chenguoming1/h743-controllers/f722-heli/README.md

# F722 controller: native0 routed milestone, work in progress

**Open [hardware/f722-heli.kicad_pro](hardware/f722-heli.kicad_pro). The selected board has zero opens, geometric DRC errors, DRC warnings, ERC findings and parity findings. It is a fully routed geometric WIP milestone; fresh DC, electrical acceptance and manufacturing/flight qualification remain pending.**

PCB SHA-256: `84229c571433bd72d410fb18d02cffa3a380c00a87fbe1270e3a73b63f8dd6cd`. The [native0 checkpoint](layout-revision/checkpoints/native0-rx-complete-v1-20261013/README.md) and [canonical provenance](hardware/CANONICAL-SOURCE.json) bind all 61 paired design files. Only the PCB differs from native1; all 60 non-PCB files are exact.

The cumulative native change removes 18 tracks and one via, adds 36 tracks and two vias, and moves U15, R34 and R35 through three measured cardinal transforms, preserving all pad-net mappings. It has 2,525 native objects and 331 drilled objects. The separate final GREEN cleanup removes two exact remnants. All required new physical gates and all 22 actual IO protection checks pass. Scoped cleanup reference applicability and residual RX crossing/MISO edge concerns are recorded in the checkpoint; geometry checks do not establish fast-edge or ESD equivalence.

The preserved model's **294 required cases cover accessory/logic/USB loads only**. All 11 servo cases are illustrations. Six heavier source1 illustrations exceed the version-qualified Hobbywing V4.1 **10 A continuous BEC** reference even where ideal-source board-pad voltage passes. Neither that count nor those historical values qualifies the servo system or native0. The intended KST servos specify **6.0-8.4 V; raw 12.6 V servo operation is excluded**. The raw servo bus bypasses U5 electronics protection. V4.1's 30 A peak figure provides no installed duty-cycle qualification, and actual ESC/servo revisions, mating contacts and harness limits remain unbound. See the [power scope correction](layout-revision/checkpoints/native0-rx-complete-v1-20261013/evidence/power/POWER-SCOPE-CORRECTION.md).

The conditional 27 MHz prototype/bench limits, flash settling, BARO/IMU noise and ESD/EMC checks remain. The approved 400 kHz I2C setup retains its overshoot/measurement caveat; 385 kHz remains pending. Both new signal vias retain exact tenting/mask and actual pad/paste/metal-clearance evidence, including GREEN in the flash package region. JLC filled/capped-process applicability, ordinary-via process/stack, USB slots and panel acceptance remain unresolved. No process or firmware change is made here.

Saved-board restoration from the public native1 source is tested byte-for-byte. The compact cumulative transaction data and original two-stage native evidence are preserved; a full portable native-proof replay is not claimed. No heavy native, geometry or solver workload was repeated for packaging. Fresh native0 DC remains pending, with native1 results retained only as historical evidence.

## Historical manufacturing records

Older docs/, validation/, manufacturing/ exports and [final95 status](README-final95-historical.md) describe earlier geometry. Regenerate final assembly outputs from the eventual released board and verify factory orientation. Selected R35 is at (29.2,23.9), B.Cu, 180 degrees; the historical native1 270-degree note is inapplicable. U15 and R34 also use their selected measured poses. All prior checkpoints and B-RID files remain unchanged. See [layout history](layout-revision/README.md). No fabrication or flight release is made here.
