chenguoming1/h743-controllers/nexus-style-fc/routing-wip/README.md

# Routing work in progress

[Open the stable current integrated candidate](current/README.md). Both boards have zero native geometric errors and opens. Manufacturing/electrical/physical qualification gates remain explicit.
