chenguoming1/h743-controllers/f722-heli/layout-revision/README.md

# Current project entry point

**Open the paired [../hardware/f722-heli.kicad_pro](../hardware/f722-heli.kicad_pro). Native0 has zero opens, DRC errors/warnings, ERC and parity findings. It is a geometric WIP milestone; fresh DC and electrical/manufacturing/flight qualification remain pending.** See [project status](../README.md) and the [selected native0 checkpoint](checkpoints/native0-rx-complete-v1-20261013/README.md).

The unchanged text below is the historical eleven-open record. Its current/source paths, counts, pending statements, poses and manufacturing descriptions belong to that earlier geometry. Its recipe requires [historical final95 commit bf8189c2ecf87815a24f3acfa16fbf5f462194c4](https://github.com/chenguoming1/h743-controllers/tree/bf8189c2ecf87815a24f3acfa16fbf5f462194c4/f722-heli/hardware). The promoted ../hardware/ is not that input. All later native3, native2, native1 and source/evidence checkpoints remain preserved.

---

# F722 layout revision — work in progress

**Partially routed checkpoint. Do not manufacture or fly this revision.**

This replacement placement moves components inward from the through-hole headers, spreads the side sockets, keeps the LEDs and switch beside the upward USB connector, and uses orthogonal component orientations. The converter and its support parts are grouped on the right, with servo/RPM/SBUS protection on the left. It retains six copper layers, the 47.5 × 25.4 mm overall assembly, the board outline and stock Nexus external/MCU pin assignments.

The paired project is `hardware/f722-heli.kicad_pro`. All 156 target poses are explicit in `placement.json`; 114 differ from the published source. R7/R8 are changed to 2.2 kΩ (UNI-ROYAL 0402WGF2201TCE, C25879), and U13 uses equivalent protection channels 3/6/1 for ESC/RPM/SBUS. Native PCB, schematics and parts metadata agree. Published U14 mapping is retained.

## Checked checkpoint

KiCad 10.0.6 reports **11 unfinished connections, 0 geometric errors, 0 warnings and 0 ERC violations**. Strict schematic parity and all 29 firmware pin checks pass. All 16 critical clock, IMU, VCAP and USB nets and all 28 power/support groups are connected. The current source identity and scope are recorded in [the owner review](checks/checkpoint11-owner-review.json) and [current status](checks/current-status.json).

Checkpoint57 moves the unchanged 2.2 kΩ BOOT pull-down R2 beside the USB-side switch and completes their branch. The actual MCU BOOT connection remains open. All 156 poses and 558 pad records reproduce. Retained ground-plane fills and physical drill polygons are exact; C31’s existing ground via and rear lead are preserved. The new BOOT trace has continuous projected ground coverage. These checks do not establish startup/noise or physical qualification. See the [owner assessment](checks/checkpoint57-integration/owner-adoption-assessment.json).

The preceding Checkpoint56 completes the flash CS pull-up branch by moving R4 to the rear USB-side edge, while preserving all other 155 footprints and all original track/via objects. The old R4 CORE junction now has an explicit full-width bridge, and its new supply spur lands at C15.1. All 156 poses and 558 pad records reproduce. The actual MCU CS connection remains open. The [electrical review](checks/checkpoint56-integration/conditional-signal-review/README.md) records startup, active VERY_HIGH GPIO edges and incomplete full-tree timing limits. Critical reference metrics are unchanged; the [owner assessment](checks/checkpoint56-integration/owner-adoption-assessment.json) retains small ordinary-track projection differences and a CS width-edge wedge. Current numerical power/VCAP, decoupling and AC checks remain pending.

The preceding Checkpoint55 completes GREEN while rebuilding DSM, ADC and static flash pull-up routes. Only R44 rotates in place; all 156 poses and 558 native pad records reproduce. The [source-bound signal review](checks/checkpoint55-integration/conditional-signal-review/README.md) records the 136.672 mm DSM main receive path and 71.876 mm GREEN route, with loading and waveform limits still open. All 86 routed-net reference projections were inspected: 79 unchanged nets retain exact copper, while changed nets have no centerline gaps outside their own via windows. Finite width-edge residues remain. Eight exact actual-hole boundary predicate conflicts remain unresolved; the [owner assessment](checks/checkpoint55-integration/owner-adoption-assessment.json) preserves the failed stricter test and all limitations. Both ground planes remain connected with 117 plated ties, which does not establish current capacity or AC return quality. Fresh numerical power/VCAP remains pending.

The preceding Checkpoint54 completes the actual protected SERVO1 and RPM paths, bringing protection to 20 of 22 endpoint cases across 18 of 20 channels. R50 moves 0.25 mm inward. U12 now has a local discharge return separate from the eFuse controls; R52 instead shares a 1.250 mm ADC_BEC filter ground lead. Its conditional DC drop is small, but ADC/ILM noise, ESD coupling through the common plane, and fresh power/VCAP analysis remain open. The [ground and support review](checks/checkpoint54-integration/conditional-support-review/NATIVE-GROUND-REVIEW.md) preserves the exact topology and rejected clearance attempt. Critical copper and reference geometry outside the existing local via windows remain unchanged; the raw USB_N width residue is retained in the owner review. Historical [SERVO1](checks/checkpoint54-integration/historical-SERVO1-source15/SERVO1-electrical-review.md) and [RPM](checks/checkpoint54-integration/historical-RPM-source14/RPM-electrical-review.md) conditional signal analyses retain their own source identities.

The preceding source52 change completes both protected SBUS trees and moves R45 inward beside J12. All 82 finite new endpoints, 28 support groups and prior protection paths pass; 41 tracks and five ordinary vias replace five LV tracks. SBUS_LV is 75.648 mm and SBUS_MCU is 50.991 mm. Fresh saved-plane projection has no centerline or trace-width gaps outside own-via windows. Critical copper, missing centerlines and outside-window reference geometry remain exact; a −2.3793e−10 mm² BARO_SDA width delta is retained inside an unchanged own-via window. The [conditional SBUS review](checks/checkpoint52-integration/conditional-signal-review/SBUS-electrical-review.md) identifies the non-inverting pass-FET topology, default 100k and optional 200k baud, and explicit load/leakage/receiver/cable timing assumptions. It does not establish actual waveform, ESD or fast-mode qualification.

The preceding source51 change completes both protected PORT_A/PORT_B interfaces and SWDIO, and relocates the complete NRST transition. R33 moves to the front beside U14, TP1 moves into its former interior location, and U14 shifts 0.075 mm while retaining native courtyard clearance. The A/NRST stage checks 96 new finite endpoints; the preceding B stage’s 138-endpoint audit is retained and rebound. All 28 support groups, prior protected paths, and eight affected interface/reference projections pass. Runtime net indices change, but all critical physical records and their reference metrics remain exact; real ground antipads are preserved in the review. C58’s local ground lead shortens and widens while its explicit full return witness increases by 1.164 mm. C74’s feed shortens from 3.500 to 1.638 mm; a CORE bridge grows from 8.422 to 10.971 mm at unchanged 0.30 mm width. These geometric facts do not qualify regulator stability or current capacity; fresh numerical power remains pending.

The preceding source50 change completes TAIL through the actual U12.6 clamp pad, preserving all 156 footprints and 558 pad records. Fourteen tracks are replaced by 58 tracks and five ordinary vias while restoring SERVO3, RPM, ADC_DIV_MID and CORE support. All 116 finite endpoints and the new TAIL protection cut pass. Critical copper and reference metrics remain exact source49; each GND plane loses 1.936695782 mm² with no critical trace-width overlap. Fresh numerical power/VCAP validation remains pending.

The [TAIL conditional electrical review](checks/checkpoint50-integration/conditional-signal-review/TAIL-electrical-review.md) records an 81.064 mm MCU-to-clamp branch. The full protected net shortens from the historical 101.637 mm to 85.676 mm, but the clamp is much farther electrically from the driver. Pinned stock firmware selects LOW GPIO speed; ST's simulation-only fast-corner IBIS ramps of about 10–11 ns are longer than the conditional 0.45–0.57 ns one-way trace delay. This supports prototype review, not a guaranteed waveform. Three exact reference-width residuals totaling 0.000224846616 mm² remain outside own-via windows; no outside-window centerline gap exists. Waveform, ESD residual stress, AC return and actual receiver/cable qualification remain open. R23 is not source-end termination. The CORE-to-FB1 branch grows to 8.867 mm at unchanged 0.20 mm width, requiring fresh loaded analysis.

The preceding source49 change completes PORT_A MCU TX and rebuilds RX while preserving all 156 complete footprints, 558 pad records and existing vias. Five RX tracks and one ADC branch segment are replaced by 19 tracks and two ordinary signal vias. TX is 8.370 mm and RX is 10.989 mm. All 38 new track endpoints pass finite pad, junction or annular-entry checks. The remaining MCU escape review finds no newly sealed pad. Critical copper and its reference-projection metrics are unchanged from the preceding source. Each GND plane loses 0.788477196 mm² to the revised geometry, with no overlap under critical trace widths; this is not unchanged-plane or numerical-power evidence.

Historical source49 ADC_BUS was complete, with C31 inward beside the MCU. Its then-current capacitor branch was 4.448 mm, the complete capacitor-to-MCU path is 6.963 mm, and the unchanged ground lead is 1.379 mm. The [conditional acquisition screen](checks/checkpoint49-integration/adc-electrical-screen.json) has 35.56 µs available versus 1.887 µs required by its resistor/switch assumptions. It does not guarantee effective capacitor value, noise or calibrated accuracy. New UART and changed ADC tracks have full saved-plane projection outside their explicit own-via windows. Two pre-existing ADC width-edge fragments totaling 6.08648e−5 mm² remain exactly unchanged. Own-via windows are not solid copper or AC return qualification; earlier source-bound actual-hole predicate disagreements remain documented.

Earlier accepted work completes both barometer I2C trees, DSM MCU and external paths, NRST through the inward back-side TP5 at (16.9, 6.0) mm, and RPM_HV/SBUS_HV. Their precise copper, pose and source-bound review histories remain in the versioned checkpoint evidence. The placement recipe reproduces all 156 poses and 558 native pad records; the current recipe reproduces the three revised poses as well.

The [current actual-I/O check](checks/current-actual-io22.json) passes **20 of 22 endpoint cases, covering 18 of 20 bonded protection channels**. Two channels remain unfinished. All seven supplemental checks pass. The original 18-check convention has 16 passes, including 4 package-NC cuts; those NC results are not counted as completed bonded protection. Native via/drill/mask, body/courtyard, header-access, USB-keepout, edge and mounting-hole screens pass. Some nominal courtyard margins remain very small, including inherited 0.001 mm at U1–C4 and 0.005 mm near R66. These bounded geometry screens do not establish assembly or transient-protection qualification.

The [CORE supply and power-terminal review](core-voltage-review/REPORT.md) documents the historical U10/U11 model error: EN pin 4 was used instead of IN pin 6. Historical USB/DSM path-specific conclusions are invalid and retained only as diagnostics. The corrected model was independently reviewed and run on source43, the 37-open board: 294 required conditional DC cases, ten actual supply-pad windows, five VCAP copper loops and numerical guards pass. The overall result remains false because the separate 18.56 A single-feed illustration fails four servo voltage floors. See the [corrected report](power-evidence/corrected-v3-source43/REPORT.md). **These results do not qualify the current 11-open board: later BEC/CORE and GND geometry changed. Fresh current-source numerical validation remains pending.** Mesh-free staging on source48 was not a numerical solve.

Remaining routing, complete protection paths, current-source power validation, final signal timing/reference review and manufacturing exports are outstanding. Physical load, thermal, USB impedance, sensor, assembly and flight qualification are not established by these checks.

The native PCB is the authoritative routed source. The placement recipe below recreates the current component arrangement without its routing. The source-only local router and its recorded controls are under `routing-tools/`; accepted ordinary routes close ADC_BEC, ADC_DIV_MID, FLASH_WP_N, SWCLK, D1_A, D2_A, SERVO1_EXT, SERVO2_EXT, SERVO3_EXT, RPM_EXT and SBUS_EXT, with full-width native pad/annular entry. Later engine route claims remain subject to native connectivity and endpoint checks. Exact saved-ground contours and intended-net checks prevent stale antipads or accidental net reassignment during import. The finite-contact static power solver and its reproducible controls are under `power-validation/`. The [historical conditional power review](power-validation/CANDIDATE19-COMBINED-REVIEW.md) preserves exact source/result hashes and all failed illustrative checks; [screened-source60 applicability](checks/conditional-power-applicability.json) verifies the 13 networks, 99 contacts, physical drills/fills, stackup, materials, cases and runtime of that preserved source. The following numerical values preserve historical calculations; USB/DSM path-specific conclusions are invalid because of the U10/U11 terminal error, and none qualifies the current board. The separately evidenced BEC copper improvement does not establish complete path validation. Worst ABC pad is 4.862249 V against the conditional 4.8 V floor, with 61.249 mV margin after the 1 mV numerical guard. Worst VCAP DC copper loop is 26.025318 mΩ against 35 mΩ, excluding R16, capacitor ESR and AC stability. Corrected BEC copper drop is 38.370 mV at the representative 2 A case, versus about 614 mV in the preserved failed diagnostic. The [old independent resistance bound](power-evidence/loaded73-deficit-v1/REPORT.md) describes the superseded long feed. The [BEC component/source bounds](bec-voltage-review/REPORT.md) distinguish full-temperature IC reference tolerance from resistor drift and explicitly unguaranteed line/load sensitivities. These are conditional modeled findings, not measured regulation, ampacity, production or flight qualification.

The [historical circuit-corner packet](power-corner-review/REPORT.md) adds 140 input/output endpoint cases and 5,532 sensitivity cases using the verified source19 matrices. At the modeled 33 mΩ U7 endpoint, combined guarded reserves are 41.172 mV ABC and 17.607 mV classic DSM; the 60 mΩ stress retains 642 failures. Its separate resistance/source-error budgets, exact TI test conditions and bench requirements are preserved. It contains no new loaded-field solve and does not qualify this changed-fill board; its DSM conclusions also inherit the now-invalid supply-terminal mapping.

The [stock SPI review](spi-review/stock-spi-review.md) establishes the pinned source clocks of 13.5 MHz for the IMU and 27 MHz for flash; flash is at the MCU SPI2 frequency ceiling. Its [native identity binding](checks/stock-spi-binding.json) confirms the reviewed 103 pad identities and unchanged BOM on this source. Complete routing, fast-edge/loading/return review and actual hardware timing remain unqualified.

The [stock I2C review](signal-review/stock-i2c-review.md) preserves the existing firmware and 2.2 kΩ pull-ups, with provisional 50 pF loading and 100 ns edge targets; the [native signal screen](signal-review/native/README.md) records topology, saved-plane references and conditional loading assumptions. Both current I2C nets are complete clean trees: SCL 19.596154 mm and SDA 22.600469 mm. Capacitance/RC qualification remains unresolved because the material, manufacturing and device bounds are not fully established; final device/bench qualification remains open. [Native export tools](export-tools/README.md) reproduce the previous published payload as a regression control and refuse unfinished candidates. Their historical results do not validate this board.

Machine-readable source identity and results are in `source.json`, `placement-build.json`, `routing-build.json` and `checks/current-status.json`. The original published `../hardware`, `../manufacturing` and electrical reports describe the previous layout; their routing and electrical results do not validate this candidate.

## Reproduce

Use KiCad 10.0.6 with a Python environment providing `pcbnew`. From this directory, rebuild the placement (routing deliberately excluded) into a new output directory:

```sh
python scripts/rebuild_placement.py --source ../hardware --out /path/to/new/hardware
python scripts/patch_metadata.py --hardware /path/to/new/hardware --report /path/to/metadata-changes.json --apply
kicad-cli sch export netlist --format kicadxml --output /path/to/reconstructed.net /path/to/new/hardware/f722-heli.kicad_sch
python scripts/check_native_parity.py --board /path/to/new/hardware/f722-heli.kicad_pcb --netlist /path/to/reconstructed.net --out /path/to/parity.json
kicad-cli pcb drc --format json --output /path/to/drc.json /path/to/new/hardware/f722-heli.kicad_pcb
kicad-cli sch erc --format json --output /path/to/erc.json /path/to/new/hardware/f722-heli.kicad_sch
```

The builder requires published board SHA256 `4da0708a4795662cc32b035a0783c70b9bdb85fc386bd4d39af33385b175667f` and refuses to reuse an output directory. Subsequent routing checkpoints will update this draft branch with their exact checks and remaining work.

## Placement previews

[Front placement](checks/placement-front.svg) · [Mirrored back placement](checks/placement-back.svg)
