chenguoming1/h743-controllers/f722-heli/layout-revision/routing-tools/README.md

# F722 routing source V24: accepted11 geometric work in progress

Accepted candidate57 PCB SHA256 is454b7bb2454695b49c039f3d97e5edefb1946912363bab00ef5ced6ba2b0ea16. Stored native gates report11 opens, zero geometric errors and warnings. R2's switch branch closes; actual MCU U1.60 BOOT0 remains disconnected. Remaining gaps are PORT_C5, BOOT1, RED1 and flash4. Routing and electrical/physical qualification remain unfinished.

R2 alone moves from F(16.0,7.7),0 degrees to F(40.2,6.2),270 degrees (-90 native representation), retaining its2.2k/1% value and actual pad nets. All other155 full footprints remain exact. One old exclusive R2 ground leaf is removed and two tracks are added, with no new vias. The new BOOT0 link to SW1 is1.2701279463109219mm; the new0.25mm ground leaf is1.0636728820459835mm to an existing ground via. C31's original ground via and rear lead remain exact.

Original tests/boot56/candidate01 retains its129-file seal. Candidate57 began as a hardlinked copy; only power-audit.json was detached before adding explicit pad_group_count fields. power-audit-sealed-original.json and support-report-adapter.json preserve the original report and both source/output hashes. No original sealed report was overwritten. Original and accepted paired projects remain byte-identical. Stored checks retain four finite new endpoints,28 support groups,16 critical groups and20/22 actual I/O cases.

The owner proves exact saved GND fill arrays for both ground planes and all307 physical drill polygons, with2293 retained native objects exact modulo runtime net_code. Existing track projection domains therefore remain unchanged. A separate BOOT0 reference inspection reports zero missing physical centerline and width projection while explicitly retaining the open MCU terminal. Inherited source55 actual-hole boundary ambiguities and source56's CS width wedge remain unresolved limitations. Exact retained reference geometry does not establish AC/noise performance or current capacity.

Placement reproduction binds156 poses and558 complete native pad records; front and mirrored-back previews are retained. Current numerical power/VCAP remains unrun. Source43 power evidence remains historical only. BOOT startup, switching/noise, ESD, manufacturing and flight remain unqualified.

V24 inherits V23 unchanged and adds only current construction/owner/placement evidence. Portable verification recovers exact paired project bytes, checks every selected source hash and original seal, validates the complete board syntax-tree transaction and full saved GND-zone syntax, executes support/adoption adapters and recalculates both new track lengths. It does not rerun native DRC, finite/reference geometry, placement, routing, FEM or electrical simulation.
