chenguoming1/h743-controllers/f722-heli/layout-revision/power-evidence/README.md

# Historical scoped VCAP evidence

The completed two-grid DC copper pilot belongs only to board SHA 1069f4ce2d92088271a4ec3154ff0ed35e88adc4100705f75c4aaa4a884717bd, a provisional source with 85 ordinary opens. It ran five explicitly named VCAP copper loops, with no loaded-power cases. Fine-grid totals were 18.862, 18.399, 23.437, 25.858 and 24.789 mΩ against 35 mΩ. The worst remaining margin after its numerical guard was 9.042 mΩ. R16's fitted 0.120 Ω and capacitor ESR are excluded.

This is not qualification of the current 75-open board SHA 008d0b11df400284d12750c7f5c877b43a7ea28ffddbf4a4b799c3ae7ec4917e. Exact native comparison finds four added physical drills and changes in both GND fills. The current board requires fresh analysis. The earlier 77-open source had identical relevant VCAP geometry; that equivalence record does not silently rebind the original numerical result.

The compact result receipt retains board/freeze/ledger/result hashes, all loop legs, two-grid sensitivities, guarded margins, numerical checks, geometric error certificates and checkpoint identities. The independent review verified 315 scalar/hash/metadata conditions, including 25 frozen inputs and six runtime sources, without performing a new solve. Original numerical arrays and the 44 MB full result are not included in this compact evidence packet.

The successful solver matches the tested public power v4 implementation. Five numerical source files are byte-identical. The sixth, audit_native_ports.py, differs only in a documentation correction: public v4 correctly calls 2e-8 mm 0.02 nm; the archived runtime docstring incorrectly called it 20 nm. The executable value is identical. The exact archived audit module is included separately for hash reconstruction; the source-match receipt records both hashes and an AST comparison excluding docstrings. No unfinished single-line or loaded-pilot changes are included.

The read-only geometry comparison script can be placed beside the public validation modules. It compares exact selected-net copper/fills, all-net physical drills, finite native port pads, outline, stackup, material assumptions and export precision. Supply the exact native exports, boards and ledger identified by the receipts through its required CLI arguments. It never builds a mesh, repairs geometry, transfers a cache or declares another board qualified. Its two small comparison tests use the public validation fixtures.

The result uses explicit fixed-temperature copper assumptions and ideal finite lands/barrels, with no thermal, pulse, startup, handover, VCAP AC-stability, production or flight qualification. A two-grid sensitivity check is not a rigorous error bound. MANIFEST.json is the exact publication allowlist; copy only its entries and the manifest.
