chenguoming1/h743-controllers/f722-heli/layout-revision/checkpoints/negotiated-routing-v1-20261011/README.md

# WIP: negotiated routing source and failed v1 trial

This checkpoint preserves the exact current ordinary-only native baseline,
parser/model/attachment controls, negotiated v1 source and failed trial, and the
sealed explicit fixed-stub import supplement. Native7 remains the accepted board.
The v1 trial did not demonstrate a routing reduction and produced no final native
candidate. Existing numerical power results are stale for changed geometry.

## Evidence

- The official pinned Freerouting parser passed all four fixed-state cases in
  control v2. Failed parser v1 remains preserved as failed.
- The current model has 142 mutable and 2,245 fixed native records, 19 required
  logical role scopes and 18 repairs. Full-model generation and compilation
  succeeded. The first census failed; the engine-only projection and zero-pass
  census v2 passed. All original source/receipt states are preserved.
- The actual U14.4 attachment control passed, with an exact-source reconciliation
  covering the empty F.Cu fill inventory. The fixed 0.127 mm stub is an explicit
  future native addition; the diagnostic probe is excluded. Its conservative
  Shapely proof capsule is not an official KiCad native export.
- Negotiated v1 failed after 194.861 seconds when its fixed-geometry fingerprint
  changed. The router refused final export. Only checkpoint-0001 survives; its
  1,837 routes, areas, contact partitions and 19 role records are exactly equal
  to the initial snapshot. Report/session hashes match the producer receipt.
  No candidate.after.json or candidate.ses final output exists.

Historical preparation README/status strings are immutable historical evidence;
evidence-status.json records the terminal interpretation. The fixed fingerprint
failure remains a diagnostic finding, not a proven physical cause. No successor
diagnostic or live output is included here.

## Restore exact source and evidence bytes

Obtain repository commit 1423e4045727bc2e80acc24bcf684d5b83375001 or a descendant
that retains it. Restore the predecessor paired-hub-recovery-20261011 checkpoint
and its declared predecessors using its documented restore procedure. Then run:

    python restore.py --repository /path/to/repository --published-workspace /path/to/restored-paired-hub-workspace --output /path/to/new-workspace

The output must not exist. The restore script validates archive parts and their
reassembly, every deterministic archive member, published-object identities,
every restored byte count, SHA-256 and Git blob hash. It writes 286 exact paths
from 250 unique objects. The unique 145,730,755-byte native source is archived
once. All 61 paired hardware files remain reconstructible.

The archive uses sorted SHA-addressed USTAR members with uid/gid/mtime zero,
mode 0644, and one-thread XZ CRC64 preset 0. archive-index.json lists all parts.
RESTORE-VERIFICATION.json and VERIFY-ARCHIVE.json record the tested cold byte
restore. PREDECESSOR-FIXTURE.json describes the checked local published-byte
fixture used for that test; it was not a fresh network checkout.

## Generated outputs and runtime dependencies

regeneration-map.json separately records omitted large full/engine model JSON,
zero-pass output JSON, compiled classes, and official artifact download pins.
These are not archive members or already-restored bytes. Rebuild them from the
preserved source and named contract commands, then verify their expected hashes.
Official Freerouting 2.1.0 and ECJ 3.41.0 artifacts must match their SHA-256 pins.
The upstream source archive is optional provenance; reviewed source files are
already preserved. Shapely 2.2.0/GEOS 3.14.1 bytes are included. CPython 3.12 on
Linux x86_64, NumPy 2.2.6 and Java 21.0.12.1 are host prerequisites.

No cold engineering replay is claimed. Byte restore is relocatable; exact
historical model hashes embed absolute paths and receipt hashes and therefore
require the original workspace root and compatible pinned runtime. Relocated
execution needs an explicit path/contract rebind with new hashes. Use a separate
execution tree and retain historical receipts rather than overwriting them.

Native import, full-width/annular/clearance checks, actual TVS IO cuts with no
bypass, all fixed fragments, paired ERC/parity, ground/reference checks, and
fresh electrical/power/VCAP qualification remain pending. No canonical hardware
is replaced, accepted, or declared manufacturing-ready by this checkpoint.
