chenguoming1/h743-controllers/nexus-style-fc/routing-wip/2026-10-15/reviews/current-gates/README.md

# Source-bound board-level gates

[U10 output/input loop and USB shield/ESD review](RECOVERY-QUALIFICATION.md) contains fresh read-only measurements against the exact published batch35 source. Its historical proposed routes are review inputs, not accepted PCB source. The later EN-only correction is documented separately in the current checkpoint; the pre-correction review does not claim EN was already isolated.

[Header contact and mechanical remedy](header-contact-remedy-readonly.md) gives exact native contact dimensions and the independent tab/slot fit calculation. Copper recession could preserve nominal solder overlap, but cannot fix the square-tab/capsule-slot interference. No pad, slot or tab redesign was applied.

All electrical, manufacturing and assembly qualifications explicitly left open by these reports remain open. Zero native opens or preserved widths are not current, thermal, ESD, USB or flight qualification. Header geometry requires a separate approved correction.
