chenguoming1/h743-controllers/f722-heli/layout-revision/checkpoints/native2-in4-rx-v5-20261013/dc/README.md

# Current native2 v5 DC evidence

The four ordered chunks in `raw/` reconstruct the complete original compressed result without any byte change. RAW-RESULT-CHUNKS.json binds each chunk, their order, the complete gzip and its decompressed JSON. No mesh or cache is needed to inspect this recorded result.

Run `python3 verify_dc_chunks.py` to verify chunk identities, ordering and the full decompressed identity without writing a result file. To restore the original gzip, run `python3 verify_dc_chunks.py --output /your/new/result.json.gz`. An existing output path is refused.

The raw result records 305 cases on each of two grids, with all required 294 cases passing. Fifteen grid sensitivity comparisons and five VCAP copper-loop limits pass. The overall static screen remains false because the retained lost-J6-feed illustration fails the four servo board-pad floors. The raw result is not rewritten to hide that failure.

Compact normalized receipts and the independent current disposition are in ../evidence/dc/. They retain the exact source hashes, scientific values and recorded pass/fail claims; their normalization ledgers identify removed local locators and execution metadata. The runtime exit code 1 is retained and corresponds to the declared illustrative overall-screen failure, not missing case output.

The complete portable numerical replay source package is pending a separate immutable supplement. This checkpoint preserves the full recorded result and exact design/native inputs, but does not claim that the public numerical or reference solver source closure is complete. Packaging did not rerun a numerical solve.
