chenguoming1/h743-controllers/f722-heli/layout-revision/routing-tools/docs/historical-v23/README.md

# F722 routing source V23: accepted12 geometric work in progress

Accepted candidate56 PCB SHA256 is 9d9f2f39c2b200f2c928dd3123f098797eb86ba56cb943d7f6e3fe89bf264a7e. Stored native gates report12 opens, zero errors and warnings. R4's U3.1 pull-up branch closes; actual MCU U1.33 FLASH_CS remains disconnected. Remaining gaps: PORT_C5, BOOT2, RED1, flash4. Routing and electrical qualification remain unfinished.

R4 alone moves from B(27.5,19.8),180 degrees to B(40.55,19.0),180 degrees, retaining its10k/1% value and actual pad nets. All other155 full footprints and all1723 original track/via/arc objects remain exact. Thirteen tracks and two ordinary tented through-vias are added. The CS branch is13.999707308mm; the new4.335mm CORE spur deliberately contacts C15.1. A separate1.835755975mm full-width bridge to actual C3.1 replaces the old R4 pad's CORE junction. Its current cannot be bounded by the pull-up bias current.

The original tests/native13-access/candidate02 retains its133-file seal. Candidate56's explicit support adapter adds only pad_group_count=len(groups) for28 verified singleton partitions. power-audit-sealed-original.json and support-report-adapter.json preserve the original bytes and both hashes. The original and accepted paired native projects are byte-identical. Stored checks preserve26 finite new endpoints,16 critical groups,20/22 actual I/O cases, strict I2C trees and117 accepted ground ties. Placement reproduction binds156 poses and558 full pad records; front and mirrored-back previews are included.

Critical projection metrics are unchanged from55. The independent global review covers1445 retained track-reference records and preserves eight nonempty numerical width-edge intersections, including an RPM centerline delta of1.9678329196301878e-7mm. New CORE projections are complete; the nine CS tracks have no centerline gap outside their own via windows, but one retains a1.6570642014549053e-5mm² width wedge. Prior55's eight actual-hole predicate ambiguities remain historical unresolved limitations. No tolerance, snapping, contour repair or zero normalization is introduced.

The conditional electrical review distinguishes active VERY_HIGH GPIO CS edges from the static WP/HOLD straps. Full MCU-to-U3 tree topology, fastest-edge loading/timing, local supply ramp/startup and fresh whole-network power/decoupling remain unqualified. Current numerical power/VCAP has not run. Source43 power evidence remains historical only. This is not manufacturing, flight, AC, thermal or ESD qualification.

V23 preserves all V22 lineage and adds compact, deduplicated current construction/owner evidence. Portable checks reconstruct exact paired project bytes, verify source bindings and the complete board syntax-tree transaction, execute support/adoption adapters and recalculate CS/CORE centerline lengths. They do not rerun native DRC, reference/finite geometry, placement, electrical simulation, routing or FEM.
