chenguoming1/h743-controllers/f722-heli/layout-revision/routing-tools/sessions/recovery55/README.md

# Exact candidate26–28 paired recovery

First recover exact26 with the retained V8 recovery57 script from its pinned candidate22 paired source. This packet uses26 as its hash-pinned byte-copy base and validates all62 functional paired files before creating output. It recovers exact27 or28 PCB bytes and unchanged paired project/schematic/library files. It performs no reroute or native replay and makes no new qualification claim. See the root REPRODUCE.md.
