chenguoming1/h743-controllers/f722-heli/layout-revision/routing-tools/sessions/recovery57/README.md

# Exact V8 source and result recovery

Supply the hash-pinned external candidate22/accepted62 paired project. This packet recovers exact candidates22–26 using standard-library copy/literal deltas and verifies every functional paired file. Every target board hash is checked before output. Recovery is byte reconstruction only; it does not route, replay native imports, refill, rerun DRC or revalidate numerical power. See the package REPRODUCE.md.
