chenguoming1/h743-controllers/f722-heli/manufacturing/drill/drill-report.txt

Drill report for f722-heli.kicad_pcb
Created on 2026-10-07T12:36:03

Copper Layer Stackup:
    =============================================================
    L1 :  F.Cu                      front
    L2 :  In1.Cu                    in1
    L3 :  In2.Cu                    in2
    L4 :  In3.Cu                    in3
    L5 :  In4.Cu                    in4
    L6 :  B.Cu                      back

Drill file 'f722-heli-PTH.drl' contains
    plated through holes:
    =============================================================
    T1  0.200mm  0.0079"  (246 holes))
    T2  0.300mm  0.0118"  (77 holes))
    T3  0.600mm  0.0236"  (4 holes)  (with 4 slots)
    T4  1.100mm  0.0433"  (21 holes))

    Total plated holes count 348

Drill file 'f722-heli-NPTH.drl' contains
    unplated through holes:
    =============================================================
    T1  0.710mm  0.0280"  (2 holes)  (with 1 slot)

    Total unplated holes count 2
