chenguoming1/h743-controllers/f722-heli/layout-revision/power-evidence/loaded73-deficit-v1/requirements-analytic.txt

# Verified with Python 3.12.14; Shapely wheel uses GEOS 3.14.1.
shapely==2.2.0
numpy==2.2.6
