chenguoming1/h743-controllers/nexus-style-fc/docs/validation/reviews/jlcdfm-child-b49ef410/combined-report-dom.txt

- text: 
- main:
  - generic: https://dfm.jlcdfm.com/
  - generic: DFM analysis report_JLCDFM
  - generic: File name：
  - generic: nexus-header-board-gerbers.zip
  - generic: Report generated at：
  - generic: 2026-10-15 07:47:10
  - generic: PCB layers：
  - generic: "2"
  - generic: PCB size：
  - generic: 2.24x1.1cm
  - generic: Analyze project：
  - checkbox "PCB DFM" [checked]
  - text: PCB DFM
  - checkbox "SMT DFM" [checked]
  - text: SMT DFM
  - generic: PCB DFM>Routing layer analysis
  - table:
    - rowgroup:
      - row "Analyze project Analysis results PCB screenshot Layer distribution Statistics":
        - columnheader "Analyze project"
        - columnheader "Analysis results"
        - columnheader "PCB screenshot"
        - columnheader "Layer distribution"
        - columnheader "Statistics"
    - rowgroup:
      - row "Sharp trace corner （Check for sharp corners in traces） No No No Danger：0 Warning：0 Good：0":
        - cell "Sharp trace corner （Check for sharp corners in traces）":
          - text: Sharp trace corner
          - text: （Check for sharp corners in traces）
        - cell "No"
        - cell "No"
        - cell "No"
        - cell "Danger：0 Warning：0 Good：0":
          - generic: Danger：0
          - generic: Warning：0
          - generic: Good：0
      - row "BGA pad （Check BGA pads on the board） No No No Danger：0 Warning：0 Good：0":
        - cell "BGA pad （Check BGA pads on the board）":
          - text: BGA pad
          - text: （Check BGA pads on the board）
        - cell "No"
        - cell "No"
        - cell "No"
        - cell "Danger：0 Warning：0 Good：0":
          - generic: Danger：0
          - generic: Warning：0
          - generic: Good：0
      - row "Via placed within a pad （Check if there is a via placed within a pad） No No No Danger：0 Warning：0 Good：0":
        - cell "Via placed within a pad （Check if there is a via placed within a pad）":
          - text: Via placed within a pad
          - text: （Check if there is a via placed within a pad）
        - cell "No"
        - cell "No"
        - cell "No"
        - cell "Danger：0 Warning：0 Good：0":
          - generic: Danger：0
          - generic: Warning：0
          - generic: Good：0
      - row "Trace to board edge （Detect traces too close to the board edge） No No No Danger：0 Warning：0 Good：0":
        - cell "Trace to board edge （Detect traces too close to the board edge）":
          - text: Trace to board edge
          - text: （Detect traces too close to the board edge）
        - cell "No"
        - cell "No"
        - cell "No"
        - cell "Danger：0 Warning：0 Good：0":
          - generic: Danger：0
          - generic: Warning：0
          - generic: Good：0
      - row "Trace spacing （Measure spacing between adjacent parallel traces） No No No Danger：0 Warning：0 Good：0":
        - cell "Trace spacing （Measure spacing between adjacent parallel traces）":
          - text: Trace spacing
          - text: （Measure spacing between adjacent parallel traces）
        - cell "No"
        - cell "No"
        - cell "No"
        - cell "Danger：0 Warning：0 Good：0":
          - generic: Danger：0
          - generic: Warning：0
          - generic: Good：0
      - row "Unconnected trace end （Free-standing trace ends not connected to pads） No No No Danger：0 Warning：0 Good：0":
        - cell "Unconnected trace end （Free-standing trace ends not connected to pads）":
          - text: Unconnected trace end
          - text: （Free-standing trace ends not connected to pads）
        - cell "No"
        - cell "No"
        - cell "No"
        - cell "Danger：0 Warning：0 Good：0":
          - generic: Danger：0
          - generic: Warning：0
          - generic: Good：0
      - row "Trace width （Trace width information） 0.2mm Good No nexus-header-board-F_Cu.gtl nexus-header-board-B_Cu.gbl Danger：0 Warning：0 Good：34":
        - cell "Trace width （Trace width information）":
          - text: Trace width
          - text: （Trace width information）
        - cell "0.2mm Good":
          - text: 0.2mm
          - text: Good
        - cell "No"
        - cell "nexus-header-board-F_Cu.gtl nexus-header-board-B_Cu.gbl":
          - generic: nexus-header-board-F_Cu.gtl
          - generic: nexus-header-board-B_Cu.gbl
        - cell "Danger：0 Warning：0 Good：34":
          - generic: Danger：0
          - generic: Warning：0
          - generic: Good：34
      - row "Fiducial （Detect fiducial marks on the board） No No No Danger：0 Warning：0 Good：0":
        - cell "Fiducial （Detect fiducial marks on the board）":
          - text: Fiducial
          - text: （Detect fiducial marks on the board）
        - cell "No"
        - cell "No"
        - cell "No"
        - cell "Danger：0 Warning：0 Good：0":
          - generic: Danger：0
          - generic: Warning：0
          - generic: Good：0
      - row "Pad to board edge （Measure distance of pads from the board edge） 0.23mm Good No nexus-header-board-F_Cu.gtl nexus-header-board-B_Cu.gbl Danger：0 Warning：0 Good：25":
        - cell "Pad to board edge （Measure distance of pads from the board edge）":
          - text: Pad to board edge
          - text: （Measure distance of pads from the board edge）
        - cell "0.23mm Good":
          - text: 0.23mm
          - text: Good
        - cell "No"
        - cell "nexus-header-board-F_Cu.gtl nexus-header-board-B_Cu.gbl":
          - generic: nexus-header-board-F_Cu.gtl
          - generic: nexus-header-board-B_Cu.gbl
        - cell "Danger：0 Warning：0 Good：25":
          - generic: Danger：0
          - generic: Warning：0
          - generic: Good：25
      - row "Pad spacing （Measure pad to pad spacing） 0.37mm Good No nexus-header-board-B_Cu.gbl Danger：0 Warning：0 Good：4":
        - cell "Pad spacing （Measure pad to pad spacing）":
          - text: Pad spacing
          - text: （Measure pad to pad spacing）
        - cell "0.37mm Good":
          - text: 0.37mm
          - text: Good
        - cell "No"
        - cell "nexus-header-board-B_Cu.gbl":
          - generic: nexus-header-board-B_Cu.gbl
        - cell "Danger：0 Warning：0 Good：4":
          - generic: Danger：0
          - generic: Warning：0
          - generic: Good：4
      - row "Plated through-hole to trace clearance （Measure clearance of plated through-holes to traces） 0.44mm Good No nexus-header-board-F_Cu.gtl nexus-header-board-B_Cu.gbl Danger：0 Warning：0 Good：11":
        - cell "Plated through-hole to trace clearance （Measure clearance of plated through-holes to traces）":
          - text: Plated through-hole to trace clearance
          - text: （Measure clearance of plated through-holes to traces）
        - cell "0.44mm Good":
          - text: 0.44mm
          - text: Good
        - cell "No"
        - cell "nexus-header-board-F_Cu.gtl nexus-header-board-B_Cu.gbl":
          - generic: nexus-header-board-F_Cu.gtl
          - generic: nexus-header-board-B_Cu.gbl
        - cell "Danger：0 Warning：0 Good：11":
          - generic: Danger：0
          - generic: Warning：0
          - generic: Good：11
      - row "Annular ring （Annular ring width of pads compared to holes） 0.15mm Warning No nexus-header-board-F_Cu.gtl nexus-header-board-B_Cu.gbl Danger：0 Warning：6 Good：21":
        - cell "Annular ring （Annular ring width of pads compared to holes）":
          - text: Annular ring
          - text: （Annular ring width of pads compared to holes）
        - cell "0.15mm Warning":
          - text: 0.15mm
          - text: Warning
        - cell "No"
        - cell "nexus-header-board-F_Cu.gtl nexus-header-board-B_Cu.gbl":
          - generic: nexus-header-board-F_Cu.gtl
          - generic: nexus-header-board-B_Cu.gbl
        - cell "Danger：0 Warning：6 Good：21":
          - generic: Danger：0
          - generic: Warning：6
          - generic: Good：21
      - row "tht to smd （Detect clearance of vias to pads） 2.35mm Warning No nexus-header-board-F_Cu.gtl nexus-header-board-B_Cu.gbl Danger：0 Warning：26 Good：44":
        - cell "tht to smd （Detect clearance of vias to pads）":
          - text: tht to smd
          - text: （Detect clearance of vias to pads）
        - cell "2.35mm Warning":
          - text: 2.35mm
          - text: Warning
        - cell "No"
        - cell "nexus-header-board-F_Cu.gtl nexus-header-board-B_Cu.gbl":
          - generic: nexus-header-board-F_Cu.gtl
          - generic: nexus-header-board-B_Cu.gbl
        - cell "Danger：0 Warning：26 Good：44":
          - generic: Danger：0
          - generic: Warning：26
          - generic: Good：44
      - row "Via to pad （Detect clearance of vias to pads） 0.2mm Good No nexus-header-board-F_Cu.gtl nexus-header-board-B_Cu.gbl Danger：0 Warning：0 Good：2":
        - cell "Via to pad （Detect clearance of vias to pads）":
          - text: Via to pad
          - text: （Detect clearance of vias to pads）
        - cell "0.2mm Good":
          - text: 0.2mm
          - text: Good
        - cell "No"
        - cell "nexus-header-board-F_Cu.gtl nexus-header-board-B_Cu.gbl":
          - generic: nexus-header-board-F_Cu.gtl
          - generic: nexus-header-board-B_Cu.gbl
        - cell "Danger：0 Warning：0 Good：2":
          - generic: Danger：0
          - generic: Warning：0
          - generic: Good：2
  - generic: PCB DFM>Soldermask layer analysis
  - table:
    - rowgroup:
      - row "Analyze project Analysis results PCB screenshot Layer distribution Statistics":
        - columnheader "Analyze project"
        - columnheader "Analysis results"
        - columnheader "PCB screenshot"
        - columnheader "Layer distribution"
        - columnheader "Statistics"
    - rowgroup:
      - row "Soldermask bridge （Detect distance between parallel soldermask opening edges） No No No Danger：0 Warning：0 Good：0":
        - cell "Soldermask bridge （Detect distance between parallel soldermask opening edges）":
          - text: Soldermask bridge
          - text: （Detect distance between parallel soldermask opening edges）
        - cell "No"
        - cell "No"
        - cell "No"
        - cell "Danger：0 Warning：0 Good：0":
          - generic: Danger：0
          - generic: Warning：0
          - generic: Good：0
      - row "Solder mask opening exposing trace （Detect clearance of solder mask openings to nearby traces） No No No Danger：0 Warning：0 Good：0":
        - cell "Solder mask opening exposing trace （Detect clearance of solder mask openings to nearby traces）":
          - text: Solder mask opening exposing trace
          - text: （Detect clearance of solder mask openings to nearby traces）
        - cell "No"
        - cell "No"
        - cell "No"
        - cell "Danger：0 Warning：0 Good：0":
          - generic: Danger：0
          - generic: Warning：0
          - generic: Good：0
      - row "Soldermask opening with multiple segments （Check if solder mask openings are constructed from multiple geometric shapes） No No No Danger：0 Warning：0 Good：0":
        - cell "Soldermask opening with multiple segments （Check if solder mask openings are constructed from multiple geometric shapes）":
          - text: Soldermask opening with multiple segments
          - text: （Check if solder mask openings are constructed from multiple geometric shapes）
        - cell "No"
        - cell "No"
        - cell "No"
        - cell "Danger：0 Warning：0 Good：0":
          - generic: Danger：0
          - generic: Warning：0
          - generic: Good：0
      - row "Negative soldermask expansion （Detect solder mask openings smaller than their corresponding pads） No No No Danger：0 Warning：0 Good：0":
        - cell "Negative soldermask expansion （Detect solder mask openings smaller than their corresponding pads）":
          - text: Negative soldermask expansion
          - text: （Detect solder mask openings smaller than their corresponding pads）
        - cell "No"
        - cell "No"
        - cell "No"
        - cell "Danger：0 Warning：0 Good：0":
          - generic: Danger：0
          - generic: Warning：0
          - generic: Good：0
  - generic: PCB DFM>Silkscreen layer analysis
  - table:
    - rowgroup:
      - row "Analyze project Analysis results PCB screenshot Layer distribution Statistics":
        - columnheader "Analyze project"
        - columnheader "Analysis results"
        - columnheader "PCB screenshot"
        - columnheader "Layer distribution"
        - columnheader "Statistics"
    - rowgroup:
      - row "Silkscreen to pad （Detect clearance of silkscreen to pads） No No No Danger：0 Warning：0 Good：0":
        - cell "Silkscreen to pad （Detect clearance of silkscreen to pads）":
          - text: Silkscreen to pad
          - text: （Detect clearance of silkscreen to pads）
        - cell "No"
        - cell "No"
        - cell "No"
        - cell "Danger：0 Warning：0 Good：0":
          - generic: Danger：0
          - generic: Warning：0
          - generic: Good：0
      - row "Silkscreen to hole （Detect clearance of silkscreen to holes） No No No Danger：0 Warning：0 Good：0":
        - cell "Silkscreen to hole （Detect clearance of silkscreen to holes）":
          - text: Silkscreen to hole
          - text: （Detect clearance of silkscreen to holes）
        - cell "No"
        - cell "No"
        - cell "No"
        - cell "Danger：0 Warning：0 Good：0":
          - generic: Danger：0
          - generic: Warning：0
          - generic: Good：0
      - row "Silkscreen line width （Check silkscreen line width） No No No Danger：0 Warning：0 Good：0":
        - cell "Silkscreen line width （Check silkscreen line width）":
          - text: Silkscreen line width
          - text: （Check silkscreen line width）
        - cell "No"
        - cell "No"
        - cell "No"
        - cell "Danger：0 Warning：0 Good：0":
          - generic: Danger：0
          - generic: Warning：0
          - generic: Good：0
  - generic: PCB DFM>Drill layer analysis
  - table:
    - rowgroup:
      - row "Analyze project Analysis results PCB screenshot Layer distribution Statistics":
        - columnheader "Analyze project"
        - columnheader "Analysis results"
        - columnheader "PCB screenshot"
        - columnheader "Layer distribution"
        - columnheader "Statistics"
    - rowgroup:
      - row "Unconnected via （Detect isolated unconnected vias） No No No Danger：0 Warning：0 Good：0":
        - cell "Unconnected via （Detect isolated unconnected vias）":
          - text: Unconnected via
          - text: （Detect isolated unconnected vias）
        - cell "No"
        - cell "No"
        - cell "No"
        - cell "Danger：0 Warning：0 Good：0":
          - generic: Danger：0
          - generic: Warning：0
          - generic: Good：0
      - row "Missing plated through-hole （Detect top and bottom pads at the same location without plated through-holes） No No No Danger：0 Warning：0 Good：0":
        - cell "Missing plated through-hole （Detect top and bottom pads at the same location without plated through-holes）":
          - text: Missing plated through-hole
          - text: （Detect top and bottom pads at the same location without plated through-holes）
        - cell "No"
        - cell "No"
        - cell "No"
        - cell "Danger：0 Warning：0 Good：0":
          - generic: Danger：0
          - generic: Warning：0
          - generic: Good：0
      - row "Unconnected via （Detect isolated unconnected vias） No No No Danger：0 Warning：0 Good：0":
        - cell "Unconnected via （Detect isolated unconnected vias）":
          - text: Unconnected via
          - text: （Detect isolated unconnected vias）
        - cell "No"
        - cell "No"
        - cell "No"
        - cell "Danger：0 Warning：0 Good：0":
          - generic: Danger：0
          - generic: Warning：0
          - generic: Good：0
      - row "Plated through-hole spacing （Measure spacing between plated through-holes） No No No Danger：0 Warning：0 Good：0":
        - cell "Plated through-hole spacing （Measure spacing between plated through-holes）":
          - text: Plated through-hole spacing
          - text: （Measure spacing between plated through-holes）
        - cell "No"
        - cell "No"
        - cell "No"
        - cell "Danger：0 Warning：0 Good：0":
          - generic: Danger：0
          - generic: Warning：0
          - generic: Good：0
      - row "Short slot detection （Detect slots shorter than twice their width） No No No Danger：0 Warning：0 Good：0":
        - cell "Short slot detection （Detect slots shorter than twice their width）":
          - text: Short slot detection
          - text: （Detect slots shorter than twice their width）
        - cell "No"
        - cell "No"
        - cell "No"
        - cell "Danger：0 Warning：0 Good：0":
          - generic: Danger：0
          - generic: Warning：0
          - generic: Good：0
      - row "Slot width check （Measure slot width） No No No Danger：0 Warning：0 Good：0":
        - cell "Slot width check （Measure slot width）":
          - text: Slot width check
          - text: （Measure slot width）
        - cell "No"
        - cell "No"
        - cell "No"
        - cell "Danger：0 Warning：0 Good：0":
          - generic: Danger：0
          - generic: Warning：0
          - generic: Good：0
      - row "Via to PTH spacing （Measure spacing of vias to plated through-holes） No No No Danger：0 Warning：0 Good：0":
        - cell "Via to PTH spacing （Measure spacing of vias to plated through-holes）":
          - text: Via to PTH spacing
          - text: （Measure spacing of vias to plated through-holes）
        - cell "No"
        - cell "No"
        - cell "No"
        - cell "Danger：0 Warning：0 Good：0":
          - generic: Danger：0
          - generic: Warning：0
          - generic: Good：0
      - row "Unconnected via （Detect isolated unconnected vias） No No No Danger：0 Warning：0 Good：0":
        - cell "Unconnected via （Detect isolated unconnected vias）":
          - text: Unconnected via
          - text: （Detect isolated unconnected vias）
        - cell "No"
        - cell "No"
        - cell "No"
        - cell "Danger：0 Warning：0 Good：0":
          - generic: Danger：0
          - generic: Warning：0
          - generic: Good：0
  - generic: SMT DFM>Component assembly analysis
  - table:
    - rowgroup:
      - row "Analyze project Analysis results PCB screenshot Layer distribution Statistics":
        - columnheader "Analyze project"
        - columnheader "Analysis results"
        - columnheader "PCB screenshot"
        - columnheader "Layer distribution"
        - columnheader "Statistics"
    - rowgroup:
      - row "Component through-hole （Detect misalignment of component through-hole pins to pad holes） No No No Danger：0 Warning：0 Good：0":
        - cell "Component through-hole （Detect misalignment of component through-hole pins to pad holes）":
          - text: Component through-hole
          - text: （Detect misalignment of component through-hole pins to pad holes）
        - cell "No"
        - cell "No"
        - cell "No"
        - cell "Danger：0 Warning：0 Good：0":
          - generic: Danger：0
          - generic: Warning：0
          - generic: Good：0
      - row "Component collision warning （Component collision warning;Component 1;Component 2） No No No Danger：0 Warning：0 Good：0":
        - cell "Component collision warning （Component collision warning;Component 1;Component 2）":
          - text: Component collision warning
          - text: （Component collision warning;Component 1;Component 2）
        - cell "No"
        - cell "No"
        - cell "No"
        - cell "Danger：0 Warning：0 Good：0":
          - generic: Danger：0
          - generic: Warning：0
          - generic: Good：0
      - row "Component spacing （Component to component spacing;Component 1;Component 2） 1.63mm Good No component_+_top Danger：0 Warning：0 Good：50":
        - cell "Component spacing （Component to component spacing;Component 1;Component 2）":
          - text: Component spacing
          - text: （Component to component spacing;Component 1;Component 2）
        - cell "1.63mm Good":
          - text: 1.63mm
          - text: Good
        - cell "No"
        - cell "component_+_top":
          - generic: component_+_top
        - cell "Danger：0 Warning：0 Good：50":
          - generic: Danger：0
          - generic: Warning：0
          - generic: Good：50
      - row "Component to board edge distance （Measure distance from component outline to the board edge） 0.56mm Warning No component_+_top Danger：0 Warning：7 Good：0":
        - cell "Component to board edge distance （Measure distance from component outline to the board edge）":
          - text: Component to board edge distance
          - text: （Measure distance from component outline to the board edge）
        - cell "0.56mm Warning":
          - text: 0.56mm
          - text: Warning
        - cell "No"
        - cell "component_+_top":
          - generic: component_+_top
        - cell "Danger：0 Warning：7 Good：0":
          - generic: Danger：0
          - generic: Warning：7
          - generic: Good：0
      - row "Lead to hole distance （Detect clearance of component leads to holes） No No No Danger：0 Warning：0 Good：0":
        - cell "Lead to hole distance （Detect clearance of component leads to holes）":
          - text: Lead to hole distance
          - text: （Detect clearance of component leads to holes）
        - cell "No"
        - cell "No"
        - cell "No"
        - cell "Danger：0 Warning：0 Good：0":
          - generic: Danger：0
          - generic: Warning：0
          - generic: Good：0
      - row "Component through-hole （Detect misalignment of component through-hole pins to pad holes） No No No Danger：0 Warning：0 Good：0":
        - cell "Component through-hole （Detect misalignment of component through-hole pins to pad holes）":
          - text: Component through-hole
          - text: （Detect misalignment of component through-hole pins to pad holes）
        - cell "No"
        - cell "No"
        - cell "No"
        - cell "Danger：0 Warning：0 Good：0":
          - generic: Danger：0
          - generic: Warning：0
          - generic: Good：0
      - row "Coponent pad spacing （Detect clearance between pads of the same component） No No No Danger：0 Warning：0 Good：0":
        - cell "Coponent pad spacing （Detect clearance between pads of the same component）":
          - text: Coponent pad spacing
          - text: （Detect clearance between pads of the same component）
        - cell "No"
        - cell "No"
        - cell "No"
        - cell "Danger：0 Warning：0 Good：0":
          - generic: Danger：0
          - generic: Warning：0
          - generic: Good：0
      - row "Component clipped by board outline （Detect component boundary clipping by the board outline） No No No Danger：0 Warning：0 Good：0":
        - cell "Component clipped by board outline （Detect component boundary clipping by the board outline）":
          - text: Component clipped by board outline
          - text: （Detect component boundary clipping by the board outline）
        - cell "No"
        - cell "No"
        - cell "No"
        - cell "Danger：0 Warning：0 Good：0":
          - generic: Danger：0
          - generic: Warning：0
          - generic: Good：0
      - row "Pin inner edge （Measure if component pin edges extend past pad edges） No No No Danger：0 Warning：0 Good：0":
        - cell "Pin inner edge （Measure if component pin edges extend past pad edges）":
          - text: Pin inner edge
          - text: （Measure if component pin edges extend past pad edges）
        - cell "No"
        - cell "No"
        - cell "No"
        - cell "Danger：0 Warning：0 Good：0":
          - generic: Danger：0
          - generic: Warning：0
          - generic: Good：0
      - row "Pin left edge （Measure if component pin edges extend past pad edges） No No No Danger：0 Warning：0 Good：0":
        - cell "Pin left edge （Measure if component pin edges extend past pad edges）":
          - text: Pin left edge
          - text: （Measure if component pin edges extend past pad edges）
        - cell "No"
        - cell "No"
        - cell "No"
        - cell "Danger：0 Warning：0 Good：0":
          - generic: Danger：0
          - generic: Warning：0
          - generic: Good：0
      - row "Pin without pad （Detect if component pins without pads） No No No Danger：0 Warning：0 Good：0":
        - cell "Pin without pad （Detect if component pins without pads）":
          - text: Pin without pad
          - text: （Detect if component pins without pads）
        - cell "No"
        - cell "No"
        - cell "No"
        - cell "Danger：0 Warning：0 Good：0":
          - generic: Danger：0
          - generic: Warning：0
          - generic: Good：0
      - row "Pin outer edge （Measure if component pin edges extend past pad edges） No No No Danger：0 Warning：0 Good：0":
        - cell "Pin outer edge （Measure if component pin edges extend past pad edges）":
          - text: Pin outer edge
          - text: （Measure if component pin edges extend past pad edges）
        - cell "No"
        - cell "No"
        - cell "No"
        - cell "Danger：0 Warning：0 Good：0":
          - generic: Danger：0
          - generic: Warning：0
          - generic: Good：0
      - row "Pin right edge （Measure if component pin edges extend past pad edges） No No No Danger：0 Warning：0 Good：0":
        - cell "Pin right edge （Measure if component pin edges extend past pad edges）":
          - text: Pin right edge
          - text: （Measure if component pin edges extend past pad edges）
        - cell "No"
        - cell "No"
        - cell "No"
        - cell "Danger：0 Warning：0 Good：0":
          - generic: Danger：0
          - generic: Warning：0
          - generic: Good：0
      - row "Component through-hole （Detect misalignment of component through-hole pins to pad holes） No No No Danger：0 Warning：0 Good：0":
        - cell "Component through-hole （Detect misalignment of component through-hole pins to pad holes）":
          - text: Component through-hole
          - text: （Detect misalignment of component through-hole pins to pad holes）
        - cell "No"
        - cell "No"
        - cell "No"
        - cell "Danger：0 Warning：0 Good：0":
          - generic: Danger：0
          - generic: Warning：0
          - generic: Good：0
      - row "Component through-hole （Detect misalignment of component through-hole pins to pad holes） No No No Danger：0 Warning：0 Good：0":
        - cell "Component through-hole （Detect misalignment of component through-hole pins to pad holes）":
          - text: Component through-hole
          - text: （Detect misalignment of component through-hole pins to pad holes）
        - cell "No"
        - cell "No"
        - cell "No"
        - cell "Danger：0 Warning：0 Good：0":
          - generic: Danger：0
          - generic: Warning：0
          - generic: Good：0
      - row "Component through-hole （Detect misalignment of component through-hole pins to pad holes） No No No Danger：0 Warning：0 Good：0":
        - cell "Component through-hole （Detect misalignment of component through-hole pins to pad holes）":
          - text: Component through-hole
          - text: （Detect misalignment of component through-hole pins to pad holes）
        - cell "No"
        - cell "No"
        - cell "No"
        - cell "Danger：0 Warning：0 Good：0":
          - generic: Danger：0
          - generic: Warning：0
          - generic: Good：0
      - row "Missing hole for component pin （Detect component through-hole pins without corresponding holes） No No No Danger：0 Warning：0 Good：0":
        - cell "Missing hole for component pin （Detect component through-hole pins without corresponding holes）":
          - text: Missing hole for component pin
          - text: （Detect component through-hole pins without corresponding holes）
        - cell "No"
        - cell "No"
        - cell "No"
        - cell "Danger：0 Warning：0 Good：0":
          - generic: Danger：0
          - generic: Warning：0
          - generic: Good：0
      - row "Lead area overlapping pad （Detect insufficient overlap between component pins and pads） No No No Danger：0 Warning：0 Good：0":
        - cell "Lead area overlapping pad （Detect insufficient overlap between component pins and pads）":
          - text: Lead area overlapping pad
          - text: （Detect insufficient overlap between component pins and pads）
        - cell "No"
        - cell "No"
        - cell "No"
        - cell "Danger：0 Warning：0 Good：0":
          - generic: Danger：0
          - generic: Warning：0
          - generic: Good：0
  - list:
    - listitem "Undo(Ctrl+Z)"
    - listitem "Redo(Ctrl+Y)"
    - listitem "Zoom in(A)"
    - listitem "Zoom out(Z)"
    - listitem "Fit selection"
    - listitem "Fit window(K)"
    - listitem "Flip board(Shift+F)"
    - listitem "Measure(Ctrl+M)"
    - listitem "Export analysis report"
    - listitem "Configure custom rules"
    - listitem "Help Document"
    - listitem "Settings"
  - generic "nexus-header-board-gerbers.zip"
  - generic: Units：
  - generic: Metric（cm/mm）
  - button "PCB DFM"
  - button "SMT DFM"
  - button "DFM check"
  - generic: Description
  - generic: All
  - table:
    - rowgroup:
      - row "Analyze project Statistics Operation":
        - columnheader "Analyze project"
        - columnheader "Statistics"
        - columnheader "Operation"
  - generic: Routing layer analysis
  - table:
    - rowgroup:
      - row "Sharp trace corner 0, 0, 0 Details":
        - cell "Sharp trace corner"
        - cell "0, 0, 0"
        - cell "Details":
          - button "Details" [disabled]
      - row "BGA pad 0, 0, 0 Details":
        - cell "BGA pad"
        - cell "0, 0, 0"
        - cell "Details":
          - button "Details" [disabled]
      - row "Via placed within a pad 0, 0, 0 Details":
        - cell "Via placed within a pad"
        - cell "0, 0, 0"
        - cell "Details":
          - button "Details" [disabled]
      - row "Trace to board edge 0, 0, 0 Details":
        - cell "Trace to board edge"
        - cell "0, 0, 0"
        - cell "Details":
          - button "Details" [disabled]
      - row "Trace spacing 0, 0, 0 Details":
        - cell "Trace spacing"
        - cell "0, 0, 0"
        - cell "Details":
          - button "Details" [disabled]
      - row "Unconnected trace end 0, 0, 0 Details":
        - cell "Unconnected trace end"
        - cell "0, 0, 0"
        - cell "Details":
          - button "Details" [disabled]
      - row "Trace width 0, 0, 34 Details":
        - cell "Trace width"
        - cell "0, 0, 34"
        - cell "Details":
          - button "Details"
      - row "Fiducial 0, 0, 0 Details":
        - cell "Fiducial"
        - cell "0, 0, 0"
        - cell "Details":
          - button "Details" [disabled]
      - row "Pad to board edge 0, 0, 25 Details":
        - cell "Pad to board edge"
        - cell "0, 0, 25"
        - cell "Details":
          - button "Details"
      - row "Pad spacing 0, 0, 4 Details":
        - cell "Pad spacing"
        - cell "0, 0, 4"
        - cell "Details":
          - button "Details"
      - row "Plated through-hole to trace clearance 0, 0, 11 Details":
        - cell "Plated through-hole to trace clearance"
        - cell "0, 0, 11"
        - cell "Details":
          - button "Details"
      - row "Annular ring 0, 6, 21 Details":
        - cell "Annular ring"
        - cell "0, 6, 21"
        - cell "Details":
          - button "Details"
      - row "tht to smd 0, 26, 44 Details":
        - cell "tht to smd"
        - cell "0, 26, 44"
        - cell "Details":
          - button "Details"
      - row "Via to pad 0, 0, 2 Details":
        - cell "Via to pad"
        - cell "0, 0, 2"
        - cell "Details":
          - button "Details"
  - generic: Soldermask layer analysis
  - table:
    - rowgroup:
      - row "Soldermask bridge 0, 0, 0 Details":
        - cell "Soldermask bridge"
        - cell "0, 0, 0"
        - cell "Details":
          - button "Details" [disabled]
      - row "Solder mask opening exposing trace 0, 0, 0 Details":
        - cell "Solder mask opening exposing trace"
        - cell "0, 0, 0"
        - cell "Details":
          - button "Details" [disabled]
      - row "Soldermask opening with multiple segments 0, 0, 0 Details":
        - cell "Soldermask opening with multiple segments"
        - cell "0, 0, 0"
        - cell "Details":
          - button "Details" [disabled]
      - row "Negative soldermask expansion 0, 0, 0 Details":
        - cell "Negative soldermask expansion"
        - cell "0, 0, 0"
        - cell "Details":
          - button "Details" [disabled]
  - generic: Silkscreen layer analysis
  - table:
    - rowgroup:
      - row "Silkscreen to pad 0, 0, 0 Details":
        - cell "Silkscreen to pad"
        - cell "0, 0, 0"
        - cell "Details":
          - button "Details" [disabled]
      - row "Silkscreen to hole 0, 0, 0 Details":
        - cell "Silkscreen to hole"
        - cell "0, 0, 0"
        - cell "Details":
          - button "Details" [disabled]
      - row "Silkscreen line width 0, 0, 0 Details":
        - cell "Silkscreen line width"
        - cell "0, 0, 0"
        - cell "Details":
          - button "Details" [disabled]
  - generic: Drill layer analysis
  - table:
    - rowgroup:
      - row "Unconnected via 0, 0, 0 Details":
        - cell "Unconnected via"
        - cell "0, 0, 0"
        - cell "Details":
          - button "Details" [disabled]
      - row "Missing plated through-hole 0, 0, 0 Details":
        - cell "Missing plated through-hole"
        - cell "0, 0, 0"
        - cell "Details":
          - button "Details" [disabled]
      - row "Unconnected via 0, 0, 0 Details":
        - cell "Unconnected via"
        - cell "0, 0, 0"
        - cell "Details":
          - button "Details" [disabled]
      - row "Plated through-hole spacing 0, 0, 0 Details":
        - cell "Plated through-hole spacing"
        - cell "0, 0, 0"
        - cell "Details":
          - button "Details" [disabled]
      - row "Short slot detection 0, 0, 0 Details":
        - cell "Short slot detection"
        - cell "0, 0, 0"
        - cell "Details":
          - button "Details" [disabled]
      - row "Slot width check 0, 0, 0 Details":
        - cell "Slot width check"
        - cell "0, 0, 0"
        - cell "Details":
          - button "Details" [disabled]
      - row "Via to PTH spacing 0, 0, 0 Details":
        - cell "Via to PTH spacing"
        - cell "0, 0, 0"
        - cell "Details":
          - button "Details" [disabled]
      - row "Unconnected via 0, 0, 0 Details":
        - cell "Unconnected via"
        - cell "0, 0, 0"
        - cell "Details":
          - button "Details" [disabled]
  - generic "Close左侧栏"
  - generic "Gerber(5)": Gerber
  - generic "Gerber(6)": Wireframe
  - generic "2D(2)": 2D
  - generic "3D(3)": 3D
  - generic "Close右侧栏"
  - generic: Show layer controls
  - table:
    - rowgroup:
      - row "Edit Layer type":
        - columnheader
        - columnheader "Edit"
        - columnheader "Layer type"
    - rowgroup
  - status
  - generic: Exporting PDF, please wait...
  - text: 
