chenguoming1/h743-controllers/nexus-style-fc/docs/validation/reviews/jlcdfm-child-b49ef410/combined-report-visible-text.txt

https://dfm.jlcdfm.com/
DFM analysis report_JLCDFM
File name：
nexus-header-board-gerbers.zip
Report generated at：
2026-10-15 07:47:10
PCB layers：
2
PCB size：
2.24x1.1cm
Analyze project：
PCB DFM
SMT DFM
PCB DFM>Routing layer analysis
Analyze project	Analysis results	PCB screenshot	Layer distribution	Statistics
Sharp trace corner
（Check for sharp corners in traces）	No	No	No	Danger：0
Warning：0
Good：0
BGA pad
（Check BGA pads on the board）	No	No	No	Danger：0
Warning：0
Good：0
Via placed within a pad
（Check if there is a via placed within a pad）	No	No	No	Danger：0
Warning：0
Good：0
Trace to board edge
（Detect traces too close to the board edge）	No	No	No	Danger：0
Warning：0
Good：0
Trace spacing
（Measure spacing between adjacent parallel traces）	No	No	No	Danger：0
Warning：0
Good：0
Unconnected trace end
（Free-standing trace ends not connected to pads）	No	No	No	Danger：0
Warning：0
Good：0
Trace width
（Trace width information）	0.2mm
Good	No	
nexus-header-board-F_Cu.gtl
nexus-header-board-B_Cu.gbl
	Danger：0
Warning：0
Good：34
Fiducial
（Detect fiducial marks on the board）	No	No	No	Danger：0
Warning：0
Good：0
Pad to board edge
（Measure distance of pads from the board edge）	0.23mm
Good	No	
nexus-header-board-F_Cu.gtl
nexus-header-board-B_Cu.gbl
	Danger：0
Warning：0
Good：25
Pad spacing
（Measure pad to pad spacing）	0.37mm
Good	No	
nexus-header-board-B_Cu.gbl
	Danger：0
Warning：0
Good：4
Plated through-hole to trace clearance
（Measure clearance of plated through-holes to traces）	0.44mm
Good	No	
nexus-header-board-F_Cu.gtl
nexus-header-board-B_Cu.gbl
	Danger：0
Warning：0
Good：11
Annular ring
（Annular ring width of pads compared to holes）	0.15mm
Warning	No	
nexus-header-board-F_Cu.gtl
nexus-header-board-B_Cu.gbl
	Danger：0
Warning：6
Good：21
tht to smd
（Detect clearance of vias to pads）	2.35mm
Warning	No	
nexus-header-board-F_Cu.gtl
nexus-header-board-B_Cu.gbl
	Danger：0
Warning：26
Good：44
Via to pad
（Detect clearance of vias to pads）	0.2mm
Good	No	
nexus-header-board-F_Cu.gtl
nexus-header-board-B_Cu.gbl
	Danger：0
Warning：0
Good：2
PCB DFM>Soldermask layer analysis
Analyze project	Analysis results	PCB screenshot	Layer distribution	Statistics
Soldermask bridge
（Detect distance between parallel soldermask opening edges）	No	No	No	Danger：0
Warning：0
Good：0
Solder mask opening exposing trace
（Detect clearance of solder mask openings to nearby traces）	No	No	No	Danger：0
Warning：0
Good：0
Soldermask opening with multiple segments
（Check if solder mask openings are constructed from multiple geometric shapes）	No	No	No	Danger：0
Warning：0
Good：0
Negative soldermask expansion
（Detect solder mask openings smaller than their corresponding pads）	No	No	No	Danger：0
Warning：0
Good：0
PCB DFM>Silkscreen layer analysis
Analyze project	Analysis results	PCB screenshot	Layer distribution	Statistics
Silkscreen to pad
（Detect clearance of silkscreen to pads）	No	No	No	Danger：0
Warning：0
Good：0
Silkscreen to hole
（Detect clearance of silkscreen to holes）	No	No	No	Danger：0
Warning：0
Good：0
Silkscreen line width
（Check silkscreen line width）	No	No	No	Danger：0
Warning：0
Good：0
PCB DFM>Drill layer analysis
Analyze project	Analysis results	PCB screenshot	Layer distribution	Statistics
Unconnected via
（Detect isolated unconnected vias）	No	No	No	Danger：0
Warning：0
Good：0
Missing plated through-hole
（Detect top and bottom pads at the same location without plated through-holes）	No	No	No	Danger：0
Warning：0
Good：0
Unconnected via
（Detect isolated unconnected vias）	No	No	No	Danger：0
Warning：0
Good：0
Plated through-hole spacing
（Measure spacing between plated through-holes）	No	No	No	Danger：0
Warning：0
Good：0
Short slot detection
（Detect slots shorter than twice their width）	No	No	No	Danger：0
Warning：0
Good：0
Slot width check
（Measure slot width）	No	No	No	Danger：0
Warning：0
Good：0
Via to PTH spacing
（Measure spacing of vias to plated through-holes）	No	No	No	Danger：0
Warning：0
Good：0
Unconnected via
（Detect isolated unconnected vias）	No	No	No	Danger：0
Warning：0
Good：0
SMT DFM>Component assembly analysis
Analyze project	Analysis results	PCB screenshot	Layer distribution	Statistics
Component through-hole
（Detect misalignment of component through-hole pins to pad holes）	No	No	No	Danger：0
Warning：0
Good：0
Component collision warning
（Component collision warning;Component 1;Component 2）	No	No	No	Danger：0
Warning：0
Good：0
Component spacing
（Component to component spacing;Component 1;Component 2）	1.63mm
Good	No	
component_+_top
	Danger：0
Warning：0
Good：50
Component to board edge distance
（Measure distance from component outline to the board edge）	0.56mm
Warning	No	
component_+_top
	Danger：0
Warning：7
Good：0
Lead to hole distance
（Detect clearance of component leads to holes）	No	No	No	Danger：0
Warning：0
Good：0
Component through-hole
（Detect misalignment of component through-hole pins to pad holes）	No	No	No	Danger：0
Warning：0
Good：0
Coponent pad spacing
（Detect clearance between pads of the same component）	No	No	No	Danger：0
Warning：0
Good：0
Component clipped by board outline
（Detect component boundary clipping by the board outline）	No	No	No	Danger：0
Warning：0
Good：0
Pin inner edge
（Measure if component pin edges extend past pad edges）	No	No	No	Danger：0
Warning：0
Good：0
Pin left edge
（Measure if component pin edges extend past pad edges）	No	No	No	Danger：0
Warning：0
Good：0
Pin without pad
（Detect if component pins without pads）	No	No	No	Danger：0
Warning：0
Good：0
Pin outer edge
（Measure if component pin edges extend past pad edges）	No	No	No	Danger：0
Warning：0
Good：0
Pin right edge
（Measure if component pin edges extend past pad edges）	No	No	No	Danger：0
Warning：0
Good：0
Component through-hole
（Detect misalignment of component through-hole pins to pad holes）	No	No	No	Danger：0
Warning：0
Good：0
Component through-hole
（Detect misalignment of component through-hole pins to pad holes）	No	No	No	Danger：0
Warning：0
Good：0
Component through-hole
（Detect misalignment of component through-hole pins to pad holes）	No	No	No	Danger：0
Warning：0
Good：0
Missing hole for component pin
（Detect component through-hole pins without corresponding holes）	No	No	No	Danger：0
Warning：0
Good：0
Lead area overlapping pad
（Detect insufficient overlap between component pins and pads）	No	No	No	Danger：0
Warning：0
Good：0
nexus-header-board-gerbers.zip
Units：
Metric（cm/mm）
PCB DFM
SMT DFM
DFM check
Description
All
Analyze project	Statistics	Operation
Routing layer analysis
Sharp trace corner	0,  0,  0	Details
BGA pad	0,  0,  0	Details
Via placed within a pad	0,  0,  0	Details
Trace to board edge	0,  0,  0	Details
Trace spacing	0,  0,  0	Details
Unconnected trace end	0,  0,  0	Details
Trace width	0,  0,  34	Details
Fiducial	0,  0,  0	Details
Pad to board edge	0,  0,  25	Details
Pad spacing	0,  0,  4	Details
Plated through-hole to trace clearance	0,  0,  11	Details
Annular ring	0,  6,  21	Details
tht to smd	0,  26,  44	Details
Via to pad	0,  0,  2	Details
Soldermask layer analysis
Soldermask bridge	0,  0,  0	Details
Solder mask opening exposing trace	0,  0,  0	Details
Soldermask opening with multiple segments	0,  0,  0	Details
Negative soldermask expansion	0,  0,  0	Details
Silkscreen layer analysis
Silkscreen to pad	0,  0,  0	Details
Silkscreen to hole	0,  0,  0	Details
Silkscreen line width	0,  0,  0	Details
Drill layer analysis
Unconnected via	0,  0,  0	Details
Missing plated through-hole	0,  0,  0	Details
Unconnected via	0,  0,  0	Details
Plated through-hole spacing	0,  0,  0	Details
Short slot detection	0,  0,  0	Details
Slot width check	0,  0,  0	Details
Via to PTH spacing	0,  0,  0	Details
Unconnected via	0,  0,  0	Details
GerberWireframe2D3D
Show layer controls
	Edit	Layer type
Exporting PDF, please wait...
