chenguoming1/h743-controllers/nexus-style-fc/docs/validation/reviews/jlcdfm-main-stage35/combined-report-visible-text.txt

https://dfm.jlcdfm.com/
DFM analysis report_JLCDFM
File name：
nexus-style-fc-gerbers.zip
Report generated at：
2026-10-15 10:17:47
PCB layers：
6
PCB size：
2.24x3.31cm
Analyze project：
PCB DFM
SMT DFM
PCB DFM>Routing layer analysis
Analyze project	Analysis results	PCB screenshot	Layer distribution	Statistics
Sharp trace corner
（Check for sharp corners in traces）	null
Warning	No	
nexus-style-fc-B_Cu.gbl
nexus-style-fc-F_Cu.gtl
	Danger：0
Warning：2
Good：0
BGA pad
（Check BGA pads on the board）	No	No	No	Danger：0
Warning：0
Good：0
Via placed within a pad
（Check if there is a via placed within a pad）	No	No	No	Danger：0
Warning：0
Good：0
Trace to board edge
（Detect traces too close to the board edge）	No	No	No	Danger：0
Warning：0
Good：0
Trace spacing
（Measure spacing between adjacent parallel traces）	0.13mm
Warning	No	
nexus-style-fc-B_Cu.gbl
nexus-style-fc-F_Cu.gtl
	Danger：0
Warning：2
Good：3
Unconnected trace end
（Free-standing trace ends not connected to pads）	No	No	No	Danger：0
Warning：0
Good：0
Trace width
（Trace width information）	0.13mm
Warning	No	
nexus-style-fc-B_Cu.gbl
nexus-style-fc-F_Cu.gtl
	Danger：0
Warning：92
Good：8
Fiducial
（Detect fiducial marks on the board）	No	No	No	Danger：0
Warning：0
Good：0
Pad to board edge
（Measure distance of pads from the board edge）	0.25mm
Good	No	
nexus-style-fc-B_Cu.gbl
nexus-style-fc-F_Cu.gtl
	Danger：0
Warning：0
Good：55
Pad spacing
（Measure pad to pad spacing）	0.08mm
Danger	No	
nexus-style-fc-B_Cu.gbl
nexus-style-fc-F_Cu.gtl
	Danger：7
Warning：77
Good：16
Plated through-hole to trace clearance
（Measure clearance of plated through-holes to traces）	0.25mm
Good	No	
nexus-style-fc-B_Cu.gbl
nexus-style-fc-F_Cu.gtl
	Danger：0
Warning：0
Good：100
Annular ring
（Annular ring width of pads compared to holes）	0.12mm
Warning	No	
nexus-style-fc-B_Cu.gbl
nexus-style-fc-F_Cu.gtl
	Danger：0
Warning：100
Good：0
tht to smd
（Detect clearance of vias to pads）	No	No	No	Danger：0
Warning：0
Good：0
Via to pad
（Detect clearance of vias to pads）	0mm
Danger	No	
nexus-style-fc-B_Cu.gbl
nexus-style-fc-F_Cu.gtl
	Danger：3
Warning：1
Good：7
PCB DFM>Soldermask layer analysis
Analyze project	Analysis results	PCB screenshot	Layer distribution	Statistics
Soldermask bridge
（Detect distance between parallel soldermask opening edges）	0.2mm
Good	No	
nexus-style-fc-B_Mask.gbs
nexus-style-fc-F_Mask.gts
	Danger：0
Warning：0
Good：60
Solder mask opening exposing trace
（Detect clearance of solder mask openings to nearby traces）	0.1mm
Warning	No	
nexus-style-fc-B_Mask.gbs
nexus-style-fc-F_Mask.gts
	Danger：0
Warning：83
Good：4
Soldermask opening with multiple segments
（Check if solder mask openings are constructed from multiple geometric shapes）	No	No	No	Danger：0
Warning：0
Good：0
Negative soldermask expansion
（Detect solder mask openings smaller than their corresponding pads）	0.04mm
Warning	No	
nexus-style-fc-B_Mask.gbs
nexus-style-fc-F_Mask.gts
	Danger：0
Warning：10
Good：0
PCB DFM>Silkscreen layer analysis
Analyze project	Analysis results	PCB screenshot	Layer distribution	Statistics
Silkscreen to pad
（Detect clearance of silkscreen to pads）	0mm
Danger	No	
nexus-style-fc-B_Silkscreen.gbo
nexus-style-fc-F_Silkscreen.gto
	Danger：100
Warning：0
Good：0
Silkscreen to hole
（Detect clearance of silkscreen to holes）	0mm
Danger	No	
nexus-style-fc-B_Silkscreen.gbo
nexus-style-fc-F_Silkscreen.gto
	Danger：100
Warning：0
Good：0
Silkscreen line width
（Check silkscreen line width）	0.15mm
Warning	No	
nexus-style-fc-B_Silkscreen.gbo
nexus-style-fc-F_Silkscreen.gto
	Danger：0
Warning：44
Good：4
PCB DFM>Drill layer analysis
Analyze project	Analysis results	PCB screenshot	Layer distribution	Statistics
Unconnected via
（Detect isolated unconnected vias）	No	No	No	Danger：0
Warning：0
Good：0
Missing plated through-hole
（Detect top and bottom pads at the same location without plated through-holes）	No	No	No	Danger：0
Warning：0
Good：0
Unconnected via
（Detect isolated unconnected vias）	No	No	No	Danger：0
Warning：0
Good：0
Plated through-hole spacing
（Measure spacing between plated through-holes）	0.25mm
Good	No	
nexus-style-fc-PTH.drl
	Danger：0
Warning：0
Good：1
Short slot detection
（Detect slots shorter than twice their width）	0.25mm
Warning	No	
nexus-style-fc-PTH.drl
	Danger：0
Warning：4
Good：0
Slot width check
（Measure slot width）	0.6mm
Danger	No	
nexus-style-fc-PTH.drl
	Danger：4
Warning：0
Good：0
Via to PTH spacing
（Measure spacing of vias to plated through-holes）	No	No	No	Danger：0
Warning：0
Good：0
Unconnected via
（Detect isolated unconnected vias）	No	No	No	Danger：0
Warning：0
Good：0
SMT DFM>Component assembly analysis
Analyze project	Analysis results	PCB screenshot	Layer distribution	Statistics
Component through-hole
（Detect misalignment of component through-hole pins to pad holes）	No	No	No	Danger：0
Warning：0
Good：0
Component collision warning
（Component collision warning;Component 1;Component 2）	0mm
Good	No	
component_+_top
	Danger：0
Warning：0
Good：2
Component spacing
（Component to component spacing;Component 1;Component 2）	0.5mm
Good	No	
component_+_top
component_+_bottom
	Danger：0
Warning：0
Good：100
Component to board edge distance
（Measure distance from component outline to the board edge）	0.33mm
Danger	No	
component_+_top
component_+_bottom
	Danger：4
Warning：7
Good：3
Lead to hole distance
（Detect clearance of component leads to holes）	0mm
Danger	No	
component_+_top
component_+_bottom
	Danger：10
Warning：0
Good：0
Component through-hole
（Detect misalignment of component through-hole pins to pad holes）	0.96mm
Warning	No	
component_+_top
component_+_bottom
	Danger：0
Warning：7
Good：0
Coponent pad spacing
（Detect clearance between pads of the same component）	No	No	No	Danger：0
Warning：0
Good：0
Component clipped by board outline
（Detect component boundary clipping by the board outline）	No	No	No	Danger：0
Warning：0
Good：0
Pin inner edge
（Measure if component pin edges extend past pad edges）	No	No	No	Danger：0
Warning：0
Good：0
Pin left edge
（Measure if component pin edges extend past pad edges）	0mm
Danger	No	
component_+_top
component_+_bottom
	Danger：9
Warning：0
Good：0
Pin without pad
（Detect if component pins without pads）	null
Danger	No	
component_+_top
	Danger：1
Warning：0
Good：0
Pin outer edge
（Measure if component pin edges extend past pad edges）	0.15mm
Danger	No	
component_+_top
	Danger：2
Warning：0
Good：0
Pin right edge
（Measure if component pin edges extend past pad edges）	0mm
Danger	No	
component_+_top
component_+_bottom
	Danger：3
Warning：0
Good：0
Component through-hole
（Detect misalignment of component through-hole pins to pad holes）	No	No	No	Danger：0
Warning：0
Good：0
Component through-hole
（Detect misalignment of component through-hole pins to pad holes）	No	No	No	Danger：0
Warning：0
Good：0
Component through-hole
（Detect misalignment of component through-hole pins to pad holes）	No	No	No	Danger：0
Warning：0
Good：0
Missing hole for component pin
（Detect component through-hole pins without corresponding holes）	No	No	No	Danger：0
Warning：0
Good：0
Lead area overlapping pad
（Detect insufficient overlap between component pins and pads）	0.02mm
Danger	No	
component_+_top
	Danger：4
Warning：0
Good：0
