chenguoming1/h743-controllers/nexus-style-fc/routing-wip/2026-10-15/en-readable-checkpoint/schematic-review/CONNECTIVITY-REVIEW.txt

NEXUS-STYLE FC: CONNECTED FUNCTIONAL SCHEMATIC REVIEW
15 October 2026 | Unfinished PCB checkpoint; not released for fabrication

Result: PASS for schematic checks. Final integrated PCB DRC/parity remains the PCB lane's separate check.

The final drawing contains 15 functional panels. Regulator support, mux, sensor supply, ADC dividers, oscillator/reset, IMU/barometer, USB protection, receiver/servo clamps, flash pull-ups and LED branches are physically wired inside their units. Named labels primarily identify boundaries between units. The generator checks that every local terminal in these connected units is reachable through wire geometry, rather than through matching labels. The MCU remains a boundary-pin block and its decoupling is a separate rail-connected unit. The single-sheet hierarchy preserves PCB instance paths.

Native KiCad 10.0.7 checks:
- ERC: 0 errors, warnings or excluded violations.
- Exported pin map: all347 reference/pin pairs retained;346 unchanged.
- Sole authorized electrical delta: U10 pin3 EN, VSYS -> unconnected-(U10-EN-Pad3).
- U10 EN and pin4 have explicit no-connect markers; EN's intentional floating state is annotated.
- All91 symbol instances (88 physical parts +3 flags), all symbol/pin UUIDs, reference designators, instance paths, values, footprints and LCSC identifiers preserved.
- Root schematic UUID preserved. Wire and label drawing UUIDs changed with presentation.
- No PCB placement/routing file edited in the schematic task.

Visual QA: all15 final panel PNGs were inspected as actual pixels in three full-resolution contact sheets; detailed checks covered MCU, LDO, buck, USB and receivers. Wires avoid symbol bodies, pin-number areas and visible properties; junctions are explicit, unjoined crossings have no junction. Title block stays clear. The publication owner independently reviewed all15 connected-unit panels and confirmed the layout addresses the user's requested local connections.

Reproduction (from nexus-style-fc):
python3 tools/gen_schematic.py design hardware/nexus-style-fc.kicad_sch nexus-style-fc
kicad-cli sch export netlist -o connected.net hardware/nexus-style-fc.kicad_sch
kicad-cli sch erc --format json -o erc.json hardware/nexus-style-fc.kicad_sch
kicad-cli sch export pdf -o schematic-main.pdf hardware/nexus-style-fc.kicad_sch

For the main design only, generation uses Python3 and an exact project-local snapshot of all six reviewed stock symbol definitions in hardware/library/SchematicStock.kicad_sym, plus the unchanged NexusFC library. All embedded symbol definitions are byte-equivalent as parsed to latest-main, including all pin names, types, units, hidden/power flags and KiCad10 metadata. KICAD_SYMBOL_DIR (Linux default /usr/share/kicad/symbols; standard bundled path on macOS) is only a fallback for symbols absent from this snapshot. Header and other design modules do not load this snapshot and retain their external stock-library behavior. Native export/ERC uses KiCad10.0.7. Latest-main generator compatibility changes from866afe8 remain preserved. Consecutive generation runs match byte-for-byte. PCB physical loop quality or fabrication readiness is not inferred from schematic spacing.

Final schematic SHA256:
742252dba39bef886fefb10381fb6cb111bc63bf584c68309753b2e89fa7da18

Related evidence: validation.json, preview/erc.json, preview/connected.net, baseline/baseline.net, final-manifest.sha256. PDFs: preview/connected.pdf (one native vector sheet), preview/nexus-connected-circuits-review.pdf (15 vector detail pages with unfinished-checkpoint notices).

Post-correction visual confirmation: all15 newly rendered panel PNGs are byte-identical to the reviewed renders. The source ZIP is an overlay for the repository, not a replacement for its unchanged footprint library.
