chenguoming1/h743-controllers/nexus-style-fc/routing-wip/2026-10-15/stage36-main-child-checkpoint/reviews/jlcdfm-stage10/main-combined-report-visible-text.txt

- text: 
- main:
  - generic: https://dfm.jlcdfm.com/
  - generic: DFM analysis report_JLCDFM
  - generic: File name：
  - generic: nexus-style-fc-gerbers.zip
  - generic: Report generated at：
  - generic: 2026-10-15 05:59:23
  - generic: PCB layers：
  - generic: "6"
  - generic: PCB size：
  - generic: 2.24x3.31cm
  - generic: Analyze project：
  - checkbox "PCB DFM" [checked]
  - text: PCB DFM
  - checkbox "SMT DFM" [checked]
  - text: SMT DFM
  - generic: PCB DFM>Routing layer analysis
  - table:
    - rowgroup:
      - row "Analyze project Analysis results PCB screenshot Layer distribution Statistics":
        - columnheader "Analyze project"
        - columnheader "Analysis results"
        - columnheader "PCB screenshot"
        - columnheader "Layer distribution"
        - columnheader "Statistics"
    - rowgroup:
      - row "Sharp trace corner （Check for sharp corners in traces） null Warning No nexus-style-fc-F_Cu.gtl nexus-style-fc-B_Cu.gbl Danger：0 Warning：2 Good：0":
        - cell "Sharp trace corner （Check for sharp corners in traces）":
          - text: Sharp trace corner
          - text: （Check for sharp corners in traces）
        - cell "null Warning":
          - text: "null"
          - text: Warning
        - cell "No"
        - cell "nexus-style-fc-F_Cu.gtl nexus-style-fc-B_Cu.gbl":
          - generic: nexus-style-fc-F_Cu.gtl
          - generic: nexus-style-fc-B_Cu.gbl
        - cell "Danger：0 Warning：2 Good：0":
          - generic: Danger：0
          - generic: Warning：2
          - generic: Good：0
      - row "BGA pad （Check BGA pads on the board） No No No Danger：0 Warning：0 Good：0":
        - cell "BGA pad （Check BGA pads on the board）":
          - text: BGA pad
          - text: （Check BGA pads on the board）
        - cell "No"
        - cell "No"
        - cell "No"
        - cell "Danger：0 Warning：0 Good：0":
          - generic: Danger：0
          - generic: Warning：0
          - generic: Good：0
      - row "Via placed within a pad （Check if there is a via placed within a pad） No No No Danger：0 Warning：0 Good：0":
        - cell "Via placed within a pad （Check if there is a via placed within a pad）":
          - text: Via placed within a pad
          - text: （Check if there is a via placed within a pad）
        - cell "No"
        - cell "No"
        - cell "No"
        - cell "Danger：0 Warning：0 Good：0":
          - generic: Danger：0
          - generic: Warning：0
          - generic: Good：0
      - row "Trace to board edge （Detect traces too close to the board edge） No No No Danger：0 Warning：0 Good：0":
        - cell "Trace to board edge （Detect traces too close to the board edge）":
          - text: Trace to board edge
          - text: （Detect traces too close to the board edge）
        - cell "No"
        - cell "No"
        - cell "No"
        - cell "Danger：0 Warning：0 Good：0":
          - generic: Danger：0
          - generic: Warning：0
          - generic: Good：0
      - row "Trace spacing （Measure spacing between adjacent parallel traces） 0.14mm Warning No nexus-style-fc-F_Cu.gtl nexus-style-fc-B_Cu.gbl Danger：0 Warning：2 Good：3":
        - cell "Trace spacing （Measure spacing between adjacent parallel traces）":
          - text: Trace spacing
          - text: （Measure spacing between adjacent parallel traces）
        - cell "0.14mm Warning":
          - text: 0.14mm
          - text: Warning
        - cell "No"
        - cell "nexus-style-fc-F_Cu.gtl nexus-style-fc-B_Cu.gbl":
          - generic: nexus-style-fc-F_Cu.gtl
          - generic: nexus-style-fc-B_Cu.gbl
        - cell "Danger：0 Warning：2 Good：3":
          - generic: Danger：0
          - generic: Warning：2
          - generic: Good：3
      - row "Unconnected trace end （Free-standing trace ends not connected to pads） No No No Danger：0 Warning：0 Good：0":
        - cell "Unconnected trace end （Free-standing trace ends not connected to pads）":
          - text: Unconnected trace end
          - text: （Free-standing trace ends not connected to pads）
        - cell "No"
        - cell "No"
        - cell "No"
        - cell "Danger：0 Warning：0 Good：0":
          - generic: Danger：0
          - generic: Warning：0
          - generic: Good：0
      - row "Trace width （Trace width information） 0.13mm Warning No nexus-style-fc-F_Cu.gtl nexus-style-fc-B_Cu.gbl Danger：0 Warning：96 Good：4":
        - cell "Trace width （Trace width information）":
          - text: Trace width
          - text: （Trace width information）
        - cell "0.13mm Warning":
          - text: 0.13mm
          - text: Warning
        - cell "No"
        - cell "nexus-style-fc-F_Cu.gtl nexus-style-fc-B_Cu.gbl":
          - generic: nexus-style-fc-F_Cu.gtl
          - generic: nexus-style-fc-B_Cu.gbl
        - cell "Danger：0 Warning：96 Good：4":
          - generic: Danger：0
          - generic: Warning：96
          - generic: Good：4
      - row "Fiducial （Detect fiducial marks on the board） No No No Danger：0 Warning：0 Good：0":
        - cell "Fiducial （Detect fiducial marks on the board）":
          - text: Fiducial
          - text: （Detect fiducial marks on the board）
        - cell "No"
        - cell "No"
        - cell "No"
        - cell "Danger：0 Warning：0 Good：0":
          - generic: Danger：0
          - generic: Warning：0
          - generic: Good：0
      - row "Pad to board edge （Measure distance of pads from the board edge） 0.28mm Good No nexus-style-fc-F_Cu.gtl nexus-style-fc-B_Cu.gbl Danger：0 Warning：0 Good：54":
        - cell "Pad to board edge （Measure distance of pads from the board edge）":
          - text: Pad to board edge
          - text: （Measure distance of pads from the board edge）
        - cell "0.28mm Good":
          - text: 0.28mm
          - text: Good
        - cell "No"
        - cell "nexus-style-fc-F_Cu.gtl nexus-style-fc-B_Cu.gbl":
          - generic: nexus-style-fc-F_Cu.gtl
          - generic: nexus-style-fc-B_Cu.gbl
        - cell "Danger：0 Warning：0 Good：54":
          - generic: Danger：0
          - generic: Warning：0
          - generic: Good：54
      - row "Pad spacing （Measure pad to pad spacing） 0.05mm Danger No nexus-style-fc-F_Cu.gtl nexus-style-fc-B_Cu.gbl Danger：9 Warning：83 Good：8":
        - cell "Pad spacing （Measure pad to pad spacing）":
          - text: Pad spacing
          - text: （Measure pad to pad spacing）
        - cell "0.05mm Danger":
          - text: 0.05mm
          - text: Danger
        - cell "No"
        - cell "nexus-style-fc-F_Cu.gtl nexus-style-fc-B_Cu.gbl":
          - generic: nexus-style-fc-F_Cu.gtl
          - generic: nexus-style-fc-B_Cu.gbl
        - cell "Danger：9 Warning：83 Good：8":
          - generic: Danger：9
          - generic: Warning：83
          - generic: Good：8
      - row "Plated through-hole to trace clearance （Measure clearance of plated through-holes to traces） 0.25mm Good No nexus-style-fc-F_Cu.gtl nexus-style-fc-B_Cu.gbl Danger：0 Warning：0 Good：100":
        - cell "Plated through-hole to trace clearance （Measure clearance of plated through-holes to traces）":
          - text: Plated through-hole to trace clearance
          - text: （Measure clearance of plated through-holes to traces）
        - cell "0.25mm Good":
          - text: 0.25mm
          - text: Good
        - cell "No"
        - cell "nexus-style-fc-F_Cu.gtl nexus-style-fc-B_Cu.gbl":
          - generic: nexus-style-fc-F_Cu.gtl
          - generic: nexus-style-fc-B_Cu.gbl
        - cell "Danger：0 Warning：0 Good：100":
          - generic: Danger：0
          - generic: Warning：0
          - generic: Good：100
      - row "Annular ring （Annular ring width of pads compared to holes） 0.12mm Warning No nexus-style-fc-F_Cu.gtl nexus-style-fc-B_Cu.gbl Danger：0 Warning：100 Good：0":
        - cell "Annular ring （Annular ring width of pads compared to holes）":
          - text: Annular ring
          - text: （Annular ring width of pads compared to holes）
        - cell "0.12mm Warning":
          - text: 0.12mm
          - text: Warning
        - cell "No"
        - cell "nexus-style-fc-F_Cu.gtl nexus-style-fc-B_Cu.gbl":
          - generic: nexus-style-fc-F_Cu.gtl
          - generic: nexus-style-fc-B_Cu.gbl
        - cell "Danger：0 Warning：100 Good：0":
          - generic: Danger：0
          - generic: Warning：100
          - generic: Good：0
      - row "tht to smd （Detect clearance of vias to pads） No No No Danger：0 Warning：0 Good：0":
        - cell "tht to smd （Detect clearance of vias to pads）":
          - text: tht to smd
          - text: （Detect clearance of vias to pads）
        - cell "No"
        - cell "No"
        - cell "No"
        - cell "Danger：0 Warning：0 Good：0":
          - generic: Danger：0
          - generic: Warning：0
          - generic: Good：0
      - row "Via to pad （Detect clearance of vias to pads） 0mm Danger No nexus-style-fc-F_Cu.gtl nexus-style-fc-B_Cu.gbl Danger：6 Warning：1 Good：7":
        - cell "Via to pad （Detect clearance of vias to pads）":
          - text: Via to pad
          - text: （Detect clearance of vias to pads）
        - cell "0mm Danger":
          - text: 0mm
          - text: Danger
        - cell "No"
        - cell "nexus-style-fc-F_Cu.gtl nexus-style-fc-B_Cu.gbl":
          - generic: nexus-style-fc-F_Cu.gtl
          - generic: nexus-style-fc-B_Cu.gbl
        - cell "Danger：6 Warning：1 Good：7":
          - generic: Danger：6
          - generic: Warning：1
          - generic: Good：7
  - generic: PCB DFM>Soldermask layer analysis
  - table:
    - rowgroup:
      - row "Analyze project Analysis results PCB screenshot Layer distribution Statistics":
        - columnheader "Analyze project"
        - columnheader "Analysis results"
        - columnheader "PCB screenshot"
        - columnheader "Layer distribution"
        - columnheader "Statistics"
    - rowgroup:
      - row "Soldermask bridge （Detect distance between parallel soldermask opening edges） 0.2mm Good No nexus-style-fc-F_Mask.gts nexus-style-fc-B_Mask.gbs Danger：0 Warning：0 Good：60":
        - cell "Soldermask bridge （Detect distance between parallel soldermask opening edges）":
          - text: Soldermask bridge
          - text: （Detect distance between parallel soldermask opening edges）
        - cell "0.2mm Good":
          - text: 0.2mm
          - text: Good
        - cell "No"
        - cell "nexus-style-fc-F_Mask.gts nexus-style-fc-B_Mask.gbs":
          - generic: nexus-style-fc-F_Mask.gts
          - generic: nexus-style-fc-B_Mask.gbs
        - cell "Danger：0 Warning：0 Good：60":
          - generic: Danger：0
          - generic: Warning：0
          - generic: Good：60
      - row "Solder mask opening exposing trace （Detect clearance of solder mask openings to nearby traces） 0.11mm Warning No nexus-style-fc-F_Mask.gts nexus-style-fc-B_Mask.gbs Danger：0 Warning：96 Good：4":
        - cell "Solder mask opening exposing trace （Detect clearance of solder mask openings to nearby traces）":
          - text: Solder mask opening exposing trace
          - text: （Detect clearance of solder mask openings to nearby traces）
        - cell "0.11mm Warning":
          - text: 0.11mm
          - text: Warning
        - cell "No"
        - cell "nexus-style-fc-F_Mask.gts nexus-style-fc-B_Mask.gbs":
          - generic: nexus-style-fc-F_Mask.gts
          - generic: nexus-style-fc-B_Mask.gbs
        - cell "Danger：0 Warning：96 Good：4":
          - generic: Danger：0
          - generic: Warning：96
          - generic: Good：4
      - row "Soldermask opening with multiple segments （Check if solder mask openings are constructed from multiple geometric shapes） No No No Danger：0 Warning：0 Good：0":
        - cell "Soldermask opening with multiple segments （Check if solder mask openings are constructed from multiple geometric shapes）":
          - text: Soldermask opening with multiple segments
          - text: （Check if solder mask openings are constructed from multiple geometric shapes）
        - cell "No"
        - cell "No"
        - cell "No"
        - cell "Danger：0 Warning：0 Good：0":
          - generic: Danger：0
          - generic: Warning：0
          - generic: Good：0
      - row "Negative soldermask expansion （Detect solder mask openings smaller than their corresponding pads） 0mm Warning No nexus-style-fc-F_Mask.gts nexus-style-fc-B_Mask.gbs Danger：0 Warning：9 Good：0":
        - cell "Negative soldermask expansion （Detect solder mask openings smaller than their corresponding pads）":
          - text: Negative soldermask expansion
          - text: （Detect solder mask openings smaller than their corresponding pads）
        - cell "0mm Warning":
          - text: 0mm
          - text: Warning
        - cell "No"
        - cell "nexus-style-fc-F_Mask.gts nexus-style-fc-B_Mask.gbs":
          - generic: nexus-style-fc-F_Mask.gts
          - generic: nexus-style-fc-B_Mask.gbs
        - cell "Danger：0 Warning：9 Good：0":
          - generic: Danger：0
          - generic: Warning：9
          - generic: Good：0
  - generic: PCB DFM>Silkscreen layer analysis
  - table:
    - rowgroup:
      - row "Analyze project Analysis results PCB screenshot Layer distribution Statistics":
        - columnheader "Analyze project"
        - columnheader "Analysis results"
        - columnheader "PCB screenshot"
        - columnheader "Layer distribution"
        - columnheader "Statistics"
    - rowgroup:
      - row "Silkscreen to pad （Detect clearance of silkscreen to pads） 0mm Danger No nexus-style-fc-F_Silkscreen.gto nexus-style-fc-B_Silkscreen.gbo Danger：100 Warning：0 Good：0":
        - cell "Silkscreen to pad （Detect clearance of silkscreen to pads）":
          - text: Silkscreen to pad
          - text: （Detect clearance of silkscreen to pads）
        - cell "0mm Danger":
          - text: 0mm
          - text: Danger
        - cell "No"
        - cell "nexus-style-fc-F_Silkscreen.gto nexus-style-fc-B_Silkscreen.gbo":
          - generic: nexus-style-fc-F_Silkscreen.gto
          - generic: nexus-style-fc-B_Silkscreen.gbo
        - cell "Danger：100 Warning：0 Good：0":
          - generic: Danger：100
          - generic: Warning：0
          - generic: Good：0
      - row "Silkscreen to hole （Detect clearance of silkscreen to holes） 0mm Danger No nexus-style-fc-F_Silkscreen.gto nexus-style-fc-B_Silkscreen.gbo Danger：100 Warning：0 Good：0":
        - cell "Silkscreen to hole （Detect clearance of silkscreen to holes）":
          - text: Silkscreen to hole
          - text: （Detect clearance of silkscreen to holes）
        - cell "0mm Danger":
          - text: 0mm
          - text: Danger
        - cell "No"
        - cell "nexus-style-fc-F_Silkscreen.gto nexus-style-fc-B_Silkscreen.gbo":
          - generic: nexus-style-fc-F_Silkscreen.gto
          - generic: nexus-style-fc-B_Silkscreen.gbo
        - cell "Danger：100 Warning：0 Good：0":
          - generic: Danger：100
          - generic: Warning：0
          - generic: Good：0
      - row "Silkscreen line width （Check silkscreen line width） 0.15mm Warning No nexus-style-fc-F_Silkscreen.gto nexus-style-fc-B_Silkscreen.gbo Danger：0 Warning：44 Good：4":
        - cell "Silkscreen line width （Check silkscreen line width）":
          - text: Silkscreen line width
          - text: （Check silkscreen line width）
        - cell "0.15mm Warning":
          - text: 0.15mm
          - text: Warning
        - cell "No"
        - cell "nexus-style-fc-F_Silkscreen.gto nexus-style-fc-B_Silkscreen.gbo":
          - generic: nexus-style-fc-F_Silkscreen.gto
          - generic: nexus-style-fc-B_Silkscreen.gbo
        - cell "Danger：0 Warning：44 Good：4":
          - generic: Danger：0
          - generic: Warning：44
          - generic: Good：4
  - generic: PCB DFM>Drill layer analysis
  - table:
    - rowgroup:
      - row "Analyze project Analysis results PCB screenshot Layer distribution Statistics":
        - columnheader "Analyze project"
        - columnheader "Analysis results"
        - columnheader "PCB screenshot"
        - columnheader "Layer distribution"
        - columnheader "Statistics"
    - rowgroup:
      - row "Unconnected via （Detect isolated unconnected vias） No No No Danger：0 Warning：0 Good：0":
        - cell "Unconnected via （Detect isolated unconnected vias）":
          - text: Unconnected via
          - text: （Detect isolated unconnected vias）
        - cell "No"
        - cell "No"
        - cell "No"
        - cell "Danger：0 Warning：0 Good：0":
          - generic: Danger：0
          - generic: Warning：0
          - generic: Good：0
      - row "Missing plated through-hole （Detect top and bottom pads at the same location without plated through-holes） No No No Danger：0 Warning：0 Good：0":
        - cell "Missing plated through-hole （Detect top and bottom pads at the same location without plated through-holes）":
          - text: Missing plated through-hole
          - text: （Detect top and bottom pads at the same location without plated through-holes）
        - cell "No"
        - cell "No"
        - cell "No"
        - cell "Danger：0 Warning：0 Good：0":
          - generic: Danger：0
          - generic: Warning：0
          - generic: Good：0
      - row "Unconnected via （Detect isolated unconnected vias） No No No Danger：0 Warning：0 Good：0":
        - cell "Unconnected via （Detect isolated unconnected vias）":
          - text: Unconnected via
          - text: （Detect isolated unconnected vias）
        - cell "No"
        - cell "No"
        - cell "No"
        - cell "Danger：0 Warning：0 Good：0":
          - generic: Danger：0
          - generic: Warning：0
          - generic: Good：0
      - row "Plated through-hole spacing （Measure spacing between plated through-holes） 0.25mm Good No nexus-style-fc-PTH.drl Danger：0 Warning：0 Good：1":
        - cell "Plated through-hole spacing （Measure spacing between plated through-holes）":
          - text: Plated through-hole spacing
          - text: （Measure spacing between plated through-holes）
        - cell "0.25mm Good":
          - text: 0.25mm
          - text: Good
        - cell "No"
        - cell "nexus-style-fc-PTH.drl":
          - generic: nexus-style-fc-PTH.drl
        - cell "Danger：0 Warning：0 Good：1":
          - generic: Danger：0
          - generic: Warning：0
          - generic: Good：1
      - row "Short slot detection （Detect slots shorter than twice their width） 0.25mm Warning No nexus-style-fc-PTH.drl Danger：0 Warning：4 Good：0":
        - cell "Short slot detection （Detect slots shorter than twice their width）":
          - text: Short slot detection
          - text: （Detect slots shorter than twice their width）
        - cell "0.25mm Warning":
          - text: 0.25mm
          - text: Warning
        - cell "No"
        - cell "nexus-style-fc-PTH.drl":
          - generic: nexus-style-fc-PTH.drl
        - cell "Danger：0 Warning：4 Good：0":
          - generic: Danger：0
          - generic: Warning：4
          - generic: Good：0
      - row "Slot width check （Measure slot width） 0.6mm Danger No nexus-style-fc-PTH.drl Danger：4 Warning：0 Good：0":
        - cell "Slot width check （Measure slot width）":
          - text: Slot width check
          - text: （Measure slot width）
        - cell "0.6mm Danger":
          - text: 0.6mm
          - text: Danger
        - cell "No"
        - cell "nexus-style-fc-PTH.drl":
          - generic: nexus-style-fc-PTH.drl
        - cell "Danger：4 Warning：0 Good：0":
          - generic: Danger：4
          - generic: Warning：0
          - generic: Good：0
      - row "Via to PTH spacing （Measure spacing of vias to plated through-holes） No No No Danger：0 Warning：0 Good：0":
        - cell "Via to PTH spacing （Measure spacing of vias to plated through-holes）":
          - text: Via to PTH spacing
          - text: （Measure spacing of vias to plated through-holes）
        - cell "No"
        - cell "No"
        - cell "No"
        - cell "Danger：0 Warning：0 Good：0":
          - generic: Danger：0
          - generic: Warning：0
          - generic: Good：0
      - row "Unconnected via （Detect isolated unconnected vias） No No No Danger：0 Warning：0 Good：0":
        - cell "Unconnected via （Detect isolated unconnected vias）":
          - text: Unconnected via
          - text: （Detect isolated unconnected vias）
        - cell "No"
        - cell "No"
        - cell "No"
        - cell "Danger：0 Warning：0 Good：0":
          - generic: Danger：0
          - generic: Warning：0
          - generic: Good：0
  - generic: SMT DFM>Component assembly analysis
  - table:
    - rowgroup:
      - row "Analyze project Analysis results PCB screenshot Layer distribution Statistics":
        - columnheader "Analyze project"
        - columnheader "Analysis results"
        - columnheader "PCB screenshot"
        - columnheader "Layer distribution"
        - columnheader "Statistics"
    - rowgroup:
      - row "Component through-hole （Detect misalignment of component through-hole pins to pad holes） No No No Danger：0 Warning：0 Good：0":
        - cell "Component through-hole （Detect misalignment of component through-hole pins to pad holes）":
          - text: Component through-hole
          - text: （Detect misalignment of component through-hole pins to pad holes）
        - cell "No"
        - cell "No"
        - cell "No"
        - cell "Danger：0 Warning：0 Good：0":
          - generic: Danger：0
          - generic: Warning：0
          - generic: Good：0
      - row "Component collision warning （Component collision warning;Component 1;Component 2） 0mm Good No component_+_top Danger：0 Warning：0 Good：2":
        - cell "Component collision warning （Component collision warning;Component 1;Component 2）":
          - text: Component collision warning
          - text: （Component collision warning;Component 1;Component 2）
        - cell "0mm Good":
          - text: 0mm
          - text: Good
        - cell "No"
        - cell "component_+_top":
          - generic: component_+_top
        - cell "Danger：0 Warning：0 Good：2":
          - generic: Danger：0
          - generic: Warning：0
          - generic: Good：2
      - row "Component spacing （Component to component spacing;Component 1;Component 2） 0.5mm Good No component_+_top component_+_bottom Danger：0 Warning：0 Good：100":
        - cell "Component spacing （Component to component spacing;Component 1;Component 2）":
          - text: Component spacing
          - text: （Component to component spacing;Component 1;Component 2）
        - cell "0.5mm Good":
          - text: 0.5mm
          - text: Good
        - cell "No"
        - cell "component_+_top component_+_bottom":
          - generic: component_+_top
          - generic: component_+_bottom
        - cell "Danger：0 Warning：0 Good：100":
          - generic: Danger：0
          - generic: Warning：0
          - generic: Good：100
      - row "Component to board edge distance （Measure distance from component outline to the board edge） 0.33mm Danger No component_+_top component_+_bottom Danger：2 Warning：6 Good：4":
        - cell "Component to board edge distance （Measure distance from component outline to the board edge）":
          - text: Component to board edge distance
          - text: （Measure distance from component outline to the board edge）
        - cell "0.33mm Danger":
          - text: 0.33mm
          - text: Danger
        - cell "No"
        - cell "component_+_top component_+_bottom":
          - generic: component_+_top
          - generic: component_+_bottom
        - cell "Danger：2 Warning：6 Good：4":
          - generic: Danger：2
          - generic: Warning：6
          - generic: Good：4
      - row "Lead to hole distance （Detect clearance of component leads to holes） 0mm Danger No component_+_top component_+_bottom Danger：12 Warning：0 Good：0":
        - cell "Lead to hole distance （Detect clearance of component leads to holes）":
          - text: Lead to hole distance
          - text: （Detect clearance of component leads to holes）
        - cell "0mm Danger":
          - text: 0mm
          - text: Danger
        - cell "No"
        - cell "component_+_top component_+_bottom":
          - generic: component_+_top
          - generic: component_+_bottom
        - cell "Danger：12 Warning：0 Good：0":
          - generic: Danger：12
          - generic: Warning：0
          - generic: Good：0
      - row "Component through-hole （Detect misalignment of component through-hole pins to pad holes） null Warning No component_+_top component_+_bottom Danger：0 Warning：7 Good：0":
        - cell "Component through-hole （Detect misalignment of component through-hole pins to pad holes）":
          - text: Component through-hole
          - text: （Detect misalignment of component through-hole pins to pad holes）
        - cell "null Warning":
          - text: "null"
          - text: Warning
        - cell "No"
        - cell "component_+_top component_+_bottom":
          - generic: component_+_top
          - generic: component_+_bottom
        - cell "Danger：0 Warning：7 Good：0":
          - generic: Danger：0
          - generic: Warning：7
          - generic: Good：0
      - row "Coponent pad spacing （Detect clearance between pads of the same component） No No No Danger：0 Warning：0 Good：0":
        - cell "Coponent pad spacing （Detect clearance between pads of the same component）":
          - text: Coponent pad spacing
          - text: （Detect clearance between pads of the same component）
        - cell "No"
        - cell "No"
        - cell "No"
        - cell "Danger：0 Warning：0 Good：0":
          - generic: Danger：0
          - generic: Warning：0
          - generic: Good：0
      - row "Component clipped by board outline （Detect component boundary clipping by the board outline） No No No Danger：0 Warning：0 Good：0":
        - cell "Component clipped by board outline （Detect component boundary clipping by the board outline）":
          - text: Component clipped by board outline
          - text: （Detect component boundary clipping by the board outline）
        - cell "No"
        - cell "No"
        - cell "No"
        - cell "Danger：0 Warning：0 Good：0":
          - generic: Danger：0
          - generic: Warning：0
          - generic: Good：0
      - row "Pin inner edge （Measure if component pin edges extend past pad edges） No No No Danger：0 Warning：0 Good：0":
        - cell "Pin inner edge （Measure if component pin edges extend past pad edges）":
          - text: Pin inner edge
          - text: （Measure if component pin edges extend past pad edges）
        - cell "No"
        - cell "No"
        - cell "No"
        - cell "Danger：0 Warning：0 Good：0":
          - generic: Danger：0
          - generic: Warning：0
          - generic: Good：0
      - row "Pin left edge （Measure if component pin edges extend past pad edges） 0mm Danger No component_+_top component_+_bottom Danger：8 Warning：0 Good：0":
        - cell "Pin left edge （Measure if component pin edges extend past pad edges）":
          - text: Pin left edge
          - text: （Measure if component pin edges extend past pad edges）
        - cell "0mm Danger":
          - text: 0mm
          - text: Danger
        - cell "No"
        - cell "component_+_top component_+_bottom":
          - generic: component_+_top
          - generic: component_+_bottom
        - cell "Danger：8 Warning：0 Good：0":
          - generic: Danger：8
          - generic: Warning：0
          - generic: Good：0
      - row "Pin without pad （Detect if component pins without pads） null Danger No component_+_top Danger：1 Warning：0 Good：0":
        - cell "Pin without pad （Detect if component pins without pads）":
          - text: Pin without pad
          - text: （Detect if component pins without pads）
        - cell "null Danger":
          - text: "null"
          - text: Danger
        - cell "No"
        - cell "component_+_top":
          - generic: component_+_top
        - cell "Danger：1 Warning：0 Good：0":
          - generic: Danger：1
          - generic: Warning：0
          - generic: Good：0
      - row "Pin outer edge （Measure if component pin edges extend past pad edges） 0.21mm Danger No component_+_top Danger：2 Warning：0 Good：0":
        - cell "Pin outer edge （Measure if component pin edges extend past pad edges）":
          - text: Pin outer edge
          - text: （Measure if component pin edges extend past pad edges）
        - cell "0.21mm Danger":
          - text: 0.21mm
          - text: Danger
        - cell "No"
        - cell "component_+_top":
          - generic: component_+_top
        - cell "Danger：2 Warning：0 Good：0":
          - generic: Danger：2
          - generic: Warning：0
          - generic: Good：0
      - row "Pin right edge （Measure if component pin edges extend past pad edges） 0mm Danger No component_+_top component_+_bottom Danger：2 Warning：0 Good：0":
        - cell "Pin right edge （Measure if component pin edges extend past pad edges）":
          - text: Pin right edge
          - text: （Measure if component pin edges extend past pad edges）
        - cell "0mm Danger":
          - text: 0mm
          - text: Danger
        - cell "No"
        - cell "component_+_top component_+_bottom":
          - generic: component_+_top
          - generic: component_+_bottom
        - cell "Danger：2 Warning：0 Good：0":
          - generic: Danger：2
          - generic: Warning：0
          - generic: Good：0
      - row "Component through-hole （Detect misalignment of component through-hole pins to pad holes） No No No Danger：0 Warning：0 Good：0":
        - cell "Component through-hole （Detect misalignment of component through-hole pins to pad holes）":
          - text: Component through-hole
          - text: （Detect misalignment of component through-hole pins to pad holes）
        - cell "No"
        - cell "No"
        - cell "No"
        - cell "Danger：0 Warning：0 Good：0":
          - generic: Danger：0
          - generic: Warning：0
          - generic: Good：0
      - row "Component through-hole （Detect misalignment of component through-hole pins to pad holes） No No No Danger：0 Warning：0 Good：0":
        - cell "Component through-hole （Detect misalignment of component through-hole pins to pad holes）":
          - text: Component through-hole
          - text: （Detect misalignment of component through-hole pins to pad holes）
        - cell "No"
        - cell "No"
        - cell "No"
        - cell "Danger：0 Warning：0 Good：0":
          - generic: Danger：0
          - generic: Warning：0
          - generic: Good：0
      - row "Component through-hole （Detect misalignment of component through-hole pins to pad holes） No No No Danger：0 Warning：0 Good：0":
        - cell "Component through-hole （Detect misalignment of component through-hole pins to pad holes）":
          - text: Component through-hole
          - text: （Detect misalignment of component through-hole pins to pad holes）
        - cell "No"
        - cell "No"
        - cell "No"
        - cell "Danger：0 Warning：0 Good：0":
          - generic: Danger：0
          - generic: Warning：0
          - generic: Good：0
      - row "Missing hole for component pin （Detect component through-hole pins without corresponding holes） No No No Danger：0 Warning：0 Good：0":
        - cell "Missing hole for component pin （Detect component through-hole pins without corresponding holes）":
          - text: Missing hole for component pin
          - text: （Detect component through-hole pins without corresponding holes）
        - cell "No"
        - cell "No"
        - cell "No"
        - cell "Danger：0 Warning：0 Good：0":
          - generic: Danger：0
          - generic: Warning：0
          - generic: Good：0
      - row "Lead area overlapping pad （Detect insufficient overlap between component pins and pads） 0.01mm Danger No component_+_top Danger：4 Warning：0 Good：0":
        - cell "Lead area overlapping pad （Detect insufficient overlap between component pins and pads）":
          - text: Lead area overlapping pad
          - text: （Detect insufficient overlap between component pins and pads）
        - cell "0.01mm Danger":
          - text: 0.01mm
          - text: Danger
        - cell "No"
        - cell "component_+_top":
          - generic: component_+_top
        - cell "Danger：4 Warning：0 Good：0":
          - generic: Danger：4
          - generic: Warning：0
          - generic: Good：0
