chenguoming1/h743-controllers/f722-heli/docs/release-blockers.md

# Current prototype CAM and assembly review conditions

The frozen final95 geometry, native checks, exact-board electrical analysis and manufacturing-export verification are complete. The package is **verified prototype files for CAM/assembly review**. See [prototype handoff](prototype-handoff.md) and [final electrical assessment](final-electrical-review.md) for exact scopes, assumptions and margins.

Factory stackup/CAM acceptance, exact R16 supply, 0201 process, USB shell and THT handling, placement preview, actual mating harness and first-article physical tests remain required. Nominal DSM 0.5 A is not a ±5% terminal guarantee; selected Hobbywing/KST pulse, thermal, contact and command-level conditions are not fully qualified. No 30 A board rating, production qualification or flight release is claimed.

Earlier routing/checkpoint records are historical and do not replace this exact-board status. All nine native warnings remain visible with eight operating/local spreading-field dispositions and one retained zero-transport PERIPH tail.
