chenguoming1/h743-controllers/f722-heli/docs/vcap-r16-correction.md

# Selected R16 VCAP network and assembly limits

The final95 project selects Panasonic **ERJ3RSFR12V / C4059772**, **0.120 Ω ±1%, 0.1 W**, with dedicated `F722_Heli:R_Panasonic_ERJ3R_0603` lands. Supplier spelling ERJ-3RSFR12V denotes the same part. No alternative is authorized. Current selection is bound by unchanged hardware/parts.json, the native board and the complete procurement BOM.
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
