chenguoming1/h743-controllers/b-rid/review/renders/top-3d.png

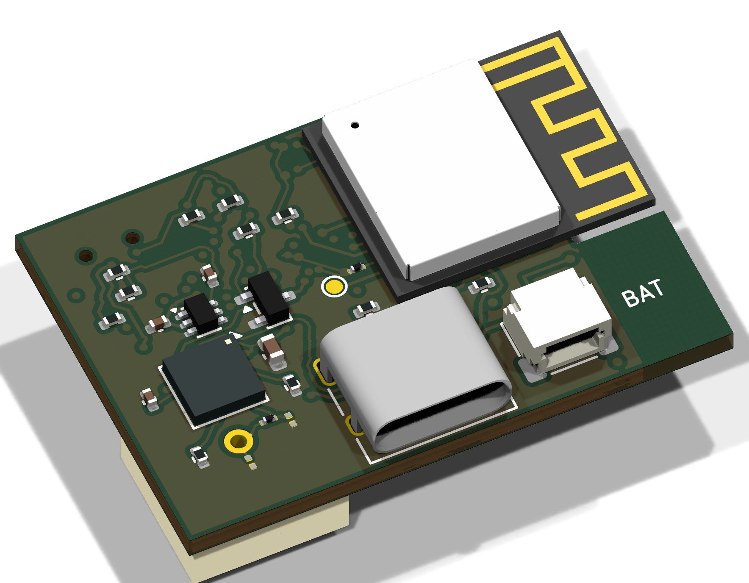
b-rid/review/renders/top-3d.png
