chenguoming1/h743-controllers/b-rid/review/renders/vbus-before-after.png

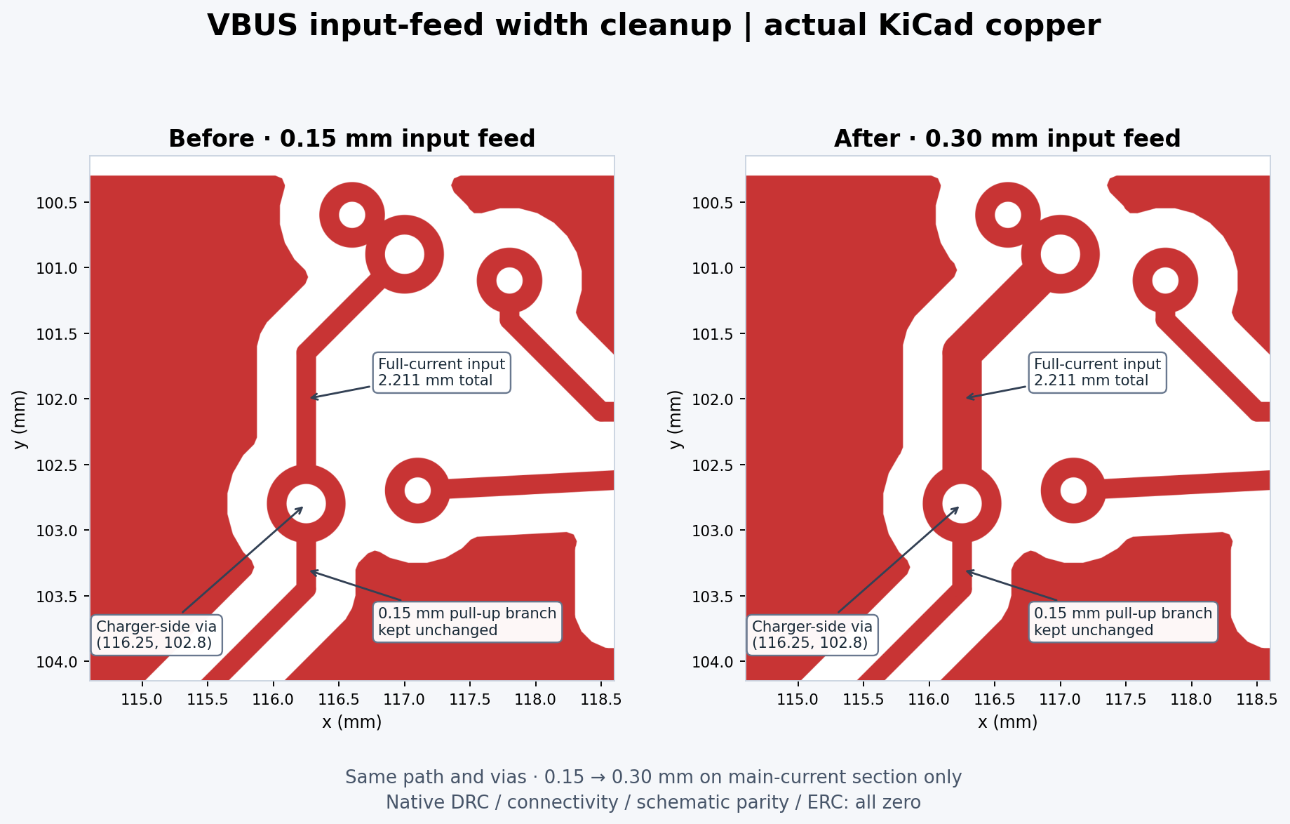
b-rid/review/renders/vbus-before-after.png
