chenguoming1/h743-controllers/b-rid/review/renders/vsys-before-after.png

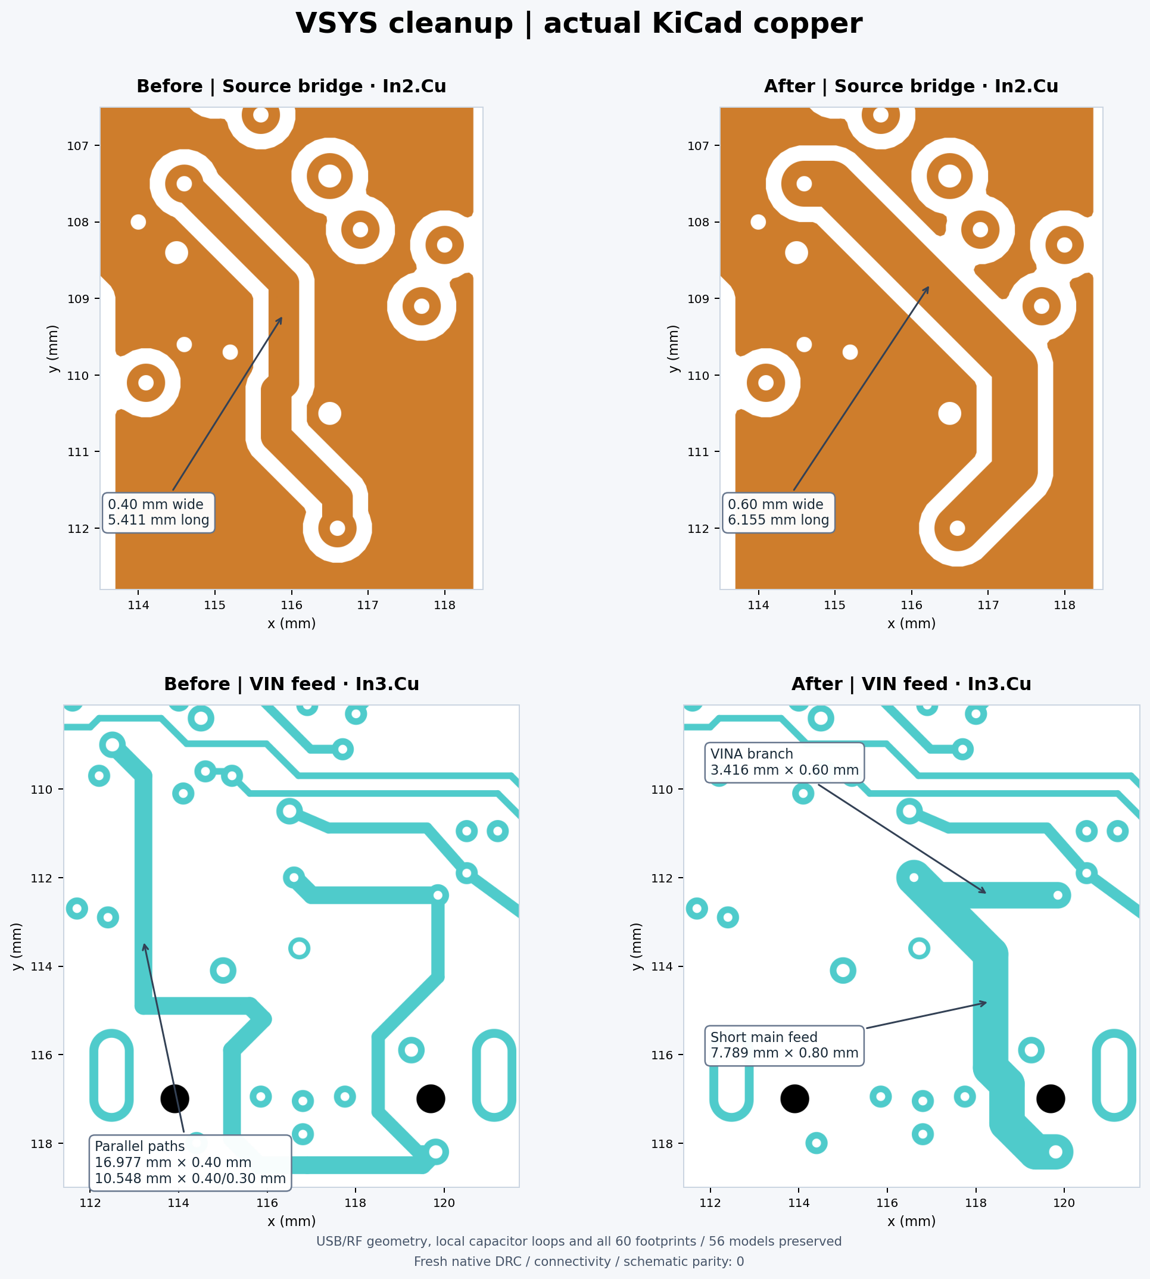
b-rid/review/renders/vsys-before-after.png
