chenguoming1/h743-controllers/f722-heli/evidence/imu-final95-review/candidate/six-layer-audit.png

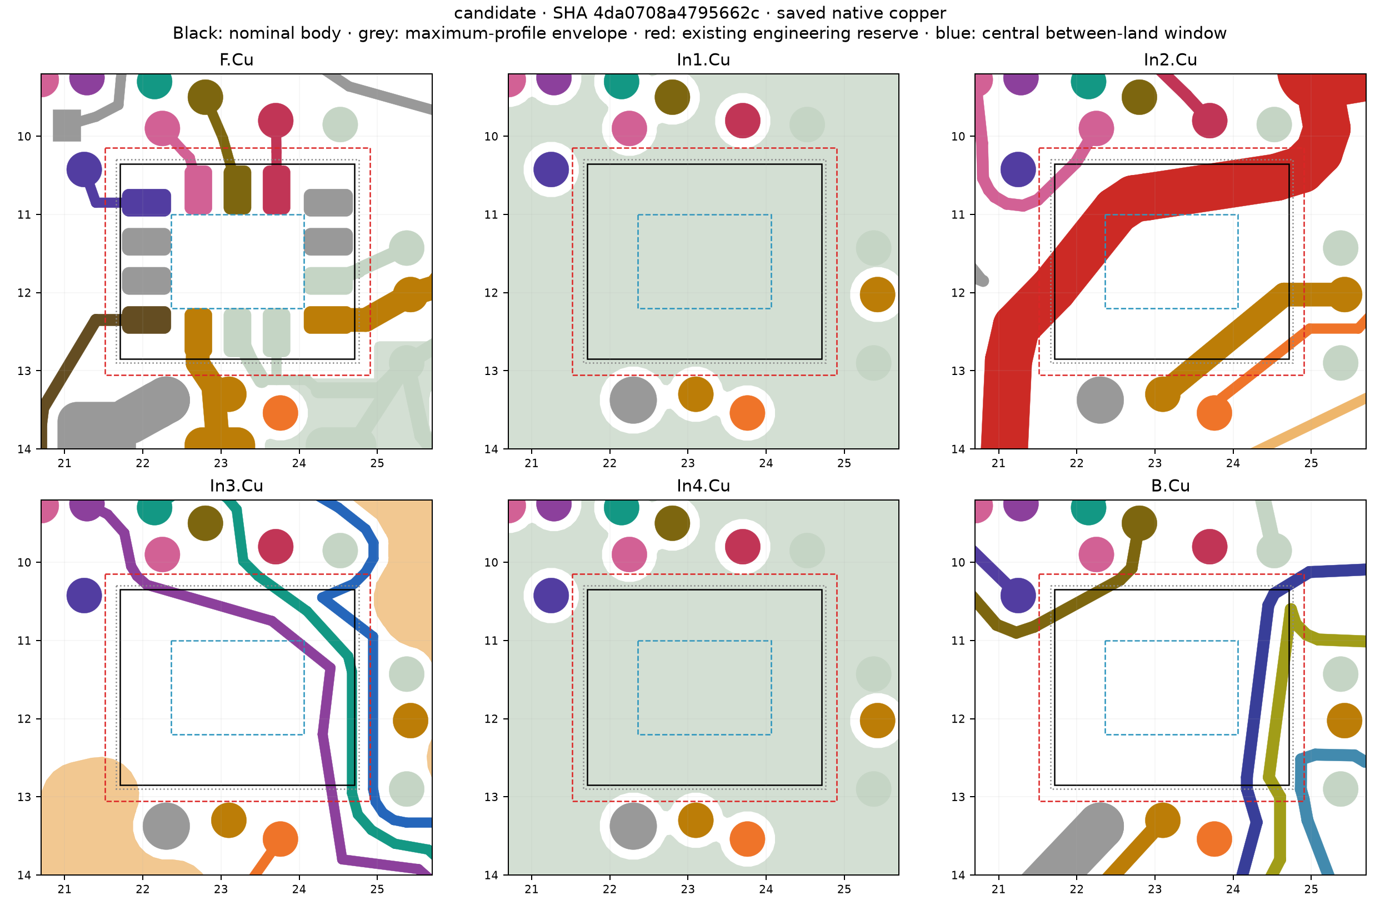
f722-heli/evidence/imu-final95-review/candidate/six-layer-audit.png
