chenguoming1/h743-controllers/f722-heli/layout-revision/checks/placement-back.png

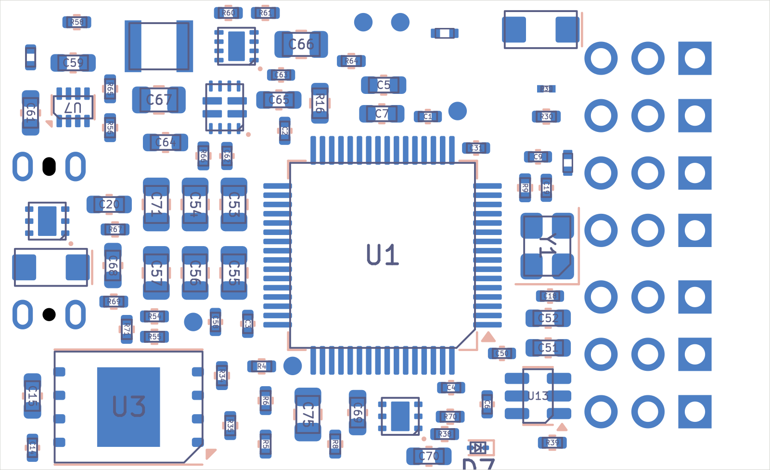
f722-heli/layout-revision/checks/placement-back.png
