chenguoming1/h743-controllers/f722-heli/layout-revision/checks/placement-interior.png

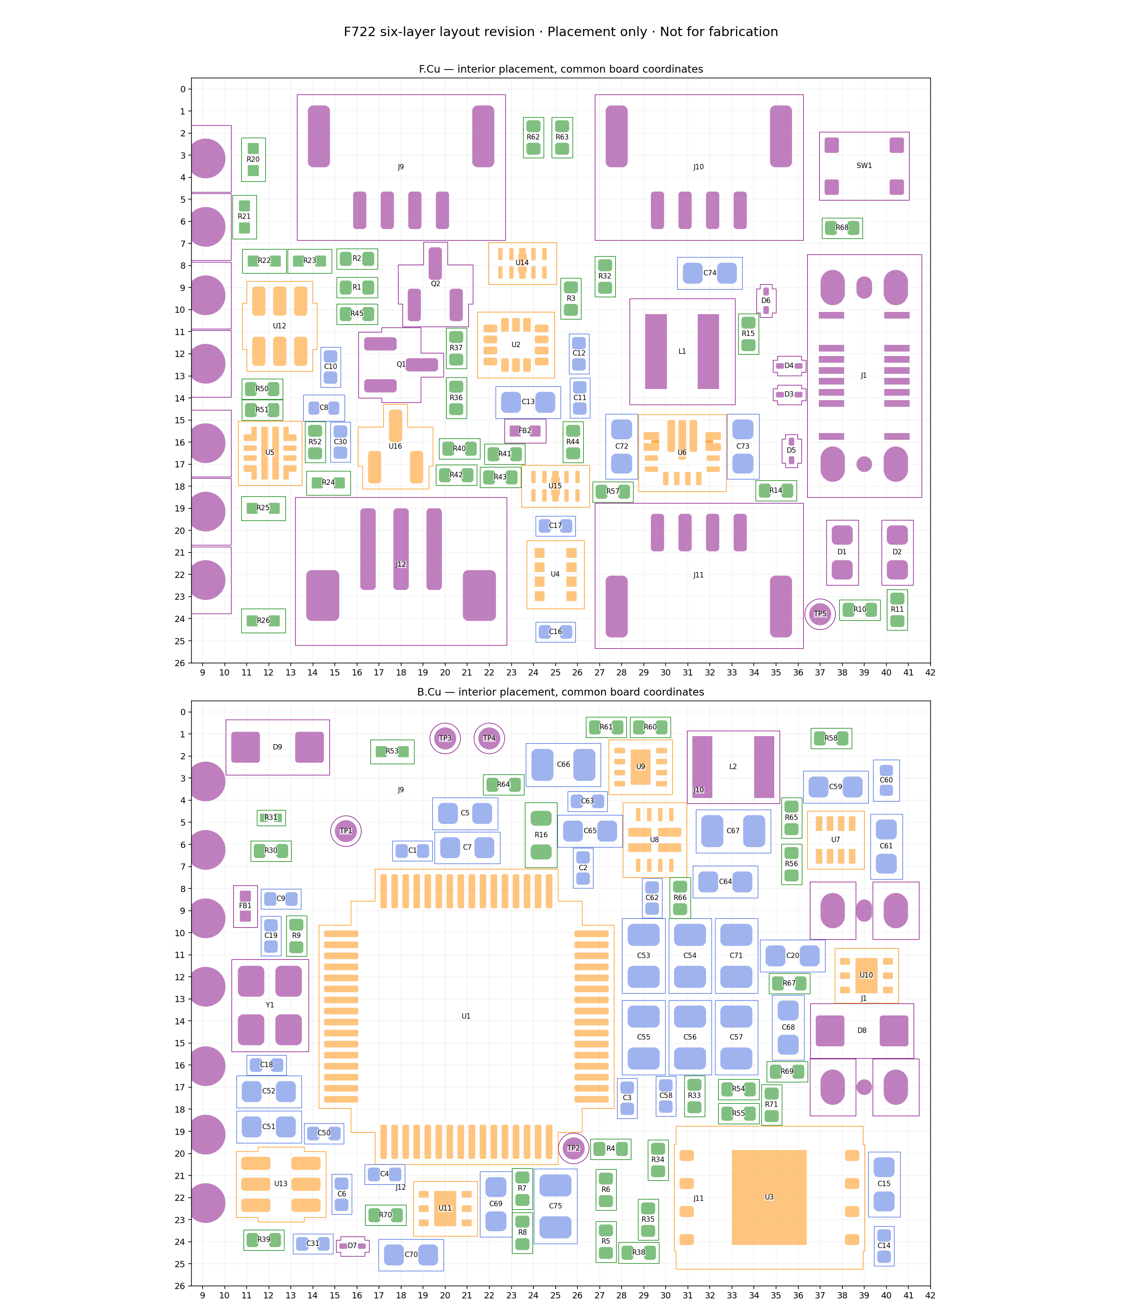
f722-heli/layout-revision/checks/placement-interior.png
