chenguoming1/h743-controllers/nexus-style-fc/docs/images/header-board-front.png

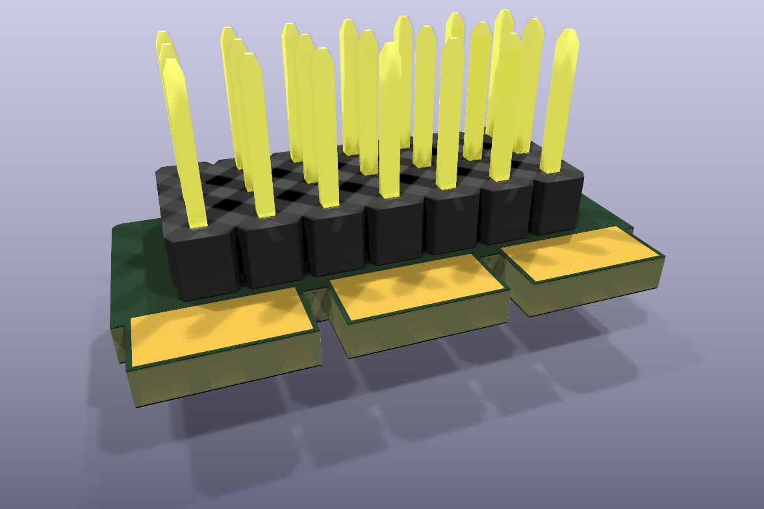
nexus-style-fc/docs/images/header-board-front.png
