chenguoming1/h743-controllers/nexus-style-fc/docs/images/joint-top-angle.png

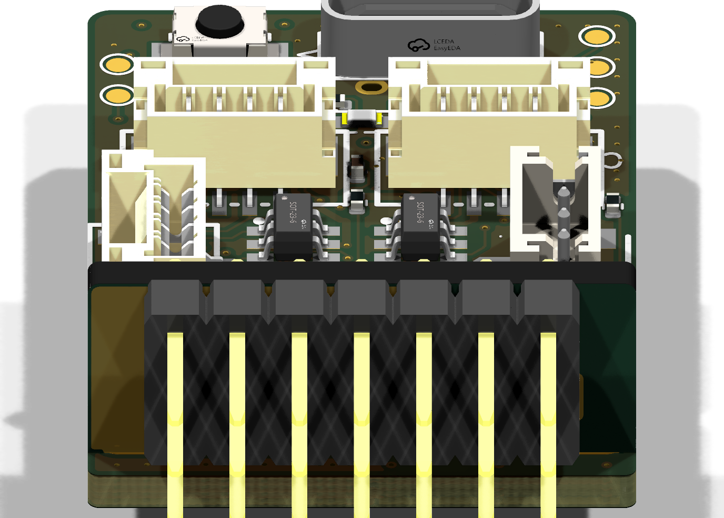
nexus-style-fc/docs/images/joint-top-angle.png
