chenguoming1/h743-controllers/nexus-style-fc/docs/images/joint-top-side.png

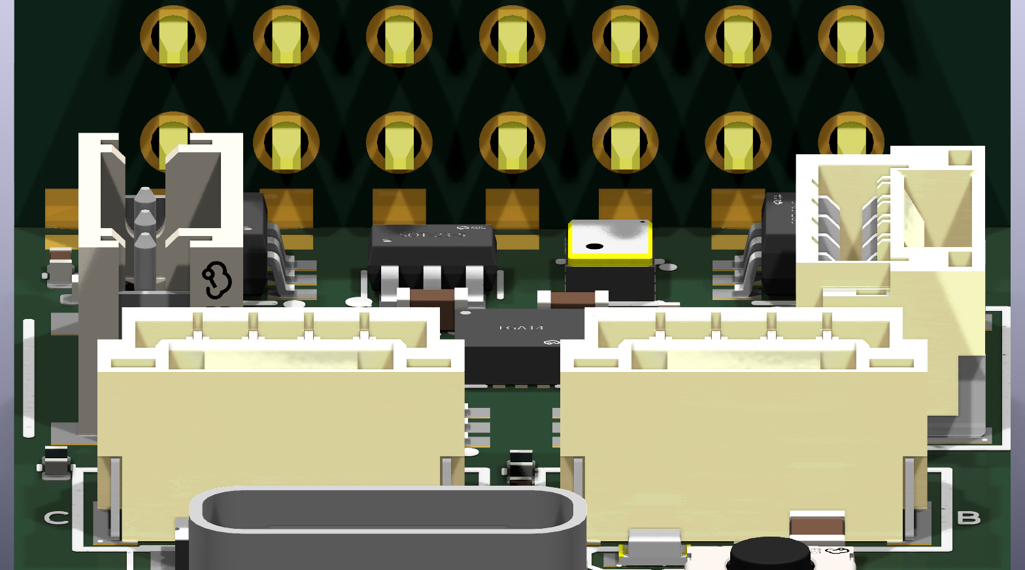
nexus-style-fc/docs/images/joint-top-side.png
