chenguoming1/h743-controllers/nexus-style-fc/docs/images/joint-underside.png

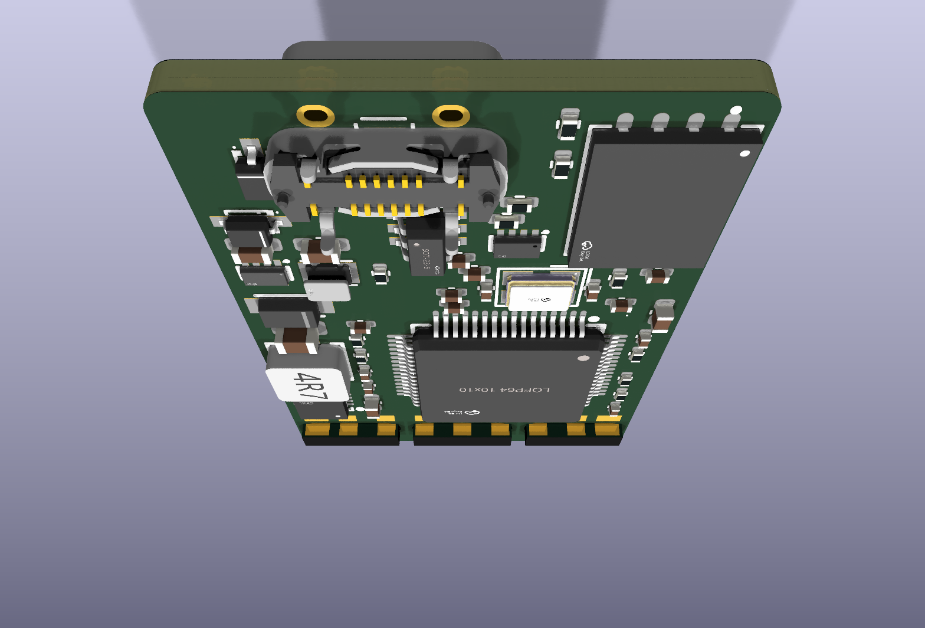
nexus-style-fc/docs/images/joint-underside.png
