chenguoming1/h743-controllers/nexus-style-fc/outputs/daughter-board-quote-20261018/settings.png

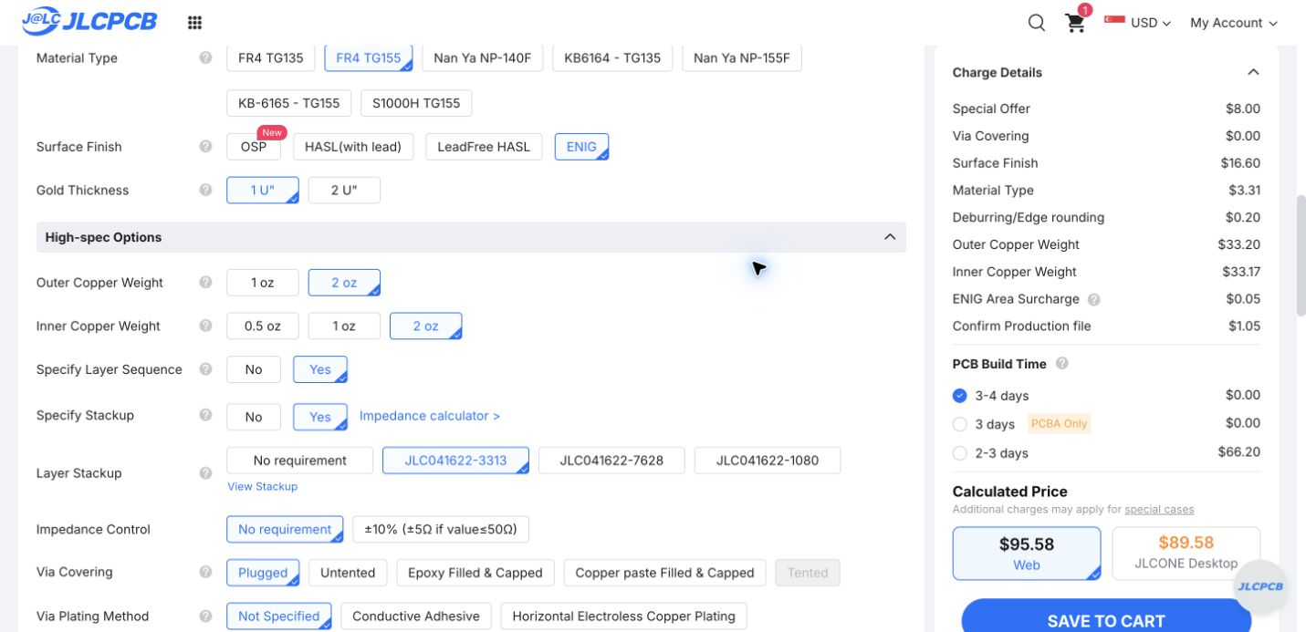
nexus-style-fc/outputs/daughter-board-quote-20261018/settings.png
