chenguoming1/h743-controllers/nexus-style-fc/routing-wip/2026-10-15/assembly-source-checkpoint/accepted/visual-proof/after/schematic.png

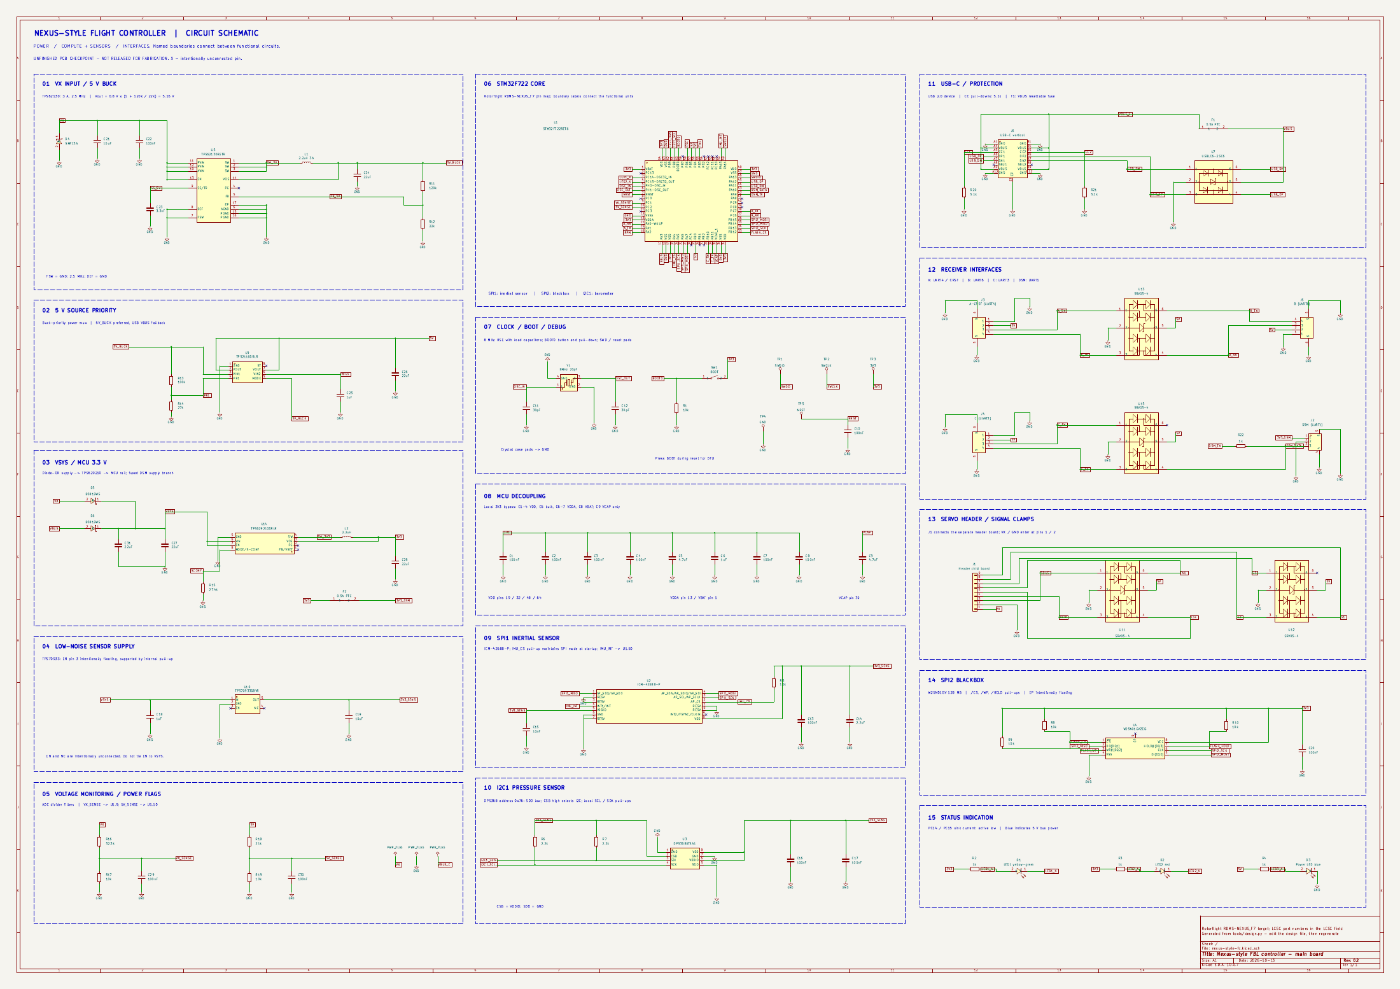
nexus-style-fc/routing-wip/2026-10-15/assembly-source-checkpoint/accepted/visual-proof/after/schematic.png
