chenguoming1/h743-controllers/nexus-style-fc/routing-wip/2026-10-15/drafted-circuits-checkpoint/schematic-review/preview/column-3.png

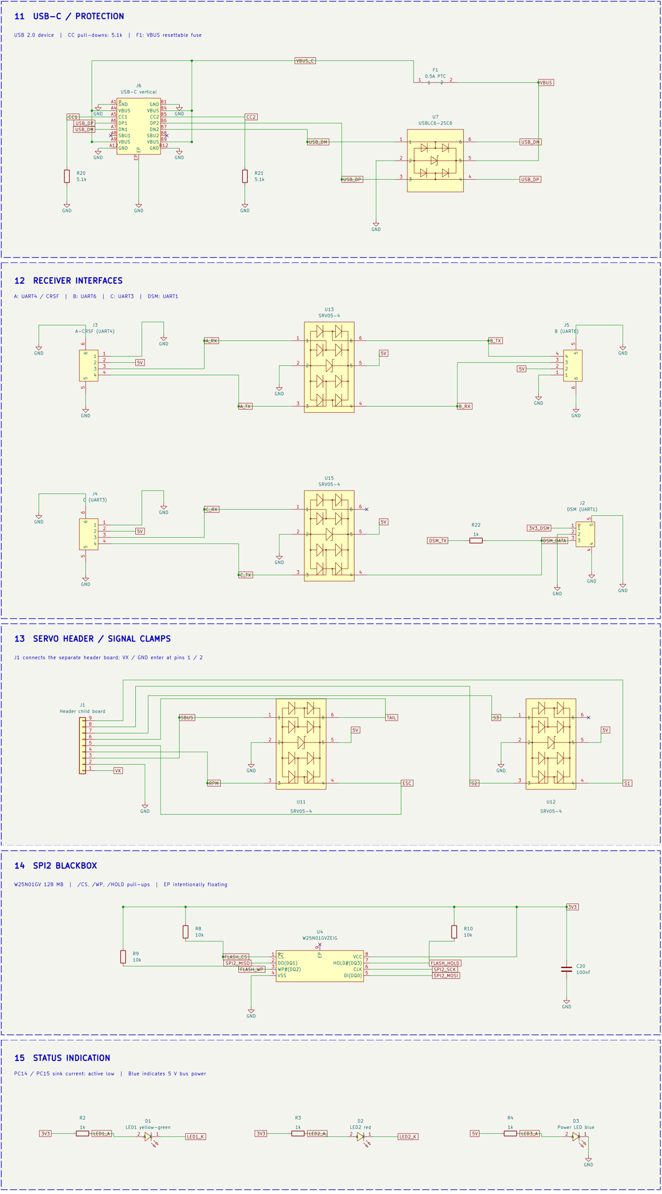
nexus-style-fc/routing-wip/2026-10-15/drafted-circuits-checkpoint/schematic-review/preview/column-3.png
