chenguoming1/h743-controllers/nexus-style-fc/routing-wip/2026-10-15/input-caps-checkpoint/schematic-source-evidence/preview/panel-04.png

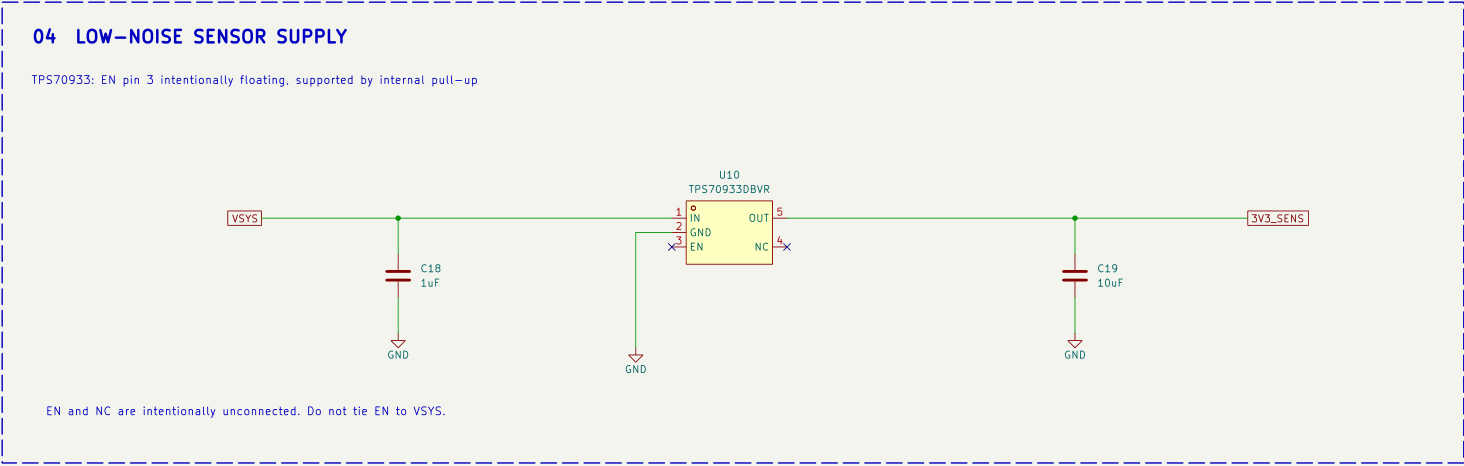
nexus-style-fc/routing-wip/2026-10-15/input-caps-checkpoint/schematic-source-evidence/preview/panel-04.png
