chenguoming1/h743-controllers/nexus-style-fc/routing-wip/2026-10-15/local-r57-checkpoint/filter-integration/preview/source.png

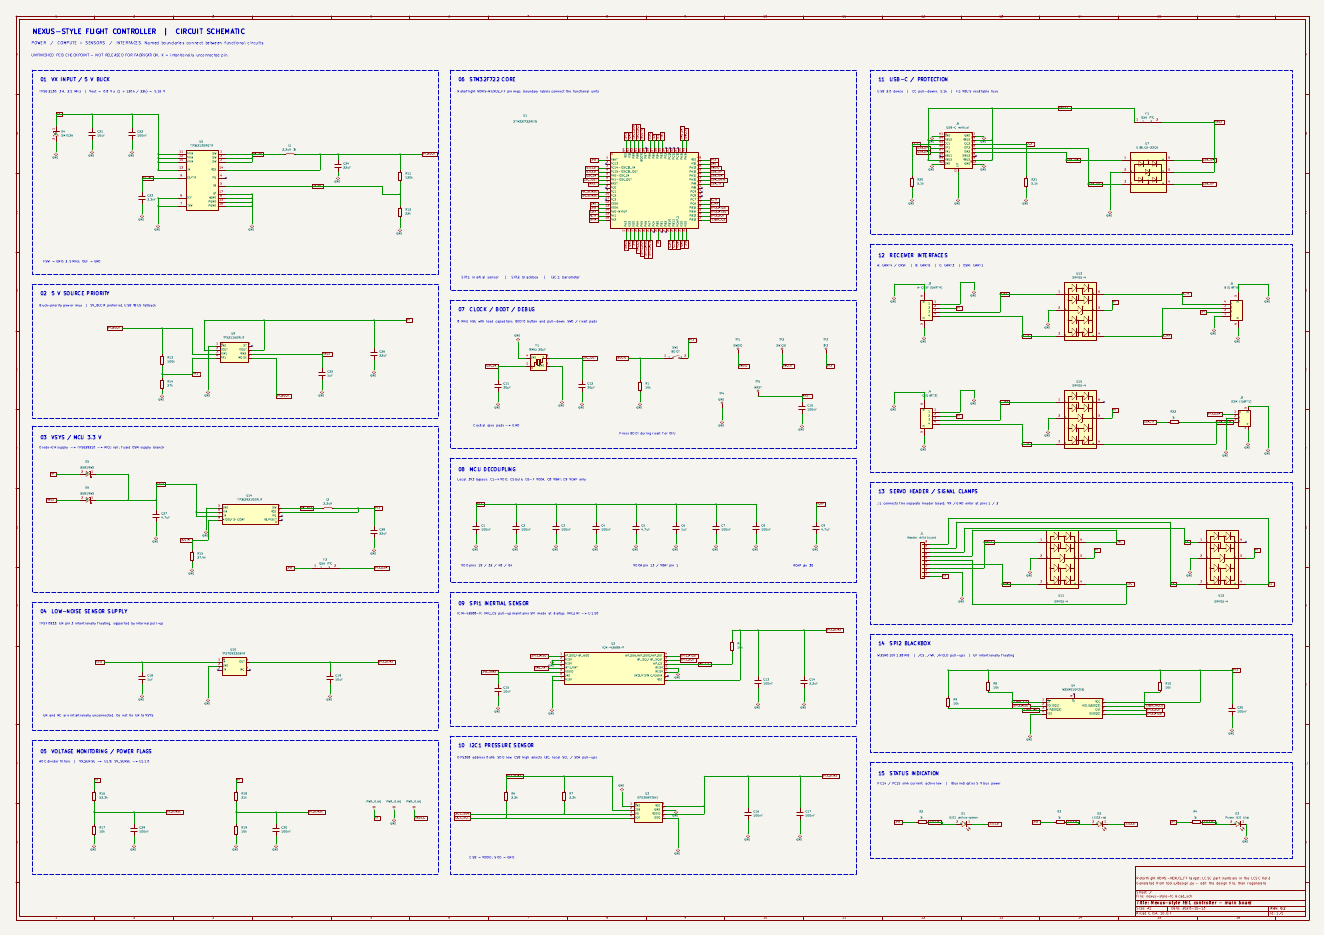
nexus-style-fc/routing-wip/2026-10-15/local-r57-checkpoint/filter-integration/preview/source.png
