chenguoming1/h743-controllers/nexus-style-fc/routing-wip/2026-10-15/stage36-main-child-checkpoint/reviews/jlcdfm-main-stage35/pcb-mask-danger-cleared.jpg

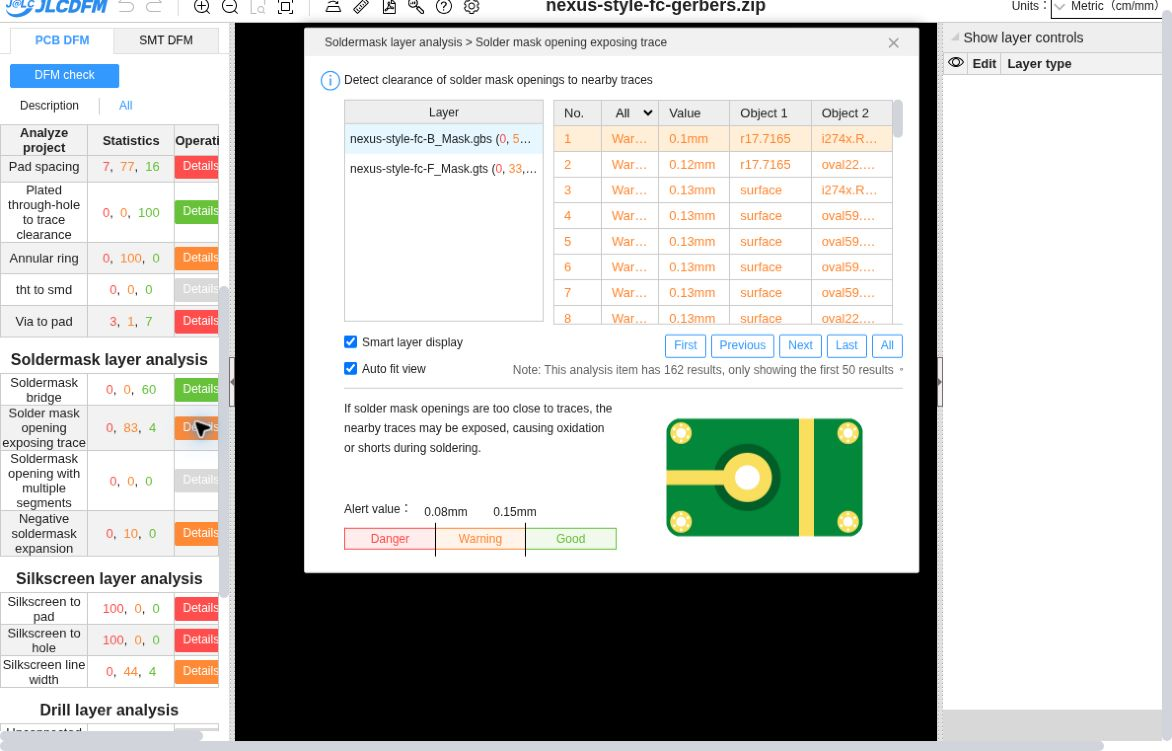
nexus-style-fc/routing-wip/2026-10-15/stage36-main-child-checkpoint/reviews/jlcdfm-main-stage35/pcb-mask-danger-cleared.jpg
