chenguoming1/h743-controllers/nexus-style-fc/routing-wip/2026-10-15/usb-interface-checkpoint/lineage/r59-usb170-trial/source-review/mcu/In3.Cu.png

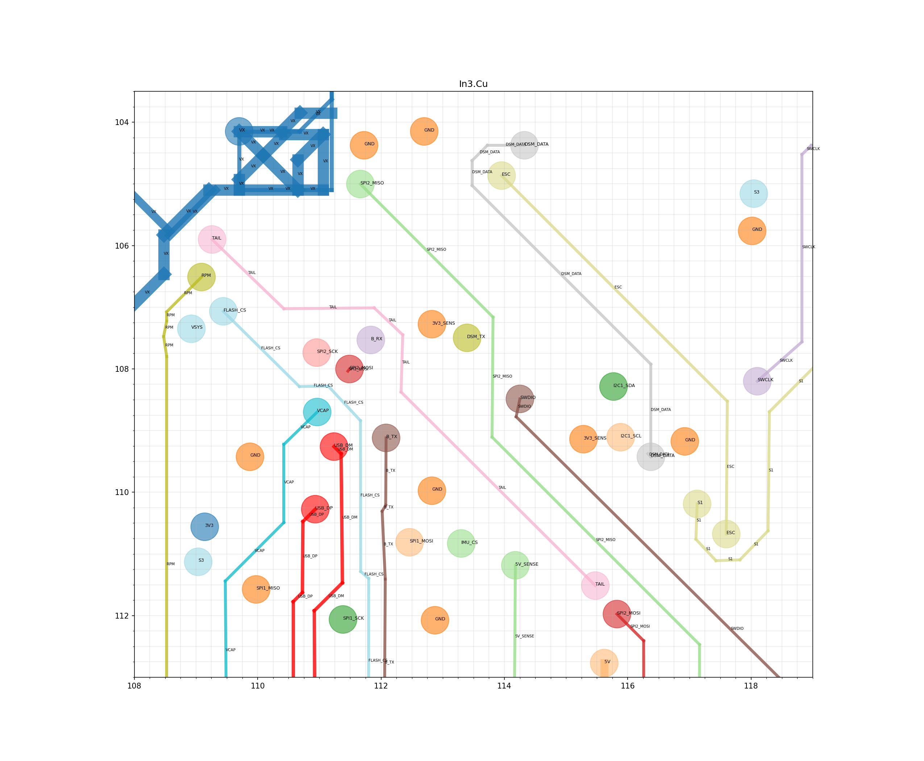
nexus-style-fc/routing-wip/2026-10-15/usb-interface-checkpoint/lineage/r59-usb170-trial/source-review/mcu/In3.Cu.png
