chenguoming1/h743-controllers/nexus-style-fc/routing-wip/2026-10-15/usb-interface-checkpoint/mechanical/child-copper-01/source-review/child-routing-preview.png

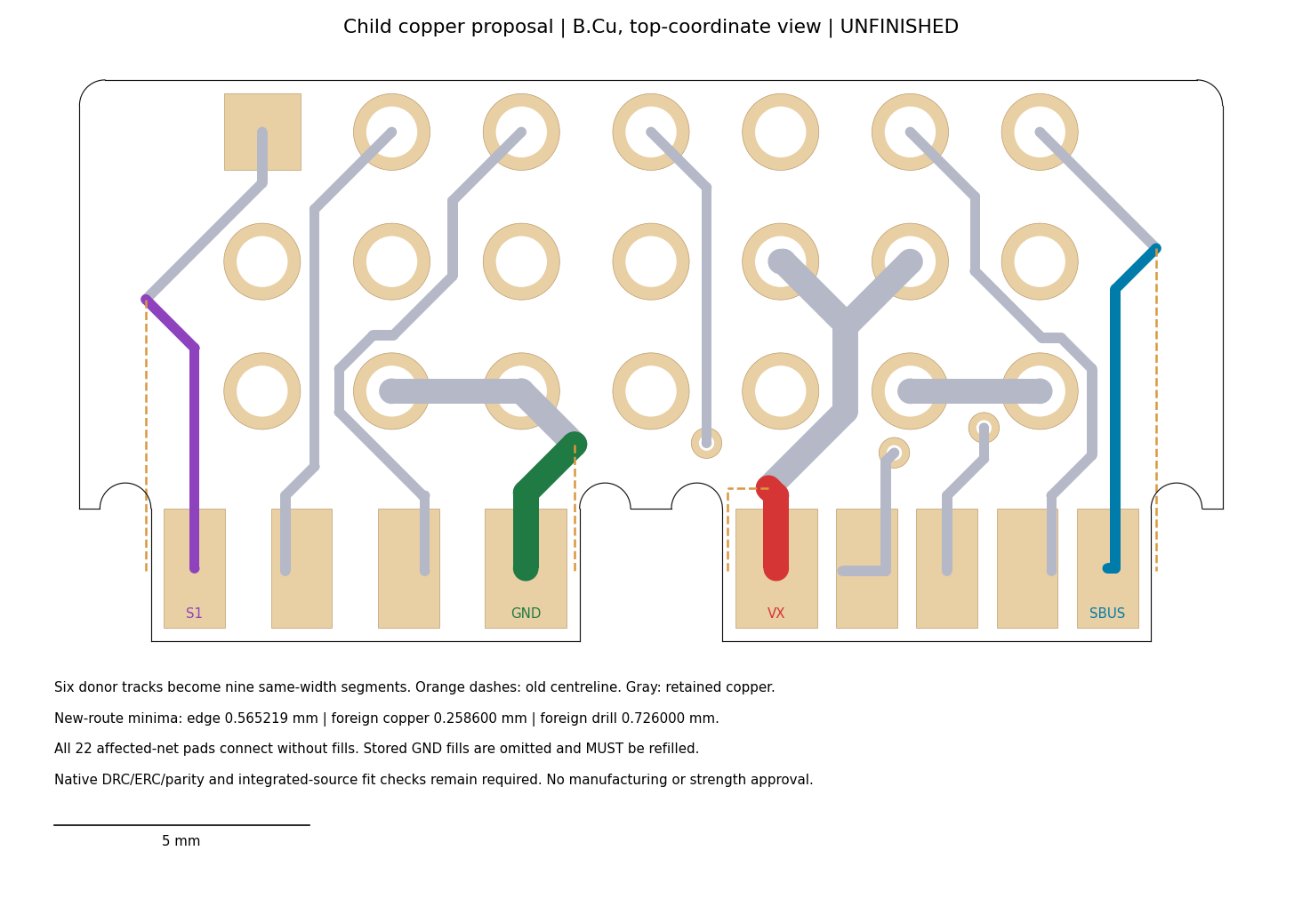
nexus-style-fc/routing-wip/2026-10-15/usb-interface-checkpoint/mechanical/child-copper-01/source-review/child-routing-preview.png
