chenguoming1/h743-controllers/self-balancing/dfm/production-P6/j3-live-stock.jpg

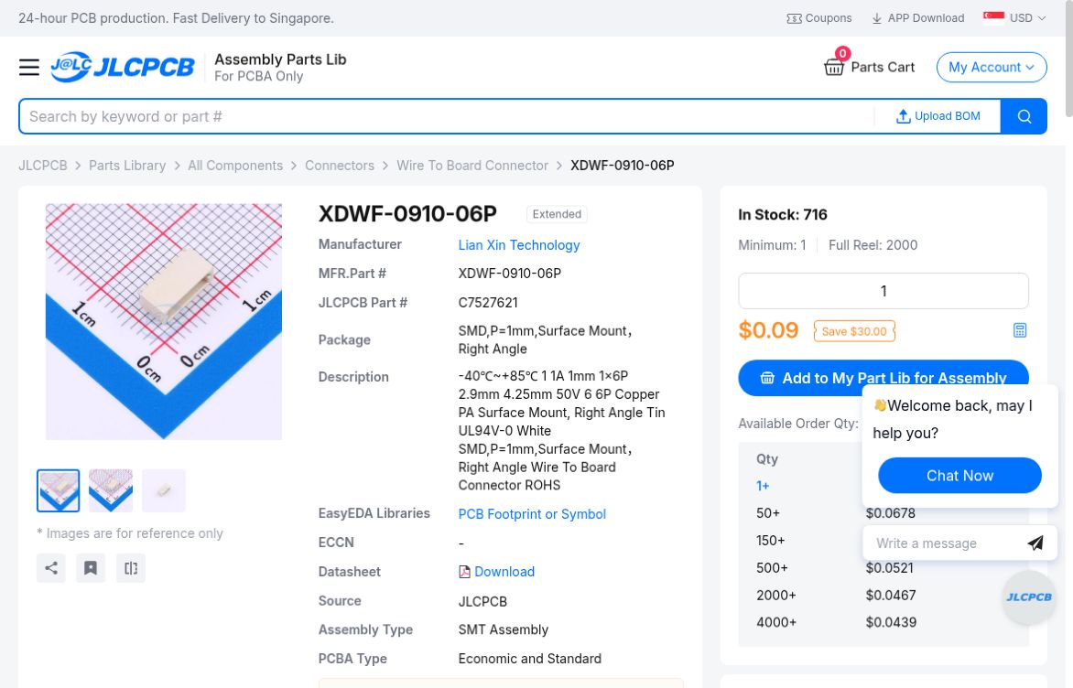
self-balancing/dfm/production-P6/j3-live-stock.jpg
