chenguoming1/h743-controllers/self-balancing/dfm/production-P6/pcb-summary.jpg

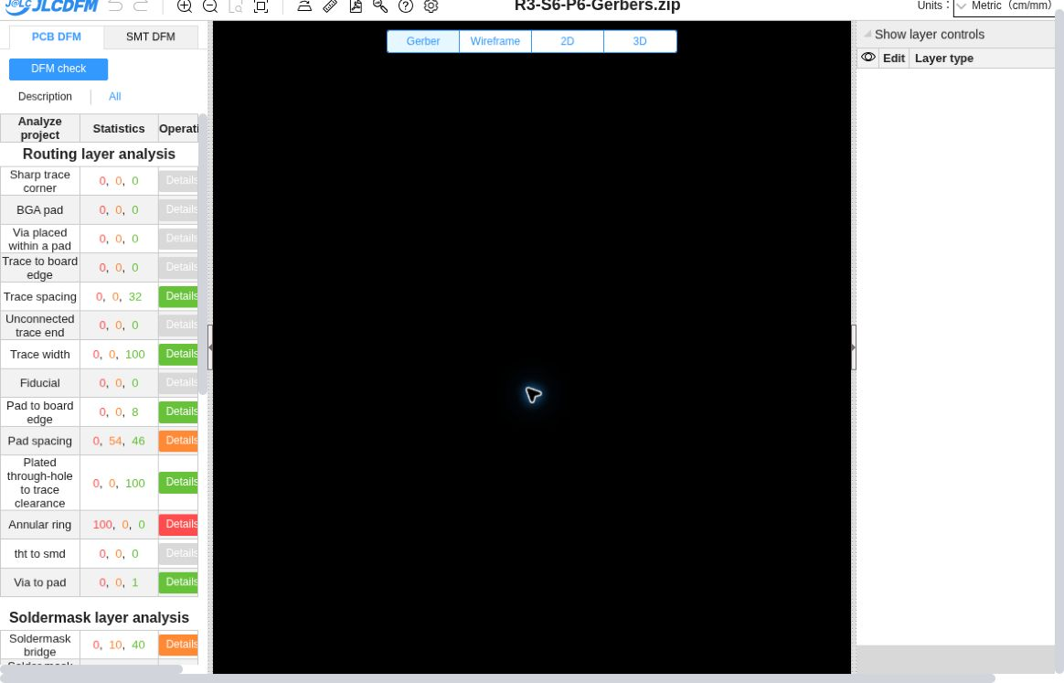
self-balancing/dfm/production-P6/pcb-summary.jpg
