chenguoming1/h743-controllers/self-balancing/dfm/production-P6/placement-preview-limit.jpg

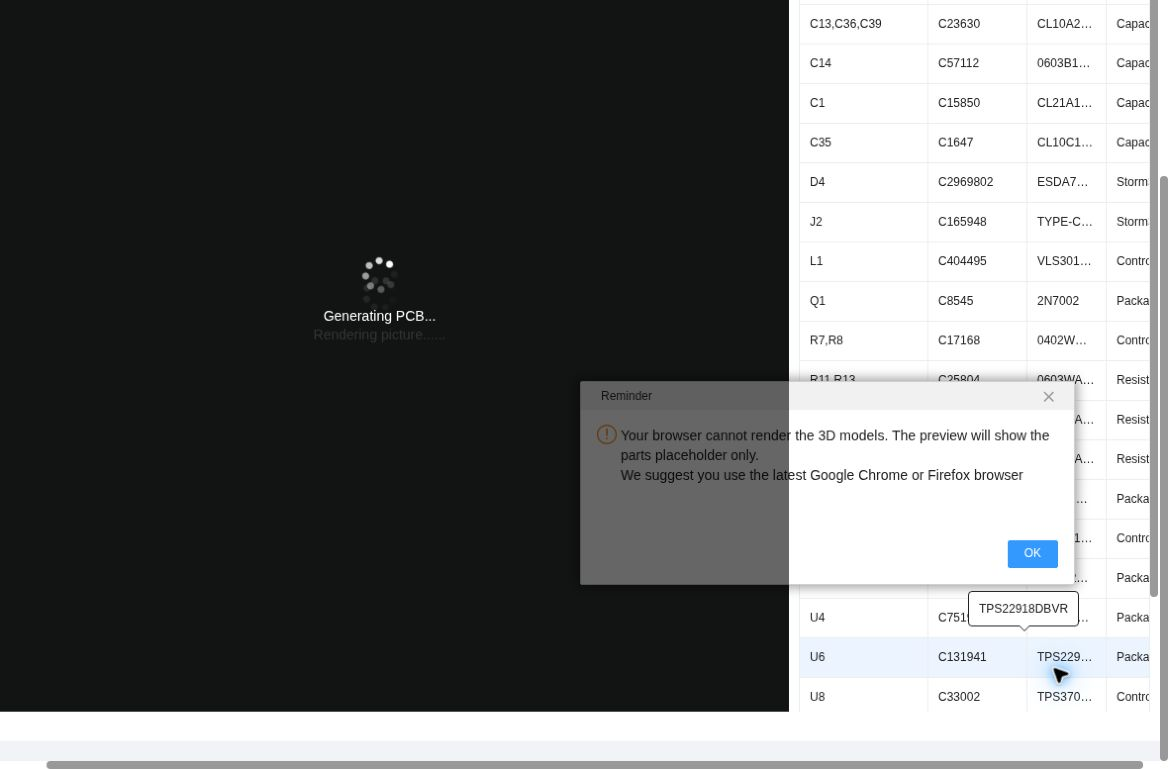
self-balancing/dfm/production-P6/placement-preview-limit.jpg
