chenguoming1/h743-controllers/self-balancing/native/review/usb-routing-491987e/usb-front-copper.png

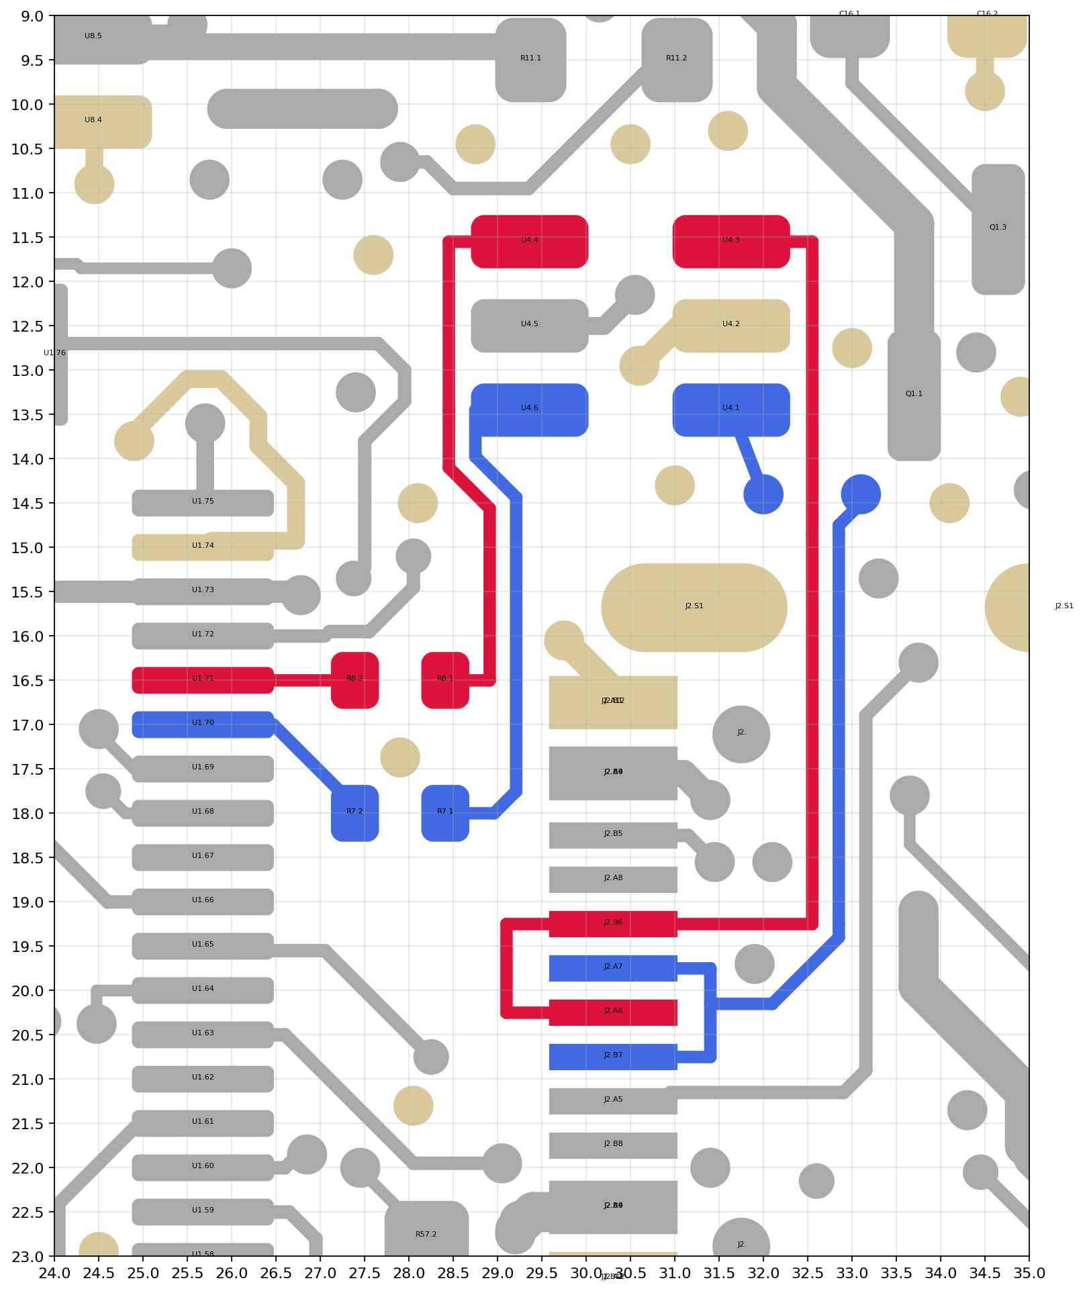
self-balancing/native/review/usb-routing-491987e/usb-front-copper.png
