chenguoming1/h743-controllers/self-balancing/reconstruction/evidence/ground-proposals-before-after.png

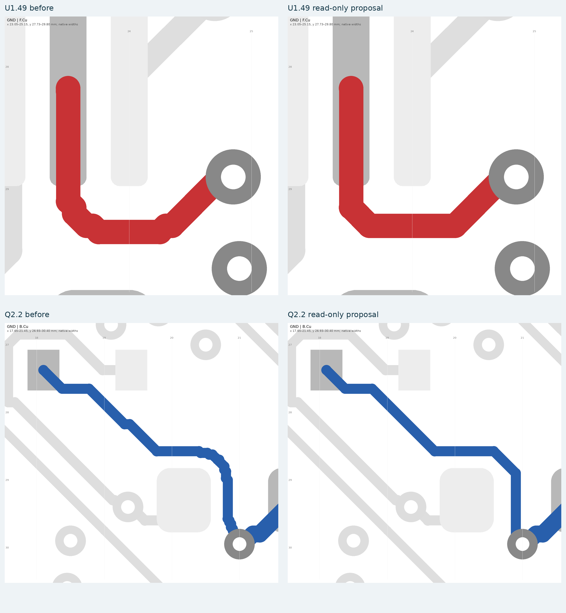
self-balancing/reconstruction/evidence/ground-proposals-before-after.png
