chenguoming1/h743-controllers/self-balancing/dfm/production-P6/bom-matches.txt

- text: 
- main:
  - generic: Bill of Materials
  - generic: Component Placements
  - navigation:
    - list:
      - text: Total
      - generic: "35"
      - text: parts detected
      - generic: "35"
      - text: Parts confirmed
  - button "Upload BOM/CPL":
    - generic: Upload BOM/CPL
  - text: 
  - table:
    - rowgroup:
      - row "Top Designator Bottom Designator Comment Footprint Matched Part Detail Select ":
        - columnheader
        - columnheader "Top Designator":
          - generic: Top Designator
        - columnheader "Bottom Designator":
          - generic: Bottom Designator
        - columnheader "Comment":
          - generic: Comment
        - columnheader "Footprint":
          - generic: Footprint
        - columnheader "Matched Part Detail":
          - generic: Matched Part Detail
        - columnheader "Select ":
          - text: Select
          - generic: 
  - table:
    - rowgroup:
      - row "C2 CL31A226KAHNNNE Capacitor_SMD:C_1206_3216Metric CL31A226KAHNNNE C12891 22uF 25V X5R ±10% 1206 Multilayer Ceramic Capacitors MLCC - SMD/SMT ROHS Search":
        - cell:
          - generic: 
        - cell "C2":
          - generic: C2
        - cell
        - cell "CL31A226KAHNNNE":
          - generic: CL31A226KAHNNNE
        - cell "Capacitor_SMD:C_1206_3216Metric":
          - generic: Capacitor_SMD:C_1206_3216Metric
        - cell "CL31A226KAHNNNE C12891 22uF 25V X5R ±10% 1206 Multilayer Ceramic Capacitors MLCC - SMD/SMT ROHS Search":
          - generic: CL31A226KAHNNNE
          - generic: C12891
          - generic: 22uF 25V X5R ±10% 1206 Multilayer Ceramic Capacitors MLCC - SMD/SMT ROHS
          - text: Search
        - cell:
          - checkbox [checked]
      - row "C4,C10,C33 CL10A105KB8NNNC Capacitor_SMD:C_0603_1608Metric CL10A105KB8NNNC C15849 1uF 50V X5R ±10% 0603 Multilayer Ceramic Capacitors MLCC - SMD/SMT ROHS Search":
        - cell:
          - generic: 
        - cell
        - cell "C4,C10,C33":
          - generic: C4,C10,C33
        - cell "CL10A105KB8NNNC":
          - generic: CL10A105KB8NNNC
        - cell "Capacitor_SMD:C_0603_1608Metric":
          - generic: Capacitor_SMD:C_0603_1608Metric
        - cell "CL10A105KB8NNNC C15849 1uF 50V X5R ±10% 0603 Multilayer Ceramic Capacitors MLCC - SMD/SMT ROHS Search":
          - generic: CL10A105KB8NNNC
          - generic: C15849
          - generic: 1uF 50V X5R ±10% 0603 Multilayer Ceramic Capacitors MLCC - SMD/SMT ROHS
          - text: Search
        - cell:
          - checkbox [checked]
      - row "C12,C16,C38 C3,C6,C7,C8,C9,C11,C15,C24,C25,C29,C31,C32 CC0603KRX7R9BB104 Capacitor_SMD:C_0603_1608Metric CC0603KRX7R9BB104 C14663 100nF 50V X7R ±10% 0603 Multilayer Ceramic Capacitors MLCC - SMD/SMT ROHS Search":
        - cell:
          - generic: 
        - cell "C12,C16,C38":
          - generic: C12,C16,C38
        - cell "C3,C6,C7,C8,C9,C11,C15,C24,C25,C29,C31,C32":
          - generic: C3,C6,C7,C8,C9,C11,C15,C24,C25,C29,C31,C32
        - cell "CC0603KRX7R9BB104":
          - generic: CC0603KRX7R9BB104
        - cell "Capacitor_SMD:C_0603_1608Metric":
          - generic: Capacitor_SMD:C_0603_1608Metric
        - cell "CC0603KRX7R9BB104 C14663 100nF 50V X7R ±10% 0603 Multilayer Ceramic Capacitors MLCC - SMD/SMT ROHS Search":
          - generic: CC0603KRX7R9BB104
          - generic: C14663
          - generic: 100nF 50V X7R ±10% 0603 Multilayer Ceramic Capacitors MLCC - SMD/SMT ROHS
          - text: Search
        - cell:
          - checkbox [checked]
      - row "C13,C36,C39 C37,C40 CL10A225KO8NNNC Capacitor_SMD:C_0603_1608Metric CL10A225KO8NNNC C23630 16V 2.2uF X5R ±10% 0603 Multilayer Ceramic Capacitors MLCC - SMD/SMT ROHS Search":
        - cell:
          - generic: 
        - cell "C13,C36,C39":
          - generic: C13,C36,C39
        - cell "C37,C40":
          - generic: C37,C40
        - cell "CL10A225KO8NNNC":
          - generic: CL10A225KO8NNNC
        - cell "Capacitor_SMD:C_0603_1608Metric":
          - generic: Capacitor_SMD:C_0603_1608Metric
        - cell "CL10A225KO8NNNC C23630 16V 2.2uF X5R ±10% 0603 Multilayer Ceramic Capacitors MLCC - SMD/SMT ROHS Search":
          - generic: CL10A225KO8NNNC
          - generic: C23630
          - generic: 16V 2.2uF X5R ±10% 0603 Multilayer Ceramic Capacitors MLCC - SMD/SMT ROHS
          - text: Search
        - cell:
          - checkbox [checked]
      - row "C26 CL10A106KP8NNNC Capacitor_SMD:C_0603_1608Metric CL10A106KP8NNNC C19702 10V 10uF X5R ±10% 0603 Multilayer Ceramic Capacitors MLCC - SMD/SMT ROHS Search":
        - cell:
          - generic: 
        - cell
        - cell "C26":
          - generic: C26
        - cell "CL10A106KP8NNNC":
          - generic: CL10A106KP8NNNC
        - cell "Capacitor_SMD:C_0603_1608Metric":
          - generic: Capacitor_SMD:C_0603_1608Metric
        - cell "CL10A106KP8NNNC C19702 10V 10uF X5R ±10% 0603 Multilayer Ceramic Capacitors MLCC - SMD/SMT ROHS Search":
          - generic: CL10A106KP8NNNC
          - generic: C19702
          - generic: 10V 10uF X5R ±10% 0603 Multilayer Ceramic Capacitors MLCC - SMD/SMT ROHS
          - text: Search
        - cell:
          - checkbox [checked]
      - row "C14 C5 0603B103K500NT Capacitor_SMD:C_0603_1608Metric 0603B103K500NT C57112 10nF 50V X7R ±10% 0603 Multilayer Ceramic Capacitors MLCC - SMD/SMT ROHS Search":
        - cell:
          - generic: 
        - cell "C14":
          - generic: C14
        - cell "C5":
          - generic: C5
        - cell "0603B103K500NT":
          - generic: 0603B103K500NT
        - cell "Capacitor_SMD:C_0603_1608Metric":
          - generic: Capacitor_SMD:C_0603_1608Metric
        - cell "0603B103K500NT C57112 10nF 50V X7R ±10% 0603 Multilayer Ceramic Capacitors MLCC - SMD/SMT ROHS Search":
          - generic: 0603B103K500NT
          - generic: C57112
          - generic: 10nF 50V X7R ±10% 0603 Multilayer Ceramic Capacitors MLCC - SMD/SMT ROHS
          - text: Search
        - cell:
          - checkbox [checked]
      - row "C1 C41 CL21A106KAYNNNE Capacitor_SMD:C_0805_2012Metric CL21A106KAYNNNE C15850 10uF 25V X5R ±10% 0805 Multilayer Ceramic Capacitors MLCC - SMD/SMT ROHS Search":
        - cell:
          - generic: 
        - cell "C1":
          - generic: C1
        - cell "C41":
          - generic: C41
        - cell "CL21A106KAYNNNE":
          - generic: CL21A106KAYNNNE
        - cell "Capacitor_SMD:C_0805_2012Metric":
          - generic: Capacitor_SMD:C_0805_2012Metric
        - cell "CL21A106KAYNNNE C15850 10uF 25V X5R ±10% 0805 Multilayer Ceramic Capacitors MLCC - SMD/SMT ROHS Search":
          - generic: CL21A106KAYNNNE
          - generic: C15850
          - generic: 10uF 25V X5R ±10% 0805 Multilayer Ceramic Capacitors MLCC - SMD/SMT ROHS
          - text: Search
        - cell:
          - checkbox [checked]
      - row "C35 C34 CL10C180JB8NNNC Capacitor_SMD:C_0603_1608Metric CL10C180JB8NNNC C1647 18pF 50V C0G ±5% 0603 Multilayer Ceramic Capacitors MLCC - SMD/SMT ROHS Search":
        - cell:
          - generic: 
        - cell "C35":
          - generic: C35
        - cell "C34":
          - generic: C34
        - cell "CL10C180JB8NNNC":
          - generic: CL10C180JB8NNNC
        - cell "Capacitor_SMD:C_0603_1608Metric":
          - generic: Capacitor_SMD:C_0603_1608Metric
        - cell "CL10C180JB8NNNC C1647 18pF 50V C0G ±5% 0603 Multilayer Ceramic Capacitors MLCC - SMD/SMT ROHS Search":
          - generic: CL10C180JB8NNNC
          - generic: C1647
          - generic: 18pF 50V C0G ±5% 0603 Multilayer Ceramic Capacitors MLCC - SMD/SMT ROHS
          - text: Search
        - cell:
          - checkbox [checked]
      - row "D4 ESDA7P120-1U1M Storm32_Review:ST_QFN-2L_1.6x1.0mm_DS14419 ESDA7P120-1U1M C2969802 -55℃~+150℃ 1 1.4kW@8/20us 1.5uA 11.5V 120A@8/20us 5.5V 6.8V ESD IEC 61000-4-2 Unidirectional 1610 ESD and Surge Protection (TVS/ESD) ROHS Search":
        - cell:
          - generic: 
        - cell "D4":
          - generic: D4
        - cell
        - cell "ESDA7P120-1U1M":
          - generic: ESDA7P120-1U1M
        - cell "Storm32_Review:ST_QFN-2L_1.6x1.0mm_DS14419":
          - generic: Storm32_Review:ST_QFN-2L_1.6x1.0mm_DS14419
        - cell "ESDA7P120-1U1M C2969802 -55℃~+150℃ 1 1.4kW@8/20us 1.5uA 11.5V 120A@8/20us 5.5V 6.8V ESD IEC 61000-4-2 Unidirectional 1610 ESD and Surge Protection (TVS/ESD) ROHS Search":
          - generic: ESDA7P120-1U1M
          - generic: C2969802
          - generic: "-55℃~+150℃ 1 1.4kW@8/20us 1.5uA 11.5V 120A@8/20us 5.5V 6.8V ESD IEC 61000-4-2 Unidirectional 1610 ESD and Surge Protection (TVS/ESD) ROHS"
          - text: Search
        - cell:
          - checkbox [checked]
      - row "J2 TYPE-C-31-M-12 Storm32_Review:USB_C_HRO_TYPE-C-31-M-12_EdgeSilk TYPE-C-31-M-12 C165948 -30℃~+80℃ 1 10,000 cycles 16P 20V 5A 7.35mm Female Surface Mount, Right Angle Type-C SMD USB Connectors ROHS Search":
        - cell:
          - generic: 
        - cell "J2":
          - generic: J2
        - cell
        - cell "TYPE-C-31-M-12":
          - generic: TYPE-C-31-M-12
        - cell "Storm32_Review:USB_C_HRO_TYPE-C-31-M-12_EdgeSilk":
          - generic: Storm32_Review:USB_C_HRO_TYPE-C-31-M-12_EdgeSilk
        - cell "TYPE-C-31-M-12 C165948 -30℃~+80℃ 1 10,000 cycles 16P 20V 5A 7.35mm Female Surface Mount, Right Angle Type-C SMD USB Connectors ROHS Search":
          - generic: TYPE-C-31-M-12
          - generic: C165948
          - generic: "-30℃~+80℃ 1 10,000 cycles 16P 20V 5A 7.35mm Female Surface Mount, Right Angle Type-C SMD USB Connectors ROHS"
          - text: Search
        - cell:
          - checkbox [checked]
      - row "J3 XDWF-0910-06P Controller_R3:LianXin_XDWF-0910_06P_Horizontal XDWF-0910-06P C7527621 -40℃~+85℃ 1 1A 1mm 1x6P 2.9mm 4.25mm 50V 6 6P Copper PA Surface Mount, Right Angle Tin UL94V-0 White SMD,P=1mm,Surface Mount，Right Angle Wire To Board Connector ROHS Search":
        - cell:
          - generic: 
        - cell
        - cell "J3":
          - generic: J3
        - cell "XDWF-0910-06P":
          - generic: XDWF-0910-06P
        - cell "Controller_R3:LianXin_XDWF-0910_06P_Horizontal":
          - generic: Controller_R3:LianXin_XDWF-0910_06P_Horizontal
        - cell "XDWF-0910-06P C7527621 -40℃~+85℃ 1 1A 1mm 1x6P 2.9mm 4.25mm 50V 6 6P Copper PA Surface Mount, Right Angle Tin UL94V-0 White SMD,P=1mm,Surface Mount，Right Angle Wire To Board Connector ROHS Search":
          - generic: XDWF-0910-06P
          - generic: C7527621
          - generic: "-40℃~+85℃ 1 1A 1mm 1x6P 2.9mm 4.25mm 50V 6 6P Copper PA Surface Mount, Right Angle Tin UL94V-0 White SMD,P=1mm,Surface Mount，Right Angle Wire To Board Connector ROHS"
          - text: Search
        - cell:
          - checkbox [checked]
      - row "J4 SM08B-SRSS-TB(LF)(SN) Connector_JST:JST_SH_SM08B-SRSS-TB_1x08-1MP_P1.00mm_Horizontal SM08B-SRSS-TB(LF)(SN) C160407 -25℃~+85℃ 1 10mm 1A 1mm 1x8P 2.9mm 4.32mm 50V 8 8P Auxiliary Solder Pin Copper alloy PA SH Surface Mount, Right Angle Tin UL94V-0 White SMD,P=1mm,卧贴 Wire To Board Connector ROHS Search":
        - cell:
          - generic: 
        - cell
        - cell "J4":
          - generic: J4
        - cell "SM08B-SRSS-TB(LF)(SN)":
          - generic: SM08B-SRSS-TB(LF)(SN)
        - cell "Connector_JST:JST_SH_SM08B-SRSS-TB_1x08-1MP_P1.00mm_Horizontal":
          - generic: Connector_JST:JST_SH_SM08B-SRSS-TB_1x08-1MP_P1.00mm_Horizontal
        - cell "SM08B-SRSS-TB(LF)(SN) C160407 -25℃~+85℃ 1 10mm 1A 1mm 1x8P 2.9mm 4.32mm 50V 8 8P Auxiliary Solder Pin Copper alloy PA SH Surface Mount, Right Angle Tin UL94V-0 White SMD,P=1mm,卧贴 Wire To Board Connector ROHS Search":
          - generic: SM08B-SRSS-TB(LF)(SN)
          - generic: C160407
          - generic: "-25℃~+85℃ 1 10mm 1A 1mm 1x8P 2.9mm 4.32mm 50V 8 8P Auxiliary Solder Pin Copper alloy PA SH Surface Mount, Right Angle Tin UL94V-0 White SMD,P=1mm,卧贴 Wire To Board Connector ROHS"
          - text: Search
        - cell:
          - checkbox [checked]
      - row "J5 SM04B-SRSS-TB(LF)(SN) Connector_JST:JST_SH_SM04B-SRSS-TB_1x04-1MP_P1.00mm_Horizontal SM04B-SRSS-TB(LF)(SN) C160404 -25℃~+85℃ 1 1A 1mm 1x4P 2.9mm 4 4.32mm 4P 50V 6mm Auxiliary Solder Pin Copper alloy PA SH Surface Mount, Right Angle Tin UL94V-0 White SMD,P=1mm,卧贴 Wire To Board Connector ROHS Search":
        - cell:
          - generic: 
        - cell
        - cell "J5":
          - generic: J5
        - cell "SM04B-SRSS-TB(LF)(SN)":
          - generic: SM04B-SRSS-TB(LF)(SN)
        - cell "Connector_JST:JST_SH_SM04B-SRSS-TB_1x04-1MP_P1.00mm_Horizontal":
          - generic: Connector_JST:JST_SH_SM04B-SRSS-TB_1x04-1MP_P1.00mm_Horizontal
        - cell "SM04B-SRSS-TB(LF)(SN) C160404 -25℃~+85℃ 1 1A 1mm 1x4P 2.9mm 4 4.32mm 4P 50V 6mm Auxiliary Solder Pin Copper alloy PA SH Surface Mount, Right Angle Tin UL94V-0 White SMD,P=1mm,卧贴 Wire To Board Connector ROHS Search":
          - generic: SM04B-SRSS-TB(LF)(SN)
          - generic: C160404
          - generic: "-25℃~+85℃ 1 1A 1mm 1x4P 2.9mm 4 4.32mm 4P 50V 6mm Auxiliary Solder Pin Copper alloy PA SH Surface Mount, Right Angle Tin UL94V-0 White SMD,P=1mm,卧贴 Wire To Board Connector ROHS"
          - text: Search
        - cell:
          - checkbox [checked]
      - row "L1 VLS3012HBX-3R3M Controller_R3:TDK_VLS3012HBX VLS3012HBX-3R3M C404495 130mΩ 2.37A 2.82A 3.3uH ±20% SMD,3x3mm Power Inductors ROHS Search":
        - cell:
          - generic: 
        - cell "L1":
          - generic: L1
        - cell
        - cell "VLS3012HBX-3R3M":
          - generic: VLS3012HBX-3R3M
        - cell "Controller_R3:TDK_VLS3012HBX":
          - generic: Controller_R3:TDK_VLS3012HBX
        - cell "VLS3012HBX-3R3M C404495 130mΩ 2.37A 2.82A 3.3uH ±20% SMD,3x3mm Power Inductors ROHS Search":
          - generic: VLS3012HBX-3R3M
          - generic: C404495
          - generic: 130mΩ 2.37A 2.82A 3.3uH ±20% SMD,3x3mm Power Inductors ROHS
          - text: Search
        - cell:
          - checkbox [checked]
      - row "Q1 2N7002 Package_TO_SOT_SMD:SOT-23 2N7002 C8545 1 N-channel 115mA 2.5V 225mW 25pF 50pF 5pF 5Ω@10V 60V N-Channel ±20V SOT-23 MOSFETs ROHS Search":
        - cell:
          - generic: 
        - cell "Q1":
          - generic: Q1
        - cell
        - cell "2N7002":
          - generic: 2N7002
        - cell "Package_TO_SOT_SMD:SOT-23":
          - generic: Package_TO_SOT_SMD:SOT-23
        - cell "2N7002 C8545 1 N-channel 115mA 2.5V 225mW 25pF 50pF 5pF 5Ω@10V 60V N-Channel ±20V SOT-23 MOSFETs ROHS Search":
          - generic: 2N7002
          - generic: C8545
          - generic: 1 N-channel 115mA 2.5V 225mW 25pF 50pF 5pF 5Ω@10V 60V N-Channel ±20V SOT-23 MOSFETs ROHS
          - text: Search
        - cell:
          - checkbox [checked]
      - row "Q2 DMN2310UW-7 Controller_R3:DMN2310UW_SOT323 DMN2310UW-7 C7264627 -55℃~+150℃ 1 N-channel 1.3A 20V 38pF 450mW 6pF 700pC@4.5V 950mV SOT-323 MOSFETs ROHS Search":
        - cell:
          - generic: 
        - cell
        - cell "Q2":
          - generic: Q2
        - cell "DMN2310UW-7":
          - generic: DMN2310UW-7
        - cell "Controller_R3:DMN2310UW_SOT323":
          - generic: Controller_R3:DMN2310UW_SOT323
        - cell "DMN2310UW-7 C7264627 -55℃~+150℃ 1 N-channel 1.3A 20V 38pF 450mW 6pF 700pC@4.5V 950mV SOT-323 MOSFETs ROHS Search":
          - generic: DMN2310UW-7
          - generic: C7264627
          - generic: "-55℃~+150℃ 1 N-channel 1.3A 20V 38pF 450mW 6pF 700pC@4.5V 950mV SOT-323 MOSFETs ROHS"
          - text: Search
        - cell:
          - checkbox [checked]
      - row "R5,R6 0603WAF5101T5E Resistor_SMD:R_0603_1608Metric 0603WAF5101T5E C23186 -55℃~+155℃ 100mW 5.1kΩ 75V Thick Film Resistor ±1% ±100ppm/℃ 0603 Chip Resistor - Surface Mount ROHS Search":
        - cell:
          - generic: 
        - cell
        - cell "R5,R6":
          - generic: R5,R6
        - cell "0603WAF5101T5E":
          - generic: 0603WAF5101T5E
        - cell "Resistor_SMD:R_0603_1608Metric":
          - generic: Resistor_SMD:R_0603_1608Metric
        - cell "0603WAF5101T5E C23186 -55℃~+155℃ 100mW 5.1kΩ 75V Thick Film Resistor ±1% ±100ppm/℃ 0603 Chip Resistor - Surface Mount ROHS Search":
          - generic: 0603WAF5101T5E
          - generic: C23186
          - generic: "-55℃~+155℃ 100mW 5.1kΩ 75V Thick Film Resistor ±1% ±100ppm/℃ 0603 Chip Resistor - Surface Mount ROHS"
          - text: Search
        - cell:
          - checkbox [checked]
      - row "R7,R8 0402WGF0000TCE Controller_R3:R_0402_1005Metric_R3S_NoSilk 0402WGF0000TCE C17168 -55℃~+155℃ 0Ω 50V 62.5mW Thick Film Resistor ±1% ±800ppm/℃ 0402 Chip Resistor - Surface Mount ROHS Search":
        - cell:
          - generic: 
        - cell "R7,R8":
          - generic: R7,R8
        - cell
        - cell "0402WGF0000TCE":
          - generic: 0402WGF0000TCE
        - cell "Controller_R3:R_0402_1005Metric_R3S_NoSilk":
          - generic: Controller_R3:R_0402_1005Metric_R3S_NoSilk
        - cell "0402WGF0000TCE C17168 -55℃~+155℃ 0Ω 50V 62.5mW Thick Film Resistor ±1% ±800ppm/℃ 0402 Chip Resistor - Surface Mount ROHS Search":
          - generic: 0402WGF0000TCE
          - generic: C17168
          - generic: "-55℃~+155℃ 0Ω 50V 62.5mW Thick Film Resistor ±1% ±800ppm/℃ 0402 Chip Resistor - Surface Mount ROHS"
          - text: Search
        - cell:
          - checkbox [checked]
      - row "R9,R10,R45 0603WAF4701T5E Resistor_SMD:R_0603_1608Metric 0603WAF4701T5E C23162 -55℃~+155℃ 100mW 4.7kΩ 75V Thick Film Resistor ±1% ±100ppm/℃ 0603 Chip Resistor - Surface Mount ROHS Search":
        - cell:
          - generic: 
        - cell
        - cell "R9,R10,R45":
          - generic: R9,R10,R45
        - cell "0603WAF4701T5E":
          - generic: 0603WAF4701T5E
        - cell "Resistor_SMD:R_0603_1608Metric":
          - generic: Resistor_SMD:R_0603_1608Metric
        - cell "0603WAF4701T5E C23162 -55℃~+155℃ 100mW 4.7kΩ 75V Thick Film Resistor ±1% ±100ppm/℃ 0603 Chip Resistor - Surface Mount ROHS Search":
          - generic: 0603WAF4701T5E
          - generic: C23162
          - generic: "-55℃~+155℃ 100mW 4.7kΩ 75V Thick Film Resistor ±1% ±100ppm/℃ 0603 Chip Resistor - Surface Mount ROHS"
          - text: Search
        - cell:
          - checkbox [checked]
      - row "R11,R13 R3,R4,R12,R43,R46,R48,R49,R50,R53,R54,R55,R56 0603WAF1002T5E Resistor_SMD:R_0603_1608Metric 0603WAF1002T5E C25804 -55℃~+155℃ 100mW 10kΩ 75V Thick Film Resistor ±1% ±100ppm/℃ 0603 Chip Resistor - Surface Mount ROHS Search":
        - cell:
          - generic: 
        - cell "R11,R13":
          - generic: R11,R13
        - cell "R3,R4,R12,R43,R46,R48,R49,R50,R53,R54,R55,R56":
          - generic: R3,R4,R12,R43,R46,R48,R49,R50,R53,R54,R55,R56
        - cell "0603WAF1002T5E":
          - generic: 0603WAF1002T5E
        - cell "Resistor_SMD:R_0603_1608Metric":
          - generic: Resistor_SMD:R_0603_1608Metric
        - cell "0603WAF1002T5E C25804 -55℃~+155℃ 100mW 10kΩ 75V Thick Film Resistor ±1% ±100ppm/℃ 0603 Chip Resistor - Surface Mount ROHS Search":
          - generic: 0603WAF1002T5E
          - generic: C25804
          - generic: "-55℃~+155℃ 100mW 10kΩ 75V Thick Film Resistor ±1% ±100ppm/℃ 0603 Chip Resistor - Surface Mount ROHS"
          - text: Search
        - cell:
          - checkbox [checked]
      - row "R42,R44 0603WAF4702T5E Resistor_SMD:R_0603_1608Metric 0603WAF4702T5E C25819 -55℃~+155℃ 100mW 47kΩ 75V Thick Film Resistor ±1% ±100ppm/℃ 0603 Chip Resistor - Surface Mount ROHS Search":
        - cell:
          - generic: 
        - cell
        - cell "R42,R44":
          - generic: R42,R44
        - cell "0603WAF4702T5E":
          - generic: 0603WAF4702T5E
        - cell "Resistor_SMD:R_0603_1608Metric":
          - generic: Resistor_SMD:R_0603_1608Metric
        - cell "0603WAF4702T5E C25819 -55℃~+155℃ 100mW 47kΩ 75V Thick Film Resistor ±1% ±100ppm/℃ 0603 Chip Resistor - Surface Mount ROHS Search":
          - generic: 0603WAF4702T5E
          - generic: C25819
          - generic: "-55℃~+155℃ 100mW 47kΩ 75V Thick Film Resistor ±1% ±100ppm/℃ 0603 Chip Resistor - Surface Mount ROHS"
          - text: Search
        - cell:
          - checkbox [checked]
      - row "R58 0603WAF0000T5E Resistor_SMD:R_0603_1608Metric 0603WAF0000T5E C21189 -55℃~+155℃ 0Ω 100mW 75V Thick Film Resistor ±1% 0603 Chip Resistor - Surface Mount ROHS Search":
        - cell:
          - generic: 
        - cell
        - cell "R58":
          - generic: R58
        - cell "0603WAF0000T5E":
          - generic: 0603WAF0000T5E
        - cell "Resistor_SMD:R_0603_1608Metric":
          - generic: Resistor_SMD:R_0603_1608Metric
        - cell "0603WAF0000T5E C21189 -55℃~+155℃ 0Ω 100mW 75V Thick Film Resistor ±1% 0603 Chip Resistor - Surface Mount ROHS Search":
          - generic: 0603WAF0000T5E
          - generic: C21189
          - generic: "-55℃~+155℃ 0Ω 100mW 75V Thick Film Resistor ±1% 0603 Chip Resistor - Surface Mount ROHS"
          - text: Search
        - cell:
          - checkbox [checked]
      - row "R2 R1 0603WAF100JT5E Resistor_SMD:R_0603_1608Metric 0603WAF100JT5E C22859 -55℃~+155℃ 100mW 10Ω 75V Thick Film Resistor ±1% ±400ppm/℃ 0603 Chip Resistor - Surface Mount ROHS Search":
        - cell:
          - generic: 
        - cell "R2":
          - generic: R2
        - cell "R1":
          - generic: R1
        - cell "0603WAF100JT5E":
          - generic: 0603WAF100JT5E
        - cell "Resistor_SMD:R_0603_1608Metric":
          - generic: Resistor_SMD:R_0603_1608Metric
        - cell "0603WAF100JT5E C22859 -55℃~+155℃ 100mW 10Ω 75V Thick Film Resistor ±1% ±400ppm/℃ 0603 Chip Resistor - Surface Mount ROHS Search":
          - generic: 0603WAF100JT5E
          - generic: C22859
          - generic: "-55℃~+155℃ 100mW 10Ω 75V Thick Film Resistor ±1% ±400ppm/℃ 0603 Chip Resistor - Surface Mount ROHS"
          - text: Search
        - cell:
          - checkbox [checked]
      - row "R57 R51,R52 0603WAF330JT5E Resistor_SMD:R_0603_1608Metric 0603WAF330JT5E C23140 -55℃~+155℃ 100mW 33Ω 75V Thick Film Resistor ±1% ±100ppm/℃ 0603 Chip Resistor - Surface Mount ROHS Search":
        - cell:
          - generic: 
        - cell "R57":
          - generic: R57
        - cell "R51,R52":
          - generic: R51,R52
        - cell "0603WAF330JT5E":
          - generic: 0603WAF330JT5E
        - cell "Resistor_SMD:R_0603_1608Metric":
          - generic: Resistor_SMD:R_0603_1608Metric
        - cell "0603WAF330JT5E C23140 -55℃~+155℃ 100mW 33Ω 75V Thick Film Resistor ±1% ±100ppm/℃ 0603 Chip Resistor - Surface Mount ROHS Search":
          - generic: 0603WAF330JT5E
          - generic: C23140
          - generic: "-55℃~+155℃ 100mW 33Ω 75V Thick Film Resistor ±1% ±100ppm/℃ 0603 Chip Resistor - Surface Mount ROHS"
          - text: Search
        - cell:
          - checkbox [checked]
      - row "U1 STM32H743VIT6 Package_QFP:LQFP-100_14x14mm_P0.5mm STM32H743VIT6 C114409 -40℃~+85℃ 1.71V~3.6V 12bit 16bit 1MB 2MB 32 Bit 480MHz 82 ARM Cortex-M7 Built-in FLASH LQFP-100(14x14) Microcontrollers (MCU/MPU/SOC) ROHS Search":
        - cell:
          - generic: 
        - cell "U1":
          - generic: U1
        - cell
        - cell "STM32H743VIT6":
          - generic: STM32H743VIT6
        - cell "Package_QFP:LQFP-100_14x14mm_P0.5mm":
          - generic: Package_QFP:LQFP-100_14x14mm_P0.5mm
        - cell "STM32H743VIT6 C114409 -40℃~+85℃ 1.71V~3.6V 12bit 16bit 1MB 2MB 32 Bit 480MHz 82 ARM Cortex-M7 Built-in FLASH LQFP-100(14x14) Microcontrollers (MCU/MPU/SOC) ROHS Search":
          - generic: STM32H743VIT6
          - generic: C114409
          - generic: "-40℃~+85℃ 1.71V~3.6V 12bit 16bit 1MB 2MB 32 Bit 480MHz 82 ARM Cortex-M7 Built-in FLASH LQFP-100(14x14) Microcontrollers (MCU/MPU/SOC) ROHS"
          - text: Search
        - cell:
          - checkbox [checked]
      - row "U2 TPS62162DSGR Controller_R3:TPS62162_DSG_R3S TPS62162DSGR C40256 -40℃~+125℃@(TJ) 1 17uA 1A 2.25MHz 3.3V 3V~17V Buck Buck Built-in Fixed Yes WSON-8-EP(2x2) DC-DC Converters ROHS Search":
        - cell:
          - generic: 
        - cell "U2":
          - generic: U2
        - cell
        - cell "TPS62162DSGR":
          - generic: TPS62162DSGR
        - cell "Controller_R3:TPS62162_DSG_R3S":
          - generic: Controller_R3:TPS62162_DSG_R3S
        - cell "TPS62162DSGR C40256 -40℃~+125℃@(TJ) 1 17uA 1A 2.25MHz 3.3V 3V~17V Buck Buck Built-in Fixed Yes WSON-8-EP(2x2) DC-DC Converters ROHS Search":
          - generic: TPS62162DSGR
          - generic: C40256
          - generic: "-40℃~+125℃@(TJ) 1 17uA 1A 2.25MHz 3.3V 3V~17V Buck Buck Built-in Fixed Yes WSON-8-EP(2x2) DC-DC Converters ROHS"
          - text: Search
        - cell:
          - checkbox [checked]
      - row "U3 ICM-42688-P Package_LGA:LGA-14_3x2.5mm_P0.5mm_LayoutBorder3x4y ICM-42688-P C1850418 -40℃~+85℃ 1.71V~3.6V 16bit 2KB 7.5uA IMU (accelerometer + gyroscope) SPI、I2C X,Y,Z X,Y,Z ±16g ±2000dps Motion Event Detection, Synchronization, Timestamp Support LGA-14(2.5x3) Accelerometers ROHS Search":
        - cell:
          - generic: 
        - cell "U3":
          - generic: U3
        - cell
        - cell "ICM-42688-P":
          - generic: ICM-42688-P
        - cell "Package_LGA:LGA-14_3x2.5mm_P0.5mm_LayoutBorder3x4y":
          - generic: Package_LGA:LGA-14_3x2.5mm_P0.5mm_LayoutBorder3x4y
        - cell "ICM-42688-P C1850418 -40℃~+85℃ 1.71V~3.6V 16bit 2KB 7.5uA IMU (accelerometer + gyroscope) SPI、I2C X,Y,Z X,Y,Z ±16g ±2000dps Motion Event Detection, Synchronization, Timestamp Support LGA-14(2.5x3) Accelerometers ROHS Search":
          - generic: ICM-42688-P
          - generic: C1850418
          - generic: "-40℃~+85℃ 1.71V~3.6V 16bit 2KB 7.5uA IMU (accelerometer + gyroscope) SPI、I2C X,Y,Z X,Y,Z ±16g ±2000dps Motion Event Detection, Synchronization, Timestamp Support LGA-14(2.5x3) Accelerometers ROHS"
          - text: Search
        - cell:
          - checkbox [checked]
      - row "U4 USBLC6-2SC6 Package_TO_SOT_SMD:SOT-23-6 USBLC6-2SC6 C7519 -40℃~+125℃ 150nA 17V 2 3.5pF 5.25V 5A 6V ESD IEC 61000-4-2 Unidirectional SOT-23-6L ESD and Surge Protection (TVS/ESD) ROHS Search":
        - cell:
          - generic: 
        - cell "U4":
          - generic: U4
        - cell
        - cell "USBLC6-2SC6":
          - generic: USBLC6-2SC6
        - cell "Package_TO_SOT_SMD:SOT-23-6":
          - generic: Package_TO_SOT_SMD:SOT-23-6
        - cell "USBLC6-2SC6 C7519 -40℃~+125℃ 150nA 17V 2 3.5pF 5.25V 5A 6V ESD IEC 61000-4-2 Unidirectional SOT-23-6L ESD and Surge Protection (TVS/ESD) ROHS Search":
          - generic: USBLC6-2SC6
          - generic: C7519
          - generic: "-40℃~+125℃ 150nA 17V 2 3.5pF 5.25V 5A 6V ESD IEC 61000-4-2 Unidirectional SOT-23-6L ESD and Surge Protection (TVS/ESD) ROHS"
          - text: Search
        - cell:
          - checkbox [checked]
      - row "U6 TPS22918DBVR Package_TO_SOT_SMD:SOT-23-6 TPS22918DBVR C131941 -40℃~+105℃ 1 1V~5.5V 2A 53mΩ Active High Load Switch SOT-23-6 Power Distribution Switches ROHS Search":
        - cell:
          - generic: 
        - cell "U6":
          - generic: U6
        - cell
        - cell "TPS22918DBVR":
          - generic: TPS22918DBVR
        - cell "Package_TO_SOT_SMD:SOT-23-6":
          - generic: Package_TO_SOT_SMD:SOT-23-6
        - cell "TPS22918DBVR C131941 -40℃~+105℃ 1 1V~5.5V 2A 53mΩ Active High Load Switch SOT-23-6 Power Distribution Switches ROHS Search":
          - generic: TPS22918DBVR
          - generic: C131941
          - generic: "-40℃~+105℃ 1 1V~5.5V 2A 53mΩ Active High Load Switch SOT-23-6 Power Distribution Switches ROHS"
          - text: Search
        - cell:
          - checkbox [checked]
      - row "U8 TPS3700DDCR Controller_R3:TSOT-23-6_R3S_ClearLabels TPS3700DDCR C33002 -40℃~+125℃ 1.8V~18V 11uA 1nA 2 2.2us 29us 5.5mV Open-drain SOT-23-6 Comparators ROHS Search":
        - cell:
          - generic: 
        - cell "U8":
          - generic: U8
        - cell
        - cell "TPS3700DDCR":
          - generic: TPS3700DDCR
        - cell "Controller_R3:TSOT-23-6_R3S_ClearLabels":
          - generic: Controller_R3:TSOT-23-6_R3S_ClearLabels
        - cell "TPS3700DDCR C33002 -40℃~+125℃ 1.8V~18V 11uA 1nA 2 2.2us 29us 5.5mV Open-drain SOT-23-6 Comparators ROHS Search":
          - generic: TPS3700DDCR
          - generic: C33002
          - generic: "-40℃~+125℃ 1.8V~18V 11uA 1nA 2 2.2us 29us 5.5mV Open-drain SOT-23-6 Comparators ROHS"
          - text: Search
        - cell:
          - checkbox [checked]
      - row "U10 SN74LVC2G17DBVR Package_TO_SOT_SMD:SOT-23-6 SN74LVC2G17DBVR C10429 -40℃~+85℃ 1 1.65V~5.5V 10uA 2 32mA 32mA 5.4ns@3.3V,50pF 74LVC Schmitt trigger SOT-23-6 Buffers, Drivers, Receivers, Transceivers ROHS Search":
        - cell:
          - generic: 
        - cell
        - cell "U10":
          - generic: U10
        - cell "SN74LVC2G17DBVR":
          - generic: SN74LVC2G17DBVR
        - cell "Package_TO_SOT_SMD:SOT-23-6":
          - generic: Package_TO_SOT_SMD:SOT-23-6
        - cell "SN74LVC2G17DBVR C10429 -40℃~+85℃ 1 1.65V~5.5V 10uA 2 32mA 32mA 5.4ns@3.3V,50pF 74LVC Schmitt trigger SOT-23-6 Buffers, Drivers, Receivers, Transceivers ROHS Search":
          - generic: SN74LVC2G17DBVR
          - generic: C10429
          - generic: "-40℃~+85℃ 1 1.65V~5.5V 10uA 2 32mA 32mA 5.4ns@3.3V,50pF 74LVC Schmitt trigger SOT-23-6 Buffers, Drivers, Receivers, Transceivers ROHS"
          - text: Search
        - cell:
          - checkbox [checked]
      - row "U11 W25N01GVZEIG Package_SON:WSON-8-1EP_8x6mm_P1.27mm_EP3.4x4.3mm W25N01GVZEIG C88868 -40℃~+85℃ 10 Years 100,000 cycles 104MHz 10uA 1Gbit 2.7V~3.6V 2ms 700us SPI WSON-8-EP(6x8) NAND FLASH ROHS Search":
        - cell:
          - generic: 
        - cell
        - cell "U11":
          - generic: U11
        - cell "W25N01GVZEIG":
          - generic: W25N01GVZEIG
        - cell "Package_SON:WSON-8-1EP_8x6mm_P1.27mm_EP3.4x4.3mm":
          - generic: Package_SON:WSON-8-1EP_8x6mm_P1.27mm_EP3.4x4.3mm
        - cell "W25N01GVZEIG C88868 -40℃~+85℃ 10 Years 100,000 cycles 104MHz 10uA 1Gbit 2.7V~3.6V 2ms 700us SPI WSON-8-EP(6x8) NAND FLASH ROHS Search":
          - generic: W25N01GVZEIG
          - generic: C88868
          - generic: "-40℃~+85℃ 10 Years 100,000 cycles 104MHz 10uA 1Gbit 2.7V~3.6V 2ms 700us SPI WSON-8-EP(6x8) NAND FLASH ROHS"
          - text: Search
        - cell:
          - checkbox [checked]
      - row "U12 TLV803EA29DBZR Package_TO_SOT_SMD:SOT-23 TLV803EA29DBZR C1852114 -40℃~+125℃@(Ta) 1 1.7V~6V 2.93V 200ms 250nA Active Low No No Open Drain Voltage Monitor SOT-23-3 Supervisor and Reset ICs ROHS Search":
        - cell:
          - generic: 
        - cell "U12":
          - generic: U12
        - cell
        - cell "TLV803EA29DBZR":
          - generic: TLV803EA29DBZR
        - cell "Package_TO_SOT_SMD:SOT-23":
          - generic: Package_TO_SOT_SMD:SOT-23
        - cell "TLV803EA29DBZR C1852114 -40℃~+125℃@(Ta) 1 1.7V~6V 2.93V 200ms 250nA Active Low No No Open Drain Voltage Monitor SOT-23-3 Supervisor and Reset ICs ROHS Search":
          - generic: TLV803EA29DBZR
          - generic: C1852114
          - generic: "-40℃~+125℃@(Ta) 1 1.7V~6V 2.93V 200ms 250nA Active Low No No Open Drain Voltage Monitor SOT-23-3 Supervisor and Reset ICs ROHS"
          - text: Search
        - cell:
          - checkbox [checked]
      - row "U13 TPS2116DRLR Package_TO_SOT_SMD:SOT-583-8 TPS2116DRLR C3235557 Operating status indication SOT-583 Power Management - Specialized ROHS Search":
        - cell:
          - generic: 
        - cell "U13":
          - generic: U13
        - cell
        - cell "TPS2116DRLR":
          - generic: TPS2116DRLR
        - cell "Package_TO_SOT_SMD:SOT-583-8":
          - generic: Package_TO_SOT_SMD:SOT-583-8
        - cell "TPS2116DRLR C3235557 Operating status indication SOT-583 Power Management - Specialized ROHS Search":
          - generic: TPS2116DRLR
          - generic: C3235557
          - generic: Operating status indication SOT-583 Power Management - Specialized ROHS
          - text: Search
        - cell:
          - checkbox [checked]
      - row "X1 A308000003 Controller_R3:TXC_A308000003_3225_2pad A308000003 C409345 -40℃~+125℃ 12pF 300Ω 8MHz Crystal Oscillator ±30ppm SMD3225-2P Crystals ROHS Search":
        - cell:
          - generic: 
        - cell "X1":
          - generic: X1
        - cell
        - cell "A308000003":
          - generic: A308000003
        - cell "Controller_R3:TXC_A308000003_3225_2pad":
          - generic: Controller_R3:TXC_A308000003_3225_2pad
        - cell "A308000003 C409345 -40℃~+125℃ 12pF 300Ω 8MHz Crystal Oscillator ±30ppm SMD3225-2P Crystals ROHS Search":
          - generic: A308000003
          - generic: C409345
          - generic: "-40℃~+125℃ 12pF 300Ω 8MHz Crystal Oscillator ±30ppm SMD3225-2P Crystals ROHS"
          - text: Search
        - cell:
          - checkbox [checked]
  - button "Next"
