chenguoming1/h743-controllers/self-balancing/native/review/supplier-p6-evidence/pcb-summary.txt

- text: 
- main:
  - list:
    - listitem "Undo(Ctrl+Z)"
    - listitem "Redo(Ctrl+Y)"
    - listitem "Zoom in(A)"
    - listitem "Zoom out(Z)"
    - listitem "Fit selection"
    - listitem "Fit window(K)"
    - listitem "Flip board(Shift+F)"
    - listitem "Measure(Ctrl+M)"
    - listitem "Export analysis report"
    - listitem "Configure custom rules"
    - listitem "Help Document"
    - listitem "Settings"
  - generic "R3-S6-P6-Gerbers.zip"
  - generic: Units：
  - generic: Metric（cm/mm）
  - button "PCB DFM"
  - button "SMT DFM"
  - button "DFM check"
  - generic: Description
  - generic: All
  - table:
    - rowgroup:
      - row "Analyze project Statistics Operation":
        - columnheader "Analyze project"
        - columnheader "Statistics"
        - columnheader "Operation"
  - generic: Routing layer analysis
  - table:
    - rowgroup:
      - row "Sharp trace corner 0, 0, 0 Details":
        - cell "Sharp trace corner"
        - cell "0, 0, 0"
        - cell "Details":
          - button "Details" [disabled]
      - row "BGA pad 0, 0, 0 Details":
        - cell "BGA pad"
        - cell "0, 0, 0"
        - cell "Details":
          - button "Details" [disabled]
      - row "Via placed within a pad 0, 0, 0 Details":
        - cell "Via placed within a pad"
        - cell "0, 0, 0"
        - cell "Details":
          - button "Details" [disabled]
      - row "Trace to board edge 0, 0, 0 Details":
        - cell "Trace to board edge"
        - cell "0, 0, 0"
        - cell "Details":
          - button "Details" [disabled]
      - row "Trace spacing 0, 0, 32 Details":
        - cell "Trace spacing"
        - cell "0, 0, 32"
        - cell "Details":
          - button "Details"
      - row "Unconnected trace end 0, 0, 0 Details":
        - cell "Unconnected trace end"
        - cell "0, 0, 0"
        - cell "Details":
          - button "Details" [disabled]
      - row "Trace width 0, 0, 100 Details":
        - cell "Trace width"
        - cell "0, 0, 100"
        - cell "Details":
          - button "Details"
      - row "Fiducial 0, 0, 0 Details":
        - cell "Fiducial"
        - cell "0, 0, 0"
        - cell "Details":
          - button "Details" [disabled]
      - row "Pad to board edge 0, 0, 8 Details":
        - cell "Pad to board edge"
        - cell "0, 0, 8"
        - cell "Details":
          - button "Details"
      - row "Pad spacing 0, 54, 46 Details":
        - cell "Pad spacing"
        - cell "0, 54, 46"
        - cell "Details":
          - button "Details"
      - row "Plated through-hole to trace clearance 0, 0, 100 Details":
        - cell "Plated through-hole to trace clearance"
        - cell "0, 0, 100"
        - cell "Details":
          - button "Details"
      - row "Annular ring 100, 0, 0 Details":
        - cell "Annular ring"
        - cell "100, 0, 0"
        - cell "Details":
          - button "Details"
      - row "tht to smd 0, 0, 0 Details":
        - cell "tht to smd"
        - cell "0, 0, 0"
        - cell "Details":
          - button "Details" [disabled]
      - row "Via to pad 0, 0, 1 Details":
        - cell "Via to pad"
        - cell "0, 0, 1"
        - cell "Details":
          - button "Details"
  - generic: Soldermask layer analysis
  - table:
    - rowgroup:
      - row "Soldermask bridge 0, 10, 40 Details":
        - cell "Soldermask bridge"
        - cell "0, 10, 40"
        - cell "Details":
          - button "Details"
      - row "Solder mask opening exposing trace 0, 58, 39 Details":
        - cell "Solder mask opening exposing trace"
        - cell "0, 58, 39"
        - cell "Details":
          - button "Details"
      - row "Soldermask opening with multiple segments 0, 0, 0 Details":
        - cell "Soldermask opening with multiple segments"
        - cell "0, 0, 0"
        - cell "Details":
          - button "Details" [disabled]
      - row "Negative soldermask expansion 0, 0, 0 Details":
        - cell "Negative soldermask expansion"
        - cell "0, 0, 0"
        - cell "Details":
          - button "Details" [disabled]
  - generic: Silkscreen layer analysis
  - table:
    - rowgroup:
      - row "Silkscreen to pad 0, 12, 88 Details":
        - cell "Silkscreen to pad"
        - cell "0, 12, 88"
        - cell "Details":
          - button "Details"
      - row "Silkscreen to hole 100, 0, 0 Details":
        - cell "Silkscreen to hole"
        - cell "100, 0, 0"
        - cell "Details":
          - button "Details"
      - row "Silkscreen line width 0, 76, 0 Details":
        - cell "Silkscreen line width"
        - cell "0, 76, 0"
        - cell "Details":
          - button "Details"
  - generic: Drill layer analysis
  - table:
    - rowgroup:
      - row "Unconnected via 0, 0, 0 Details":
        - cell "Unconnected via"
        - cell "0, 0, 0"
        - cell "Details":
          - button "Details" [disabled]
      - row "Missing plated through-hole 0, 18, 0 Details":
        - cell "Missing plated through-hole"
        - cell "0, 18, 0"
        - cell "Details":
          - button "Details"
      - row "Unconnected via 0, 0, 0 Details":
        - cell "Unconnected via"
        - cell "0, 0, 0"
        - cell "Details":
          - button "Details" [disabled]
      - row "Plated through-hole spacing 0, 0, 0 Details":
        - cell "Plated through-hole spacing"
        - cell "0, 0, 0"
        - cell "Details":
          - button "Details" [disabled]
      - row "Short slot detection 0, 0, 0 Details":
        - cell "Short slot detection"
        - cell "0, 0, 0"
        - cell "Details":
          - button "Details" [disabled]
      - row "Slot width check 4, 0, 0 Details":
        - cell "Slot width check"
        - cell "4, 0, 0"
        - cell "Details":
          - button "Details"
      - row "Via to PTH spacing 0, 0, 0 Details":
        - cell "Via to PTH spacing"
        - cell "0, 0, 0"
        - cell "Details":
          - button "Details" [disabled]
      - row "Unconnected via 0, 0, 0 Details":
        - cell "Unconnected via"
        - cell "0, 0, 0"
        - cell "Details":
          - button "Details" [disabled]
  - generic "Close左侧栏"
  - generic "Gerber(5)": Gerber
  - generic "Gerber(6)": Wireframe
  - generic "2D(2)": 2D
  - generic "3D(3)": 3D
  - generic "Close右侧栏"
  - generic: Show layer controls
  - table:
    - rowgroup:
      - row "Edit Layer type":
        - columnheader
        - columnheader "Edit"
        - columnheader "Layer type"
    - rowgroup
  - status
  - text: 
