chenguoming1/h743-controllers/nexus-style-fc/docs/validation/reviews/order-fixes-2026-10-17/bom-matched.txt

Browser tab: 1926339733, Title: "JLCDFM Viewer - Free Online PCB DFM Tool", URL: "https://jlcdfm.com/bomMatch?pcbUploadFileId=634370103513927681".
0 AXWebArea JLCDFM Viewer - Free Online PCB DFM Tool, URL: jlcdfm.com/bomMatch?pcbUploadFileId=634370103513927681
	1 container
		2 text Bill of Materials Component Placements
		3 content list
			4 container
				5 text Total  
				6 link 53
					7 text 53
				8 text   parts detected
			9 container
				10 link 53
					11 text 53
				12 text   Parts confirmed
		13 button Upload BOM/CPL
		14 container
			15 table
				16 row
					17 cell
						18 text Top Designator
					19 cell
						20 text Bottom Designator
					21 cell
						22 text Comment
					23 cell
						24 text Footprint
					25 cell
						26 text Matched Part Detail
					27 cell
						28 container
							29 text Select  
			30 table
				31 row
					32 cell
						33 text C2,C13,C16,C17,C29,C30
					34 cell
						35 text C1,C3,C4,C7,C8,C10,C20,C22
					36 cell
						37 text 100nF
					38 cell
						39 text C_0402_1005Metric
					40 cell
						41 container
							42 text CL05B104KO5NNNC C1525 100nF 16V X7R ±10% 0402 Multilayer Ceramic Capacitors MLCC - SMD/SMT ROHS
						43 text Search 
					44 cell
						45 container
							46 checkbox (settable, integer) 1
				47 row
					48 cell
					49 cell
						50 text C5
					51 cell
						52 text 4.7uF
					53 cell
						54 text C_0603_1608Metric
					55 cell
						56 container
							57 text CL10A475KA8NQNC C69335 25V 4.7uF X5R ±10% 0603 Multilayer Ceramic Capacitors MLCC - SMD/SMT ROHS
						58 text Search 
					59 cell
						60 container
							61 checkbox (settable, integer) 1
				62 row
					63 cell
					64 cell
						65 text C6,C18,C25
					66 cell
						67 text 1uF
					68 cell
						69 text C_0402_1005Metric
					70 cell
						71 container
							72 text CL05A105KA5NQNC C52923 1uF 25V X5R ±10% 0402 Multilayer Ceramic Capacitors MLCC - SMD/SMT ROHS
						73 text Search 
					74 cell
						75 container
							76 checkbox (settable, integer) 1
				77 row
					78 cell
					79 cell
						80 text C9
					81 cell
						82 text 4.7uF
					83 cell
						84 text C_0402_1005Metric__VCAP_Dense
					85 cell
						86 container
							87 text CL05A475KP5NRNC C368809 10V 4.7uF X5R ±10% 0402 Multilayer Ceramic Capacitors MLCC - SMD/SMT ROHS
						88 text Search 
					89 cell
						90 container
							91 checkbox (settable, integer) 1
				92 row
					93 cell
					94 cell
						95 text C11,C12
					96 cell
						97 text 30pF
					98 cell
						99 text C_0402_1005Metric
					100 cell
						101 container
							102 text 0402CG300J500NT C1570 30pF 50V C0G ±5% 0402 Multilayer Ceramic Capacitors MLCC - SMD/SMT ROHS
						103 text Search 
					104 cell
						105 container
							106 checkbox (settable, integer) 1
				107 row
					108 cell
						109 text C14
					110 cell
					111 cell
						112 text 2.2uF
					113 cell
						114 text C_0402_1005Metric
					115 cell
						116 container
							117 text CL05A225MQ5NSNC C12530 2.2uF 6.3V X5R ±20% 0402 Multilayer Ceramic Capacitors MLCC - SMD/SMT ROHS
						118 text Search 
					119 cell
						120 container
							121 checkbox (settable, integer) 1
				122 row
					123 cell
						124 text C15
					125 cell
					126 cell
						127 text 10nF
					128 cell
						129 text C_0402_1005Metric
					130 cell
						131 container
							132 text CL05B103KB5NNNC C15195 10nF 50V X7R ±10% 0402 Multilayer Ceramic Capacitors MLCC - SMD/SMT ROHS
						133 text Search 
					134 cell
						135 container
							136 checkbox (settable, integer) 1
				137 row
					138 cell
						139 text C19
					140 cell
					141 cell
						142 text 10uF
					143 cell
						144 text C_0603_1608Metric
					145 cell
						146 container
							147 text CL10A106KP8NNNC C19702 10V 10uF X5R ±10% 0603 Multilayer Ceramic Capacitors MLCC - SMD/SMT ROHS
						148 text Search 
					149 cell
						150 container
							151 checkbox (settable, integer) 1
				152 row
					153 cell
					154 cell
						155 text C21
					156 cell
						157 text 10uF
					158 cell
						159 text C_0603_1608Metric
					160 cell
						161 container
							162 text CL10A106MA8NRNC C96446 10uF 25V X5R ±20% 0603 Multilayer Ceramic Capacitors MLCC - SMD/SMT ROHS
						163 text Search 
					164 cell
						165 container
							166 checkbox (settable, integer) 1
				167 row
					168 cell
					169 cell
						170 text C23
					171 cell
						172 text 3.3nF
					173 cell
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
					818 cell
						819 text 8MHz20pF
					820 cell
						821 text CRYSTAL-SMD_4P-L3.2-W2.5-BL__NexusMain_Y1
					822 cell
						823 container
							824 text 3225 8M 20PF 10PPM C5181477 -40℃~+80℃ 20pF 8MHz ±10ppm ±30ppm SMD3225-4P Crystals ROHS
						825 text Search 
					826 cell
						827 container
							828 checkbox (settable, integer) 1
		829 button Next

The focused UI element is 0 AXWebArea JLCDFM Viewer - Free Online PCB DFM Tool, URL: jlcdfm.com/bomMatch?pcbUploadFileId=634370103513927681
