chenguoming1/h743-controllers/nexus-style-fc/docs/validation/reviews/r23-replacement-2026-10-18/jlc-order-remark.txt

Two boards, both sides; exact BOM/CPL, no other substitutions. R23=C2766886, 0.12 ohm (120 mOhm), +/-5%; old 0.15 BOM comment superseded; C9=C368809, 4.7uF 0402; C5 stays C69335. U10 CPL rotation is already 270deg. D4=C1973343 cathode VX/anode GND. J6 has 0.95mm shell legs on 1.6mm PCB: confirm soldering/barrel fill and inspect retention. Add rails, tooling holes and fiducials. Manual placement approval; confirm R23 stock/attrition.
