chenguoming1/h743-controllers/nexus-style-fc/docs/validation/reviews/jlcdfm-current-2026-10-17/bom-matching-dom.txt

- text: 
- main:
  - generic: Bill of Materials
  - generic: Component Placements
  - navigation:
    - list:
      - text: Total
      - generic: "51"
      - text: parts detected
      - generic: "51"
      - text: Parts confirmed
  - button "Upload BOM/CPL":
    - generic: Upload BOM/CPL
  - text: 
  - table:
    - rowgroup:
      - row "Top Designator Bottom Designator Comment Footprint Matched Part Detail Select ":
        - columnheader
        - columnheader "Top Designator":
          - generic: Top Designator
        - columnheader "Bottom Designator":
          - generic: Bottom Designator
        - columnheader "Comment":
          - generic: Comment
        - columnheader "Footprint":
          - generic: Footprint
        - columnheader "Matched Part Detail":
          - generic: Matched Part Detail
        - columnheader "Select ":
          - text: Select
          - generic: 
  - table:
    - rowgroup:
      - row "C2,C13,C16,C17,C29,C30 C1,C3,C4,C7,C8,C10,C20,C22 100nF C_0402_1005Metric CL05B104KO5NNNC C1525 100nF 16V X7R ±10% 0402 Multilayer Ceramic Capacitors MLCC - SMD/SMT ROHS Search":
        - cell:
          - generic: 
        - cell "C2,C13,C16,C17,C29,C30":
          - generic: C2,C13,C16,C17,C29,C30
        - cell "C1,C3,C4,C7,C8,C10,C20,C22":
          - generic: C1,C3,C4,C7,C8,C10,C20,C22
        - cell "100nF":
          - generic: 100nF
        - cell "C_0402_1005Metric":
          - generic: C_0402_1005Metric
        - cell "CL05B104KO5NNNC C1525 100nF 16V X7R ±10% 0402 Multilayer Ceramic Capacitors MLCC - SMD/SMT ROHS Search":
          - generic: CL05B104KO5NNNC
          - generic: C1525
          - generic: 100nF 16V X7R ±10% 0402 Multilayer Ceramic Capacitors MLCC - SMD/SMT ROHS
          - text: Search
        - cell:
          - checkbox [checked]
      - row "C5,C9 4.7uF C_0603_1608Metric CL10A475KA8NQNC C69335 25V 4.7uF X5R ±10% 0603 Multilayer Ceramic Capacitors MLCC - SMD/SMT ROHS Search":
        - cell:
          - generic: 
        - cell
        - cell "C5,C9":
          - generic: C5,C9
        - cell "4.7uF":
          - generic: 4.7uF
        - cell "C_0603_1608Metric":
          - generic: C_0603_1608Metric
        - cell "CL10A475KA8NQNC C69335 25V 4.7uF X5R ±10% 0603 Multilayer Ceramic Capacitors MLCC - SMD/SMT ROHS Search":
          - generic: CL10A475KA8NQNC
          - generic: C69335
          - generic: 25V 4.7uF X5R ±10% 0603 Multilayer Ceramic Capacitors MLCC - SMD/SMT ROHS
          - text: Search
        - cell:
          - checkbox [checked]
      - row "C6,C18,C25 1uF C_0402_1005Metric CL05A105KA5NQNC C52923 1uF 25V X5R ±10% 0402 Multilayer Ceramic Capacitors MLCC - SMD/SMT ROHS Search":
        - cell:
          - generic: 
        - cell
        - cell "C6,C18,C25":
          - generic: C6,C18,C25
        - cell "1uF":
          - generic: 1uF
        - cell "C_0402_1005Metric":
          - generic: C_0402_1005Metric
        - cell "CL05A105KA5NQNC C52923 1uF 25V X5R ±10% 0402 Multilayer Ceramic Capacitors MLCC - SMD/SMT ROHS Search":
          - generic: CL05A105KA5NQNC
          - generic: C52923
          - generic: 1uF 25V X5R ±10% 0402 Multilayer Ceramic Capacitors MLCC - SMD/SMT ROHS
          - text: Search
        - cell:
          - checkbox [checked]
      - row "C11,C12 30pF C_0402_1005Metric 0402CG300J500NT C1570 30pF 50V C0G ±5% 0402 Multilayer Ceramic Capacitors MLCC - SMD/SMT ROHS Search":
        - cell:
          - generic: 
        - cell
        - cell "C11,C12":
          - generic: C11,C12
        - cell "30pF":
          - generic: 30pF
        - cell "C_0402_1005Metric":
          - generic: C_0402_1005Metric
        - cell "0402CG300J500NT C1570 30pF 50V C0G ±5% 0402 Multilayer Ceramic Capacitors MLCC - SMD/SMT ROHS Search":
          - generic: 0402CG300J500NT
          - generic: C1570
          - generic: 30pF 50V C0G ±5% 0402 Multilayer Ceramic Capacitors MLCC - SMD/SMT ROHS
          - text: Search
        - cell:
          - checkbox [checked]
      - row "C14 2.2uF C_0402_1005Metric CL05A225MQ5NSNC C12530 2.2uF 6.3V X5R ±20% 0402 Multilayer Ceramic Capacitors MLCC - SMD/SMT ROHS Search":
        - cell:
          - generic: 
        - cell "C14":
          - generic: C14
        - cell
        - cell "2.2uF":
          - generic: 2.2uF
        - cell "C_0402_1005Metric":
          - generic: C_0402_1005Metric
        - cell "CL05A225MQ5NSNC C12530 2.2uF 6.3V X5R ±20% 0402 Multilayer Ceramic Capacitors MLCC - SMD/SMT ROHS Search":
          - generic: CL05A225MQ5NSNC
          - generic: C12530
          - generic: 2.2uF 6.3V X5R ±20% 0402 Multilayer Ceramic Capacitors MLCC - SMD/SMT ROHS
          - text: Search
        - cell:
          - checkbox [checked]
      - row "C15 10nF C_0402_1005Metric CL05B103KB5NNNC C15195 10nF 50V X7R ±10% 0402 Multilayer Ceramic Capacitors MLCC - SMD/SMT ROHS Search":
        - cell:
          - generic: 
        - cell "C15":
          - generic: C15
        - cell
        - cell "10nF":
          - generic: 10nF
        - cell "C_0402_1005Metric":
          - generic: C_0402_1005Metric
        - cell "CL05B103KB5NNNC C15195 10nF 50V X7R ±10% 0402 Multilayer Ceramic Capacitors MLCC - SMD/SMT ROHS Search":
          - generic: CL05B103KB5NNNC
          - generic: C15195
          - generic: 10nF 50V X7R ±10% 0402 Multilayer Ceramic Capacitors MLCC - SMD/SMT ROHS
          - text: Search
        - cell:
          - checkbox [checked]
      - row "C19 10uF C_0603_1608Metric CL10A106KP8NNNC C19702 10V 10uF X5R ±10% 0603 Multilayer Ceramic Capacitors MLCC - SMD/SMT ROHS Search":
        - cell:
          - generic: 
        - cell "C19":
          - generic: C19
        - cell
        - cell "10uF":
          - generic: 10uF
        - cell "C_0603_1608Metric":
          - generic: C_0603_1608Metric
        - cell "CL10A106KP8NNNC C19702 10V 10uF X5R ±10% 0603 Multilayer Ceramic Capacitors MLCC - SMD/SMT ROHS Search":
          - generic: CL10A106KP8NNNC
          - generic: C19702
          - generic: 10V 10uF X5R ±10% 0603 Multilayer Ceramic Capacitors MLCC - SMD/SMT ROHS
          - text: Search
        - cell:
          - checkbox [checked]
      - row "C21 10uF C_0603_1608Metric CL10A106MA8NRNC C96446 10uF 25V X5R ±20% 0603 Multilayer Ceramic Capacitors MLCC - SMD/SMT ROHS Search":
        - cell:
          - generic: 
        - cell
        - cell "C21":
          - generic: C21
        - cell "10uF":
          - generic: 10uF
        - cell "C_0603_1608Metric":
          - generic: C_0603_1608Metric
        - cell "CL10A106MA8NRNC C96446 10uF 25V X5R ±20% 0603 Multilayer Ceramic Capacitors MLCC - SMD/SMT ROHS Search":
          - generic: CL10A106MA8NRNC
          - generic: C96446
          - generic: 10uF 25V X5R ±20% 0603 Multilayer Ceramic Capacitors MLCC - SMD/SMT ROHS
          - text: Search
        - cell:
          - checkbox [checked]
      - row "C23 3.3nF C_0402_1005Metric CL05B332KB5NNNC C26404 3.3nF 50V X7R ±10% 0402 Multilayer Ceramic Capacitors MLCC - SMD/SMT ROHS Search":
        - cell:
          - generic: 
        - cell
        - cell "C23":
          - generic: C23
        - cell "3.3nF":
          - generic: 3.3nF
        - cell "C_0402_1005Metric":
          - generic: C_0402_1005Metric
        - cell "CL05B332KB5NNNC C26404 3.3nF 50V X7R ±10% 0402 Multilayer Ceramic Capacitors MLCC - SMD/SMT ROHS Search":
          - generic: CL05B332KB5NNNC
          - generic: C26404
          - generic: 3.3nF 50V X7R ±10% 0402 Multilayer Ceramic Capacitors MLCC - SMD/SMT ROHS
          - text: Search
        - cell:
          - checkbox [checked]
      - row "C27,C31 22uF C_0805_2012Metric_Samsung_CL21_MinLand CL21A226MAYNNNE C602037 22uF 25V X5R ±20% 0805 Multilayer Ceramic Capacitors MLCC - SMD/SMT ROHS Search":
        - cell:
          - generic: 
        - cell
        - cell "C27,C31":
          - generic: C27,C31
        - cell "22uF":
          - generic: 22uF
        - cell "C_0805_2012Metric_Samsung_CL21_MinLand":
          - generic: C_0805_2012Metric_Samsung_CL21_MinLand
        - cell "CL21A226MAYNNNE C602037 22uF 25V X5R ±20% 0805 Multilayer Ceramic Capacitors MLCC - SMD/SMT ROHS Search":
          - generic: CL21A226MAYNNNE
          - generic: C602037
          - generic: 22uF 25V X5R ±20% 0805 Multilayer Ceramic Capacitors MLCC - SMD/SMT ROHS
          - text: Search
        - cell:
          - checkbox [checked]
      - row "C26 C24 22uF C_0805_2012Metric CL21A226MAYNNNE C602037 22uF 25V X5R ±20% 0805 Multilayer Ceramic Capacitors MLCC - SMD/SMT ROHS Search":
        - cell:
          - generic: 
        - cell "C26":
          - generic: C26
        - cell "C24":
          - generic: C24
        - cell "22uF":
          - generic: 22uF
        - cell "C_0805_2012Metric":
          - generic: C_0805_2012Metric
        - cell "CL21A226MAYNNNE C602037 22uF 25V X5R ±20% 0805 Multilayer Ceramic Capacitors MLCC - SMD/SMT ROHS Search":
          - generic: CL21A226MAYNNNE
          - generic: C602037
          - generic: 22uF 25V X5R ±20% 0805 Multilayer Ceramic Capacitors MLCC - SMD/SMT ROHS
          - text: Search
        - cell:
          - checkbox [checked]
      - row "C28 22uF C_0603_1608Metric CL10A226MP8NUNE C86295 10V 22uF X5R ±20% 0603 Multilayer Ceramic Capacitors MLCC - SMD/SMT ROHS Search":
        - cell:
          - generic: 
        - cell
        - cell "C28":
          - generic: C28
        - cell "22uF":
          - generic: 22uF
        - cell "C_0603_1608Metric":
          - generic: C_0603_1608Metric
        - cell "CL10A226MP8NUNE C86295 10V 22uF X5R ±20% 0603 Multilayer Ceramic Capacitors MLCC - SMD/SMT ROHS Search":
          - generic: CL10A226MP8NUNE
          - generic: C86295
          - generic: 10V 22uF X5R ±20% 0603 Multilayer Ceramic Capacitors MLCC - SMD/SMT ROHS
          - text: Search
        - cell:
          - checkbox [checked]
      - row "D1 LED1yellow-green LED0603-RD_GREEN__NexusMain_D1 XL-1608SYGC-04 C965806 -40℃~+85℃ 120° 2.4V 20mA 50mW 50mcd 565nm~575nm 572nm Discrete Diode Top-mount Water Clear Yellow Green 0603 LED Indication - Discrete ROHS Search":
        - cell:
          - generic: 
        - cell "D1":
          - generic: D1
        - cell
        - cell "LED1yellow-green":
          - generic: LED1yellow-green
        - cell "LED0603-RD_GREEN__NexusMain_D1":
          - generic: LED0603-RD_GREEN__NexusMain_D1
        - cell "XL-1608SYGC-04 C965806 -40℃~+85℃ 120° 2.4V 20mA 50mW 50mcd 565nm~575nm 572nm Discrete Diode Top-mount Water Clear Yellow Green 0603 LED Indication - Discrete ROHS Search":
          - generic: XL-1608SYGC-04
          - generic: C965806
          - generic: "-40℃~+85℃ 120° 2.4V 20mA 50mW 50mcd 565nm~575nm 572nm Discrete Diode Top-mount Water Clear Yellow Green 0603 LED Indication - Discrete ROHS"
          - text: Search
        - cell:
          - checkbox [checked]
      - row "D2 LED2red LED0603-RD_RED__NexusMain_D2 XL-1608SURC-06 C965799 -40℃~+85℃ 120° 2.3V 20mA 225mcd 50mW 620nm~630nm 625nm Discrete Diode Red Top-mount Water Clear 0603 LED Indication - Discrete ROHS Search":
        - cell:
          - generic: 
        - cell "D2":
          - generic: D2
        - cell
        - cell "LED2red":
          - generic: LED2red
        - cell "LED0603-RD_RED__NexusMain_D2":
          - generic: LED0603-RD_RED__NexusMain_D2
        - cell "XL-1608SURC-06 C965799 -40℃~+85℃ 120° 2.3V 20mA 225mcd 50mW 620nm~630nm 625nm Discrete Diode Red Top-mount Water Clear 0603 LED Indication - Discrete ROHS Search":
          - generic: XL-1608SURC-06
          - generic: C965799
          - generic: "-40℃~+85℃ 120° 2.3V 20mA 225mcd 50mW 620nm~630nm 625nm Discrete Diode Red Top-mount Water Clear 0603 LED Indication - Discrete ROHS"
          - text: Search
        - cell:
          - checkbox [checked]
      - row "D3 PowerLEDblue LED0603-RD_BLUE__NexusMain_D3 XL-1608UBC-04 C965807 -40℃~+85℃ 120° 20mA 3.3V 300mcd 455nm~475nm 470nm 70mW Blue Discrete Diode Top-mount Water Clear 0603 LED Indication - Discrete ROHS Search":
        - cell:
          - generic: 
        - cell "D3":
          - generic: D3
        - cell
        - cell "PowerLEDblue":
          - generic: PowerLEDblue
        - cell "LED0603-RD_BLUE__NexusMain_D3":
          - generic: LED0603-RD_BLUE__NexusMain_D3
        - cell "XL-1608UBC-04 C965807 -40℃~+85℃ 120° 20mA 3.3V 300mcd 455nm~475nm 470nm 70mW Blue Discrete Diode Top-mount Water Clear 0603 LED Indication - Discrete ROHS Search":
          - generic: XL-1608UBC-04
          - generic: C965807
          - generic: "-40℃~+85℃ 120° 20mA 3.3V 300mcd 455nm~475nm 470nm 70mW Blue Discrete Diode Top-mount Water Clear 0603 LED Indication - Discrete ROHS"
          - text: Search
        - cell:
          - checkbox [checked]
      - row "D4 SMF13A SOD-123FL_L2.8-W1.8-LS3.6-RD SMF13A C353315 -55℃~+150℃ 13V 15.9V 1uA 200W@10/1000us 21.5V 9.3A@10/1000us TVS Unidirectional SOD-123FL ESD and Surge Protection (TVS/ESD) ROHS Search":
        - cell:
          - generic: 
        - cell
        - cell "D4":
          - generic: D4
        - cell "SMF13A":
          - generic: SMF13A
        - cell "SOD-123FL_L2.8-W1.8-LS3.6-RD":
          - generic: SOD-123FL_L2.8-W1.8-LS3.6-RD
        - cell "SMF13A C353315 -55℃~+150℃ 13V 15.9V 1uA 200W@10/1000us 21.5V 9.3A@10/1000us TVS Unidirectional SOD-123FL ESD and Surge Protection (TVS/ESD) ROHS Search":
          - generic: SMF13A
          - generic: C353315
          - generic: "-55℃~+150℃ 13V 15.9V 1uA 200W@10/1000us 21.5V 9.3A@10/1000us TVS Unidirectional SOD-123FL ESD and Surge Protection (TVS/ESD) ROHS"
          - text: Search
        - cell:
          - checkbox [checked]
      - row "D5,D6 B5819WS SOD-323_L1.8-W1.3-LS2.5-RD B5819WS C22624 -55℃~+125℃ 1.5A 1A 40V 600mV@1A Independent SOD-323 Schottky Diodes ROHS Search":
        - cell:
          - generic: 
        - cell
        - cell "D5,D6":
          - generic: D5,D6
        - cell "B5819WS":
          - generic: B5819WS
        - cell "SOD-323_L1.8-W1.3-LS2.5-RD":
          - generic: SOD-323_L1.8-W1.3-LS2.5-RD
        - cell "B5819WS C22624 -55℃~+125℃ 1.5A 1A 40V 600mV@1A Independent SOD-323 Schottky Diodes ROHS Search":
          - generic: B5819WS
          - generic: C22624
          - generic: "-55℃~+125℃ 1.5A 1A 40V 600mV@1A Independent SOD-323 Schottky Diodes ROHS"
          - text: Search
        - cell:
          - checkbox [checked]
      - row "F1 0.5APTC F0805__NexusMain_F1 SMD0805P050TF C20978 -40℃~+85℃ 1.5mm 100ms 100mΩ 1A 1mm 2.2mm 30A 500mA 500mW 6V 850mΩ 0805 Resettable Fuses ROHS Search":
        - cell:
          - generic: 
        - cell
        - cell "F1":
          - generic: F1
        - cell "0.5APTC":
          - generic: 0.5APTC
        - cell "F0805__NexusMain_F1":
          - generic: F0805__NexusMain_F1
        - cell "SMD0805P050TF C20978 -40℃~+85℃ 1.5mm 100ms 100mΩ 1A 1mm 2.2mm 30A 500mA 500mW 6V 850mΩ 0805 Resettable Fuses ROHS Search":
          - generic: SMD0805P050TF
          - generic: C20978
          - generic: "-40℃~+85℃ 1.5mm 100ms 100mΩ 1A 1mm 2.2mm 30A 500mA 500mW 6V 850mΩ 0805 Resettable Fuses ROHS"
          - text: Search
        - cell:
          - checkbox [checked]
      - row "F2 0.5APTC F0805__NexusMain_F2 SMD0805P050TF C20978 -40℃~+85℃ 1.5mm 100ms 100mΩ 1A 1mm 2.2mm 30A 500mA 500mW 6V 850mΩ 0805 Resettable Fuses ROHS Search":
        - cell:
          - generic: 
        - cell "F2":
          - generic: F2
        - cell
        - cell "0.5APTC":
          - generic: 0.5APTC
        - cell "F0805__NexusMain_F2":
          - generic: F0805__NexusMain_F2
        - cell "SMD0805P050TF C20978 -40℃~+85℃ 1.5mm 100ms 100mΩ 1A 1mm 2.2mm 30A 500mA 500mW 6V 850mΩ 0805 Resettable Fuses ROHS Search":
          - generic: SMD0805P050TF
          - generic: C20978
          - generic: "-40℃~+85℃ 1.5mm 100ms 100mΩ 1A 1mm 2.2mm 30A 500mA 500mW 6V 850mΩ 0805 Resettable Fuses ROHS"
          - text: Search
        - cell:
          - checkbox [checked]
      - row "J2 DSM(UART1) CONN-SMD_B3B-ZR-SM4-TF__NexusMain_J2 B3B-ZR-SM4-TF(LF)(SN) C489717 -25℃~+85℃ 1 1.5mm 1A 1x3P 3 3P 5.2mm 50V 5mm 7.5mm Auxiliary Solder Pin Brass PA6T Surface Mount,Vertical Tin UL94V-0 White ZH SMD,P=1.5mm Wire To Board Connector ROHS Search":
        - cell:
          - generic: 
        - cell "J2":
          - generic: J2
        - cell
        - cell "DSM(UART1)":
          - generic: DSM(UART1)
        - cell "CONN-SMD_B3B-ZR-SM4-TF__NexusMain_J2":
          - generic: CONN-SMD_B3B-ZR-SM4-TF__NexusMain_J2
        - cell "B3B-ZR-SM4-TF(LF)(SN) C489717 -25℃~+85℃ 1 1.5mm 1A 1x3P 3 3P 5.2mm 50V 5mm 7.5mm Auxiliary Solder Pin Brass PA6T Surface Mount,Vertical Tin UL94V-0 White ZH SMD,P=1.5mm Wire To Board Connector ROHS Search":
          - generic: B3B-ZR-SM4-TF(LF)(SN)
          - generic: C489717
          - generic: "-25℃~+85℃ 1 1.5mm 1A 1x3P 3 3P 5.2mm 50V 5mm 7.5mm Auxiliary Solder Pin Brass PA6T Surface Mount,Vertical Tin UL94V-0 White ZH SMD,P=1.5mm Wire To Board Connector ROHS"
          - text: Search
        - cell:
          - checkbox [checked]
      - row "J3 A-CRSF(UART4) CONN-SMD_4P-P1.25_BM04B-GHS-TBT-LF-SN__NexusMain_J3 BM04B-GHS-TBT(LF)(SN) C161692 -25℃~+85℃ 1 1.25mm 1A 1x4P 4 4.05mm 4.32mm 4P 50V 8.25mm Auxiliary Solder Pin GH PA9T Phosphor bronze Surface Mount,Vertical Tin UL94V-0 White SMD,P=1.25mm Wire To Board Connector ROHS Search":
        - cell:
          - generic: 
        - cell "J3":
          - generic: J3
        - cell
        - cell "A-CRSF(UART4)":
          - generic: A-CRSF(UART4)
        - cell "CONN-SMD_4P-P1.25_BM04B-GHS-TBT-LF-SN__NexusMain_J3":
          - generic: CONN-SMD_4P-P1.25_BM04B-GHS-TBT-LF-SN__NexusMain_J3
        - cell "BM04B-GHS-TBT(LF)(SN) C161692 -25℃~+85℃ 1 1.25mm 1A 1x4P 4 4.05mm 4.32mm 4P 50V 8.25mm Auxiliary Solder Pin GH PA9T Phosphor bronze Surface Mount,Vertical Tin UL94V-0 White SMD,P=1.25mm Wire To Board Connector ROHS Search":
          - generic: BM04B-GHS-TBT(LF)(SN)
          - generic: C161692
          - generic: "-25℃~+85℃ 1 1.25mm 1A 1x4P 4 4.05mm 4.32mm 4P 50V 8.25mm Auxiliary Solder Pin GH PA9T Phosphor bronze Surface Mount,Vertical Tin UL94V-0 White SMD,P=1.25mm Wire To Board Connector ROHS"
          - text: Search
        - cell:
          - checkbox [checked]
      - row "J4 C(UART3) CONN-SMD_4P-P1.25_BM04B-GHS-TBT-LF-SN__NexusMain_J4 BM04B-GHS-TBT(LF)(SN) C161692 -25℃~+85℃ 1 1.25mm 1A 1x4P 4 4.05mm 4.32mm 4P 50V 8.25mm Auxiliary Solder Pin GH PA9T Phosphor bronze Surface Mount,Vertical Tin UL94V-0 White SMD,P=1.25mm Wire To Board Connector ROHS Search":
        - cell:
          - generic: 
        - cell "J4":
          - generic: J4
        - cell
        - cell "C(UART3)":
          - generic: C(UART3)
        - cell "CONN-SMD_4P-P1.25_BM04B-GHS-TBT-LF-SN__NexusMain_J4":
          - generic: CONN-SMD_4P-P1.25_BM04B-GHS-TBT-LF-SN__NexusMain_J4
        - cell "BM04B-GHS-TBT(LF)(SN) C161692 -25℃~+85℃ 1 1.25mm 1A 1x4P 4 4.05mm 4.32mm 4P 50V 8.25mm Auxiliary Solder Pin GH PA9T Phosphor bronze Surface Mount,Vertical Tin UL94V-0 White SMD,P=1.25mm Wire To Board Connector ROHS Search":
          - generic: BM04B-GHS-TBT(LF)(SN)
          - generic: C161692
          - generic: "-25℃~+85℃ 1 1.25mm 1A 1x4P 4 4.05mm 4.32mm 4P 50V 8.25mm Auxiliary Solder Pin GH PA9T Phosphor bronze Surface Mount,Vertical Tin UL94V-0 White SMD,P=1.25mm Wire To Board Connector ROHS"
          - text: Search
        - cell:
          - checkbox [checked]
      - row "J5 B(UART6) CONN-SMD_4P-P1.25_BM04B-GHS-TBT-LF-SN__NexusMain_J5 BM04B-GHS-TBT(LF)(SN) C161692 -25℃~+85℃ 1 1.25mm 1A 1x4P 4 4.05mm 4.32mm 4P 50V 8.25mm Auxiliary Solder Pin GH PA9T Phosphor bronze Surface Mount,Vertical Tin UL94V-0 White SMD,P=1.25mm Wire To Board Connector ROHS Search":
        - cell:
          - generic: 
        - cell "J5":
          - generic: J5
        - cell
        - cell "B(UART6)":
          - generic: B(UART6)
        - cell "CONN-SMD_4P-P1.25_BM04B-GHS-TBT-LF-SN__NexusMain_J5":
          - generic: CONN-SMD_4P-P1.25_BM04B-GHS-TBT-LF-SN__NexusMain_J5
        - cell "BM04B-GHS-TBT(LF)(SN) C161692 -25℃~+85℃ 1 1.25mm 1A 1x4P 4 4.05mm 4.32mm 4P 50V 8.25mm Auxiliary Solder Pin GH PA9T Phosphor bronze Surface Mount,Vertical Tin UL94V-0 White SMD,P=1.25mm Wire To Board Connector ROHS Search":
          - generic: BM04B-GHS-TBT(LF)(SN)
          - generic: C161692
          - generic: "-25℃~+85℃ 1 1.25mm 1A 1x4P 4 4.05mm 4.32mm 4P 50V 8.25mm Auxiliary Solder Pin GH PA9T Phosphor bronze Surface Mount,Vertical Tin UL94V-0 White SMD,P=1.25mm Wire To Board Connector ROHS"
          - text: Search
        - cell:
          - checkbox [checked]
      - row "J6 USB-Cvertical USB-C-SMD_TYPE-C-31-D-06__NexusMain_J6 TYPE-C-31-D-06 C2689964 -25℃~+85℃ 1 10,000 cycles 16P 5A 5V 6.4mm Female Surface Mount,Vertical Type-C SMD USB Connectors ROHS Search":
        - cell:
          - generic: 
        - cell "J6":
          - generic: J6
        - cell
        - cell "USB-Cvertical":
          - generic: USB-Cvertical
        - cell "USB-C-SMD_TYPE-C-31-D-06__NexusMain_J6":
          - generic: USB-C-SMD_TYPE-C-31-D-06__NexusMain_J6
        - cell "TYPE-C-31-D-06 C2689964 -25℃~+85℃ 1 10,000 cycles 16P 5A 5V 6.4mm Female Surface Mount,Vertical Type-C SMD USB Connectors ROHS Search":
          - generic: TYPE-C-31-D-06
          - generic: C2689964
          - generic: "-25℃~+85℃ 1 10,000 cycles 16P 5A 5V 6.4mm Female Surface Mount,Vertical Type-C SMD USB Connectors ROHS"
          - text: Search
        - cell:
          - checkbox [checked]
      - row "L1 2.2uH3A IND-SMD_L4.6-W4.1 MHCI04020-2R2M-R8 C142096 2.2uH 3A 58mΩ 5A Magnetic Shielded Inductor ±20% SMD,4.6x4.1mm Power Inductors ROHS Search":
        - cell:
          - generic: 
        - cell
        - cell "L1":
          - generic: L1
        - cell "2.2uH3A":
          - generic: 2.2uH3A
        - cell "IND-SMD_L4.6-W4.1":
          - generic: IND-SMD_L4.6-W4.1
        - cell "MHCI04020-2R2M-R8 C142096 2.2uH 3A 58mΩ 5A Magnetic Shielded Inductor ±20% SMD,4.6x4.1mm Power Inductors ROHS Search":
          - generic: MHCI04020-2R2M-R8
          - generic: C142096
          - generic: 2.2uH 3A 58mΩ 5A Magnetic Shielded Inductor ±20% SMD,4.6x4.1mm Power Inductors ROHS
          - text: Search
        - cell:
          - checkbox [checked]
      - row "L2 2.2uH IND-SMD_L2.0-W1.6__NexusMain_L2 CKCSA201610-2.2uH/M C5291913 1.3A 1.7A 185mΩ 2.2uH Magnetic Shielded Inductor ±20% 0806 Power Inductors ROHS Search":
        - cell:
          - generic: 
        - cell
        - cell "L2":
          - generic: L2
        - cell "2.2uH":
          - generic: 2.2uH
        - cell "IND-SMD_L2.0-W1.6__NexusMain_L2":
          - generic: IND-SMD_L2.0-W1.6__NexusMain_L2
        - cell "CKCSA201610-2.2uH/M C5291913 1.3A 1.7A 185mΩ 2.2uH Magnetic Shielded Inductor ±20% 0806 Power Inductors ROHS Search":
          - generic: CKCSA201610-2.2uH/M
          - generic: C5291913
          - generic: 1.3A 1.7A 185mΩ 2.2uH Magnetic Shielded Inductor ±20% 0806 Power Inductors ROHS
          - text: Search
        - cell:
          - checkbox [checked]
      - row "R2 1k R_0402_1005Metric__NexusMain_R2 0402WGF1001TCE C11702 -55℃~+155℃ 1kΩ 50V 62.5mW Thick Film Resistor ±1% ±100ppm/℃ 0402 Chip Resistor - Surface Mount ROHS Search":
        - cell:
          - generic: 
        - cell "R2":
          - generic: R2
        - cell
        - cell "1k":
          - generic: 1k
        - cell "R_0402_1005Metric__NexusMain_R2":
          - generic: R_0402_1005Metric__NexusMain_R2
        - cell "0402WGF1001TCE C11702 -55℃~+155℃ 1kΩ 50V 62.5mW Thick Film Resistor ±1% ±100ppm/℃ 0402 Chip Resistor - Surface Mount ROHS Search":
          - generic: 0402WGF1001TCE
          - generic: C11702
          - generic: "-55℃~+155℃ 1kΩ 50V 62.5mW Thick Film Resistor ±1% ±100ppm/℃ 0402 Chip Resistor - Surface Mount ROHS"
          - text: Search
        - cell:
          - checkbox [checked]
      - row "R3,R22 1k R_0402_1005Metric 0402WGF1001TCE C11702 -55℃~+155℃ 1kΩ 50V 62.5mW Thick Film Resistor ±1% ±100ppm/℃ 0402 Chip Resistor - Surface Mount ROHS Search":
        - cell:
          - generic: 
        - cell "R3,R22":
          - generic: R3,R22
        - cell
        - cell "1k":
          - generic: 1k
        - cell "R_0402_1005Metric":
          - generic: R_0402_1005Metric
        - cell "0402WGF1001TCE C11702 -55℃~+155℃ 1kΩ 50V 62.5mW Thick Film Resistor ±1% ±100ppm/℃ 0402 Chip Resistor - Surface Mount ROHS Search":
          - generic: 0402WGF1001TCE
          - generic: C11702
          - generic: "-55℃~+155℃ 1kΩ 50V 62.5mW Thick Film Resistor ±1% ±100ppm/℃ 0402 Chip Resistor - Surface Mount ROHS"
          - text: Search
        - cell:
          - checkbox [checked]
      - row "R4 1k R_0402_1005Metric__NexusMain_R4 0402WGF1001TCE C11702 -55℃~+155℃ 1kΩ 50V 62.5mW Thick Film Resistor ±1% ±100ppm/℃ 0402 Chip Resistor - Surface Mount ROHS Search":
        - cell:
          - generic: 
        - cell "R4":
          - generic: R4
        - cell
        - cell "1k":
          - generic: 1k
        - cell "R_0402_1005Metric__NexusMain_R4":
          - generic: R_0402_1005Metric__NexusMain_R4
        - cell "0402WGF1001TCE C11702 -55℃~+155℃ 1kΩ 50V 62.5mW Thick Film Resistor ±1% ±100ppm/℃ 0402 Chip Resistor - Surface Mount ROHS Search":
          - generic: 0402WGF1001TCE
          - generic: C11702
          - generic: "-55℃~+155℃ 1kΩ 50V 62.5mW Thick Film Resistor ±1% ±100ppm/℃ 0402 Chip Resistor - Surface Mount ROHS"
          - text: Search
        - cell:
          - checkbox [checked]
      - row "R5,R17,R19 R1,R8,R9,R10 10k R_0402_1005Metric 0402WGF1002TCE C25744 -55℃~+155℃ 10kΩ 50V 62.5mW Thick Film Resistor ±1% ±100ppm/℃ 0402 Chip Resistor - Surface Mount ROHS Search":
        - cell:
          - generic: 
        - cell "R5,R17,R19":
          - generic: R5,R17,R19
        - cell "R1,R8,R9,R10":
          - generic: R1,R8,R9,R10
        - cell "10k":
          - generic: 10k
        - cell "R_0402_1005Metric":
          - generic: R_0402_1005Metric
        - cell "0402WGF1002TCE C25744 -55℃~+155℃ 10kΩ 50V 62.5mW Thick Film Resistor ±1% ±100ppm/℃ 0402 Chip Resistor - Surface Mount ROHS Search":
          - generic: 0402WGF1002TCE
          - generic: C25744
          - generic: "-55℃~+155℃ 10kΩ 50V 62.5mW Thick Film Resistor ±1% ±100ppm/℃ 0402 Chip Resistor - Surface Mount ROHS"
          - text: Search
        - cell:
          - checkbox [checked]
      - row "R6,R7 2.2k R_0402_1005Metric 0402WGF2201TCE C25879 -55℃~+155℃ 2.2kΩ 50V 62.5mW Thick Film Resistor ±1% ±100ppm/℃ 0402 Chip Resistor - Surface Mount ROHS Search":
        - cell:
          - generic: 
        - cell
        - cell "R6,R7":
          - generic: R6,R7
        - cell "2.2k":
          - generic: 2.2k
        - cell "R_0402_1005Metric":
          - generic: R_0402_1005Metric
        - cell "0402WGF2201TCE C25879 -55℃~+155℃ 2.2kΩ 50V 62.5mW Thick Film Resistor ±1% ±100ppm/℃ 0402 Chip Resistor - Surface Mount ROHS Search":
          - generic: 0402WGF2201TCE
          - generic: C25879
          - generic: "-55℃~+155℃ 2.2kΩ 50V 62.5mW Thick Film Resistor ±1% ±100ppm/℃ 0402 Chip Resistor - Surface Mount ROHS"
          - text: Search
        - cell:
          - checkbox [checked]
      - row "R11 120k R_0402_1005Metric 0402WGF1203TCE C25750 -55℃~+155℃ 120kΩ 50V 62.5mW Thick Film Resistor ±1% ±100ppm/℃ 0402 Chip Resistor - Surface Mount ROHS Search":
        - cell:
          - generic: 
        - cell
        - cell "R11":
          - generic: R11
        - cell "120k":
          - generic: 120k
        - cell "R_0402_1005Metric":
          - generic: R_0402_1005Metric
        - cell "0402WGF1203TCE C25750 -55℃~+155℃ 120kΩ 50V 62.5mW Thick Film Resistor ±1% ±100ppm/℃ 0402 Chip Resistor - Surface Mount ROHS Search":
          - generic: 0402WGF1203TCE
          - generic: C25750
          - generic: "-55℃~+155℃ 120kΩ 50V 62.5mW Thick Film Resistor ±1% ±100ppm/℃ 0402 Chip Resistor - Surface Mount ROHS"
          - text: Search
        - cell:
          - checkbox [checked]
      - row "R12 22k R_0402_1005Metric 0402WGF2202TCE C25768 -55℃~+155℃ 22kΩ 50V 62.5mW Thick Film Resistor ±1% ±100ppm/℃ 0402 Chip Resistor - Surface Mount ROHS Search":
        - cell:
          - generic: 
        - cell
        - cell "R12":
          - generic: R12
        - cell "22k":
          - generic: 22k
        - cell "R_0402_1005Metric":
          - generic: R_0402_1005Metric
        - cell "0402WGF2202TCE C25768 -55℃~+155℃ 22kΩ 50V 62.5mW Thick Film Resistor ±1% ±100ppm/℃ 0402 Chip Resistor - Surface Mount ROHS Search":
          - generic: 0402WGF2202TCE
          - generic: C25768
          - generic: "-55℃~+155℃ 22kΩ 50V 62.5mW Thick Film Resistor ±1% ±100ppm/℃ 0402 Chip Resistor - Surface Mount ROHS"
          - text: Search
        - cell:
          - checkbox [checked]
      - row "R13 100k R_0402_1005Metric 0402WGF1003TCE C25741 -55℃~+155℃ 100kΩ 50V 62.5mW Thick Film Resistor ±1% ±100ppm/℃ 0402 Chip Resistor - Surface Mount ROHS Search":
        - cell:
          - generic: 
        - cell
        - cell "R13":
          - generic: R13
        - cell "100k":
          - generic: 100k
        - cell "R_0402_1005Metric":
          - generic: R_0402_1005Metric
        - cell "0402WGF1003TCE C25741 -55℃~+155℃ 100kΩ 50V 62.5mW Thick Film Resistor ±1% ±100ppm/℃ 0402 Chip Resistor - Surface Mount ROHS Search":
          - generic: 0402WGF1003TCE
          - generic: C25741
          - generic: "-55℃~+155℃ 100kΩ 50V 62.5mW Thick Film Resistor ±1% ±100ppm/℃ 0402 Chip Resistor - Surface Mount ROHS"
          - text: Search
        - cell:
          - checkbox [checked]
      - row "R14 27k R_0402_1005Metric 0402WGF2702TCE C25771 -55℃~+155℃ 27kΩ 50V 62.5mW Thick Film Resistor ±1% ±100ppm/℃ 0402 Chip Resistor - Surface Mount ROHS Search":
        - cell:
          - generic: 
        - cell
        - cell "R14":
          - generic: R14
        - cell "27k":
          - generic: 27k
        - cell "R_0402_1005Metric":
          - generic: R_0402_1005Metric
        - cell "0402WGF2702TCE C25771 -55℃~+155℃ 27kΩ 50V 62.5mW Thick Film Resistor ±1% ±100ppm/℃ 0402 Chip Resistor - Surface Mount ROHS Search":
          - generic: 0402WGF2702TCE
          - generic: C25771
          - generic: "-55℃~+155℃ 27kΩ 50V 62.5mW Thick Film Resistor ±1% ±100ppm/℃ 0402 Chip Resistor - Surface Mount ROHS"
          - text: Search
        - cell:
          - checkbox [checked]
      - row "R15 27.4k R_0402_1005Metric 0402WGF2742TCE C26971 -55℃~+155℃ 27.4kΩ 50V 62.5mW Thick Film Resistor ±1% ±100ppm/℃ 0402 Chip Resistor - Surface Mount ROHS Search":
        - cell:
          - generic: 
        - cell
        - cell "R15":
          - generic: R15
        - cell "27.4k":
          - generic: 27.4k
        - cell "R_0402_1005Metric":
          - generic: R_0402_1005Metric
        - cell "0402WGF2742TCE C26971 -55℃~+155℃ 27.4kΩ 50V 62.5mW Thick Film Resistor ±1% ±100ppm/℃ 0402 Chip Resistor - Surface Mount ROHS Search":
          - generic: 0402WGF2742TCE
          - generic: C26971
          - generic: "-55℃~+155℃ 27.4kΩ 50V 62.5mW Thick Film Resistor ±1% ±100ppm/℃ 0402 Chip Resistor - Surface Mount ROHS"
          - text: Search
        - cell:
          - checkbox [checked]
      - row "R16 52.3k R_0402_1005Metric 0402WGF5232TCE C26982 -55℃~+155℃ 50V 52.3kΩ 62.5mW Thick Film Resistor ±1% ±100ppm/℃ 0402 Chip Resistor - Surface Mount ROHS Search":
        - cell:
          - generic: 
        - cell "R16":
          - generic: R16
        - cell
        - cell "52.3k":
          - generic: 52.3k
        - cell "R_0402_1005Metric":
          - generic: R_0402_1005Metric
        - cell "0402WGF5232TCE C26982 -55℃~+155℃ 50V 52.3kΩ 62.5mW Thick Film Resistor ±1% ±100ppm/℃ 0402 Chip Resistor - Surface Mount ROHS Search":
          - generic: 0402WGF5232TCE
          - generic: C26982
          - generic: "-55℃~+155℃ 50V 52.3kΩ 62.5mW Thick Film Resistor ±1% ±100ppm/℃ 0402 Chip Resistor - Surface Mount ROHS"
          - text: Search
        - cell:
          - checkbox [checked]
      - row "R18 21k R_0402_1005Metric 0402WGF2102TCE C25766 -55℃~+155℃ 21kΩ 50V 62.5mW Thick Film Resistor ±1% ±100ppm/℃ 0402 Chip Resistor - Surface Mount ROHS Search":
        - cell:
          - generic: 
        - cell "R18":
          - generic: R18
        - cell
        - cell "21k":
          - generic: 21k
        - cell "R_0402_1005Metric":
          - generic: R_0402_1005Metric
        - cell "0402WGF2102TCE C25766 -55℃~+155℃ 21kΩ 50V 62.5mW Thick Film Resistor ±1% ±100ppm/℃ 0402 Chip Resistor - Surface Mount ROHS Search":
          - generic: 0402WGF2102TCE
          - generic: C25766
          - generic: "-55℃~+155℃ 21kΩ 50V 62.5mW Thick Film Resistor ±1% ±100ppm/℃ 0402 Chip Resistor - Surface Mount ROHS"
          - text: Search
        - cell:
          - checkbox [checked]
      - row "R20,R21 5.1k R_0402_1005Metric 0402WGF5101TCE C25905 -55℃~+155℃ 5.1kΩ 50V 62.5mW Thick Film Resistor ±1% ±100ppm/℃ 0402 Chip Resistor - Surface Mount ROHS Search":
        - cell:
          - generic: 
        - cell
        - cell "R20,R21":
          - generic: R20,R21
        - cell "5.1k":
          - generic: 5.1k
        - cell "R_0402_1005Metric":
          - generic: R_0402_1005Metric
        - cell "0402WGF5101TCE C25905 -55℃~+155℃ 5.1kΩ 50V 62.5mW Thick Film Resistor ±1% ±100ppm/℃ 0402 Chip Resistor - Surface Mount ROHS Search":
          - generic: 0402WGF5101TCE
          - generic: C25905
          - generic: "-55℃~+155℃ 5.1kΩ 50V 62.5mW Thick Film Resistor ±1% ±100ppm/℃ 0402 Chip Resistor - Surface Mount ROHS"
          - text: Search
        - cell:
          - checkbox [checked]
      - row "SW1 BOOT SW-SMD_L3.9-W3.0-P4.45 TS-1088-AR02016 C720477 -30℃~+80℃ 1.6N 100,000 cycles 12V 2mm 3.9mm 3mm 50mA Black Round Button SMD(SMT) Tab SPST Surface Mount,Vertical Without Bracket SMD,4x3mm Tactile Switches ROHS Search":
        - cell:
          - generic: 
        - cell "SW1":
          - generic: SW1
        - cell
        - cell "BOOT":
          - generic: BOOT
        - cell "SW-SMD_L3.9-W3.0-P4.45":
          - generic: SW-SMD_L3.9-W3.0-P4.45
        - cell "TS-1088-AR02016 C720477 -30℃~+80℃ 1.6N 100,000 cycles 12V 2mm 3.9mm 3mm 50mA Black Round Button SMD(SMT) Tab SPST Surface Mount,Vertical Without Bracket SMD,4x3mm Tactile Switches ROHS Search":
          - generic: TS-1088-AR02016
          - generic: C720477
          - generic: "-30℃~+80℃ 1.6N 100,000 cycles 12V 2mm 3.9mm 3mm 50mA Black Round Button SMD(SMT) Tab SPST Surface Mount,Vertical Without Bracket SMD,4x3mm Tactile Switches ROHS"
          - text: Search
        - cell:
          - checkbox [checked]
      - row "U1 STM32F722RET6 LQFP-64_L10.0-W10.0-P0.50-LS12.0-BL STM32F722RET6 C118207 -40℃~+85℃ 1.7V~3.6V 12bit 12bit 216MHz 256KB 32 Bit 50 512KB ARM Cortex-M7 Built-in FLASH LQFP-64(10x10) Microcontrollers (MCU/MPU/SOC) ROHS Search":
        - cell:
          - generic: 
        - cell
        - cell "U1":
          - generic: U1
        - cell "STM32F722RET6":
          - generic: STM32F722RET6
        - cell "LQFP-64_L10.0-W10.0-P0.50-LS12.0-BL":
          - generic: LQFP-64_L10.0-W10.0-P0.50-LS12.0-BL
        - cell "STM32F722RET6 C118207 -40℃~+85℃ 1.7V~3.6V 12bit 12bit 216MHz 256KB 32 Bit 50 512KB ARM Cortex-M7 Built-in FLASH LQFP-64(10x10) Microcontrollers (MCU/MPU/SOC) ROHS Search":
          - generic: STM32F722RET6
          - generic: C118207
          - generic: "-40℃~+85℃ 1.7V~3.6V 12bit 12bit 216MHz 256KB 32 Bit 50 512KB ARM Cortex-M7 Built-in FLASH LQFP-64(10x10) Microcontrollers (MCU/MPU/SOC) ROHS"
          - text: Search
        - cell:
          - checkbox [checked]
      - row "U2 ICM-42688-P LGA-14_L3.0-W2.5-P0.50-TL ICM-42688-P C1850418 -40℃~+85℃ 1.71V~3.6V 16bit 2KB 7.5uA IMU (accelerometer + gyroscope) SPI、I2C X,Y,Z X,Y,Z ±16g ±2000dps Motion Event Detection, Synchronization, Timestamp Support LGA-14(2.5x3) Accelerometers ROHS Search":
        - cell:
          - generic: 
        - cell "U2":
          - generic: U2
        - cell
        - cell "ICM-42688-P":
          - generic: ICM-42688-P
        - cell "LGA-14_L3.0-W2.5-P0.50-TL":
          - generic: LGA-14_L3.0-W2.5-P0.50-TL
        - cell "ICM-42688-P C1850418 -40℃~+85℃ 1.71V~3.6V 16bit 2KB 7.5uA IMU (accelerometer + gyroscope) SPI、I2C X,Y,Z X,Y,Z ±16g ±2000dps Motion Event Detection, Synchronization, Timestamp Support LGA-14(2.5x3) Accelerometers ROHS Search":
          - generic: ICM-42688-P
          - generic: C1850418
          - generic: "-40℃~+85℃ 1.71V~3.6V 16bit 2KB 7.5uA IMU (accelerometer + gyroscope) SPI、I2C X,Y,Z X,Y,Z ±16g ±2000dps Motion Event Detection, Synchronization, Timestamp Support LGA-14(2.5x3) Accelerometers ROHS"
          - text: Search
        - cell:
          - checkbox [checked]
      - row "U3 DPS368XTSA1 LGA-8_L2.5-W2.0-P0.65-TR_DPS368 DPS368XTSA1 C3232508 -40℃~+85℃ 0.5pa/K 1.7V~3.6V 100pa 27.6ms 30Kpa~1.2bar 500nA 6pa I2C、SPI No VLGA-8(2x2.5) Pressure Sensors ROHS Search":
        - cell:
          - generic: 
        - cell "U3":
          - generic: U3
        - cell
        - cell "DPS368XTSA1":
          - generic: DPS368XTSA1
        - cell "LGA-8_L2.5-W2.0-P0.65-TR_DPS368":
          - generic: LGA-8_L2.5-W2.0-P0.65-TR_DPS368
        - cell "DPS368XTSA1 C3232508 -40℃~+85℃ 0.5pa/K 1.7V~3.6V 100pa 27.6ms 30Kpa~1.2bar 500nA 6pa I2C、SPI No VLGA-8(2x2.5) Pressure Sensors ROHS Search":
          - generic: DPS368XTSA1
          - generic: C3232508
          - generic: "-40℃~+85℃ 0.5pa/K 1.7V~3.6V 100pa 27.6ms 30Kpa~1.2bar 500nA 6pa I2C、SPI No VLGA-8(2x2.5) Pressure Sensors ROHS"
          - text: Search
        - cell:
          - checkbox [checked]
      - row "U4 W25N01GVZEIG WSON-8_L8.0-W6.10-P1.27-BL-EP W25N01GVZEIG C907680 -40℃~+85℃ 10 Years 100,000 cycles 104MHz 10uA 1Gbit 2.7V~3.6V 2ms 700us SPI WSON-8-EP(6x8) NAND FLASH ROHS Search":
        - cell:
          - generic: 
        - cell
        - cell "U4":
          - generic: U4
        - cell "W25N01GVZEIG":
          - generic: W25N01GVZEIG
        - cell "WSON-8_L8.0-W6.10-P1.27-BL-EP":
          - generic: WSON-8_L8.0-W6.10-P1.27-BL-EP
        - cell "W25N01GVZEIG C907680 -40℃~+85℃ 10 Years 100,000 cycles 104MHz 10uA 1Gbit 2.7V~3.6V 2ms 700us SPI WSON-8-EP(6x8) NAND FLASH ROHS Search":
          - generic: W25N01GVZEIG
          - generic: C907680
          - generic: "-40℃~+85℃ 10 Years 100,000 cycles 104MHz 10uA 1Gbit 2.7V~3.6V 2ms 700us SPI WSON-8-EP(6x8) NAND FLASH ROHS"
          - text: Search
        - cell:
          - checkbox [checked]
      - row "U5 TPS62130RGTR QFN-16_L3.0-W3.0-P0.50-TL-EP1.7 TPS62130RGTR C43590 -40℃~+85℃@(TA) 1 17uA 2.5MHz 3A 3V~17V 900mV~6V Adjustable Buck Buck Built-in Yes QFN-16-EP(3x3) DC-DC Converters ROHS Search":
        - cell:
          - generic: 
        - cell
        - cell "U5":
          - generic: U5
        - cell "TPS62130RGTR":
          - generic: TPS62130RGTR
        - cell "QFN-16_L3.0-W3.0-P0.50-TL-EP1.7":
          - generic: QFN-16_L3.0-W3.0-P0.50-TL-EP1.7
        - cell "TPS62130RGTR C43590 -40℃~+85℃@(TA) 1 17uA 2.5MHz 3A 3V~17V 900mV~6V Adjustable Buck Buck Built-in Yes QFN-16-EP(3x3) DC-DC Converters ROHS Search":
          - generic: TPS62130RGTR
          - generic: C43590
          - generic: "-40℃~+85℃@(TA) 1 17uA 2.5MHz 3A 3V~17V 900mV~6V Adjustable Buck Buck Built-in Yes QFN-16-EP(3x3) DC-DC Converters ROHS"
          - text: Search
        - cell:
          - checkbox [checked]
      - row "U7 USBLC6-2SC6 SOT-23-6_L2.9-W1.6-P0.95-LS2.8-BL USBLC6-2SC6 C7519 -40℃~+125℃ 150nA 17V 2 3.5pF 5.25V 5A 6V ESD IEC 61000-4-2 Unidirectional SOT-23-6L ESD and Surge Protection (TVS/ESD) ROHS Search":
        - cell:
          - generic: 
        - cell
        - cell "U7":
          - generic: U7
        - cell "USBLC6-2SC6":
          - generic: USBLC6-2SC6
        - cell "SOT-23-6_L2.9-W1.6-P0.95-LS2.8-BL":
          - generic: SOT-23-6_L2.9-W1.6-P0.95-LS2.8-BL
        - cell "USBLC6-2SC6 C7519 -40℃~+125℃ 150nA 17V 2 3.5pF 5.25V 5A 6V ESD IEC 61000-4-2 Unidirectional SOT-23-6L ESD and Surge Protection (TVS/ESD) ROHS Search":
          - generic: USBLC6-2SC6
          - generic: C7519
          - generic: "-40℃~+125℃ 150nA 17V 2 3.5pF 5.25V 5A 6V ESD IEC 61000-4-2 Unidirectional SOT-23-6L ESD and Surge Protection (TVS/ESD) ROHS"
          - text: Search
        - cell:
          - checkbox [checked]
      - row "U9 TPS2116DRLR SOT-583-8_L2.1-W1.6-P0.50-LS1.6-BL TPS2116DRLR C3235557 Operating status indication SOT-583 Power Management - Specialized ROHS Search":
        - cell:
          - generic: 
        - cell
        - cell "U9":
          - generic: U9
        - cell "TPS2116DRLR":
          - generic: TPS2116DRLR
        - cell "SOT-583-8_L2.1-W1.6-P0.50-LS1.6-BL":
          - generic: SOT-583-8_L2.1-W1.6-P0.50-LS1.6-BL
        - cell "TPS2116DRLR C3235557 Operating status indication SOT-583 Power Management - Specialized ROHS Search":
          - generic: TPS2116DRLR
          - generic: C3235557
          - generic: Operating status indication SOT-583 Power Management - Specialized ROHS
          - text: Search
        - cell:
          - checkbox [checked]
      - row "U10 TPS70933DBVR TPS70933DBVR_TI_DBV0005A TPS70933DBVR C89347 -40℃~+125℃@(Tj) 1 1.4uA 150mA 190uVrms 3.3V 30V 80dB@(10Hz) 960mV@(150mA) Fixed Positive Under Voltage Lockout、Over Current Protection、Over Temperature Protection、Enable SOT-23-5 Voltage Regulators - Linear, Low Drop Out (LDO) Regulators ROHS Search":
        - cell:
          - generic: 
        - cell "U10":
          - generic: U10
        - cell
        - cell "TPS70933DBVR":
          - generic: TPS70933DBVR
        - cell "TPS70933DBVR_TI_DBV0005A":
          - generic: TPS70933DBVR_TI_DBV0005A
        - cell "TPS70933DBVR C89347 -40℃~+125℃@(Tj) 1 1.4uA 150mA 190uVrms 3.3V 30V 80dB@(10Hz) 960mV@(150mA) Fixed Positive Under Voltage Lockout、Over Current Protection、Over Temperature Protection、Enable SOT-23-5 Voltage Regulators - Linear, Low Drop Out (LDO) Regulators ROHS Search":
          - generic: TPS70933DBVR
          - generic: C89347
          - generic: "-40℃~+125℃@(Tj) 1 1.4uA 150mA 190uVrms 3.3V 30V 80dB@(10Hz) 960mV@(150mA) Fixed Positive Under Voltage Lockout、Over Current Protection、Over Temperature Protection、Enable SOT-23-5 Voltage Regulators - Linear, Low Drop Out (LDO) Regulators ROHS"
          - text: Search
        - cell:
          - checkbox [checked]
      - row "U11,U12,U13,U15 SRV05-4 SOT-23-6_L2.9-W1.6-P0.95-LS2.8-BR SRV05-4.TCT C13612 -55℃~+125℃ 12A@8/20us 17.5V 300W@8/20us 3pF 5V 5uA 6V Four channels IEC 61000-4-2、IEC 61000-4-5、IEC 61000-4-4 TVS Unidirectional SOT-23-6L ESD and Surge Protection (TVS/ESD) ROHS Search":
        - cell:
          - generic: 
        - cell "U11,U12,U13,U15":
          - generic: U11,U12,U13,U15
        - cell
        - cell "SRV05-4":
          - generic: SRV05-4
        - cell "SOT-23-6_L2.9-W1.6-P0.95-LS2.8-BR":
          - generic: SOT-23-6_L2.9-W1.6-P0.95-LS2.8-BR
        - cell "SRV05-4.TCT C13612 -55℃~+125℃ 12A@8/20us 17.5V 300W@8/20us 3pF 5V 5uA 6V Four channels IEC 61000-4-2、IEC 61000-4-5、IEC 61000-4-4 TVS Unidirectional SOT-23-6L ESD and Surge Protection (TVS/ESD) ROHS Search":
          - generic: SRV05-4.TCT
          - generic: C13612
          - generic: "-55℃~+125℃ 12A@8/20us 17.5V 300W@8/20us 3pF 5V 5uA 6V Four channels IEC 61000-4-2、IEC 61000-4-5、IEC 61000-4-4 TVS Unidirectional SOT-23-6L ESD and Surge Protection (TVS/ESD) ROHS"
          - text: Search
        - cell:
          - checkbox [checked]
      - row "U14 TPS629210DRLR SOT-5X3-8_L2.1-W1.2-P0.50-LS1.6-BL_DRL0008A TPS629210DRLR C5219301 -40℃~+150℃ 1A 2.5MHz 3V~17V 400mV~5.5V 4uA Adjustable Buck Buck Built-in SOT-5x3(DRL)-8 DC-DC Converters ROHS Search":
        - cell:
          - generic: 
        - cell
        - cell "U14":
          - generic: U14
        - cell "TPS629210DRLR":
          - generic: TPS629210DRLR
        - cell "SOT-5X3-8_L2.1-W1.2-P0.50-LS1.6-BL_DRL0008A":
          - generic: SOT-5X3-8_L2.1-W1.2-P0.50-LS1.6-BL_DRL0008A
        - cell "TPS629210DRLR C5219301 -40℃~+150℃ 1A 2.5MHz 3V~17V 400mV~5.5V 4uA Adjustable Buck Buck Built-in SOT-5x3(DRL)-8 DC-DC Converters ROHS Search":
          - generic: TPS629210DRLR
          - generic: C5219301
          - generic: "-40℃~+150℃ 1A 2.5MHz 3V~17V 400mV~5.5V 4uA Adjustable Buck Buck Built-in SOT-5x3(DRL)-8 DC-DC Converters ROHS"
          - text: Search
        - cell:
          - checkbox [checked]
      - row "Y1 8MHz20pF CRYSTAL-SMD_4P-L3.2-W2.5-BL__NexusMain_Y1 3225 8M 20PF 10PPM C5181477 -40℃~+80℃ 20pF 8MHz ±10ppm ±30ppm SMD3225-4P Crystals ROHS Search":
        - cell:
          - generic: 
        - cell
        - cell "Y1":
          - generic: Y1
        - cell "8MHz20pF":
          - generic: 8MHz20pF
        - cell "CRYSTAL-SMD_4P-L3.2-W2.5-BL__NexusMain_Y1":
          - generic: CRYSTAL-SMD_4P-L3.2-W2.5-BL__NexusMain_Y1
        - cell "3225 8M 20PF 10PPM C5181477 -40℃~+80℃ 20pF 8MHz ±10ppm ±30ppm SMD3225-4P Crystals ROHS Search":
          - generic: 3225 8M 20PF 10PPM
          - generic: C5181477
          - generic: "-40℃~+80℃ 20pF 8MHz ±10ppm ±30ppm SMD3225-4P Crystals ROHS"
          - text: Search
        - cell:
          - checkbox [checked]
  - button "Next"
