chenguoming1/h743-controllers/nexus-style-fc/docs/validation/reviews/jlcdfm-main-stage36/smt-component-edge-top-sanitized.txt

Browser view, Title: "JLCDFM Viewer - Free Online PCB DFM Tool", URL: "[private JLC project]".
1 AXWebArea JLCDFM Viewer - Free Online PCB DFM Tool, URL: [private JLC project]
	2 container smt-ui-container
		259 container dfm-pdf
			260 container
				261 image
				262 text https://dfm.jlcdfm.com/
			263 text DFM analysis report_JLCDFM
			264 container
				265 text File name ：
			266 text nexus-style-fc-gerbers.zip
			267 container
				268 text Report generated at ：
			269 text 2026-10-16 01:03:13
			270 container
				271 text PCB layers ：
			272 text 6
			273 container
				274 text PCB size ：
			275 text 2.24x3.31cm
			276 container
				277 text Analyze project ：
			278 container
				279 checkbox (settable, integer) Description: PCB DFM, Value: 1
				280 text PCB DFM
				281 checkbox (settable, integer) Description: SMT DFM, Value: 1
				282 text SMT DFM
			283 image
			284 image
			285 image
			286 container
				287 text PCB DFM > Routing layer analysis
			288 table
				289 row
					290 cell
						291 text Analyze project
					292 cell
						293 text Analysis results
					294 cell
						295 text PCB screenshot
					296 cell
						297 text Layer distribution
					298 cell
						299 text Statistics
				300 row
					301 cell
						302 text Sharp trace corner
						303 text （ Check for sharp corners in traces ）
					304 cell
						305 text null
						306 text Warning
					307 cell
						308 text No
					309 cell
						310 text nexus-style-fc-B_Cu.gbl
						311 text nexus-style-fc-F_Cu.gtl
					312 cell
						313 text Danger ： 0
						314 text Warning ： 2
						315 text Good ： 0
				316 row
					317 cell
						318 text BGA pad
						319 text （ Check BGA pads on the board ）
					320 cell
						321 text No
					322 cell
						323 text No
					324 cell
						325 text No
					326 cell
						327 text Danger ： 0
						328 text Warning ： 0
						329 text Good ： 0
				330 row
					331 cell
						332 text Via placed within a pad
						333 text （ Check if there is a via placed within a pad ）
					334 cell
						335 text No
					336 cell
						337 text No
					338 cell
						339 text No
					340 cell
						341 text Danger ： 0
						342 text Warning ： 0
						343 text Good ： 0
				344 row
					345 cell
						346 text Trace to board edge
						347 text （ Detect traces too close to the board edge ）
					348 cell
						349 text No
					350 cell
						351 text No
					352 cell
						353 text No
					354 cell
						355 text Danger ： 0
						356 text Warning ： 0
						357 text Good ： 0
				358 row
					359 cell
						360 text Trace spacing
						361 text （ Measure spacing between adjacent parallel traces ）
					362 cell
						363 text 0.13mm
						364 text Warning
					365 cell
						366 text No
					367 cell
						368 text nexus-style-fc-B_Cu.gbl
						369 text nexus-style-fc-F_Cu.gtl
					370 cell
						371 text Danger ： 0
						372 text Warning ： 2
						373 text Good ： 3
				374 row
					375 cell
						376 text Unconnected trace end
						377 text （ Free-standing trace ends not connected to pads ）
					378 cell
						379 text No
					380 cell
						381 text No
					382 cell
						383 text No
					384 cell
						385 text Danger ： 0
						386 text Warning ： 0
						387 text Good ： 0
				388 row
					389 cell
						390 text Trace width
						391 text （ Trace width information ）
					392 cell
						393 text 0.13mm
						394 text Warning
					395 cell
						396 text No
					397 cell
						398 text nexus-style-fc-B_Cu.gbl
						399 text nexus-style-fc-F_Cu.gtl
					400 cell
						401 text Danger ： 0
						402 text Warning ： 86
						403 text Good ： 14
				404 row
					405 cell
						406 text Fiducial
						407 text （ Detect fiducial marks on the board ）
					408 cell
						409 text No
					410 cell
						411 text No
					412 cell
						413 text No
					414 cell
						415 text Danger ： 0
						416 text Warning ： 0
						417 text Good ： 0
				418 row
					419 cell
						420 text Pad to board edge
						421 text （ Measure distance of pads from the board edge ）
					422 cell
						423 text 0.25mm
						424 text Good
					425 cell
						426 text No
					427 cell
						428 text nexus-style-fc-B_Cu.gbl
						429 text nexus-style-fc-F_Cu.gtl
					430 cell
						431 text Danger ： 0
						432 text Warning ： 0
						433 text Good ： 55
				434 row
					435 cell
						436 text Pad spacing
						437 text （ Measure pad to pad spacing ）
					438 cell
						439 text 0.08mm
						440 text Danger
					441 cell
						442 text No
					443 cell
						444 text nexus-style-fc-B_Cu.gbl
						445 text nexus-style-fc-F_Cu.gtl
					446 cell
						447 text Danger ： 6
						448 text Warning ： 77
						449 text Good ： 17
				450 row
					451 cell
						452 text Plated through-hole to trace clearance
						453 text （ Measure clearance of plated through-holes to traces ）
					454 cell
						455 text 0.25mm
						456 text Good
					457 cell
						458 text No
					459 cell
						460 text nexus-style-fc-B_Cu.gbl
						461 text nexus-style-fc-F_Cu.gtl
					462 cell
						463 text Danger ： 0
						464 text Warning ： 0
						465 text Good ： 100
				466 row
					467 cell
						468 text Annular ring
						469 text （ Annular ring width of pads compared to holes ）
					470 cell
						471 text 0.12mm
						472 text Warning
					473 cell
						474 text No
					475 cell
						476 text nexus-style-fc-B_Cu.gbl
						477 text nexus-style-fc-F_Cu.gtl
					478 cell
						479 text Danger ： 0
						480 text Warning ： 100
						481 text Good ： 0
				482 row
					483 cell
						484 text tht to smd
						485 text （ Detect clearance of vias to pads ）
					486 cell
						487 text No
					488 cell
						489 text No
					490 cell
						491 text No
					492 cell
						493 text Danger ： 0
						494 text Warning ： 0
						495 text Good ： 0
				496 row
					497 cell
						498 text Via to pad
						499 text （ Detect clearance of vias to pads ）
					500 cell
						501 text 0mm
						502 text Danger
					503 cell
						504 text No
					505 cell
						506 text nexus-style-fc-B_Cu.gbl
						507 text nexus-style-fc-F_Cu.gtl
					508 cell
						509 text Danger ： 3
						510 text Warning ： 1
						511 text Good ： 7
			512 container
				513 text PCB DFM > Soldermask layer analysis
			514 table
				515 row
					516 cell
						517 text Analyze project
					518 cell
						519 text Analysis results
					520 cell
						521 text PCB screenshot
					522 cell
						523 text Layer distribution
					524 cell
						525 text Statistics
				526 row
					527 cell
						528 text Soldermask bridge
						529 text （ Detect distance between parallel soldermask opening edges ）
					530 cell
						531 text 0.2mm
						532 text Good
					533 cell
						534 text No
					535 cell
						536 text nexus-style-fc-F_Mask.gts
						537 text nexus-style-fc-B_Mask.gbs
					538 cell
						539 text Danger ： 0
						540 text Warning ： 0
						541 text Good ： 60
				542 row
					543 cell
						544 text Solder mask opening exposing trace
						545 text （ Detect clearance of solder mask openings to nearby traces ）
					546 cell
						547 text 0.13mm
						548 text Warning
					549 cell
						550 text No
					551 cell
						552 text nexus-style-fc-F_Mask.gts
						553 text nexus-style-fc-B_Mask.gbs
					554 cell
						555 text Danger ： 0
						556 text Warning ： 84
						557 text Good ： 4
				558 row
					559 cell
						560 text Soldermask opening with multiple segments
						561 text （ Check if solder mask openings are constructed from multiple geometric shapes ）
					562 cell
						563 text No
					564 cell
						565 text No
					566 cell
						567 text No
					568 cell
						569 text Danger ： 0
						570 text Warning ： 0
						571 text Good ： 0
				572 row
					573 cell
						574 text Negative soldermask expansion
						575 text （ Detect solder mask openings smaller than their corresponding pads ）
					576 cell
						577 text 0mm
						578 text Warning
					579 cell
						580 text No
					581 cell
						582 text nexus-style-fc-F_Mask.gts
						583 text nexus-style-fc-B_Mask.gbs
					584 cell
						585 text Danger ： 0
						586 text Warning ： 10
						587 text Good ： 0
			588 container
				589 text PCB DFM > Silkscreen layer analysis
			590 table
				591 row
					592 cell
						593 text Analyze project
					594 cell
						595 text Analysis results
					596 cell
						597 text PCB screenshot
					598 cell
						599 text Layer distribution
					600 cell
						601 text Statistics
				602 row
					603 cell
						604 text Silkscreen to pad
						605 text （ Detect clearance of silkscreen to pads ）
					606 cell
						607 text 0mm
						608 text Danger
					609 cell
						610 text No
					611 cell
						612 text nexus-style-fc-F_Silkscreen.gto
						613 text nexus-style-fc-B_Silkscreen.gbo
					614 cell
						615 text Danger ： 100
						616 text Warning ： 0
						617 text Good ： 0
				618 row
					619 cell
						620 text Silkscreen to hole
						621 text （ Detect clearance of silkscreen to holes ）
					622 cell
						623 text 0mm
						624 text Danger
					625 cell
						626 text No
					627 cell
						628 text nexus-style-fc-F_Silkscreen.gto
						629 text nexus-style-fc-B_Silkscreen.gbo
					630 cell
						631 text Danger ： 100
						632 text Warning ： 0
						633 text Good ： 0
				634 row
					635 cell
						636 text Silkscreen line width
						637 text （ Check silkscreen line width ）
					638 cell
						639 text 0.15mm
						640 text Warning
					641 cell
						642 text No
					643 cell
						644 text nexus-style-fc-F_Silkscreen.gto
						645 text nexus-style-fc-B_Silkscreen.gbo
					646 cell
						647 text Danger ： 0
						648 text Warning ： 44
						649 text Good ： 4
			650 container
				651 text PCB DFM > Drill layer analysis
			652 table
				653 row
					654 cell
						655 text Analyze project
					656 cell
						657 text Analysis results
					658 cell
						659 text PCB screenshot
					660 cell
						661 text Layer distribution
					662 cell
						663 text Statistics
				664 row
					665 cell
						666 text Unconnected via
						667 text （ Detect isolated unconnected vias ）
					668 cell
						669 text No
					670 cell
						671 text No
					672 cell
						673 text No
					674 cell
						675 text Danger ： 0
						676 text Warning ： 0
						677 text Good ： 0
				678 row
					679 cell
						680 text Missing plated through-hole
						681 text （ Detect top and bottom pads at the same location without plated through-holes ）
					682 cell
						683 text No
					684 cell
						685 text No
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
						993 text （ Detect misalignment of component through-hole pins to pad holes ）
					994 cell
						995 text No
					996 cell
						997 text No
					998 cell
						999 text No
					1000 cell
						1001 text Danger ： 0
						1002 text Warning ： 0
						1003 text Good ： 0
				1004 row
					1005 cell
						1006 text Component through-hole
						1007 text （ Detect misalignment of component through-hole pins to pad holes ）
					1008 cell
						1009 text No
					1010 cell
						1011 text No
					1012 cell
						1013 text No
					1014 cell
						1015 text Danger ： 0
						1016 text Warning ： 0
						1017 text Good ： 0
				1018 row
					1019 cell
						1020 text Component through-hole
						1021 text （ Detect misalignment of component through-hole pins to pad holes ）
					1022 cell
						1023 text No
					1024 cell
						1025 text No
					1026 cell
						1027 text No
					1028 cell
						1029 text Danger ： 0
						1030 text Warning ： 0
						1031 text Good ： 0
				1032 row
					1033 cell
						1034 text Missing hole for component pin
						1035 text （ Detect component through-hole pins without corresponding holes ）
					1036 cell
						1037 text No
					1038 cell
						1039 text No
					1040 cell
						1041 text No
					1042 cell
						1043 text Danger ： 0
						1044 text Warning ： 0
						1045 text Good ： 0
				1046 row
					1047 cell
						1048 text Lead area overlapping pad
						1049 text （ Detect insufficient overlap between component pins and pads ）
					1050 cell
						1051 text 0.02mm
						1052 text Danger
					1053 cell
						1054 text No
					1055 cell
						1056 text component_+_top
					1057 cell
						1058 text Danger ： 4
						1059 text Warning ： 0
						1060 text Good ： 0
		10 container
			11 image
			12 content list
				13 container Undo(Ctrl+Z)
				14 container Redo(Ctrl+Y)
				15 container Zoom in(A)
				16 container Zoom out(Z)
				17 container Fit selection
				18 container Fit window(K)
				1305 container Flip board(Shift+F)
				1306 container Rotate whole counterclockwise
				1307 container Rotate whole clockwise
				1308 container Rotate counterclockwise(Space)
				1309 container Individually rotate clockwise
				1310 container Mirror Y
				1311 container Mirror X
				1312 container 自动对齐
				1313 container Measure(Ctrl+M)
				1314 container Export analysis report
				1315 container Help Document
				1316 container Settings
		25 text nexus-style-fc-gerbers.zip
		3 text Units ：
		26 text Metric（cm/mm）
		4 container toggle
			1317 container
				1318 button PCB DFM
				1319 button SMT DFM
				1320 button DFM check
				1321 button BOM match
				1322 table
					1323 row
						1324 cell
							1325 text Analyze project
						1326 cell
							1327 text Statistics
						1328 cell
							1329 text Operation
				1330 text Component assembly analysis
				1331 table
					1332 row
						1333 cell
							1334 text Component through-hole
						1335 cell
							1336 text 0 ,   0 ,   0
						1337 cell
							1338 button (disabled) Details
					1339 row
						1340 cell
							1341 text Component collision warning
						1342 cell
							1343 text 0 ,   0 ,   3
						1344 cell
							1345 button Details
					1346 row
						1347 cell
							1348 text Component spacing
						1349 cell
							1350 text 0 ,   0 ,   100
						1351 cell
							1352 button Details
					1353 row
						1354 cell
							1355 text Component to board edge distance
						1356 cell
							1357 text 4 ,   7 ,   3
						1358 cell
							1359 button Details
					1360 row
						1361 cell
							1362 text Lead to hole distance
						1363 cell
							1364 text 10 ,   0 ,   0
						1365 cell
							1366 button Details
					1367 row
						1368 cell
							1369 text Component through-hole
						1370 cell
							1371 text 0 ,   7 ,   0
						1372 cell
							1373 button Details
					1374 row
						1375 cell
							1376 text Coponent pad spacing
						1377 cell
							1378 text 0 ,   0 ,   0
						1379 cell
							1380 button (disabled) Details
					1381 row
						1382 cell
							1383 text Component clipped by board outline
						1384 cell
							1385 text 0 ,   0 ,   0
						1386 cell
							1387 button (disabled) Details
					1388 row
						1389 cell
							1390 text Pin inner edge
						1391 cell
							1392 text 0 ,   0 ,   0
						1393 cell
							1394 button (disabled) Details
					1395 row
						1396 cell
							1397 text Pin left edge
						1398 cell
							1399 text 9 ,   0 ,   0
						1400 cell
							1401 button Details
					1402 row
						1403 cell
							1404 text Pin without pad
						1405 cell
							1406 text 1 ,   0 ,   0
						1407 cell
							1408 button Details
					1409 row
						1410 cell
							1411 text Pin outer edge
						1412 cell
							1413 text 2 ,   0 ,   0
						1414 cell
							1415 button Details
					1416 row
						1417 cell
							1418 text Pin right edge
						1419 cell
							1420 text 3 ,   0 ,   0
						1421 cell
							1422 button Details
					1423 row
						1424 cell
							1425 text Component through-hole
						1426 cell
							1427 text 0 ,   0 ,   0
						1428 cell
							1429 button (disabled) Details
					1430 row
						1431 cell
							1432 text Component through-hole
						1433 cell
							1434 text 0 ,   0 ,   0
						1435 cell
							1436 button (disabled) Details
					1437 row
						1438 cell
							1439 text Component through-hole
						1440 cell
							1441 text 0 ,   0 ,   0
						1442 cell
							1443 button (disabled) Details
					1444 row
						1445 cell
							1446 text Missing hole for component pin
						1447 cell
							1448 text 0 ,   0 ,   0
						1449 cell
							1450 button (disabled) Details
					1451 row
						1452 cell
							1453 text Lead area overlapping pad
						1454 cell
							1455 text 4 ,   0 ,   0
						1456 cell
							1457 button Details
		8 container
			1458 container
				1459 text Gerber
				1460 text Wireframe
				1461 text 2D
				1462 text 3D
				1463 text Top layer
				1464 text Bottom layer
			9 image smt-engine-canvas-dfm
			254 container loading-messager
				255 text Retrieving DFM data, please wait...
			1465 container loading-messager
				1466 text Loading components, please wait...
		256 container toggle
			257 container
				258 text Show layer controls
			1467 table
				1468 row
					1469 cell
						1470 text Edit
					1471 cell
						1472 text Content
			1473 container gerber
				1474 table
					1475 row
						1476 cell
							1477 text Pin marker
				1478 table
					1479 row
						1480 cell
							1481 text Orientation marker
				1482 table
					1483 row
						1484 cell
							1485 text Model designator
		1303 container loading-messager
			1304 text Exporting PDF, please wait...
		1486 container
			1487 text Component assembly analysis > Component to board edge distance
			1488 text Measure distance from component outline to the board edge Layer
			1489 container component_+_top
				1490 text ( 1 ,  3 ,  1 )
			1491 container component_+_bottom
				1492 text ( 3 ,  4 ,  2 )
			1493 table
				1494 row
					1495 cell
						1496 text No.
					1497 cell
						1498 pop up button (collapsed, settable) Value: All, Secondary Actions: Expand
							1499 menu
								1500 (selected) All
								1501 Good
								1502 Warning
								1503 Danger
					1504 cell
						1505 text Value
					1506 cell
						1507 text Object 1
					1508 cell
						1509 text Object 2
			1510 table
				1511 row
					1512 cell
						1513 text 1
					1514 cell
						1515 text Danger
					1516 cell
						1517 text 0.33mm
					1518 cell
						1519 text J2
					1520 cell
						1521 text r3.93701
				1522 row
					1523 cell
						1524 text 2
					1525 cell
						1526 text Warning
					1527 cell
						1528 text 0.58mm
					1529 cell
						1530 text J3
					1531 cell
						1532 text r3.93701
				1533 row
					1534 cell
						1535 text 3
					1536 cell
						1537 text Warning
					1538 cell
						1539 text 0.7mm
					1540 cell
						1541 text R22
					1542 cell
						1543 text r3.93701
				1544 row
					1545 cell
						1546 text 4
					1547 cell
						1548 text Warning
					1549 cell
						1550 text 0.8mm
					1551 cell
						1552 text C17
					1553 cell
						1554 text r3.93701
				1555 row
					1556 cell
						1557 text 5
					1558 cell
						1559 text Good
					1560 cell
						1561 text 0.85mm
					1562 cell
						1563 text J6
					1564 cell
						1565 text r3.93701
			1566 checkbox (settable, integer) Description: Smart layer display, Value: 1
			1567 checkbox (settable, integer) Description: Auto fit view, Value: 1
			1568 button First
			1569 button Previous
			1570 button Next
			1571 button Last
			1572 button All
			1573 text Components too close to the board edge risk colliding with assembly equipment. Alert value ：
			1574 text Danger
			1575 text Warning
			1576 text Good
			1577 text 0.51mm 0.81mm

The focused UI element is 1 AXWebArea JLCDFM Viewer - Free Online PCB DFM Tool, URL: [private JLC project]
