chenguoming1/h743-controllers/nexus-style-fc/routing-wip/2026-10-15/stage36-main-child-checkpoint/reviews/jlcdfm-main-stage36/bom-only-accepted-sanitized.txt

Browser view, Title: "JLCDFM Viewer - Free Online PCB DFM Tool", URL: "[private JLC project]".
0 AXWebArea JLCDFM Viewer - Free Online PCB DFM Tool, URL: [private JLC project]
	1 container
		2 text Bill of Materials Component Placements After uploading your BOM & CPL files, the JLCDFM tool can automatically match your bill of materials and provide access to the JLCPCB assembly parts library.
		10 text nexus-style-fc-bom-jlc.csv
		4 text Only accept XLS,XLSX,CSV. 
		5 link Description: View Sample BOM, Value: static.jlcpcb.com//video/Sample-BOM_JLCSMT.xlsx
		6 button Add CPL File
		7 text Pick&Place File, Only accept XLS,XLSX,CSV. 
		8 link Description: View Sample CPL, Value: static.jlcpcb.com//video/JLCSMT_Sample_CPL1.xlsx
		9 button (disabled) Process BOM & CPL

The focused UI element is 0 AXWebArea JLCDFM Viewer - Free Online PCB DFM Tool, URL: [private JLC project]
