chenguoming1/h743-controllers/nexus-style-fc/manufacturing/bom-header-board.csv

Designator | Value | Footprint | LCSC Part # | Quantity
J1 | Servo header 3x7 | NexusFC:Header_3x07_P2.54_Vertical_Servo | C32713294 | 1
K1,K3 | GND strip | NexusFC:ChildBoard_TabStrip_W6.0 |  | 2
K2 | VX strip | NexusFC:ChildBoard_TabStrip_W6.2 |  | 1
P1 | S1 tab pad | NexusFC:ChildBoard_TabPad_Sig |  | 1
P2 | S2 tab pad | NexusFC:ChildBoard_TabPad_Sig |  | 1
P3 | S3 tab pad | NexusFC:ChildBoard_TabPad_Sig |  | 1
P4 | TAIL tab pad | NexusFC:ChildBoard_TabPad_Sig |  | 1
P5 | ESC tab pad | NexusFC:ChildBoard_TabPad_Sig |  | 1
P6 | RPM tab pad | NexusFC:ChildBoard_TabPad_Sig |  | 1
P7 | SBUS tab pad | NexusFC:ChildBoard_TabPad_Sig |  | 1
T1 | GND tab pad | NexusFC:ChildBoard_TabPad_Pwr |  | 1
T2 | VX tab pad | NexusFC:ChildBoard_TabPad_Pwr |  | 1
