chenguoming1/h743-controllers/nexus-style-fc/manufacturing/bom-main.csv

Designator | Value | Footprint | LCSC Part # | Quantity
C1-C4,C7,C8,C10,C13,C16,C17,C20,C22,C29,C30 | 100nF | Capacitor_SMD:C_0402_1005Metric | C1525 | 14
C5,C9,C27 | 4.7uF | Capacitor_SMD:C_0603_1608Metric | C69335 | 3
C6,C18,C25 | 1uF | Capacitor_SMD:C_0402_1005Metric | C52923 | 3
C11,C12 | 30pF | Capacitor_SMD:C_0402_1005Metric | C1570 | 2
C14 | 2.2uF | Capacitor_SMD:C_0402_1005Metric | C12530 | 1
C15 | 10nF | Capacitor_SMD:C_0402_1005Metric | C15195 | 1
C19 | 2.2uF | Capacitor_SMD:C_0603_1608Metric | C23630 | 1
C21 | 10uF | Capacitor_SMD:C_0603_1608Metric | C96446 | 1
C23 | 3.3nF | Capacitor_SMD:C_0402_1005Metric | C26404 | 1
C24,C26 | 22uF | Capacitor_SMD:C_0805_2012Metric | C602037 | 2
C28 | 22uF | Capacitor_SMD:C_0603_1608Metric | C86295 | 1
D1 | LED1 yellow-green | NexusFC:LED0603-RD_GREEN | C965806 | 1
D2 | LED2 red | NexusFC:LED0603-RD_RED | C965799 | 1
D3 | Power LED blue | NexusFC:LED0603-RD_BLUE | C965807 | 1
D4 | SMF13A | NexusFC:SOD-123FL_L2.8-W1.8-LS3.6-RD | C353315 | 1
D5,D6 | B5819WS | NexusFC:SOD-323_L1.8-W1.3-LS2.5-RD | C22624 | 2
F1,F2 | 0.5A PTC | NexusFC:F0805 | C20978 | 2
J1 | Header child board | NexusFC:HeaderBoard_Joint |  | 1
J2 | DSM (UART1) | NexusFC:CONN-SMD_B3B-ZR-SM4-TF | C489717 | 1
J3 | A-CRSF (UART4) | NexusFC:CONN-SMD_4P-P1.25_BM04B-GHS-TBT-LF-SN | C161692 | 1
J4 | C (UART3) | NexusFC:CONN-SMD_4P-P1.25_BM04B-GHS-TBT-LF-SN | C161692 | 1
J5 | B (UART6) | NexusFC:CONN-SMD_4P-P1.25_BM04B-GHS-TBT-LF-SN | C161692 | 1
J6 | USB-C vertical | NexusFC:USB-C-SMD_TYPE-C-31-D-06 | C2689964 | 1
L1 | 2.2uH 3A | NexusFC:IND-SMD_L4.6-W4.1 | C142096 | 1
L2 | 2.2uH | NexusFC:IND-SMD_L2.0-W1.6 | C5291913 | 1
R1,R5,R8-R10,R17,R19 | 10k | Resistor_SMD:R_0402_1005Metric | C25744 | 7
R2-R4,R22 | 1k | Resistor_SMD:R_0402_1005Metric | C11702 | 4
R6,R7 | 2.2k | Resistor_SMD:R_0402_1005Metric | C25879 | 2
R11 | 120k | Resistor_SMD:R_0402_1005Metric | C25750 | 1
R12 | 22k | Resistor_SMD:R_0402_1005Metric | C25768 | 1
R13 | 100k | Resistor_SMD:R_0402_1005Metric | C25741 | 1
R14 | 27k | Resistor_SMD:R_0402_1005Metric | C25771 | 1
R15 | 27.4k | Resistor_SMD:R_0402_1005Metric | C26971 | 1
R16 | 52.3k | Resistor_SMD:R_0402_1005Metric | C26982 | 1
R18 | 21k | Resistor_SMD:R_0402_1005Metric | C25766 | 1
R20,R21 | 5.1k | Resistor_SMD:R_0402_1005Metric | C25905 | 2
SW1 | BOOT | NexusFC:SW-SMD_L3.9-W3.0-P4.45 | C720477 | 1
U1 | STM32F722RET6 | NexusFC:LQFP-64_L10.0-W10.0-P0.50-LS12.0-BL | C118207 | 1
U2 | ICM-42688-P | NexusFC:LGA-14_L3.0-W2.5-P0.50-TL | C1850418 | 1
U3 | DPS368XTSA1 | NexusFC:LGA-8_L2.5-W2.0-P0.65-TR_DPS368 | C3232508 | 1
U4 | W25N01GVZEIG | NexusFC:WSON-8_L8.0-W6.10-P1.27-BL-EP | C907680 | 1
U5 | TPS62130RGTR | NexusFC:QFN-16_L3.0-W3.0-P0.50-TL-EP1.7 | C43590 | 1
U7 | USBLC6-2SC6 | NexusFC:SOT-23-6_L2.9-W1.6-P0.95-LS2.8-BL | C7519 | 1
U9 | TPS2116DRLR | NexusFC:SOT-583-8_L2.1-W1.6-P0.50-LS1.6-BL | C3235557 | 1
U10 | TPS70933DBVR | NexusFC:SOT-23-5_L3.0-W1.7-P0.95-LS2.8-BL | C89347 | 1
U11-U13,U15 | SRV05-4 | NexusFC:SOT-23-6_L2.9-W1.6-P0.95-LS2.8-BR | C13612 | 4
U14 | TPS629210DRLR | NexusFC:SOT-5X3-8_L2.1-W1.2-P0.50-LS1.6-BL_DRL0008A | C5219301 | 1
Y1 | 8MHz 20pF | NexusFC:CRYSTAL-SMD_4P-L3.2-W2.5-BL | C5181477 | 1
