chenguoming1/h743-controllers/nexus-style-fc/routing-wip/2026-10-15/assembly-source-checkpoint/manufacturing-gates/pasted-contact-inventory.csv

via_uuid | net | x_mm | y_mm | drill_mm | land_mm | ref_pad | side | shape | local_size_mm | signed_source_gap_mm
c6b2be3c-7a31-443d-a979-07b36853d97f | 3V3 | 121.075 | 106.925 | 0.2 | 0.45 | C3.1 | B | roundrect | 0.56 x 0.62 | -0.08491937580730502
0681e911-2822-4e01-aad6-56e27edbf6d1 | GND | 119.975 | 116.375 | 0.2 | 0.45 | J3.6 | F | rect | 1.0 x 2.8 | -0.0549999999999983
097c5d92-2f36-4050-b22e-14c4f712950a | GND | 101.825 | 123.725 | 0.2 | 0.45 | J4.6 | F | rect | 1.0 x 2.8 | -0.1
25ba0288-a08d-4fc8-969d-e2de64ccd669 | GND | 119.975 | 122.375 | 0.2 | 0.45 | J5.5 | F | rect | 1.0 x 2.8 | -0.1
60a570d4-d180-4837-955a-c82a7043b5e1 | GND | 109.875 | 109.425 | 0.2 | 0.45 | C19.2 | F | roundrect | 0.9 x 0.95 | -0.17922620262885872
75531463-64bc-4739-9786-f6f8b5e46a18 | GND | 101.975 | 116.375 | 0.2 | 0.45 | J2.5 | F | rect | 2.5 x 1.4 | -0.1
75531463-64bc-4739-9786-f6f8b5e46a18 | GND | 101.975 | 116.375 | 0.2 | 0.45 | C24.2 | B | roundrect | 1.0 x 1.45 | -0.27499999999999714
8a84b298-a4a6-4e05-a1fc-469e5ca625b8 | GND | 112.875 | 112.075 | 0.2 | 0.45 | U2.10 | F | rect | 0.675 x 0.28 | -0.1
9f8ce822-f748-44e1-bd99-7bd276d97d9f | GND | 113.225 | 126.975 | 0.2 | 0.45 | R14.2 | B | roundrect | 0.54 x 0.64 | -0.15500000000000172
b96d95ce-3a93-4c15-98c1-3e21617b4956 | GND | 105.725 | 106.625 | 0.2 | 0.45 | U11.2 | F | rect | 1.1 x 0.6 | -0.1
c4b3b423-445a-49e6-94c7-60580fca053f | GND | 117.575 | 124.775 | 0.2 | 0.45 | C26.2 | F | roundrect | 1.0 x 1.45 | -0.015000000000006258
d30fd1f1-ea51-4879-afb4-cb5b48b11566 | GND | 112.825 | 109.975 | 0.2 | 0.45 | C9.2 | F | roundrect | 0.9 x 0.95 | -0.03999999999998921
de26675a-ecba-4fa3-966f-2bc38e53bb1f | GND | 102.675 | 108.225 | 0.2 | 0.45 | U5.17 | B | custom | 0.005 x 0.005 | -0.07501099999999782
d803b6e9-1234-4261-8866-0c7729f6f1ec | RPM | 109.775 | 118.025 | 0.2 | 0.45 | U1.16 | B | oval | 0.3 x 1.5 | -0.17500000000001137
2f0f2bad-7fd0-41f4-94b8-6cc583942404 | 3V3_SENS | 112.825 | 107.275 | 0.2 | 0.45 | U3.6 | F | rect | 0.6 x 0.4 | -0.1
5f46e9a4-f918-4841-852c-5aabd6a859b8 | SPI1_MISO | 109.975 | 111.575 | 0.2 | 0.45 | U2.1 | F | rect | 0.675 x 0.28 | -0.1
542bda53-3f22-4449-92e4-39e5cfb5d551 | I2C1_SCL | 120.125 | 114.075 | 0.2 | 0.45 | U1.61 | B | oval | 1.5 x 0.3 | -0.023615371546557046
