chenguoming1/h743-controllers/nexus-style-fc/docs/validation/reviews/r23-replacement-2026-10-18/jlc-order-remark.png

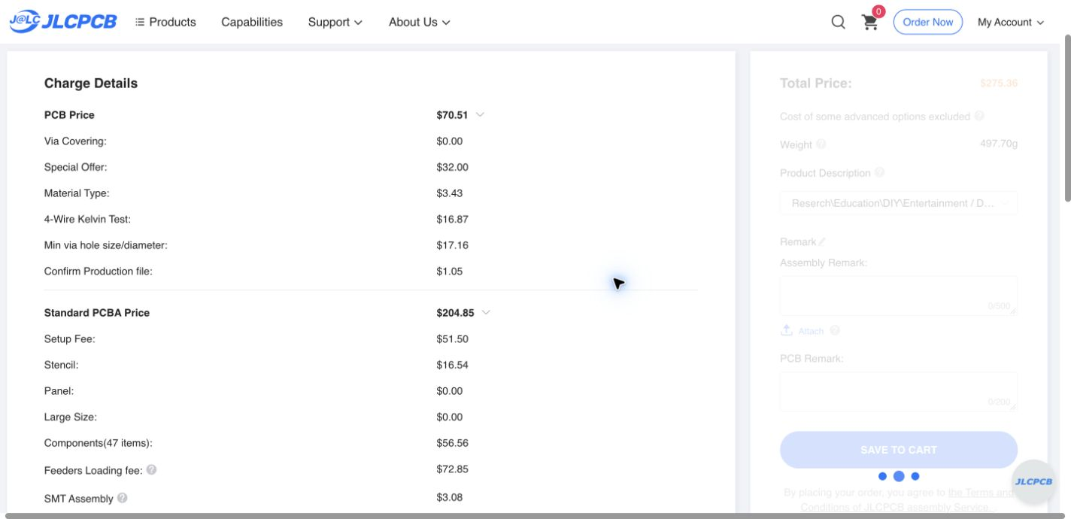
nexus-style-fc/docs/validation/reviews/r23-replacement-2026-10-18/jlc-order-remark.png
