chenguoming1/h743-controllers/nexus-style-fc/outputs/lcsc-bom-20261017/lcsc-bom-filled.png

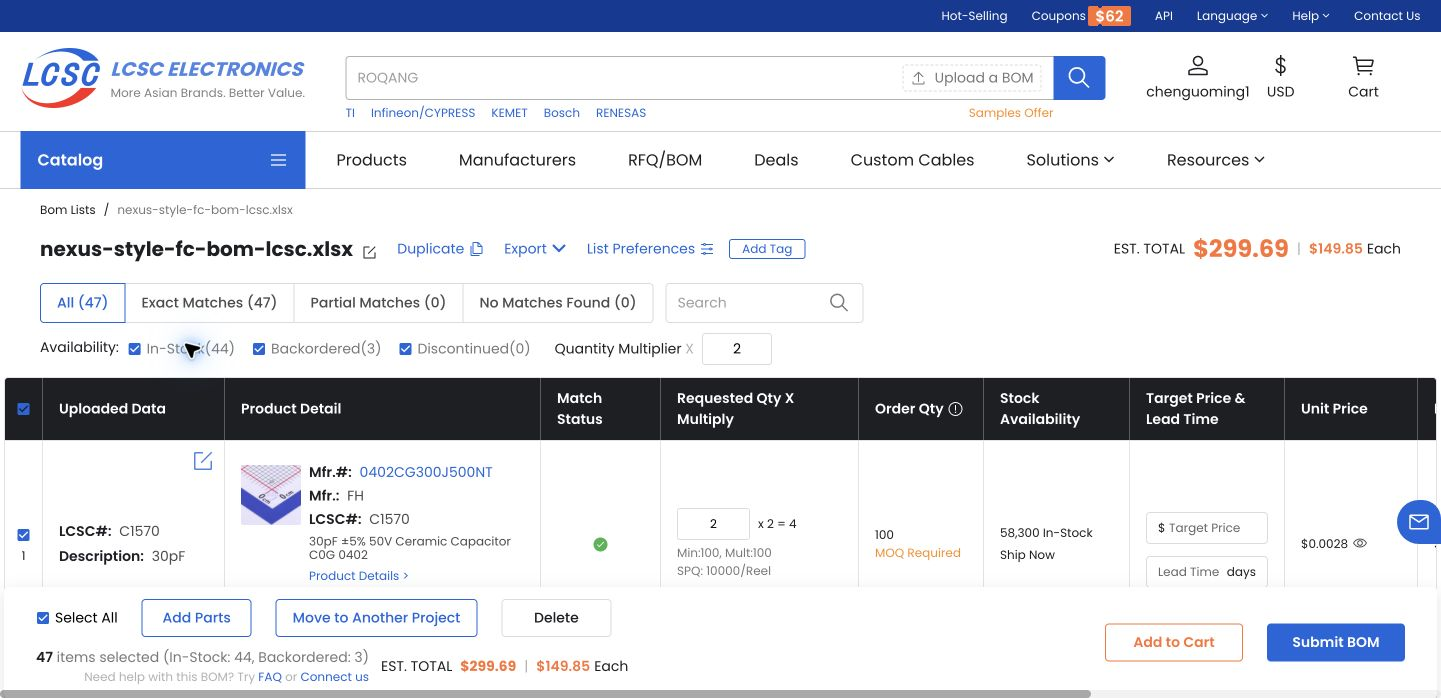
nexus-style-fc/outputs/lcsc-bom-20261017/lcsc-bom-filled.png
