chenguoming1/h743-controllers/nexus-style-fc/routing-wip/current/manufacturing-wip/README.md

# WIP review exports — not manufacturing release

These BOM/CPL files were regenerated with the exact reviewed main-only source selector and real native KiCad position export from PCB `ee1b9b1c814998b957b03777644b531f78b5301856c2a5eb823a6ef07c99059c`. C27/C31 are C602037; D5 is at its approved moved position. [Source binding](source-binding.json) and [full comparison](../../2026-10-15/input-caps-checkpoint/r62-input-cap-star/source-export-verification.json) are retained. No production Gerber/drill release is supplied here. Electrical, mechanical, assembly and process gates remain open. Do not submit these files for assembly.
