chenguoming1/h743-controllers/f722-heli/layout-revision/checkpoints/native0-rx-complete-v1-20261013/evidence/manufacturing/README.md

# Current host manufacturing identity check

The exact 61 selected source files pass the host text/identity audit. Counts are 156 footprints, 151 purchased parts, 144 SMT placements (65 top and 79 bottom), seven manual headers and five bare test points, with no DNP. There are 86 procurement groups and 79 SMT groups. Original source and result hashes are preserved in the adjacent normalized receipts.

Raw bottom-CPL expectations are U15 (27.7,-21.9), 90 degrees; R34 (29.65,-19.97), 90 degrees; R35 (29.2,-23.9), 180 degrees. These are audit expectations, not generated placement data. No bottom X mirror or guessed supplier angle correction is applied. Fresh exporter rotation must match the selected native orientation, followed by factory pin-1/polarity/pickup preview.

This host identity pass is not manufacturing acceptance. The official final receipt index and deliberately scoped review bindings remain incomplete. Existing native/parity/physical/refill evidence should be bound honestly rather than rerun just to recreate it. Fresh DC, local moved-part aperture/neighbor review, final mask/drill/CAM checks, connector fit and factory process/stack/tenting/USB-slot/panel acceptance remain open. Old assembly/export files do not apply to the moved geometry. No manufacturing export or heavy command ran for this receipt.
