chenguoming1/h743-controllers/self-balancing/history/BASELINE_NOT_FOR_FABRICATION.txt

P6 supersedes all earlier fabrication packages. P5 contained confirmed narrow copper joints. Any preserved baseline under reconstruction/ exists solely to reproduce and audit the corrected P6 source. Never fabricate it. Use only the current release/ files after the specified CAM selections and preassembly production-data approvals.
