chenguoming1/h743-controllers/nexus-style-fc/routing-wip/2026-10-15/assembly-source-checkpoint/manufacturing-gates/STAGE10-BINDING.md

# Source binding for the annotation successor

The review was written against stage08 PCB ccd8865f6785fd1cdec0214a08fe409faed4d47bb01e8474f09264ee36acab99.
The current PCB is 2099ceb9ff904859a68e288683ee68b2ad74d7741b8b670341baf67bf67e1ea3, schematic 7bfd6617e7d0285c738615fd2b6d7b6d6958675c095e50de87a8ed44111b972b.
The [exact physical comparison](../accepted/geometry-verification.json) proves all copper, pads, vias,
placements, net assignments, board geometry, stack and filled zones unchanged. Therefore the
reported process, electrical and mechanical limits remain applicable. Main advisories are now
11 centering, one mixed-technology type and 49 silk; child remains 11 courtyard and 11 footprint-filter.
The final native checks and source-consistent variants are in the accepted evidence. No new
fabrication or electrical qualification is implied by the annotation changes.
