chenguoming1/h743-controllers/self-balancing/native/review/smt-manufacturer-evidence/u2/corrected-cpl-smt-pin-left.txt

- text: 
- main:
  - list:
    - listitem "Undo(Ctrl+Z)"
    - listitem "Redo(Ctrl+Y)"
    - listitem "Zoom in(A)"
    - listitem "Zoom out(Z)"
    - listitem "Fit selection"
    - listitem "Fit window(K)"
    - listitem "Flip board(Shift+F)"
    - listitem "Rotate whole counterclockwise"
    - listitem "Rotate whole clockwise"
    - listitem "Rotate counterclockwise(Space)"
    - listitem "Individually rotate clockwise"
    - listitem "Mirror Y"
    - listitem "Mirror X"
    - listitem "自动对齐"
    - listitem "Measure(Ctrl+M)"
    - listitem "Export analysis report"
    - listitem "Help Document"
    - listitem "Settings"
  - generic "P2-Gerbers-For-Corrected-CPL-Review.zip"
  - generic: Units：
  - generic: Metric（cm/mm）
  - button "PCB DFM"
  - button "SMT DFM"
  - button "DFM check"
  - button "BOM match"
  - table:
    - rowgroup:
      - row "Analyze project Statistics Operation":
        - columnheader "Analyze project"
        - columnheader "Statistics"
        - columnheader "Operation"
  - generic: Component assembly analysis
  - table:
    - rowgroup:
      - row "Component through-hole 0, 0, 0 Details":
        - cell "Component through-hole"
        - cell "0, 0, 0"
        - cell "Details":
          - button "Details" [disabled]
      - row "Component collision warning 0, 0, 0 Details":
        - cell "Component collision warning"
        - cell "0, 0, 0"
        - cell "Details":
          - button "Details" [disabled]
      - row "Component spacing 0, 0, 100 Details":
        - cell "Component spacing"
        - cell "0, 0, 100"
        - cell "Details":
          - button "Details"
      - row "Component to board edge distance 1, 2, 0 Details":
        - cell "Component to board edge distance"
        - cell "1, 2, 0"
        - cell "Details":
          - button "Details"
      - row "Lead to hole distance 0, 0, 0 Details":
        - cell "Lead to hole distance"
        - cell "0, 0, 0"
        - cell "Details":
          - button "Details" [disabled]
      - row "Component through-hole 0, 1, 0 Details":
        - cell "Component through-hole"
        - cell "0, 1, 0"
        - cell "Details":
          - button "Details"
      - row "Coponent pad spacing 0, 0, 0 Details":
        - cell "Coponent pad spacing"
        - cell "0, 0, 0"
        - cell "Details":
          - button "Details" [disabled]
      - row "Component clipped by board outline 0, 1, 0 Details":
        - cell "Component clipped by board outline"
        - cell "0, 1, 0"
        - cell "Details":
          - button "Details"
      - row "Pin inner edge 10, 0, 0 Details":
        - cell "Pin inner edge"
        - cell "10, 0, 0"
        - cell "Details":
          - button "Details"
      - row "Pin left edge 6, 0, 0 Details":
        - cell "Pin left edge"
        - cell "6, 0, 0"
        - cell "Details":
          - button "Details" [active]
      - row "Pin without pad 0, 0, 0 Details":
        - cell "Pin without pad"
        - cell "0, 0, 0"
        - cell "Details":
          - button "Details" [disabled]
      - row "Pin outer edge 0, 0, 0 Details":
        - cell "Pin outer edge"
        - cell "0, 0, 0"
        - cell "Details":
          - button "Details" [disabled]
      - row "Pin right edge 6, 0, 0 Details":
        - cell "Pin right edge"
        - cell "6, 0, 0"
        - cell "Details":
          - button "Details"
      - row "Component through-hole 0, 0, 0 Details":
        - cell "Component through-hole"
        - cell "0, 0, 0"
        - cell "Details":
          - button "Details" [disabled]
      - row "Component through-hole 0, 0, 4 Details":
        - cell "Component through-hole"
        - cell "0, 0, 4"
        - cell "Details":
          - button "Details"
      - row "Component through-hole 0, 0, 0 Details":
        - cell "Component through-hole"
        - cell "0, 0, 0"
        - cell "Details":
          - button "Details" [disabled]
      - row "Missing hole for component pin 0, 0, 0 Details":
        - cell "Missing hole for component pin"
        - cell "0, 0, 0"
        - cell "Details":
          - button "Details" [disabled]
      - row "Lead area overlapping pad 2, 2, 0 Details":
        - cell "Lead area overlapping pad"
        - cell "2, 2, 0"
        - cell "Details":
          - button "Details"
  - generic "Close左侧栏"
  - generic "Gerber(5)": Gerber
  - generic "Gerber(6)": Wireframe
  - generic "2D(2)": 2D
  - generic "3D(3)": 3D
  - generic: Top layer
  - generic: Bottom layer
  - generic: Retrieving DFM data, please wait...
  - generic: Loading components, please wait...
  - generic "Close右侧栏"
  - generic: Show layer controls
  - table:
    - rowgroup:
      - row "Edit Content":
        - columnheader
        - columnheader "Edit"
        - columnheader "Content"
  - table:
    - rowgroup:
      - row "Pin marker":
        - cell
        - cell
        - cell "Pin marker"
  - table:
    - rowgroup:
      - row "Orientation marker":
        - cell
        - cell
        - cell "Orientation marker"
  - table:
    - rowgroup:
      - row "Model designator":
        - cell
        - cell
        - cell "Model designator"
  - generic: Component assembly analysis > Pin left edge
  - paragraph: Measure if component pin edges extend past pad edges
  - generic: Layer
  - generic "component_+_top": component_+_top (6, 0, 0)
  - table:
    - rowgroup:
      - row "No. All Value Object 1 Object 2":
        - columnheader "No."
        - columnheader "All":
          - combobox:
            - option "All" [selected]
            - option "Good"
            - option "Warning"
            - option "Danger"
        - columnheader "Value"
        - columnheader "Object 1"
        - columnheader "Object 2"
  - table:
    - rowgroup:
      - row "1 Danger 0mm U2 null":
        - cell "1"
        - cell "Danger"
        - cell "0mm"
        - cell "U2"
        - cell "null"
      - row "2 Danger 0mm U2 null":
        - cell "2"
        - cell "Danger"
        - cell "0mm"
        - cell "U2"
        - cell "null"
      - row "3 Danger 0mm U2 null":
        - cell "3"
        - cell "Danger"
        - cell "0mm"
        - cell "U2"
        - cell "null"
      - row "4 Danger 0mm U2 null":
        - cell "4"
        - cell "Danger"
        - cell "0mm"
        - cell "U2"
        - cell "null"
      - row "5 Danger 0.05mm D4 null":
        - cell "5"
        - cell "Danger"
        - cell "0.05mm"
        - cell "D4"
        - cell "null"
      - row "6 Danger 0.05mm D4 null":
        - cell "6"
        - cell "Danger"
        - cell "0.05mm"
        - cell "D4"
        - cell "null"
  - checkbox "Smart layer display" [checked]
  - text: Smart layer display
  - checkbox "Auto fit view" [checked]
  - text: Auto fit view
  - button "First"
  - button "Previous"
  - button "Next"
  - button "Last"
  - button "All"
  - generic "Checks if a pin's left edge extends past its corresponding pad edge, as this can affect solderability if excessive, unless by special design."
  - generic: Alert value：
  - generic: Danger
  - generic: Warning
  - generic: Good
  - text: 
