chenguoming1/h743-controllers/f722-heli/layout-revision/checkpoints/native0-rx-complete-v1-20261013/supplements/imu-cam-v1/cam/actual-cam/INTERNAL-WIP-NOT-FOR-FABRICATION.txt

INTERNAL WIP CAM REVIEW
Final release: false. Source frozen. No final receipt gate was invoked.
These files exist for internal inspection only. Not approved for fabrication, assembly, upload, ordering, production or flight.
No vendor rotation correction or process substitution is authorized.
