chenguoming1/h743-controllers/f722-heli/layout-revision/checkpoints/native0-rx-complete-v1-20261013/supplements/imu-cam-v1/cam/previews/INTERNAL-WIP-NOT-FOR-FABRICATION.txt

INTERNAL WIP CAM REVIEW: preview-only continuation. Final release false. Original drill verifier failure retained.
