chenguoming1/h743-controllers/self-balancing/native/review/smt-manufacturer-evidence/u2/per-pin-metrics.csv

pin | function | native_x_mm | native_y_mm | manufacturing_x_mm | manufacturing_y_mm | net | nominal_toe_mm | nominal_heel_mm | nominal_side_each_mm | nominal_intersection_mm2 | nominal_lead_overlap_ratio | maxlead_minbody_intersection_mm2 | maxlead_minbody_lead_overlap_ratio
1 | PGND | 4.1 | 10.05 | 4.1 | 27.95 | GND | 0.25 | 0.05 | 0.0 | 0.07498952 | 0.999860266 | 0.073323423 | 0.572839243
2 | VIN | 4.1 | 10.55 | 4.1 | 27.45 | VLOGIC_IN | 0.25 | 0.05 | 0.0 | 0.07498952 | 0.999860266 | 0.073323423 | 0.572839243
3 | EN | 4.1 | 11.05 | 4.1 | 26.95 | VLOGIC_IN | 0.25 | 0.05 | 0.0 | 0.07498952 | 0.999860266 | 0.073323423 | 0.572839243
4 | AGND | 4.1 | 11.55 | 4.1 | 26.45 | GND | 0.25 | 0.05 | 0.0 | 0.07498952 | 0.999860266 | 0.073323423 | 0.572839243
5 | FB | 6.0 | 11.55 | 6.0 | 26.45 | GND | 0.25 | 0.05 | 0.0 | 0.07498952 | 0.999860266 | 0.073323423 | 0.572839243
6 | VOS | 6.0 | 11.05 | 6.0 | 26.95 | 3V3_CORE | 0.25 | 0.05 | 0.0 | 0.07498952 | 0.999860266 | 0.073323423 | 0.572839243
7 | SW | 6.0 | 10.55 | 6.0 | 27.45 | /power/BUCK_SW | 0.25 | 0.05 | 0.0 | 0.07498952 | 0.999860266 | 0.073323423 | 0.572839243
8 | PG | 6.0 | 10.05 | 6.0 | 27.95 | unconnected-(U2-PG-Pad8) | 0.25 | 0.05 | 0.0 | 0.07498952 | 0.999860266 | 0.073323423 | 0.572839243
