chenguoming1/h743-controllers/self-balancing/native/review/smt-manufacturer-evidence/u11/dimension-cases.csv

D_mm | L_mm | b_mm | shape | intersection_mm2 | lead_area_mm2 | overlap_ratio | toe_mm | heel_mm | side_mm
7.9 | 0.45 | 0.35 | rectangular | 0.15750000000000006 | 0.1575 | 1.0000000000000004 | 0.125 | 0.07500000000000018 | 0.07500000000000001
7.9 | 0.45 | 0.35 | round_inner_assumption | 0.14435563750809383 | 0.14435563750809371 | 1.0000000000000007 | 0.125 | 0.07500000000000018 | 0.07500000000000001
7.9 | 0.45 | 0.4 | rectangular | 0.18000000000000008 | 0.18000000000000002 | 1.0000000000000002 | 0.125 | 0.07500000000000018 | 0.04999999999999999
7.9 | 0.45 | 0.4 | round_inner_assumption | 0.16283185307179587 | 0.16283185307179587 | 1.0 | 0.125 | 0.07500000000000018 | 0.04999999999999999
7.9 | 0.45 | 0.48 | rectangular | 0.2159995617222161 | 0.216 | 0.9999979709361857 | 0.125 | 0.07500000000000018 | 0.010000000000000009
7.9 | 0.45 | 0.48 | round_inner_assumption | 0.19127786842338595 | 0.19127786842338604 | 0.9999999999999996 | 0.125 | 0.07500000000000018 | 0.010000000000000009
7.9 | 0.5 | 0.35 | rectangular | 0.175 | 0.175 | 1.0 | 0.125 | 0.025000000000000355 | 0.07500000000000001
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
