chenguoming1/h743-controllers/b-rid/review/renders/assembled-bottom.png

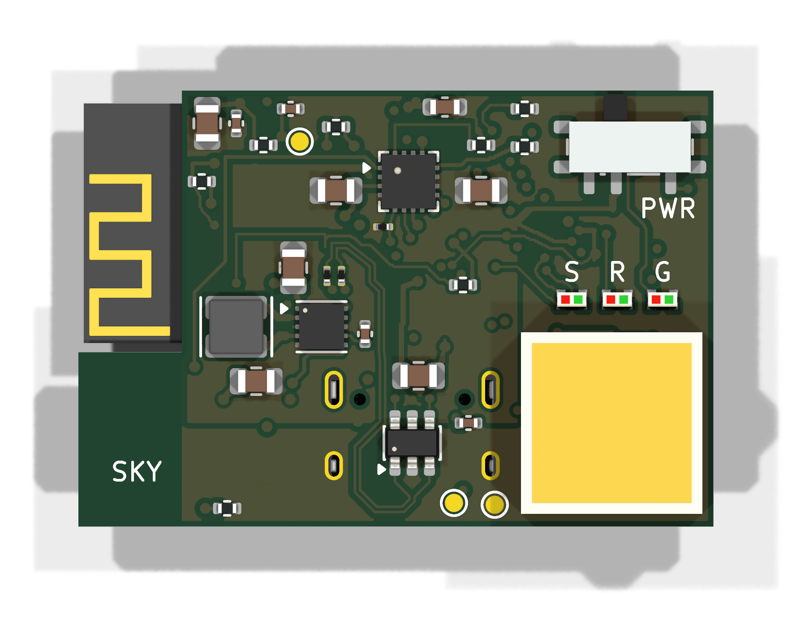
b-rid/review/renders/assembled-bottom.png
