chenguoming1/h743-controllers/b-rid/review/renders/assembled-top.png

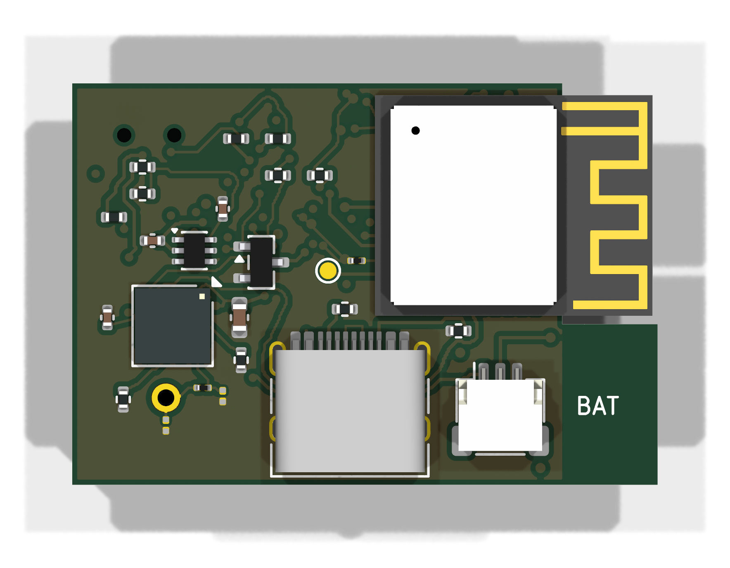
b-rid/review/renders/assembled-top.png
