chenguoming1/h743-controllers/nexus-style-fc/manufacturing/nexus-style-fc/IMPEDANCE-CONTROL.jpg

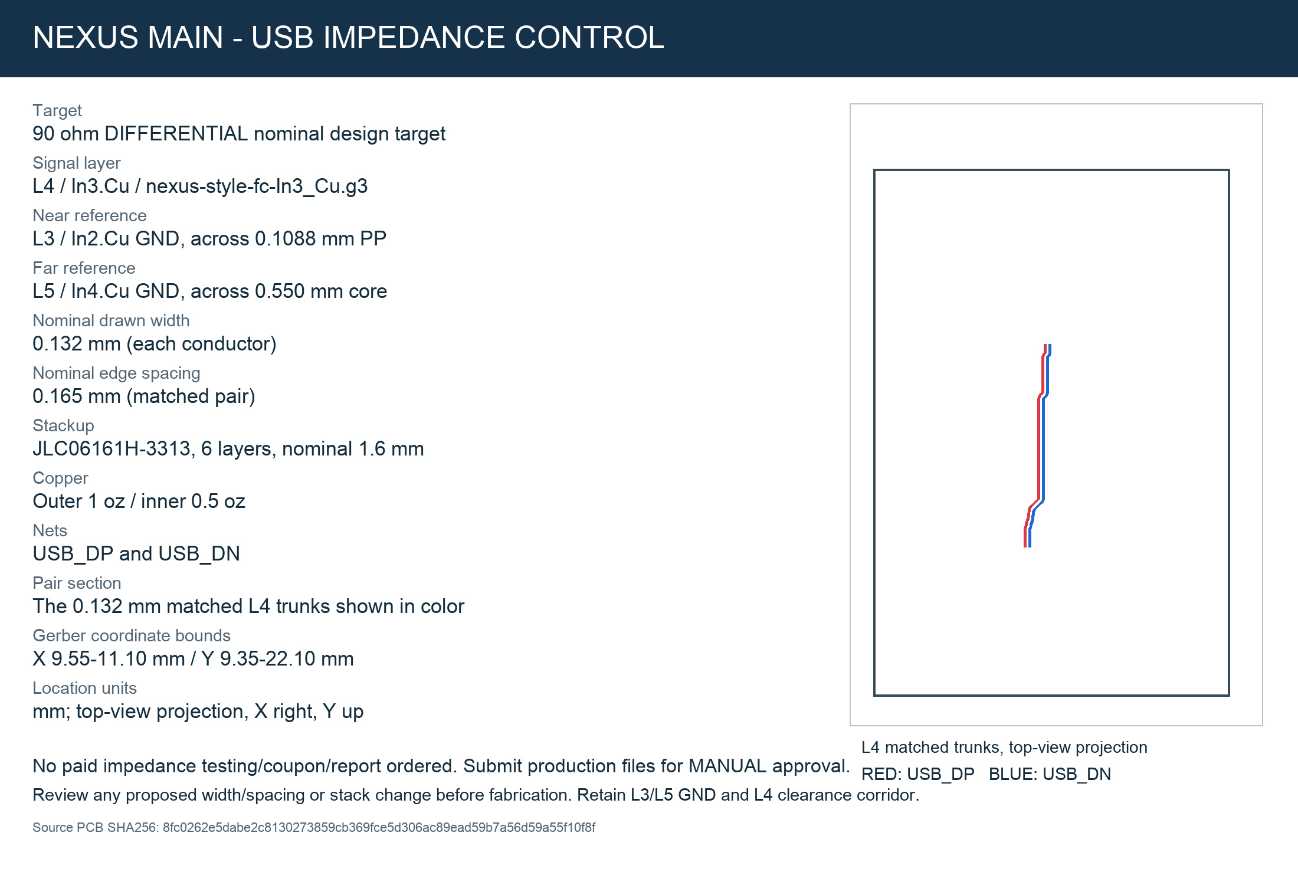
nexus-style-fc/manufacturing/nexus-style-fc/IMPEDANCE-CONTROL.jpg
