chenguoming1/h743-controllers/nexus-style-fc/routing-wip/2026-10-15/assembly-source-checkpoint/accepted/annotation-primary-evidence/datasheet-evidence/XL-1608SURC-06-page7.png

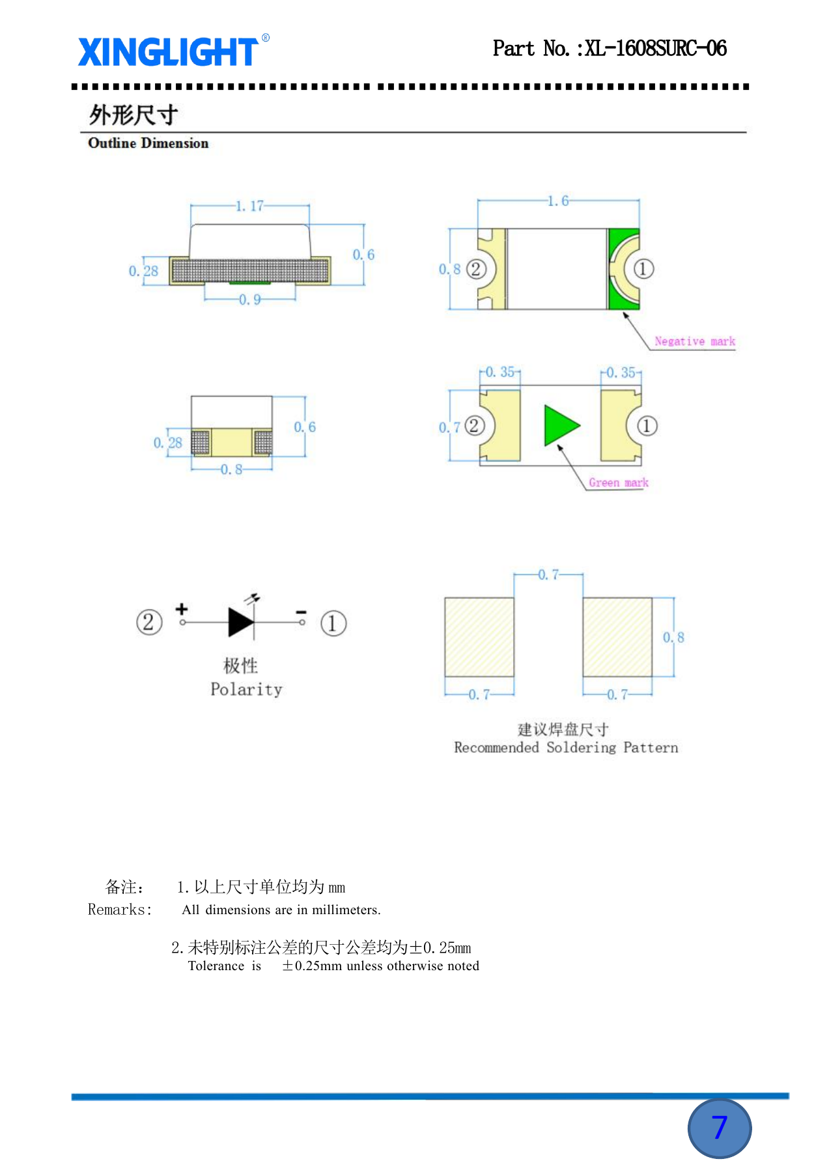
nexus-style-fc/routing-wip/2026-10-15/assembly-source-checkpoint/accepted/annotation-primary-evidence/datasheet-evidence/XL-1608SURC-06-page7.png
