chenguoming1/h743-controllers/nexus-style-fc/routing-wip/2026-10-15/input-caps-checkpoint/r62-input-cap-star/physical-assembly-evidence/D5-package-page.png

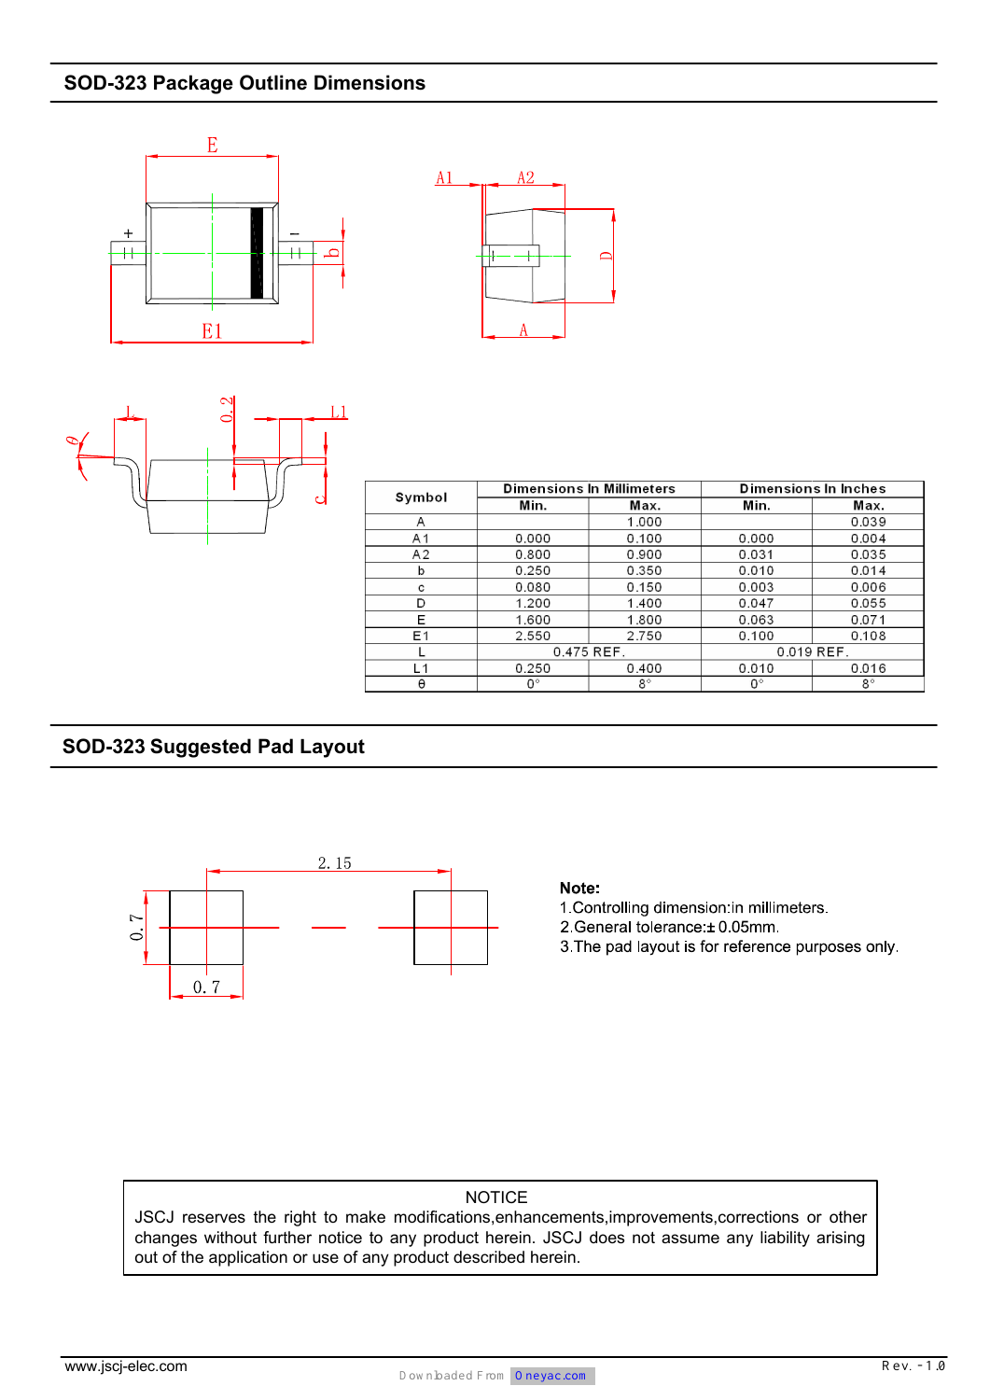
nexus-style-fc/routing-wip/2026-10-15/input-caps-checkpoint/r62-input-cap-star/physical-assembly-evidence/D5-package-page.png
