chenguoming1/h743-controllers/self-balancing/native/review/smt-manufacturer-evidence/split-window-diagnostic/overlap-details.jpg

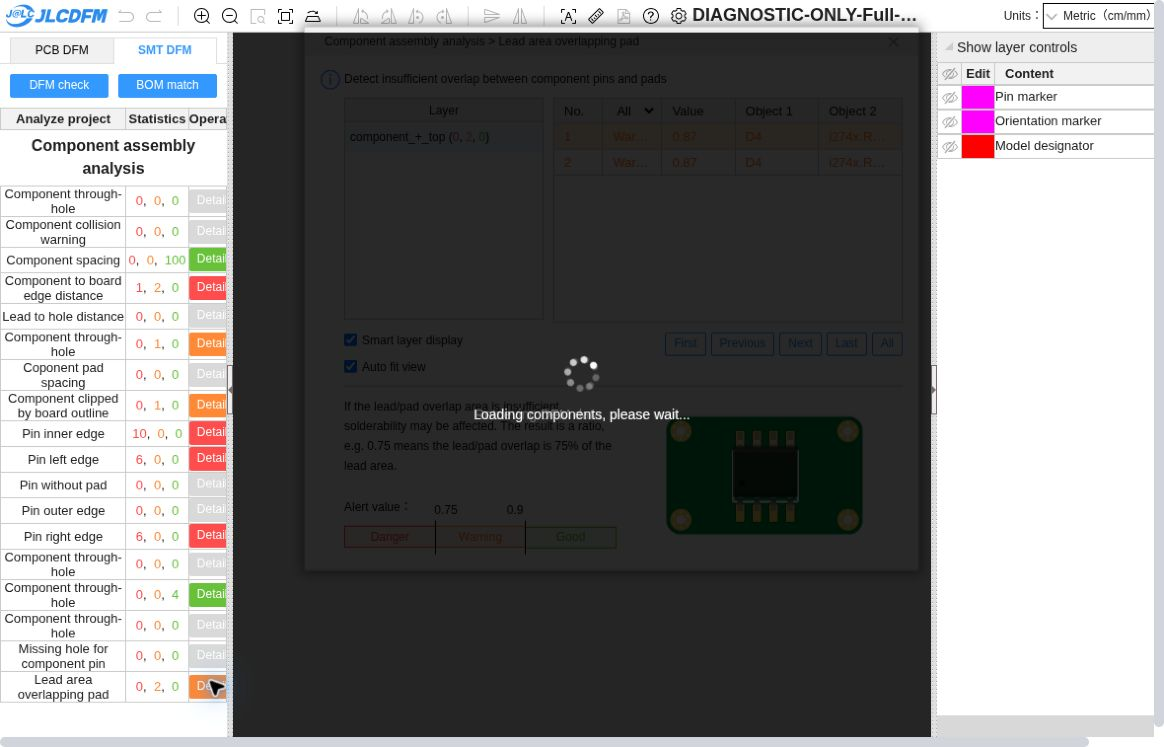
self-balancing/native/review/smt-manufacturer-evidence/split-window-diagnostic/overlap-details.jpg
