chenguoming1/h743-controllers/self-balancing/reconstruction/evidence/r140-before-after.png

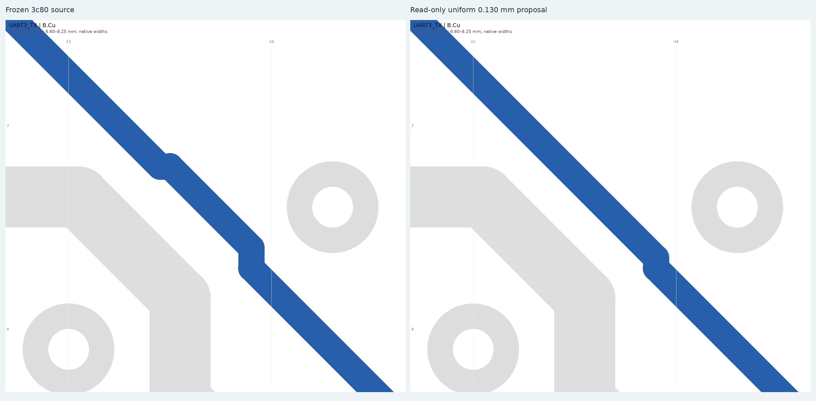
self-balancing/reconstruction/evidence/r140-before-after.png
