chenguoming1/h743-controllers/f722-heli/layout-revision/routing-tools/tests/checkpoint55/files/ordinary-routing/candidate55/README.md

# GREEN native checkpoint from accepted54

The board has13 opens, zero native errors and zero warnings. GREEN is complete, and all reconstructed DSM, ADC, flash support and A RX functions are restored. Remaining gaps are PORT_C5, BOOT2, RED1 and flash5. No C bank expansion or rotated flash cell is imported.

The exact transaction removes75 source copper objects and adds104 tracks and13 ordinary tented vias. R44 alone rotates180degrees at F(25.8,16.0); both actual net identities and its16.0k/0.1% value remain. Its new .25mm ground lead reaches an exclusive new tie at(25.08,15.78), with positive contacts to both saved ground planes. All other155 complete footprints and unrelated source copper remain exact.

Native DRC, parity, ERC, firmware, mechanical and process checks pass. All16 critical connectivity groups,208 finite new endpoints,28 supply/ground groups, seven changed signal groups, and all20 previously passing actual I/O cuts are preserved. Read entry-support-audit.json, native-coordinated-integration.json and the declared transform for the source-bound evidence.

Read checkpoint-limits.json before using this board. Critical copper is unchanged, but raw refill-reference deltas are nonzero and preserved. Ordinary as well as critical return changes require owner review. PC14 loading, DSM receive/startup behavior, analog/filter changes, transient/ESD behavior and fresh numerical power/VCAP remain unqualified. This is a sealed geometric checkpoint for review, not a release-ready board.
