chenguoming1/h743-controllers/f722-heli/layout-revision/routing-tools/tests/checkpoint44/files/ordinary-routing/candidate44/README.md

Candidate44: complete DSM MCU tree, 35 native opens

This isolated geometric WIP is based on accepted candidate43. It connects R38.2, U1.43 and R71.2 as one complete DSM_RX_MCU tree, retaining R71's original pose and supply feed. Five new tented 0.45/0.20 mm through-vias connect 0.127 mm signal tracks. All 156 footprints, existing signal copper, GND objects, outline and layer configuration remain exact.

Two +5V_BEC In3.Cu segments are explicitly replaced by three 0.60 mm segments. Their combined centerline length changes from 10.96701474974446 to 11.749648551717101 mm. Both full-width retained endpoint joins and the same twelve BEC pads are proved. The source/current construction receipt and logical route map identify every removed and added object. This is explicit native construction, with no claimed engine insertion or engine success.

Native normal, all-errors and strict schematic-parity DRC report 35 opens, zero errors and zero warnings. Process, unchanged-pose mechanical, parity, firmware and all sixteen existing critical connectivity checks pass. The complete endpoint/support audit passes twelve gates and twenty-two refusal controls: three strict finite pad entries, twenty-eight full-width joins, ten actual-annular entries, all sixty-four new track endpoints, all twenty-eight support partitions and one hundred other signal partitions. The actual D7 cut remains exact at 0.14813676113645813 mm outside-pad separation. Actual bonded I/O coverage remains 11/22 cases, 9/20 channels.

Both BARO trees remain complete, clean and cycle-free. The fresh 43-to-44 comparison retains unchanged critical copper but nonzero SCL/USB_N projection differences after refill. The fresh classifier proves every changed critical/I2C projection lies inside unchanged own-via windows. Exact centerline equality and strict actual-hole containment remain false, with four exact-predicate disagreements retained. Every numeric delta and region is preserved. This is a scoped location review, not unchanged-reference or electrical qualification.

Each GND plane loses 1.952988359542593 mm² and gains 0.00004889797809438874 mm² of represented copper. Final owner reference review remains required. Numerical power and VCAP applicability is stale because the BEC route and five drill holes change. Source43 numerical results are not inherited. I2C remains NOT_QUALIFIED; final material, loading, device timing and physical manufacturing/assembly validation remain pending.

The small added-geometry clearances are nominal CAD rule excesses, not fabrication tolerance allowances. The existing candidate43 margin-improvement hypothesis was not included. No fresh router model/zero replay was run during the owner's source43 power solve.

Reproduction starts with the exact paired candidate43 project, construct_dsm_tree44.used.py and complete-tree-proposal.json, plus the proposal's bound lightweight inputs. project-input-preservation.json binds all sixty unchanged non-board project files. The dsm44-audits script and source hash manifest reproduce the separate full-entry/support audit from exact paired native snapshots. The reference classifier accepts explicit board/snapshot/comparison hashes and retains its stronger historical refusal predicates. Native recovery and subsequent owner adoption are separate actions.
