chenguoming1/h743-controllers/f722-heli/layout-revision/routing-tools/tests/checkpoint48/files/ordinary-routing/candidate48/README.md

# Complete isolated ADC_BUS tree from candidate47

Native candidate:30 opens,0 errors,0 warnings; strict schematic parity and pairedERC0. Source f7d5731bb0bf1ad314aca6d507da004993671bce413fbdeba545083168e28161; candidate dcdd0e5655d098ceaffa7f40b6a21f1ca101429ac8eb142c50fa96df86697e68. Owner adoption is pending; this is geometric WIP, not manufacturing/flight qualification.

C31 keeps220nF/16V/X7R and its native0402 identity. It moves from B(14,24.1),0degrees to B(15.9,8),180degrees. Its ADC branch is4.283655mm, and the complete B.Cu C31-to-U1.10 path is6.798656mm with no barrel transition. Its0.25mm ground lead is1.379246mm to retained GNDvia(16.4252,7.0556); exact finite annulus/corridor entries to both saved ground planes pass. The old dedicated C31 ground track and via are removed only after proving no other non-plane attachment. R43 keeps16.0k/0.1percent and moves F(22.5,17.6)→(22.5,17.9),0degrees, opening the ADC portal. The other154 complete footprint structures remain exact. Native pose transforms, body/land/courtyard, mask/drill, header and manufacturing-process gates pass.

Twelve tracks and two tented0.45/0.20mm through-vias are added. Vias:(16.99,12.24) and(22,17.27). Tracks use F.Cu,B.Cu,In3.Cu, minimum0.127mm. All prior signal/supply copper is retained. Source47 SBUS/CORE/ADC_DIV repair and actual protection13/22 cases,11/20 channels remain intact. Native graphs connect C31.1,R42.2,R43.1,U1.10 as one complete net. Both I2C trees, all16 critical nets/returns and all28 support pad partitions pass.

Every one of24 new track endpoints has finite full-width pad, exact round-ended join or actual-annular proof. The retained ADC_DIV_MID tail into movedR43.2 has its own strict full-width entry. The retained ADC_BUS diagonal ends at an exact full-width join to the new vertical entry; its direct moved-pad section remains false in the composite receipt instead of being relabeled as a direct entry. Five refusal controls pass.

Reference copper is exactly identical. Raw BARO_SCL refill differences remain−4.3543590200201265e−7mm centerline and−2.63311599746352e−8mm² width area. The fresh source-bound classifier finds all changed critical projection geometry within unchanged own-via windows; exact missing-centerline equality and actual-hole containment remainfalse with2 boundary-predicate disagreements. No geometry normalization was applied. Whole-plane changes and new holes remain real and need current power/VCAP assessment.

The ADC-specific reference screen reports complete centerline coverage outside the two explicit own-via windows, with two In3 width-edge fragments totaling6.0864812525609e−5mm² outside them retained as a limitation. It does not claim complete full-width reference coverage or EMC qualification.

The conditional electrical screen preserves the divider gain0.32 and Thevenin impedance21.76kOhm. Nominal220nF filtering gives4.7872ms and33.246Hz. Pinned stock code uses480 ADC sample cycles and PCLK/8; at stock216MHz/PCLK2=108MHz, sampling is35.556us versus1.887us for the conservative datasheet sample-switch/source-resistance acquisition estimate. Effective capacitance over all corners, noise pickup, load/source switching, total ADC error and bench settling remain to be qualified. The51.35mm inner and56.09mm back-layer alternatives are diagnostic files only and are not used.

Primary sources: [ST DS11853 Rev9, ADC Table67/Equation1](https://www.st.com/resource/en/datasheet/stm32f722re.pdf); [pinned stock ADC source](https://github.com/rotorflight/rotorflight-firmware/blob/ba6c7e3e328b91a549bf6ca87c9eadd7006b6d94/src/main/drivers/adc_stm32f7xx.c). Actual values, source hashes and conditional parasitic sensitivity assumptions are in adc-electrical-screen.json. placement-detail.png was visually inspected and shows the actual native C31/R43 lands, routes and courtyards; owner fresh full-board previews remain required.
