chenguoming1/h743-controllers/f722-heli/layout-revision/routing-tools/tests/checkpoint49/files/ordinary-routing/candidate49/README.md

# PORT_A MCU native candidate

Complete source48 reconstruction closes PORT_A_TX_MCU and restores PORT_A_RX_MCU and ADC_BUS, leaving 29 native opens and zero geometric errors or warnings. Nineteen tracks and two ordinary tented vias replace six source tracks. All 156 complete footprint records, 558 pad records and existing vias are exact.

TX is 8.370079 mm; RX is 10.988722 mm including an 8.872218 mm In2 trunk. ADC capacitor branch is 4.448361 mm; C31-to-U1 is 6.963362 mm and the unchanged ground lead is 1.379246 mm. All new endpoints have finite pad, junction or annular entry. All 28 support graphs and both BARO trees remain complete.

Every changed/new track has complete saved-plane centerline and width projection outside its explicit own-via windows. Two prior ADC width gaps totaling 0.0000608648125 mm² remain exactly unchanged. The 16 prior critical nets remain complete and critical/BARO reference numeric deltas are exactly zero. No AC return, ADC functional, numerical power, manufacturing or flight qualification is claimed.

The final access report screens all 17 originally unresolved MCU pads and preserves the existing RPM portal. PORT_A external protected routes remain unfinished. This board contains no peer proposal geometry and awaits independent owner review; it is not adopted.
