chenguoming1/h743-controllers/f722-heli/layout-revision/routing-tools/tests/checkpoint54/files/ordinary-routing/candidate54/README.md

# Complete source14 ground-return successor

Candidate06 retains 14 opens with zero native errors or warnings. Board SHA-256: `24121b0e46d9a71207cd21e7cf599412c00796d48eb9af5f63ffcf92e5f2ca42`.

U12 now has its own local discharge lead and first plane tie; R51 has a separate new tie, and R52 uses C30's existing quiet return. All poses and non-GND objects are exact to sealed RPM14. Finite entries, 28 support groups, 21 complete signal groups, 20 actual I/O cuts, native process/pose/parity/ERC and all-signal projection checks pass. The prior SERVO15 and RPM14 seals and failed dedicated-R52 candidate05 remain unchanged.

Read conditional-support-review/NATIVE-GROUND-REVIEW.md and REPORT.md. The R52/C30 shared conductor's DC sensitivity is small under explicit assumptions, while ADC/ILM transients, ESD/common-plane coupling, AC returns and fresh loaded power remain unqualified. This is a sealed geometric prototype candidate pending owner adoption. Direct source14 and cumulative source52 exact transactions are included.
