chenguoming1/h743-controllers/f722-heli/layout-revision/routing-tools/tests/checkpoint55/files/ordinary-routing/candidate53/conditional-signal-review/Readme.txt

************************************************************************************
* @file     readme.txt                                                              
* @author   MCD Application Team                                                    
* @version  V3.0                                                                    
* @date     06-February-2017                                                          
* @brief    I/O Buffer Information Specification (IBIS) files for the STM32F7 MCUs.    
************************************************************************************
* COPYRIGHT(c) 2017 STMicroelectronics                                             
*                                                                                  
* Redistribution and use in source and binary forms, with or without modification, 
* are permitted provided that the following conditions are met:                    
*   1. Redistributions of source code must retain the above copyright notice,      
*      this list of conditions and the following disclaimer.                       
*   2. Redistributions in binary form must reproduce the above copyright notice,   
*      this list of conditions and the following disclaimer in the documentation  
*      and/or other materials provided with the distribution.                      
*   3. Neither the name of STMicroelectronics nor the names of its contributors    
*      may be used to endorse or promote products derived from this software       
*      without specific prior written permission.                                  
*                                                                                  
* THIS SOFTWARE IS PROVIDED BY THE COPYRIGHT HOLDERS AND CONTRIBUTORS "AS IS"      
* AND ANY EXPRESS OR IMPLIED WARRANTIES, INCLUDING, BUT NOT LIMITED TO, THE        
* IMPLIED WARRANTIES OF MERCHANTABILITY AND FITNESS FOR A PARTICULAR PURPOSE ARE   
* DISCLAIMED. IN NO EVENT SHALL THE COPYRIGHT HOLDER OR CONTRIBUTORS BE LIABLE     
* FOR ANY DIRECT, INDIRECT, INCIDENTAL, SPECIAL, EXEMPLARY, OR CONSEQUENTIAL       
* DAMAGES (INCLUDING, BUT NOT LIMITED TO, PROCUREMENT OF SUBSTITUTE GOODS OR       
* SERVICES; LOSS OF USE, DATA, OR PROFITS; OR BUSINESS INTERRUPTION) HOWEVER       
* CAUSED AND ON ANY THEORY OF LIABILITY, WHETHER IN CONTRACT, STRICT LIABILITY,    
* OR TORT (INCLUDING NEGLIGENCE OR OTHERWISE) ARISING IN ANY WAY OUT OF THE USE    
* OF THIS SOFTWARE, EVEN IF ADVISED OF THE POSSIBILITY OF SUCH DAMAGE.             
*************************************************************************************

===============================
IBIS files for STM32F7 devices:
===============================

The package contains :

   + IBIS Files for STM32F745_746_756 devices on different packages :

	  o LQFP208
	  o LQFP176
	  o LQFP144
	  o LQFP100
	  o TFBGA216
	  o UFBGA176
	  o WLCSP143

   + IBIS Files for STM32F765_767_777 devices on different packages :

	  o LQFP208
	  o LQFP176
	  o LQFP144
	  o LQFP100
	  o TFBGA216
	  o UFBGA176

   + IBIS Files for STM32F768A_778A_769_779 devices on different packages :

	  o LQFP208
	  o LQFP176
	  o TFBGA216
	  o WLCSP180

   + IBIS Files for STM32F7x2 devices on different packages :

	  o LQFP176
	  o LQFP144
	  o LQFP100
	  o LQFP64
	  o UFBGA176

   + IBIS Files for STM32F7x3 devices on different packages :

	  o LQFP176
	  o LQFP144
	  o UFBGA176
	  o UFBGA144
	  o WLCSP100

=========================
* V3.0 - 06 February 2017
=========================

New Features
************
    + Adding IBIS files for STM32F7x2 devices
    + Adding IBIS files for STM32F7x3 devices

======================
* V2.0 - 29 March 2016
======================

New Features
************
    + Adding IBIS files for STM32F765_767_777 devices
    + Adding IBIS files for STM32F768A_778A_769_779 devices

========================
* V1.0 - 24 June 2015 
========================
    + Created with IBIS files for STM32F745_746_756 devices

******************* (C) COPYRIGHT 2017 STMicroelectronics *****END OF FILE
