chenguoming1/h743-controllers/f722-heli/layout-revision/routing-tools/tests/checkpoint54/files/ordinary-routing/tests/rpm17/candidate01/README.md

# Complete additive RPM native14

Board73dbae05…69d6c7, on sealed SERVO15 board755545e8…c89eb. Owner adoption remains separate.

The complete R39.2→U13.6→U1.16 tree passes actual pad-cut protection. This transaction adds19 tracks and5 ordinary0.45/0.20mm tented vias, removes nothing, and retains all156 full footprints/558 pads and every source track/via. Native normal/all-track/parity DRC14 opens,0 errors,0 warnings; ERC/parity/firmware/process/mechanical and all16 critical connections pass. All38 new endpoints have finite entry/join proof. All28 support groups and all19 source passing actual protection cases survive; actual cases20/22.

Critical native records and per-net reference records are exactly equal, numeric deltas0 and lost-GND overlap with critical widths0. Ground planes change after refill. RPM centerline projection is complete outside explicit own-via windows, but one real In3 width-edge residue0.0000272513mm² remains beside the merged RPM/SERVO3 via hole. Raw width coverage remains false; no contour normalization or tolerance waiver is used.

RPM_MCU inventory is59.446075mm, including57.886227mm added. The conditional review binds Q1/R36/R39, native path inventory, five vias, exact return ties, assumed loading and pulse/edge distinctions. Two same-net midsegment via-land contacts mean the endpoint walk is not a unique shortest physical path. Unknown external driver/cable and unextracted nonlinear loading prevent electrical qualification. RPM/I2C electrical and fresh numerical power/VCAP qualification remain pending. See conditional-signal-review/RPM-electrical-review.md.
