chenguoming1/h743-controllers/nexus-style-fc/docs/validation/reviews/final-order-check-2026-10-17/smt-result.txt

Browser tab: 1926339707, Title: "JLCDFM Viewer - Free Online PCB DFM Tool", URL: "https://jlcdfm.com/viewer?pcbUploadFileId=634351113752236033".
1 AXWebArea JLCDFM Viewer - Free Online PCB DFM Tool, URL: jlcdfm.com/viewer?pcbUploadFileId=634351113752236033
	2 container smt-ui-container
		3 container
			4 image
			5 content list
				6 container Undo(Ctrl+Z)
				7 container Redo(Ctrl+Y)
				8 container Zoom in(A)
				9 container Zoom out(Z)
				10 container Fit selection
				11 container Fit window(K)
				257 container Flip board(Shift+F)
				258 container Rotate whole counterclockwise
				259 container Rotate whole clockwise
				260 container Rotate counterclockwise(Space)
				261 container Individually rotate clockwise
				262 container Mirror Y
				263 container Mirror X
				264 container 自动对齐
				265 container Measure(Ctrl+M)
				266 container Export analysis report
				267 container Help Document
				268 container Settings
		18 text nexus-style-fc-gerbers.zip
		19 text Units ：
		20 text Metric（cm/mm）
		21 container toggle
			269 container
				270 button PCB DFM
				271 button SMT DFM
				272 button DFM check
				273 button BOM match
				274 table
					275 row
						276 cell
							277 text Analyze project
						278 cell
							279 text Statistics
						280 cell
							281 text Operation
				282 text Component assembly analysis
				283 table
					284 row
						285 cell
							286 text Component through-hole
						287 cell
							288 text 0 ,   0 ,   0
						289 cell
							290 button (disabled) Details
					291 row
						292 cell
							293 text Component collision warning
						294 cell
							295 text 0 ,   0 ,   3
						296 cell
							297 button Details
					298 row
						299 cell
							300 text Component spacing
						301 cell
							302 text 0 ,   0 ,   100
						303 cell
							304 button Details
					305 row
						306 cell
							307 text Component to board edge distance
						308 cell
							309 text 4 ,   7 ,   4
						310 cell
							311 button Details
					312 row
						313 cell
							314 text Lead to hole distance
						315 cell
							316 text 11 ,   0 ,   0
						317 cell
							318 button Details
					319 row
						320 cell
							321 text Component through-hole
						322 cell
							323 text 0 ,   6 ,   0
						324 cell
							325 button Details
					326 row
						327 cell
							328 text Coponent pad spacing
						329 cell
							330 text 0 ,   0 ,   0
						331 cell
							332 button (disabled) Details
					333 row
						334 cell
							335 text Component clipped by board outline
						336 cell
							337 text 0 ,   0 ,   0
						338 cell
							339 button (disabled) Details
					340 row
						341 cell
							342 text Pin inner edge
						343 cell
							344 text 0 ,   0 ,   0
						345 cell
							346 button (disabled) Details
					347 row
						348 cell
							349 text Pin left edge
						350 cell
							351 text 8 ,   0 ,   0
						352 cell
							353 button Details
					354 row
						355 cell
							356 text Pin without pad
						357 cell
							358 text 0 ,   0 ,   0
						359 cell
							360 button (disabled) Details
					361 row
						362 cell
							363 text Pin outer edge
						364 cell
							365 text 0 ,   0 ,   0
						366 cell
							367 button (disabled) Details
					368 row
						369 cell
							370 text Pin right edge
						371 cell
							372 text 2 ,   0 ,   0
						373 cell
							374 button Details
					375 row
						376 cell
							377 text Component through-hole
						378 cell
							379 text 0 ,   0 ,   0
						380 cell
							381 button (disabled) Details
					382 row
						383 cell
							384 text Component through-hole
						385 cell
							386 text 0 ,   0 ,   0
						387 cell
							388 button (disabled) Details
					389 row
						390 cell
							391 text Component through-hole
						392 cell
							393 text 0 ,   0 ,   0
						394 cell
							395 button (disabled) Details
					396 row
						397 cell
							398 text Missing hole for component pin
						399 cell
							400 text 0 ,   0 ,   0
						401 cell
							402 button (disabled) Details
					403 row
						404 cell
							405 text Lead area overlapping pad
						406 cell
							407 text 0 ,   0 ,   0
						408 cell
							409 button (disabled) Details
		443 container
			444 container
				445 text Gerber
				446 text Wireframe
				447 text 2D
				448 text 3D
			449 container
				450 text Top layer Bottom layer
			451 image smt-engine-canvas-dfm
		254 container toggle
			255 container
				256 text Show layer controls
			421 table
				422 row
					423 cell
						424 text Edit
					425 cell
						426 text Content
			427 container gerber
				428 table
					429 row
						430 cell
							431 text Pin marker
				432 table
					433 row
						434 cell
							435 text Orientation marker
				436 table
					437 row
						438 cell
							439 text Model designator
			452 text X: 8.63mm
			453 text Y: 13.98mm

The focused UI element is 451 image smt-engine-canvas-dfm
