chenguoming1/h743-controllers/nexus-style-fc/docs/validation/reviews/solder-mask-2026-10-17/verification-checks.txt

PASS: Native adopted-board KiCad 10.0.6 DRC: zero copper violations, zero opens; ten identical inherited schematic parity warnings.
PASS: Strict PCB scope verification: pad copper geometry, vias, arcs, inner routing, zone definitions, outline, stack and unrelated source records preserved.
PASS: All outer tracks >= 0.14 mm; documented 0.757 mm VX_SENSE ADC neck only width reduction.
PASS: Fresh JLCDFM mask clearance 0/2/95, negative expansion 0/5/0; pad spacing, width, trace spacing, sharp corners and mask bridges remain free of danger/warnings.
PASS: Exact screened 16-member CAM ZIP and all loose CAM members copied without re-export; BOM byte-identical, CPL only C9/C11 X changes.
PASS: Main source/CAM SHA-256 bindings and unchanged child/schematic/project verified.
CSV files retain their existing CRLF convention; whitespace verification uses git core.whitespace cr-at-eol.
