chenguoming1/h743-controllers/nexus-style-fc/docs/validation/reviews/pad-spacing-2026-10-17/REVIEW.md

# Pad-spacing correction

The [fresh JLCDFM PCB check](https://jlcdfm.com/viewer?pcbUploadFileId=634296846603776002) reports **pad spacing: 0 danger, 0 warnings, 100 Good**, compared with 4 danger / 69 warnings / 27 Good on the incoming PCB. Trace width, trace spacing and sharp corners remain green. The website caps displayed results; the full native geometry and copper checks are recorded independently.

The correction moves 121 of 227 vias and adjusts connected traces on the relevant copper layers. Via count, drill sizes, diameters, layer spans and net assignments are unchanged. Most moves are local; the A_TX layer transition was relocated by about 2.584 mm to escape a gap between the fixed header and MCU pad fields. Its previous route detour was removed: total A_TX trace length decreases from 15.466 to 12.814 mm. Native connectivity remains complete.

Five component positions change while their pad geometry, identities, sides and orientations remain unchanged:

| Component | Native X change | Native Y change |
| --- | ---: | ---: |
| C31 | 0 | -0.025 mm |
| R20 | +0.025 mm | 0 |
| R21 | +0.025 mm | 0 |
| U10 | 0 | +0.025 mm |
| Y1 | 0 | +0.030 mm |

The small crystal shift opens the B_TX via gap beside the MCU. The LDO adjustment clears its pad-to-via gap; C31 and the USB resistors open their local spacing. Every other footprint, including all header/mating geometry, is preserved exactly. The child is unchanged. The [geometry verification](geometry-verification.json), [full copper diff](final-copper-diff.json), [component moves](component-moves.json) and [net route metrics](net-route-metrics.json) record the complete scope. Existing track widths, layers and net assignments are unchanged; all outer tracks remain at least 0.14 mm. The outline, stack, keepout/zone definitions, rules, schematic and project are unchanged. No DRC exclusions or clearance relaxations were added.

Final native KiCad 10.0.6 [DRC](drc.json): **zero copper violations, zero unconnected items**. The ten inherited schematic footprint-parity warnings have identical types, descriptions and UUIDs; only Y1's warning coordinates follow its position shift. Zone fills were refreshed with matching native project/rules.

The exact 16-member Gerber/drill/job ZIP screened on the website was copied to manufacturing. The 51-group BOM is byte-identical. The 83-placement CPL was regenerated; [only the five expected coordinate rows change](cpl-position-changes.json), with all rotations/sides/reference coverage preserved. SMT was not rerun for this copper/placement revision.
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
