chenguoming1/h743-controllers/f722-heli/manufacturing/verification/native-export-contact-sheet.png

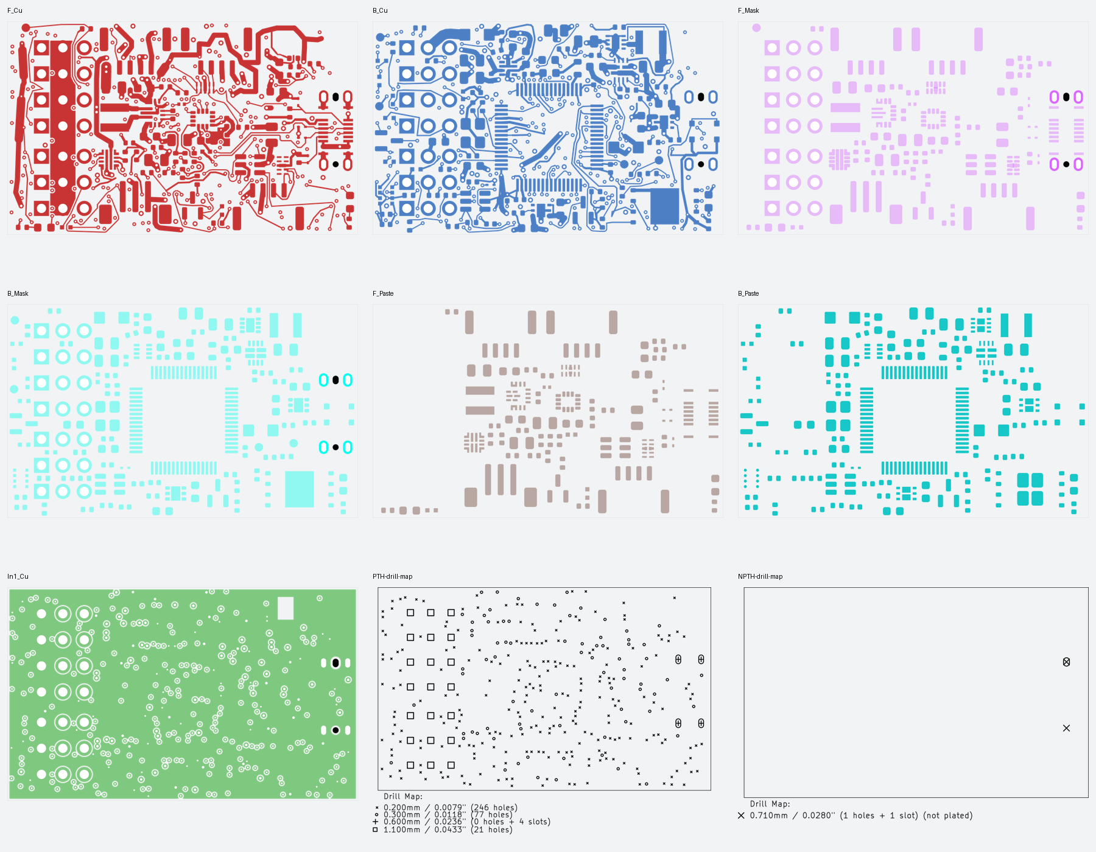
f722-heli/manufacturing/verification/native-export-contact-sheet.png
