chenguoming1/h743-controllers/nexus-style-fc/docs/validation/child-b49ef410/verification/power/v2-GND-saved-copper-screen.png

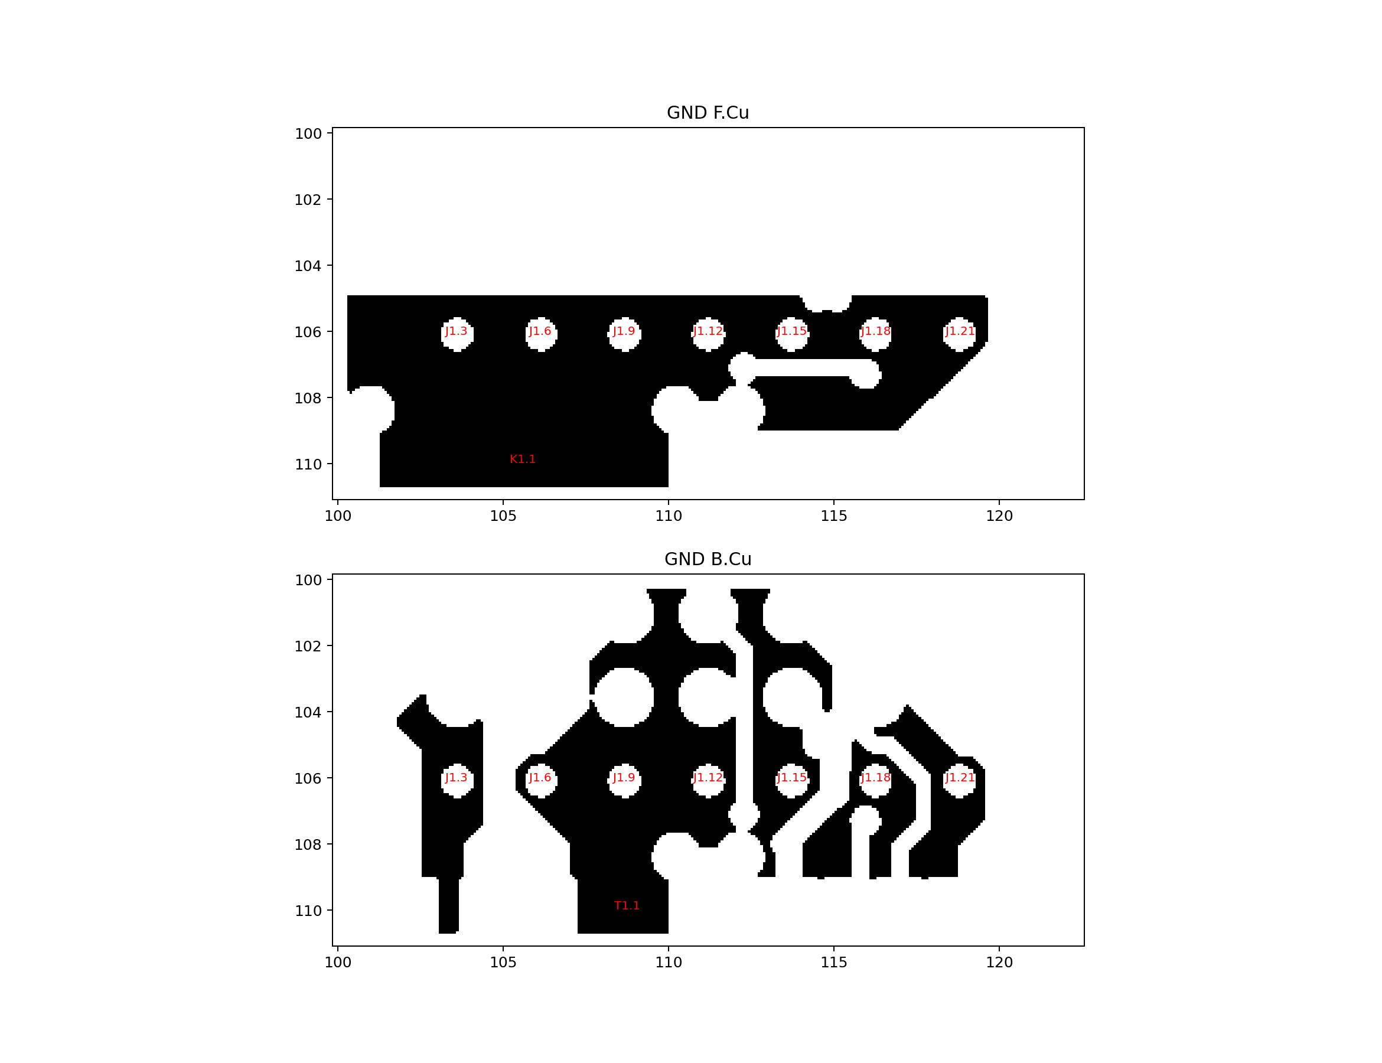
nexus-style-fc/docs/validation/child-b49ef410/verification/power/v2-GND-saved-copper-screen.png
