chenguoming1/h743-controllers/nexus-style-fc/docs/validation/child-b49ef410/verification/preview/child-continuous-vx-review.png

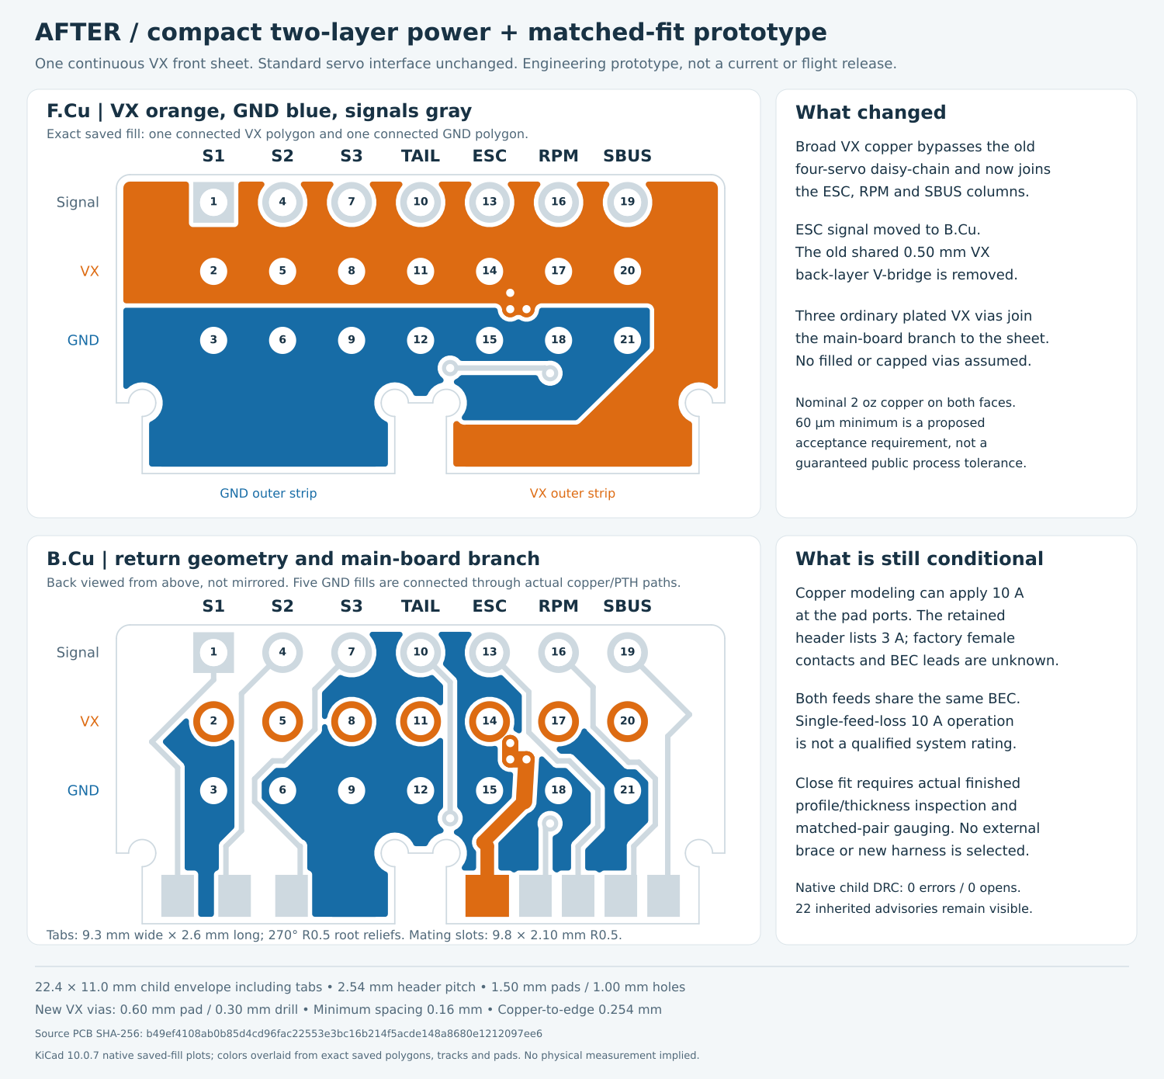
nexus-style-fc/docs/validation/child-b49ef410/verification/preview/child-continuous-vx-review.png
