chenguoming1/h743-controllers/nexus-style-fc/docs/validation/reviews/child-full-load-2026-10-17/preview/native-child-editor.png

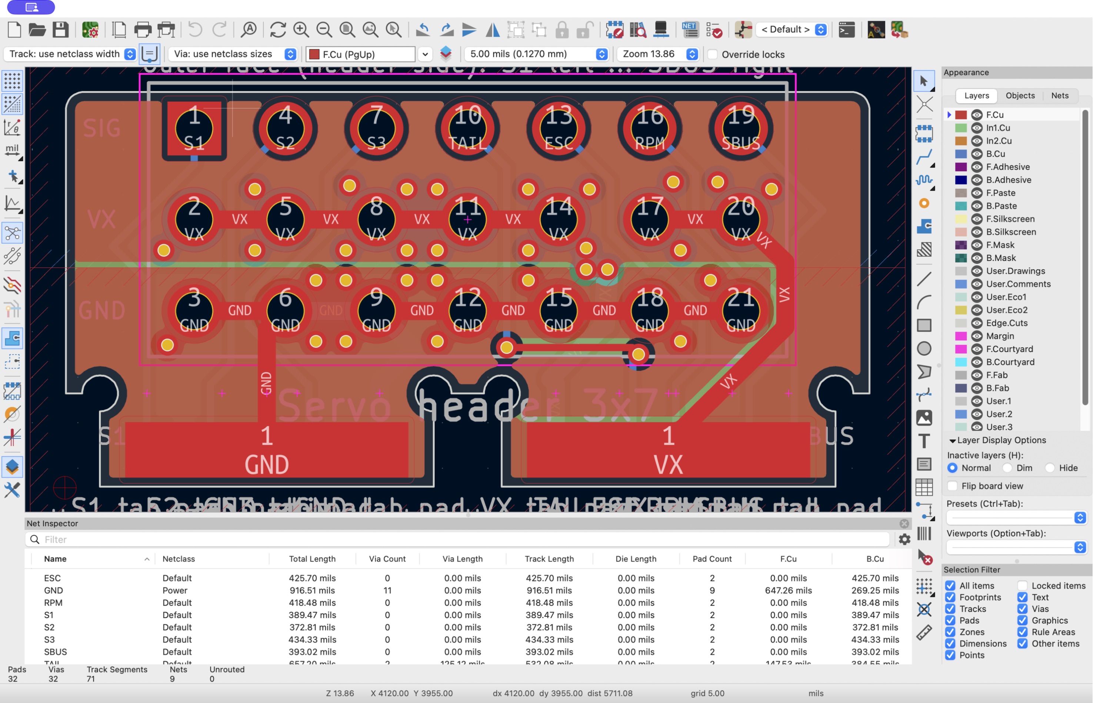
nexus-style-fc/docs/validation/reviews/child-full-load-2026-10-17/preview/native-child-editor.png
