chenguoming1/h743-controllers/nexus-style-fc/docs/validation/reviews/cpl-2026-10-17/d5-d6-bottom-corrected.jpg

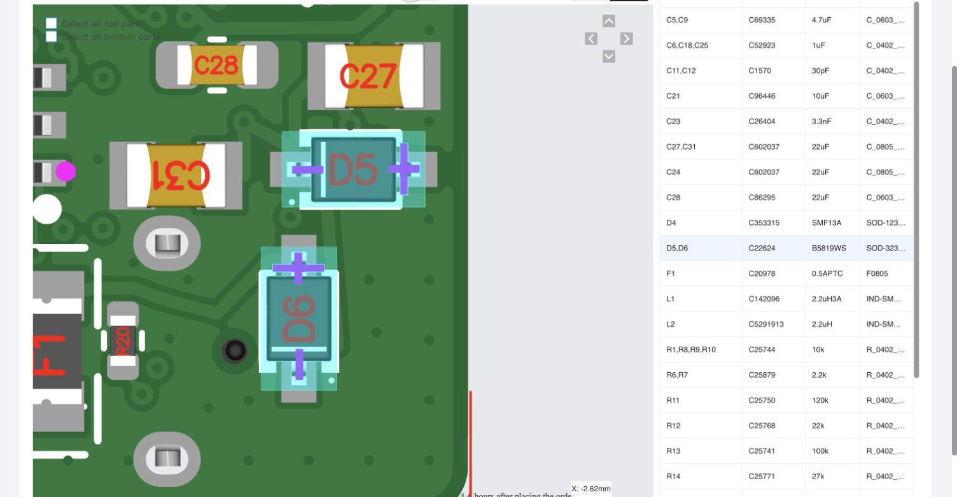
nexus-style-fc/docs/validation/reviews/cpl-2026-10-17/d5-d6-bottom-corrected.jpg
