chenguoming1/h743-controllers/nexus-style-fc/docs/validation/reviews/cpl-2026-10-17/u1-bottom-corrected.jpg

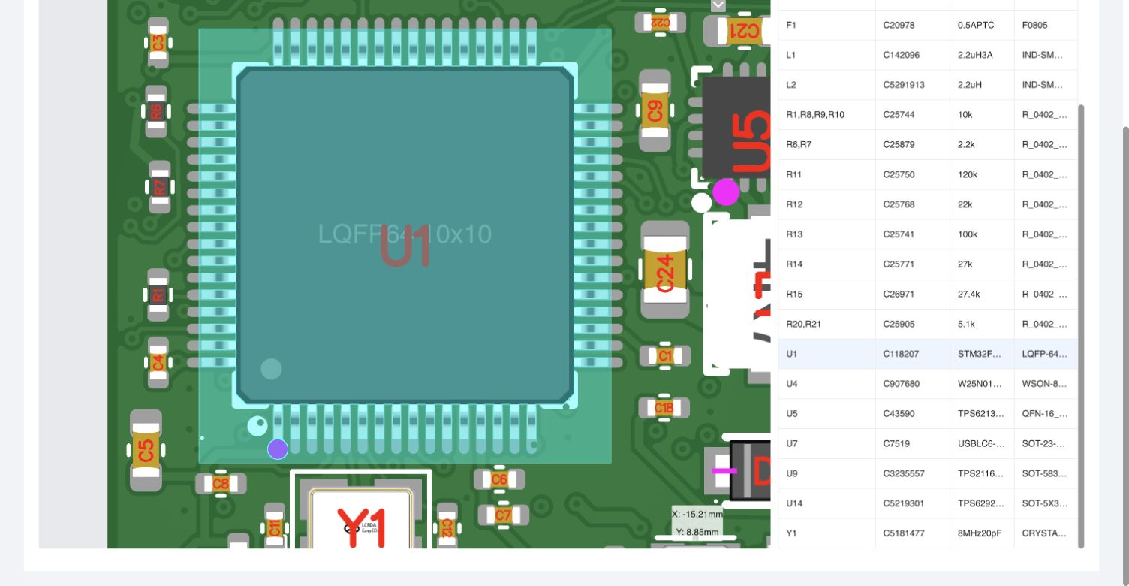
nexus-style-fc/docs/validation/reviews/cpl-2026-10-17/u1-bottom-corrected.jpg
