chenguoming1/h743-controllers/nexus-style-fc/docs/validation/reviews/final-order-check-2026-10-17/smt-result.png

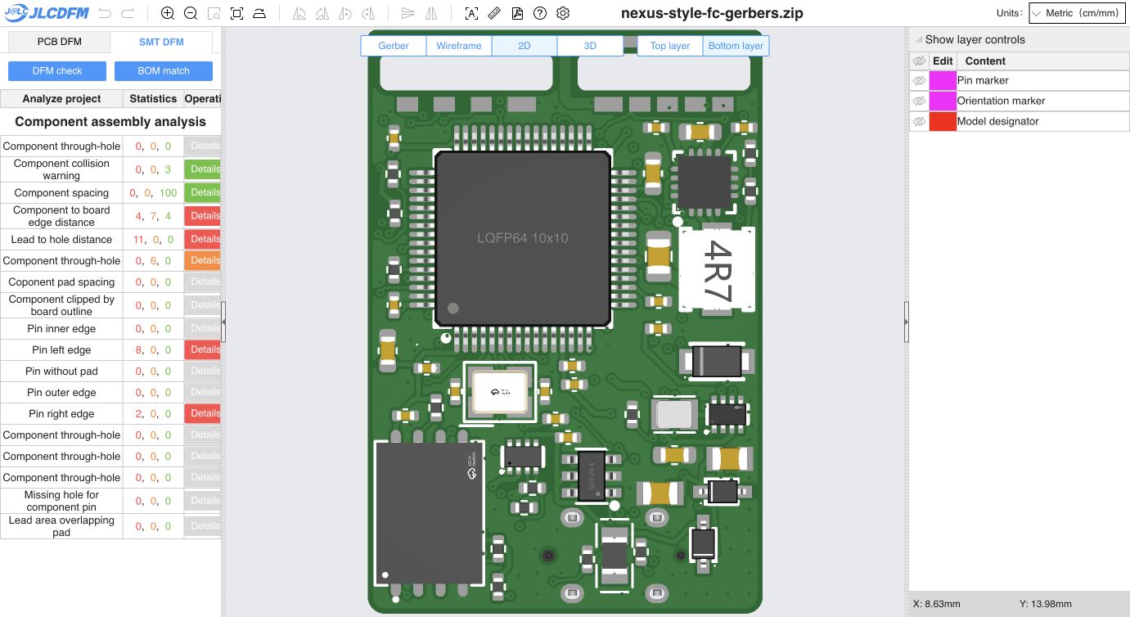
nexus-style-fc/docs/validation/reviews/final-order-check-2026-10-17/smt-result.png
