chenguoming1/h743-controllers/nexus-style-fc/docs/validation/reviews/jlc-quote-2026-10-17/standard-calculator.png

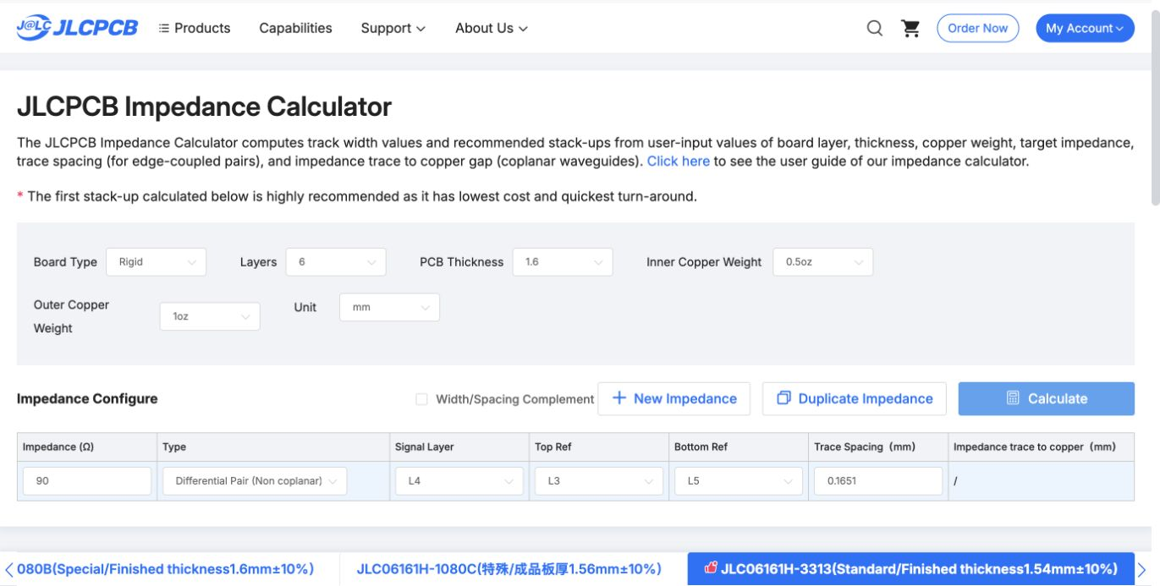
nexus-style-fc/docs/validation/reviews/jlc-quote-2026-10-17/standard-calculator.png
