chenguoming1/h743-controllers/nexus-style-fc/docs/validation/reviews/jlcdfm-current-2026-10-17/pcb-pad-spacing.jpg

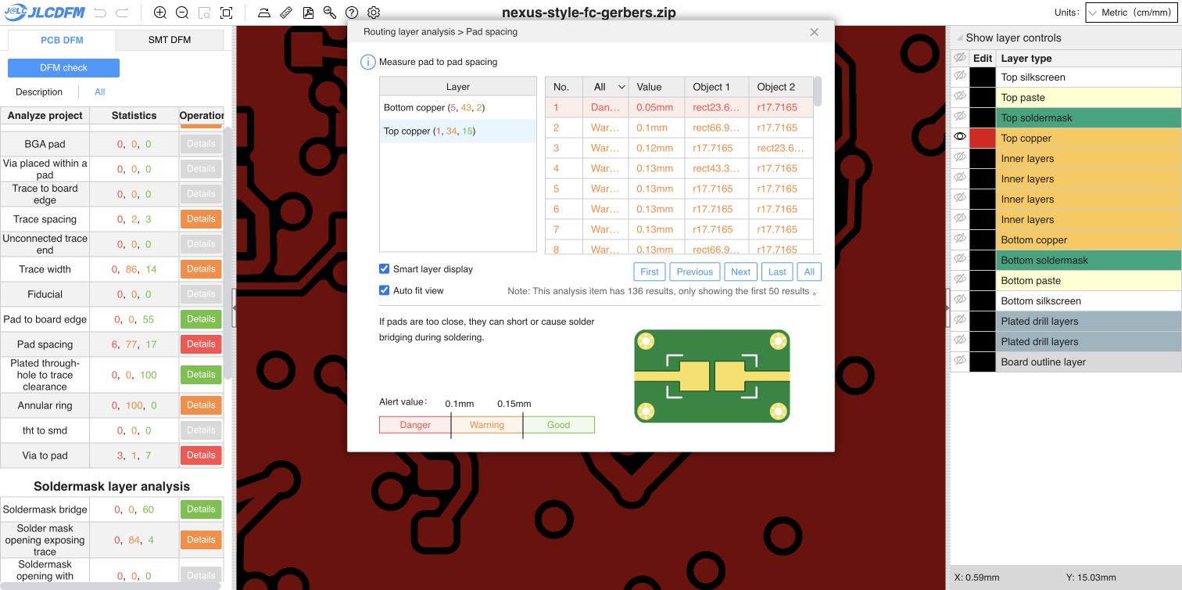
nexus-style-fc/docs/validation/reviews/jlcdfm-current-2026-10-17/pcb-pad-spacing.jpg
