chenguoming1/h743-controllers/nexus-style-fc/docs/validation/reviews/placement/critical-paths.png

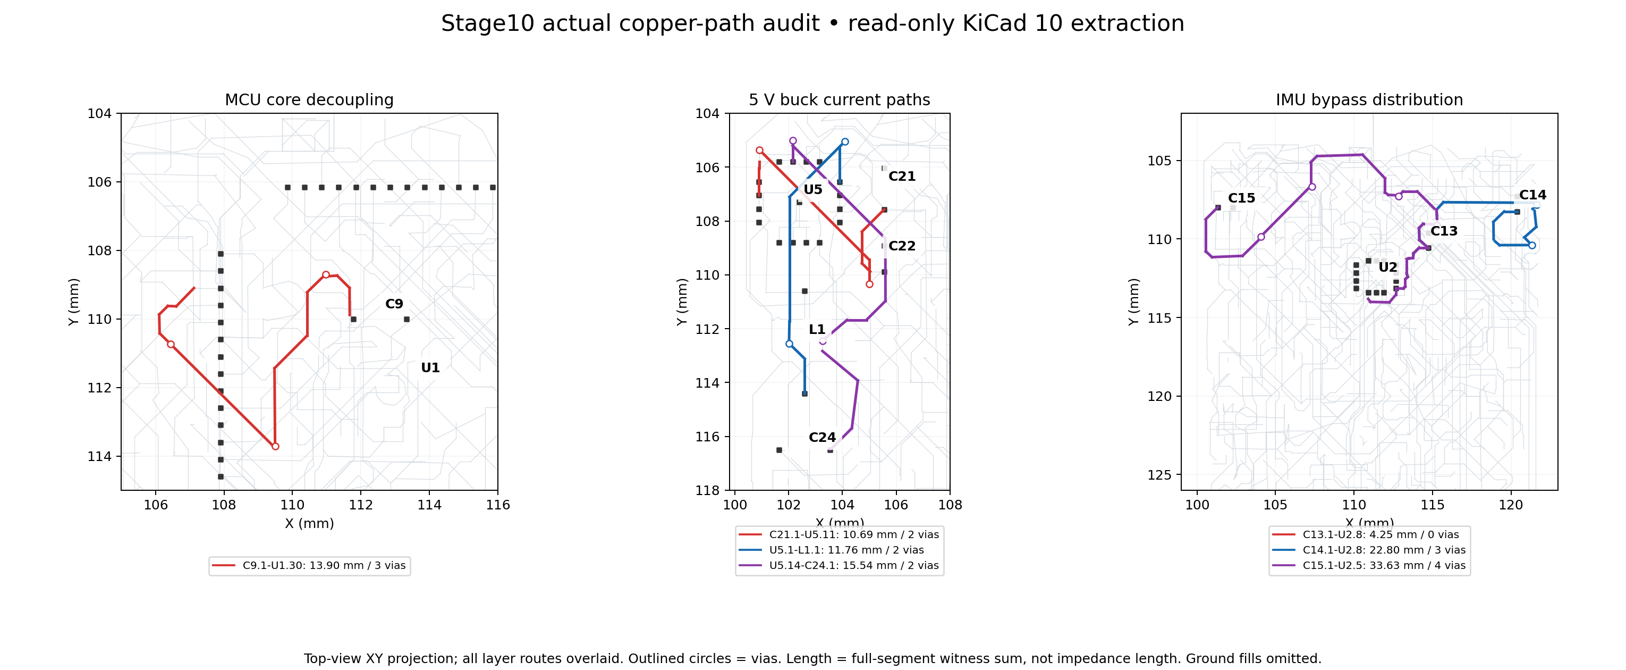
nexus-style-fc/docs/validation/reviews/placement/critical-paths.png
