chenguoming1/h743-controllers/nexus-style-fc/docs/validation/reviews/rounded-keepout-2026-10-17/editor-refreshed.png

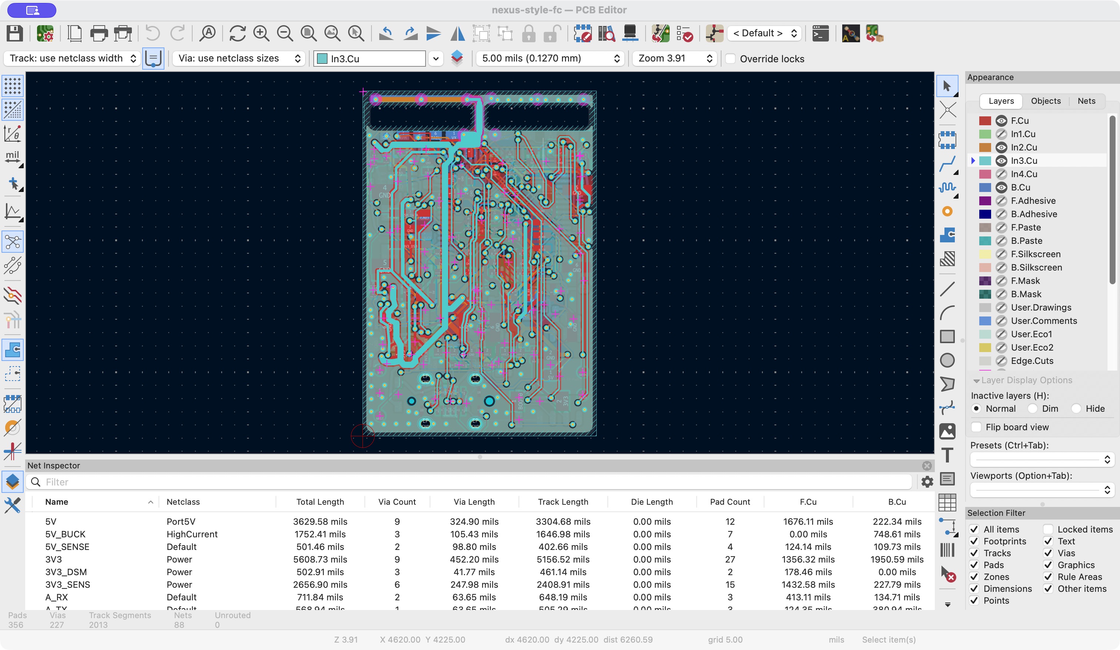
nexus-style-fc/docs/validation/reviews/rounded-keepout-2026-10-17/editor-refreshed.png
