chenguoming1/h743-controllers/nexus-style-fc/docs/validation/reviews/standard-stack-2026-10-17/layer-sequence.png

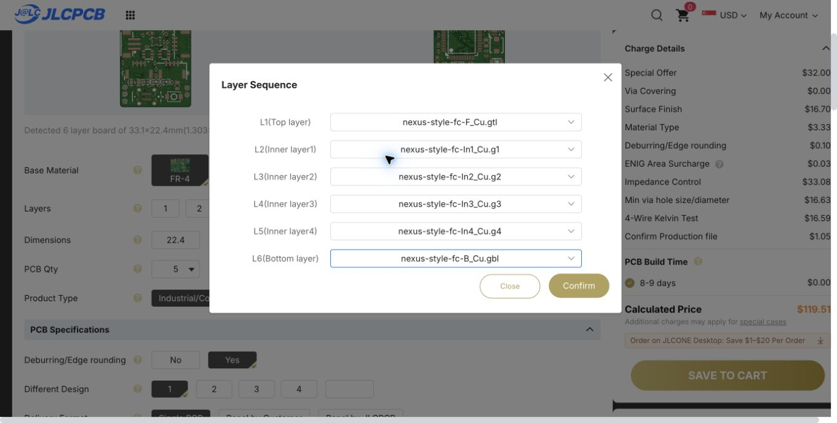
nexus-style-fc/docs/validation/reviews/standard-stack-2026-10-17/layer-sequence.png
