chenguoming1/h743-controllers/nexus-style-fc/docs/validation/reviews/standard-stack-2026-10-17/quote-standard-stack.png

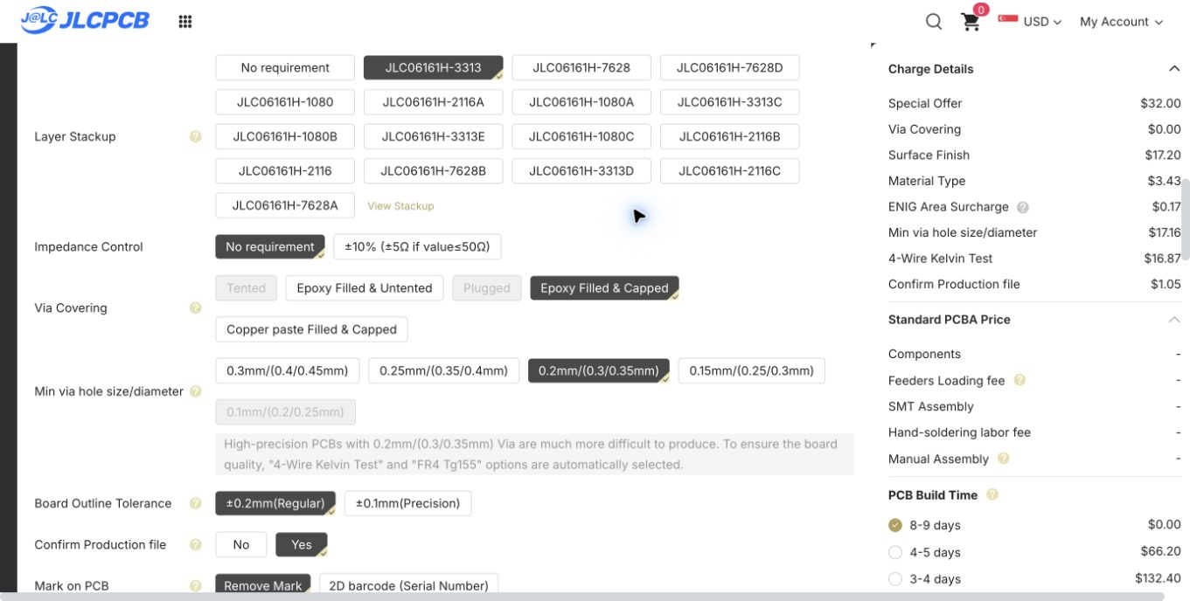
nexus-style-fc/docs/validation/reviews/standard-stack-2026-10-17/quote-standard-stack.png
