chenguoming1/h743-controllers/nexus-style-fc/docs/validation/reviews/tail-route-2026-10-17/pcb-result.jpg

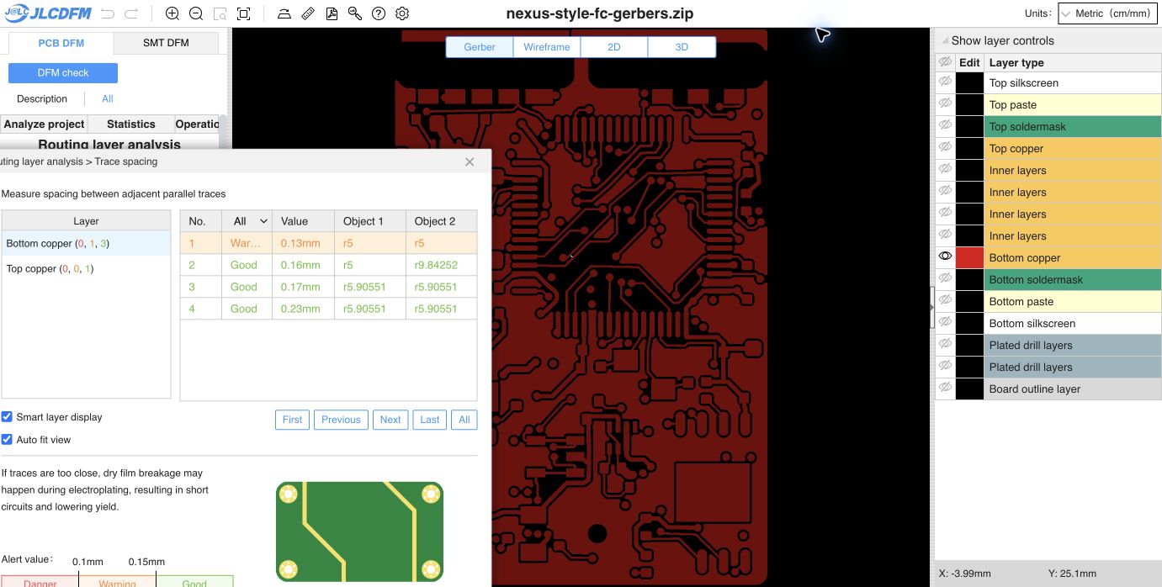
nexus-style-fc/docs/validation/reviews/tail-route-2026-10-17/pcb-result.jpg
