chenguoming1/h743-controllers/nexus-style-fc/docs/validation/reviews/tail-route-2026-10-17/tail-cleaned.png

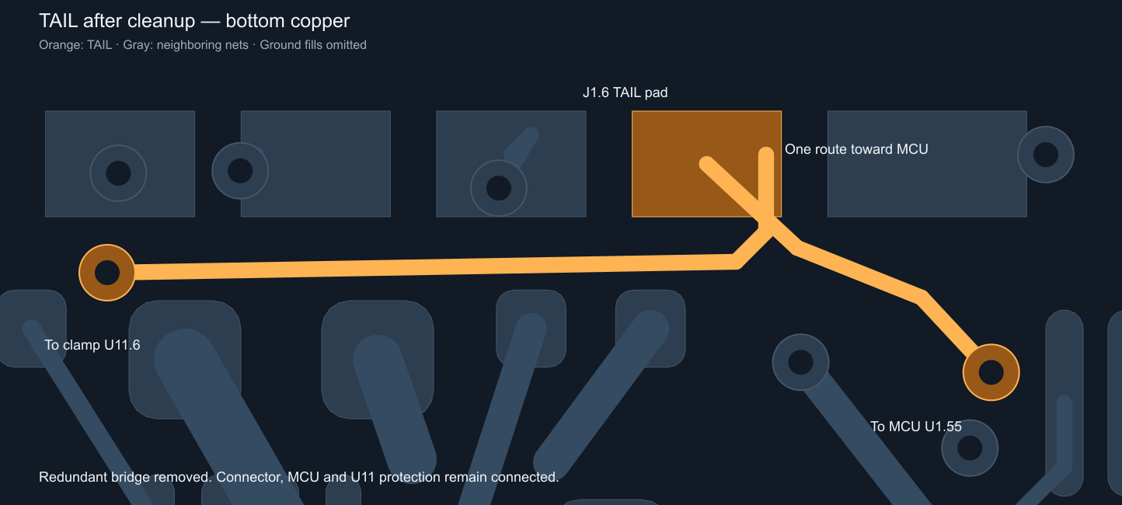
nexus-style-fc/docs/validation/reviews/tail-route-2026-10-17/tail-cleaned.png
