chenguoming1/h743-controllers/nexus-style-fc/docs/validation/reviews/usb-compliance-2026-10-17/jlc-calculator.png

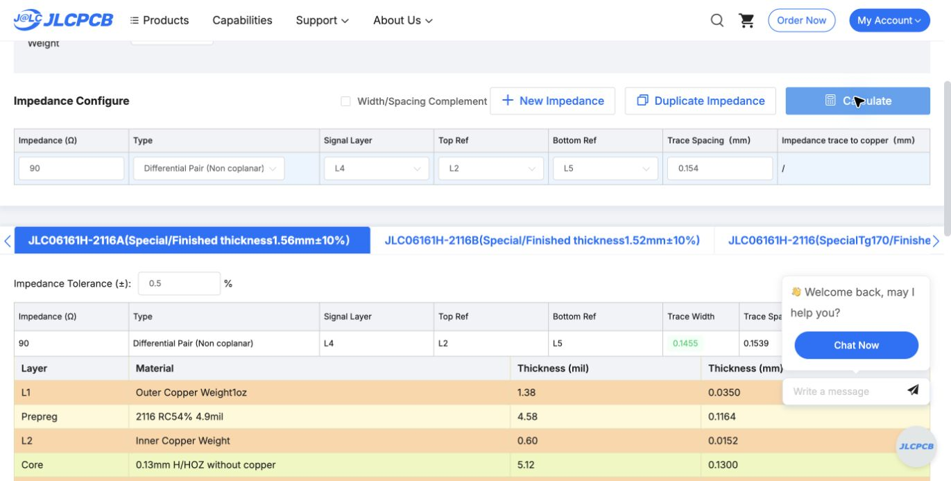
nexus-style-fc/docs/validation/reviews/usb-compliance-2026-10-17/jlc-calculator.png
