chenguoming1/h743-controllers/nexus-style-fc/docs/validation/reviews/usb-compliance-2026-10-17/native-stack.png

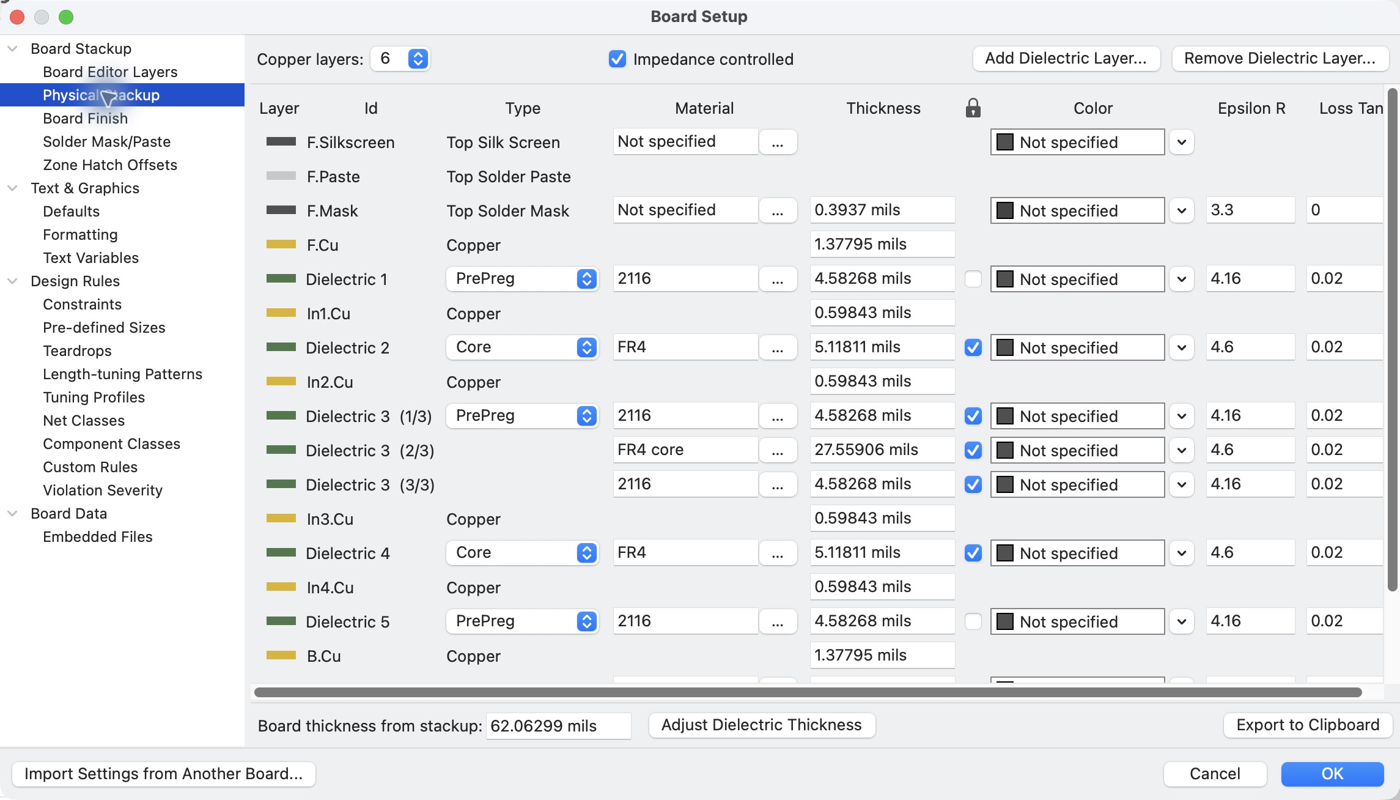
nexus-style-fc/docs/validation/reviews/usb-compliance-2026-10-17/native-stack.png
