chenguoming1/h743-controllers/nexus-style-fc/routing-wip/2026-10-15/stage36-main-child-checkpoint/candidate/history/stage32-verification/visual/main-front.png

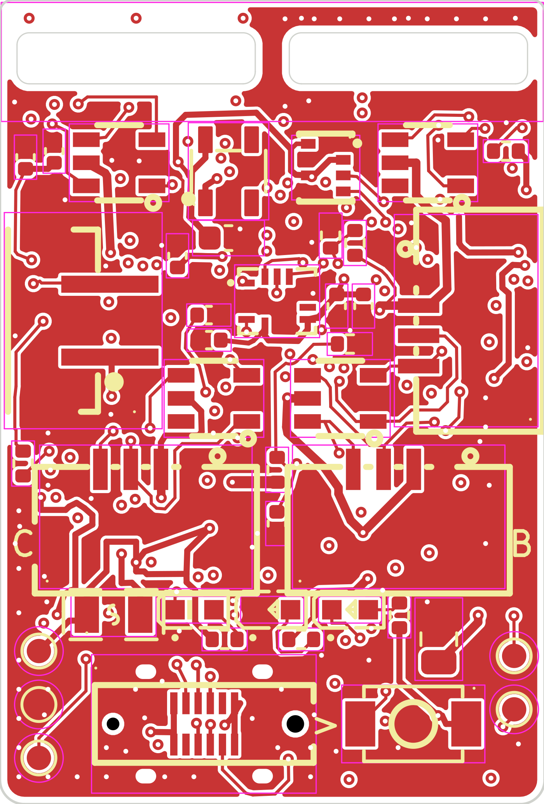
nexus-style-fc/routing-wip/2026-10-15/stage36-main-child-checkpoint/candidate/history/stage32-verification/visual/main-front.png
