chenguoming1/h743-controllers/self-balancing/native/tools/history-P3/README.txt

These helpers describe the preceding P3 revision and are preserved as history. Use the current P4 release exporter and package_p4.py for this revision.
