chenguoming1/h743-controllers/nexus-style-fc/routing-wip/2026-10-15/stage36-main-child-checkpoint/candidate/history/stage32-README-CHECKPOINT.md

# Unfinished Nexus engineering checkpoint

Start with MAIN-PLACEMENT-CHECKPOINT.md and ENGINEERING-CHECKPOINT-SEAL.json.

The routed main source is hardware/nexus-style-fc.kicad_pcb. The matched child is hardware/header-board/nexus-header-board.kicad_pcb. The unrouted comparison board under verification is evidence only. Do not substitute it for the routed source.

No fabrication, assembly or flight readiness is claimed. The manufacturing directory contains local review exports, not an order release. The published stable current source has not been overwritten by this local checkpoint.
