chenguoming1/h743-controllers/self-balancing/reconstruction/by-net-changes.csv

net | removed | added | segment_reduction | old_length_mm | new_length_mm
+5V_STACK | 148 | 31 | 117 | 32.85426765808692 | 23.02688129734929
/clock/HSE_XOUT | 5 | 2 | 3 | 3.357842712474619 | 3.3224873734152918
/power/STACK_5V_DIV | 22 | 9 | 13 | 4.810901871576774 | 4.621993141924173
/power/USB_CC1 | 13 | 11 | 2 | 19.634516223379467 | 19.64300648638388
/power/USB_CC2 | 4 | 3 | 1 | 5.34693000900063 | 5.311574669941304
/power/USB_SWITCH_ON | 70 | 11 | 59 | 16.76884674508411 | 16.643487814809127
/power/USB_VBUS_SLEW | 0 | 2 | -2 | 0 | 0.6703427124746191
/storage/FLASH_HOLD_n | 4 | 3 | 1 | 0.7742640687119285 | 0.7742640687119285
/storage/FLASH_SCLK | 3 | 3 | 0 | 3.3414213562373094 | 3.3121320343559644
/storage/FLASH_WP_n | 7 | 6 | 1 | 11.272539674441619 | 11.272539674441619
3V3_CORE | 575 | 152 | 423 | 129.34424345806323 | 128.64987494952163
ADC1_RAW | 67 | 25 | 42 | 32.62428909086338 | 31.316780032992728
ADC2_RAW | 71 | 25 | 46 | 42.219123290559736 | 40.7753796025402
ADC3_RAW | 30 | 13 | 17 | 12.405992052357226 | 13.272413408594536
AUX_PC8 | 64 | 22 | 42 | 22.33354645431739 | 22.31308637411165
AUX_PC9 | 24 | 9 | 15 | 7.959797974644666 | 8.109797974644666
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
