chenguoming1/h743-controllers/nexus-style-fc/routing-wip/2026-10-15/stage36-main-child-checkpoint/candidate/history/stage35-jlc-dfm/dfm-summary.csv

section | check | danger | warning | good | raw_report_row
PCB | Sharp trace corner | 0 | 2 | 0 | - row "Sharp trace corner （Check for sharp corners in traces） null Warning No nexus-style-fc-B_Cu.gbl nexus-style-fc-F_Cu.gtl Danger：0 Warning：2 Good：0":
PCB | BGA pad | 0 | 0 | 0 | - row "BGA pad （Check BGA pads on the board） No No No Danger：0 Warning：0 Good：0":
PCB | Via placed within a pad | 0 | 0 | 0 | - row "Via placed within a pad （Check if there is a via placed within a pad） No No No Danger：0 Warning：0 Good：0":
PCB | Trace to board edge | 0 | 0 | 0 | - row "Trace to board edge （Detect traces too close to the board edge） No No No Danger：0 Warning：0 Good：0":
PCB | Trace spacing | 0 | 2 | 3 | - row "Trace spacing （Measure spacing between adjacent parallel traces） 0.13mm Warning No nexus-style-fc-B_Cu.gbl nexus-style-fc-F_Cu.gtl Danger：0 Warning：2 Good：3":
PCB | Unconnected trace end | 0 | 0 | 0 | - row "Unconnected trace end （Free-standing trace ends not connected to pads） No No No Danger：0 Warning：0 Good：0":
PCB | Trace width | 0 | 92 | 8 | - row "Trace width （Trace width information） 0.13mm Warning No nexus-style-fc-B_Cu.gbl nexus-style-fc-F_Cu.gtl Danger：0 Warning：92 Good：8":
PCB | Fiducial | 0 | 0 | 0 | - row "Fiducial （Detect fiducial marks on the board） No No No Danger：0 Warning：0 Good：0":
PCB | Pad to board edge | 0 | 0 | 55 | - row "Pad to board edge （Measure distance of pads from the board edge） 0.25mm Good No nexus-style-fc-B_Cu.gbl nexus-style-fc-F_Cu.gtl Danger：0 Warning：0 Good：55":
PCB | Pad spacing | 7 | 77 | 16 | - row "Pad spacing （Measure pad to pad spacing） 0.08mm Danger No nexus-style-fc-B_Cu.gbl nexus-style-fc-F_Cu.gtl Danger：7 Warning：77 Good：16":
PCB | Plated through-hole to trace clearance | 0 | 0 | 100 | - row "Plated through-hole to trace clearance （Measure clearance of plated through-holes to traces） 0.25mm Good No nexus-style-fc-B_Cu.gbl nexus-style-fc-F_Cu.gtl Danger：0 Warning：0 Good：100":
PCB | Annular ring | 0 | 100 | 0 | - row "Annular ring （Annular ring width of pads compared to holes） 0.12mm Warning No nexus-style-fc-B_Cu.gbl nexus-style-fc-F_Cu.gtl Danger：0 Warning：100 Good：0":
PCB | tht to smd | 0 | 0 | 0 | - row "tht to smd （Detect clearance of vias to pads） No No No Danger：0 Warning：0 Good：0":
PCB | Via to pad | 3 | 1 | 7 | - row "Via to pad （Detect clearance of vias to pads） 0mm Danger No nexus-style-fc-B_Cu.gbl nexus-style-fc-F_Cu.gtl Danger：3 Warning：1 Good：7":
PCB | Soldermask bridge | 0 | 0 | 60 | - row "Soldermask bridge （Detect distance between parallel soldermask opening edges） 0.2mm Good No nexus-style-fc-B_Mask.gbs nexus-style-fc-F_Mask.gts Danger：0 Warning：0 Good：60":
PCB | Solder mask opening exposing trace | 0 | 83 | 4 | - row "Solder mask opening exposing trace （Detect clearance of solder mask openings to nearby traces） 0.1mm Warning No nexus-style-fc-B_Mask.gbs nexus-style-fc-F_Mask.gts Danger：0 Warning：83 Good：4":
PCB | Soldermask opening with multiple segments | 0 | 0 | 0 | - row "Soldermask opening with multiple segments （Check if solder mask openings are constructed from multiple geometric shapes） No No No Danger：0 Warning：0 Good：0":
PCB | Negative soldermask expansion | 0 | 10 | 0 | - row "Negative soldermask expansion （Detect solder mask openings smaller than their corresponding pads） 0.04mm Warning No nexus-style-fc-B_Mask.gbs nexus-style-fc-F_Mask.gts Danger：0 Warning：10 Good：0":
PCB | Silkscreen to pad | 100 | 0 | 0 | - row "Silkscreen to pad （Detect clearance of silkscreen to pads） 0mm Danger No nexus-style-fc-B_Silkscreen.gbo nexus-style-fc-F_Silkscreen.gto Danger：100 Warning：0 Good：0":
PCB | Silkscreen to hole | 100 | 0 | 0 | - row "Silkscreen to hole （Detect clearance of silkscreen to holes） 0mm Danger No nexus-style-fc-B_Silkscreen.gbo nexus-style-fc-F_Silkscreen.gto Danger：100 Warning：0 Good：0":
PCB | Silkscreen line width | 0 | 44 | 4 | - row "Silkscreen line width （Check silkscreen line width） 0.15mm Warning No nexus-style-fc-B_Silkscreen.gbo nexus-style-fc-F_Silkscreen.gto Danger：0 Warning：44 Good：4":
PCB | Unconnected via | 0 | 0 | 0 | - row "Unconnected via （Detect isolated unconnected vias） No No No Danger：0 Warning：0 Good：0":
PCB | Missing plated through-hole | 0 | 0 | 0 | - row "Missing plated through-hole （Detect top and bottom pads at the same location without plated through-holes） No No No Danger：0 Warning：0 Good：0":
PCB | Unconnected via | 0 | 0 | 0 | - row "Unconnected via （Detect isolated unconnected vias） No No No Danger：0 Warning：0 Good：0":
PCB | Plated through-hole spacing | 0 | 0 | 1 | - row "Plated through-hole spacing （Measure spacing between plated through-holes） 0.25mm Good No nexus-style-fc-PTH.drl Danger：0 Warning：0 Good：1":
PCB | Short slot detection | 0 | 4 | 0 | - row "Short slot detection （Detect slots shorter than twice their width） 0.25mm Warning No nexus-style-fc-PTH.drl Danger：0 Warning：4 Good：0":
PCB | Slot width check | 4 | 0 | 0 | - row "Slot width check （Measure slot width） 0.6mm Danger No nexus-style-fc-PTH.drl Danger：4 Warning：0 Good：0":
PCB | Via to PTH spacing | 0 | 0 | 0 | - row "Via to PTH spacing （Measure spacing of vias to plated through-holes） No No No Danger：0 Warning：0 Good：0":
PCB | Unconnected via | 0 | 0 | 0 | - row "Unconnected via （Detect isolated unconnected vias） No No No Danger：0 Warning：0 Good：0":
SMT | Component through-hole | 0 | 0 | 0 | - row "Component through-hole （Detect misalignment of component through-hole pins to pad holes） No No No Danger：0 Warning：0 Good：0":
SMT | Component collision warning | 0 | 0 | 2 | - row "Component collision warning （Component collision warning;Component 1;Component 2） 0mm Good No component_+_top Danger：0 Warning：0 Good：2":
SMT | Component spacing | 0 | 0 | 100 | - row "Component spacing （Component to component spacing;Component 1;Component 2） 0.5mm Good No component_+_top component_+_bottom Danger：0 Warning：0 Good：100":
SMT | Component to board edge distance | 4 | 7 | 3 | - row "Component to board edge distance （Measure distance from component outline to the board edge） 0.33mm Danger No component_+_top component_+_bottom Danger：4 Warning：7 Good：3":
SMT | Lead to hole distance | 10 | 0 | 0 | - row "Lead to hole distance （Detect clearance of component leads to holes） 0mm Danger No component_+_top component_+_bottom Danger：10 Warning：0 Good：0":
SMT | Component through-hole | 0 | 7 | 0 | - row "Component through-hole （Detect misalignment of component through-hole pins to pad holes） 0.96mm Warning No component_+_top component_+_bottom Danger：0 Warning：7 Good：0":
SMT | Coponent pad spacing | 0 | 0 | 0 | - row "Coponent pad spacing （Detect clearance between pads of the same component） No No No Danger：0 Warning：0 Good：0":
SMT | Component clipped by board outline | 0 | 0 | 0 | - row "Component clipped by board outline （Detect component boundary clipping by the board outline） No No No Danger：0 Warning：0 Good：0":
SMT | Pin inner edge | 0 | 0 | 0 | - row "Pin inner edge （Measure if component pin edges extend past pad edges） No No No Danger：0 Warning：0 Good：0":
SMT | Pin left edge | 9 | 0 | 0 | - row "Pin left edge （Measure if component pin edges extend past pad edges） 0mm Danger No component_+_top component_+_bottom Danger：9 Warning：0 Good：0":
SMT | Pin without pad | 1 | 0 | 0 | - row "Pin without pad （Detect if component pins without pads） null Danger No component_+_top Danger：1 Warning：0 Good：0":
SMT | Pin outer edge | 2 | 0 | 0 | - row "Pin outer edge （Measure if component pin edges extend past pad edges） 0.15mm Danger No component_+_top Danger：2 Warning：0 Good：0":
SMT | Pin right edge | 3 | 0 | 0 | - row "Pin right edge （Measure if component pin edges extend past pad edges） 0mm Danger No component_+_top component_+_bottom Danger：3 Warning：0 Good：0":
SMT | Component through-hole | 0 | 0 | 0 | - row "Component through-hole （Detect misalignment of component through-hole pins to pad holes） No No No Danger：0 Warning：0 Good：0":
SMT | Component through-hole | 0 | 0 | 0 | - row "Component through-hole （Detect misalignment of component through-hole pins to pad holes） No No No Danger：0 Warning：0 Good：0":
SMT | Component through-hole | 0 | 0 | 0 | - row "Component through-hole （Detect misalignment of component through-hole pins to pad holes） No No No Danger：0 Warning：0 Good：0":
SMT | Missing hole for component pin | 0 | 0 | 0 | - row "Missing hole for component pin （Detect component through-hole pins without corresponding holes） No No No Danger：0 Warning：0 Good：0":
SMT | Lead area overlapping pad | 4 | 0 | 0 | - row "Lead area overlapping pad （Detect insufficient overlap between component pins and pads） 0.02mm Danger No component_+_top Danger：4 Warning：0 Good：0":
