chenguoming1/h743-controllers/nexus-style-fc/docs/validation/reviews/order-fixes-2026-10-17/d4-polarity-preview.png

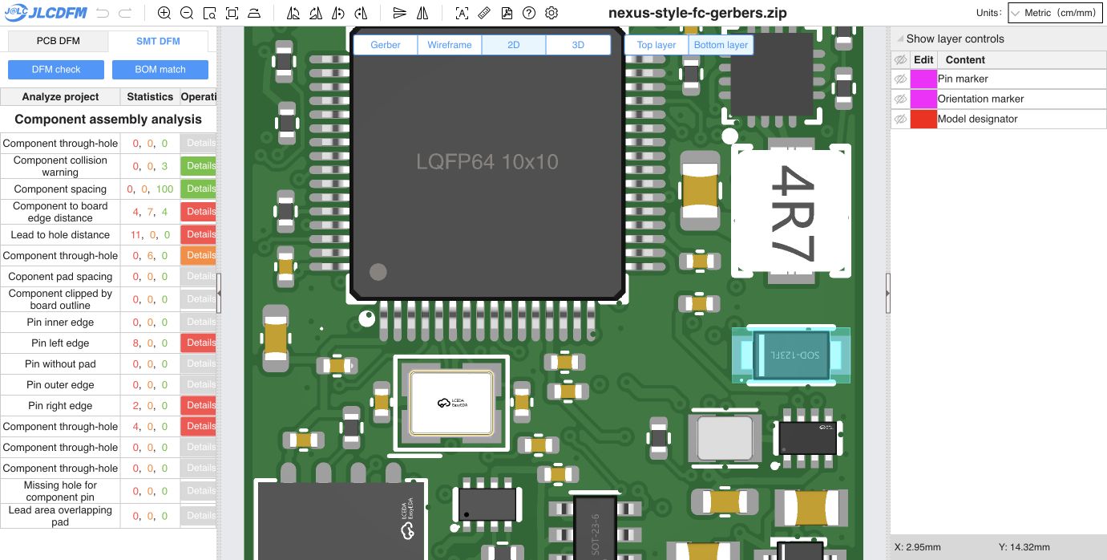
nexus-style-fc/docs/validation/reviews/order-fixes-2026-10-17/d4-polarity-preview.png
