chenguoming1/h743-controllers/nexus-style-fc/docs/validation/history/routing-wip/2026-10-15/local-r57-checkpoint/filter-integration/preview/source-visual-reference.pdf

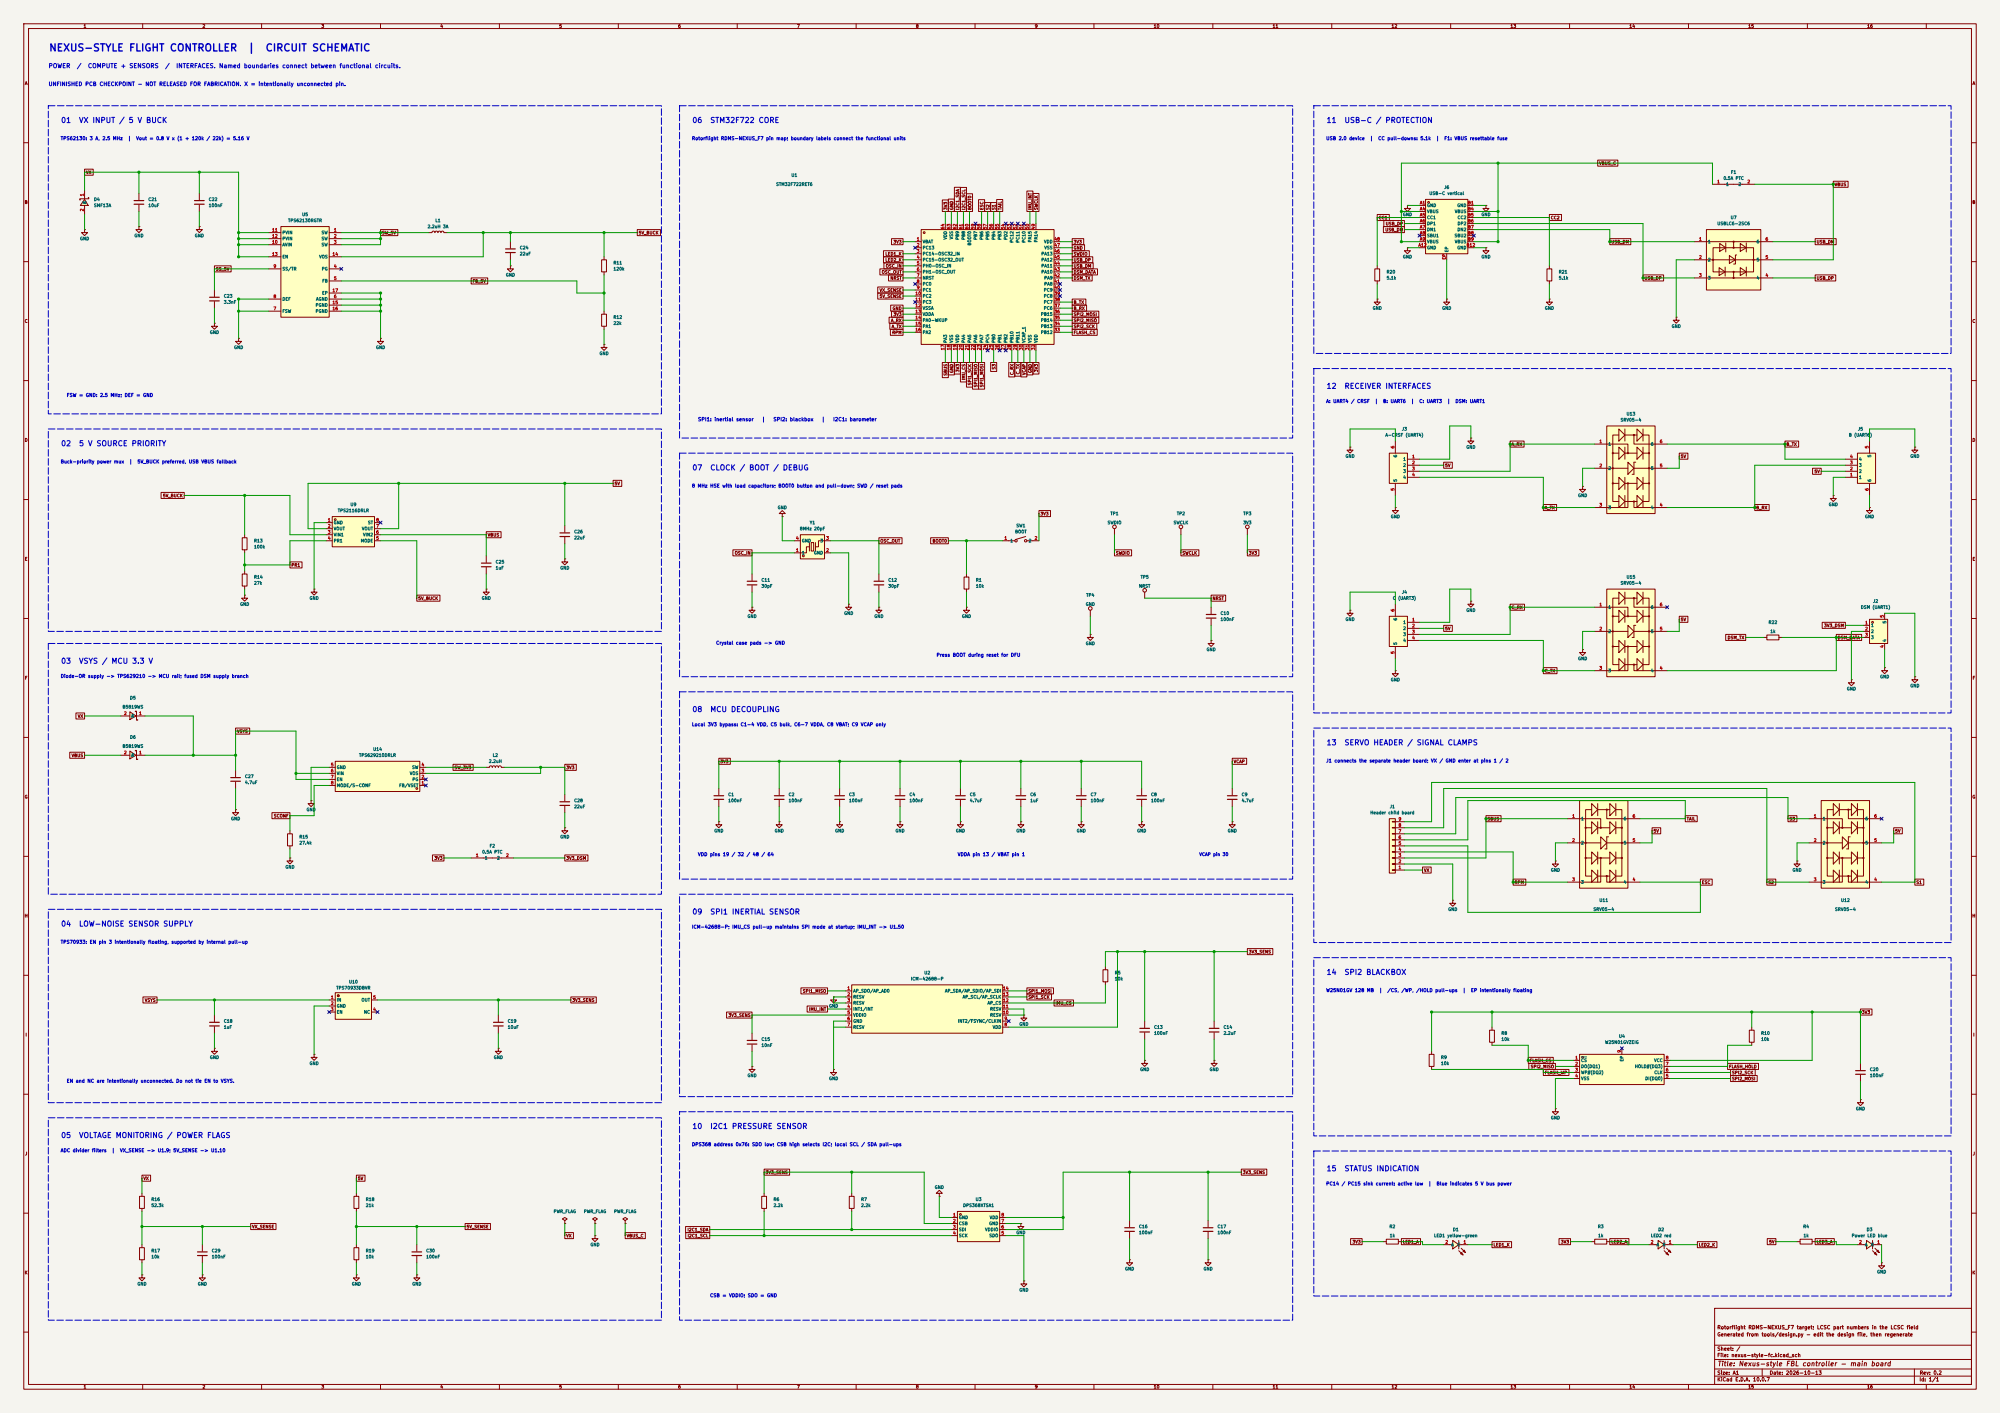
[picture p113: page 1]

NEXUS-STYLE FLIGHT CONTROLLER | CIRCUIT SCHEMATIC

POWER / COMPUTE + SENSORS / INTERFACES. Named boundaries connect between functional circuits.

UNFINISHED PCB CHECKPOINT - NOT RELEASED FOR FABRICATION. X = intentionally unconnected pin.

USB 2.0 device | CC pull-downs: 5.1k | F1: VBUS resettable fuse 07 CLOCK / BOOT / DEBUG
Rotorflight RDMS-NEXUS_F7 pin map; boundary labels connect the functional units

02 5 V SOURCE PRIORITY Buck-priority power mux | 5V_BUCK preferred, USB VBUS fallback

8 MHz HSE with load capacitors; BOOT0 button and pull-down; SWD / reset pads

Crystal case pads -> GND

Press BOOT during reset for DFU

Diode-OR supply -> TPS629210 -> MCU rail; fused DSM supply branch

Local 3V3 bypass: C1-4 VDD, C5 bulk, C6-7 VDDA, C8 VBAT; C9 VCAP only

J1 connects the separate header board; VX / GND enter at pins 1 / 2

04 LOW-NOISE SENSOR SUPPLY

ICM-42688-P; IMU_CS pull-up maintains SPI mode at startup; IMU_INT -> U1.50

EN and NC are intentionally unconnected. Do not tie EN to VSYS. TPS70933: EN pin 3 intentionally floating, supported by internal pull-up

05 VOLTAGE MONITORING / POWER FLAGS

DPS368 address 0x76: SDO low; CSB high selects I2C; local SCL / SDA pull-ups

PC14 / PC15 sink current: active low | Blue indicates 5 V bus power

CSB = VDDIO; SDO = GND

Rotorflight RDMS-NEXUS_F7 target; LCSC part numbers in the LCSC field
Generated from tools/design.py - edit the design file, then regenerate

Sheet: /
File: nexus-style-fc.kicad_sch
Title: Nexus-style FBL controller - main board

Size: A1 | Rev: 0.2
KiCad E.D.A. 10.0.7 | Id: 1/1
