chenguoming1/h743-controllers/nexus-style-fc-power-module/docs/schematic.pdf

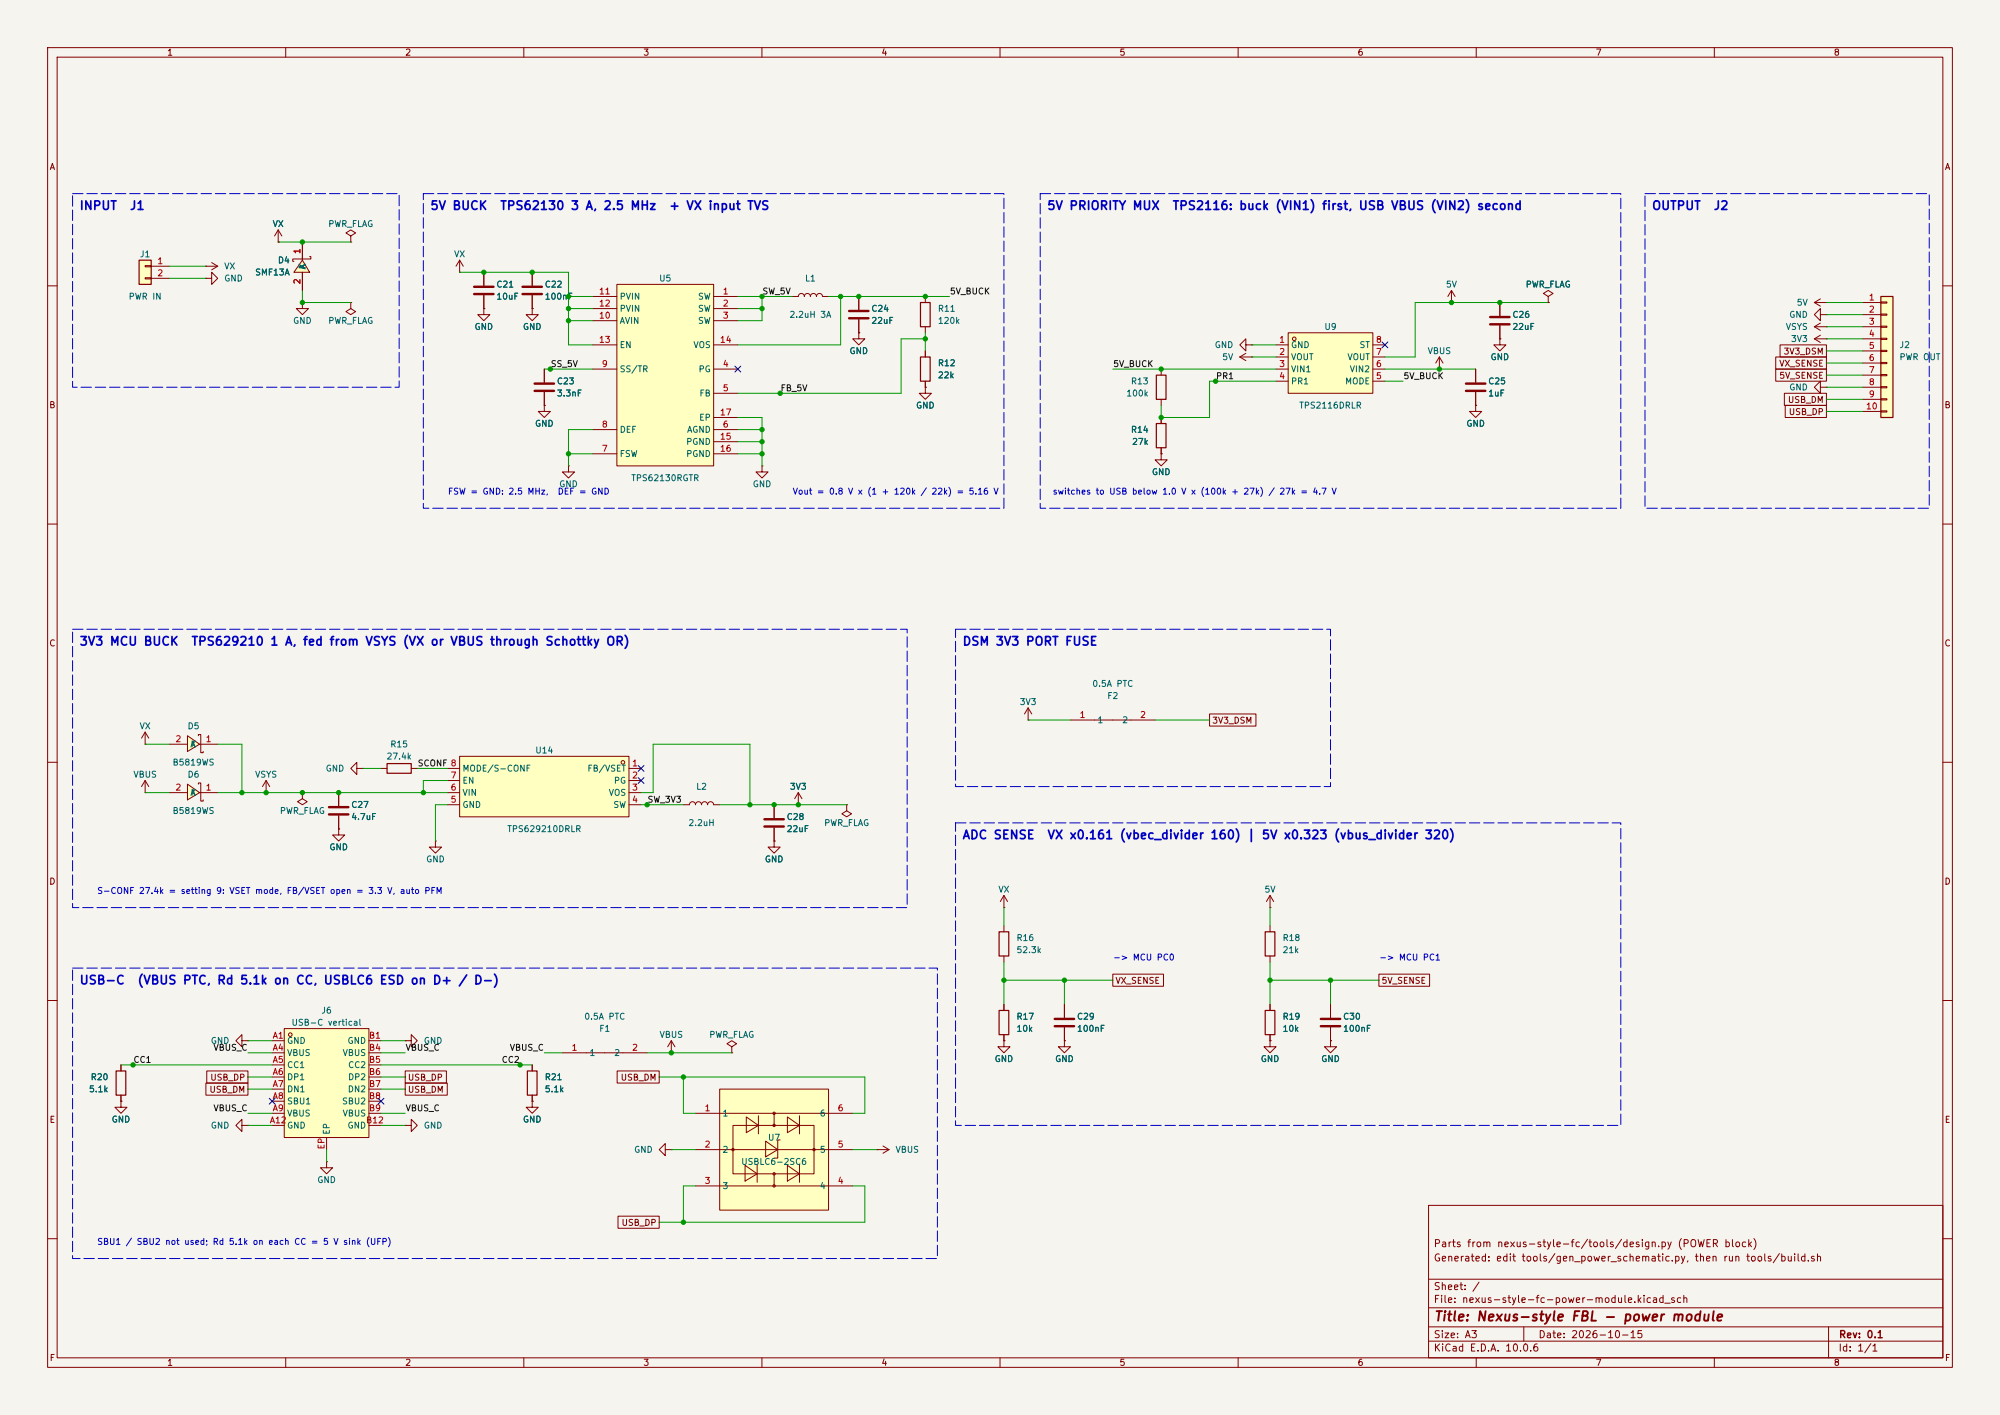
[picture p114: page 1]

switches to USB below 1.0 V x (100k + 27k) / 27k = 4.7 V 5V BUCK TPS62130 3 A, 2.5 MHz + VX input TVS

5V PRIORITY MUX TPS2116: buck (VIN1) first, USB VBUS (VIN2) second

USB-C (VBUS PTC, Rd 5.1k on CC, USBLC6 ESD on D+ / D-) SBU1 / SBU2 not used; Rd 5.1k on each CC = 5 V sink (UFP)

Parts from nexus-style-fc/tools/design.py (POWER block)
Generated: edit tools/gen_power_schematic.py, then run tools/build.sh

Sheet: /
File: nexus-style-fc-power-module.kicad_sch
Title: Nexus-style FBL - power module

Size: A3 | Rev: 0.1 | F Date: 2026-10-15
KiCad E.D.A. 10.0.6 | Id: 1/1
