chenguoming1/h743-controllers/nexus-style-fc/docs/schematic-header-board.pdf

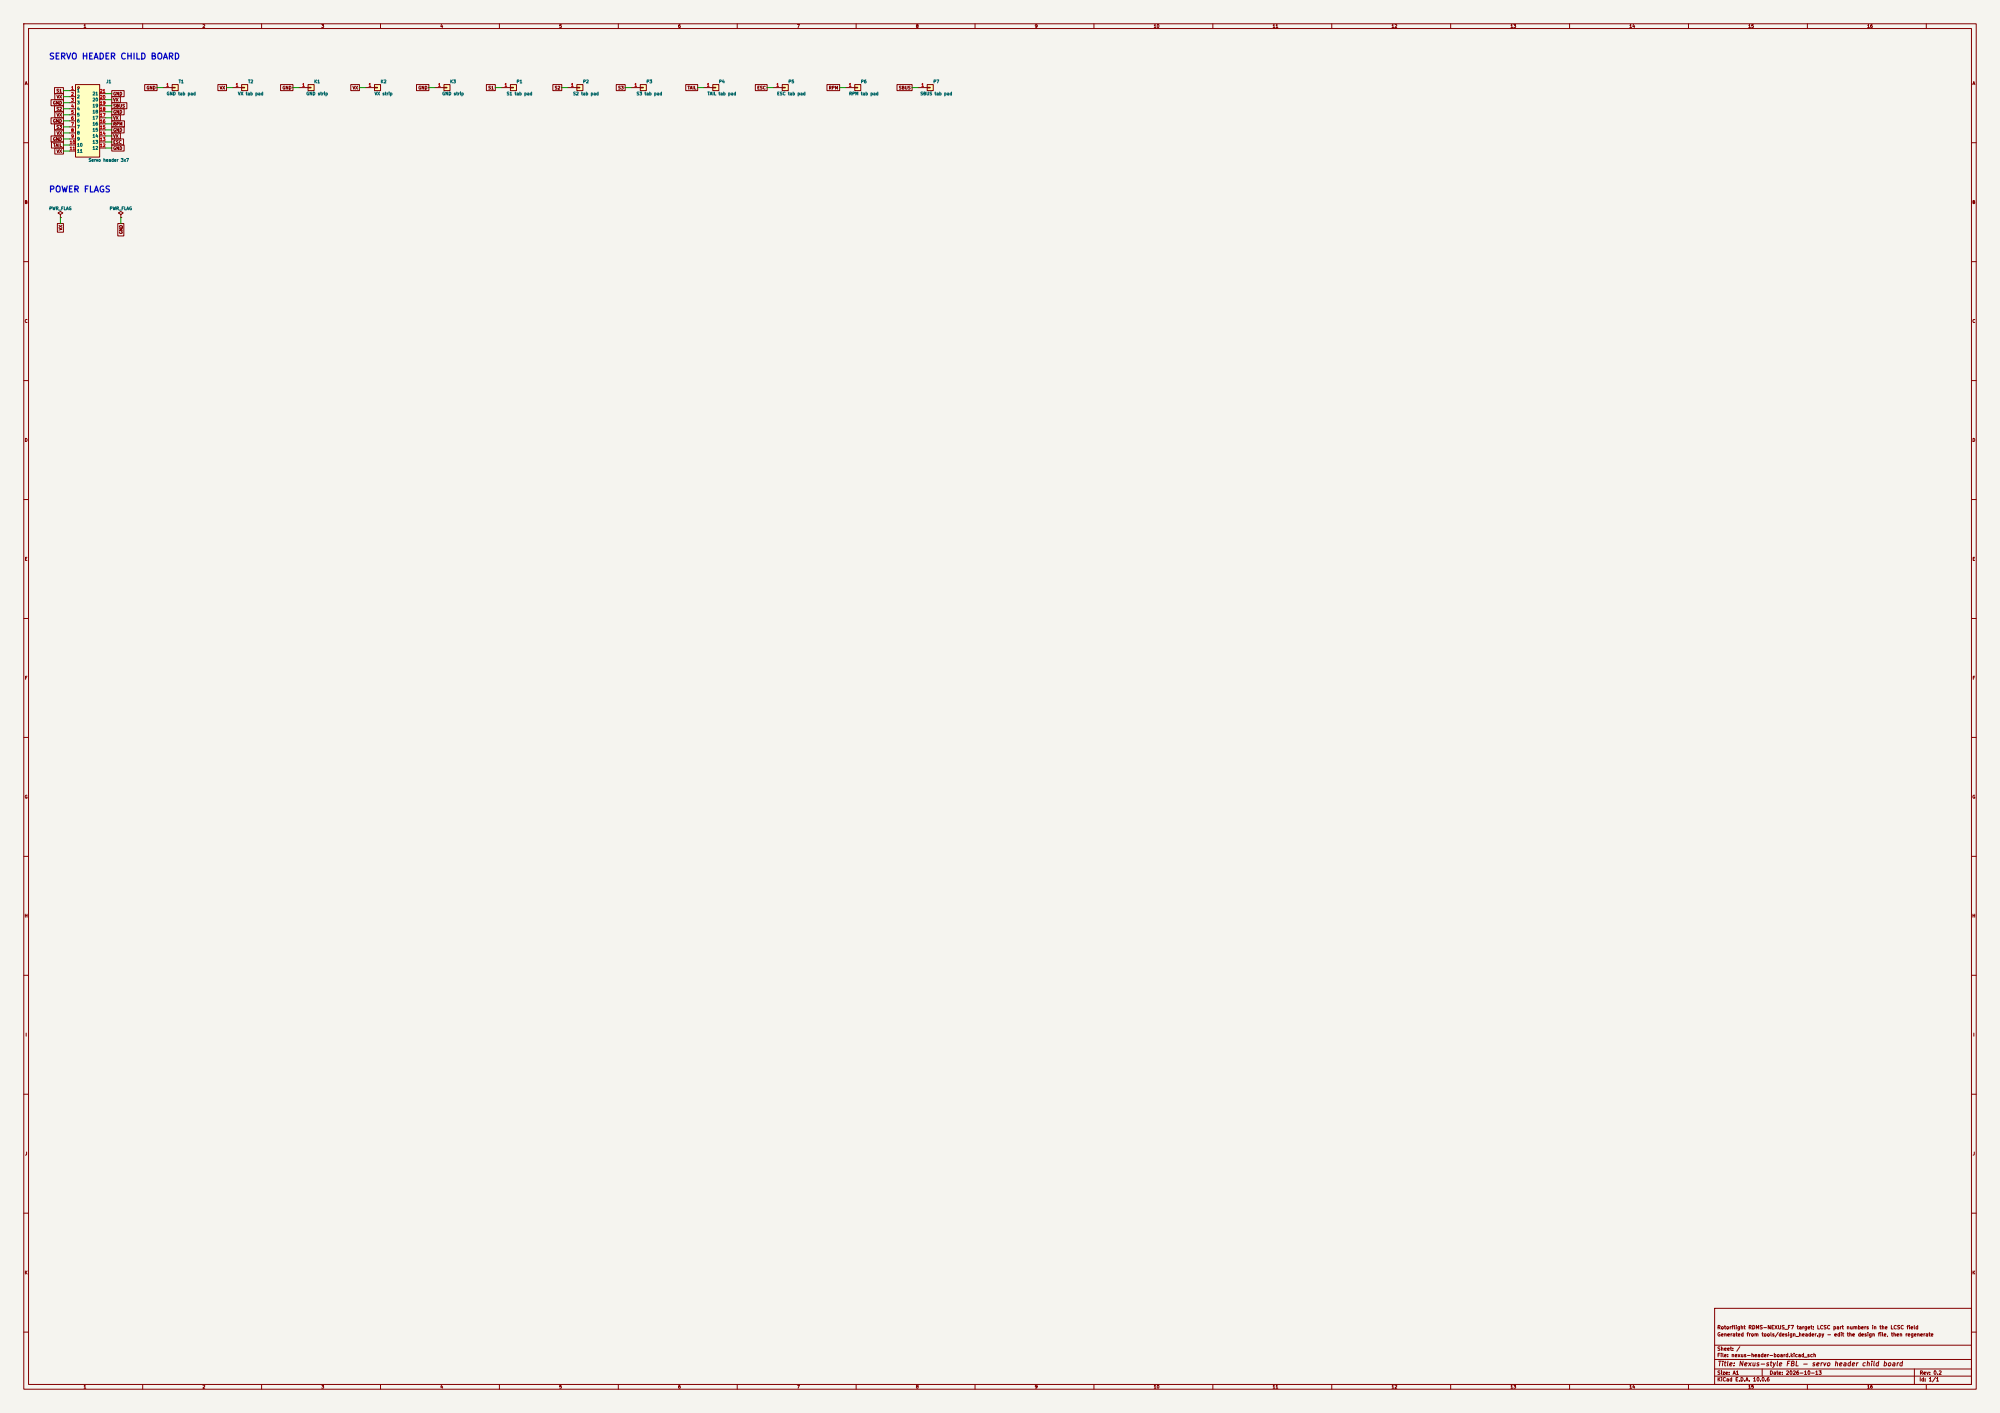
[picture p115: page 1]

SERVO HEADER CHILD BOARD

Rotorflight RDMS-NEXUS_F7 target; LCSC part numbers in the LCSC field
Generated from tools/design_header.py - edit the design file, then regenerate

Sheet: /
File: nexus-header-board.kicad_sch
Title: Nexus-style FBL - servo header child board

Size: A1 | Rev: 0.2
KiCad E.D.A. 10.0.6 | Id: 1/1
