chenguoming1/h743-controllers/b-rid/review/schematic.pdf

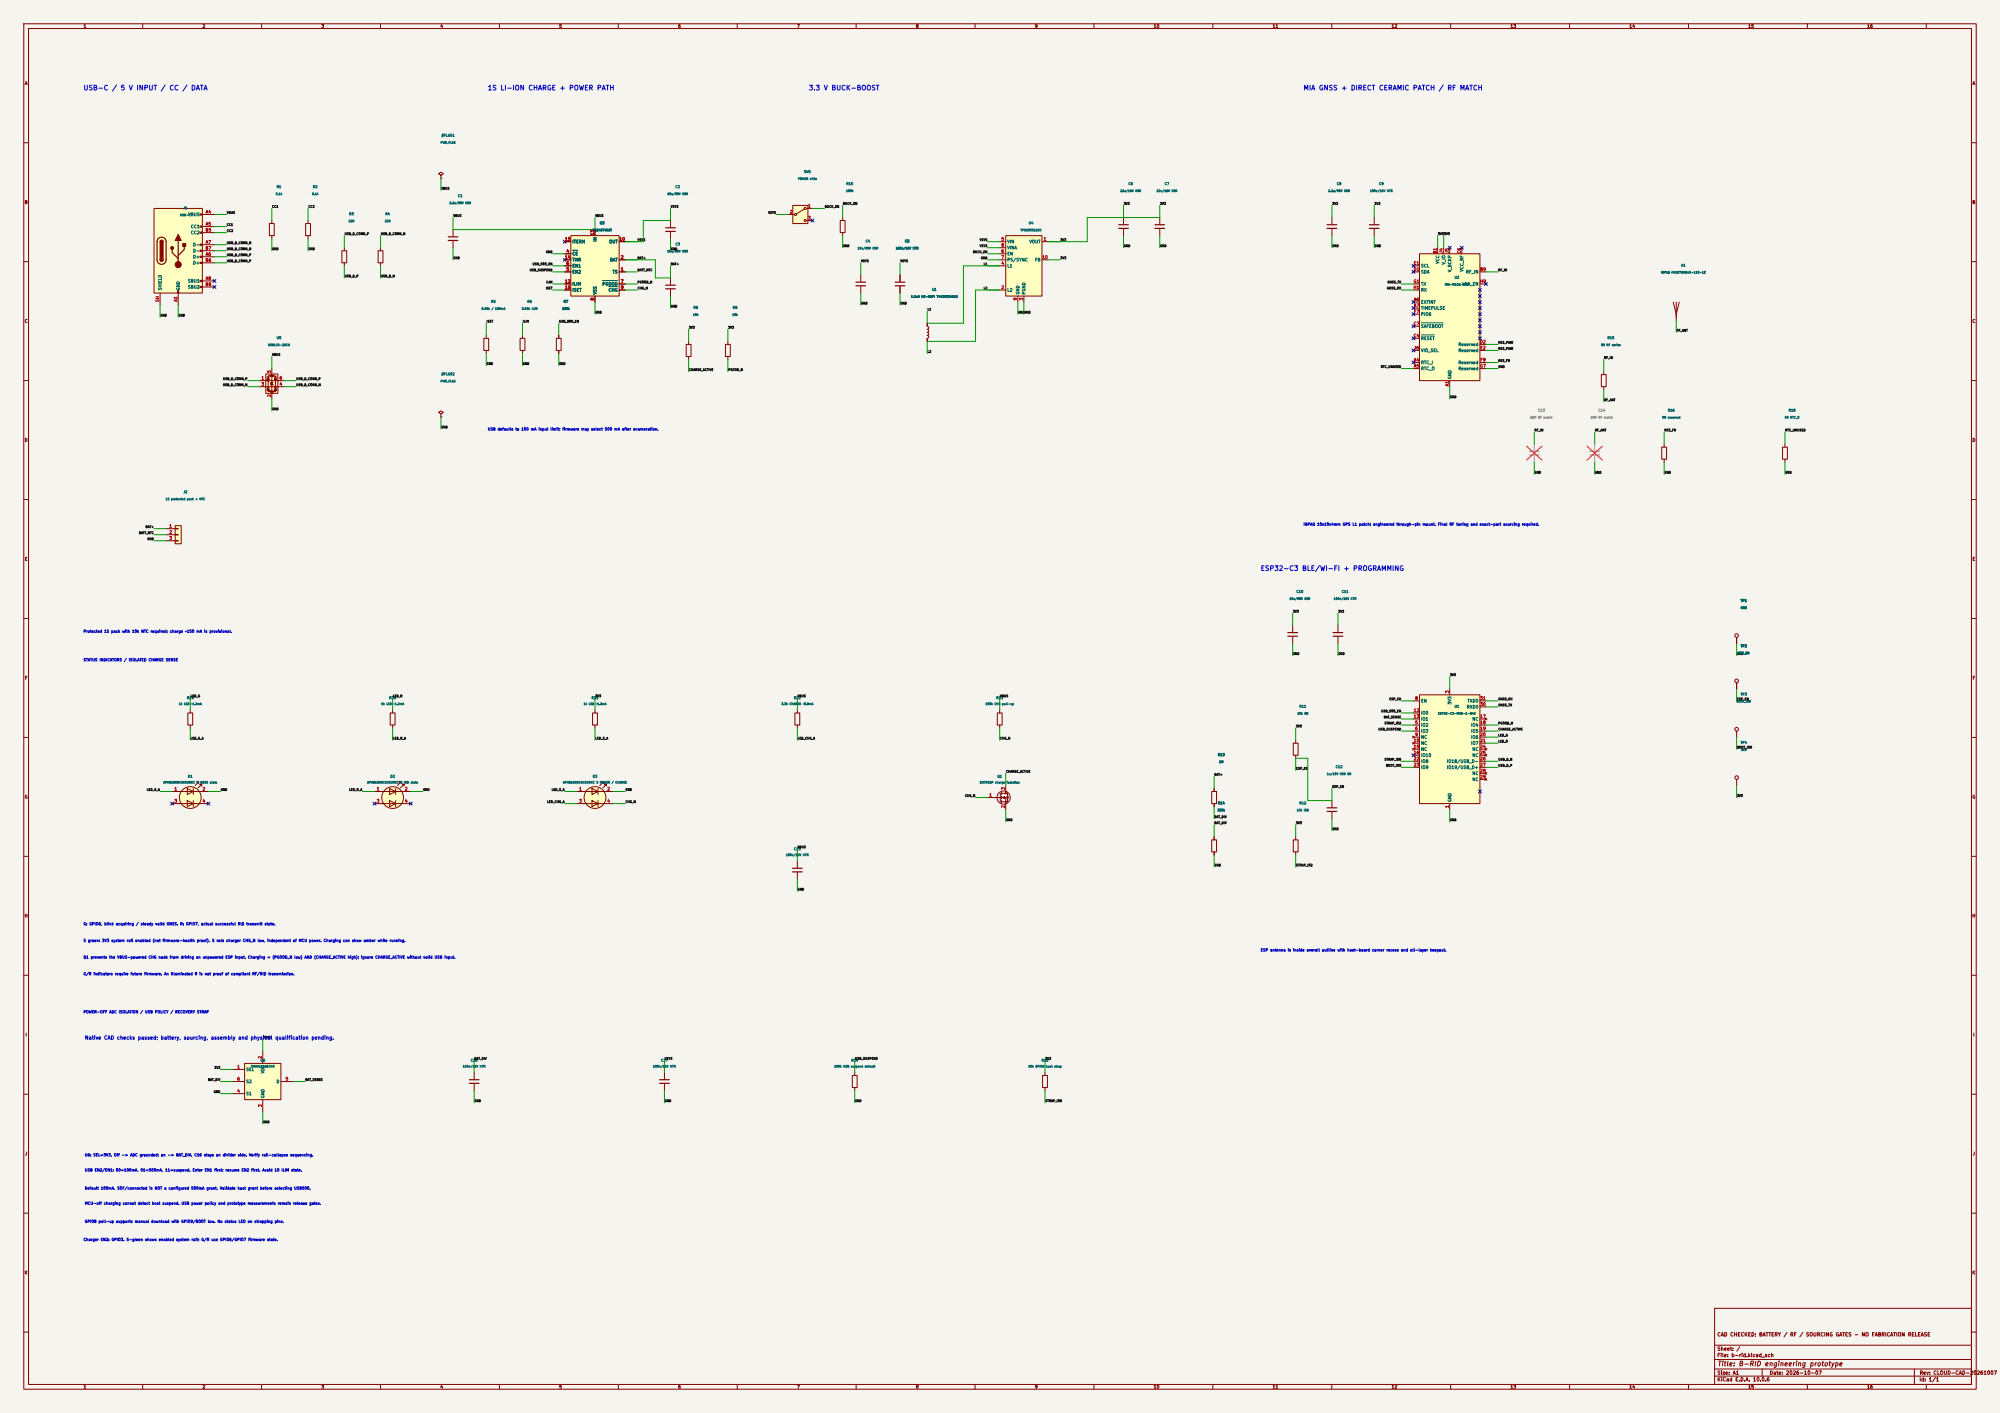
[picture p116: page 1]

USB-C / 5 V INPUT / CC / DATA

1S LI-ION CHARGE + POWER PATH

MIA GNSS + DIRECT CERAMIC PATCH / RF MATCH

USB defaults to 100 mA input limit; firmware may select 500 mA after enumeration.

INPAQ 10x10x4mm GPS L1 patch; engineered through-pin mount. Final RF tuning and exact-part sourcing required.

ESP32-C3 BLE/WI-FI + PROGRAMMING

Protected 1S pack with 10k NTC required; charge ~150 mA is provisional.

STATUS INDICATORS / ISOLATED CHARGE SENSE

G: GPIO6, blink acquiring / steady valid GNSS. R: GPIO7, actual successful RID transmit state.

G/R indicators require future firmware. An illuminated R is not proof of compliant RF/RID transmission. Q1 prevents the VBUS-powered CHG node from driving an unpowered ESP input. Charging = (PGOOD_N low) AND (CHARGE_ACTIVE high); ignore CHARGE_ACTIVE without valid USB input. S green: 3V3 system rail enabled (not firmware-health proof). S red: charger CHG_N low, independent of MCU power. Charging can show amber while running.

ESP antenna is inside overall outline with host-board corner recess and all-layer keepout.

POWER-OFF ADC ISOLATION / USB POLICY / RECOVERY STRAP

Native CAD checks passed; battery, sourcing, assembly and physical qualification pending.

U6: SEL=3V3. Off -> ADC grounded; on -> BAT_DIV. C16 stays on divider side. Verify rail-collapse sequencing.

USB EN2/EN1: 00=100mA, 01=500mA, 11=suspend. Enter EN1 first; resume EN2 first. Avoid 10 ILIM state. Default 100mA. SOF/connected is NOT a configured 500mA grant. Validate host grant before selecting USB500. MCU-off charging cannot detect host suspend. USB power policy and prototype measurements remain release gates.

GPIO8 pull-up supports manual download with GPIO9/BOOT low. No status LED on strapping pins.

Charger EN2: GPIO3. S-green shows enabled system rail; G/R use GPIO6/GPIO7 firmware state.

CAD CHECKED; BATTERY / RF / SOURCING GATES - NO FABRICATION RELEASE

Sheet: /
File: b-rid.kicad_sch
Title: B-RID engineering prototype
