chenguoming1/h743-controllers/self-balancing/documents/H743-Wired-Schematic.pdf

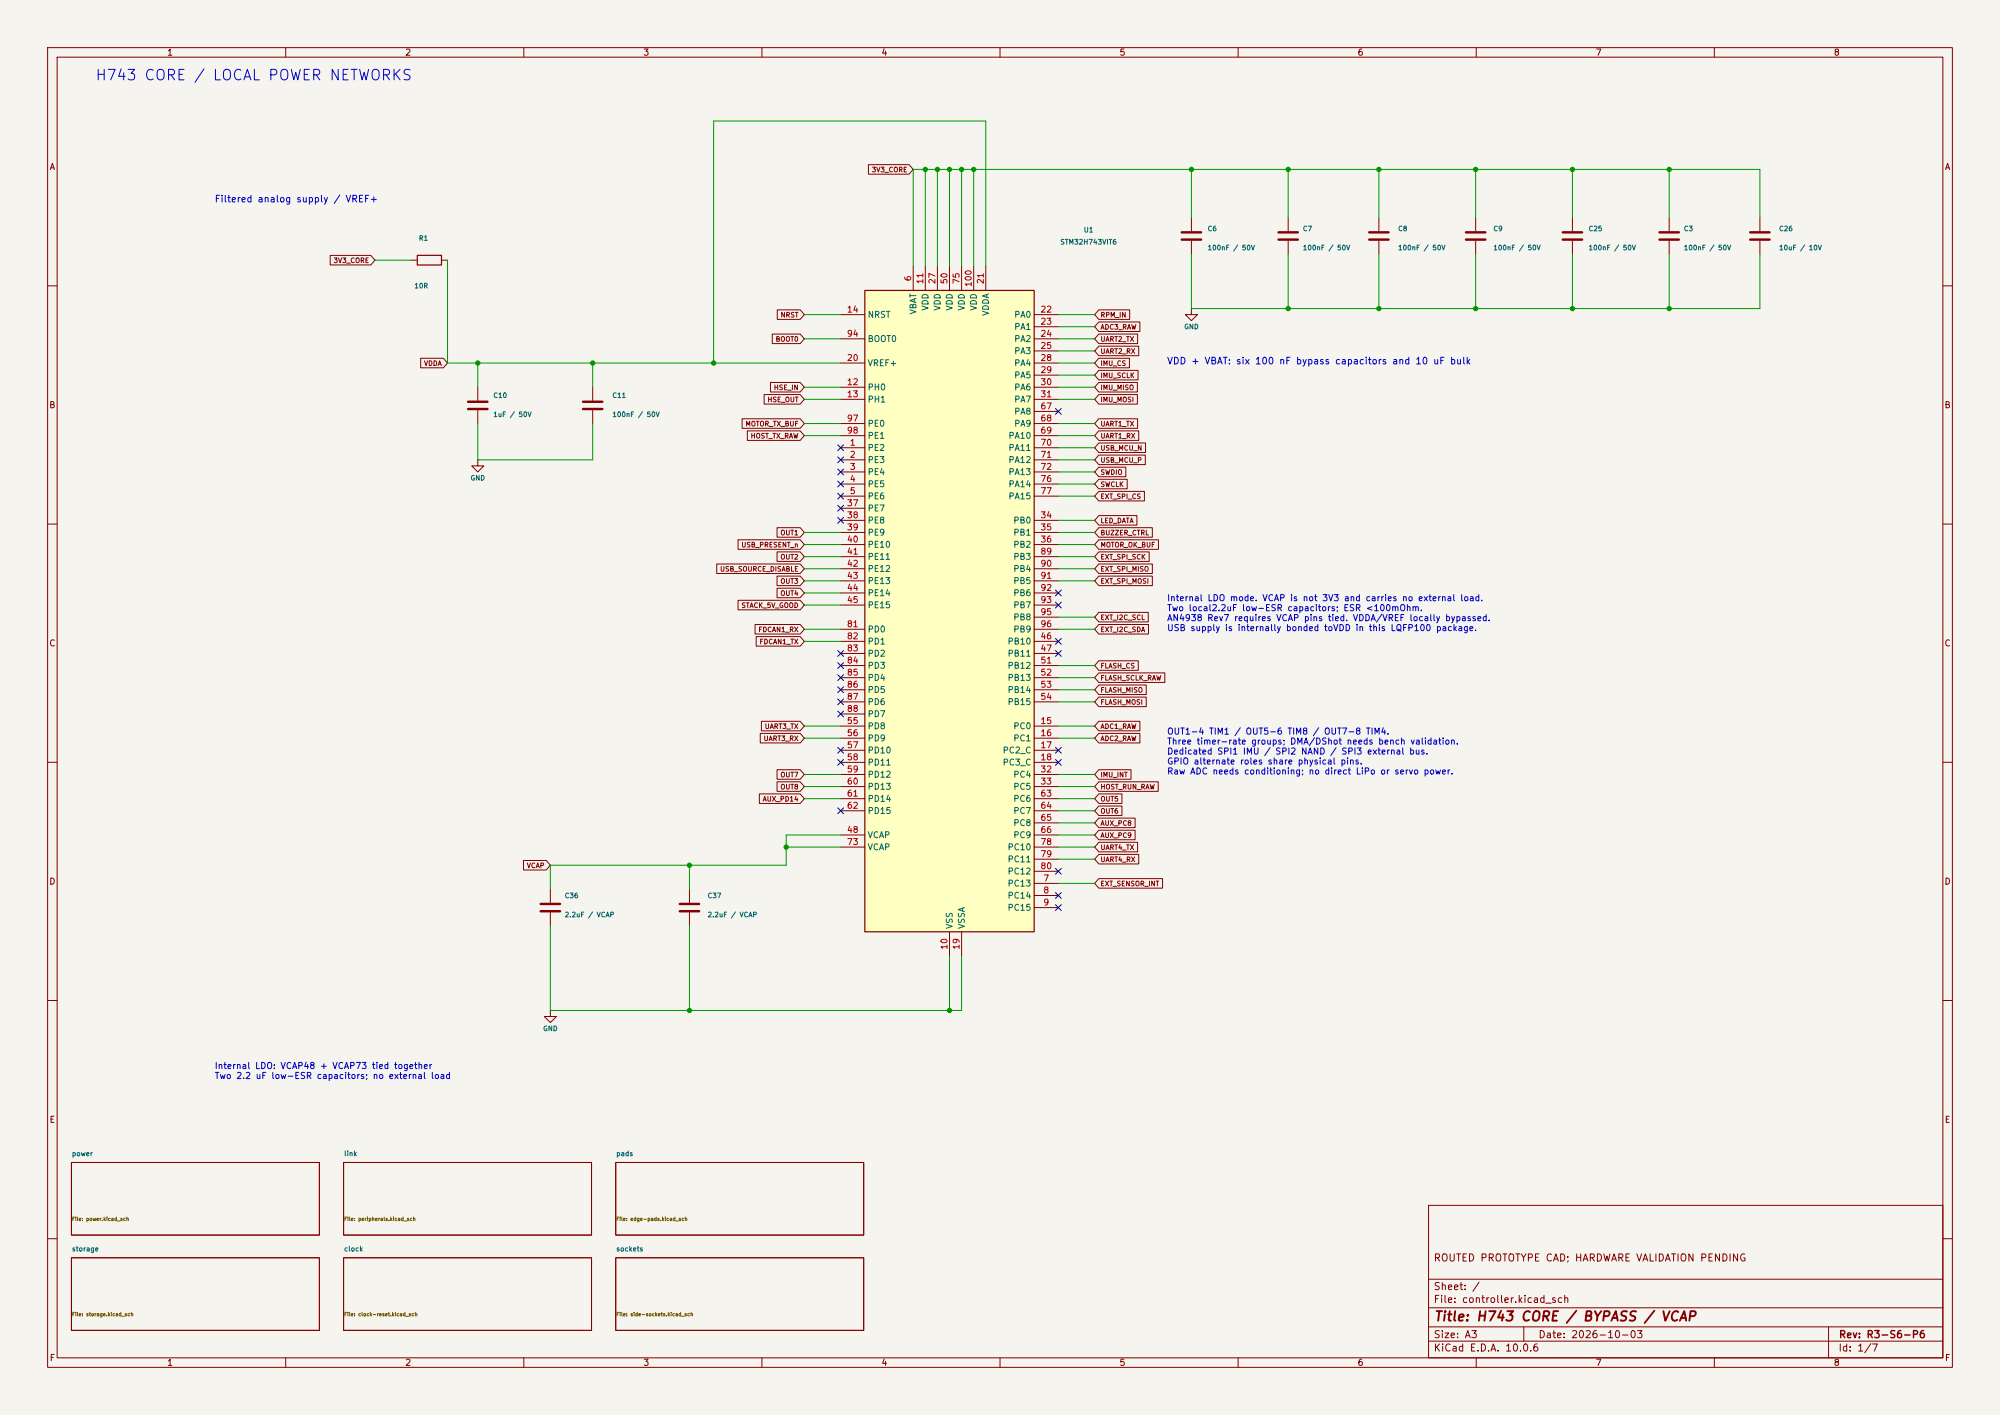
[picture p126: page 1]

Filtered analog supply / VREF+ H743 CORE / LOCAL POWER NETWORKS

VDD + VBAT: six 100 nF bypass capacitors and 10 uF bulk

Internal LDO mode. VCAP is not 3V3 and carries no external load. Two local2.2uF low-ESR capacitors; ESR <100mOhm. AN4938 Rev7 requires VCAP pins tied. VDDA/VREF locally bypassed. USB supply is internally bonded toVDD in this LQFP100 package.

OUT1-4 TIM1 / OUT5-6 TIM8 / OUT7-8 TIM4. Three timer-rate groups; DMA/DShot needs bench validation. Dedicated SPI1 IMU / SPI2 NAND / SPI3 external bus. GPIO alternate roles share physical pins. Raw ADC needs conditioning; no direct LiPo or servo power.

Internal LDO: VCAP48 + VCAP73 tied together Two 2.2 uF low-ESR capacitors; no external load

File: edge-pads.kicad_sch sockets

File: clock-reset.kicad_sch storage

ROUTED PROTOTYPE CAD; HARDWARE VALIDATION PENDING

Sheet: /
File: controller.kicad_sch
Title: H743 CORE / BYPASS / VCAP

Size: A3 | Rev: R3-S6-P6 | F Date: 2026-10-03
KiCad E.D.A. 10.0.6 | Id: 1/7

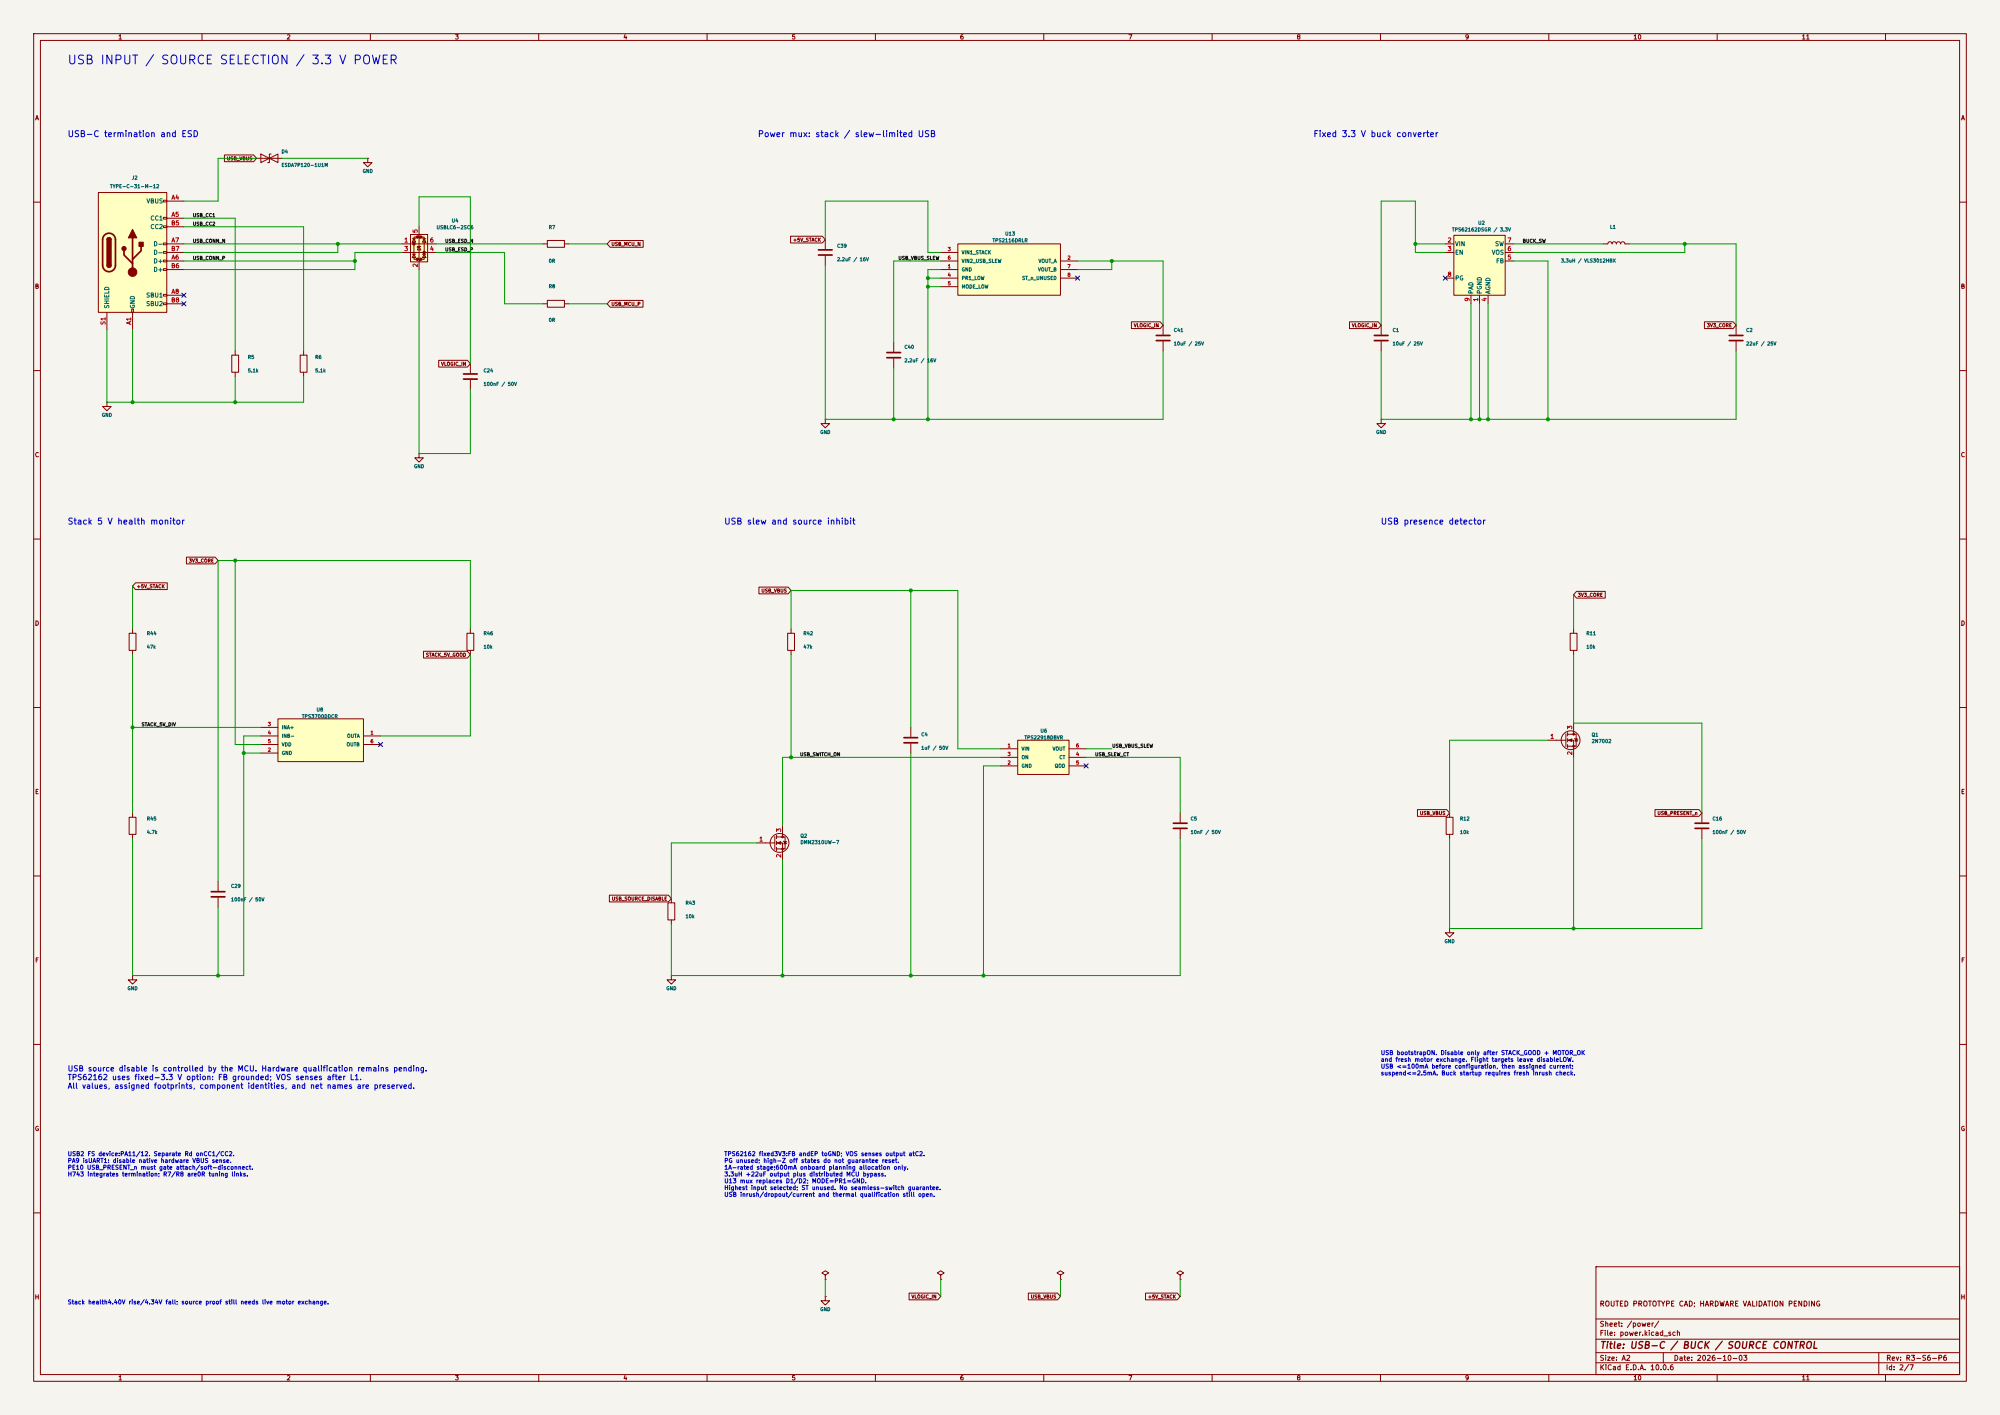
[picture p127: page 2]

USB INPUT / SOURCE SELECTION / 3.3 V POWER

USB-C termination and ESD

USB slew and source inhibit

and fresh motor exchange. Flight targets leave disableLOW. USB <=100mA before configuration, then assigned current; suspend<=2.5mA. Buck startup requires fresh inrush check.

USB source disable is controlled by the MCU. Hardware qualification remains pending.
TPS62162 uses fixed-3.3 V option: FB grounded; VOS senses after L1.

USB2 FS device:PA11/12. Separate Rd onCC1/CC2. PA9 isUART1: disable native hardware VBUS sense. PE10 USB_PRESENT_n must gate attach/soft-disconnect. H743 integrates termination; R7/R8 are0R tuning links. Stack health4.40V rise/4.34V fall; source proof still needs live motor exchange.

ROUTED PROTOTYPE CAD; HARDWARE VALIDATION PENDING

Sheet: /power/
File: power.kicad_sch
Title: USB-C / BUCK / SOURCE CONTROL

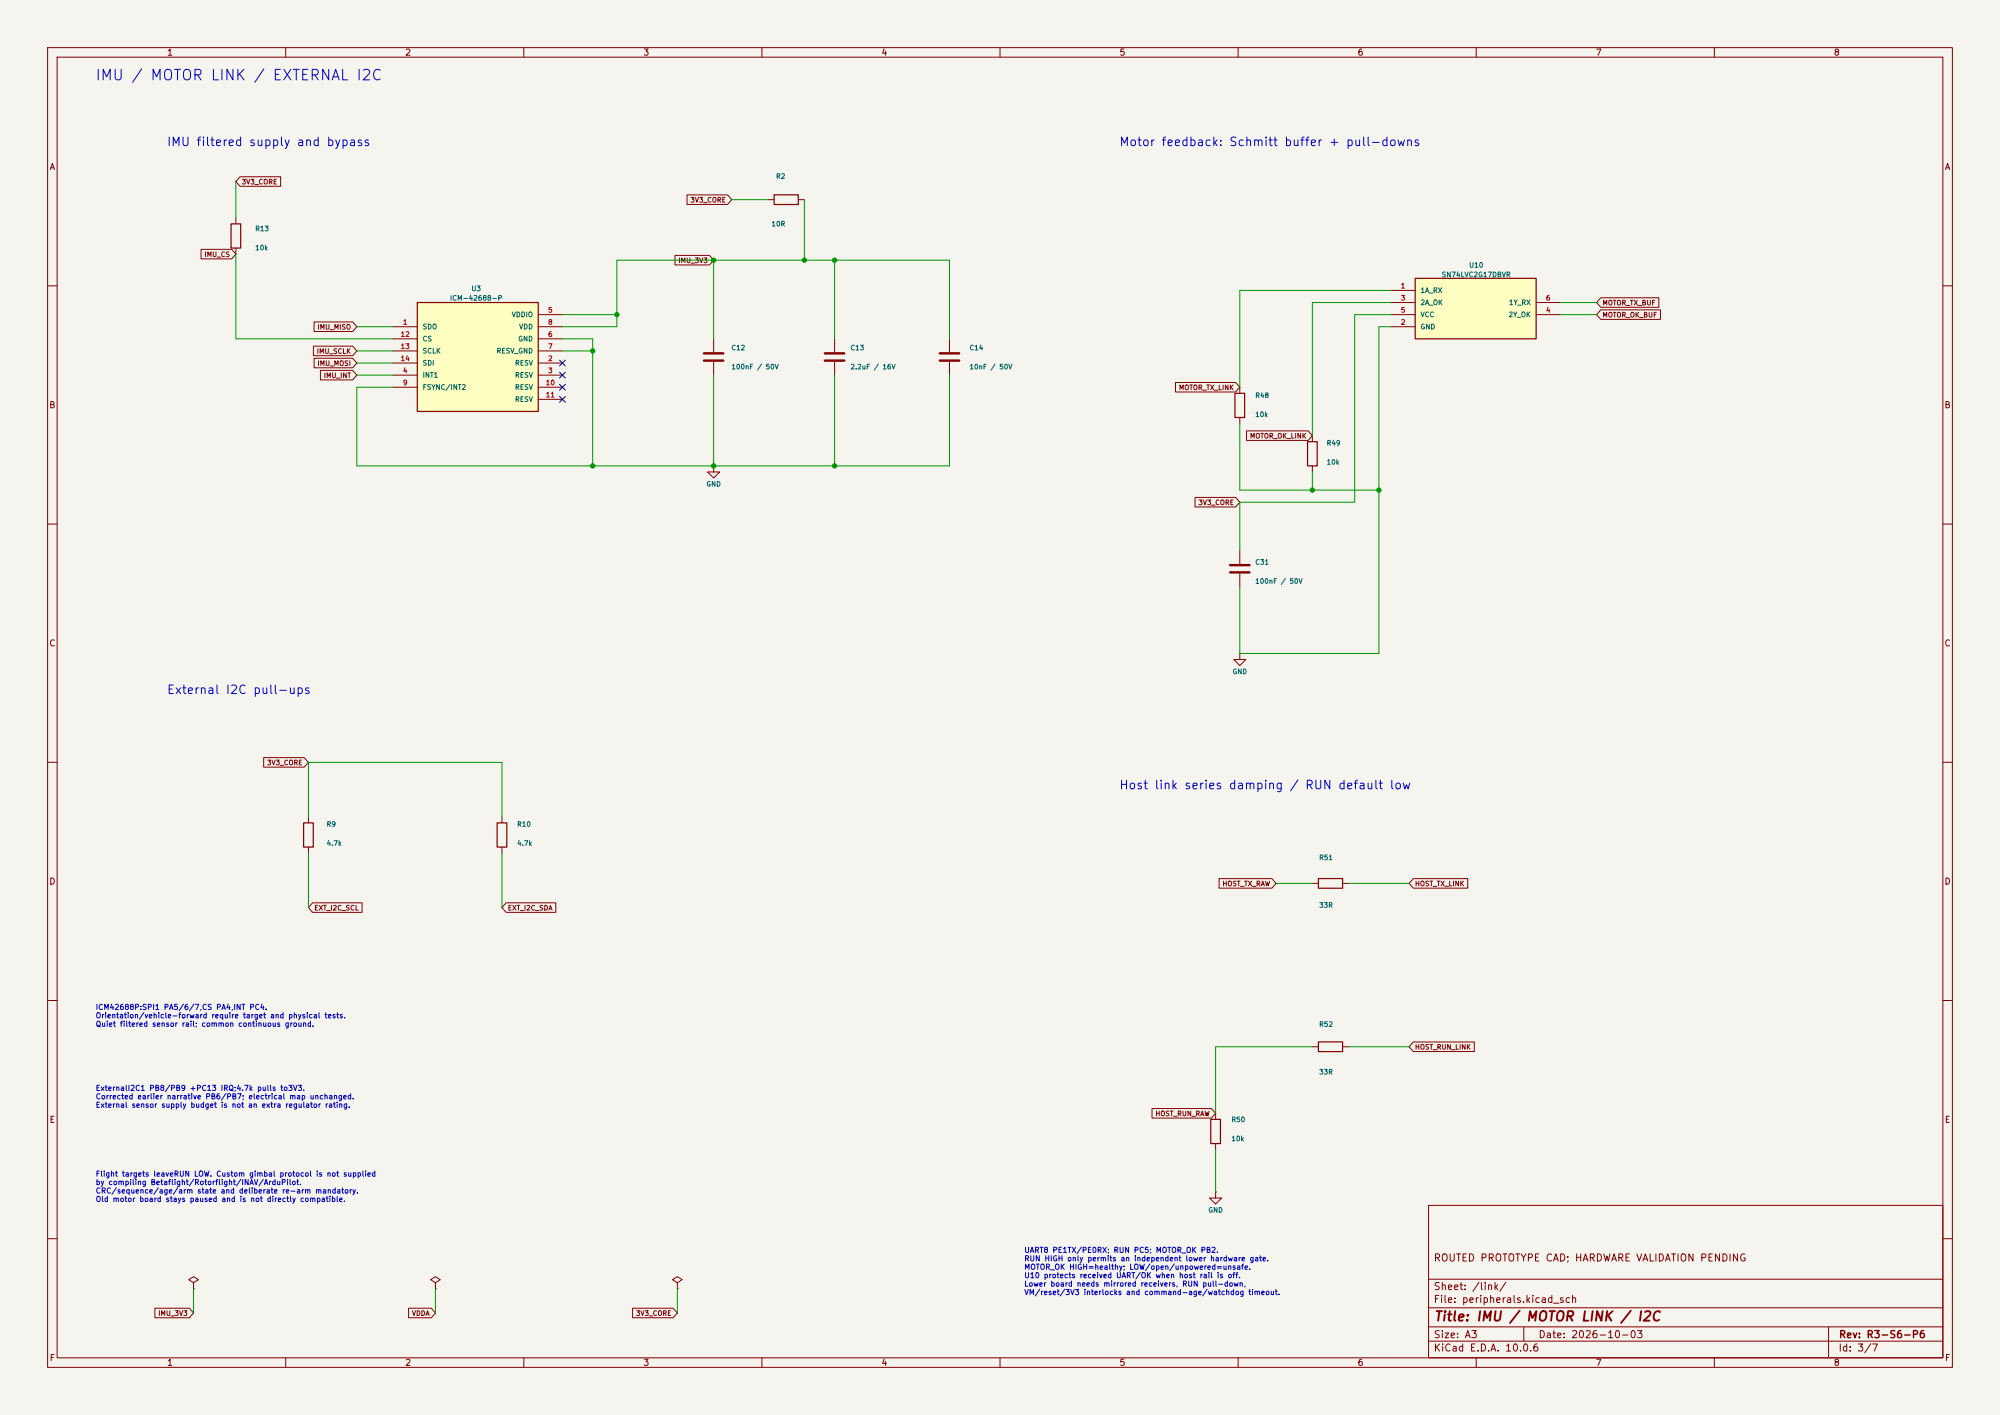
[picture p128: page 3]

IMU / MOTOR LINK / EXTERNAL I2C

IMU filtered supply and bypass

Host link series damping / RUN default low

ICM42688P:SPI1 PA5/6/7,CS PA4,INT PC4. Orientation/vehicle-forward require target and physical tests. Quiet filtered sensor rail; common continuous ground.

CRC/sequence/age/arm state and deliberate re-arm mandatory. Old motor board stays paused and is not directly compatible. ExternalI2C1 PB8/PB9 +PC13 IRQ;4.7k pulls to3V3. Corrected earlier narrative PB6/PB7; electrical map unchanged. External sensor supply budget is not an extra regulator rating.

Flight targets leaveRUN LOW. Custom gimbal protocol is not supplied
by compiling Betaflight/Rotorflight/INAV/ArduPilot.

UART8 PE1TX/PE0RX; RUN PC5; MOTOR_OK PB2. RUN HIGH only permits an independent lower hardware gate. MOTOR_OK HIGH=healthy; LOW/open/unpowered=unsafe. U10 protects received UART/OK when host rail is off. Lower board needs mirrored receivers, RUN pull-down, VM/reset/3V3 interlocks and command-age/watchdog timeout.

ROUTED PROTOTYPE CAD; HARDWARE VALIDATION PENDING

Sheet: /link/
File: peripherals.kicad_sch
Title: IMU / MOTOR LINK / I2C

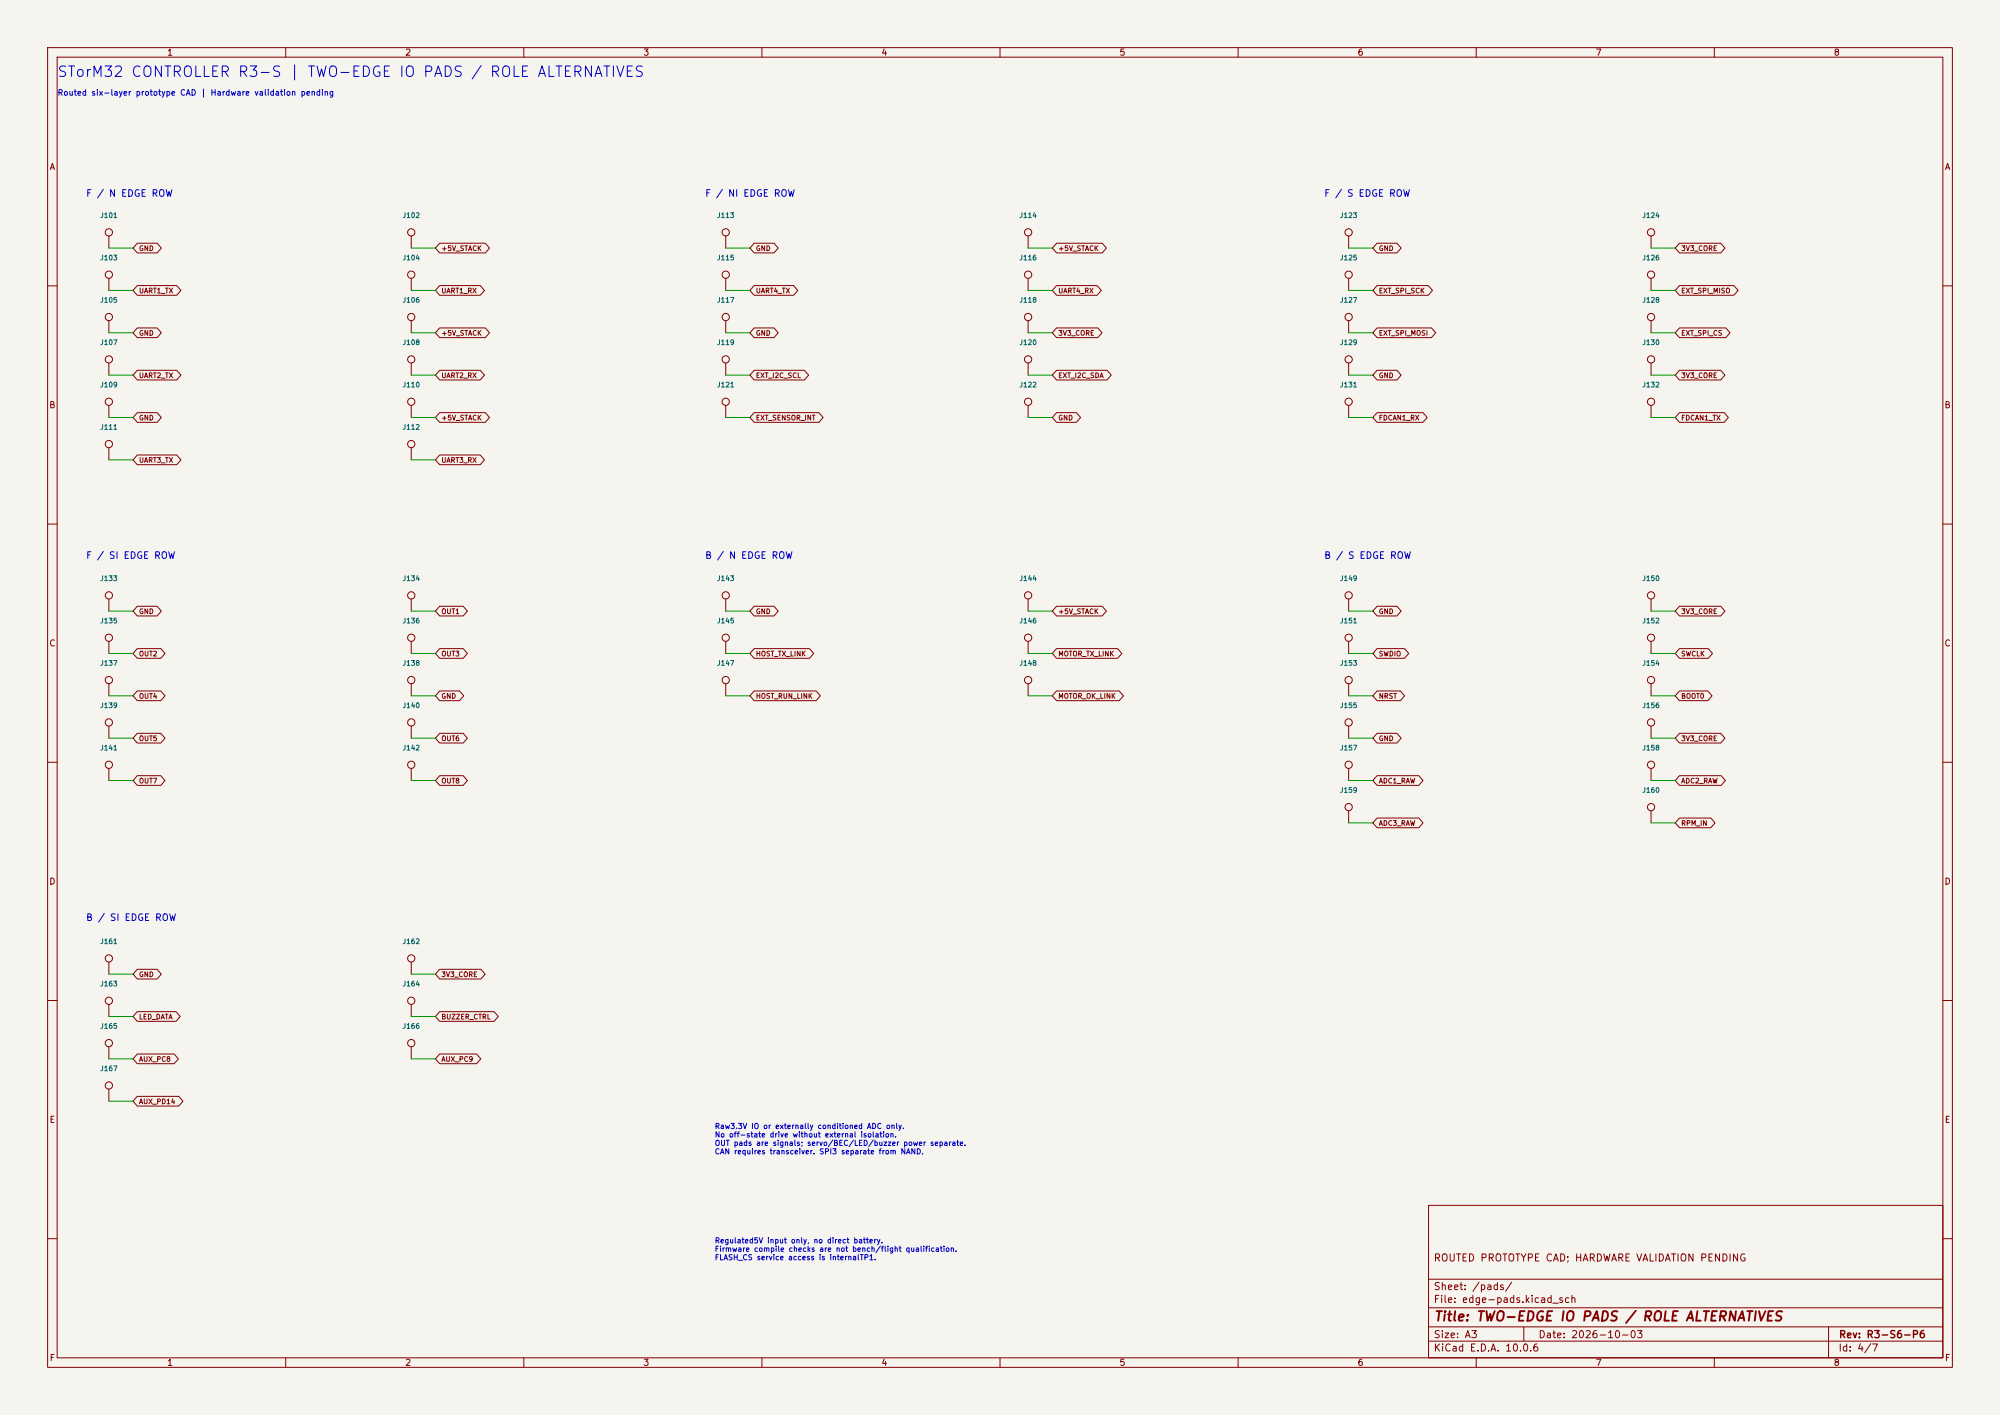
[picture p129: page 4]

Raw3.3V IO or externally conditioned ADC only. No off-state drive without external isolation. OUT pads are signals; servo/BEC/LED/buzzer power separate. CAN requires transceiver. SPI3 separate from NAND. Regulated5V input only, no direct battery. Firmware compile checks are not bench/flight qualification. FLASH_CS service access is internalTP1.

ROUTED PROTOTYPE CAD; HARDWARE VALIDATION PENDING

Sheet: /pads/
File: edge-pads.kicad_sch
Title: TWO-EDGE IO PADS / ROLE ALTERNATIVES

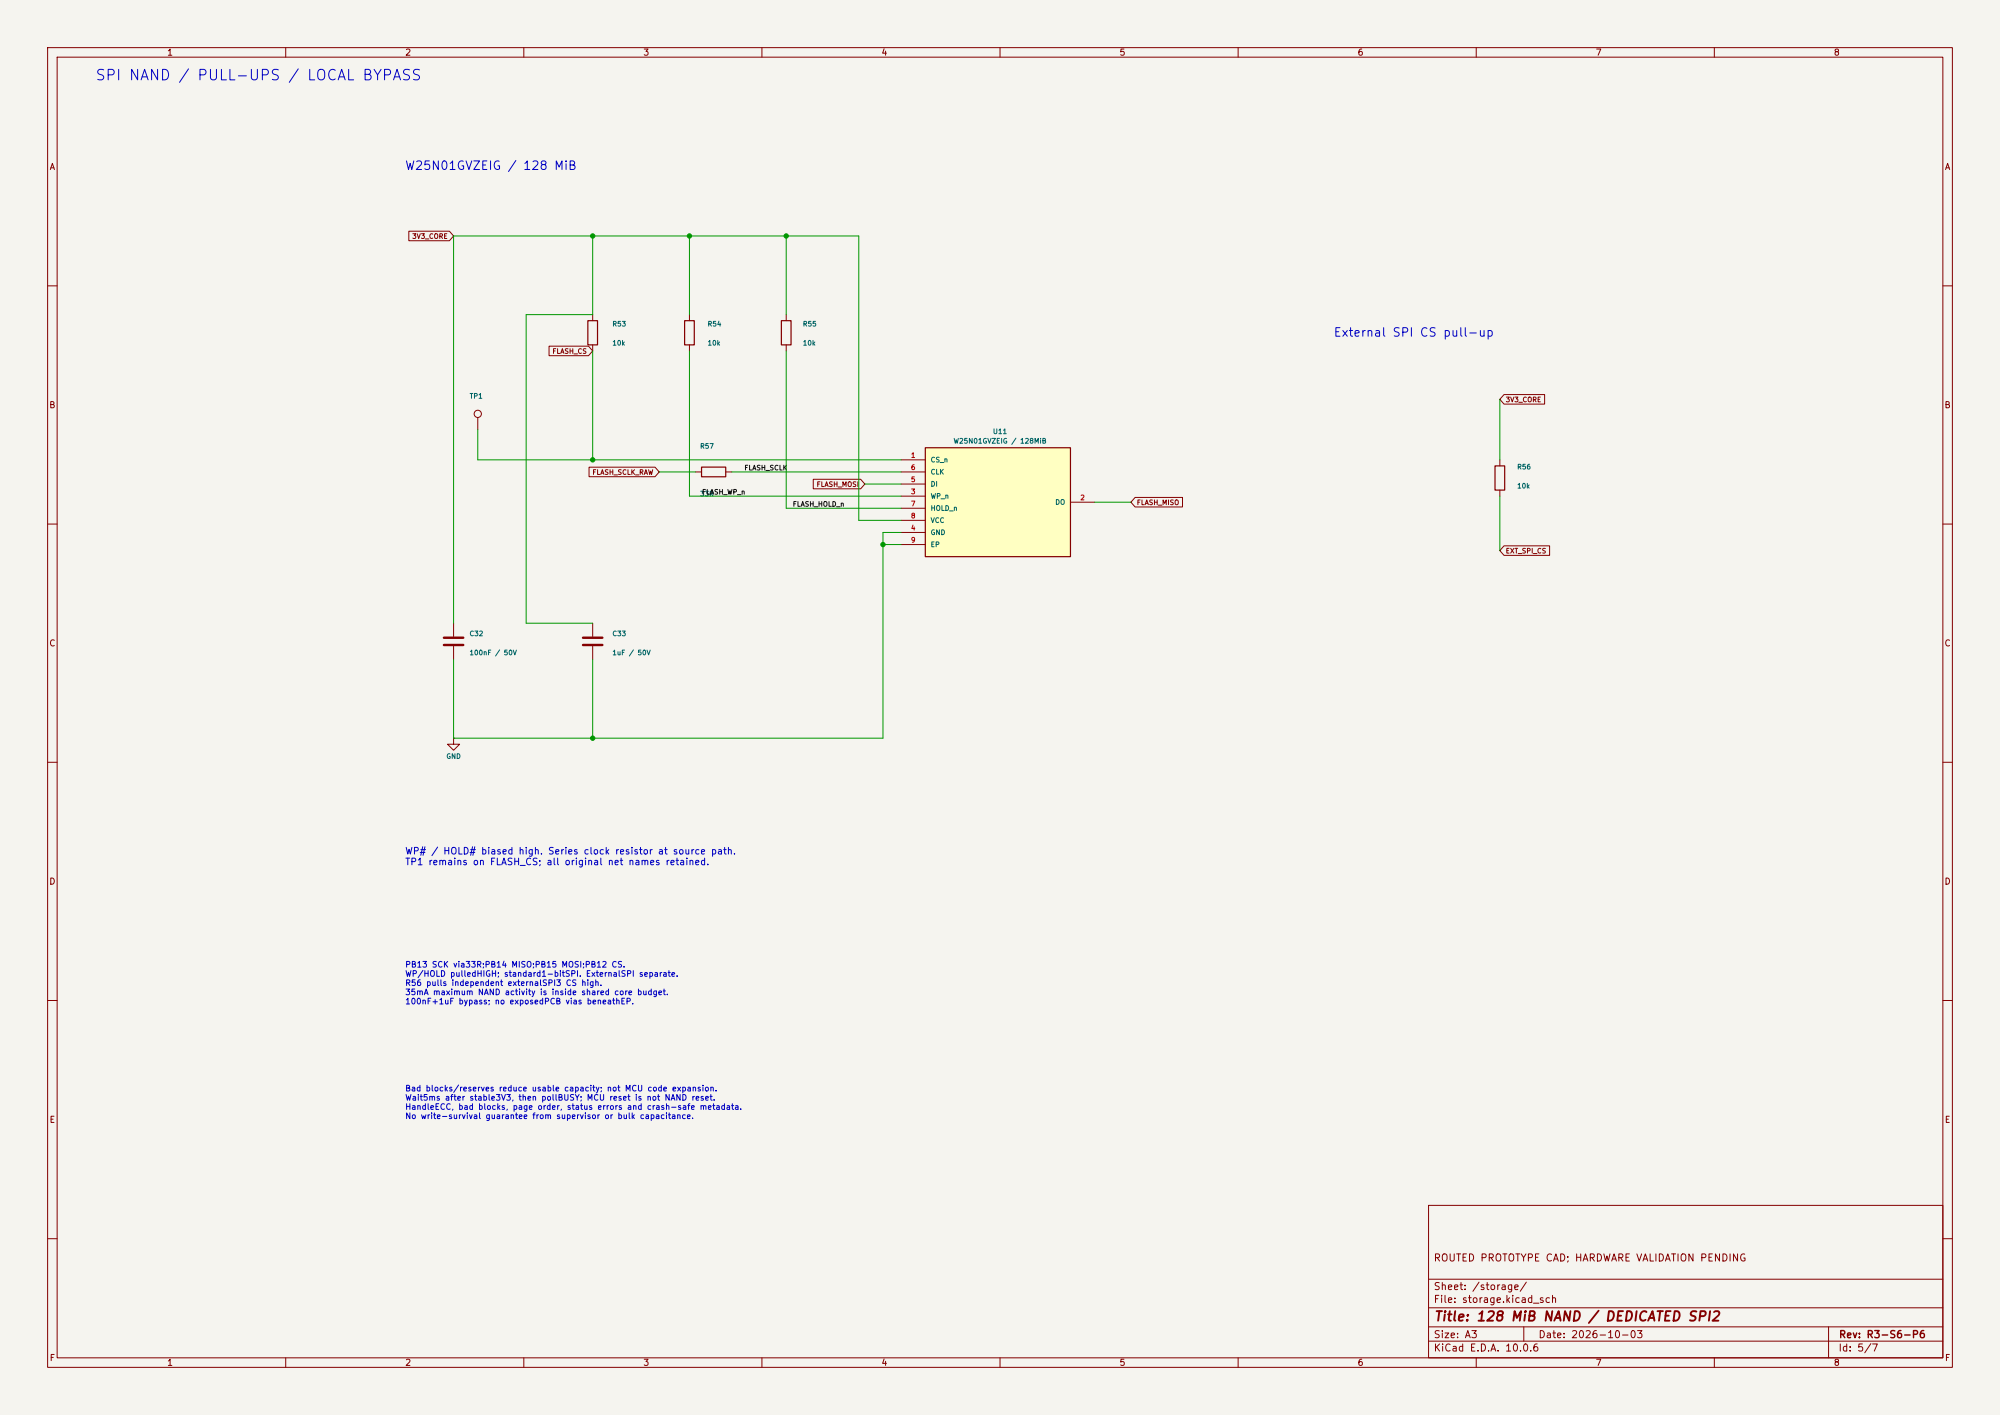
[picture p130: page 5]

SPI NAND / PULL-UPS / LOCAL BYPASS

FLASH_SCLK PB13 SCK via33R;PB14 MISO;PB15 MOSI;PB12 CS. WP/HOLD pulledHIGH; standard1-bitSPI. ExternalSPI separate. R56 pulls independent externalSPI3 CS high. 35mA maximum NAND activity is inside shared core budget. 100nF+1uF bypass; no exposedPCB vias beneathEP. Bad blocks/reserves reduce usable capacity; not MCU code expansion. Wait5ms after stable3V3, then pollBUSY; MCU reset is not NAND reset. HandleECC, bad blocks, page order, status errors and crash-safe metadata. No write-survival guarantee from supervisor or bulk capacitance.

ROUTED PROTOTYPE CAD; HARDWARE VALIDATION PENDING

Sheet: /storage/
File: storage.kicad_sch
Title: 128 MiB NAND / DEDICATED SPI2

AB

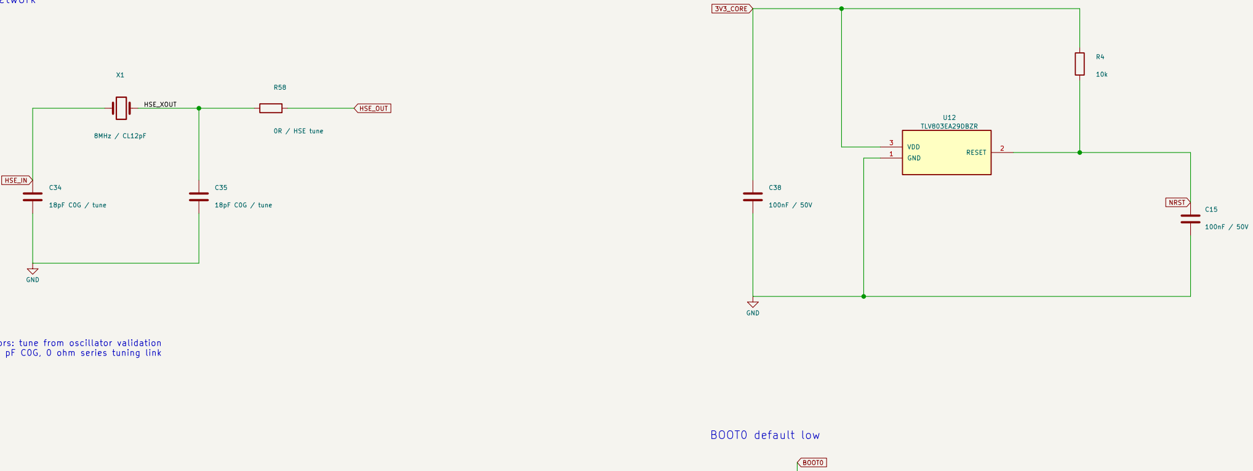
[picture p131: figure]
10k GND 1; RESET VDD; TLV803EA29DBZR; 0R / HSE tune C35; 18pF C0G / tune GND; 8MHz / CL12pF; GND; 18pF C0G / tune; BOOT0 HSE_IN

C

D

E

AB

C

D

E

# Title: 8MHz HSE / RESET / RECOVERY

## File: clock-reset.kicad_sch

## Sheet: /clock/

## ROUTED PROTOTYPE CAD; HARDWARE VALIDATION PENDING

R3

# 10k GND

HSE_OUT | NRST 3V3_CORE HSE_XOUT PH0pin12/PH1pin13; TXC A308000003:8MHz,CL12pF.

2x18pF assumes3pF effective stray; tune on hardware. ESR300Ohm,C0<=3pF preliminary gmcrit0.682mA/V. R58 drive-tuning position. Exact-lot/startup/drive checks remain.

InternalLDO mode; correctVOS/flash wait states/clocks. HSE_VALUE=8000000. 480MHz requires compatible silicon/temperature. BOOT_ADD0/1 recovery. SWD primary; verifyUSBDFU and cold power cycle. RUN PC5/source-disable PE12 selected away from ROM output drive. | EA29~2.93V open-drain reset,200ms release. NRST shared withSWD/reset pad;BOOT0 defaults10kLOW. EA29 avoids EA30 release-margin overlap with buck tolerance.
Interrupted NAND writes can still fail. Test brownout ramps. Crystal load capacitors: tune from oscillator validation Preserved values: 18 pF C0G, 0 ohm series tuning link | BOOT0 default low

## 8 MHz crystal network

# CLOCK / RESET / BOOT

## 2.9 V reset supervisor + pull-up / filter

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
# Title: SIDE SOCKETS / SHARED EDGE RESOURCES

## File: side-sockets.kicad_sch

## Sheet: /sockets/

## ROUTED PROTOTYPE CAD; HARDWARE VALIDATION PENDING

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
ANCHORS MP

J5 GPS / UART4

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
ANCHORS MP

J4
EXT SPI SENSOR

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
ANCHORS | MP
J3 MOTOR / 6-wire | GND

EXT_SPI_SCK

EXT_SPI_MISO

GND | EXT_SPI_MOSI

GND

3V3_CORE

UART4_RX UART4_TX GND +5V_STACK

MOTOR_OK_LINK MOTOR_TX_LINK HOST_RUN_LINK HOST_TX_LINK

GND | GND

GND +5V_STACK

EXT_SPI_CS

## EXT_SENSOR_INT J4 EXTERNALSPI SENSOR:JST8, rearwest

Friction retention; correct crimps and independent strain relief. J3 usesZYA1001H mate; mated envelope/cross-mating unqualified. J4/J5 plainSHR-08V-S/SHR-04V-S; use rated wire/contact combination. 2.9mm headers;JST mated2.95mm. Plan4mm rear airgap plus opposite parts. USBovermold/harness/stack checks remain. Power off before mating.

# STorM32 CONTROLLER R3-S | SIDE SOCKETS / SHARED EDGE RESOURCES

1 3V3 /2GND /3SCK /4MOSI /5MISO /6CS /7IRQ /8GND. DuplicatesSPI3 andPC13 IRQ pads. Not an independent sensor bus. One selectedCS/IRQ owner; do not parallel push-pull outputs. Short cable,3.3V, no off-state drive. No qualified spare power allowance. External sensor driver/clock/damping require target and bench tests. 1 5V_STACK output /2GND /3controllerTX /4controllerRX. TX goes to moduleRX and viceversa; signals3.3V. No5V onUSB-only power; do not connect a competing supply.

CompassI2C andPPS are not carried by this socket. Verify module cable pinout; no universalGPS plug compatibility.

J5 GPS UART4:JST4, reareast 1 5V_STACK input /2GND /3hostTX /4motorTX /5RUN /6MOTOR_OK. Duplicates existing link after damping and before receive buffer. Use socket OR pads for one endpoint. Anchors are not extra cable returns. Motor board needs protected inputs and default-off independent gate. J3 carries total controller+GPS supply current; no1A per-port allocation.

J3 MOTOR:Lian Xin6, rearwest; custom pinout Routed six-layer prototype CAD | Hardware validation pending
