chenguoming1/h743-controllers/self-balancing/documents/R3-S6-P6-Schematic.pdf

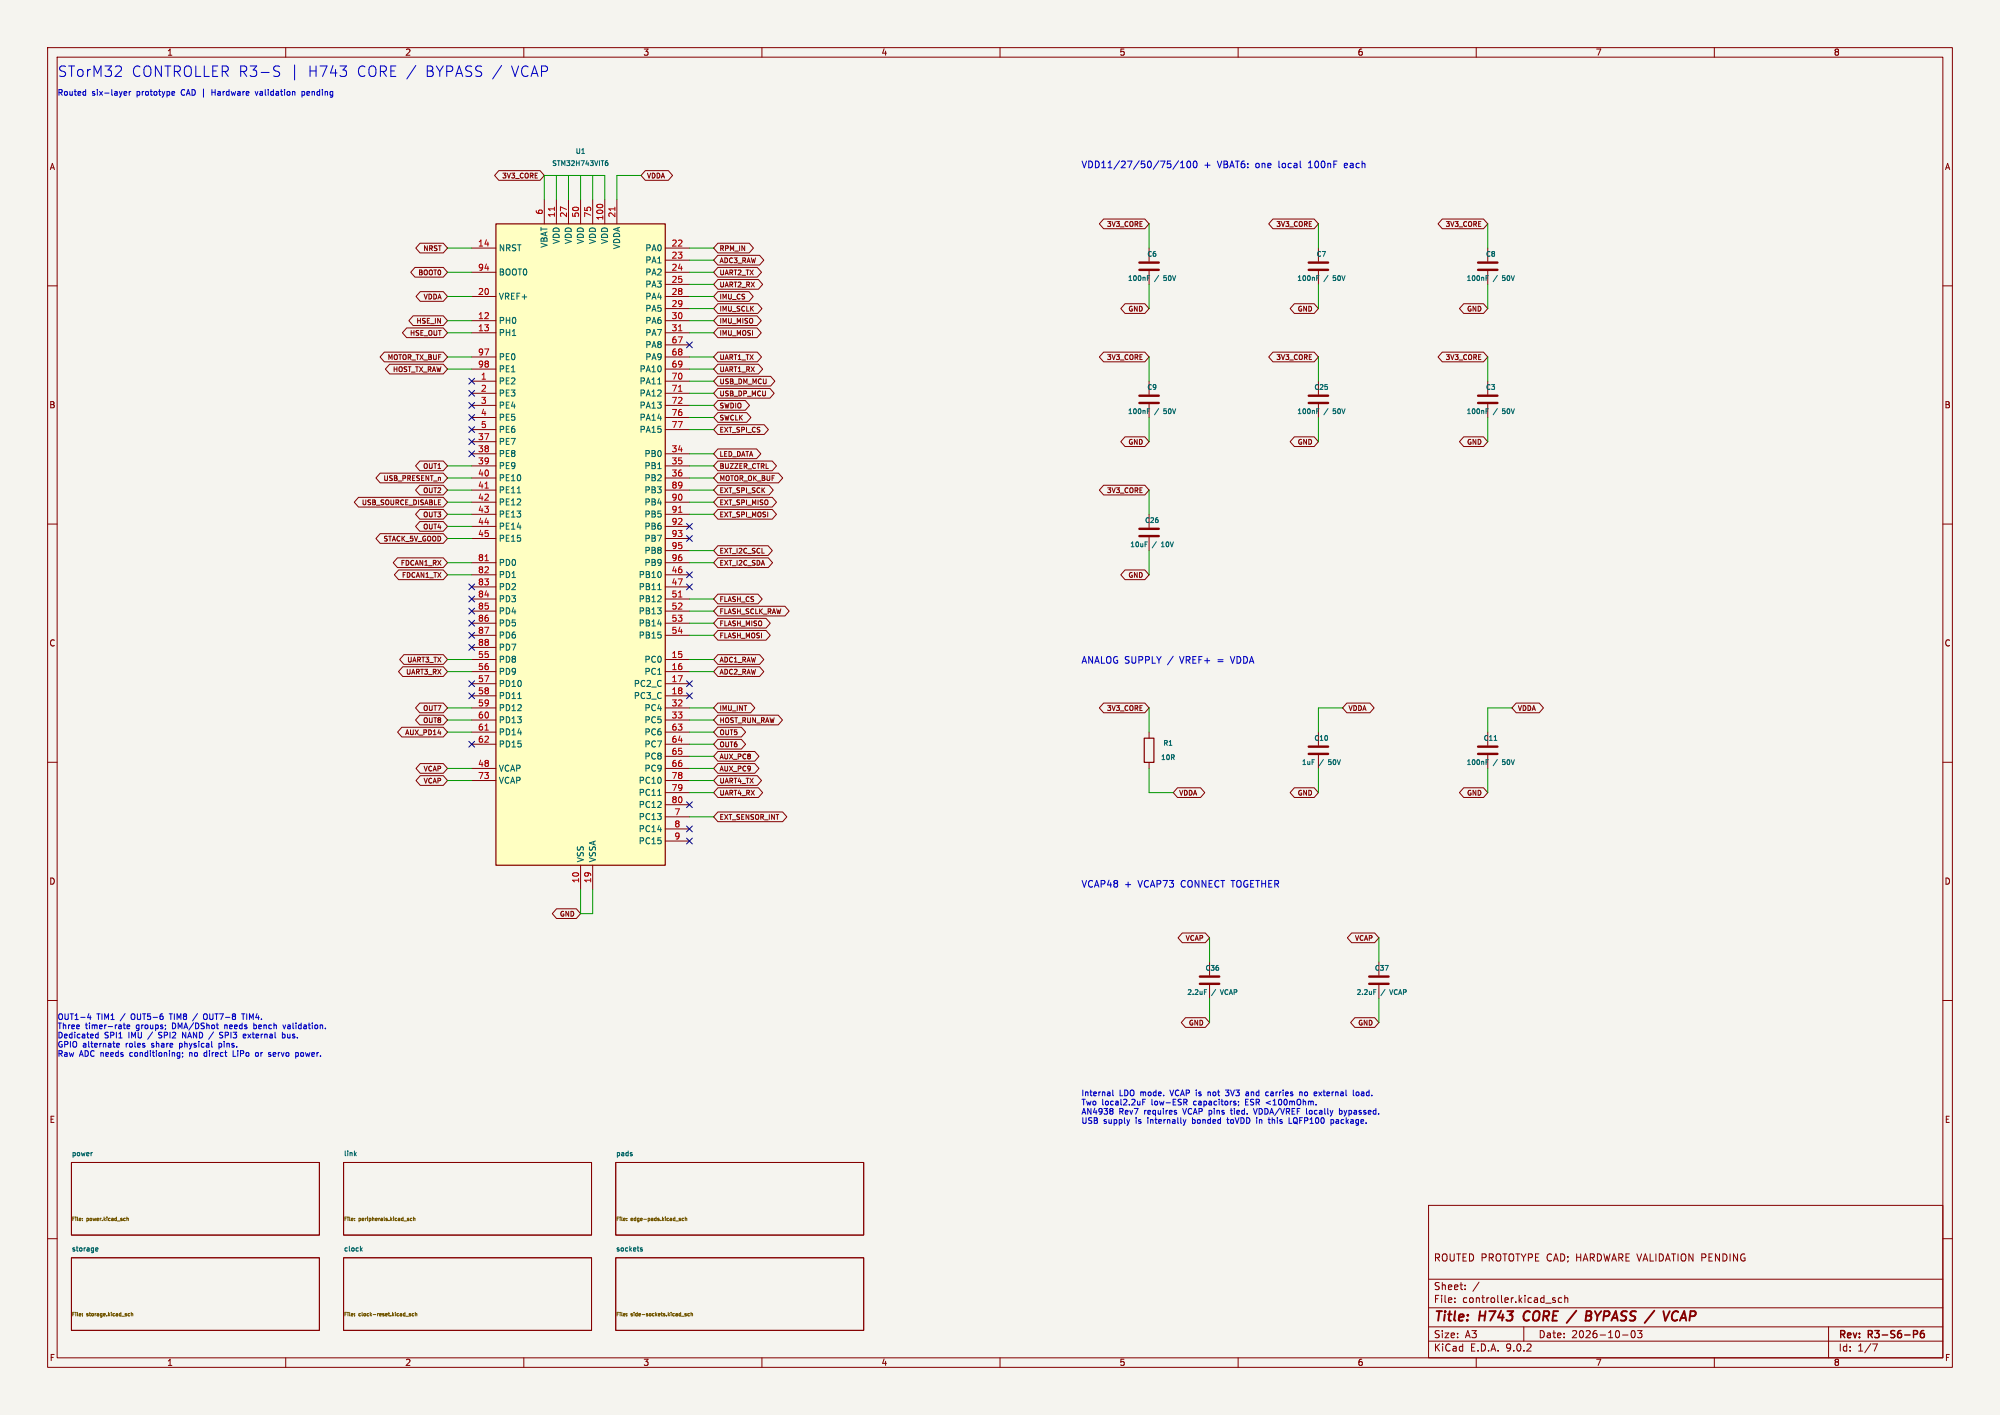
[picture p132: page 1]

STorM32 CONTROLLER R3-S | H743 CORE / BYPASS / VCAP

6 VDD 11 VDD 27 VDD 50 VSS 10 VDD 75 VSSA 19 VDD 100 VDDA 21 PA0 22 PA1 23 PA2 24 PA3 25 PA4 28 PA5 29 PA6 30 PA7 31 PA8 67 PA9 68 PA10 69 PA11 70 PA12 71 PA13 72 PA14 76 PA15 77 PB0 34 PB1 35 PB2 36 PB3 89 PB4 90 PB5 91 PB6 92 PB7 93 PB8 95 PB9 96 PB10 46 PB11 47 PB12 51 PB13 52 PB14 53 PB15 54 PC0 15 PC1 16 PC2_C 17 PC3_C 18 PC4 32 PC5 33 PC6 63 PC7 64 PC8 65 PC9 66 PC10 78 PC11 79 PC12 80 PC13 7 PC14 8 PC15 9

ANALOG SUPPLY / VREF+ = VDDA

File: edge-pads.kicad_sch power File: power.kicad_sch storage

Id: 1/7 Title: H743 CORE / BYPASS / VCAP

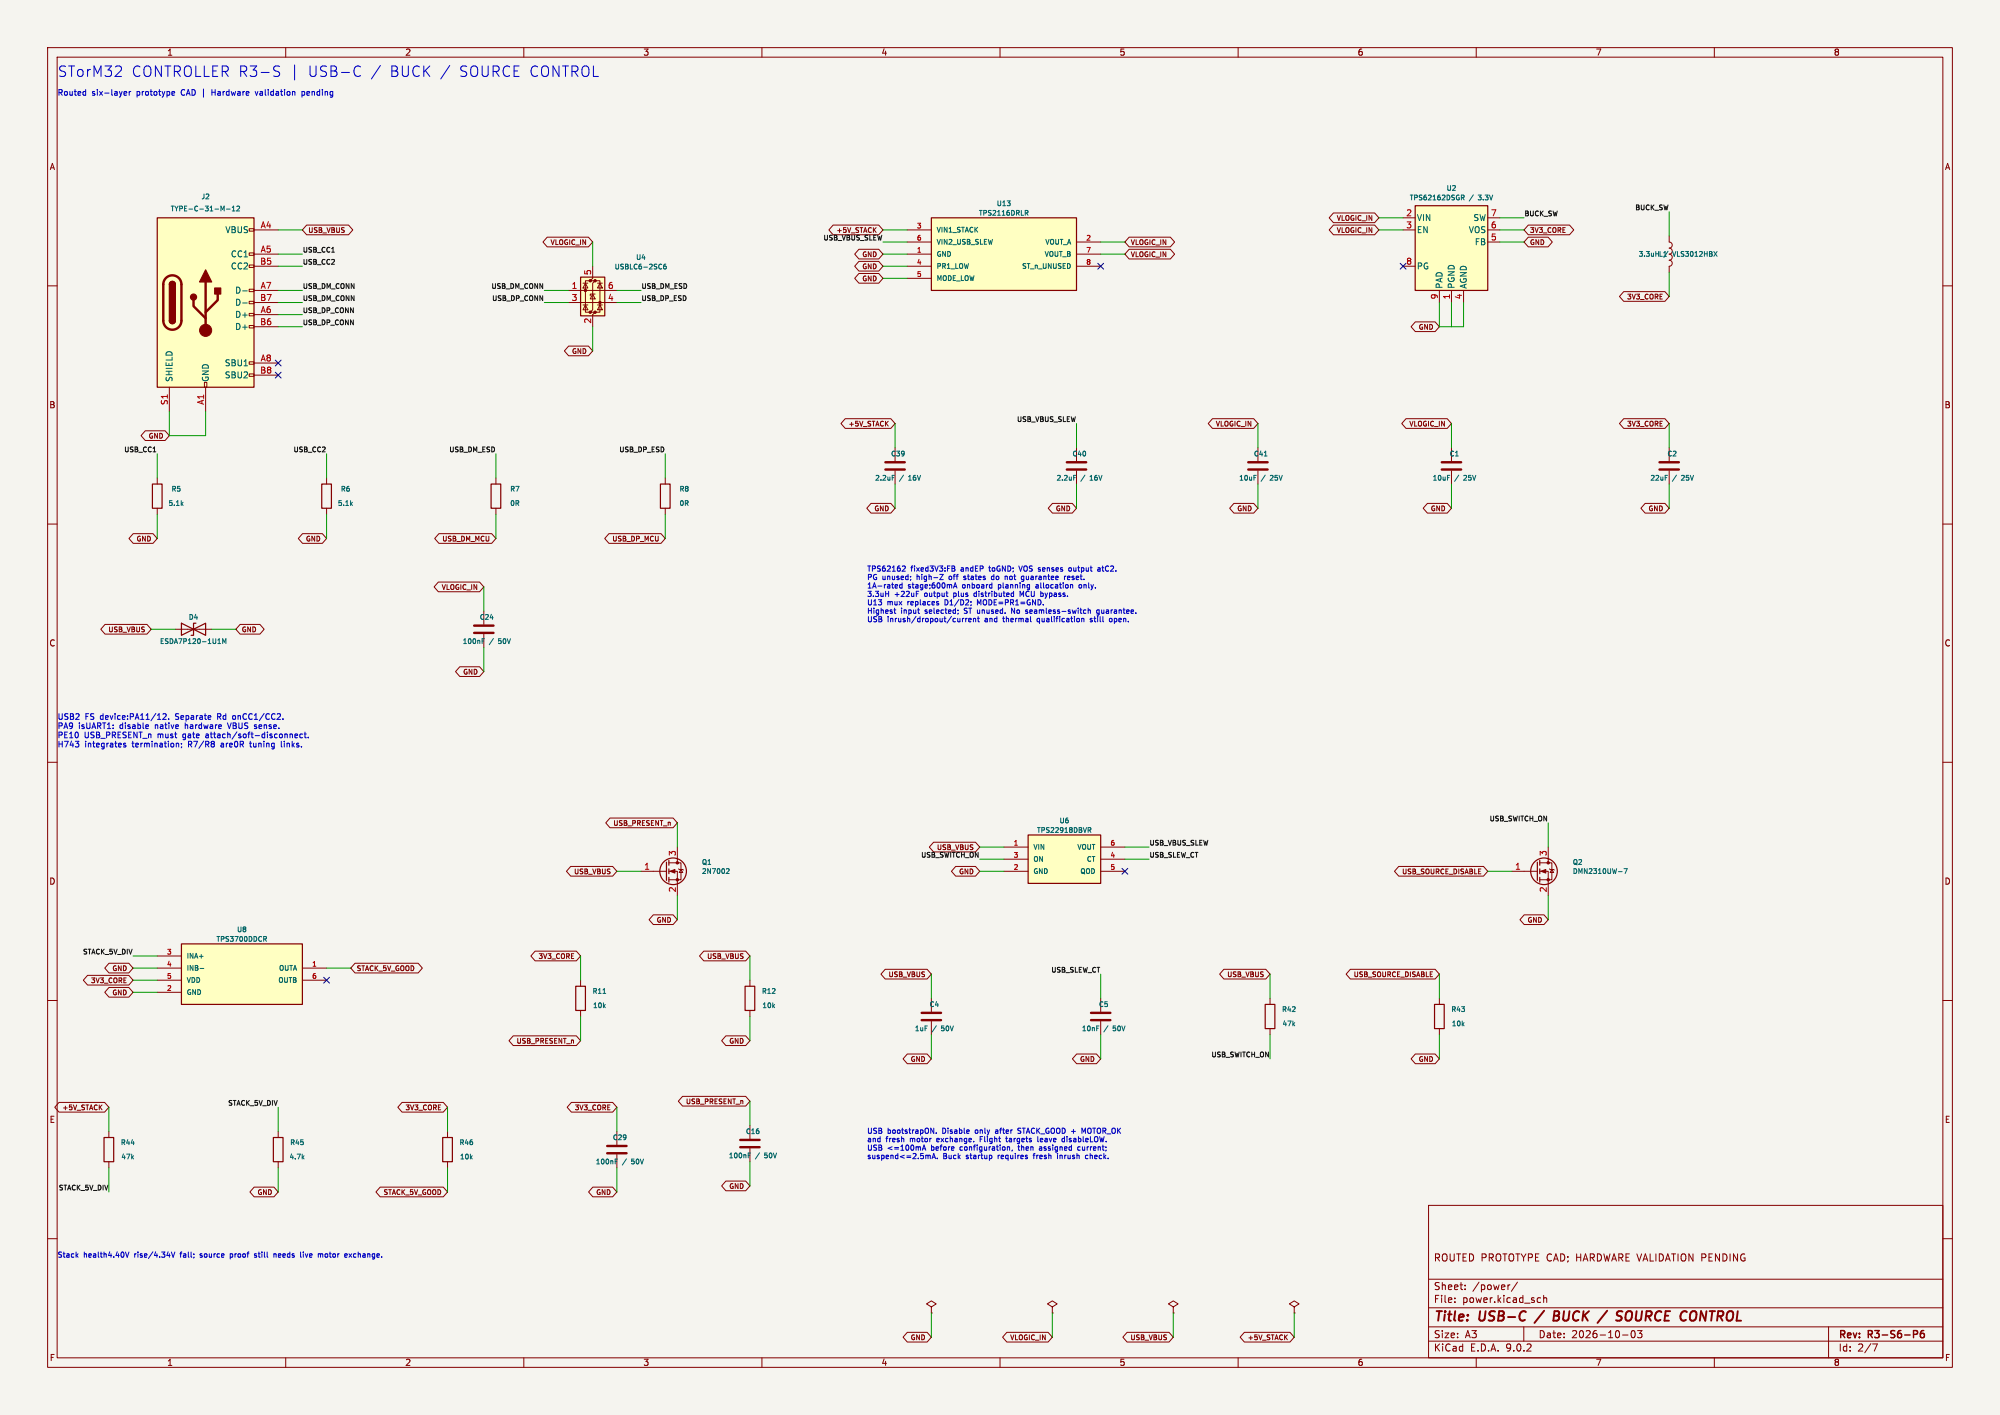
[picture p133: page 2]

Id: 2/7 Title: USB-C / BUCK / SOURCE CONTROL

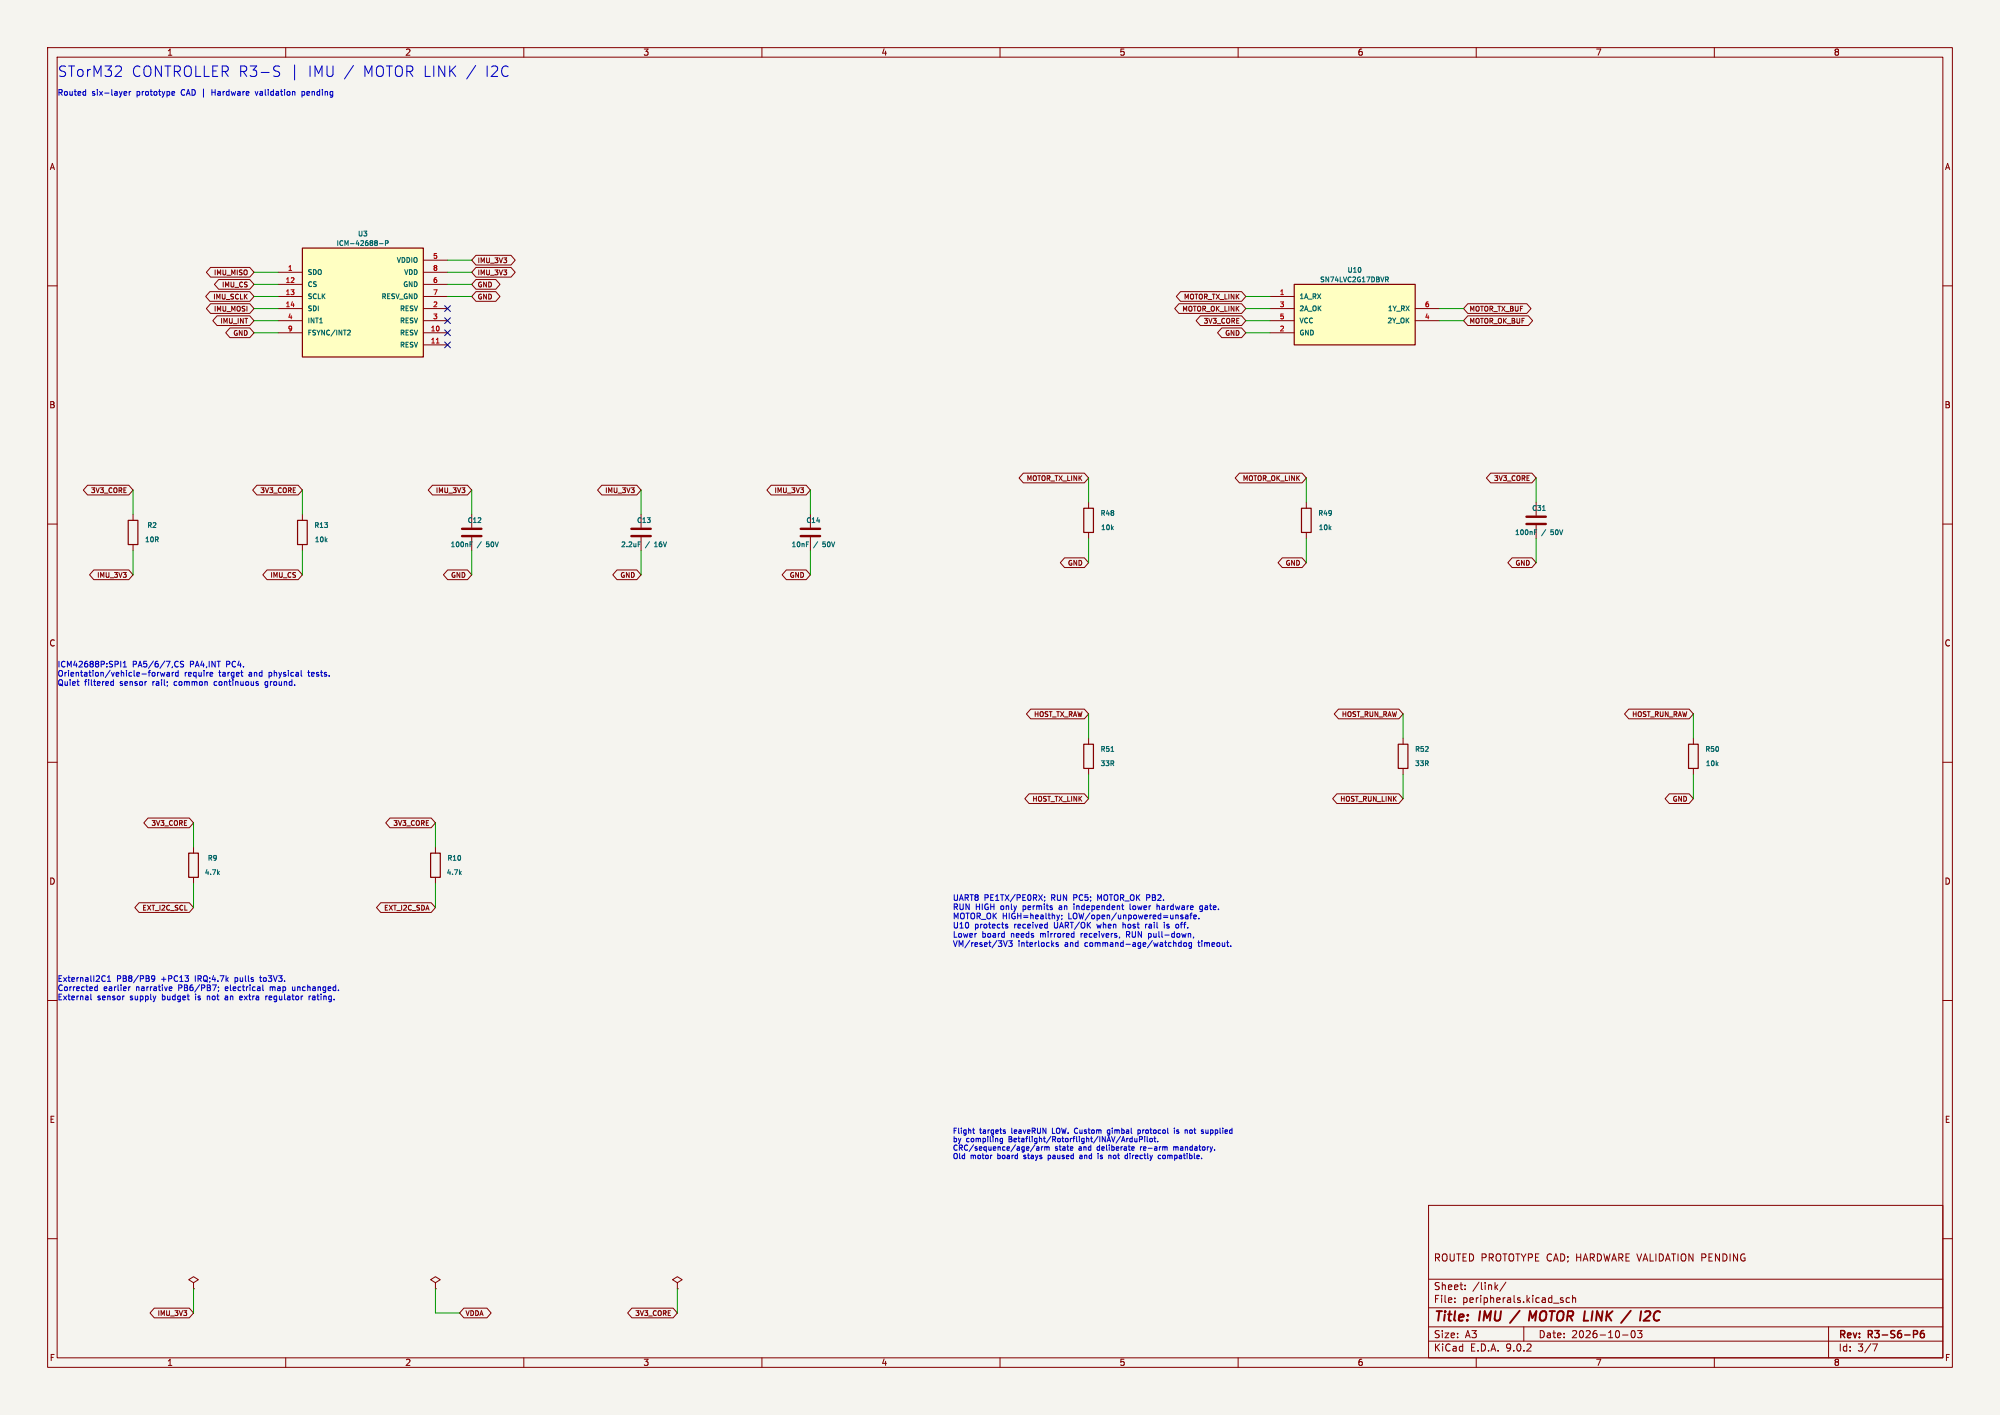
[picture p134: page 3]

Id: 3/7 Title: IMU / MOTOR LINK / I2C

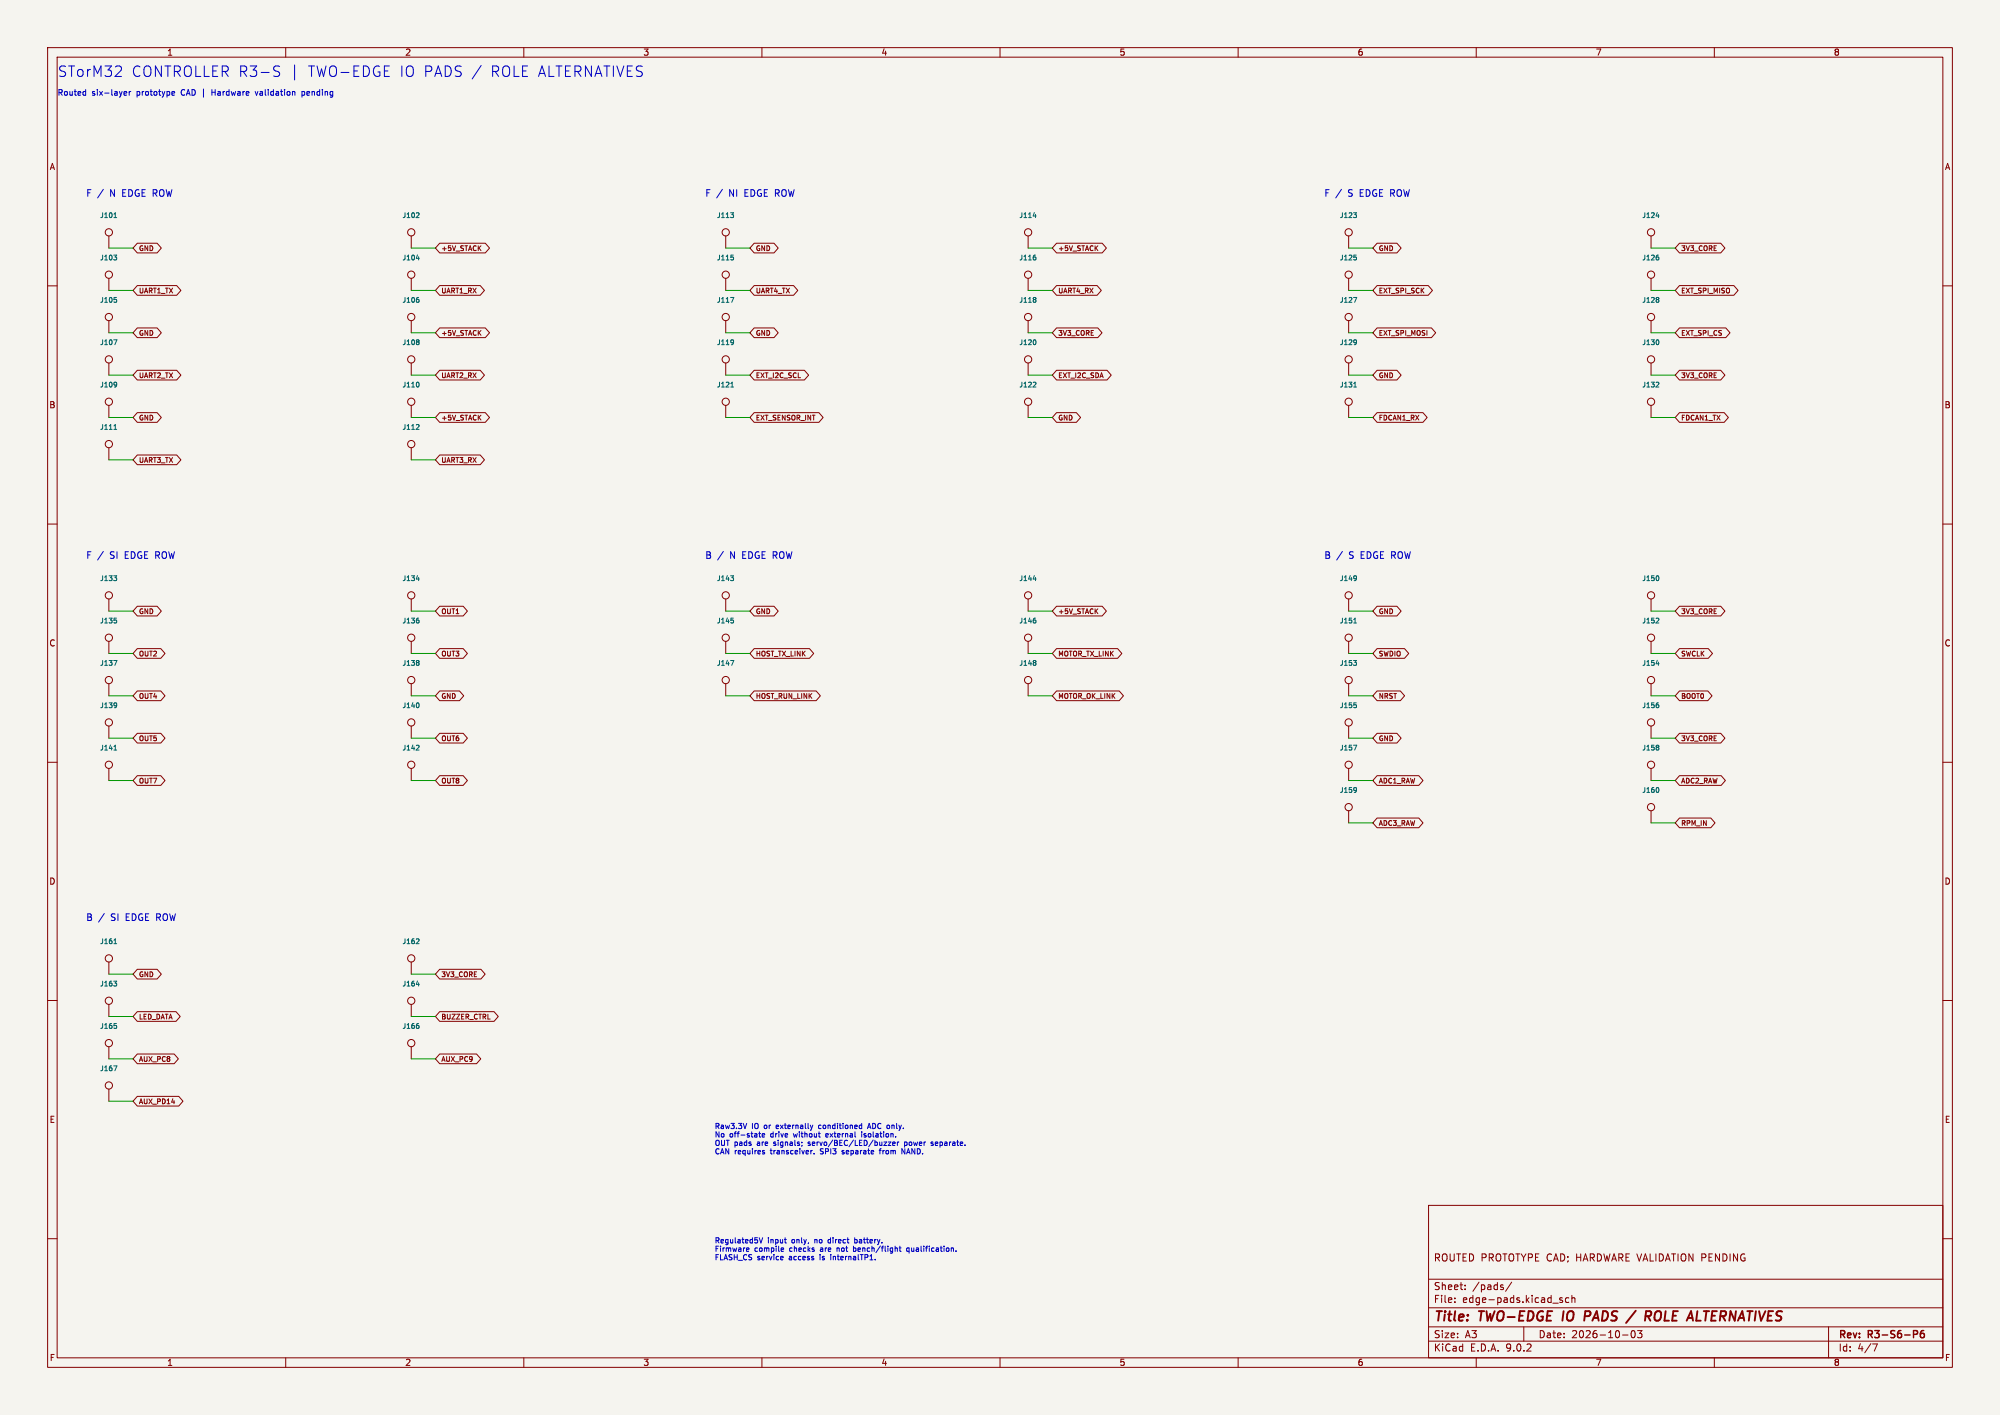
[picture p135: page 4]

Id: 4/7 Title: TWO-EDGE IO PADS / ROLE ALTERNATIVES

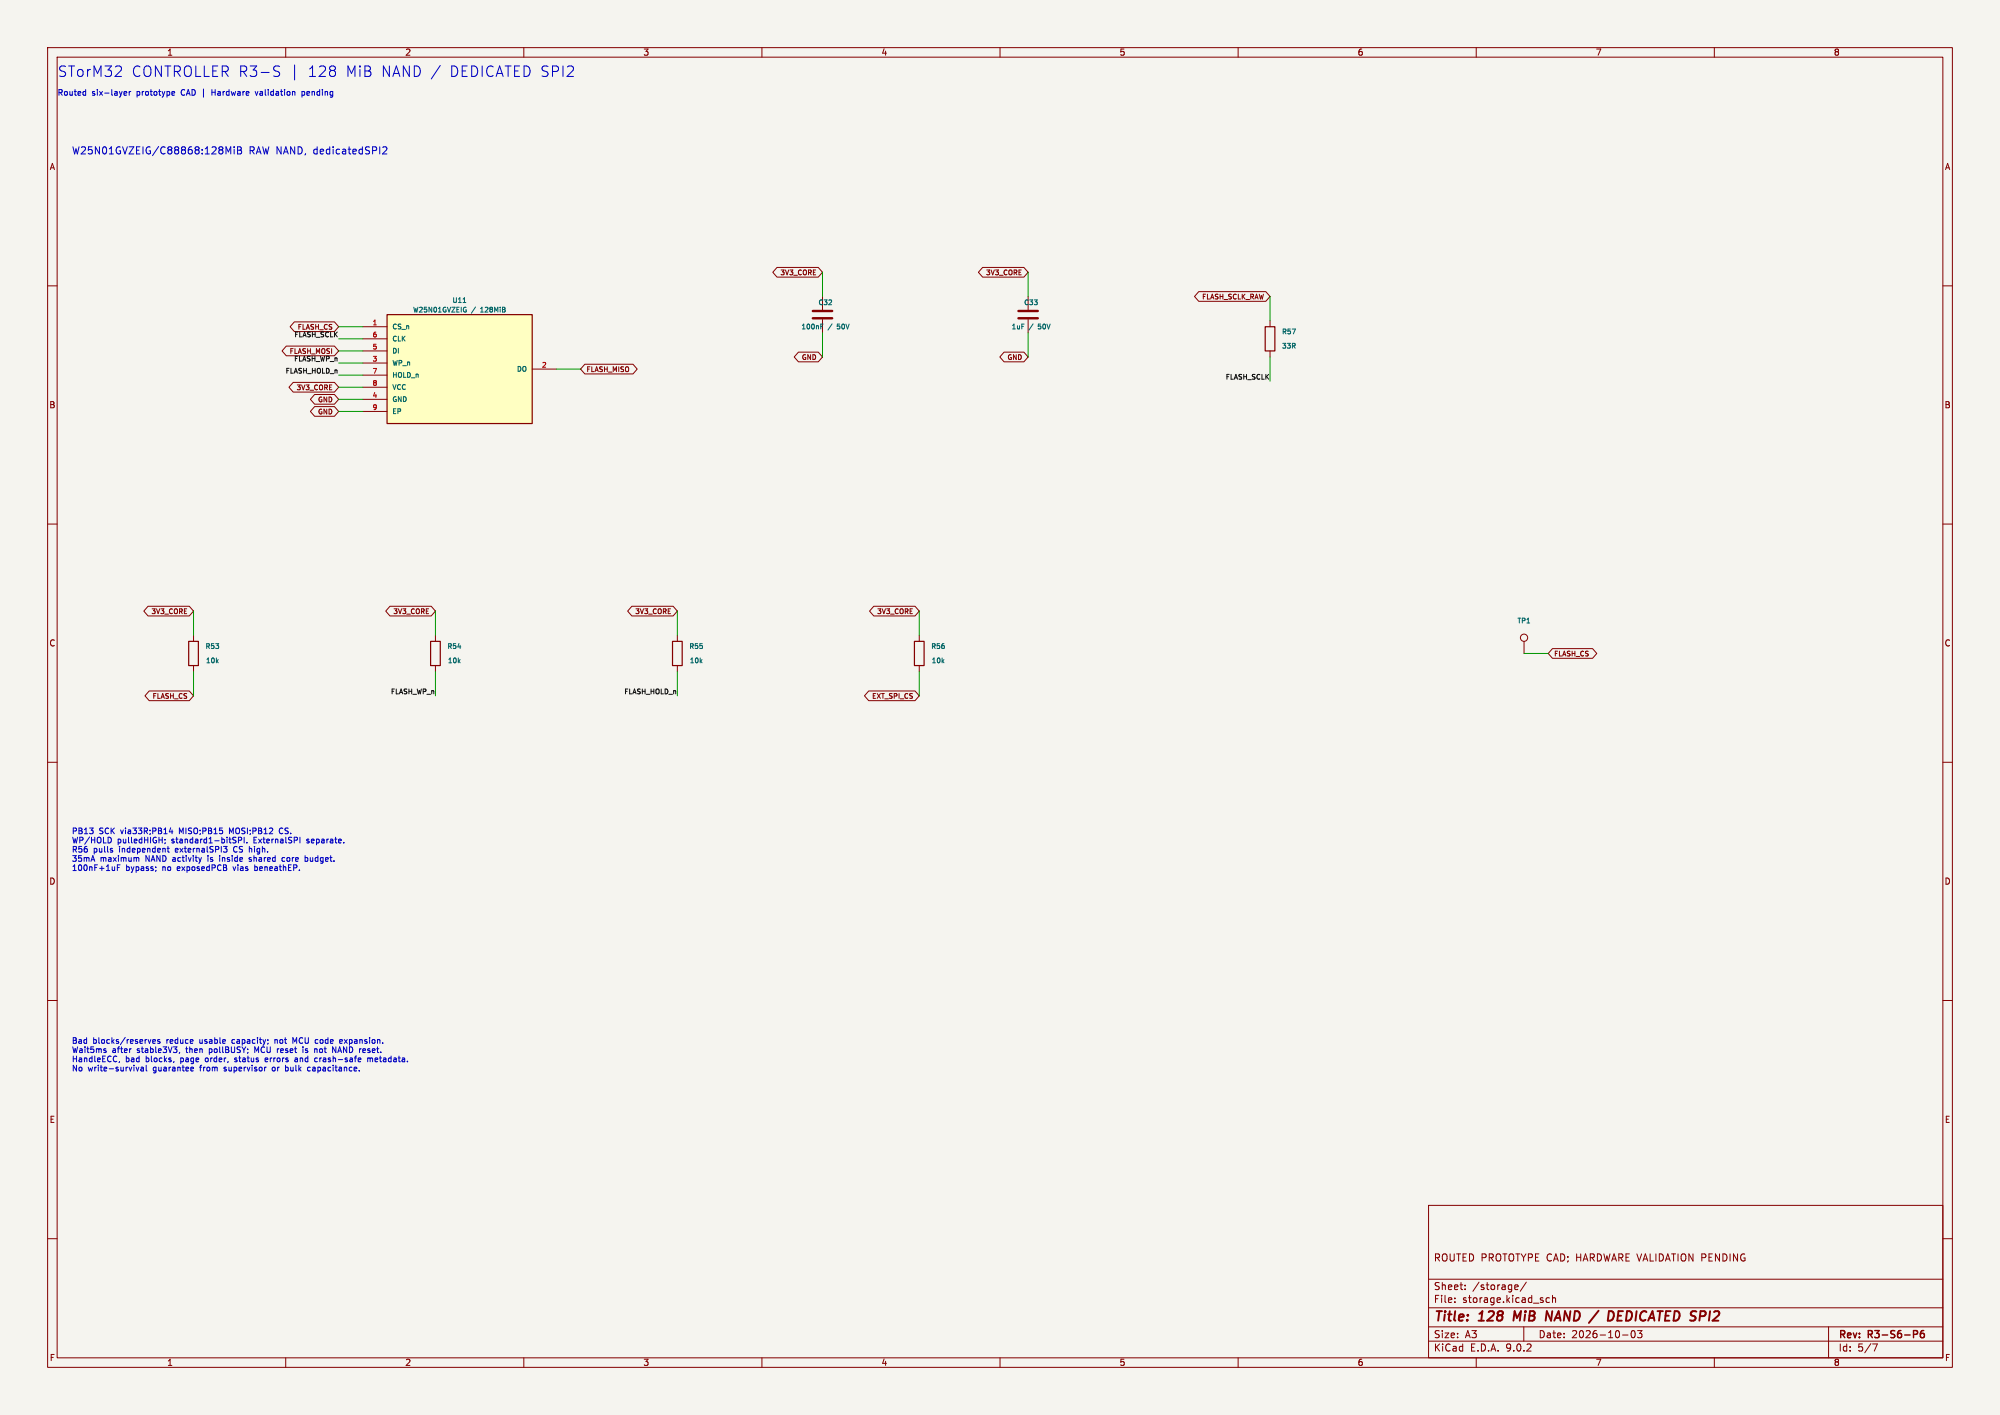
[picture p136: page 5]

Id: 5/7 Title: 128 MiB NAND / DEDICATED SPI2

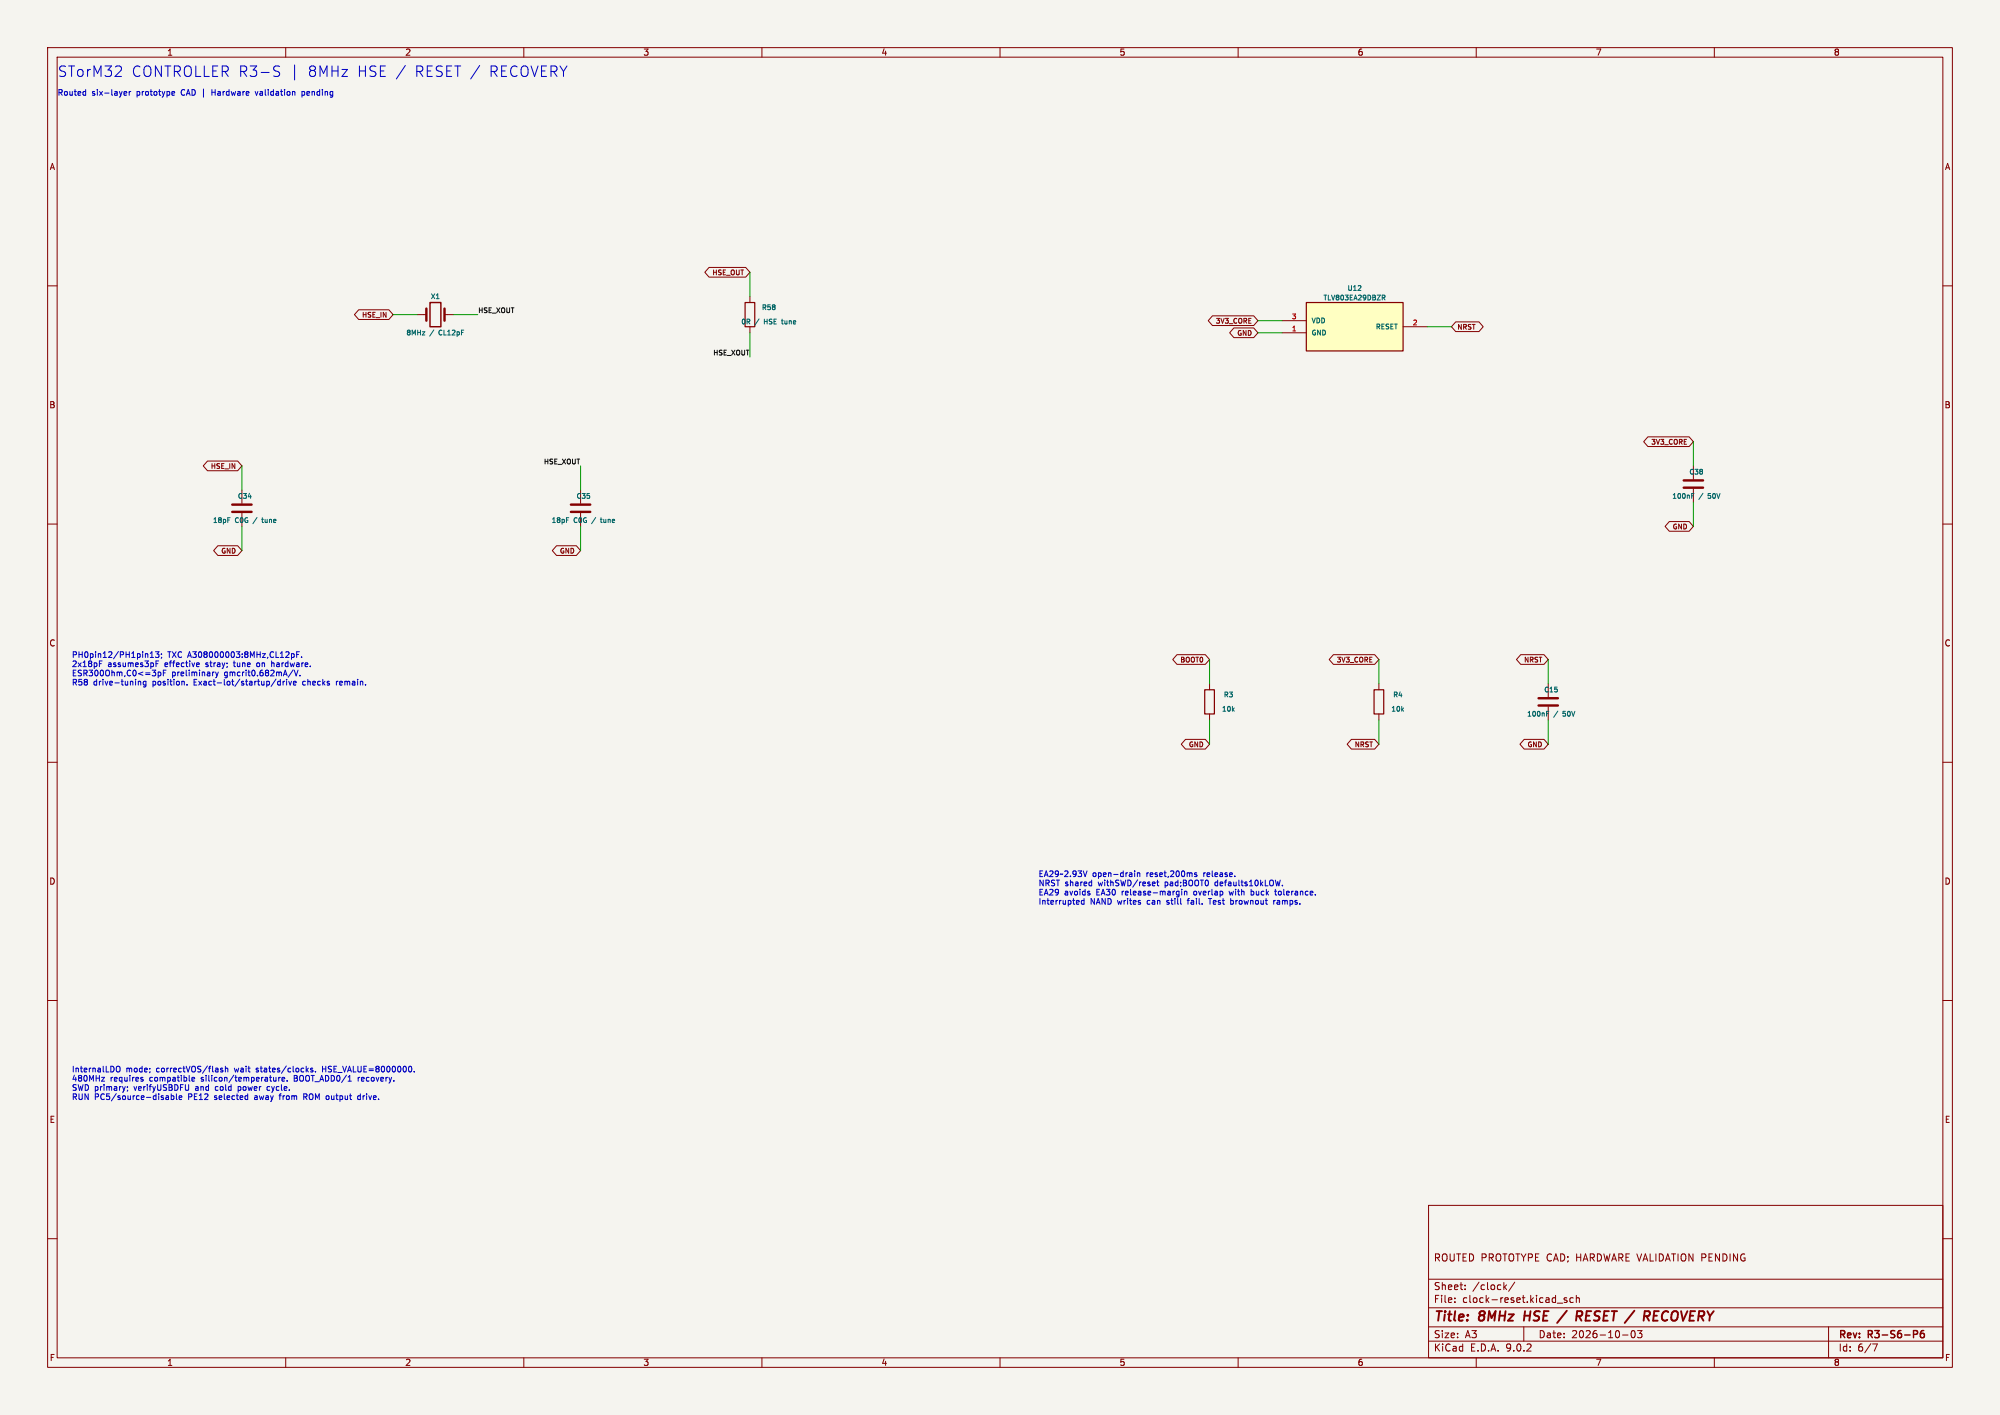
[picture p137: page 6]

STorM32 CONTROLLER R3-S | 8MHz HSE / RESET / RECOVERY

Id: 6/7 Title: 8MHz HSE / RESET / RECOVERY

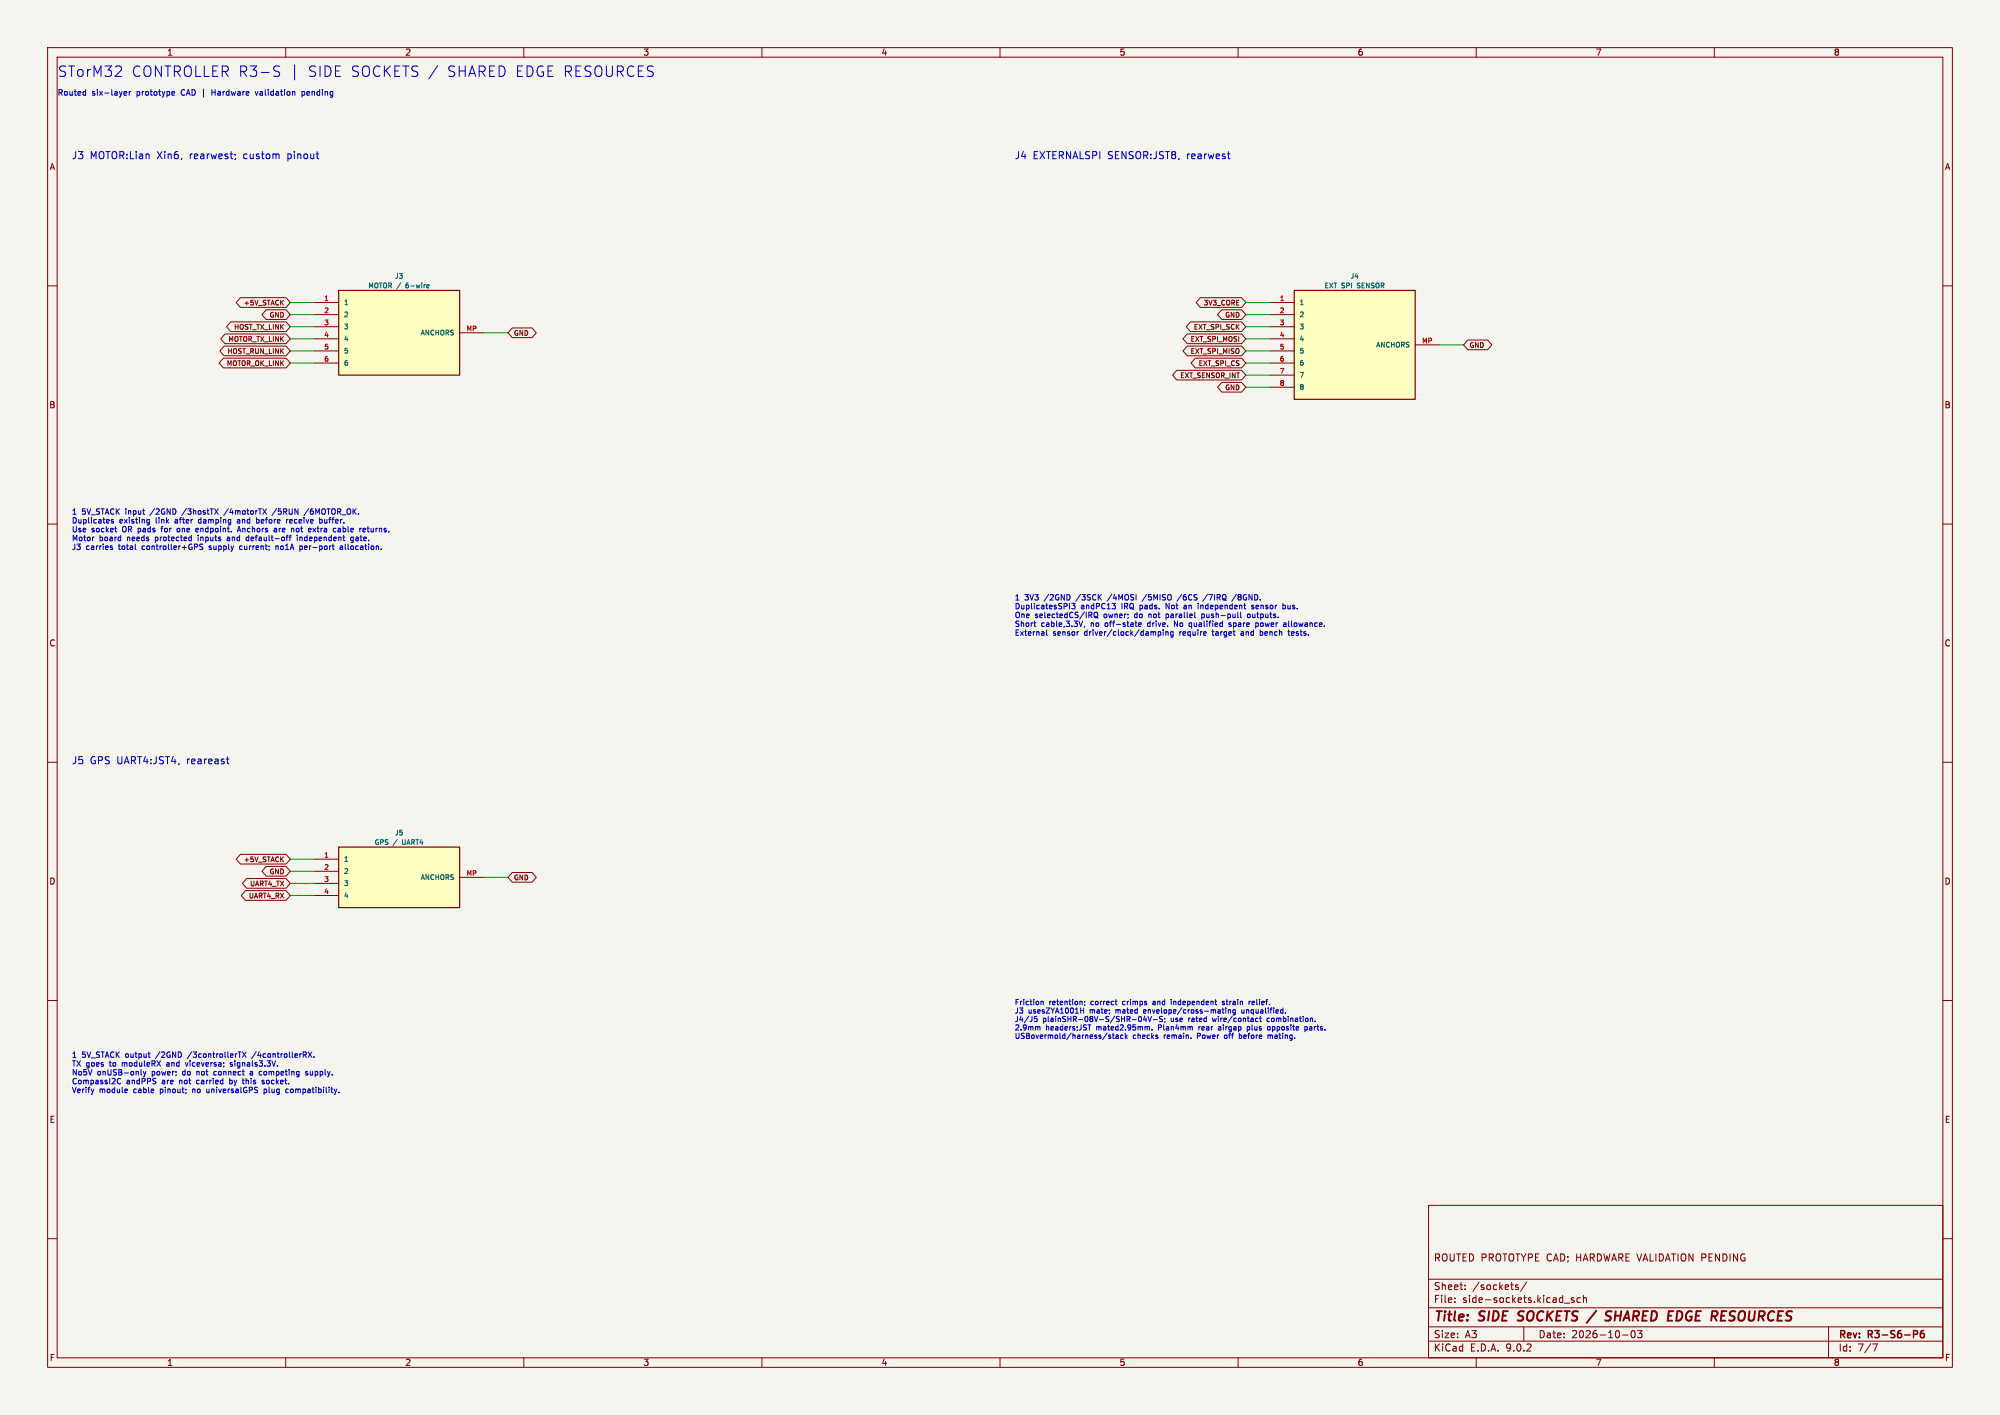
[picture p138: page 7]

STorM32 CONTROLLER R3-S | SIDE SOCKETS / SHARED EDGE RESOURCES

Id: 7/7 Title: SIDE SOCKETS / SHARED EDGE RESOURCES
