chenguoming1/h743-controllers/f722-heli/layout-revision/checkpoints/native0-rx-complete-v1-20261013/supplements/imu-cam-v1/cam/previews/f722-heli-schematic.pdf

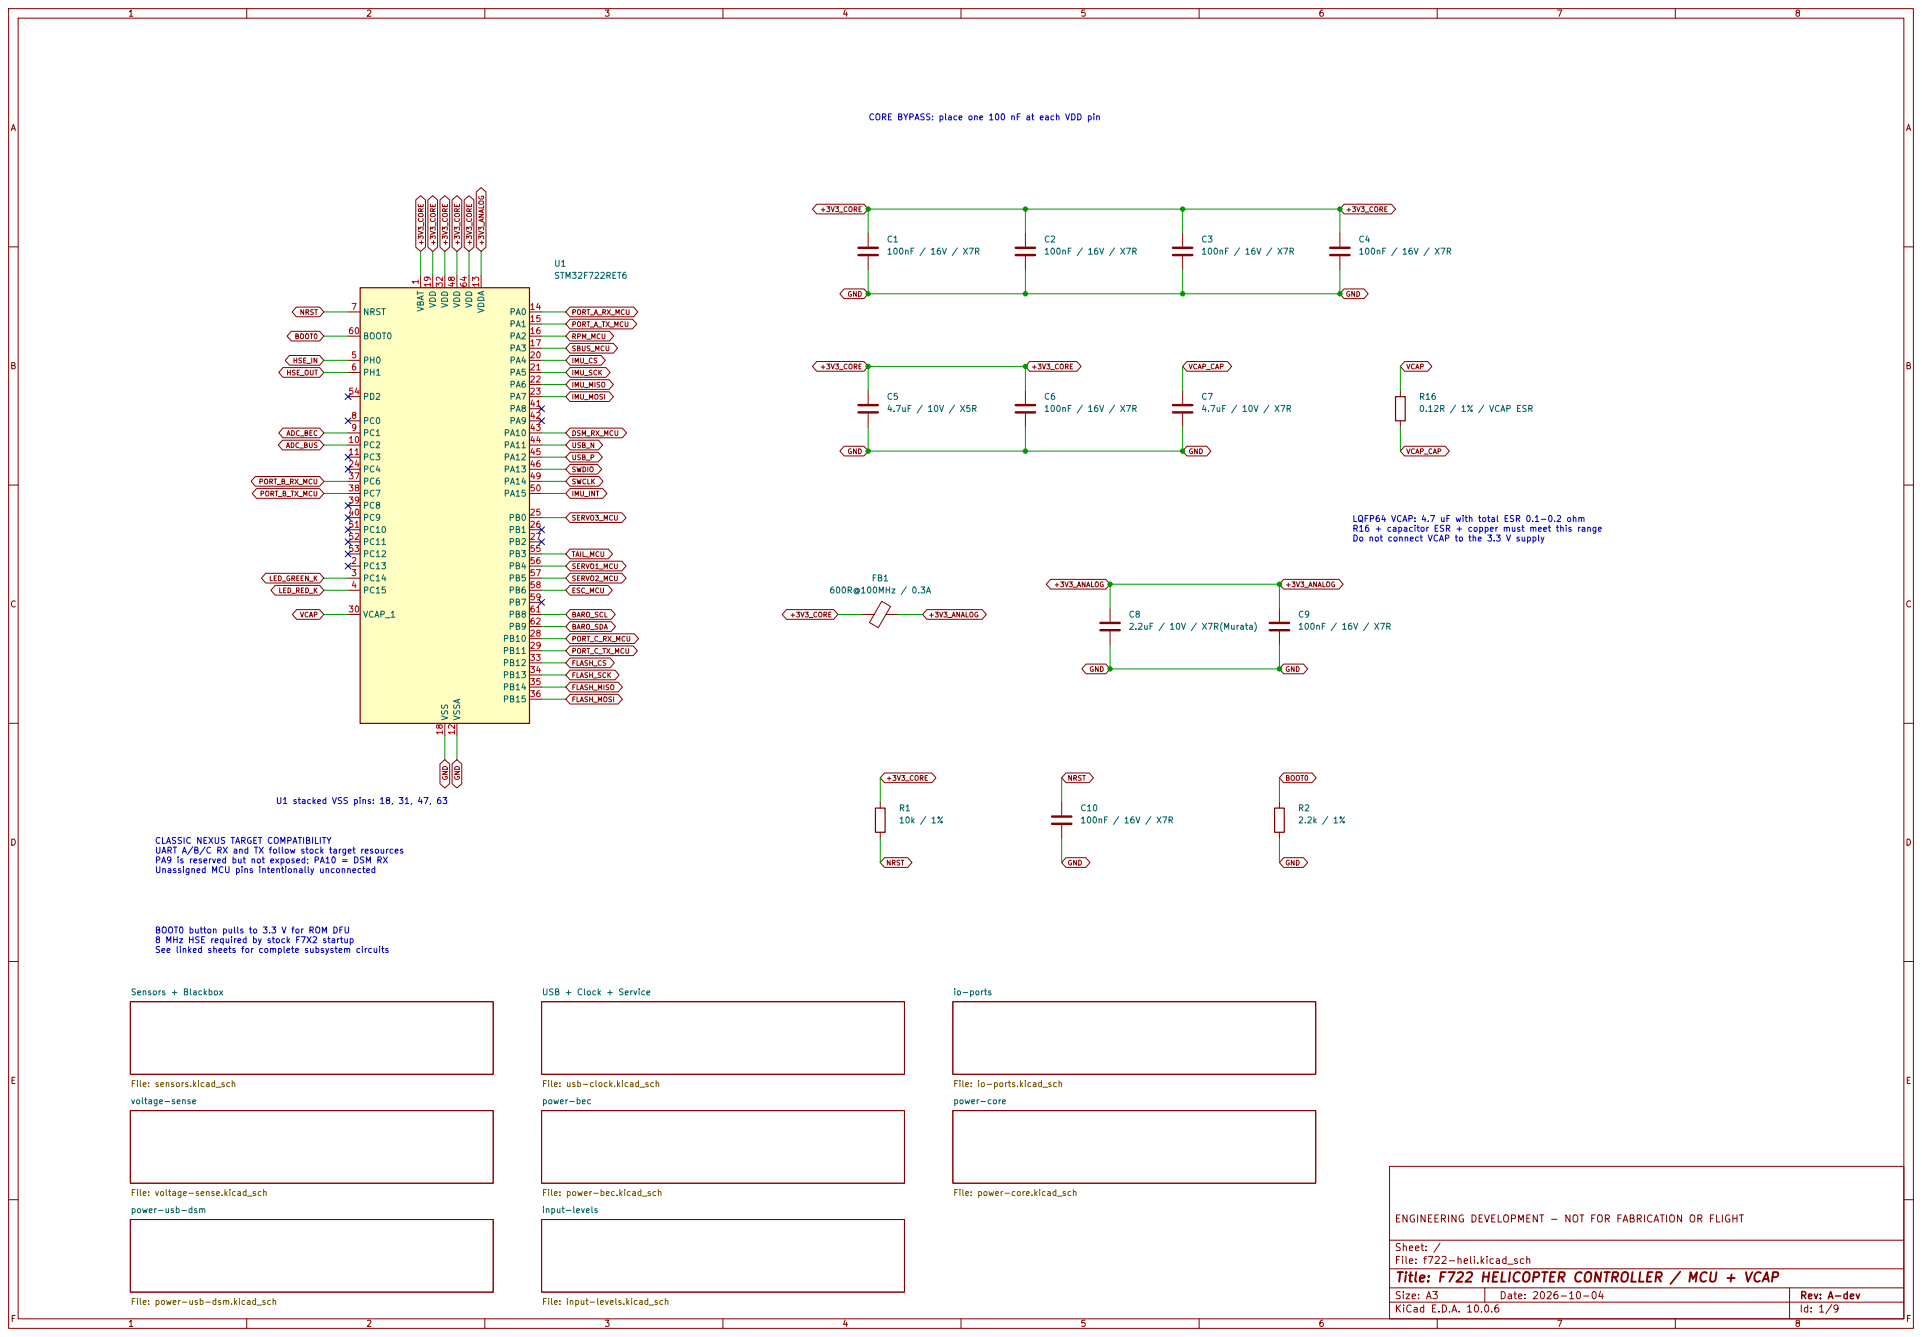
[picture p139: page 1]

CORE BYPASS: place one 100 nF at each VDD pin

LQFP64 VCAP: 4.7 uF with total ESR 0.1-0.2 ohm
R16 + capacitor ESR + copper must meet this range Do not connect VCAP to the 3.3 V supply

8 MHz HSE required by stock F7X2 startup See linked sheets for complete subsystem circuits CLASSIC NEXUS TARGET COMPATIBILITY UART A/B/C RX and TX follow stock target resources PA9 is reserved but not exposed; PA10 = DSM RX Unassigned MCU pins intentionally unconnected U1 stacked VSS pins: 18, 31, 47, 63

BOOT0 button pulls to 3.3 V for ROM DFU

io-ports File: io-ports.kicad_sch Sensors + Blackbox File: sensors.kicad_sch

File: power-bec.kicad_sch USB + Clock + Service

input-levels File: input-levels.kicad_sch

ENGINEERING DEVELOPMENT - NOT FOR FABRICATION OR FLIGHT

Sheet: /
File: f722-heli.kicad_sch
Title: F722 HELICOPTER CONTROLLER / MCU + VCAP

File: power-usb-dsm.kicad_sch

Size: A3 | Rev: A-dev | F Date: 2026-10-04
KiCad E.D.A. 10.0.6 | Id: 1/9

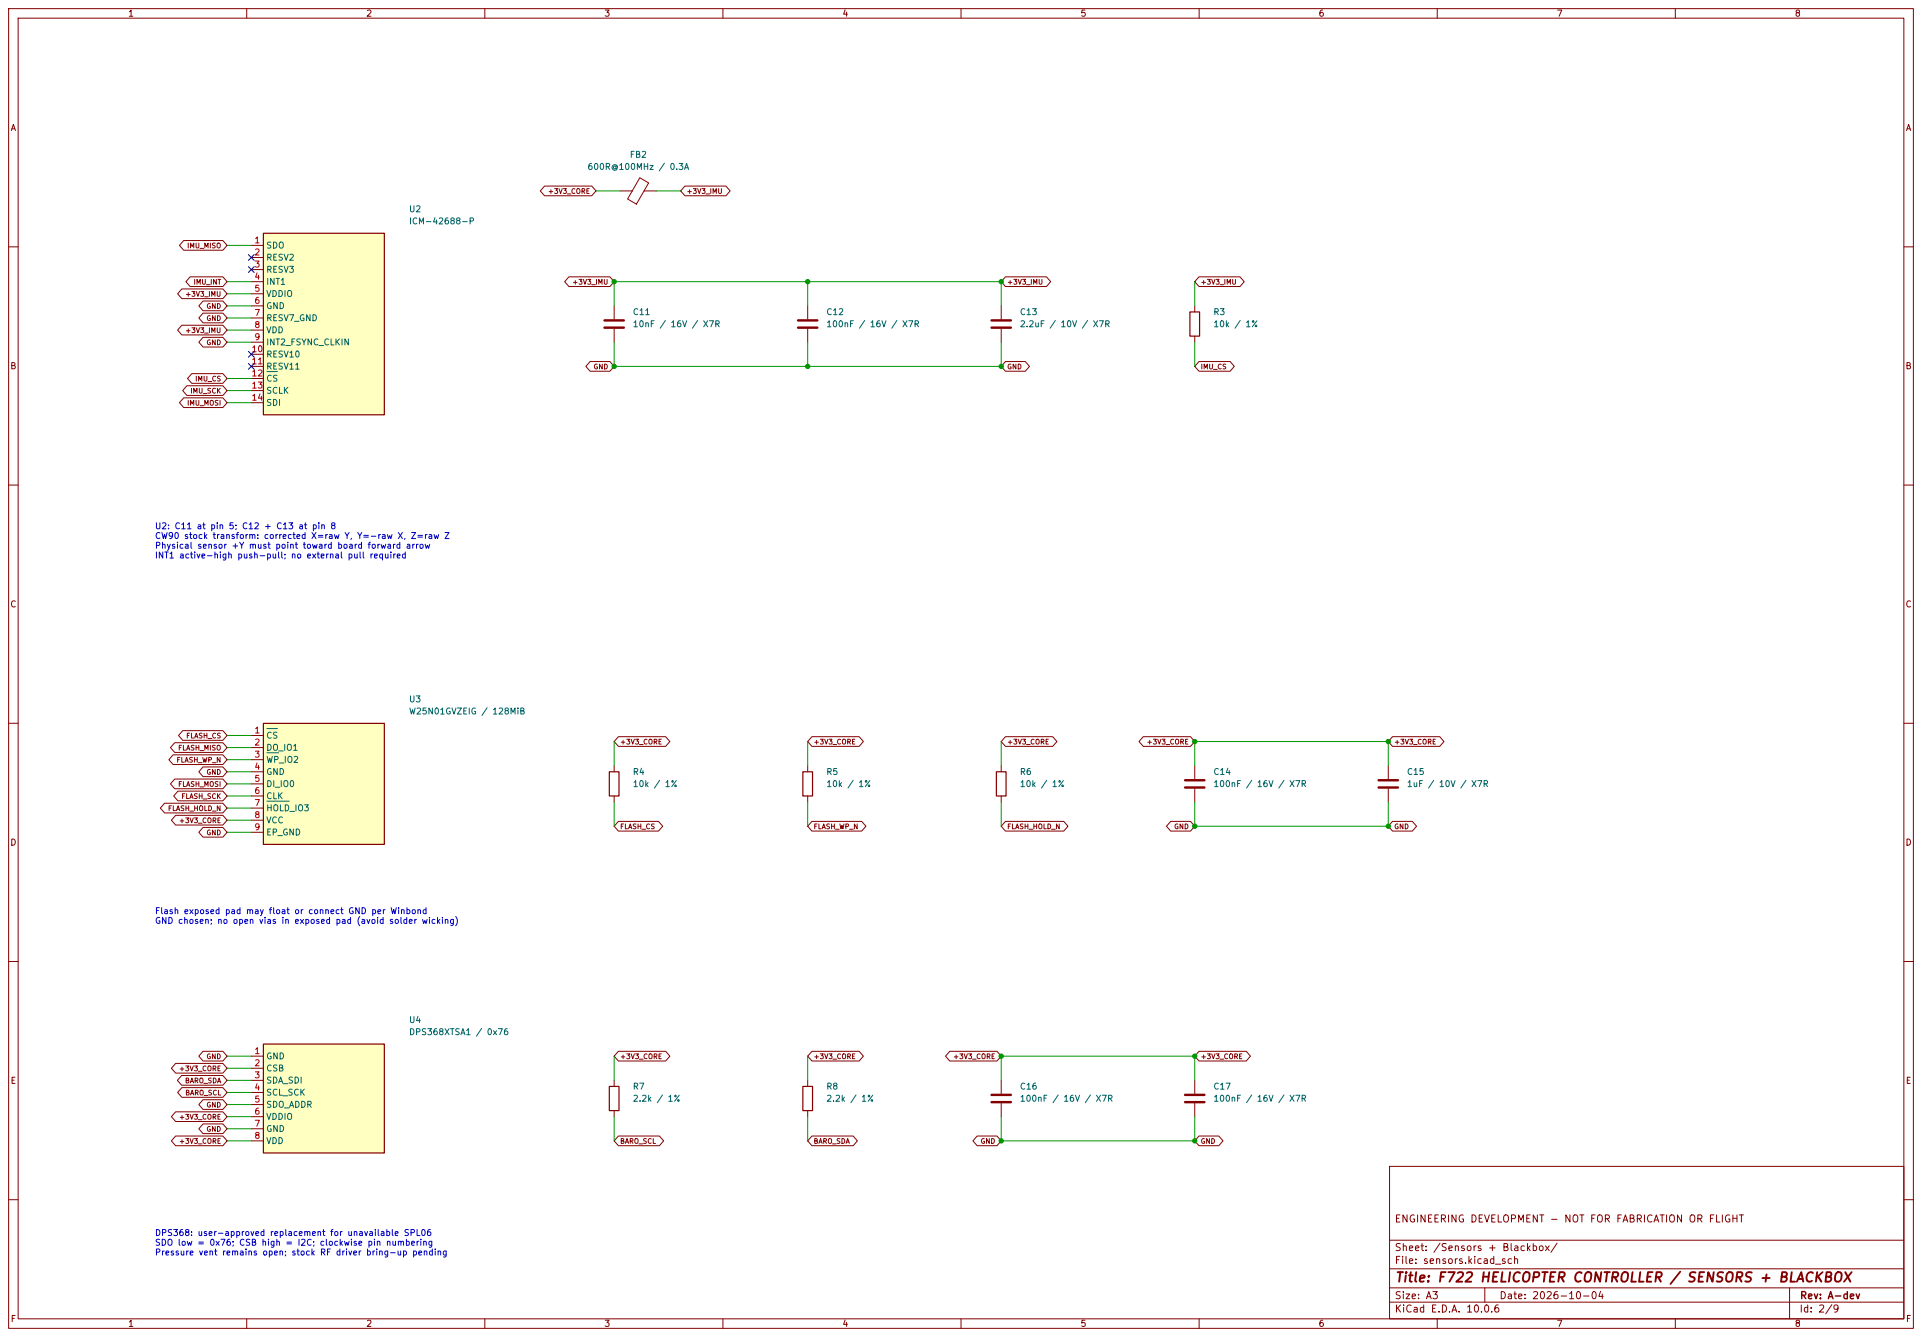
[picture p140: page 2]

Flash exposed pad may float or connect GND per Winbond GND chosen; no open vias in exposed pad (avoid solder wicking) U2: C11 at pin 5; C12 + C13 at pin 8 CW90 stock transform: corrected X=raw Y, Y=-raw X, Z=raw Z Physical sensor +Y must point toward board forward arrow

INT1 active-high push-pull; no external pull required

ENGINEERING DEVELOPMENT - NOT FOR FABRICATION OR FLIGHT R8

DPS368: user-approved replacement for unavailable SPL06
SDO low = 0x76; CSB high = I2C; clockwise pin numbering Pressure vent remains open; stock RF driver bring-up pending

Sheet: /Sensors + Blackbox/
File: sensors.kicad_sch
Title: F722 HELICOPTER CONTROLLER / SENSORS + BLACKBOX

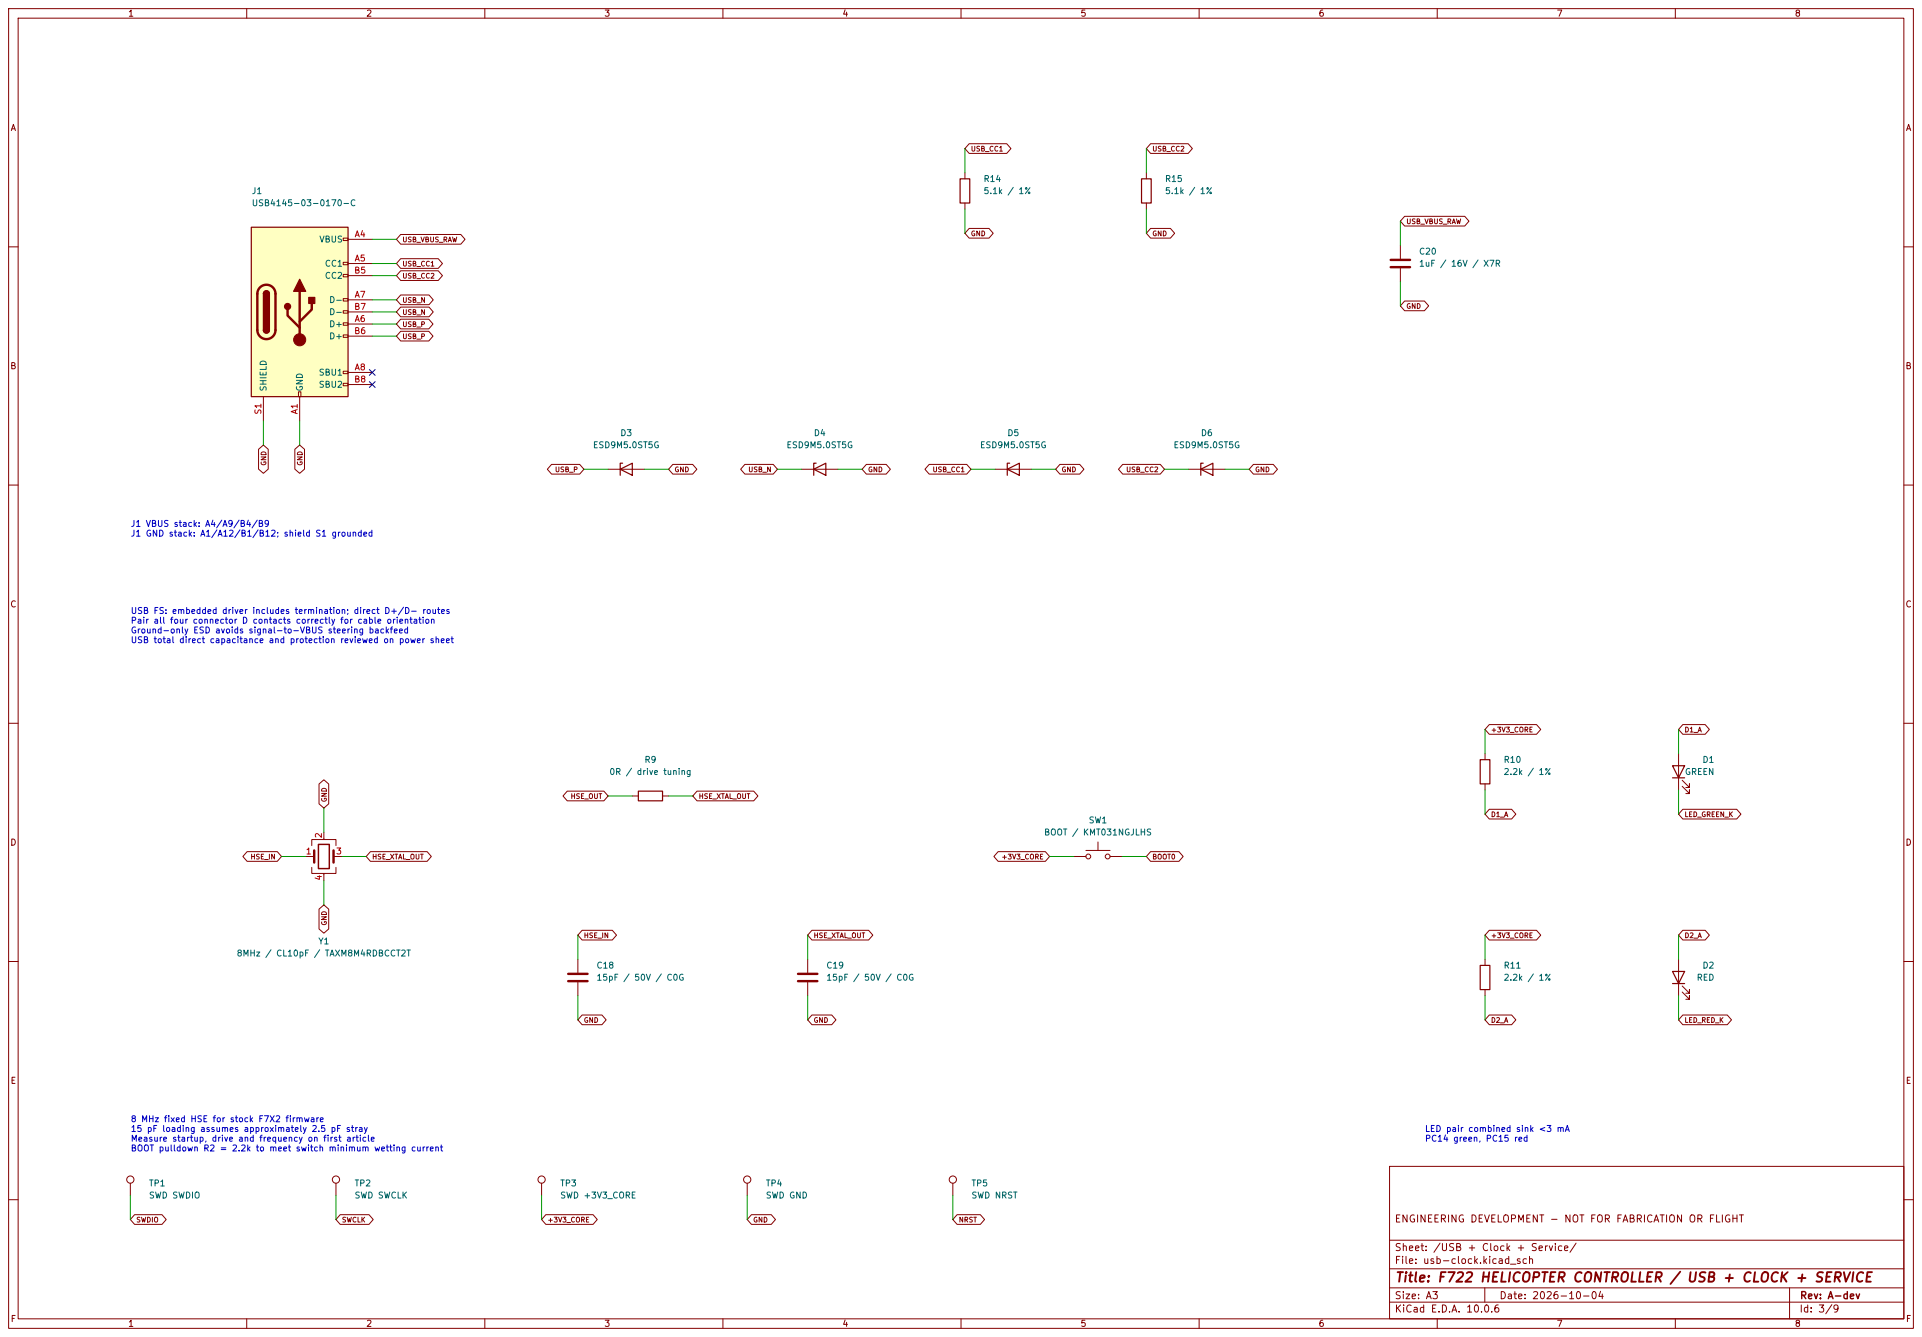
[picture p141: page 3]

GND GND 8 MHz fixed HSE for stock F7X2 firmware 15 pF loading assumes approximately 2.5 pF stray Measure startup, drive and frequency on first article BOOT pulldown R2 = 2.2k to meet switch minimum wetting current

USB FS: embedded driver includes termination; direct D+/D- routes Pair all four connector D contacts correctly for cable orientation Ground-only ESD avoids signal-to-VBUS steering backfeed USB total direct capacitance and protection reviewed on power sheet J1 VBUS stack: A4/A9/B4/B9
J1 GND stack: A1/A12/B1/B12; shield S1 grounded

ENGINEERING DEVELOPMENT - NOT FOR FABRICATION OR FLIGHT C19

LED pair combined sink <3 mA PC14 green, PC15 red

Sheet: /USB + Clock + Service/
File: usb-clock.kicad_sch
Title: F722 HELICOPTER CONTROLLER / USB + CLOCK + SERVICE

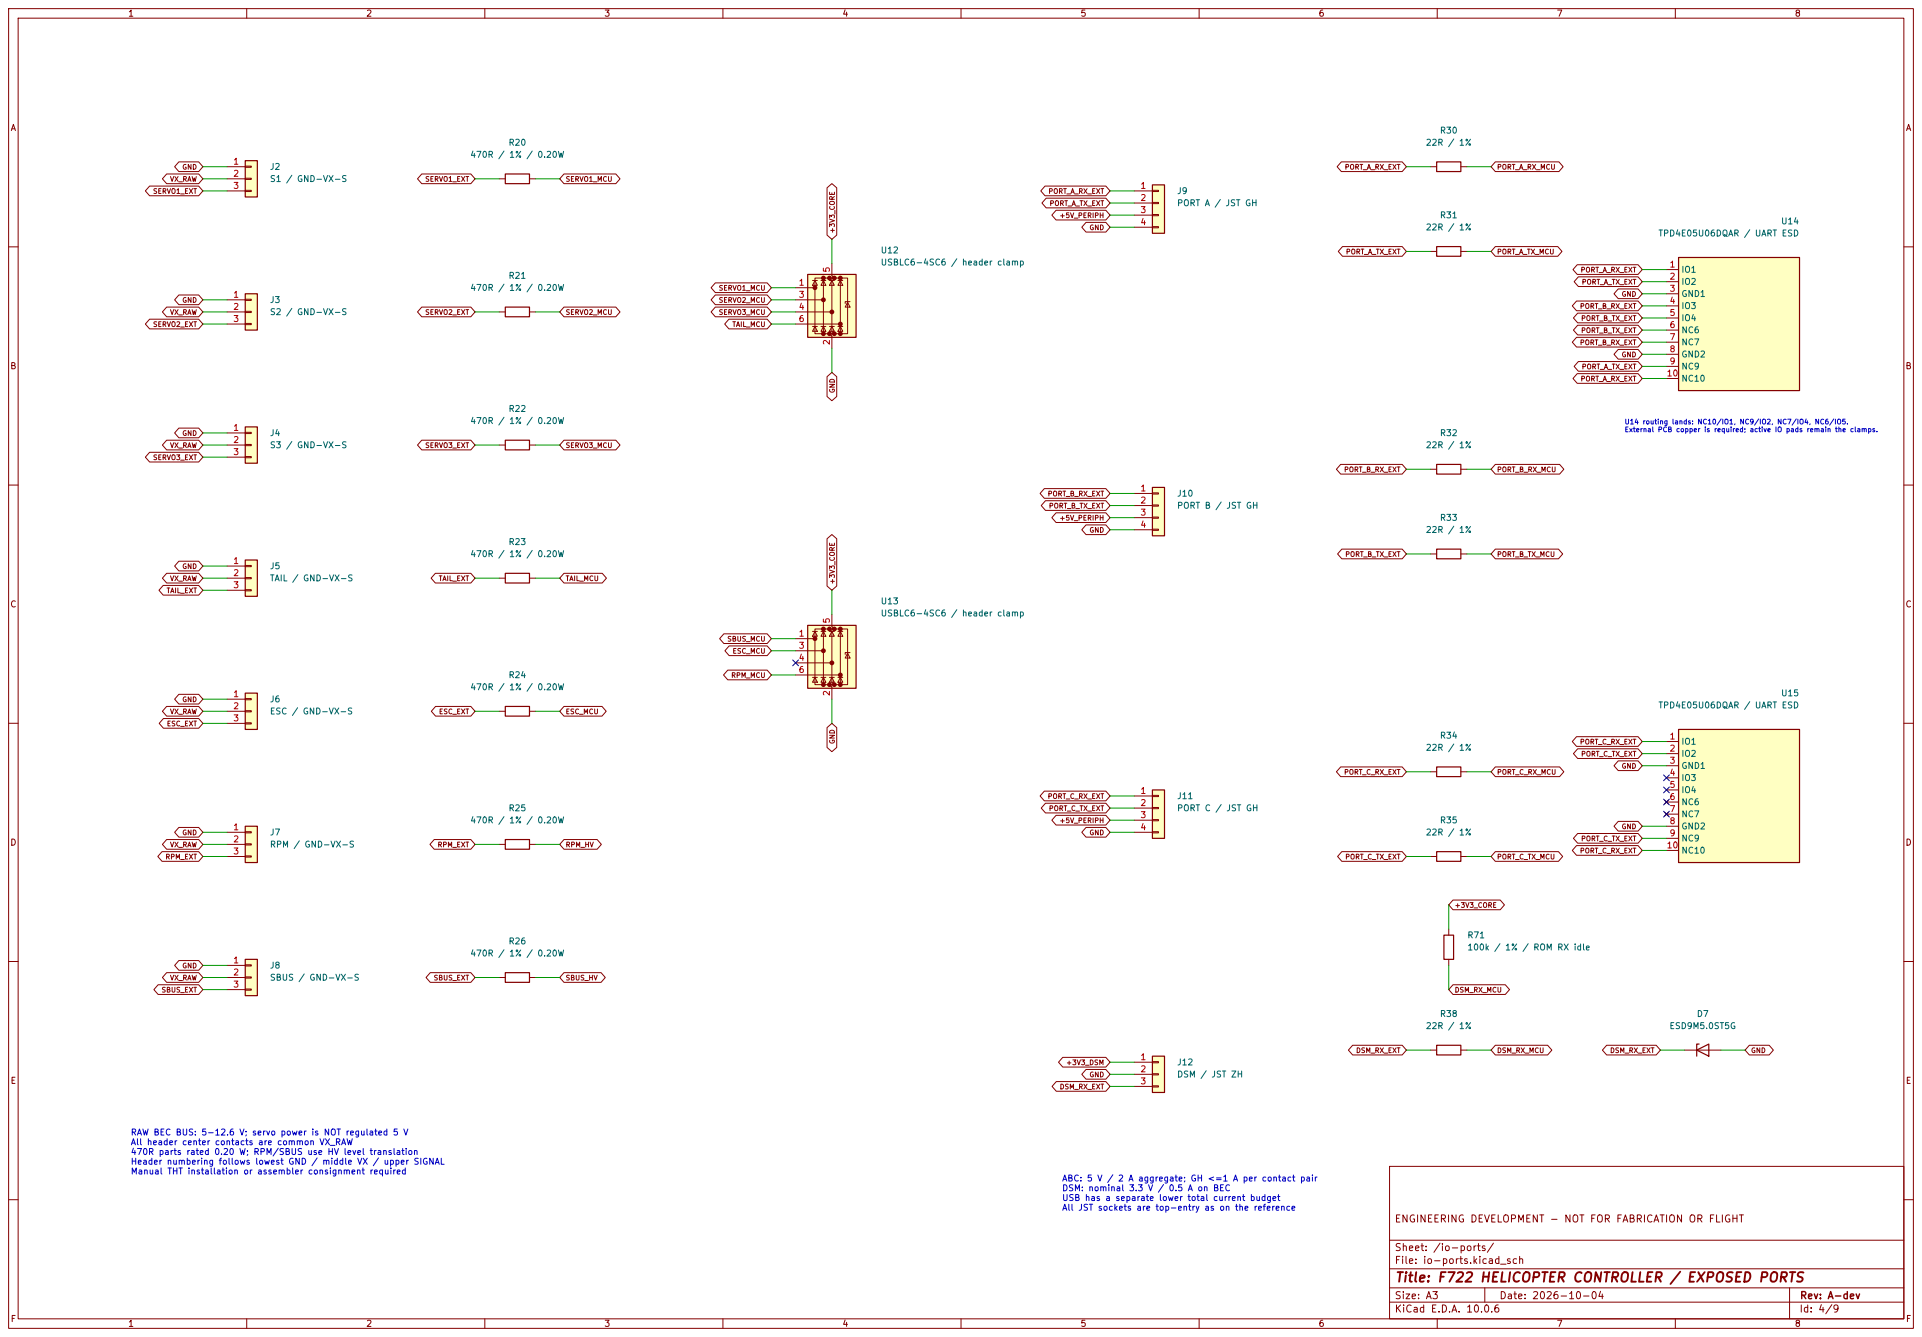
[picture p142: page 4]

U14 routing lands: NC10/IO1, NC9/IO2, NC7/IO4, NC6/IO5. External PCB copper is required; active IO pads remain the clamps.

RAW BEC BUS: 5-12.6 V; servo power is NOT regulated 5 V
All header center contacts are common VX_RAW
470R parts rated 0.20 W; RPM/SBUS use HV level translation Header numbering follows lowest GND / middle VX / upper SIGNAL Manual THT installation or assembler consignment required

ABC: 5 V / 2 A aggregate; GH <=1 A per contact pair DSM: nominal 3.3 V / 0.5 A on BEC USB has a separate lower total current budget All JST sockets are top-entry as on the reference

ENGINEERING DEVELOPMENT - NOT FOR FABRICATION OR FLIGHT

Sheet: /io-ports/
File: io-ports.kicad_sch
Title: F722 HELICOPTER CONTROLLER / EXPOSED PORTS

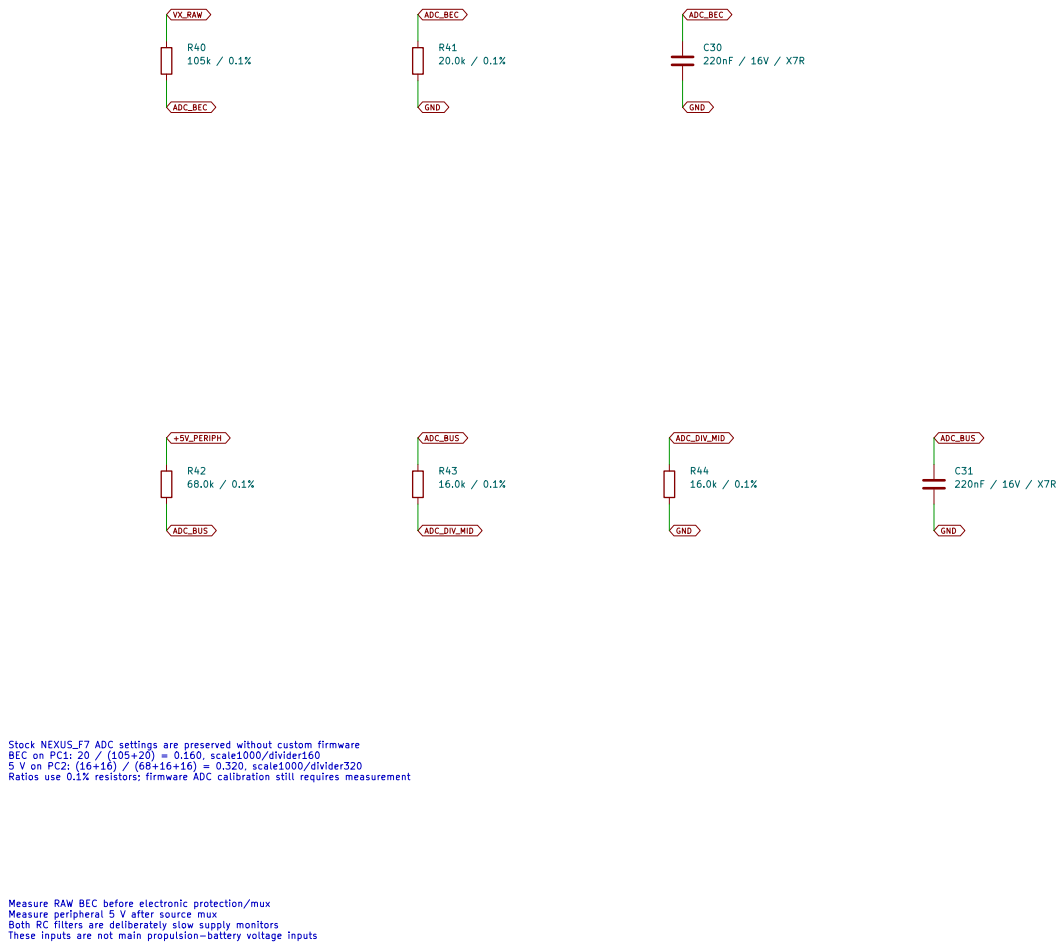
[picture p143: page 5]

GND Stock NEXUS_F7 ADC settings are preserved without custom firmware BEC on PC1: 20 / (105+20) = 0.160, scale1000/divider160

5 V on PC2: (16+16) / (68+16+16) = 0.320, scale1000/divider320 Ratios use 0.1% resistors; firmware ADC calibration still requires measurement Measure RAW BEC before electronic protection/mux Measure peripheral 5 V after source mux Both RC filters are deliberately slow supply monitors

These inputs are not main propulsion-battery voltage inputs

ENGINEERING DEVELOPMENT - NOT FOR FABRICATION OR FLIGHT

Sheet: /voltage-sense/
File: voltage-sense.kicad_sch
Title: F722 HELICOPTER CONTROLLER / SUPPLY MONITORING

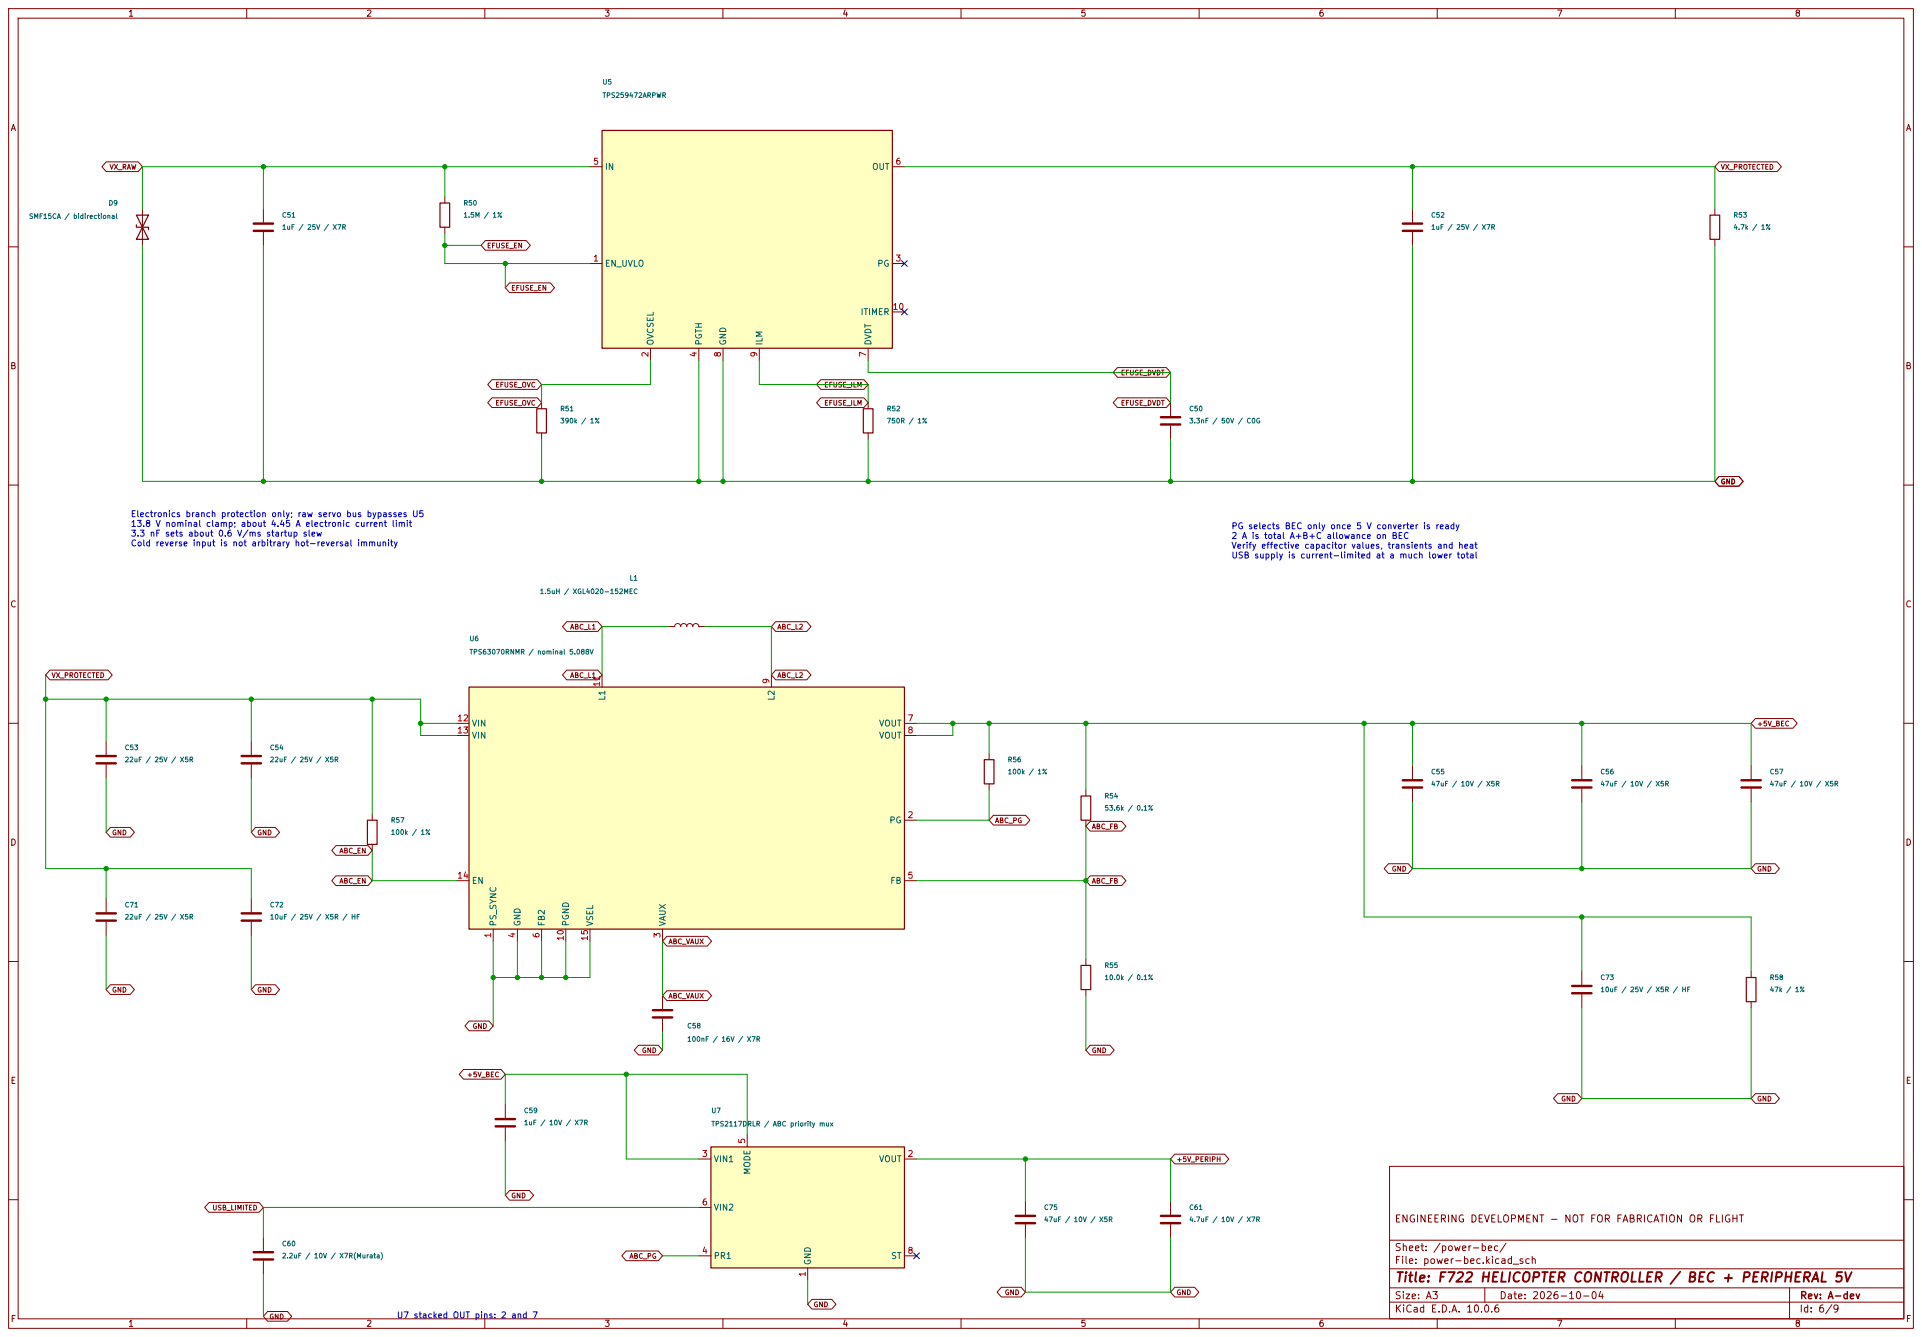
[picture p144: page 6]

Electronics branch protection only; raw servo bus bypasses U5
13.8 V nominal clamp; about 4.45 A electronic current limit 3.3 nF sets about 0.6 V/ms startup slew

Cold reverse input is not arbitrary hot-reversal immunity

Verify effective capacitor values, transients and heat USB supply is current-limited at a much lower total

ENGINEERING DEVELOPMENT - NOT FOR FABRICATION OR FLIGHT

Sheet: /power-bec/
File: power-bec.kicad_sch
Title: F722 HELICOPTER CONTROLLER / BEC + PERIPHERAL 5V

U7 stacked OUT pins: 2 and 7

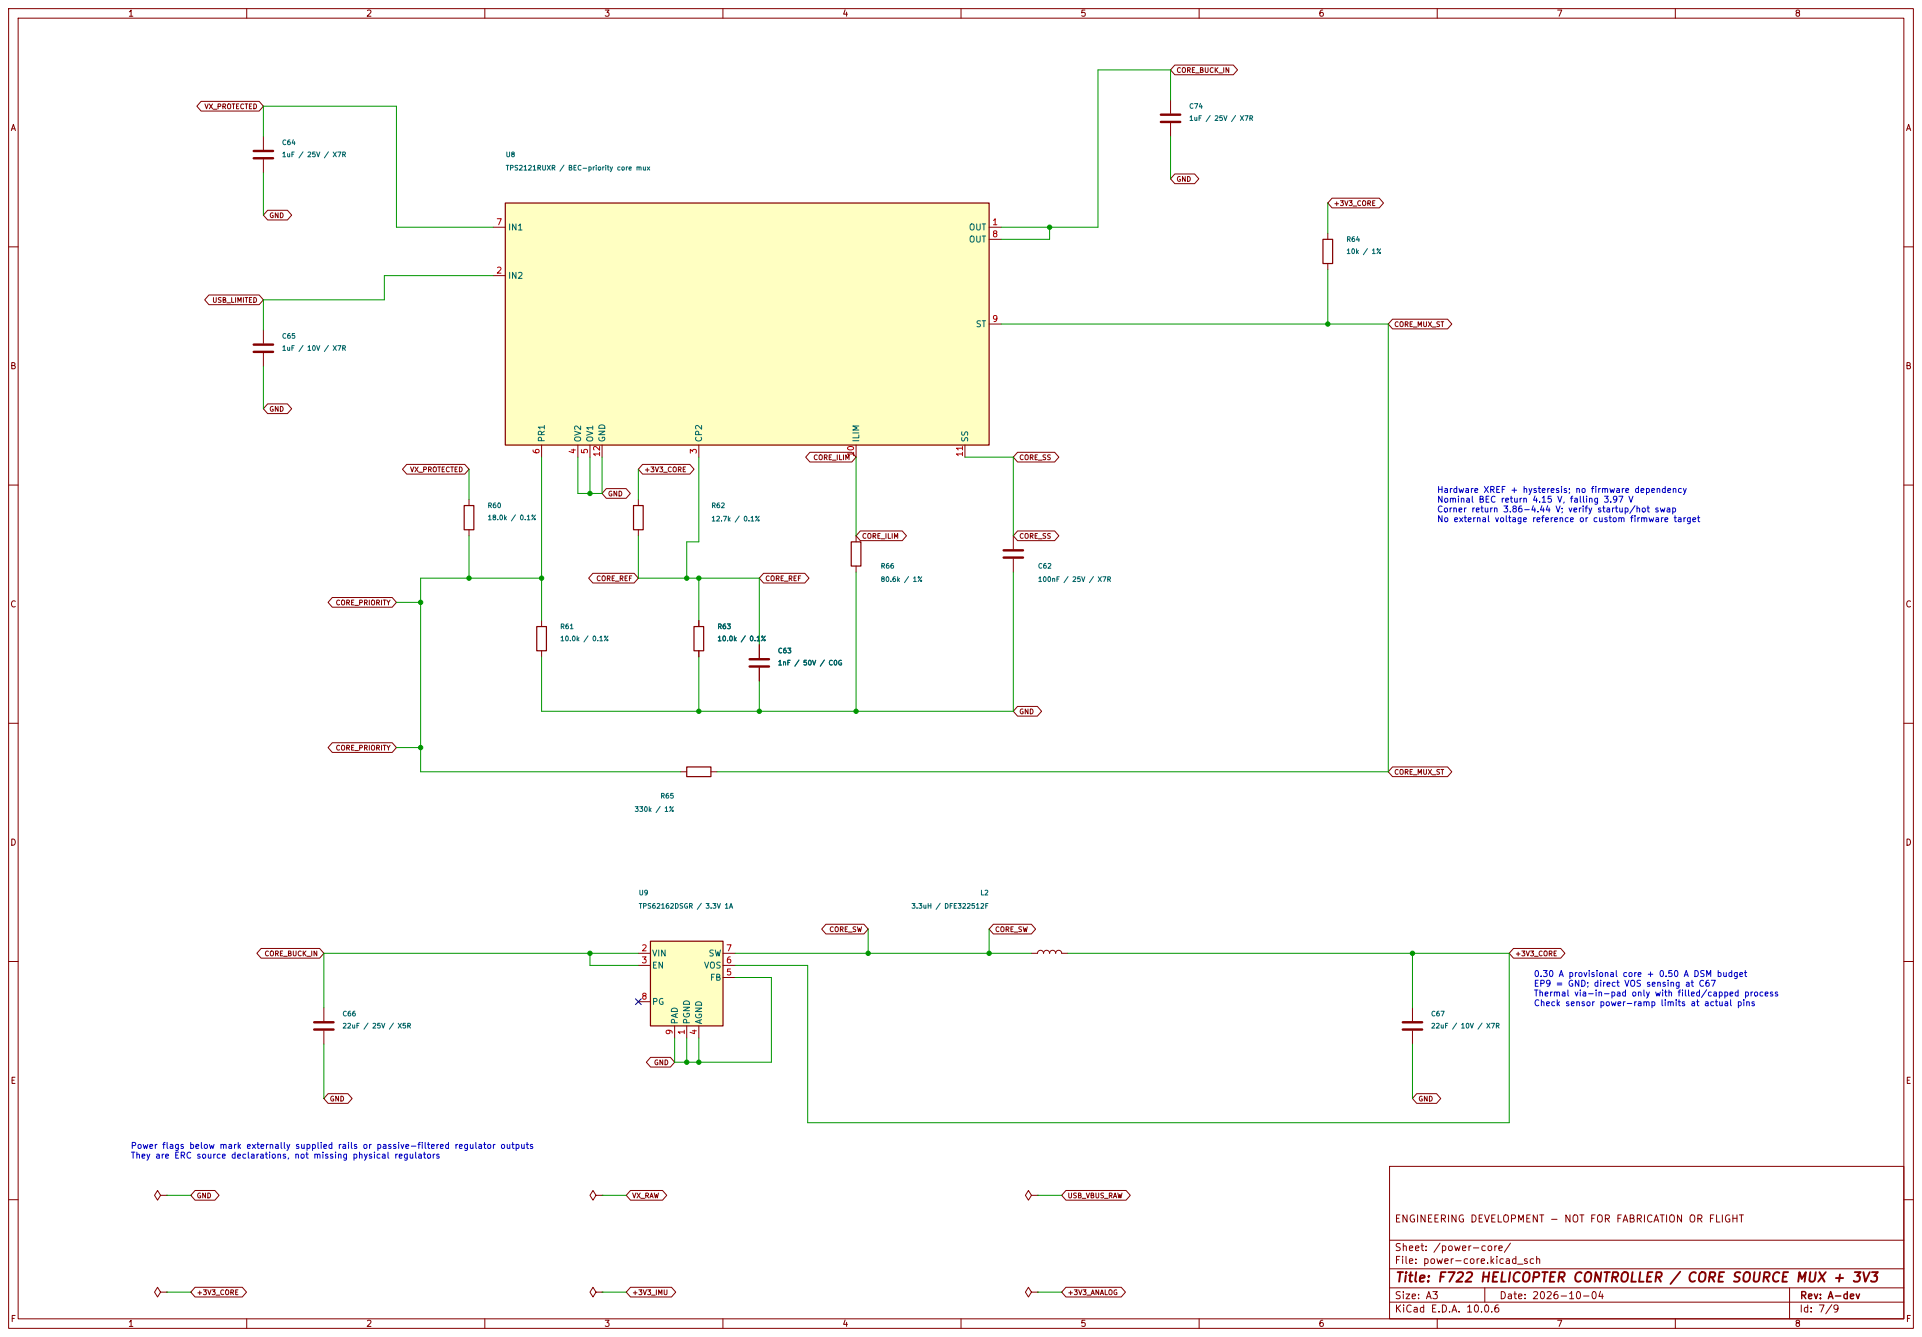
[picture p145: page 7]

Hardware XREF + hysteresis; no firmware dependency Nominal BEC return 4.15 V, falling 3.97 V Corner return 3.86-4.44 V; verify startup/hot swap No external voltage reference or custom firmware target Power flags below mark externally supplied rails or passive-filtered regulator outputs

Thermal via-in-pad only with filled/capped process Check sensor power-ramp limits at actual pins

They are ERC source declarations, not missing physical regulators

ENGINEERING DEVELOPMENT - NOT FOR FABRICATION OR FLIGHT

Sheet: /power-core/
File: power-core.kicad_sch
Title: F722 HELICOPTER CONTROLLER / CORE SOURCE MUX + 3V3

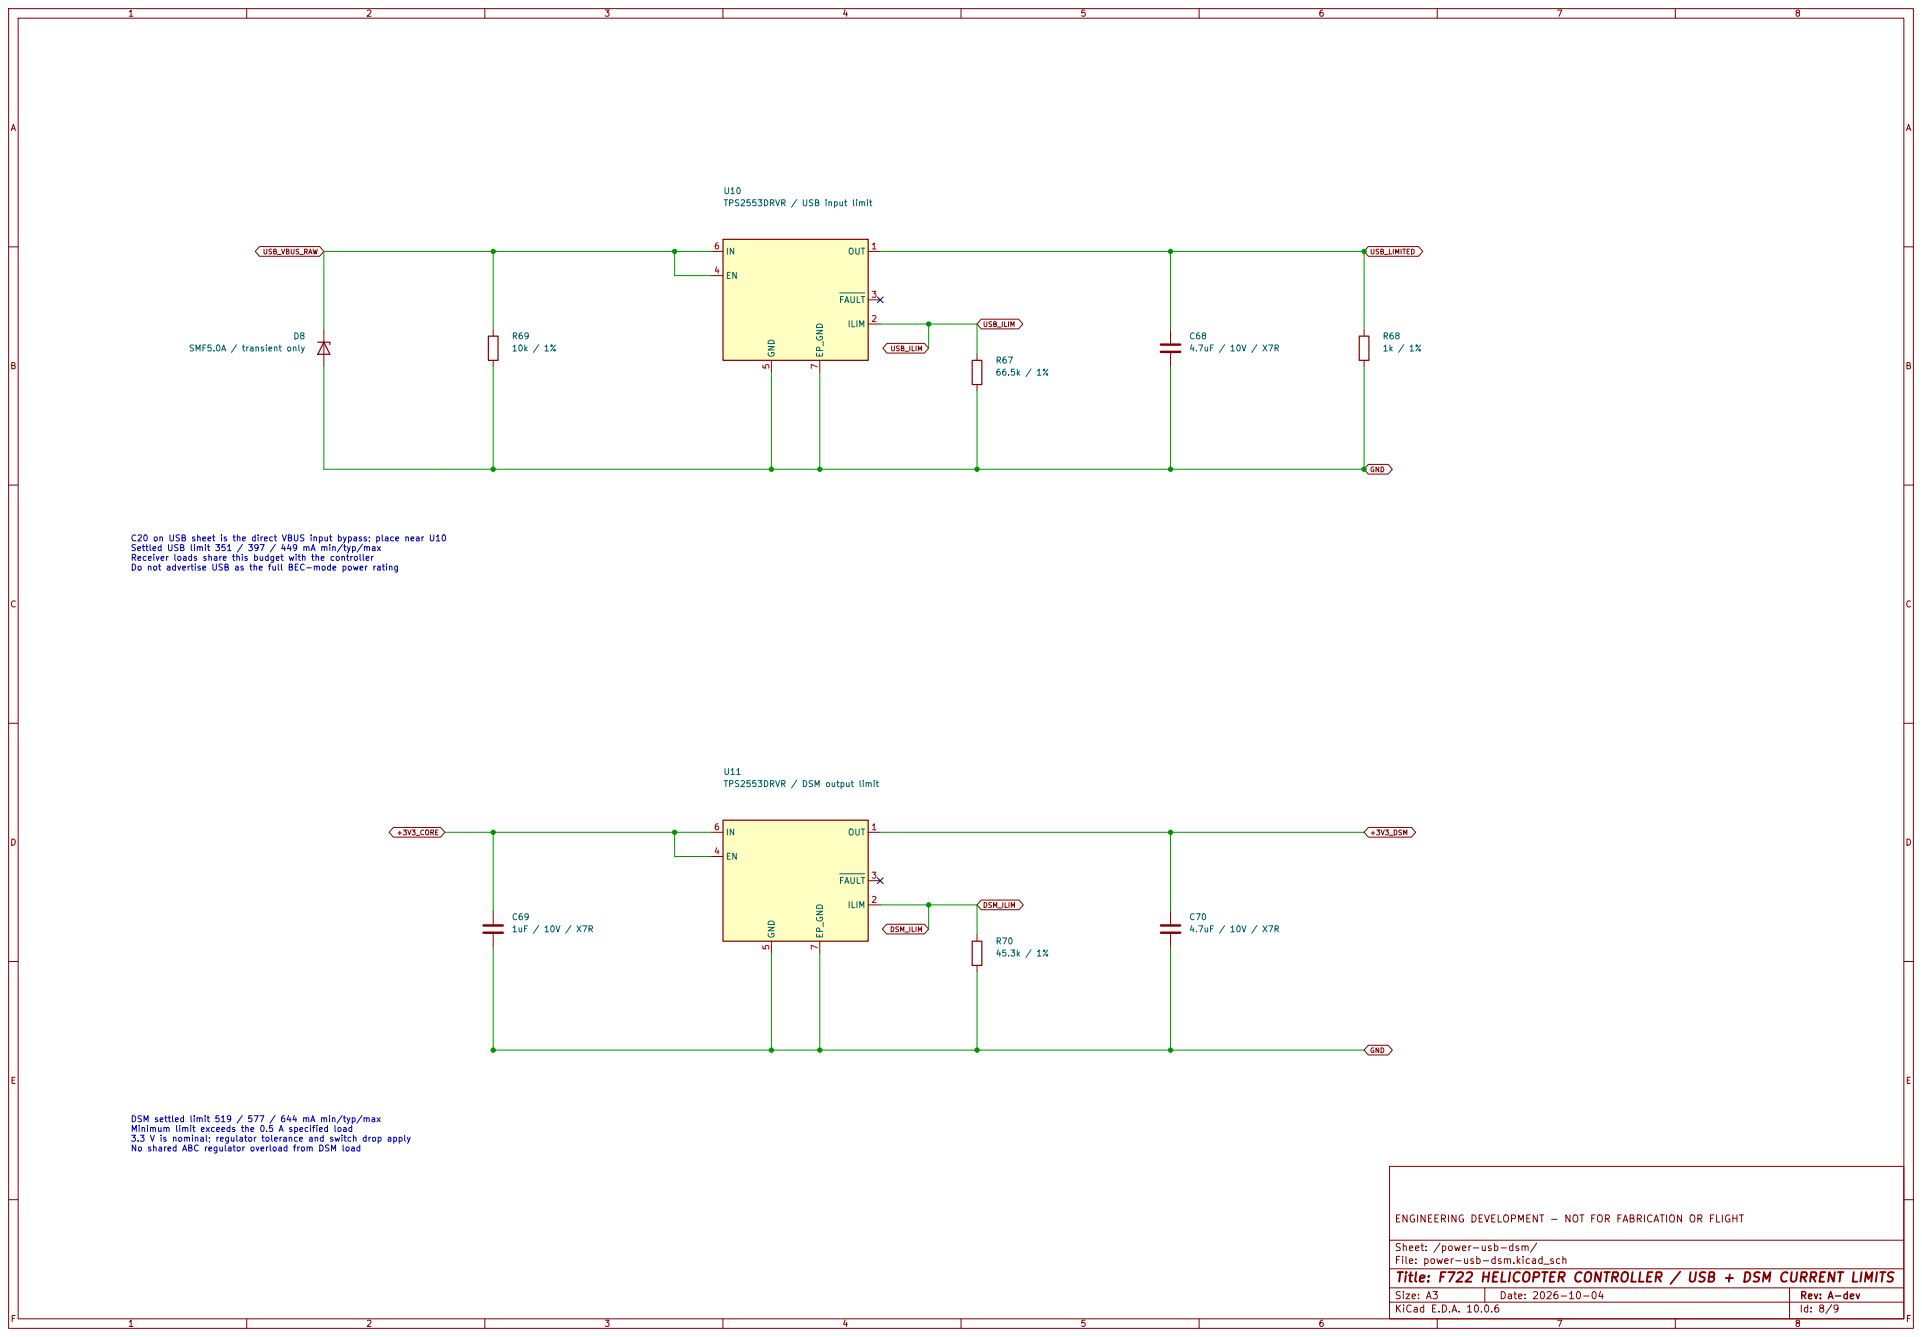
[picture p146: page 8]

Settled USB limit 351 / 397 / 449 mA min/typ/max Receiver loads share this budget with the controller Do not advertise USB as the full BEC-mode power rating DSM settled limit 519 / 577 / 644 mA min/typ/max Minimum limit exceeds the 0.5 A specified load 3.3 V is nominal; regulator tolerance and switch drop apply No shared ABC regulator overload from DSM load

GND USB_ILIM C20 on USB sheet is the direct VBUS input bypass; place near U10

ENGINEERING DEVELOPMENT - NOT FOR FABRICATION OR FLIGHT C70

Sheet: /power-usb-dsm/
File: power-usb-dsm.kicad_sch
Title: F722 HELICOPTER CONTROLLER / USB + DSM CURRENT LIMITS

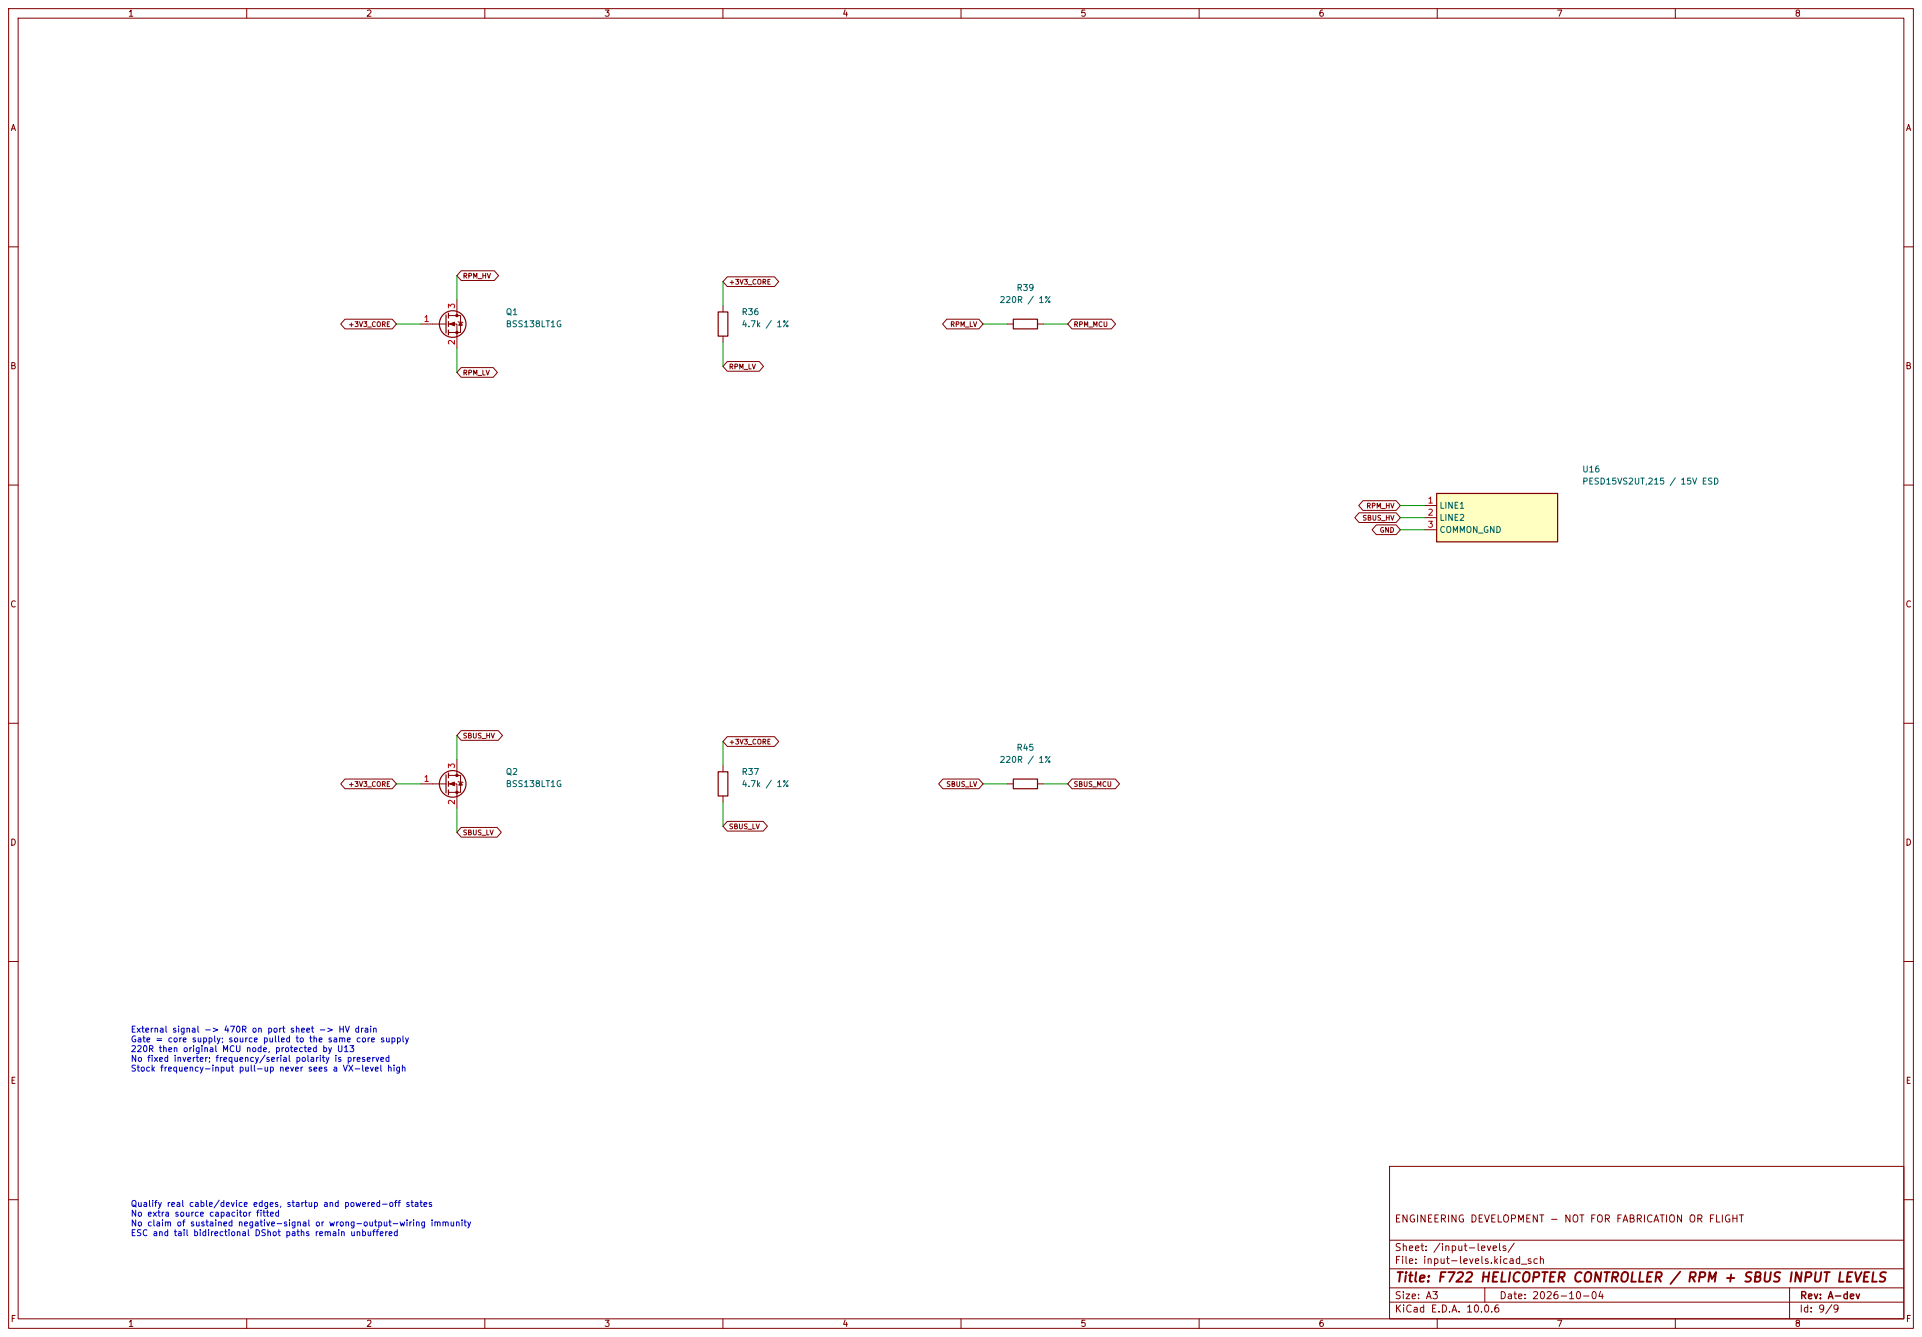
[picture p147: page 9]

Qualify real cable/device edges, startup and powered-off states No extra source capacitor fitted No claim of sustained negative-signal or wrong-output-wiring immunity ESC and tail bidirectional DShot paths remain unbuffered

ENGINEERING DEVELOPMENT - NOT FOR FABRICATION OR FLIGHT

Sheet: /input-levels/
File: input-levels.kicad_sch
Title: F722 HELICOPTER CONTROLLER / RPM + SBUS INPUT LEVELS
