chenguoming1/h743-controllers/nexus-style-fc/docs/validation/reviews/order-fixes-2026-10-17/sources/J6.pdf

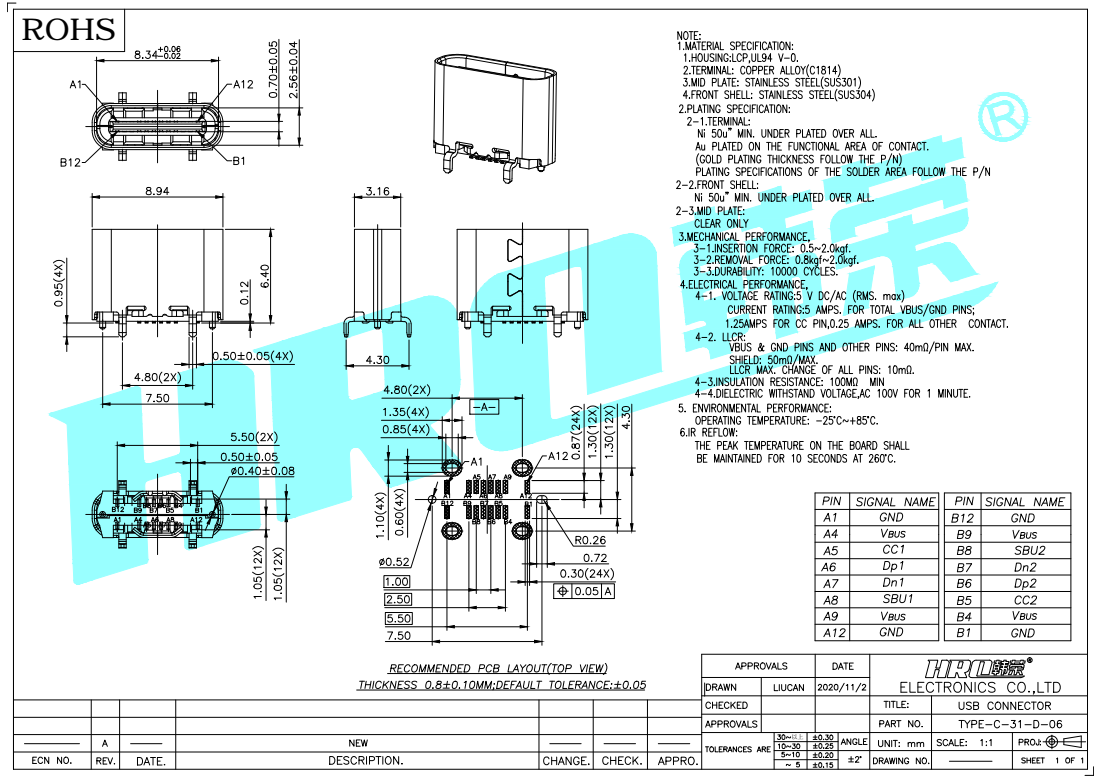
[picture p148: page 1]
