chenguoming1/h743-controllers/(list of files, drawings)

Other design files:
f722-heli/layout-revision/routing-tools/tests/end-queue-stop/fixture/routing.dsn
f722-heli/layout-revision/routing-tools/tests/failed-search-state/fixture/routing.dsn
nexus-style-fc/docs/validation/reviews/c8-via-2026-10-17/pcb-summary.json
nexus-style-fc/docs/validation/reviews/cleanup-recheck2-2026-10-17/pcb-summary.json
nexus-style-fc/docs/validation/reviews/cleanup-recheck3-2026-10-17/pcb-summary.json
nexus-style-fc/docs/validation/reviews/cleanup-recheck4-2026-10-17/pcb-summary.json
nexus-style-fc/docs/validation/reviews/cleanup-recheck-2026-10-17/pcb-summary.json
nexus-style-fc/docs/validation/reviews/gerber-reupload-2026-10-17/pcb-summary.json
nexus-style-fc/docs/validation/reviews/jlcdfm-current-2026-10-17/pcb-focused-details.json
nexus-style-fc/docs/validation/reviews/jlcdfm-current-2026-10-17/pcb-summary-normalized.json
nexus-style-fc/docs/validation/reviews/jlcdfm-current-2026-10-17/pcb-summary.json
nexus-style-fc/docs/validation/reviews/owner-recheck-20261017-2300/pcb-dfm.json
nexus-style-fc/docs/validation/reviews/owner-vx-recheck-2026-10-17/pcb-summary.json
nexus-style-fc/docs/validation/reviews/pad-spacing-2026-10-17/pcb-summary.json
nexus-style-fc/docs/validation/reviews/rounded-keepout-2026-10-17/pcb-summary.json
nexus-style-fc/docs/validation/reviews/tail-route-2026-10-17/pcb-summary-normalized.json
nexus-style-fc/docs/validation/reviews/tail-route-2026-10-17/pcb-summary.json
nexus-style-fc/docs/validation/reviews/trace-dfm-2026-10-17/pcb-category-changes.json
nexus-style-fc/docs/validation/reviews/trace-dfm-2026-10-17/pcb-summary-normalized.json
nexus-style-fc/docs/validation/reviews/trace-dfm-2026-10-17/pcb-summary.json
nexus-style-fc/docs/validation/reviews/usb-compliance-2026-10-17/pcb-transaction.json
nexus-style-fc/docs/validation/reviews/vx-copper-2026-10-17/pcb-summary.json
nexus-style-fc/docs/validation/reviews/vx-corner-width-2026-10-17/pcb-summary.json
nexus-style-fc/docs/validation/reviews/width-014-2026-10-17/pcb-category-changes.json
nexus-style-fc/docs/validation/reviews/width-014-2026-10-17/pcb-summary-normalized.json
nexus-style-fc/docs/validation/reviews/width-014-2026-10-17/pcb-summary.json
nexus-style-fc/docs/validation/reviews/width-final-2026-10-17/pcb-summary.json
nexus-style-fc/docs/validation/reviews/width-profile-2026-10-17/pcb-summary.json
self-balancing/dfm/production-P6/pcb-comparison.json
self-balancing/native/review/schematic-pdf-visual-qa.json
self-balancing/native/review/supplier-p6-evidence/pcb-comparison.json
