chenguoming1/h743-controllers/nexus-style-fc/hardware/nexus-style-fc.kicad_pcb

## KiCad design nexus-style-fc/hardware/nexus-style-fc.kicad_pcb (2026-10-18)

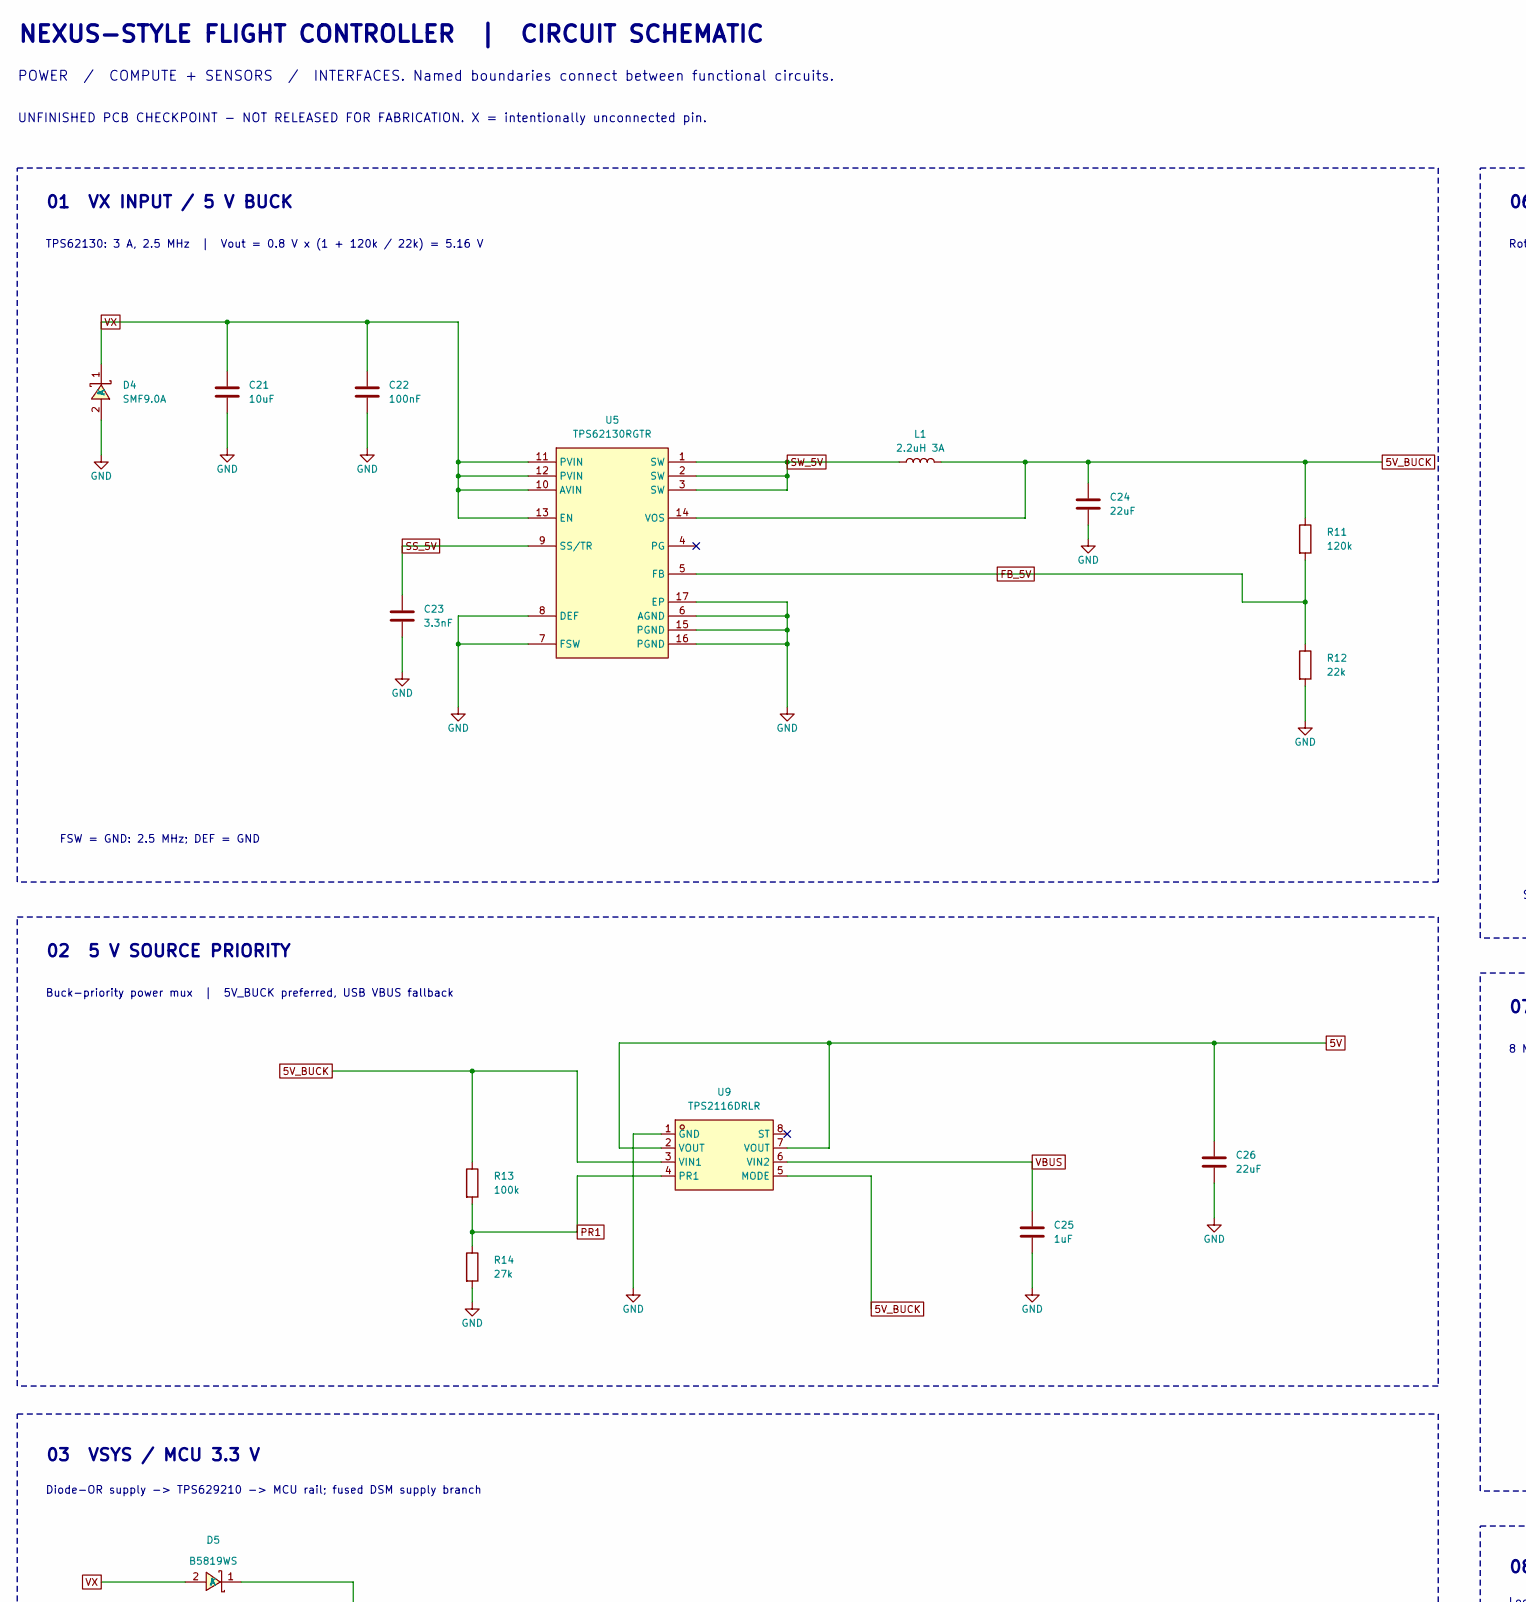
[picture p151: schematic nexus-style-fc.kicad_sch, Nexus-style FBL controller - main board, part in row 1, column 1]

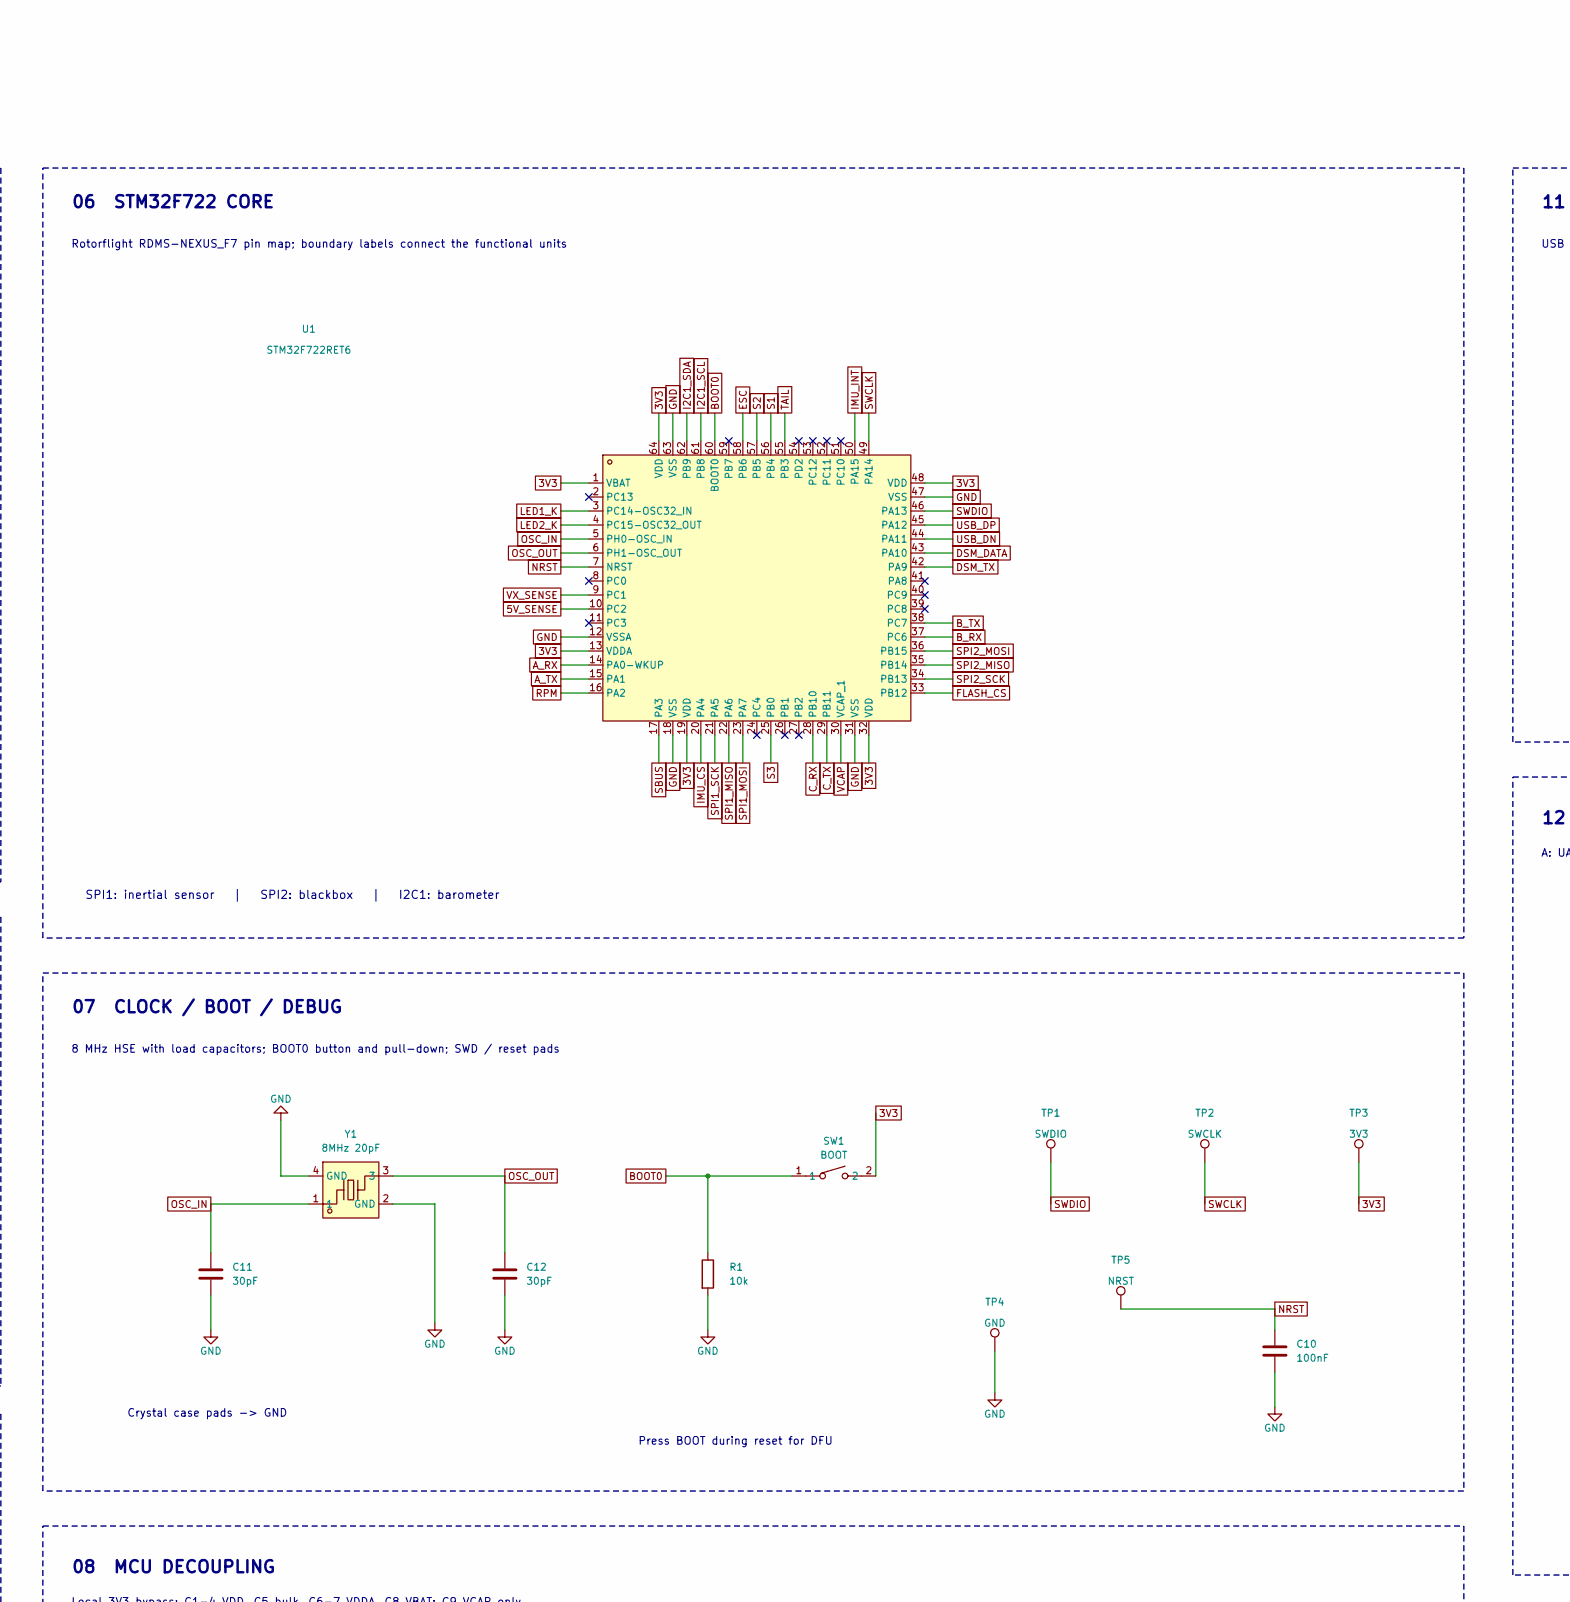
[picture p152: schematic nexus-style-fc.kicad_sch, Nexus-style FBL controller - main board, part in row 1, column 2]

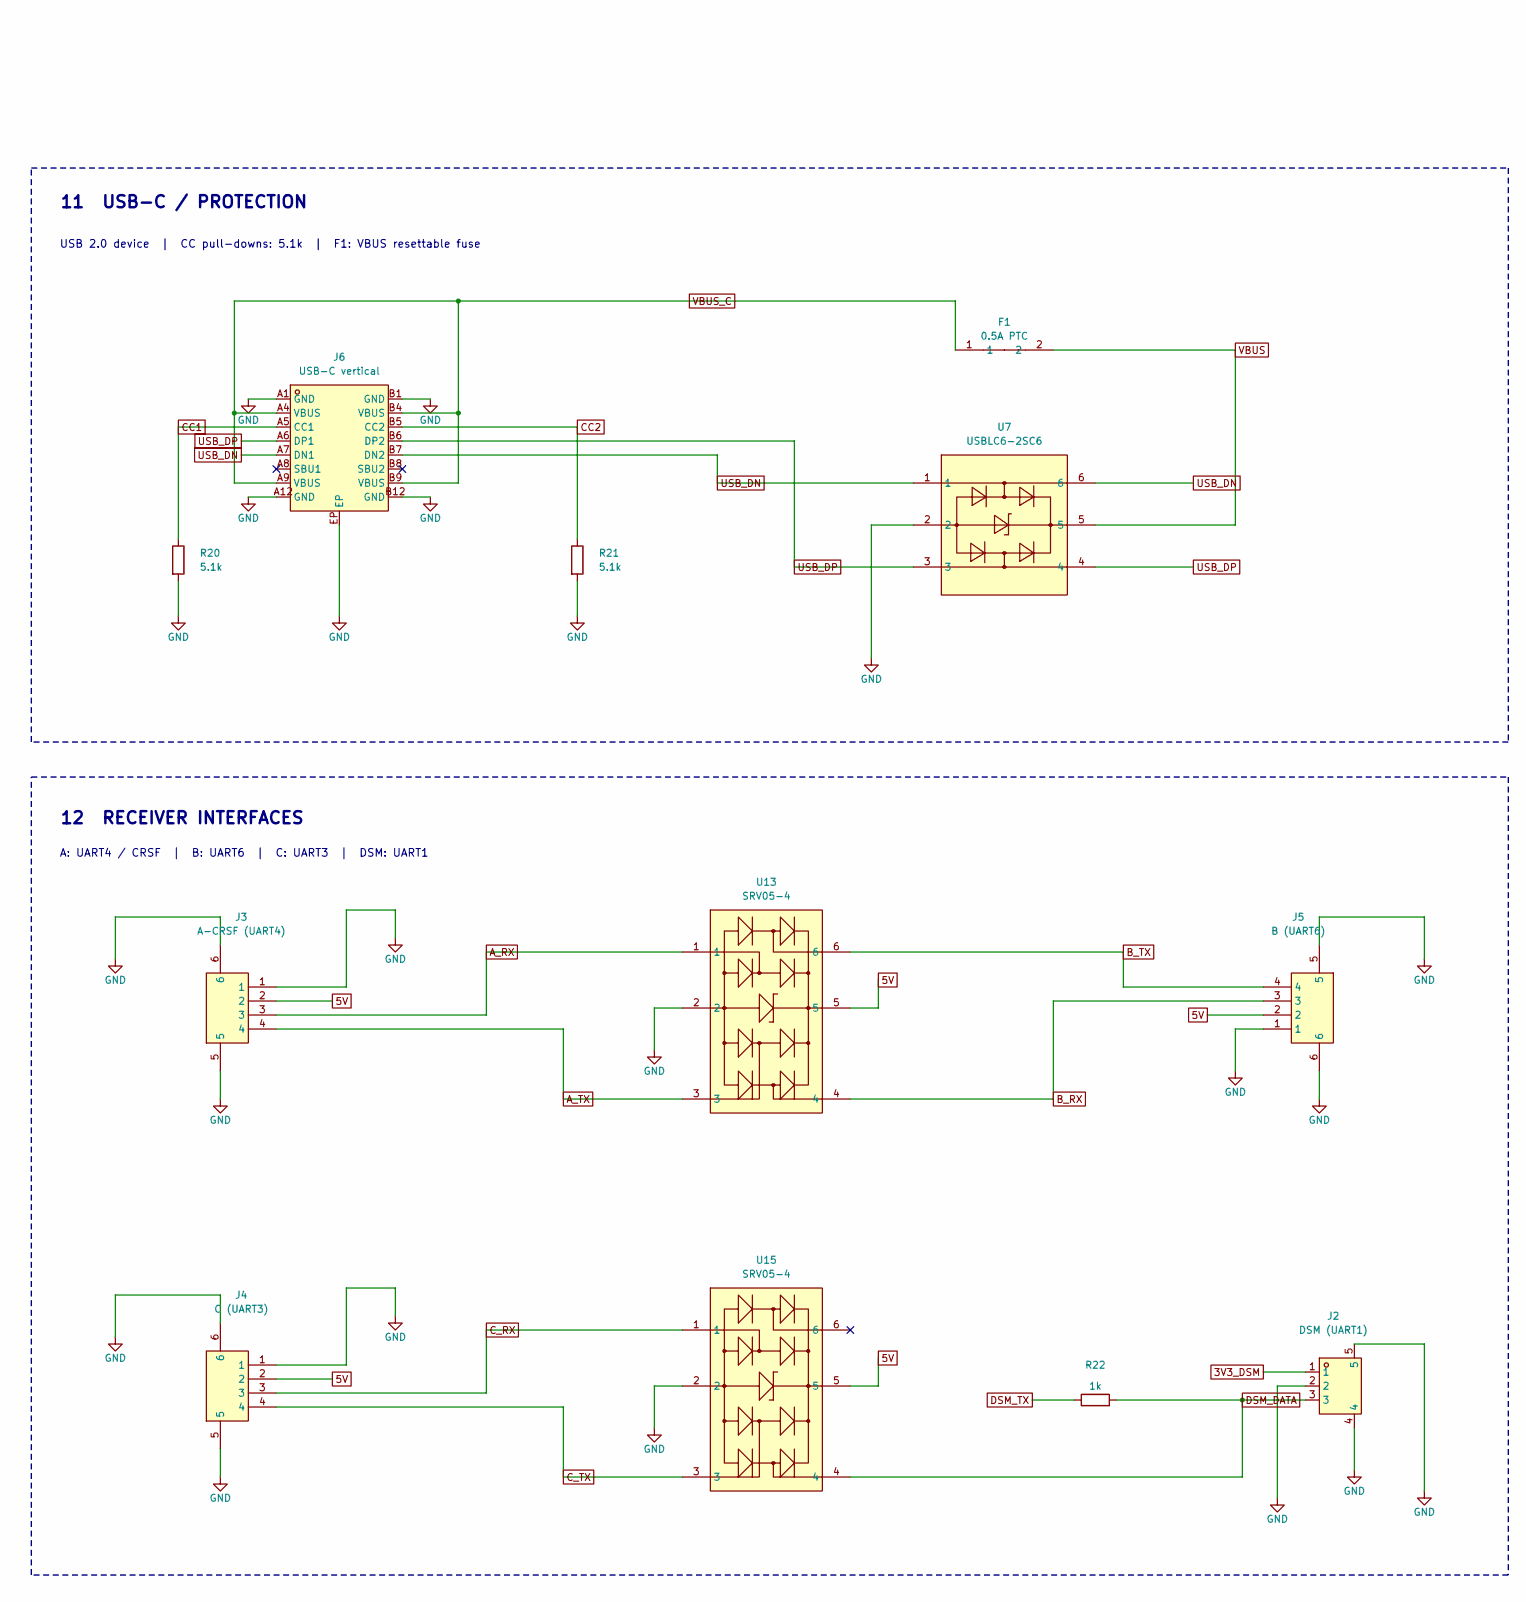
[picture p153: schematic nexus-style-fc.kicad_sch, Nexus-style FBL controller - main board, part in row 1, column 3]

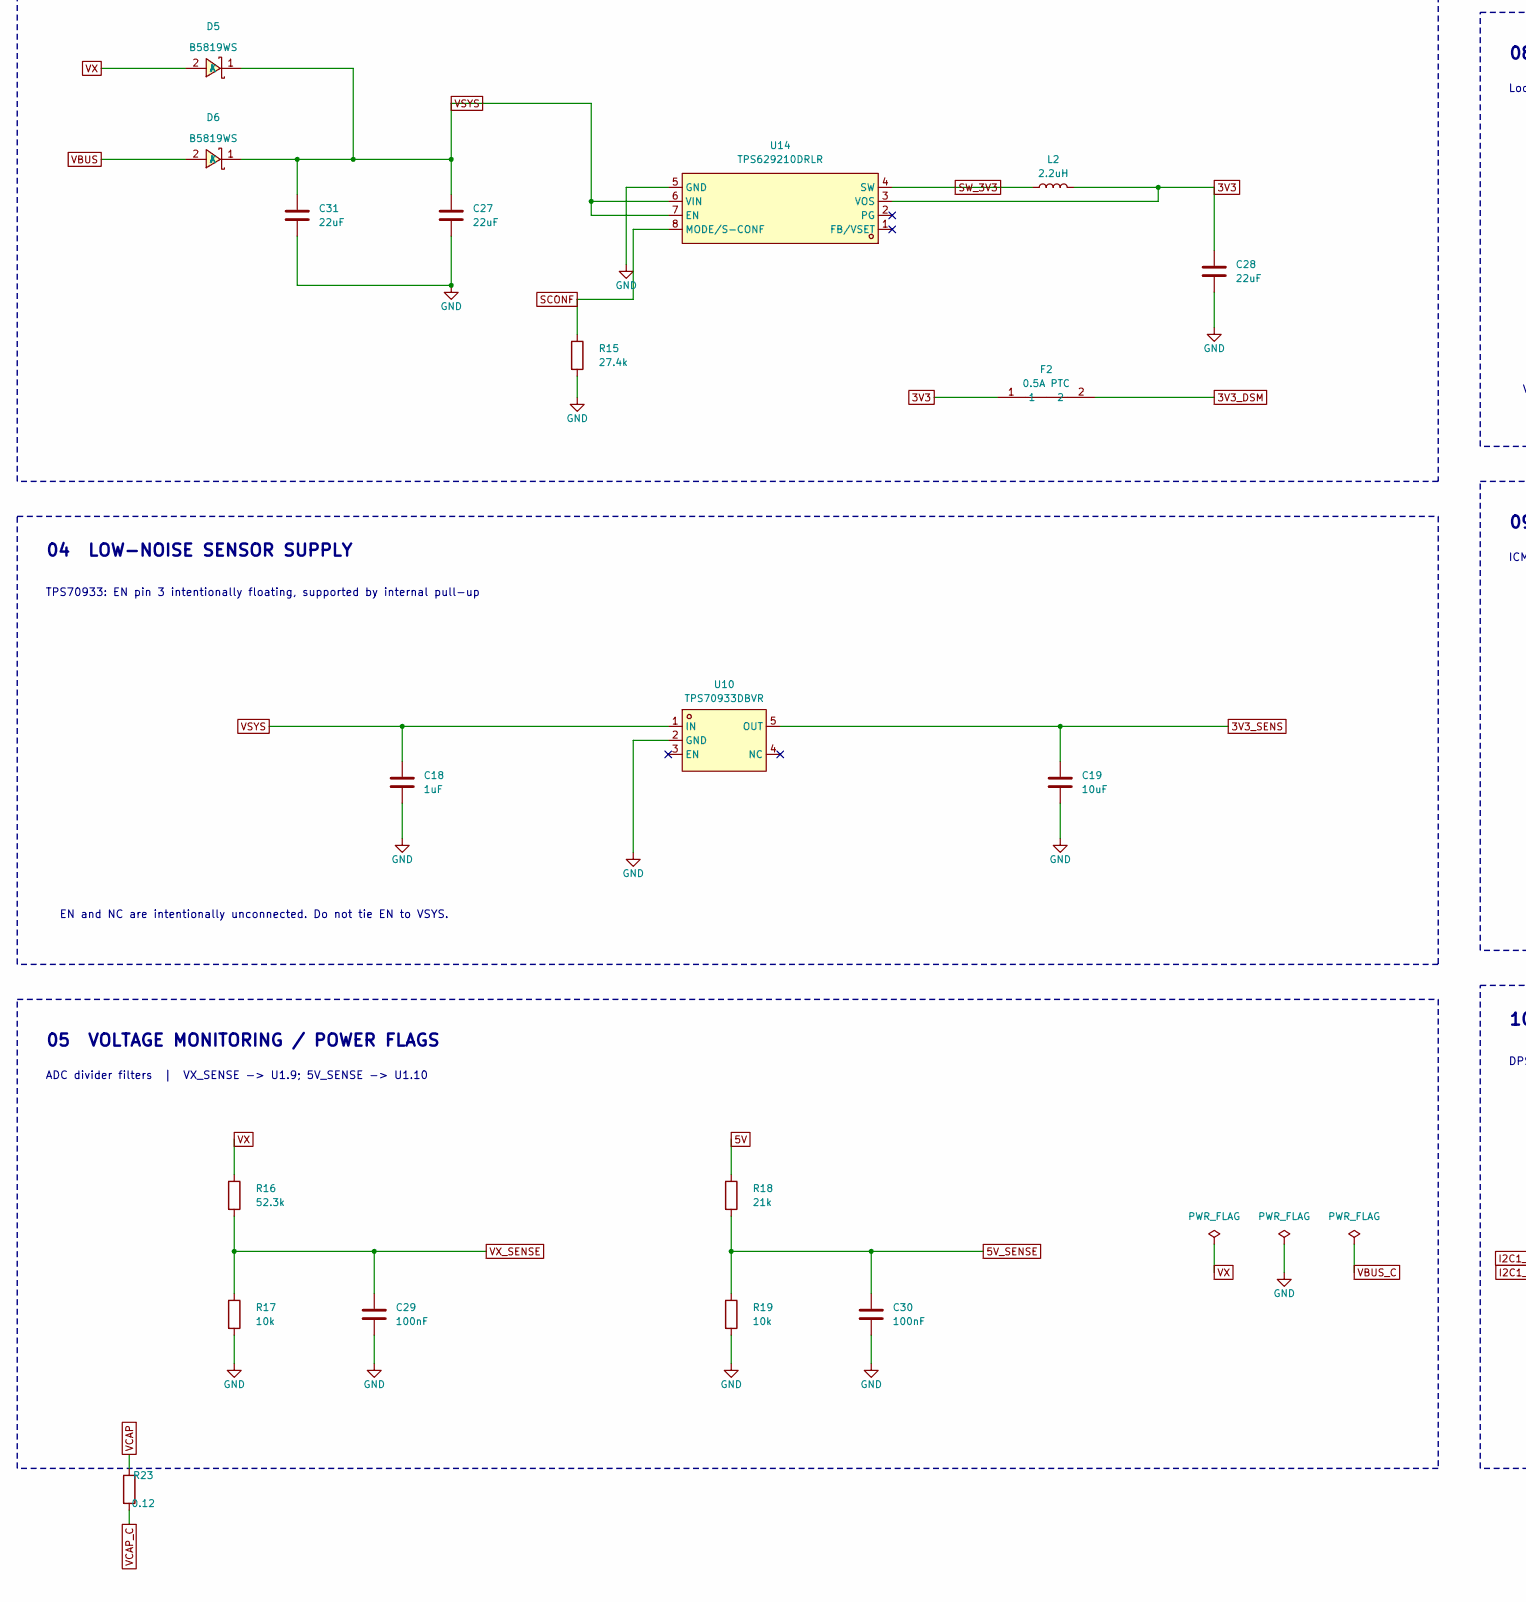
[picture p154: schematic nexus-style-fc.kicad_sch, Nexus-style FBL controller - main board, part in row 2, column 1]

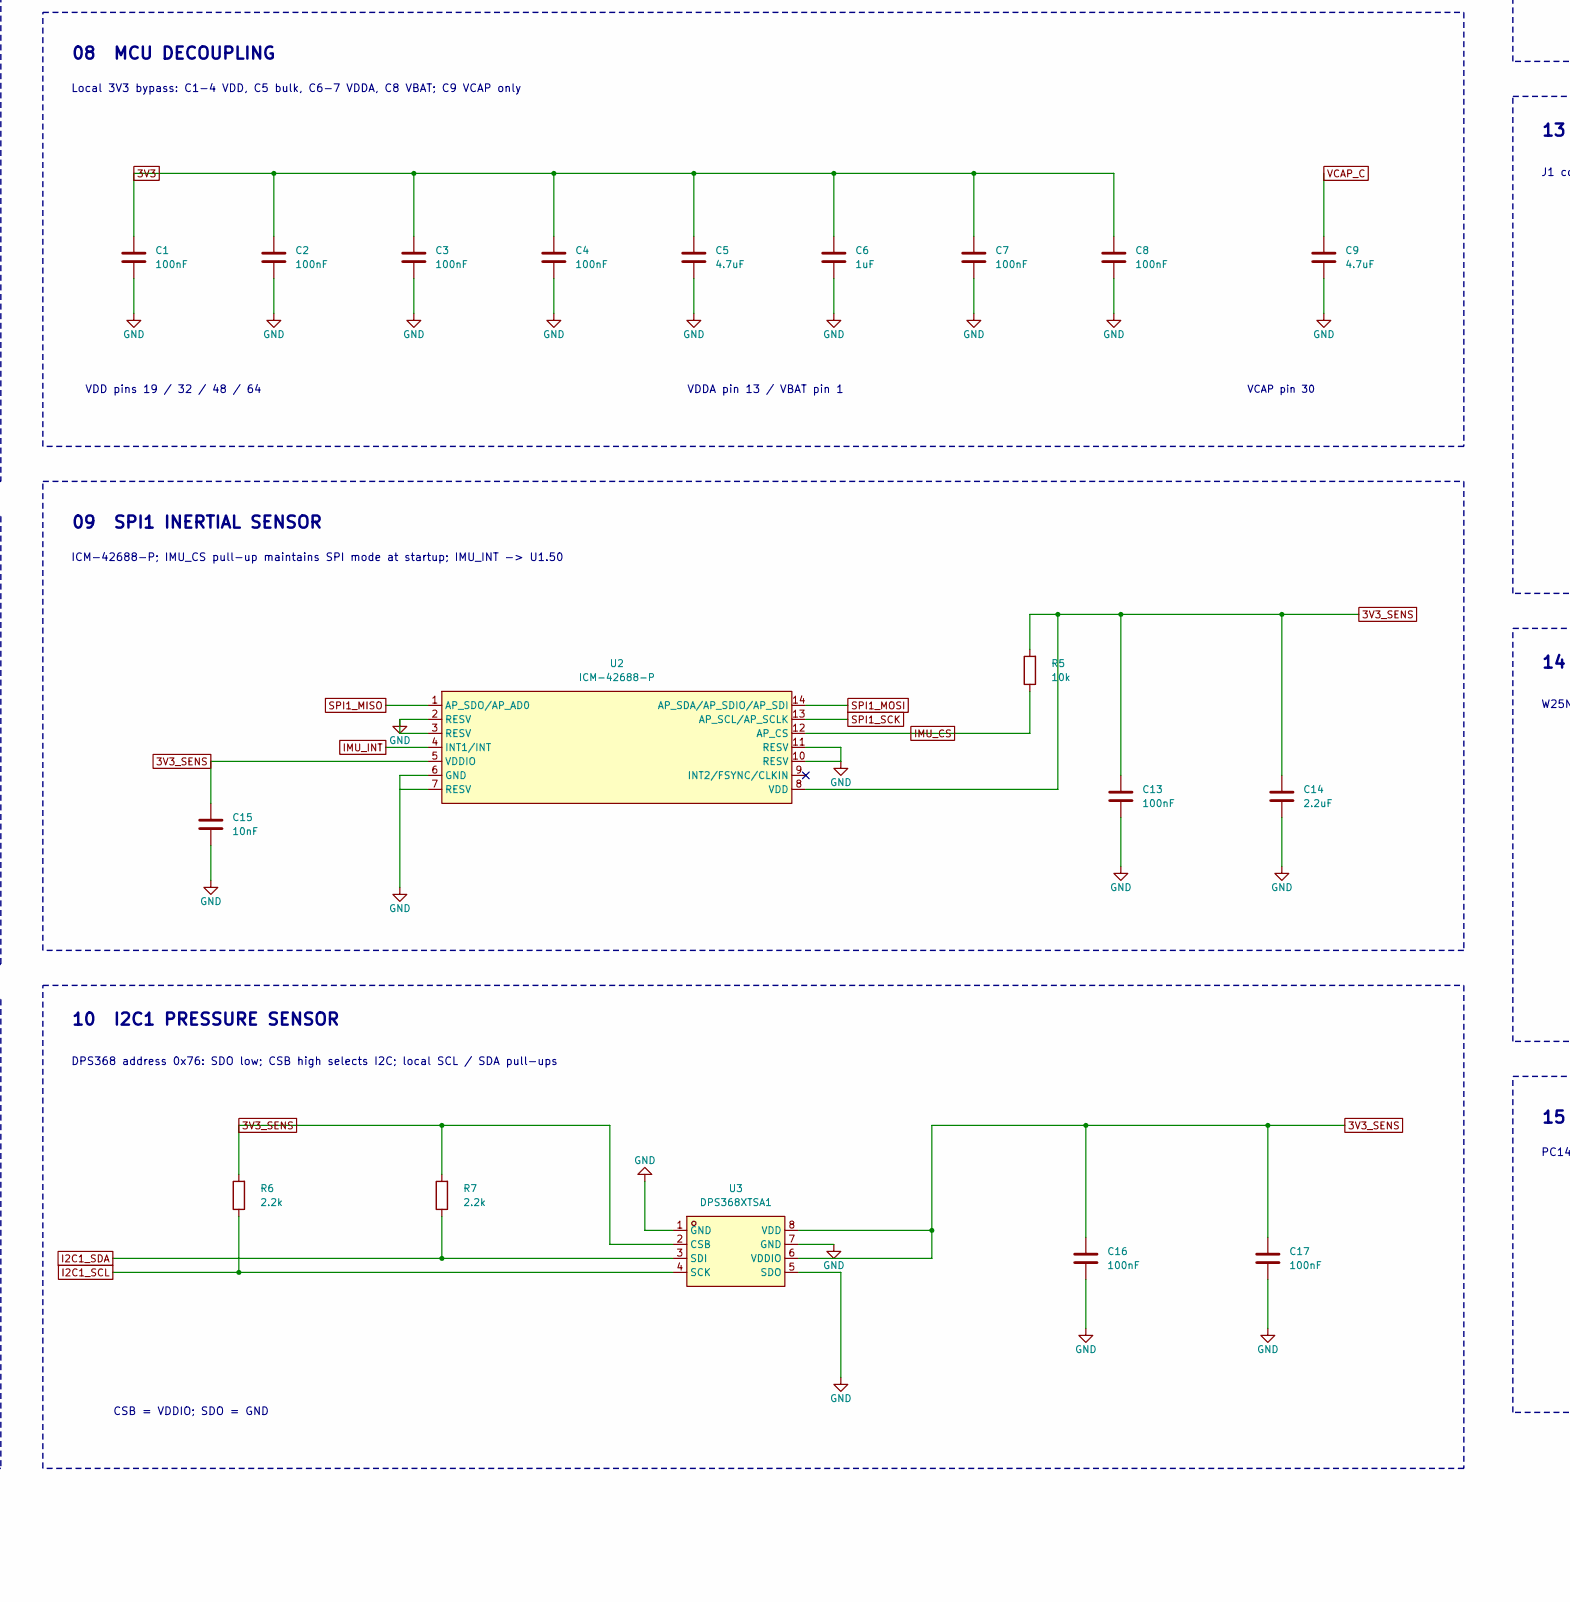
[picture p155: schematic nexus-style-fc.kicad_sch, Nexus-style FBL controller - main board, part in row 2, column 2]

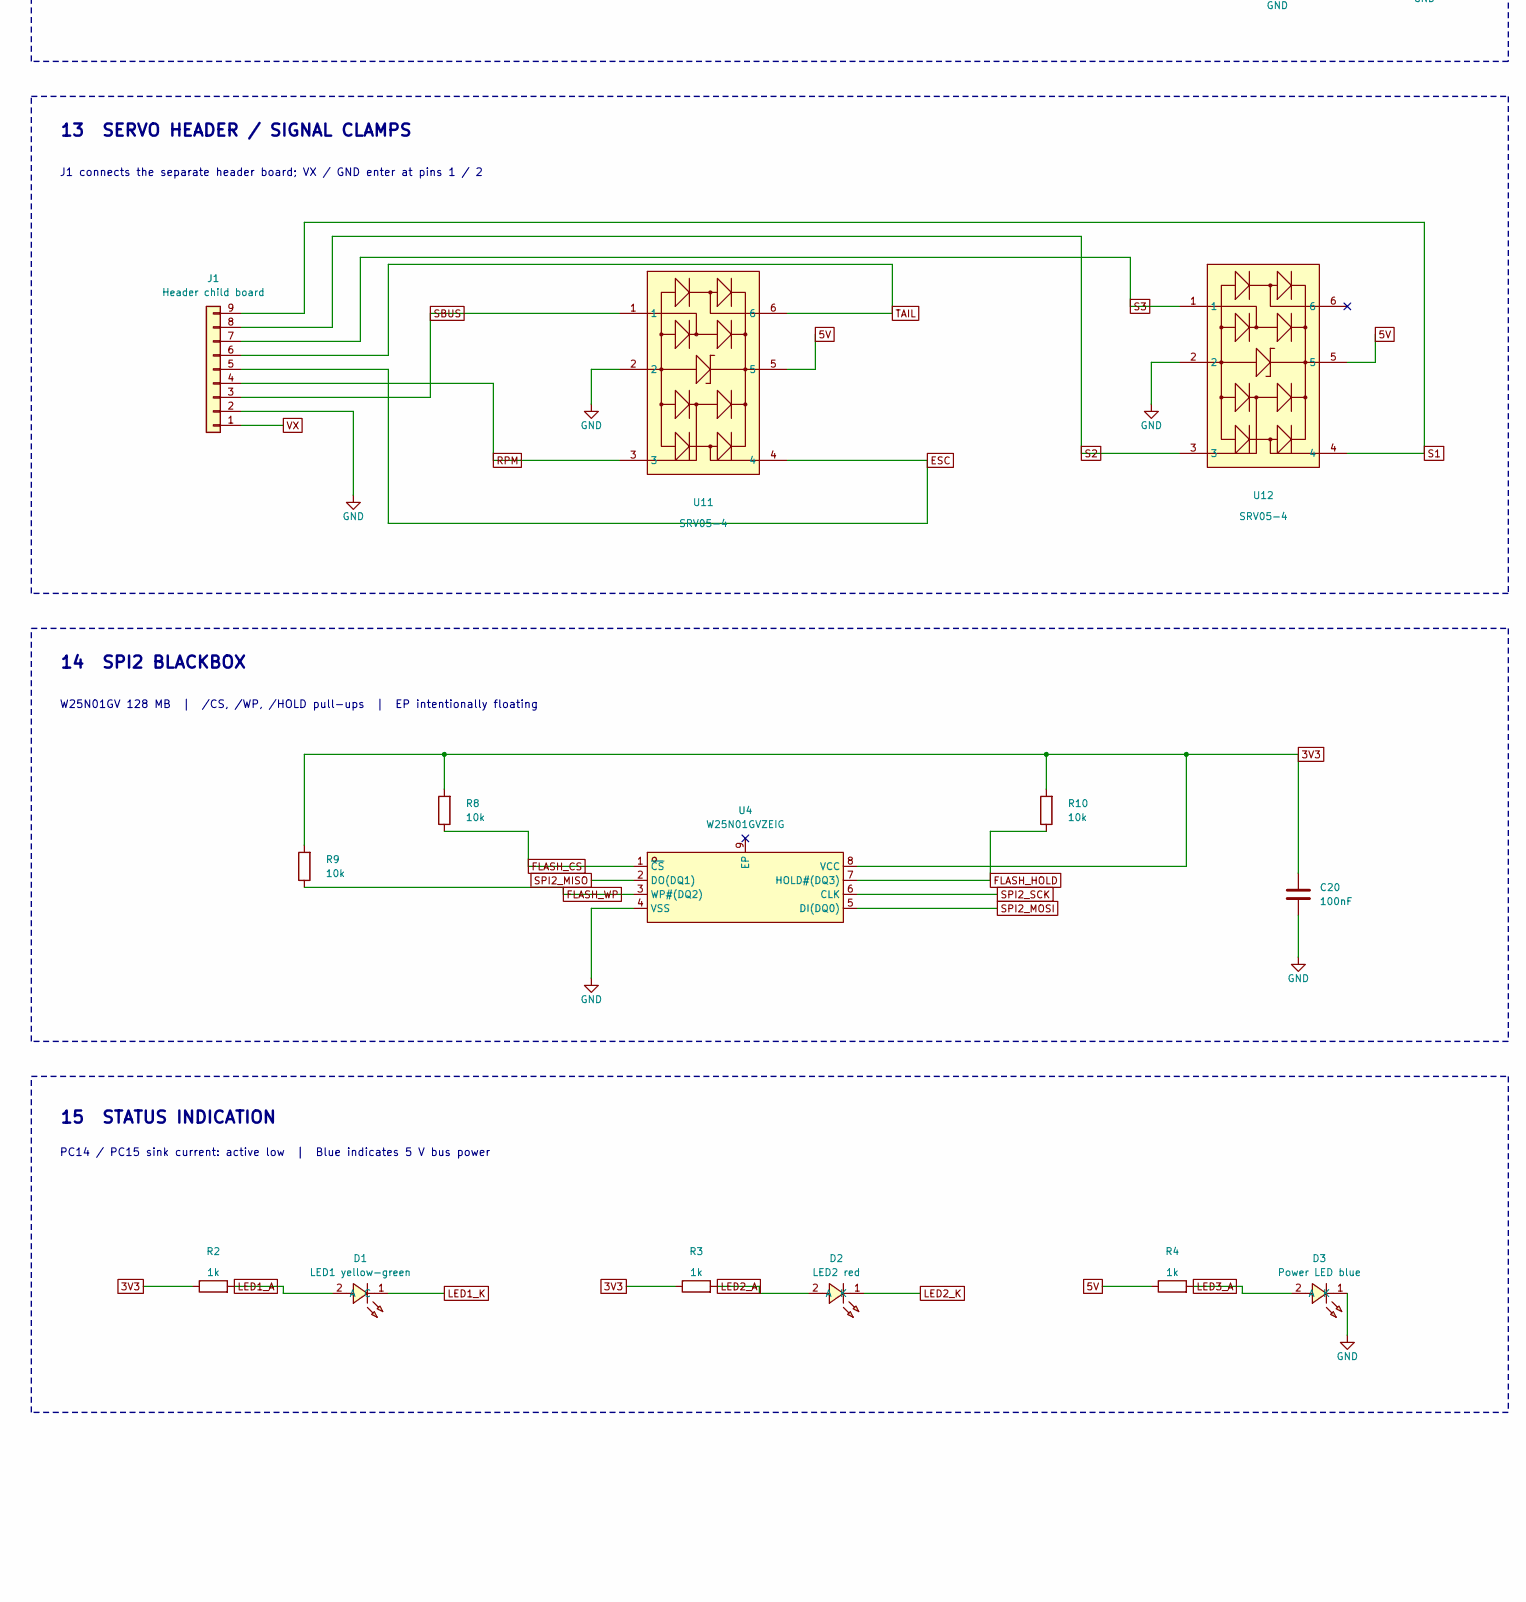
[picture p156: schematic nexus-style-fc.kicad_sch, Nexus-style FBL controller - main board, part in row 2, column 3]

Parts:
C1, C2, C3, C4, C7, C8, C10, C13, C16, C17, C20, C22, C29, C30: 100nF; C_0402_1005Metric; LCSC C1525
C5: 4.7uF; C_0603_1608Metric; LCSC C69335
C6, C18, C25: 1uF; C_0402_1005Metric; LCSC C52923
C9: 4.7uF; C_0402_1005Metric__VCAP_Dense; LCSC C368809
C11, C12: 30pF; C_0402_1005Metric; LCSC C1570
C14: 2.2uF; C_0402_1005Metric; LCSC C12530
C15: 10nF; C_0402_1005Metric; LCSC C15195
C19: 10uF; C_0603_1608Metric; LCSC C19702
C21: 10uF; C_0603_1608Metric; LCSC C96446
C23: 3.3nF; C_0402_1005Metric; LCSC C26404
C24, C26: 22uF; C_0805_2012Metric; LCSC C602037
C27, C31: 22uF; C_0805_2012Metric_Samsung_CL21_MinLand; LCSC C602037
C28: 22uF; C_0603_1608Metric; LCSC C86295
D1: LED1 yellow-green; LED0603-RD_GREEN__NexusMain_D1; LCSC C965806
D2: LED2 red; LED0603-RD_RED__NexusMain_D2; LCSC C965799
D3: Power LED blue; LED0603-RD_BLUE__NexusMain_D3; LCSC C965807
D4: SMF9.0A; SOD-123FL_L2.8-W1.8-LS3.6-RD__Littelfuse_SMF9; LCSC C1973343
D5, D6: B5819WS; SOD-323_L1.8-W1.3-LS2.5-RD; LCSC C22624
F1: 0.5A PTC; F0805__NexusMain_F1; LCSC C20978
F2: 0.5A PTC; F0805__NexusMain_F2; LCSC C20978
J1: Header child board; HeaderBoard_Joint
J2: DSM (UART1); CONN-SMD_B3B-ZR-SM4-TF__NexusMain_J2; LCSC C489717
J3: A-CRSF (UART4); CONN-SMD_4P-P1.25_BM04B-GHS-TBT-LF-SN__NexusMain_J3; LCSC C161692
J4: C (UART3); CONN-SMD_4P-P1.25_BM04B-GHS-TBT-LF-SN__NexusMain_J4; LCSC C161692
J5: B (UART6); CONN-SMD_4P-P1.25_BM04B-GHS-TBT-LF-SN__NexusMain_J5; LCSC C161692
J6: USB-C vertical; USB-C-SMD_TYPE-C-31-D-06__NexusMain_J6; LCSC C2689964
L1: 2.2uH 3A; IND-SMD_L4.6-W4.1; LCSC C142096
L2: 2.2uH; IND-SMD_L2.0-W1.6__NexusMain_L2; LCSC C5291913
R1, R5, R8, R9, R10, R17, R19: 10k; R_0402_1005Metric; LCSC C25744
R2: 1k; R_0402_1005Metric__NexusMain_R2; LCSC C11702
R3, R22: 1k; R_0402_1005Metric; LCSC C11702
R4: 1k; R_0402_1005Metric__NexusMain_R4; LCSC C11702
R6, R7: 2.2k; R_0402_1005Metric; LCSC C25879
R11: 120k; R_0402_1005Metric; LCSC C25750
R12: 22k; R_0402_1005Metric; LCSC C25768
R13: 100k; R_0402_1005Metric; LCSC C25741
R14: 27k; R_0402_1005Metric; LCSC C25771
R15: 27.4k; R_0402_1005Metric; LCSC C26971
R16: 52.3k; R_0402_1005Metric; LCSC C26982
R18: 21k; R_0402_1005Metric; LCSC C25766
R20, R21: 5.1k; R_0402_1005Metric; LCSC C25905
R23: 0.12; R_0402_1005Metric__VCAP_Dense; LCSC C2766886
SW1: BOOT; SW-SMD_L3.9-W3.0-P4.45; LCSC C720477
TP1: SWDIO; TestPoint_Pad_D1.0mm
TP2: SWCLK; TestPoint_Pad_D1.0mm
TP3: 3V3; TestPoint_Pad_D1.0mm
TP4: GND; TestPoint_Pad_D1.0mm
TP5: NRST; TestPoint_Pad_D1.0mm
U1: STM32F722RET6; LQFP-64_L10.0-W10.0-P0.50-LS12.0-BL; LCSC C118207
U2: ICM-42688-P; LGA-14_L3.0-W2.5-P0.50-TL; LCSC C1850418
U3: DPS368XTSA1; LGA-8_L2.5-W2.0-P0.65-TR_DPS368; LCSC C3232508
U4: W25N01GVZEIG; WSON-8_L8.0-W6.10-P1.27-BL-EP; LCSC C907680
U5: TPS62130RGTR; QFN-16_L3.0-W3.0-P0.50-TL-EP1.7; LCSC C43590
U7: USBLC6-2SC6; SOT-23-6_L2.9-W1.6-P0.95-LS2.8-BL; LCSC C7519
U9: TPS2116DRLR; SOT-583-8_L2.1-W1.6-P0.50-LS1.6-BL; LCSC C3235557
U10: TPS70933DBVR; TPS70933DBVR_TI_DBV0005A; LCSC C89347
U11, U12, U13, U15: SRV05-4; SOT-23-6_L2.9-W1.6-P0.95-LS2.8-BR; LCSC C13612
U14: TPS629210DRLR; SOT-5X3-8_L2.1-W1.2-P0.50-LS1.6-BL_DRL0008A; LCSC C5219301
Y1: 8MHz 20pF; CRYSTAL-SMD_4P-L3.2-W2.5-BL__NexusMain_Y1; LCSC C5181477

Connections:
3V3: C1.1, C2.1, C3.1, C4.1, C5.1, C6.1, C7.1, C8.1, C20.1, C28.1, F2.1, L2.2, R2.1, R3.1, R8.2, R9.2, R10.2, SW1.2, TP3.1, U1.1 (VBAT), U1.13 (VDDA), U1.19 (VDD), U1.32 (VDD), U1.48 (VDD), U1.64 (VDD), U4.8 (VCC), U14.3 (VOS)
3V3_DSM: F2.2, J2.1
3V3_SENS: C13.1, C14.1, C15.1, C16.1, C17.1, C19.1, R5.2, R6.2, R7.2, U2.5 (VDDIO), U2.8 (VDD), U3.2 (CSB), U3.6 (VDDIO), U3.8 (VDD), U10.5 (OUT)
5V: C26.1, J3.2, J4.2, J5.2, R4.1, R18.1, U9.2 (VOUT), U9.7 (VOUT), U11.5, U12.5, U13.5, U15.5
5V_BUCK: C24.1, L1.2, R11.1, R13.1, U5.14 (VOS), U9.3 (VIN1), U9.5 (MODE)
5V_SENSE: C30.1, R18.2, R19.1, U1.10 (PC2)
A_RX: J3.3, U1.14 (PA0-WKUP), U13.1
A_TX: J3.4, U1.15 (PA1), U13.3
BOOT0: R1.1, SW1.1, U1.60 (BOOT0)
B_RX: J5.3, U1.37 (PC6), U13.4
B_TX: J5.4, U1.38 (PC7), U13.6
CC1: J6.A5 (CC1), R20.1
CC2: J6.B5 (CC2), R21.1
C_RX: J4.3, U1.28 (PB10), U15.1
C_TX: J4.4, U1.29 (PB11), U15.3
DSM_DATA: J2.3, R22.2, U1.43 (PA10), U15.4
DSM_TX: R22.1, U1.42 (PA9)
ESC: J1.5, U1.58 (PB6), U11.4
FB_5V: R11.2, R12.1, U5.5 (FB)
FLASH_CS: R8.1, U1.33 (PB12), U4.1 (~CS)
FLASH_HOLD: R10.1, U4.7 (HOLD#(DQ3))
FLASH_WP: R9.1, U4.3 (WP#(DQ2))
GND: C1.2, C2.2, C3.2, C4.2, C5.2, C6.2, C7.2, C8.2, C9.2, C10.2, C11.2, C12.2, C13.2, C14.2, C15.2, C16.2, C17.2, C18.2, C19.2, C20.2, C21.2, C22.2, C23.2, C24.2, C25.2, C26.2, C27.2, C28.2, C29.2, C30.2, C31.2, D3.1 (K), D4.2 (A), J1.2, J2.2, J2.4, J2.5, J3.1, J3.5, J3.6, J4.1, J4.5, J4.6, J5.1, J5.5, J5.6, J6.A1 (GND), J6.A12 (GND), J6.B1 (GND), J6.B12 (GND), J6.EP, R1.2, R12.2, R14.2, R15.2, R17.2, R19.2, R20.2, R21.2, TP4.1, U1.12 (VSSA), U1.18 (VSS), U1.31 (VSS), U1.47 (VSS), U1.63 (VSS), U2.2 (RESV), U2.3 (RESV), U2.6 (GND), U2.7 (RESV), U2.10 (RESV), U2.11 (RESV), U3.1 (GND), U3.5 (SDO), U3.7 (GND), U4.4 (VSS), U5.6 (AGND), U5.7 (FSW), U5.8 (DEF), U5.15 (PGND), U5.16 (PGND), U5.17 (EP), U7.2, U9.1 (GND), U10.2 (GND), U11.2, U12.2, U13.2, U14.5 (GND), U15.2, Y1.2 (GND), Y1.4 (GND)
I2C1_SCL: R6.1, U1.61 (PB8), U3.4 (SCK)
I2C1_SDA: R7.1, U1.62 (PB9), U3.3 (SDI)
IMU_CS: R5.1, U1.20 (PA4), U2.12 (AP_CS)
IMU_INT: U1.50 (PA15), U2.4 (INT1/INT)
LED1_A: D1.2 (A), R2.2
LED1_K: D1.1 (C), U1.3 (PC14-OSC32_IN)
LED2_A: D2.2 (A), R3.2
LED2_K: D2.1 (K), U1.4 (PC15-OSC32_OUT)
LED3_A: D3.2 (A), R4.2
NRST: C10.1, TP5.1, U1.7 (NRST)
OSC_IN: C11.1, U1.5 (PH0-OSC_IN), Y1.1
OSC_OUT: C12.1, U1.6 (PH1-OSC_OUT), Y1.3
PR1: R13.2, R14.1, U9.4 (PR1)
RPM: J1.4, U1.16 (PA2), U11.3
S1: J1.9, U1.56 (PB4), U12.4
S2: J1.8, U1.57 (PB5), U12.3
S3: J1.7, U1.25 (PB0), U12.1
SBUS: J1.3, U1.17 (PA3), U11.1
SCONF: R15.1, U14.8 (MODE/S-CONF)
SPI1_MISO: U1.22 (PA6), U2.1 (AP_SDO/AP_AD0)
SPI1_MOSI: U1.23 (PA7), U2.14 (AP_SDA/AP_SDIO/AP_SDI)
SPI1_SCK: U1.21 (PA5), U2.13 (AP_SCL/AP_SCLK)
SPI2_MISO: U1.35 (PB14), U4.2 (DO(DQ1))
SPI2_MOSI: U1.36 (PB15), U4.5 (DI(DQ0))
SPI2_SCK: U1.34 (PB13), U4.6 (CLK)
SS_5V: C23.1, U5.9 (SS/TR)
SWCLK: TP2.1, U1.49 (PA14)
SWDIO: TP1.1, U1.46 (PA13)
SW_3V3: L2.1, U14.4 (SW)
SW_5V: L1.1, U5.1 (SW), U5.2 (SW), U5.3 (SW)
TAIL: J1.6, U1.55 (PB3), U11.6
USB_DN: J6.A7 (DN1), J6.B7 (DN2), U1.44 (PA11), U7.1, U7.6
USB_DP: J6.A6 (DP1), J6.B6 (DP2), U1.45 (PA12), U7.3, U7.4
VBUS: C25.1, D6.2 (A), F1.2, U7.5, U9.6 (VIN2)
VBUS_C: F1.1, J6.A4 (VBUS), J6.A9 (VBUS), J6.B4 (VBUS), J6.B9 (VBUS)
VCAP: R23.1, U1.30 (VCAP_1)
VCAP_C: C9.1, R23.2
VSYS: C18.1, C27.1, C31.1, D5.1 (K), D6.1 (K), U10.1 (IN), U14.6 (VIN), U14.7 (EN)
VX: C21.1, C22.1, D4.1 (K), D5.2 (A), J1.1, R16.1, U5.10 (AVIN), U5.11 (PVIN), U5.12 (PVIN), U5.13 (EN)
VX_SENSE: C29.1, R16.2, R17.1, U1.9 (PC1)

Notes on the sheet:
8 MHz HSE with load capacitors; BOOT0 button and pull-down; SWD / reset pads
10 I2C1 PRESSURE SENSOR
09 SPI1 INERTIAL SENSOR
TPS62130: 3 A, 2.5 MHz | Vout = 0.8 V x (1 + 120k / 22k) = 5.16 V
VDD pins 19 / 32 / 48 / 64
USB 2.0 device | CC pull-downs: 5.1k | F1: VBUS resettable fuse
06 STM32F722 CORE
ADC divider filters | VX_SENSE -> U1.9; 5V_SENSE -> U1.10
Buck-priority power mux | 5V_BUCK preferred, USB VBUS fallback
DPS368 address 0x76: SDO low; CSB high selects I2C; local SCL / SDA pull-ups
POWER / COMPUTE + SENSORS / INTERFACES. Named boundaries connect between functional circuits.
15 STATUS INDICATION
SPI1: inertial sensor | SPI2: blackbox | I2C1: barometer
ICM-42688-P; IMU_CS pull-up maintains SPI mode at startup; IMU_INT -> U1.50
VDDA pin 13 / VBAT pin 1
04 LOW-NOISE SENSOR SUPPLY
NEXUS-STYLE FLIGHT CONTROLLER | CIRCUIT SCHEMATIC
Crystal case pads -> GND
02 5 V SOURCE PRIORITY
Local 3V3 bypass: C1-4 VDD, C5 bulk, C6-7 VDDA, C8 VBAT; C9 VCAP only
FSW = GND: 2.5 MHz; DEF = GND
W25N01GV 128 MB | /CS, /WP, /HOLD pull-ups | EP intentionally floating
Diode-OR supply -> TPS629210 -> MCU rail; fused DSM supply branch
05 VOLTAGE MONITORING / POWER FLAGS
Rotorflight RDMS-NEXUS_F7 pin map; boundary labels connect the functional units
J1 connects the separate header board; VX / GND enter at pins 1 / 2
13 SERVO HEADER / SIGNAL CLAMPS
01 VX INPUT / 5 V BUCK
UNFINISHED PCB CHECKPOINT - NOT RELEASED FOR FABRICATION. X = intentionally unconnected pin.
03 VSYS / MCU 3.3 V
Press BOOT during reset for DFU
11 USB-C / PROTECTION
A: UART4 / CRSF | B: UART6 | C: UART3 | DSM: UART1
CSB = VDDIO; SDO = GND
07 CLOCK / BOOT / DEBUG
08 MCU DECOUPLING
VCAP pin 30
TPS70933: EN pin 3 intentionally floating, supported by internal pull-up
PC14 / PC15 sink current: active low | Blue indicates 5 V bus power
12 RECEIVER INTERFACES
14 SPI2 BLACKBOX
EN and NC are intentionally unconnected. Do not tie EN to VSYS.

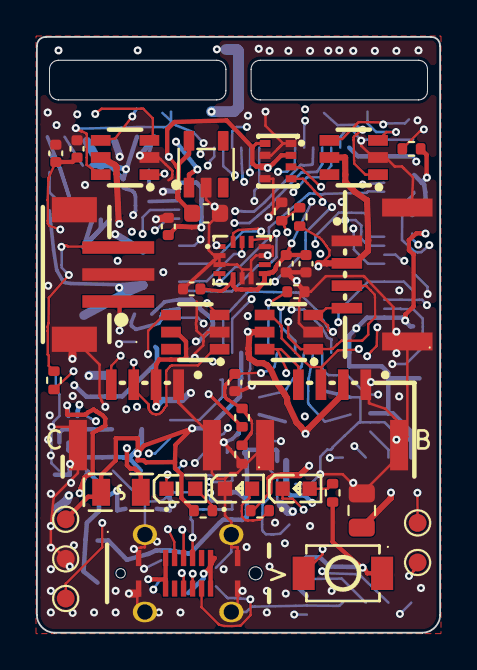
[picture p157: board nexus-style-fc.kicad_pcb from above]

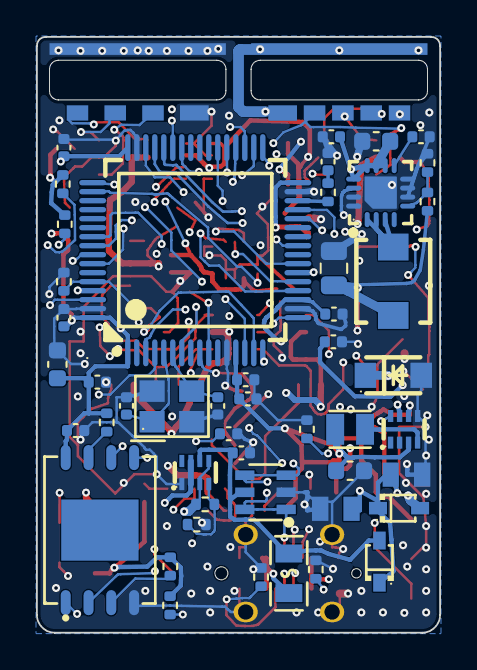
[picture p158: board nexus-style-fc.kicad_pcb from below]

Board: 6 copper layers, 22.4 x 33.1 mm, 90 parts (48 on the bottom side), 63 nets.
