chenguoming1/h743-controllers/f722-heli/hardware/f722-heli.kicad_pcb

## KiCad design f722-heli/hardware/f722-heli.kicad_pcb (2026-10-14)

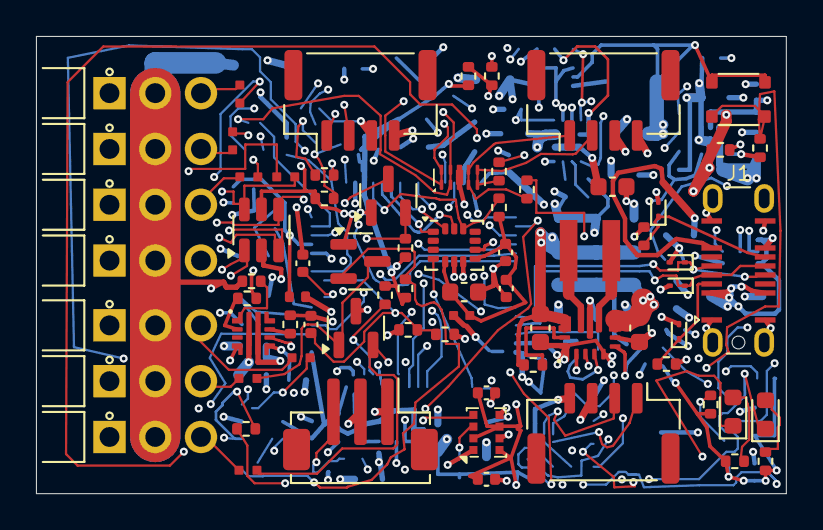
[picture p159: board f722-heli.kicad_pcb from above]

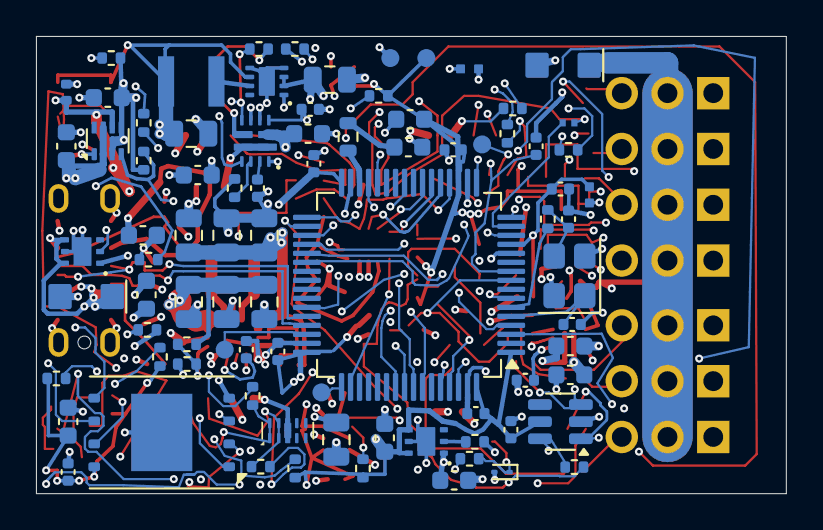
[picture p160: board f722-heli.kicad_pcb from below]

Board: 6 copper layers, 41.7 x 25.4 mm, 156 parts (84 on the bottom side), 95 nets.

Parts:
C1, C2, C3, C4, C6, C9, C10, C12, C14, C16, C17, C58: 100nF / 16V / X7R; C_0402_1005Metric
C5: 4.7uF / 10V / X5R; C_0603_1608Metric
C7, C61, C68, C70: 4.7uF / 10V / X7R; C_0603_1608Metric
C8, C60: 2.2uF / 10V / X7R(Murata); Murata_GRM155Z71A225KE44_0402
C11: 10nF / 16V / X7R; C_0402_1005Metric
C13: 2.2uF / 10V / X7R; C_0603_1608Metric
C15, C59, C65, C69: 1uF / 10V / X7R; C_0603_1608Metric
C18, C19: 15pF / 50V / C0G; C_0402_1005Metric
C20: 1uF / 16V / X7R; C_0603_1608Metric
C30, C31: 220nF / 16V / X7R; C_0402_1005Metric
C50: 3.3nF / 50V / C0G; C_0402_1005Metric
C51, C52, C64, C74: 1uF / 25V / X7R; C_0603_1608Metric
C53, C54, C66, C71: 22uF / 25V / X5R; C_0805_2012Metric
C55, C56, C57, C75: 47uF / 10V / X5R; C_0805_2012Metric
C62: 100nF / 25V / X7R; C_0402_1005Metric
C63: 1nF / 50V / C0G; C_0402_1005Metric
C67: 22uF / 10V / X7R; C_0805_2012Metric
C72, C73: 10uF / 25V / X5R / HF; C_0603_1608Metric
D1: GREEN; LED_0603_1608Metric
D2: RED; LED_0603_1608Metric
D3, D4, D5, D6, D7: ESD9M5.0ST5G; D_SOD-923
D8: SMF5.0A / transient only; Littelfuse_SMF_SOD123FL
D9: SMF15CA / bidirectional; Littelfuse_SMF_SOD123FL
FB1, FB2: 600R@100MHz / 0.3A; Murata_BLM15AG_0402
J1: USB4145-03-0170-C; USB_C_Receptacle_GCT_USB4145-03-0170-C_16P_Vertical
J2: S1 / GND-VX-S; Samtec_HTSW-101-08-L-T-RA_TripleRow_OpenEdgeSilk
J3: S2 / GND-VX-S; Samtec_HTSW-101-08-L-T-RA_TripleRow_OpenEdgeSilk
J4: S3 / GND-VX-S; Samtec_HTSW-101-08-L-T-RA_TripleRow_OpenEdgeSilk
J5: TAIL / GND-VX-S; Samtec_HTSW-101-08-L-T-RA_TripleRow_OpenEdgeSilk
J6: ESC / GND-VX-S; Samtec_HTSW-101-08-L-T-RA_TripleRow_OpenEdgeSilk
J7: RPM / GND-VX-S; Samtec_HTSW-101-08-L-T-RA_TripleRow_OpenEdgeSilk
J8: SBUS / GND-VX-S; Samtec_HTSW-101-08-L-T-RA_TripleRow_OpenEdgeSilk
J9: PORT A / JST GH; JST_GH_BM04B-GHS-TBT_1x04-1MP_P1.25mm_Vertical
J10: PORT B / JST GH; JST_GH_BM04B-GHS-TBT_1x04-1MP_P1.25mm_Vertical
J11: PORT C / JST GH; JST_GH_BM04B-GHS-TBT_1x04-1MP_P1.25mm_Vertical
J12: DSM / JST ZH; JST_ZH_B3B-ZR-SM4-TF_1x03-1MP_P1.50mm_Vertical
L1: 1.5uH / XGL4020-152MEC; Coilcraft_XGL4020
L2: 3.3uH / DFE322512F; Murata_DFE322512F
Q1, Q2: BSS138LT1G; SOT-23
R1, R3, R4, R6, R64, R69: 10k / 1%; R_0402_1005Metric
R2, R7, R8, R10, R11: 2.2k / 1%; R_0402_1005Metric
R5: 10k / 1%; R_0402_1005Metric_R5_ClearPin1Silk
R9: 0R / drive tuning; R_0402_1005Metric
R14, R15: 5.1k / 1%; R_0402_1005Metric
R16: 0.12R / 1% / VCAP ESR; R_Panasonic_ERJ3R_0603
R20, R21, R22, R23, R24, R25, R26: 470R / 1% / 0.20W; Panasonic_ERJPA2_0402
R30, R32, R33, R34, R35, R38: 22R / 1%; R_0402_1005Metric
R31: 22R / 1%; R_0201_0603Metric_YAGEO_AC
R36, R37: 4.7k / 1%; R_0402_1005Metric
R39, R45: 220R / 1%; R_0402_1005Metric
R40: 105k / 0.1%; R_0402_1005Metric
R41: 20.0k / 0.1%; R_0402_1005Metric
R42: 68.0k / 0.1%; R_0402_1005Metric
R43, R44: 16.0k / 0.1%; R_0402_1005Metric
R50: 1.5M / 1%; R_0402_1005Metric
R51: 390k / 1%; R_0402_1005Metric
R52: 750R / 1%; R_0402_1005Metric
R53: 4.7k / 1%; Panasonic_ERJPA2_0402
R54: 53.6k / 0.1%; R_0402_1005Metric
R55, R61, R63: 10.0k / 0.1%; R_0402_1005Metric
R56, R57: 100k / 1%; R_0402_1005Metric
R58: 47k / 1%; R_0402_1005Metric
R60: 18.0k / 0.1%; R_0402_1005Metric
R62: 12.7k / 0.1%; R_0402_1005Metric
R65: 330k / 1%; R_0402_1005Metric
R66: 80.6k / 1%; R_0402_1005Metric
R67: 66.5k / 1%; R_0402_1005Metric
R68: 1k / 1%; R_0402_1005Metric
R70: 45.3k / 1%; R_0402_1005Metric
R71: 100k / 1% / ROM RX idle; R_0402_1005Metric
SW1: BOOT / KMT031NGJLHS; CK_KMT031NGJLHS
TP1: SWD SWDIO; TestPoint_Pad_D1.0mm_Compact
TP2: SWD SWCLK; TestPoint_Pad_D1.0mm_Compact
TP3: SWD +3V3_CORE; TestPoint_Pad_D1.0mm_Compact
TP4: SWD GND; TestPoint_Pad_D1.0mm_Compact
TP5: SWD NRST; TestPoint_Pad_D1.0mm_Compact
U1: STM32F722RET6; LQFP-64_10x10mm_P0.5mm
U2: ICM-42688-P; LGA-14_3x2.5mm_P0.5mm_LayoutBorder3x4y
U3: W25N01GVZEIG / 128MiB; WSON-8-1EP_8x6mm_P1.27mm_EP3.4x4.3mm
U4: DPS368XTSA1 / 0x76; Infineon_DPS368_VLGA-8_2.5x2mm_SMD
U5: TPS259472ARPWR; Texas_RPW0010A_TPS259472_2x2mm
U6: TPS63070RNMR / nominal 5.088V; Texas_RNM0015A_TPS63070_2.5x3mm
U7: TPS2117DRLR / ABC priority mux; SOT-583-8
U8: TPS2121RUXR / BEC-priority core mux; Texas_RUX0012A_TPS2121_2x2.5mm
U9: TPS62162DSGR / 3.3V 1A; Texas_DSG0008A_TPS62162_2x2mm_EP0.9x1.6mm
U10: TPS2553DRVR / USB input limit; Texas_DRV0006A_TPS2553_2x2mm_EP1x1.6mm
U11: TPS2553DRVR / DSM output limit; Texas_DRV0006A_TPS2553_2x2mm_EP1x1.6mm
U12, U13: USBLC6-4SC6 / header clamp; SOT-23-6
U14, U15: TPD4E05U06DQAR / UART ESD; Texas_DQA0010B_TPD4E05U06_2.5x1mm
U16: PESD15VS2UT,215 / 15V ESD; SOT-23
Y1: 8MHz / CL10pF / TAXM8M4RDBCCT2T; Crystal_SMD_3225-4Pin_3.2x2.5mm

Connections:
+3V3_ANALOG: C8.1, C9.1, FB1.2, U1.13
+3V3_CORE: C1.1, C2.1, C3.1, C4.1, C5.1, C6.1, C14.1, C15.1, C16.1, C17.1, C67.1, C69.1, FB1.1, FB2.1, L2.2, Q1.1, Q2.1, R1.1, R4.1, R5.1, R6.1, R7.1, R8.1, R10.1, R11.1, R36.1, R37.1, R62.1, R64.1, R71.1, SW1.1, TP3.1, U1.1, U1.19, U1.32, U1.48, U1.64, U3.8, U4.2, U4.6, U4.8, U9.6, U11.4, U11.6, U12.5, U13.5
+3V3_DSM: C70.1, J12.1, U11.1
+3V3_IMU: C11.1, C12.1, C13.1, FB2.2, R3.1, U2.5, U2.8
+5V_BEC: C55.1, C56.1, C57.1, C59.1, C73.1, R54.1, R56.1, R58.1, U6.7, U6.8, U7.3, U7.5
+5V_PERIPH: C61.1, C75.1, J9.3, J10.3, J11.3, R42.1, U7.2, U7.7
ABC_EN: R57.2, U6.14
ABC_FB: R54.2, R55.1, U6.5
ABC_L1: L1.1, U6.11
ABC_L2: L1.2, U6.9
ABC_PG: R56.2, U6.2, U7.4
ABC_VAUX: C58.1, U6.3
ADC_BEC: C30.1, R40.2, R41.1, U1.9
ADC_BUS: C31.1, R42.2, R43.1, U1.10
ADC_DIV_MID: R43.2, R44.1
BARO_SCL: R7.2, U1.61, U4.4
BARO_SDA: R8.2, U1.62, U4.3
BOOT0: R2.1, SW1.2, U1.60
CORE_BUCK_IN: C66.1, C74.1, U8.1, U8.8, U9.2, U9.3
CORE_ILIM: R66.1, U8.10
CORE_MUX_ST: R64.2, R65.1, U8.9
CORE_PRIORITY: R60.2, R61.1, R65.2, U8.6
CORE_REF: C63.1, R62.2, R63.1, U8.3
CORE_SS: C62.1, U8.11
CORE_SW: L2.1, U9.7
D1_A: D1.2, R10.2
D2_A: D2.2, R11.2
DSM_ILIM: R70.1, U11.2
DSM_RX_EXT: D7.1, J12.3, R38.1
DSM_RX_MCU: R38.2, R71.2, U1.43
EFUSE_DVDT: C50.1, U5.7
EFUSE_EN: R50.2, U5.1
EFUSE_ILM: R52.1, U5.9
EFUSE_OVC: R51.1, U5.2
ESC_EXT: J6.3, R24.1
ESC_MCU: R24.2, U1.58, U13.3
FLASH_CS: R4.2, U1.33, U3.1
FLASH_HOLD_N: R6.2, U3.7
FLASH_MISO: U1.35, U3.2
FLASH_MOSI: U1.36, U3.5
FLASH_SCK: U1.34, U3.6
FLASH_WP_N: R5.2, U3.3
GND: C1.2, C2.2, C3.2, C4.2, C5.2, C6.2, C7.2, C8.2, C9.2, C10.2, C11.2, C12.2, C13.2, C14.2, C15.2, C16.2, C17.2, C18.2, C19.2, C20.2, C30.2, C31.2, C50.2, C51.2, C52.2, C53.2, C54.2, C55.2, C56.2, C57.2, C58.2, C59.2, C60.2, C61.2, C62.2, C63.2, C64.2, C65.2, C66.2, C67.2, C68.2, C69.2, C70.2, C71.2, C72.2, C73.2, C74.2, C75.2, D3.2, D4.2, D5.2, D6.2, D7.2, D8.2, D9.2, J1.A1, J1.A12, J1.B1, J1.B12, J1.S1, J2.1, J3.1, J4.1, J5.1, J6.1, J7.1, J8.1, J9.4, J10.4, J11.4, J12.2, R2.2, R14.2, R15.2, R41.2, R44.2, R51.2, R52.2, R53.2, R55.2, R58.2, R61.2, R63.2, R66.2, R67.2, R68.2, R69.2, R70.2, TP4.1, U1.12, U1.18, U1.31, U1.47, U1.63, U2.6, U2.7, U2.9, U3.4, U3.9, U4.1, U4.5, U4.7, U5.4, U5.8, U6.1, U6.4, U6.6, U6.10, U6.15, U7.1, U8.4, U8.5, U8.12, U9.1, U9.4, U9.5, U9.9, U10.5, U10.7, U11.5, U11.7, U12.2, U13.2, U14.3, U14.8, U15.3, U15.8, U16.3, Y1.2, Y1.4
HSE_IN: C18.1, U1.5, Y1.1
HSE_OUT: R9.1, U1.6
HSE_XTAL_OUT: C19.1, R9.2, Y1.3
IMU_CS: R3.2, U1.20, U2.12
IMU_INT: U1.50, U2.4
IMU_MISO: U1.22, U2.1
IMU_MOSI: U1.23, U2.14
IMU_SCK: U1.21, U2.13
LED_GREEN_K: D1.1, U1.3
LED_RED_K: D2.1, U1.4
NRST: C10.1, R1.2, TP5.1, U1.7
PORT_A_RX_EXT: J9.1, R30.1, U14.1, U14.10
PORT_A_RX_MCU: R30.2, U1.14
PORT_A_TX_EXT: J9.2, R31.1, U14.2, U14.9
PORT_A_TX_MCU: R31.2, U1.15
PORT_B_RX_EXT: J10.1, R32.1, U14.4, U14.7
PORT_B_RX_MCU: R32.2, U1.37
PORT_B_TX_EXT: J10.2, R33.1, U14.5, U14.6
PORT_B_TX_MCU: R33.2, U1.38
PORT_C_RX_EXT: J11.1, R34.1, U15.1, U15.10
PORT_C_RX_MCU: R34.2, U1.28
PORT_C_TX_EXT: J11.2, R35.1, U15.2, U15.9
PORT_C_TX_MCU: R35.2, U1.29
RPM_EXT: J7.3, R25.1
RPM_HV: Q1.3, R25.2, U16.1
RPM_LV: Q1.2, R36.2, R39.1
RPM_MCU: R39.2, U1.16, U13.6
SBUS_EXT: J8.3, R26.1
SBUS_HV: Q2.3, R26.2, U16.2
SBUS_LV: Q2.2, R37.2, R45.1
SBUS_MCU: R45.2, U1.17, U13.1
SERVO1_EXT: J2.3, R20.1
SERVO1_MCU: R20.2, U1.56, U12.1
SERVO2_EXT: J3.3, R21.1
SERVO2_MCU: R21.2, U1.57, U12.3
SERVO3_EXT: J4.3, R22.1
SERVO3_MCU: R22.2, U1.25, U12.4
SWCLK: TP2.1, U1.49
SWDIO: TP1.1, U1.46
TAIL_EXT: J5.3, R23.1
TAIL_MCU: R23.2, U1.55, U12.6
USB_CC1: D5.1, J1.A5, R14.1
USB_CC2: D6.1, J1.B5, R15.1
USB_ILIM: R67.1, U10.2
USB_LIMITED: C60.1, C65.1, C68.1, R68.1, U7.6, U8.2, U10.1
USB_N: D4.1, J1.A7, J1.B7, U1.44
USB_P: D3.1, J1.A6, J1.B6, U1.45
USB_VBUS_RAW: C20.1, D8.1, J1.A4, J1.A9, J1.B4, J1.B9, R69.1, U10.4, U10.6
VCAP: R16.1, U1.30
VCAP_CAP: C7.1, R16.2
VX_PROTECTED: C52.1, C53.1, C54.1, C64.1, C71.1, C72.1, R53.1, R57.1, R60.1, U5.6, U6.12, U6.13, U8.7
VX_RAW: C51.1, D9.1, J2.2, J3.2, J4.2, J5.2, J6.2, J7.2, J8.2, R40.1, R50.1, U5.5
