chenguoming1/h743-controllers/b-rid/b-rid.kicad_pcb

## KiCad design b-rid/b-rid.kicad_pcb (2026-10-08)

Schematic: b-rid.kicad_sch, B-RID engineering prototype

Parts:
A1: INPAQ PA1575MQ4S-123-1Z; INPAQ_PA1575MQ4S_10x10_Pin; MPN PA1575MQ4S-123-1Z
C1, C8: 2.2u/50V X5R; C_0603_1608Metric; MPN GRM188R61H225KE11D; LCSC C162273
C2, C3, C4, C10: 10u/50V X5R; C_0805_2012Metric; MPN GRM21BR61H106KE43L; LCSC C440198
C5, C9, C11, C15, C16, C17: 100n/16V X7R; C_0402_1005Metric; MPN GRM155R71C104KA88D; LCSC C71629
C6, C7: 22u/16V X5R; C_0805_2012Metric; MPN GRM21BR61C226ME44L; LCSC C86817
C12: 1u/10V X5R EN; C_0402_1005Metric; MPN GRM155R61A105KE15D; LCSC C76999
C13, C14: DNP RF match; C_0201_0603Metric; MPN DNP; not fitted
D1: APHB1608CGKSURKC G GNSS state; LED_APHB1608CGKSURKC; MPN APHB1608CGKSURKC; LCSC C6506245
D2: APHB1608CGKSURKC R RID state; LED_APHB1608CGKSURKC; MPN APHB1608CGKSURKC; LCSC C6506245
D3: APHB1608CGKSURKC S POWER / CHARGE; LED_APHB1608CGKSURKC; MPN APHB1608CGKSURKC; LCSC C6506245
J1: USB-C; USB_C_Receptacle_HRO_TYPE-C-31-M-12; MPN TYPE-C-31-M-12
J2: 1S protected pack + NTC; JST_SH_SM03B-SRSS-TB_1x03-1MP_P1.00mm_Horizontal; MPN SM03B-SRSS-TB(LF)(SN)
L1: 1.5uH WE-MAPI 74438334015; L_Wuerth_MAPI-3012; MPN 74438334015
Q1: 2N7002P charge isolation; SOT-23; MPN 2N7002P,215; LCSC C81488
R1, R2: 5.1k; R_0402_1005Metric
R3, R4: 22R; R_0201_0603Metric
R5: 5.90k / 150mA; R_0402_1005Metric
R6: 3.09k ILIM; R_0402_1005Metric
R7, R10: 100k; R_0402_1005Metric
R8, R9: 10k; R_0402_1005Metric
R11: 10k EN; R_0402_1005Metric
R12: 10k IO2; R_0402_1005Metric
R13: 1M; R_0402_1005Metric
R14: 330k; R_0402_1005Metric
R15: 0R RF series; R_0201_0603Metric
R16: 0R reserved; R_0402_1005Metric
R18: 0R RTC_O; R_0402_1005Metric
R19, R20, R21: 1k LED ~1.2mA; R_0402_LED_NoSilk
R22: 3.3k CHARGE ~0.9mA; R_0402_1005Metric
R23: 100k CHG pull-up; R_0402_1005Metric
R24: 100k USB suspend default; R_0201_0603Metric
R25: 10k GPIO8 boot strap; R_0201_0603Metric
SW1: POWER slide; SW_SPDT_Shouhan_MSK12C02; MPN MSK12C02; LCSC C431540
TP1: GND; TestPoint_Pad_D1.0mm
TP2: ESP_EN; TestPoint_Pad_D1.0mm
TP3: BOOT_IO9; TestPoint_Pad_D1.0mm
TP4: 3V3; TestPoint_Pad_D1.0mm
U1: ESP32-C3-MINI-1-N4X; ESP32-C3-MINI-1; MPN ESP32-C3-MINI-1-N4X
U2: MIA-M10Q-00B; ublox_LGA-53_4.5x4.5mm_Layout9x9_P0.5mm; MPN MIA-M10Q-00B
U3: BQ24074RGT; BQ24074_RGT0016B_TI; MPN BQ24074RGTR
U4: TPS63031DSK; TPS63031_DSK0010A_TI; MPN TPS63031DSKR
U5: USBLC6-2SC6; SOT-23-6; MPN USBLC6-2SC6; LCSC C7519
U6: TMUX1119DCKR; SOT-363_SC-70-6; MPN TMUX1119DCKR

Connections:
/3V3: C6.1, C7.1, C8.1, C9.1, C10.1, C11.1, R8.1, R9.1, R11.1, R12.1, R21.1, R25.1, TP4.1, U1.3 (3V3), U2.B1 (VCC), U2.J4 (V_IO), U4.1 (VOUT), U4.10 (FB), U6.1 (SEL)
/BAT+: C3.1, J2.1, R13.1, U3.2 (BAT), U3.3 (BAT)
/BATT_NTC: J2.2, U3.1 (TS)
/BAT_DIV: C16.1, R13.2, R14.1, U6.6 (S2)
/BAT_SENSE: U1.13 (IO1), U6.5 (D)
/BOOT_IO9: TP3.1, U1.23 (IO9)
/BUCK_EN: R10.1, SW1.1 (A), U4.6 (EN)
/CC1: J1.A5 (CC1), R1.1
/CC2: J1.B5 (CC2), R2.1
/CHARGE_ACTIVE: Q1.3 (D), R8.2, U1.19 (IO5)
/CHG_N: D3.4 (K2), Q1.1 (G), R23.2, U3.9 (~CHG)
/ESP_EN: C12.1, R11.2, TP2.1, U1.8 (EN)
/GNSS_RX: U1.31 (TXD0), U2.H1 (RX)
/GNSS_TX: U1.30 (RXD0), U2.G1 (TX)
/ILIM: R6.1, U3.12 (ILIM)
/ISET: R5.1, U3.16 (ISET)
/L1: L1.1, U4.4 (L1)
/L2: L1.2, U4.2 (L2)
/LED_CHG_A: D3.3 (A2), R22.2
/LED_G: R19.1, U1.20 (IO6)
/LED_G_A: D1.1 (A1), R19.2
/LED_R: R20.1, U1.21 (IO7)
/LED_R_A: D2.1 (A1), R20.2
/LED_S_A: D3.1 (A1), R21.2
/PGOOD_N: R9.2, U1.18 (IO4), U3.7 (~PGOOD)
/RES_F9: R16.1, U2.F9 (Reserved)
/RES_PAIR: U2.D2 (Reserved), U2.E2 (Reserved)
/RF_ANT: A1.1, C14.1, R15.2
/RF_IN: C13.1, R15.1, U2.B9 (RF_IN)
/RTC_UNUSED: R18.1, U2.A5 (RTC_O)
/STRAP_IO2: R12.2, U1.5 (IO2)
/STRAP_IO8: R25.2, U1.22 (IO8)
/USB_500_EN: R7.1, U1.12 (IO0), U3.6 (EN1)
/USB_D_CONN_N: J1.A7 (D-), J1.B7 (D-), R4.1, U5.3 (I/O2), U5.4 (I/O2)
/USB_D_CONN_P: J1.A6 (D+), J1.B6 (D+), R3.1, U5.1 (I/O1), U5.6 (I/O1)
/USB_D_N: R4.2, U1.26 (IO18/USB_D-)
/USB_D_P: R3.2, U1.27 (IO19/USB_D+)
/USB_SUSPEND: R24.1, U1.6 (IO3), U3.5 (EN2)
/VBUS: C1.1, C15.1, J1.A4 (VBUS), J1.A9 (VBUS), J1.B4 (VBUS), J1.B9 (VBUS), R22.1, R23.1, U3.13 (IN), U5.5 (VBUS)
/VSYS: C2.1, C4.1, C5.1, C17.1, SW1.2 (B), U3.10 (OUT), U3.11 (OUT), U4.5 (VIN), U4.8 (VINA), U6.2 (VDD)
GND: C1.2, C2.2, C3.2, C4.2, C5.2, C6.2, C7.2, C8.2, C9.2, C10.2, C11.2, C12.2, C13.2, C14.2, C15.2, C16.2, C17.2, D1.2 (K1), D2.2 (K1), D3.2 (K1), J1.A1 (GND), J1.A12 (GND), J1.B1 (GND), J1.B12 (GND), J1.SH (SHIELD), J2.3, Q1.2 (S), R1.2, R2.2, R5.2, R6.2, R7.2, R10.2, R14.2, R16.2, R18.2, R24.2, TP1.1, U1.1 (GND), U1.2 (GND), U1.11 (GND), U1.14 (GND), U1.36 (GND), U1.37 (GND), U1.38 (GND), U1.39 (GND), U1.40 (GND), U1.41 (GND), U1.42 (GND), U1.43 (GND), U1.44 (GND), U1.45 (GND), U1.46 (GND), U1.47 (GND), U1.48 (GND), U1.49 (GND), U1.50 (GND), U1.51 (GND), U1.52 (GND), U1.53 (GND), U2.A1 (GND), U2.A2 (GND), U2.A3 (GND), U2.A8 (GND), U2.A9 (GND), U2.B2 (GND), U2.B8 (GND), U2.C3 (GND), U2.C9 (GND), U2.E3 (GND), U2.E4 (GND), U2.E9 (GND), U2.F1 (GND), U2.F3 (GND), U2.F4 (GND), U2.G3 (GND), U2.G4 (GND), U2.G5 (GND), U2.G6 (GND), U2.G7 (Reserved), U2.H8 (GND), U2.J8 (GND), U2.J9 (GND), U3.4 (~CE), U3.8 (VSS), U3.17 (VSS), U4.3 (PGND), U4.7 (PS/SYNC), U4.9 (GND), U4.11 (PGND), U5.2 (GND), U6.3 (GND), U6.4 (S1)

Notes on the sheet:
G/R indicators require future firmware. An illuminated R is not proof of compliant RF/RID transmission.
Default 100mA. SOF/connected is NOT a configured 500mA grant. Validate host grant before selecting USB500.
USB-C / 5 V INPUT / CC / DATA
USB defaults to 100 mA input limit; firmware may select 500 mA after enumeration.
Protected 1S pack with 10k NTC required; charge ~150 mA is provisional.
INPAQ 10x10x4mm GPS L1 patch; engineered through-pin mount. Final RF tuning and exact-part sourcing required.
POWER-OFF ADC ISOLATION / USB POLICY / RECOVERY STRAP
3.3 V BUCK-BOOST
1S LI-ION CHARGE + POWER PATH
U6: SEL=3V3. Off -> ADC grounded; on -> BAT_DIV. C16 stays on divider side. Verify rail-collapse sequencing.
Q1 prevents the VBUS-powered CHG node from driving an unpowered ESP input. Charging = (PGOOD_N low) AND (CHARGE_ACTIVE high); ignore CHARGE_ACTIVE without valid USB input.
GPIO8 pull-up supports manual download with GPIO9/BOOT low. No status LED on strapping pins.
Native CAD checks passed; battery, sourcing, assembly and physical qualification pending.
USB EN2/EN1: 00=100mA, 01=500mA, 11=suspend. Enter EN1 first; resume EN2 first. Avoid 10 ILIM state.
Charger EN2: GPIO3. S-green shows enabled system rail; G/R use GPIO6/GPIO7 firmware state.
STATUS INDICATORS / ISOLATED CHARGE SENSE
S green: 3V3 system rail enabled (not firmware-health proof). S red: charger CHG_N low, independent of MCU power. Charging can show amber while running.
G: GPIO6, blink acquiring / steady valid GNSS. R: GPIO7, actual successful RID transmit state.
MCU-off charging cannot detect host suspend. USB power policy and prototype measurements remain release gates.
ESP antenna is inside overall outline with host-board corner recess and all-layer keepout.
ESP32-C3 BLE/WI-FI + PROGRAMMING
MIA GNSS + DIRECT CERAMIC PATCH / RF MATCH

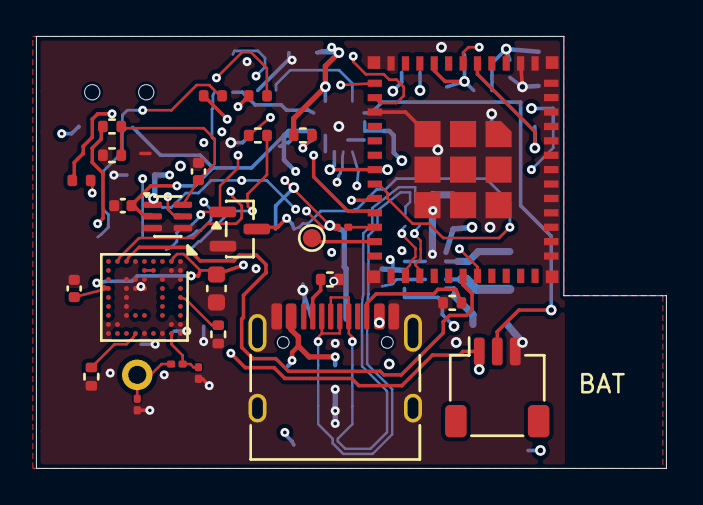
[picture p161: board b-rid.kicad_pcb from above]

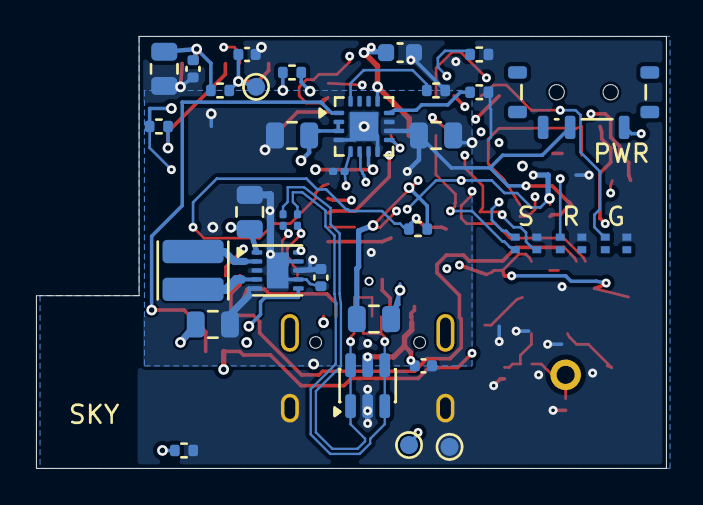
[picture p162: board b-rid.kicad_pcb from below]

Board: 6 copper layers, 35.0 x 24.0 mm, 60 parts (34 on the bottom side), 41 nets.
