chenguoming1/h743-controllers/self-balancing/native/controller.kicad_pcb

## KiCad design self-balancing/native/controller.kicad_pcb (2026-10-05)

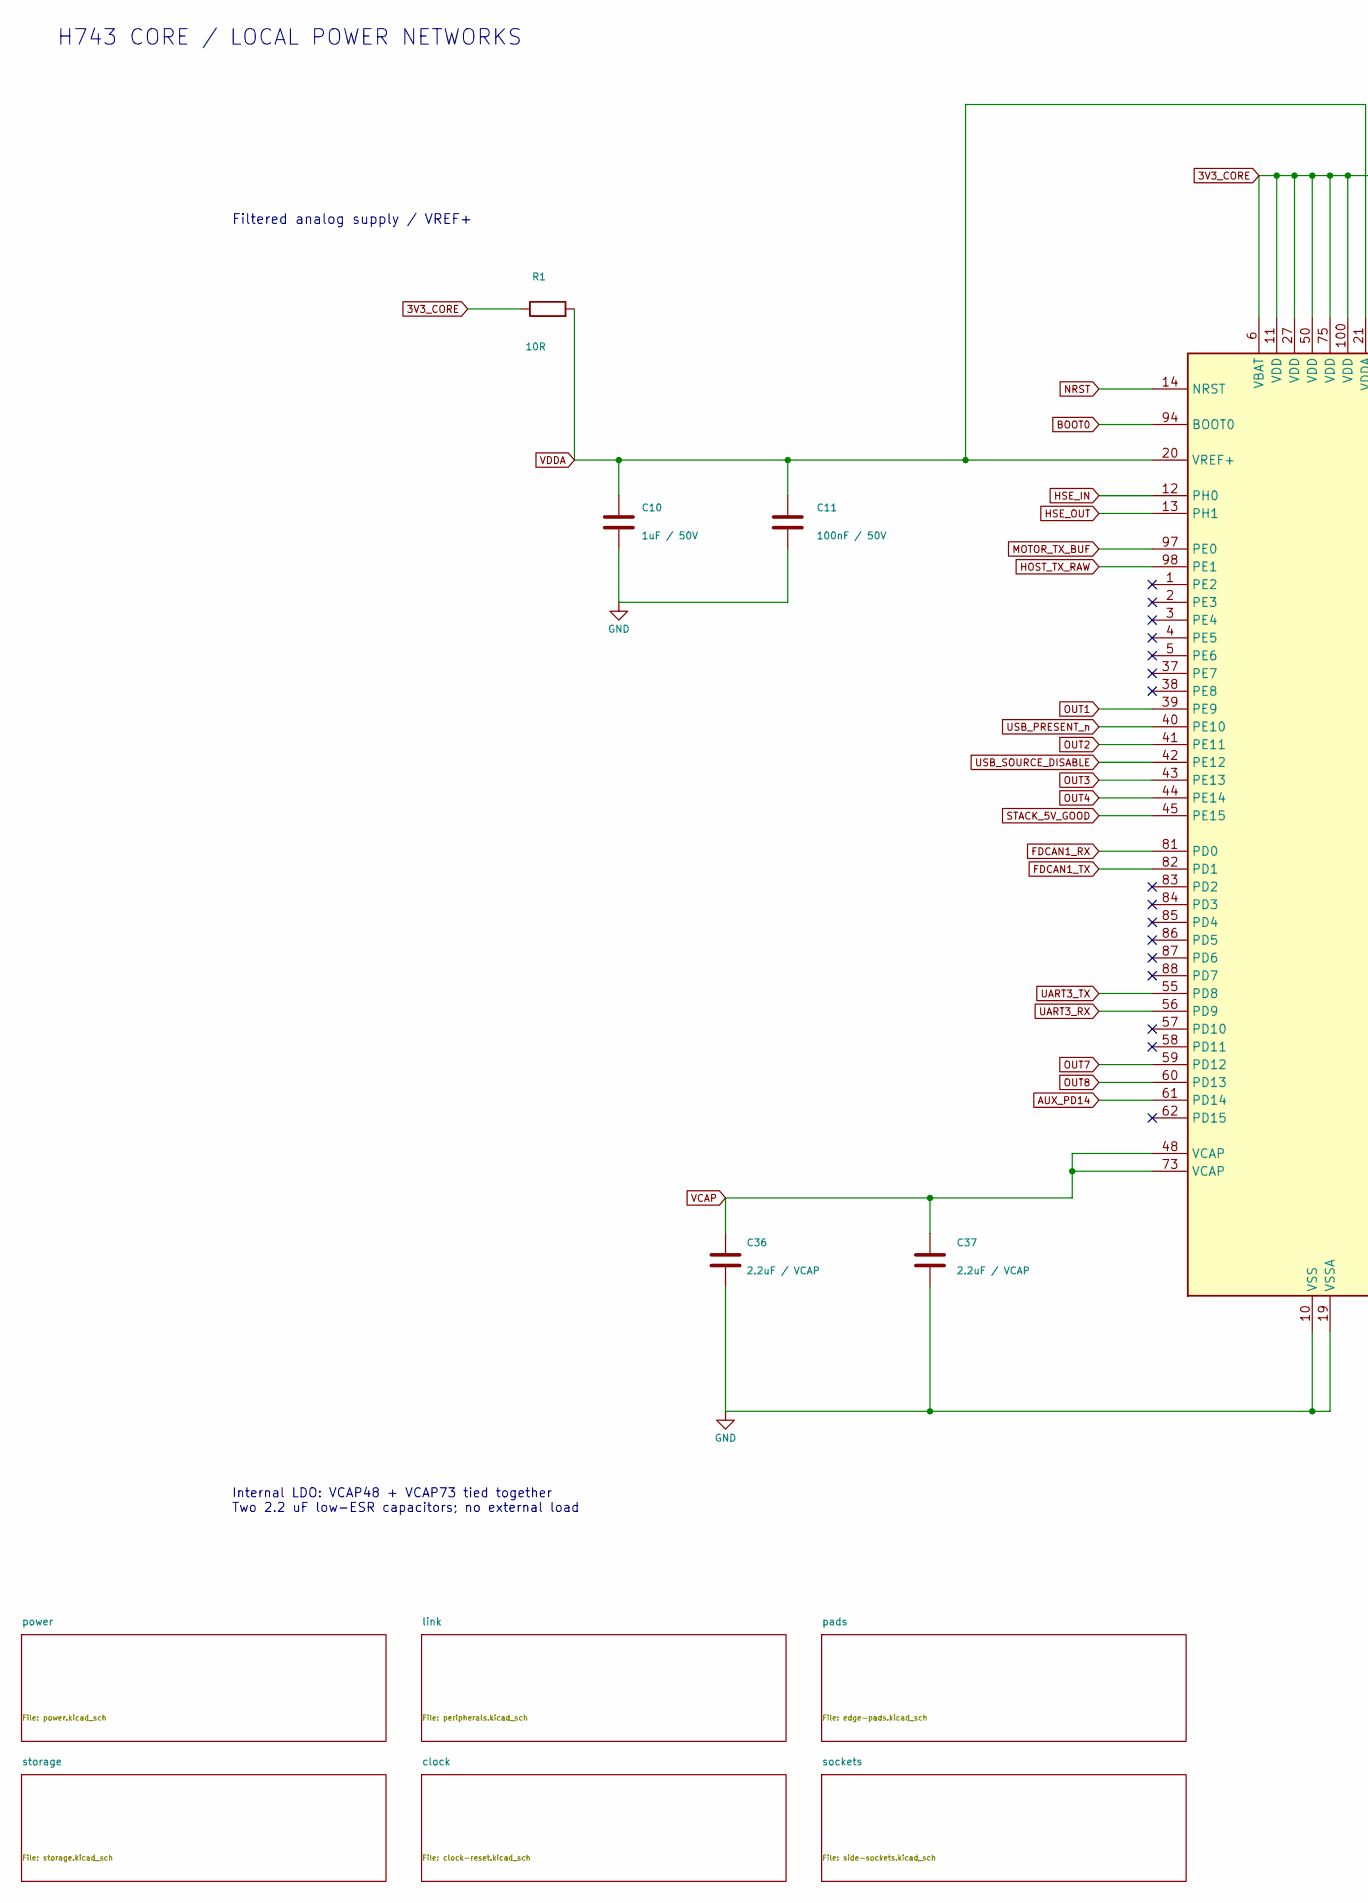
[picture p163: schematic controller.kicad_sch, H743 CORE / BYPASS / VCAP, part in row 1, column 1]

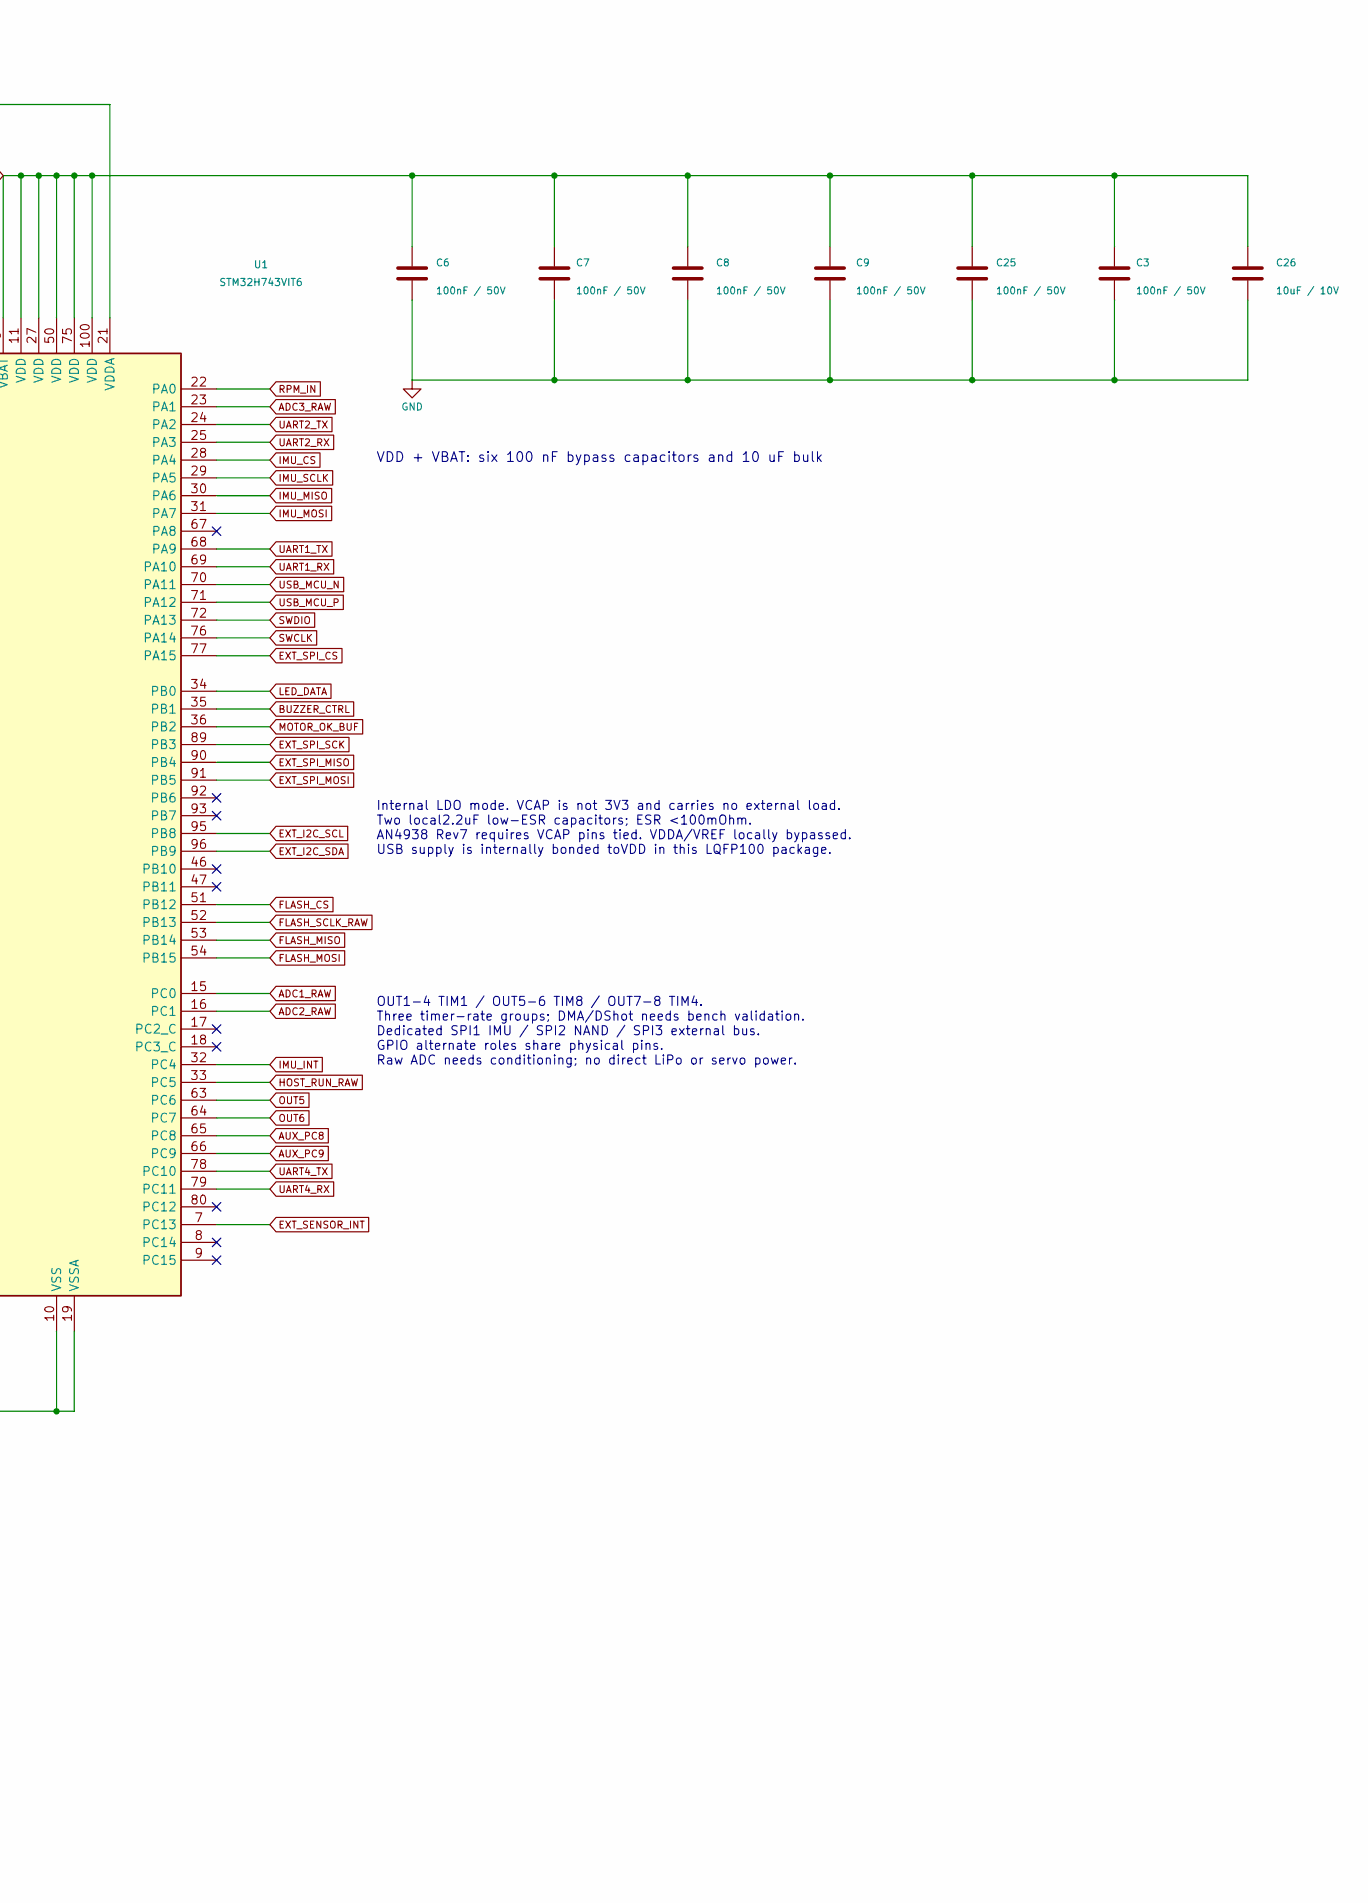
[picture p164: schematic controller.kicad_sch, H743 CORE / BYPASS / VCAP, part in row 1, column 2]

Parts:
C3: 100nF / 50V; C3_C_0603_1608Metric; Manufacturer_Part_Number CC0603KRX7R9BB104; LCSC C14663
C6: 100nF / 50V; C6_C_0603_1608Metric; Manufacturer_Part_Number CC0603KRX7R9BB104; LCSC C14663
C7: 100nF / 50V; C7_C_0603_1608Metric; Manufacturer_Part_Number CC0603KRX7R9BB104; LCSC C14663
C8: 100nF / 50V; C8_C_0603_1608Metric; Manufacturer_Part_Number CC0603KRX7R9BB104; LCSC C14663
C9: 100nF / 50V; C9_C_0603_1608Metric; Manufacturer_Part_Number CC0603KRX7R9BB104; LCSC C14663
C10: 1uF / 50V; C10_C_0603_1608Metric; Manufacturer_Part_Number CL10A105KB8NNNC; LCSC C15849
C11: 100nF / 50V; C11_C_0603_1608Metric; Manufacturer_Part_Number CC0603KRX7R9BB104; LCSC C14663
C25: 100nF / 50V; C25_C_0603_1608Metric; Manufacturer_Part_Number CC0603KRX7R9BB104; LCSC C14663
C26: 10uF / 10V; C26_C_0603_1608Metric; Manufacturer_Part_Number CL10A106KP8NNNC; LCSC C19702
C36: 2.2uF / VCAP; C36_C_0603_1608Metric; Manufacturer_Part_Number CL10A225KO8NNNC; LCSC C23630
C37: 2.2uF / VCAP; C37_C_0603_1608Metric; Manufacturer_Part_Number CL10A225KO8NNNC; LCSC C23630
R1: 10R; R1_R_0603_1608Metric; Manufacturer_Part_Number 0603WAF100JT5E; LCSC C22859
U1: STM32H743VIT6; U1_LQFP-100_14x14mm_P0.5mm; Manufacturer_Part_Number STM32H743VIT6; LCSC C114409

Connections:
ADC1_RAW: U1.15 (PC0); also elsewhere on the board
ADC2_RAW: U1.16 (PC1); also elsewhere on the board
ADC3_RAW: U1.23 (PA1); also elsewhere on the board
AUX_PC8: U1.65 (PC8); also elsewhere on the board
AUX_PC9: U1.66 (PC9); also elsewhere on the board
AUX_PD14: U1.61 (PD14); also elsewhere on the board
BOOT0: U1.94 (BOOT0); also elsewhere on the board
BUZZER_CTRL: U1.35 (PB1); also elsewhere on the board
EXT_I2C_SCL: U1.95 (PB8); also elsewhere on the board
EXT_I2C_SDA: U1.96 (PB9); also elsewhere on the board
EXT_SENSOR_INT: U1.7 (PC13); also elsewhere on the board
EXT_SPI_CS: U1.77 (PA15); also elsewhere on the board
EXT_SPI_MISO: U1.90 (PB4); also elsewhere on the board
EXT_SPI_MOSI: U1.91 (PB5); also elsewhere on the board
EXT_SPI_SCK: U1.89 (PB3); also elsewhere on the board
FDCAN1_RX: U1.81 (PD0); also elsewhere on the board
FDCAN1_TX: U1.82 (PD1); also elsewhere on the board
FLASH_MISO: U1.53 (PB14); also elsewhere on the board
FLASH_MOSI: U1.54 (PB15); also elsewhere on the board
FLASH_SCLK_RAW: U1.52 (PB13); also elsewhere on the board
GND: C3.2, C6.2, C7.2, C8.2, C9.2, C10.2, C11.2, C25.2, C26.2, C36.2, C37.2, U1.10 (VSS), U1.19 (VSSA), U1.26 (VSS), U1.49 (VSS), U1.74 (VSS), U1.99 (VSS); also elsewhere on the board
HOST_RUN_RAW: U1.33 (PC5); also elsewhere on the board
HOST_TX_RAW: U1.98 (PE1); also elsewhere on the board
HSE_IN: U1.12 (PH0); also elsewhere on the board
HSE_OUT: U1.13 (PH1); also elsewhere on the board
IMU_CS: U1.28 (PA4); also elsewhere on the board
IMU_INT: U1.32 (PC4); also elsewhere on the board
IMU_MISO: U1.30 (PA6); also elsewhere on the board
IMU_MOSI: U1.31 (PA7); also elsewhere on the board
IMU_SCLK: U1.29 (PA5); also elsewhere on the board
LED_DATA: U1.34 (PB0); also elsewhere on the board
MOTOR_OK_BUF: U1.36 (PB2); also elsewhere on the board
MOTOR_TX_BUF: U1.97 (PE0); also elsewhere on the board
NRST: U1.14 (NRST); also elsewhere on the board
OUT1: U1.39 (PE9); also elsewhere on the board
OUT2: U1.41 (PE11); also elsewhere on the board
OUT3: U1.43 (PE13); also elsewhere on the board
OUT4: U1.44 (PE14); also elsewhere on the board
OUT5: U1.63 (PC6); also elsewhere on the board
OUT6: U1.64 (PC7); also elsewhere on the board
OUT7: U1.59 (PD12); also elsewhere on the board
OUT8: U1.60 (PD13); also elsewhere on the board
RPM_IN: U1.22 (PA0); also elsewhere on the board
STACK_5V_GOOD: U1.45 (PE15); also elsewhere on the board
SWCLK: U1.76 (PA14); also elsewhere on the board
SWDIO: U1.72 (PA13); also elsewhere on the board
UART1_RX: U1.69 (PA10); also elsewhere on the board
UART1_TX: U1.68 (PA9); also elsewhere on the board
UART2_RX: U1.25 (PA3); also elsewhere on the board
UART2_TX: U1.24 (PA2); also elsewhere on the board
UART3_RX: U1.56 (PD9); also elsewhere on the board
UART3_TX: U1.55 (PD8); also elsewhere on the board
UART4_RX: U1.79 (PC11); also elsewhere on the board
UART4_TX: U1.78 (PC10); also elsewhere on the board
USB_MCU_N: U1.70 (PA11); also elsewhere on the board
USB_MCU_P: U1.71 (PA12); also elsewhere on the board
USB_PRESENT_n: U1.40 (PE10); also elsewhere on the board
USB_SOURCE_DISABLE: U1.42 (PE12); also elsewhere on the board
VCAP: C36.1, C37.1, U1.48 (VCAP), U1.73 (VCAP)
VDDA: C10.1, C11.1, R1.2, U1.20 (VREF+), U1.21 (VDDA)

Notes on the sheet:
H743 CORE / LOCAL POWER NETWORKS
VDD + VBAT: six 100 nF bypass capacitors and 10 uF bulk
Filtered analog supply / VREF+
Internal LDO: VCAP48 + VCAP73 tied together Two 2.2 uF low-ESR capacitors; no external load
Internal LDO mode. VCAP is not 3V3 and carries no external load. Two local2.2uF low-ESR capacitors; ESR <100mOhm. AN4938 Rev7 requires VCAP pins tied. VDDA/VREF locally bypassed. USB supply is internally bonded toVDD in this LQFP100 package.
OUT1-4 TIM1 / OUT5-6 TIM8 / OUT7-8 TIM4. Three timer-rate groups; DMA/DShot needs bench validation. Dedicated SPI1 IMU / SPI2 NAND / SPI3 external bus. GPIO alternate roles share physical pins. Raw ADC needs conditioning; no direct LiPo or servo power.
