chenguoming1/h743-controllers/self-balancing/native/controller.kicad_pcb

## KiCad design self-balancing/native/controller.kicad_pcb (continued)

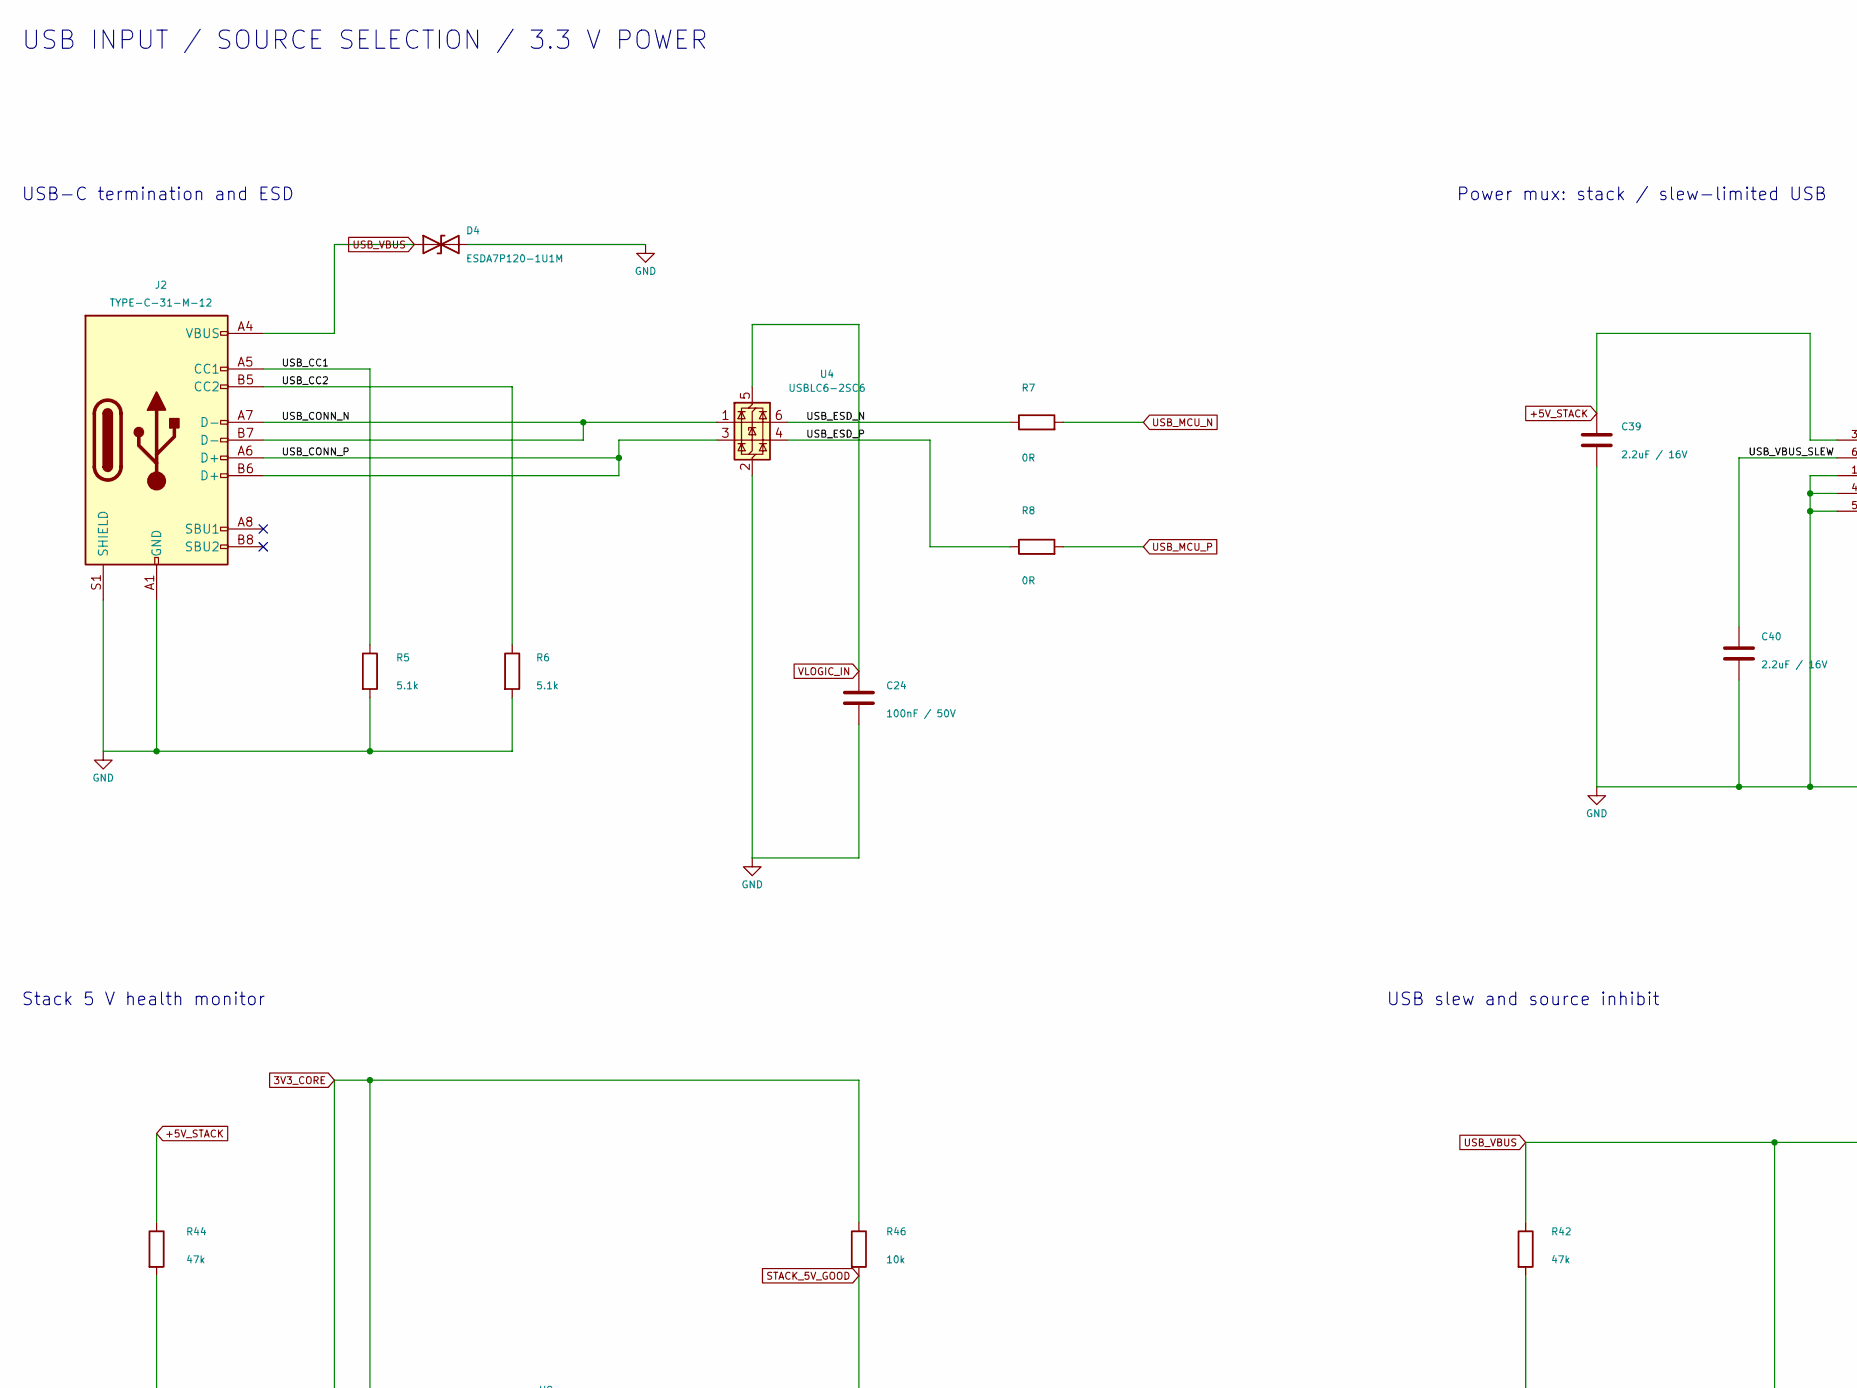
[picture p165: schematic power.kicad_sch, USB-C / BUCK / SOURCE CONTROL, part in row 1, column 1]

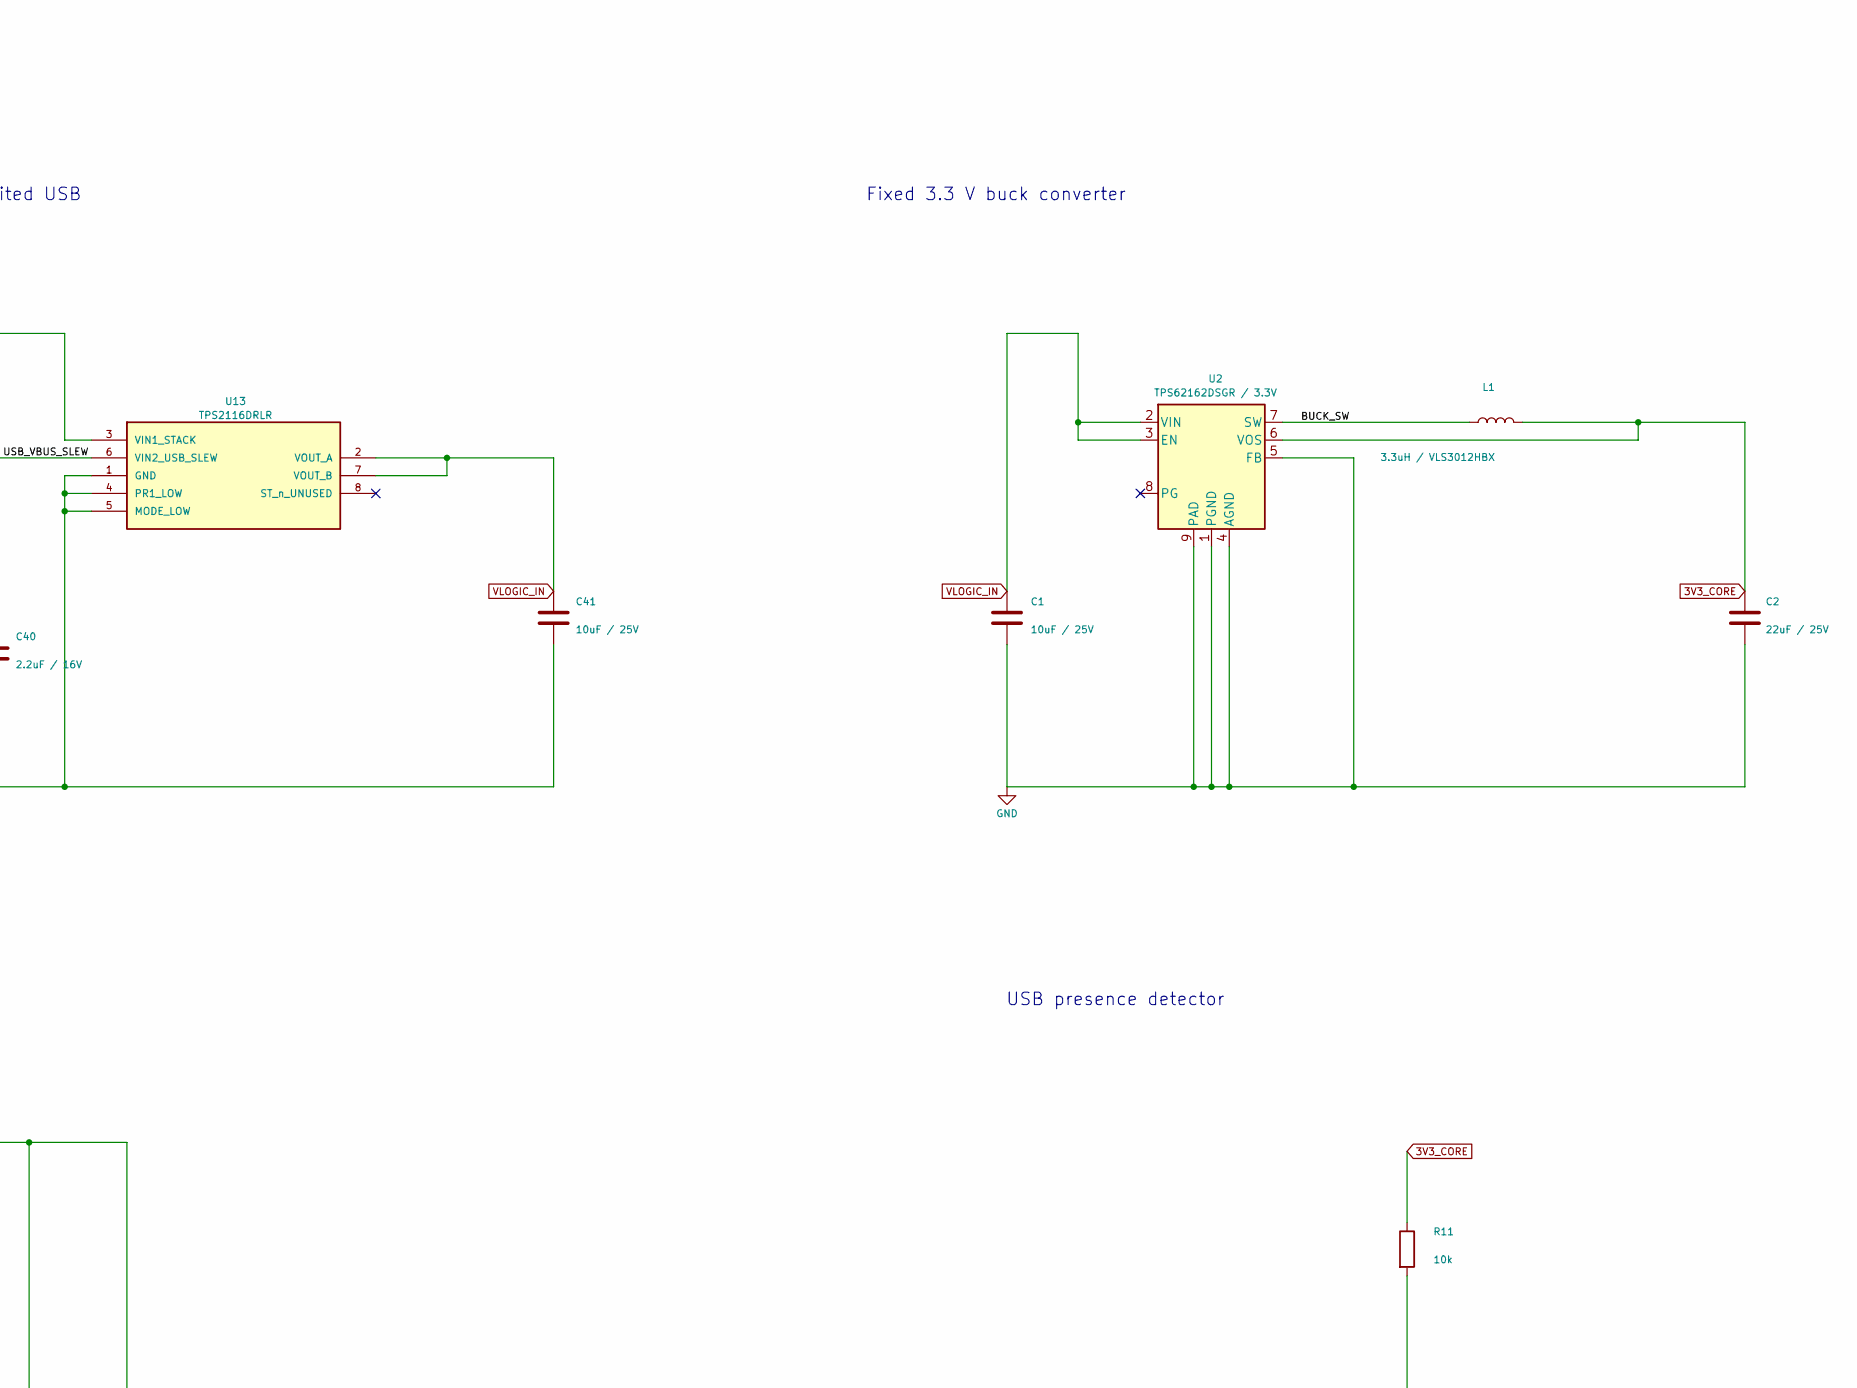
[picture p166: schematic power.kicad_sch, USB-C / BUCK / SOURCE CONTROL, part in row 1, column 2]

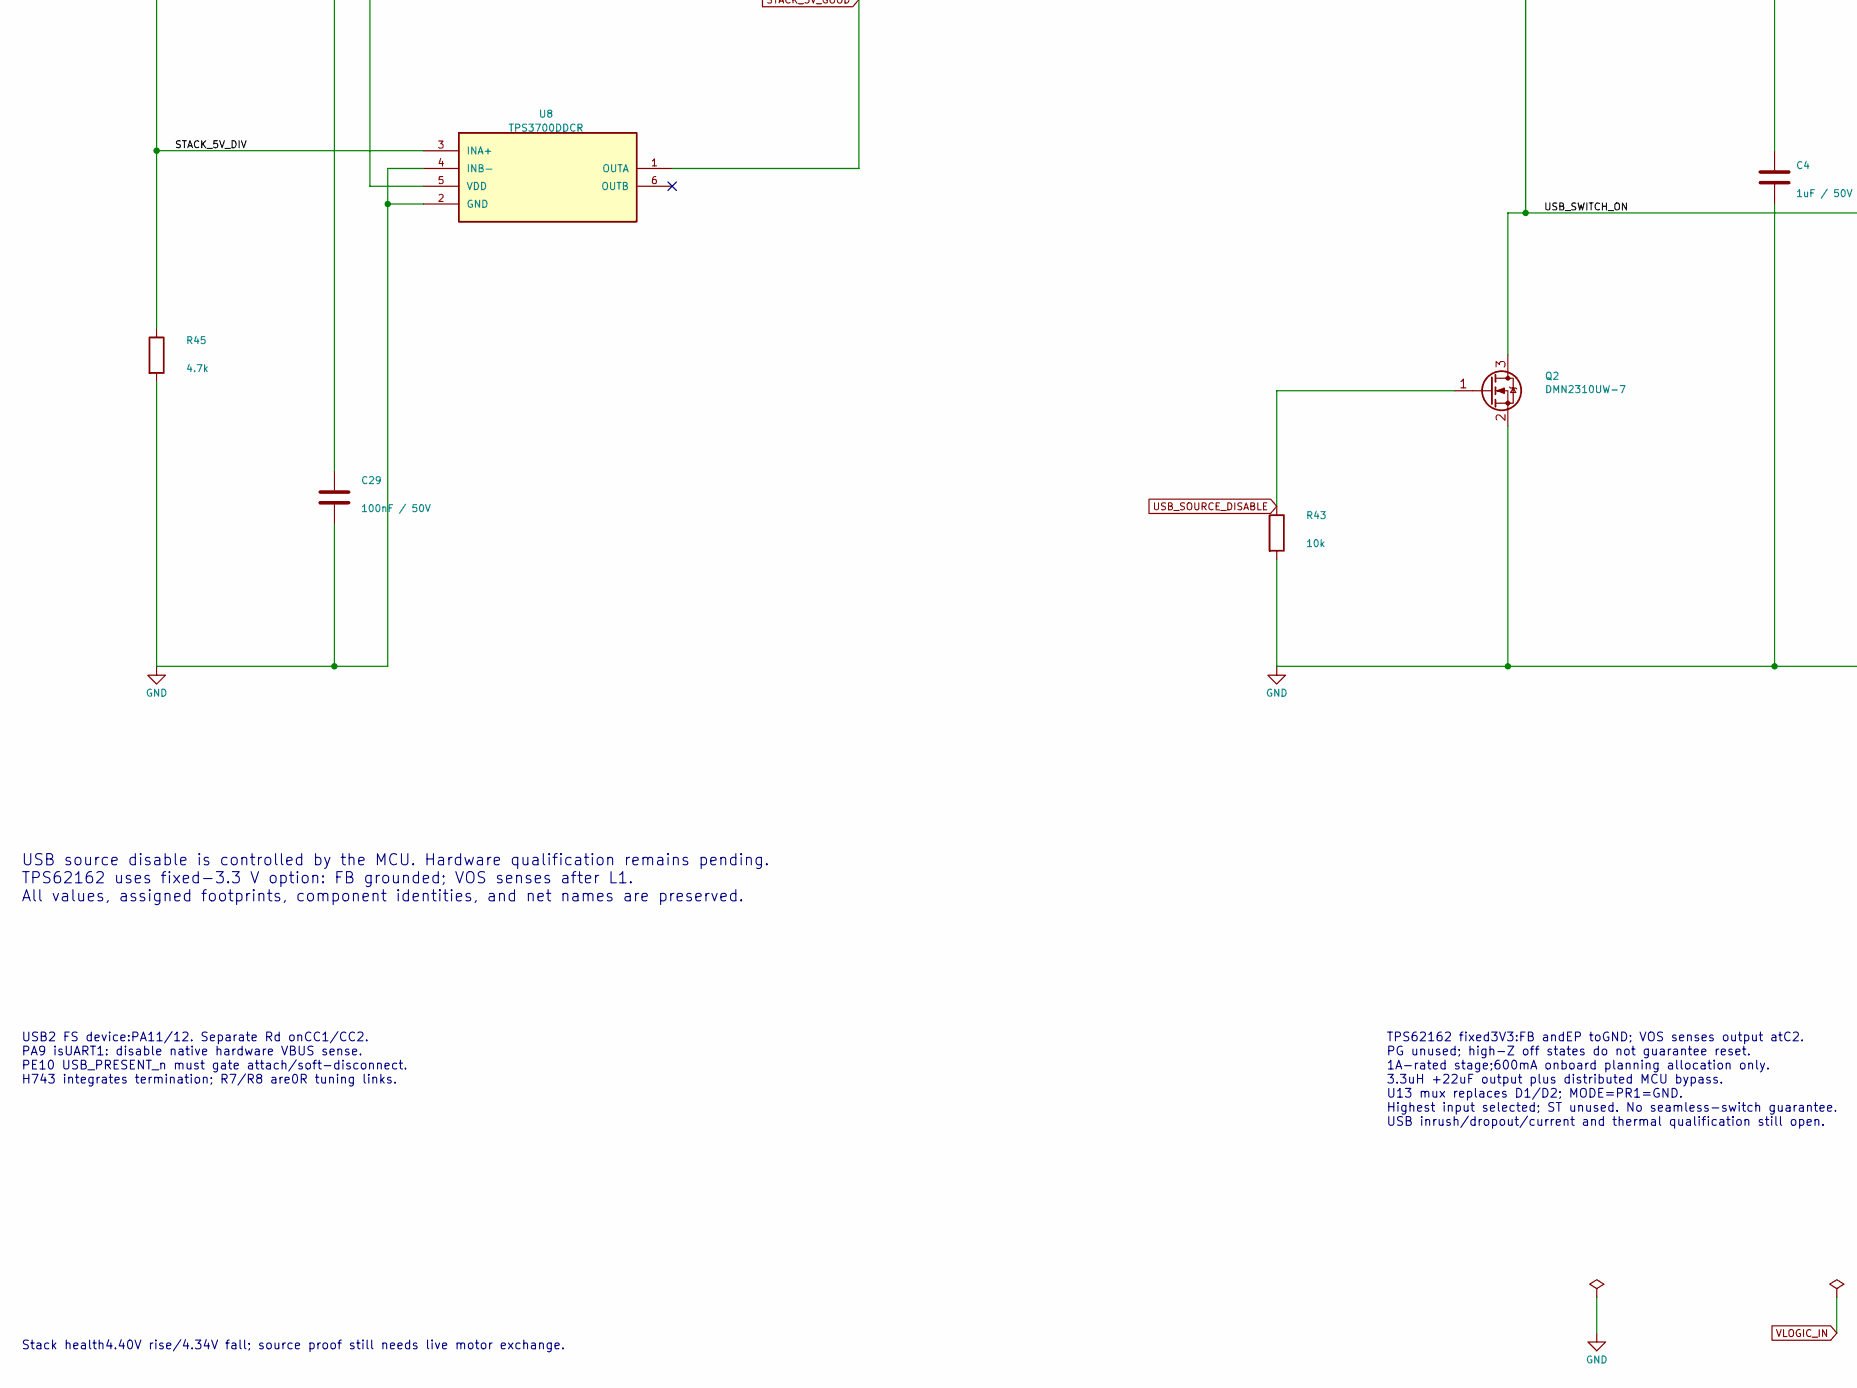
[picture p167: schematic power.kicad_sch, USB-C / BUCK / SOURCE CONTROL, part in row 2, column 1]

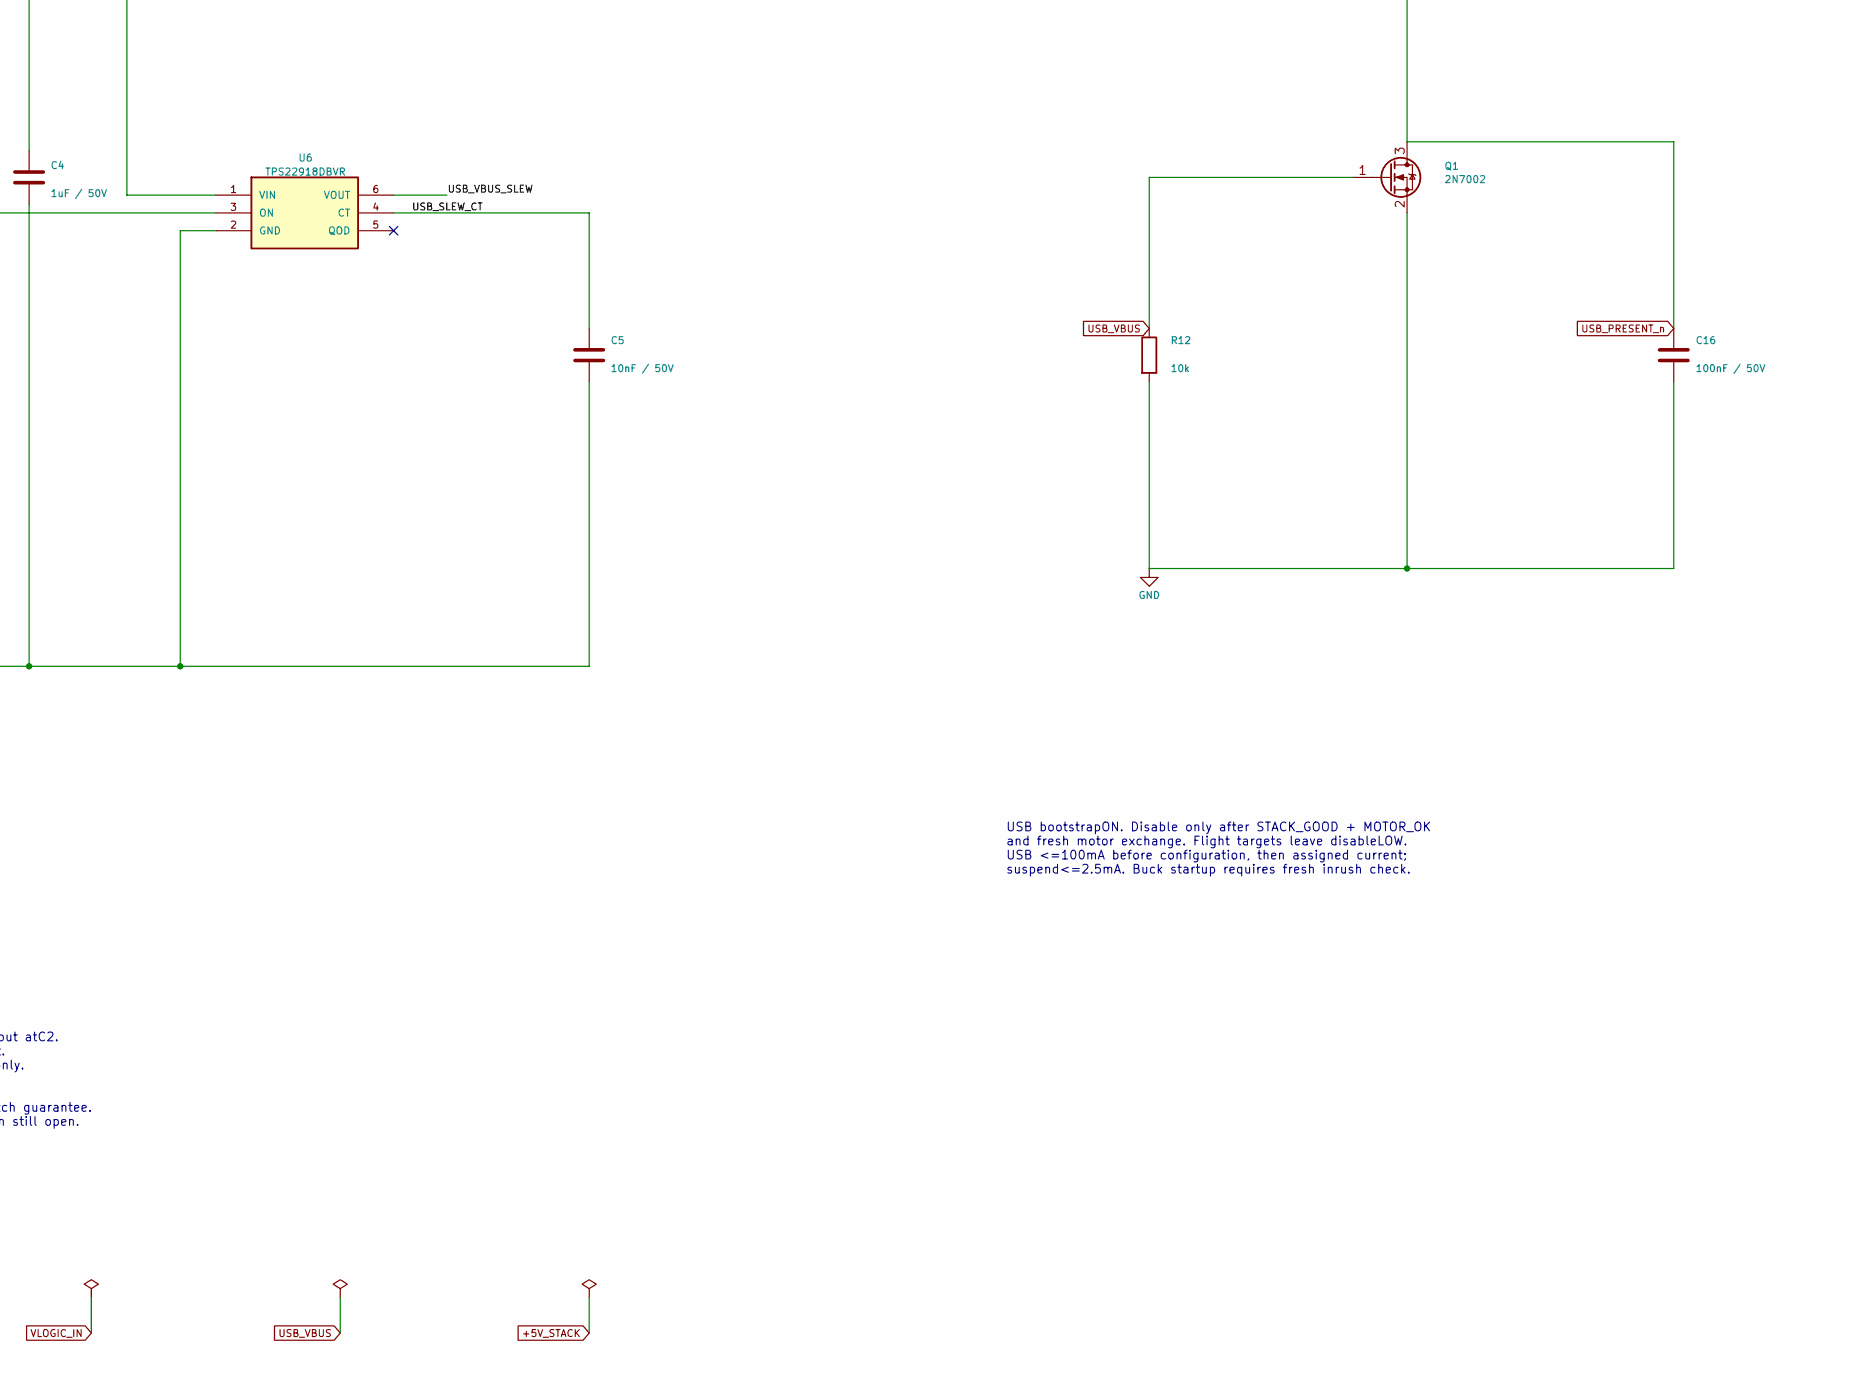
[picture p168: schematic power.kicad_sch, USB-C / BUCK / SOURCE CONTROL, part in row 2, column 2]

Parts:
C1: 10uF / 25V; C1_C_0805_2012Metric; Manufacturer_Part_Number CL21A106KAYNNNE; LCSC C15850
C2: 22uF / 25V; C2_C_1206_3216Metric; Manufacturer_Part_Number CL31A226KAHNNNE; LCSC C12891
C4: 1uF / 50V; C4_C_0603_1608Metric; Manufacturer_Part_Number CL10A105KB8NNNC; LCSC C15849
C5: 10nF / 50V; C5_C_0603_1608Metric; Manufacturer_Part_Number 0603B103K500NT; LCSC C57112
C16: 100nF / 50V; C16_C_0603_1608Metric; Manufacturer_Part_Number CC0603KRX7R9BB104; LCSC C14663
C24: 100nF / 50V; C24_C_0603_1608Metric; Manufacturer_Part_Number CC0603KRX7R9BB104; LCSC C14663
C29: 100nF / 50V; C29_C_0603_1608Metric; Manufacturer_Part_Number CC0603KRX7R9BB104; LCSC C14663
C39: 2.2uF / 16V; C39_C_0603_1608Metric; Manufacturer_Part_Number CL10A225KO8NNNC; LCSC C23630
C40: 2.2uF / 16V; C40_C_0603_1608Metric; Manufacturer_Part_Number CL10A225KO8NNNC; LCSC C23630
C41: 10uF / 25V; C41_C_0805_2012Metric; Manufacturer_Part_Number CL21A106KAYNNNE; LCSC C15850
D4: ESDA7P120-1U1M; ST_QFN-2L_1.6x1.0mm_DS14419; Manufacturer_Part_Number ESDA7P120-1U1M; LCSC C2969802
J2: TYPE-C-31-M-12; USB_C_HRO_TYPE-C-31-M-12_EdgeSilk; Manufacturer_Part_Number TYPE-C-31-M-12; LCSC C165948
L1: 3.3uH / VLS3012HBX; TDK_VLS3012HBX; Manufacturer_Part_Number VLS3012HBX-3R3M; LCSC C404495
Q1: 2N7002; Q1_SOT-23; Manufacturer_Part_Number 2N7002; LCSC C8545
Q2: DMN2310UW-7; DMN2310UW_SOT323; Manufacturer_Part_Number DMN2310UW-7; LCSC C7264627
R5: 5.1k; R5_R_0603_1608Metric; Manufacturer_Part_Number 0603WAF5101T5E; LCSC C23186
R6: 5.1k; R6_R_0603_1608Metric; Manufacturer_Part_Number 0603WAF5101T5E; LCSC C23186
R7, R8: 0R; R_0402_1005Metric_R3S_NoSilk; Manufacturer_Part_Number 0402WGF0000TCE; LCSC C17168
R11: 10k; R11_R_0603_1608Metric; Manufacturer_Part_Number 0603WAF1002T5E; LCSC C25804
R12: 10k; R12_R_0603_1608Metric; Manufacturer_Part_Number 0603WAF1002T5E; LCSC C25804
R42: 47k; R42_R_0603_1608Metric; Manufacturer_Part_Number 0603WAF4702T5E; LCSC C25819
R43: 10k; R43_R_0603_1608Metric; Manufacturer_Part_Number 0603WAF1002T5E; LCSC C25804
R44: 47k; R44_R_0603_1608Metric; Manufacturer_Part_Number 0603WAF4702T5E; LCSC C25819
R45: 4.7k; R45_R_0603_1608Metric; Manufacturer_Part_Number 0603WAF4701T5E; LCSC C23162
R46: 10k; R46_R_0603_1608Metric; Manufacturer_Part_Number 0603WAF1002T5E; LCSC C25804
U2: TPS62162DSGR / 3.3V; TPS62162_DSG_R3S; Manufacturer_Part_Number TPS62162DSGR; LCSC C40256
U4: USBLC6-2SC6; U4_SOT-23-6; Manufacturer_Part_Number USBLC6-2SC6; LCSC C7519
U6: TPS22918DBVR; U6_SOT-23-6; Manufacturer_Part_Number TPS22918DBVR; LCSC C131941
U8: TPS3700DDCR; TSOT-23-6_R3S_ClearLabels; Manufacturer_Part_Number TPS3700DDCR; LCSC C33002
U13: TPS2116DRLR; U13_SOT-583-8; Manufacturer_Part_Number TPS2116DRLR; LCSC C3235557

Connections:
+5V_STACK: C39.1, R44.1, U13.3 (VIN1_STACK); also elsewhere on the board
/power/BUCK_SW: L1.1, U2.7 (SW)
/power/STACK_5V_DIV: R44.2, R45.1, U8.3 (INA+)
/power/USB_CC1: J2.A5 (CC1), R5.1
/power/USB_CC2: J2.B5 (CC2), R6.1
/power/USB_CONN_N: J2.A7 (D-), J2.B7 (D-), U4.1 (I/O1)
/power/USB_CONN_P: J2.A6 (D+), J2.B6 (D+), U4.3 (I/O2)
/power/USB_ESD_N: R7.1, U4.6 (I/O1)
/power/USB_ESD_P: R8.1, U4.4 (I/O2)
/power/USB_SLEW_CT: C5.1, U6.4 (CT)
/power/USB_SWITCH_ON: Q2.3 (D), R42.2, U6.3 (ON)
/power/USB_VBUS_SLEW: C40.1, U6.6 (VOUT), U13.6 (VIN2_USB_SLEW)
GND: C1.2, C2.2, C4.2, C5.2, C16.2, C24.2, C29.2, C39.2, C40.2, C41.2, D4.2 (A2), J2.A1 (GND), J2.A12 (GND), J2.B1 (GND), J2.B12 (GND), J2.S1 (SHIELD), Q1.2 (S), Q2.2 (S), R5.2, R6.2, R12.2, R43.2, R45.2, U2.1 (PGND), U2.4 (AGND), U2.5 (FB), U2.9 (PAD), U4.2 (GND), U6.2 (GND), U8.2 (GND), U8.4 (INB-), U13.1 (GND), U13.4 (PR1_LOW), U13.5 (MODE_LOW); also elsewhere on the board
STACK_5V_GOOD: R46.2, U8.1 (OUTA); also elsewhere on the board
USB_MCU_N: R7.2; also elsewhere on the board
USB_MCU_P: R8.2; also elsewhere on the board
USB_PRESENT_n: C16.1, Q1.3 (D), R11.2; also elsewhere on the board
USB_SOURCE_DISABLE: Q2.1 (G), R43.1; also elsewhere on the board
USB_VBUS: C4.1, D4.1 (A1), J2.A4 (VBUS), J2.A9 (VBUS), J2.B4 (VBUS), J2.B9 (VBUS), Q1.1 (G), R12.1, R42.1, U6.1 (VIN)
VLOGIC_IN: C1.1, C24.1, C41.1, U2.2 (VIN), U2.3 (EN), U4.5 (VBUS), U13.2 (VOUT_A), U13.7 (VOUT_B)

Notes on the sheet:
USB INPUT / SOURCE SELECTION / 3.3 V POWER
USB-C termination and ESD
Power mux: stack / slew-limited USB
Fixed 3.3 V buck converter
Stack 5 V health monitor
USB slew and source inhibit
USB presence detector
USB source disable is controlled by the MCU. Hardware qualification remains pending. TPS62162 uses fixed-3.3 V option: FB grounded; VOS senses after L1. All values, assigned footprints, component identities, and net names are preserved.
USB2 FS device:PA11/12. Separate Rd onCC1/CC2. PA9 isUART1: disable native hardware VBUS sense. PE10 USB_PRESENT_n must gate attach/soft-disconnect. H743 integrates termination; R7/R8 are0R tuning links.
TPS62162 fixed3V3:FB andEP toGND; VOS senses output atC2. PG unused; high-Z off states do not guarantee reset. 1A-rated stage;600mA onboard planning allocation only. 3.3uH +22uF output plus distributed MCU bypass. U13 mux replaces D1/D2; MODE=PR1=GND. Highest input selected; ST unused. No seamless-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
USB bootstrapON. Disable only after STACK_GOOD + MOTOR_OK and fresh motor exchange. Flight targets leave disableLOW. USB <=100mA before configuration, then assigned current; suspend<=2.5mA. Buck startup requires fresh inrush check.
Stack health4.40V rise/4.34V fall; source proof still needs live motor exchange.

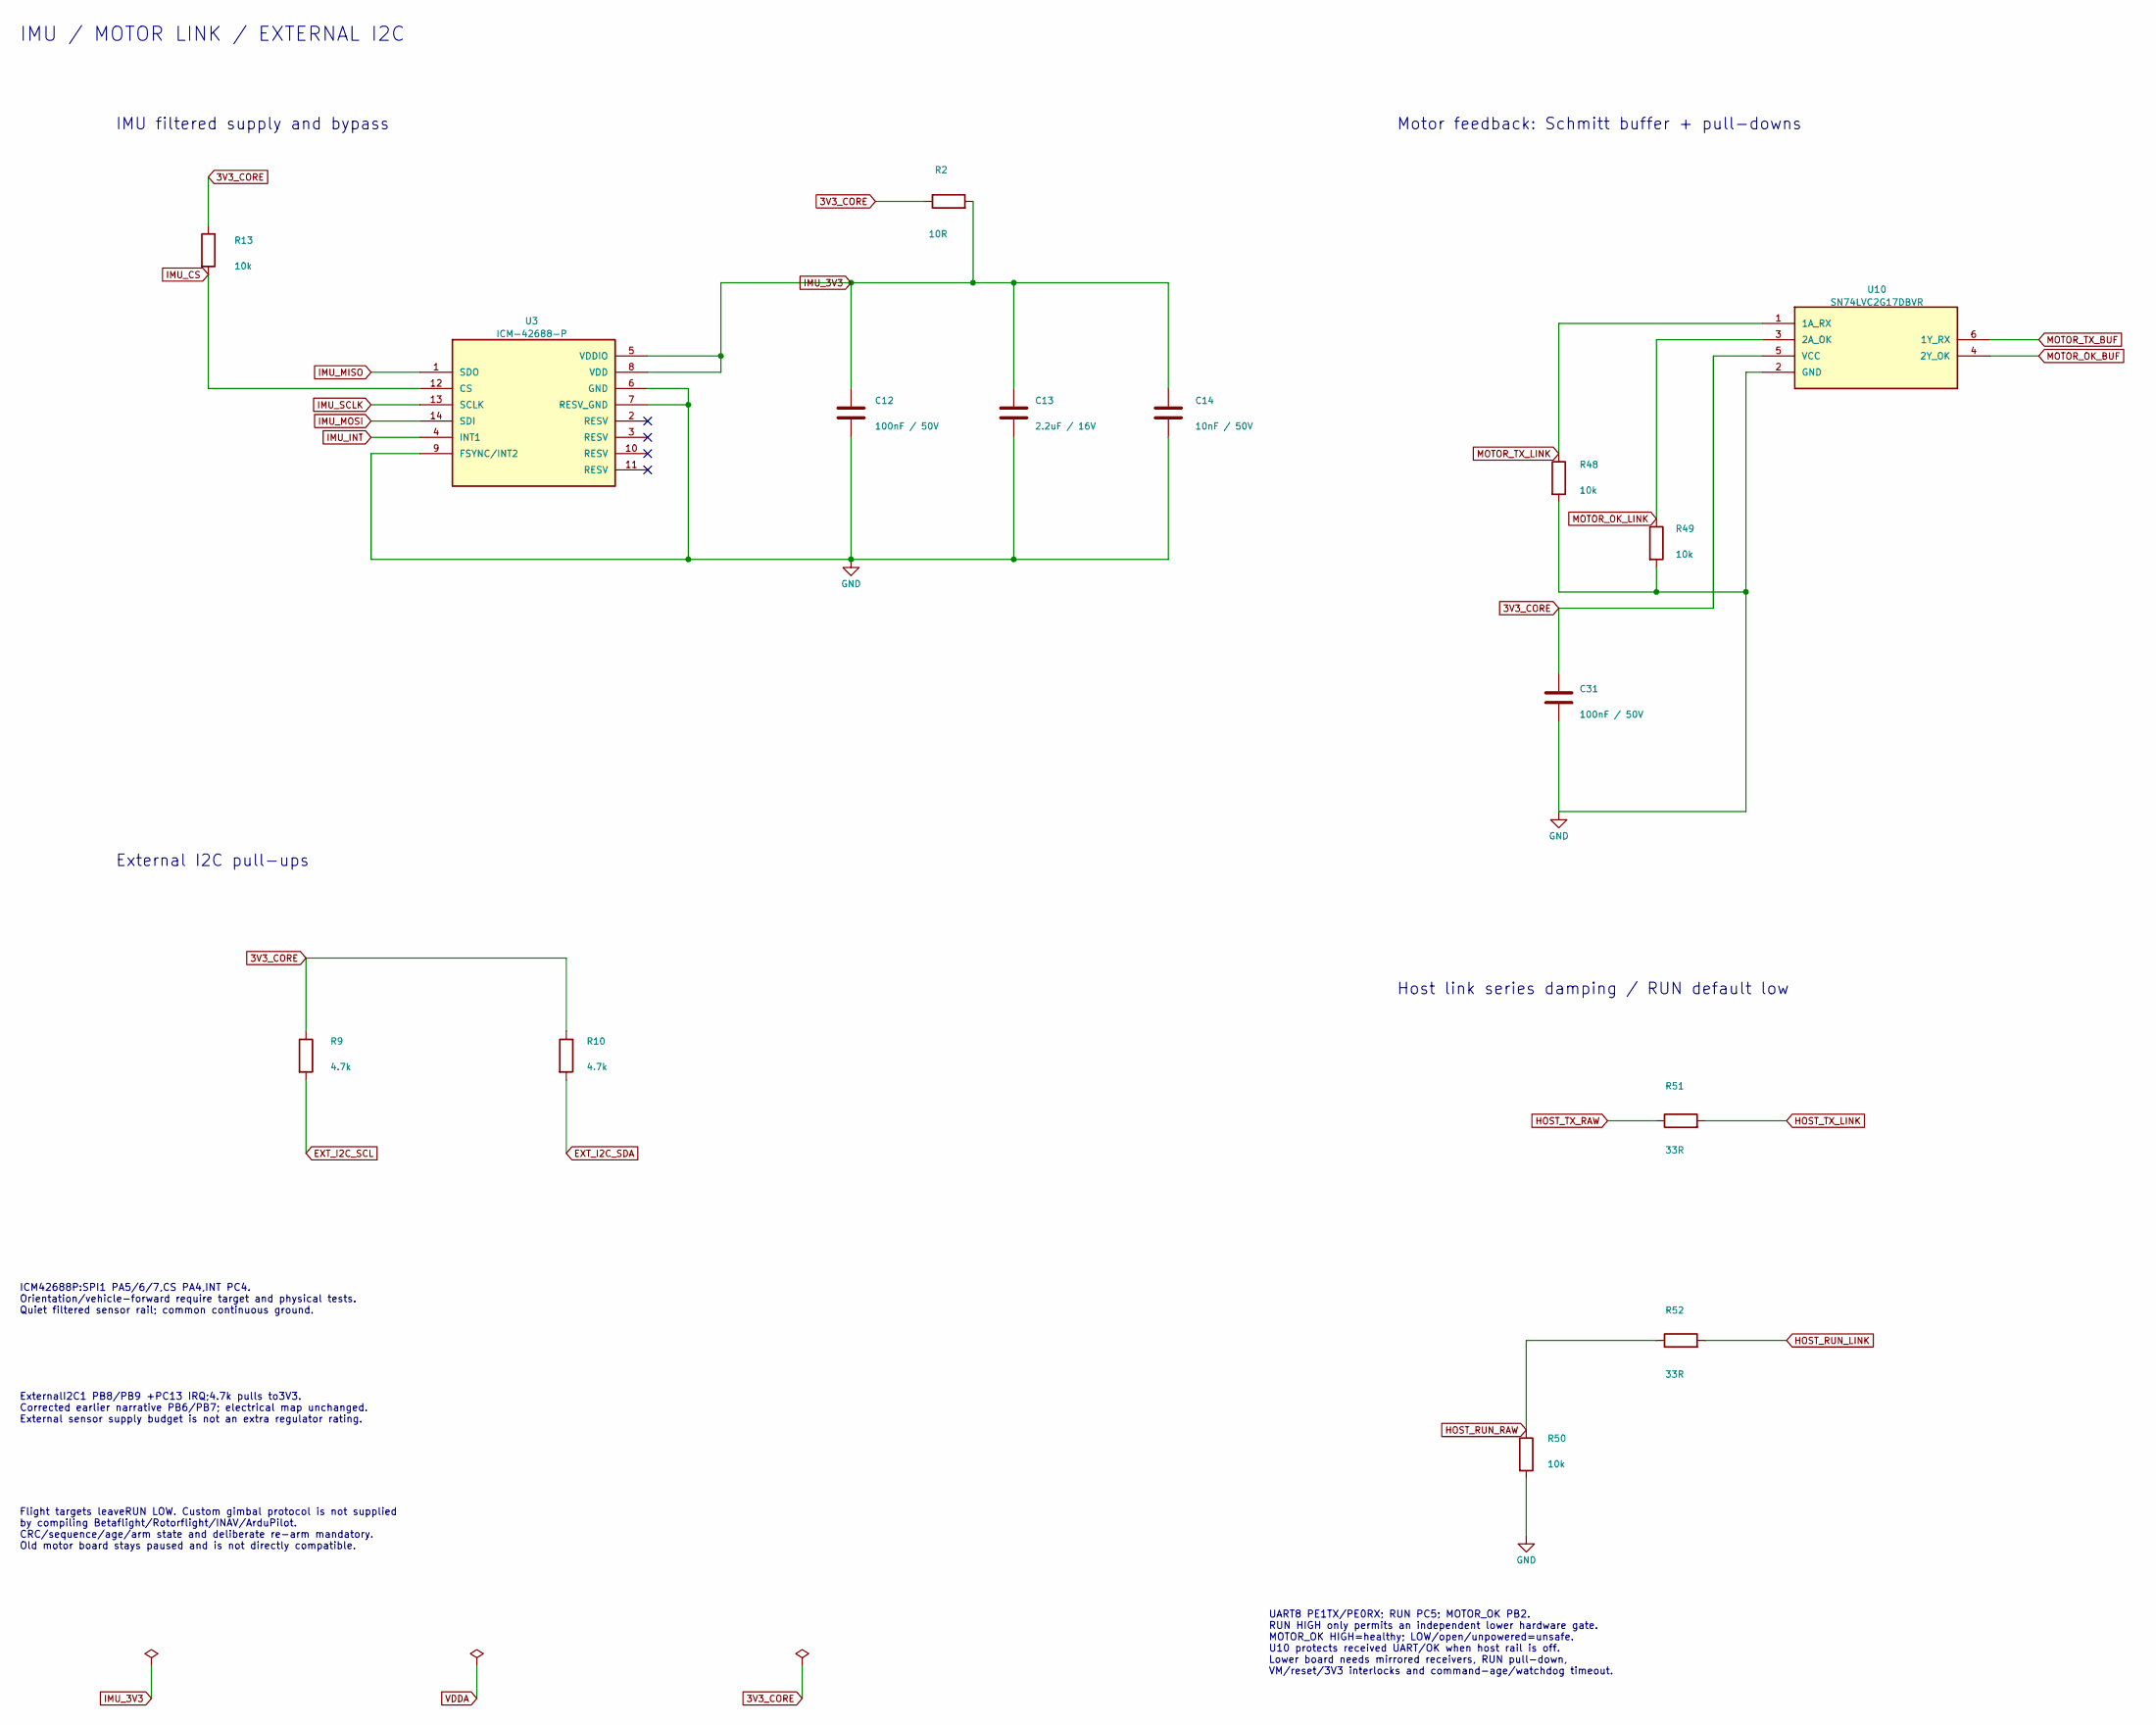
[picture p169: schematic peripherals.kicad_sch, IMU / MOTOR LINK / I2C]

Parts:
C12: 100nF / 50V; C12_C_0603_1608Metric; Manufacturer_Part_Number CC0603KRX7R9BB104; LCSC C14663
C13: 2.2uF / 16V; C13_C_0603_1608Metric; Manufacturer_Part_Number CL10A225KO8NNNC; LCSC C23630
C14: 10nF / 50V; C14_C_0603_1608Metric; Manufacturer_Part_Number 0603B103K500NT; LCSC C57112
C31: 100nF / 50V; C31_C_0603_1608Metric; Manufacturer_Part_Number CC0603KRX7R9BB104; LCSC C14663
R2: 10R; R2_R_0603_1608Metric; Manufacturer_Part_Number 0603WAF100JT5E; LCSC C22859
R9: 4.7k; R9_R_0603_1608Metric; Manufacturer_Part_Number 0603WAF4701T5E; LCSC C23162
R10: 4.7k; R10_R_0603_1608Metric; Manufacturer_Part_Number 0603WAF4701T5E; LCSC C23162
R13: 10k; R13_R_0603_1608Metric; Manufacturer_Part_Number 0603WAF1002T5E; LCSC C25804
R48: 10k; R48_R_0603_1608Metric; Manufacturer_Part_Number 0603WAF1002T5E; LCSC C25804
R49: 10k; R49_R_0603_1608Metric; Manufacturer_Part_Number 0603WAF1002T5E; LCSC C25804
R50: 10k; R50_R_0603_1608Metric; Manufacturer_Part_Number 0603WAF1002T5E; LCSC C25804
R51: 33R; R51_R_0603_1608Metric; Manufacturer_Part_Number 0603WAF330JT5E; LCSC C23140
R52: 33R; R52_R_0603_1608Metric; Manufacturer_Part_Number 0603WAF330JT5E; LCSC C23140
U3: ICM-42688-P; U3_LGA-14_3x2.5mm_P0.5mm_LayoutBorder3x4y; Manufacturer_Part_Number ICM-42688-P; LCSC C1850418
U10: SN74LVC2G17DBVR; U10_SOT-23-6; Manufacturer_Part_Number SN74LVC2G17DBVR; LCSC C10429

Connections:
EXT_I2C_SCL: R9.2; also elsewhere on the board
EXT_I2C_SDA: R10.2; also elsewhere on the board
GND: C12.2, C13.2, C14.2, C31.2, R48.2, R49.2, R50.2, U3.6 (GND), U3.7 (RESV_GND), U3.9 (FSYNC/INT2), U10.2 (GND); also elsewhere on the board
HOST_RUN_LINK: R52.2; also elsewhere on the board
HOST_RUN_RAW: R50.1, R52.1; also elsewhere on the board
HOST_TX_LINK: R51.2; also elsewhere on the board
HOST_TX_RAW: R51.1; also elsewhere on the board
IMU_3V3: C12.1, C13.1, C14.1, R2.2, U3.5 (VDDIO), U3.8 (VDD)
IMU_CS: R13.2, U3.12 (CS); also elsewhere on the board
IMU_INT: U3.4 (INT1); also elsewhere on the board
IMU_MISO: U3.1 (SDO); also elsewhere on the board
IMU_MOSI: U3.14 (SDI); also elsewhere on the board
IMU_SCLK: U3.13 (SCLK); also elsewhere on the board
MOTOR_OK_BUF: U10.4 (2Y_OK); also elsewhere on the board
MOTOR_OK_LINK: R49.1, U10.3 (2A_OK); also elsewhere on the board
MOTOR_TX_BUF: U10.6 (1Y_RX); also elsewhere on the board
MOTOR_TX_LINK: R48.1, U10.1 (1A_RX); also elsewhere on the board

Notes on the sheet:
IMU / MOTOR LINK / EXTERNAL I2C
IMU filtered supply and bypass
Motor feedback: Schmitt buffer + pull-downs
External I2C pull-ups
Host link series damping / RUN default low
ICM42688P:SPI1 PA5/6/7,CS PA4,INT PC4. Orientation/vehicle-forward require target and physical tests. Quiet filtered sensor rail; common continuous ground.
ExternalI2C1 PB8/PB9 +PC13 IRQ;4.7k pulls to3V3. Corrected earlier narrative PB6/PB7; electrical map unchanged. External sensor supply budget is not an extra regulator rating.
UART8 PE1TX/PE0RX; RUN PC5; MOTOR_OK PB2. RUN HIGH only permits an independent lower hardware gate. MOTOR_OK HIGH=healthy; LOW/open/unpowered=unsafe. U10 protects received UART/OK when host rail is off. Lower board needs mirrored receivers, RUN pull-down, VM/reset/3V3 interlocks and command-age/wat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
Flight targets leaveRUN LOW. Custom gimbal protocol is not supplied by compiling Betaflight/Rotorflight/INAV/ArduPilot. CRC/sequence/age/arm state and deliberate re-arm mandatory. Old motor board stays paused and is not directly compatible.
