chenguoming1/h743-controllers/self-balancing/native/controller.kicad_pcb

## KiCad design self-balancing/native/controller.kicad_pcb (continued)

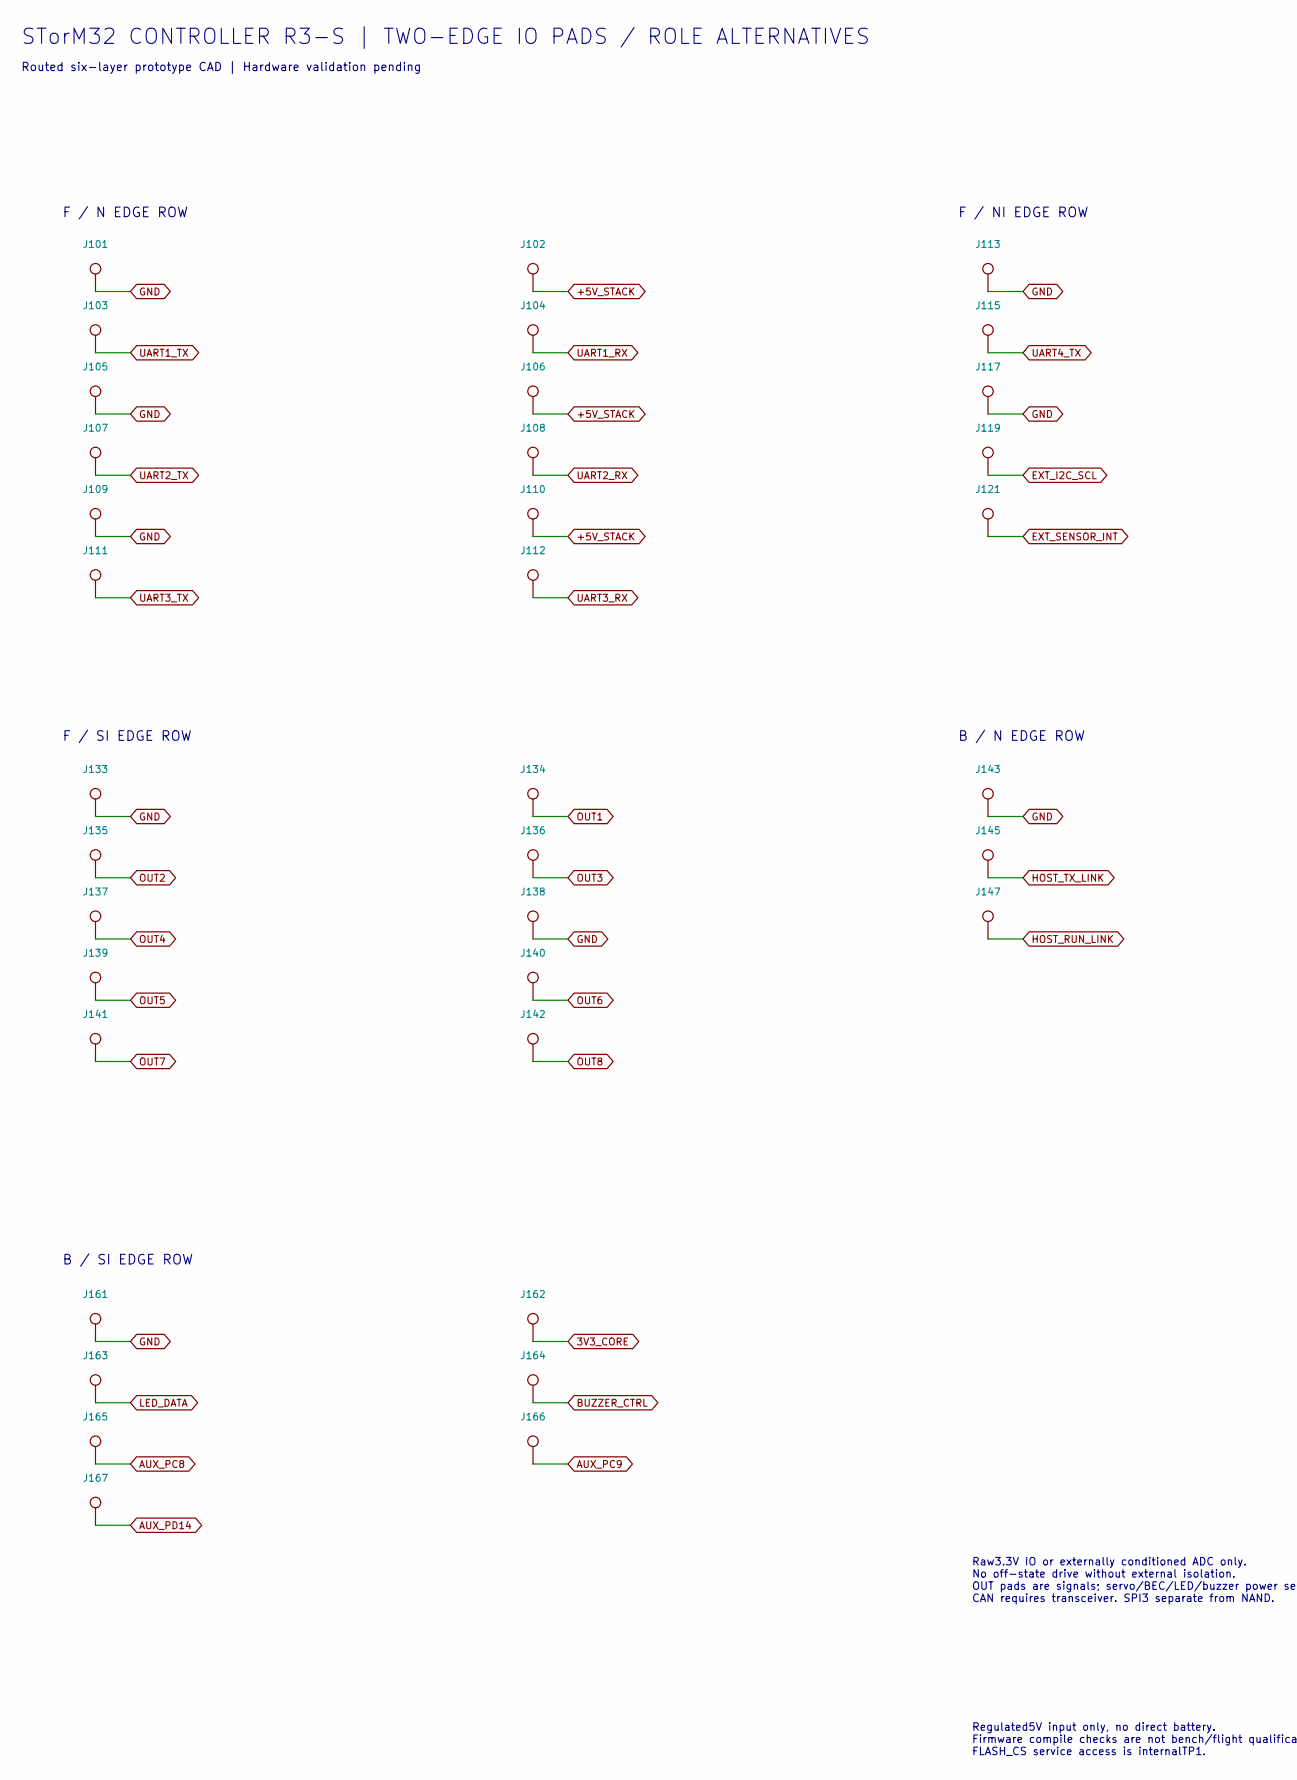
[picture p170: schematic edge-pads.kicad_sch, TWO-EDGE IO PADS / ROLE ALTERNATIVES, part in row 1, column 1]

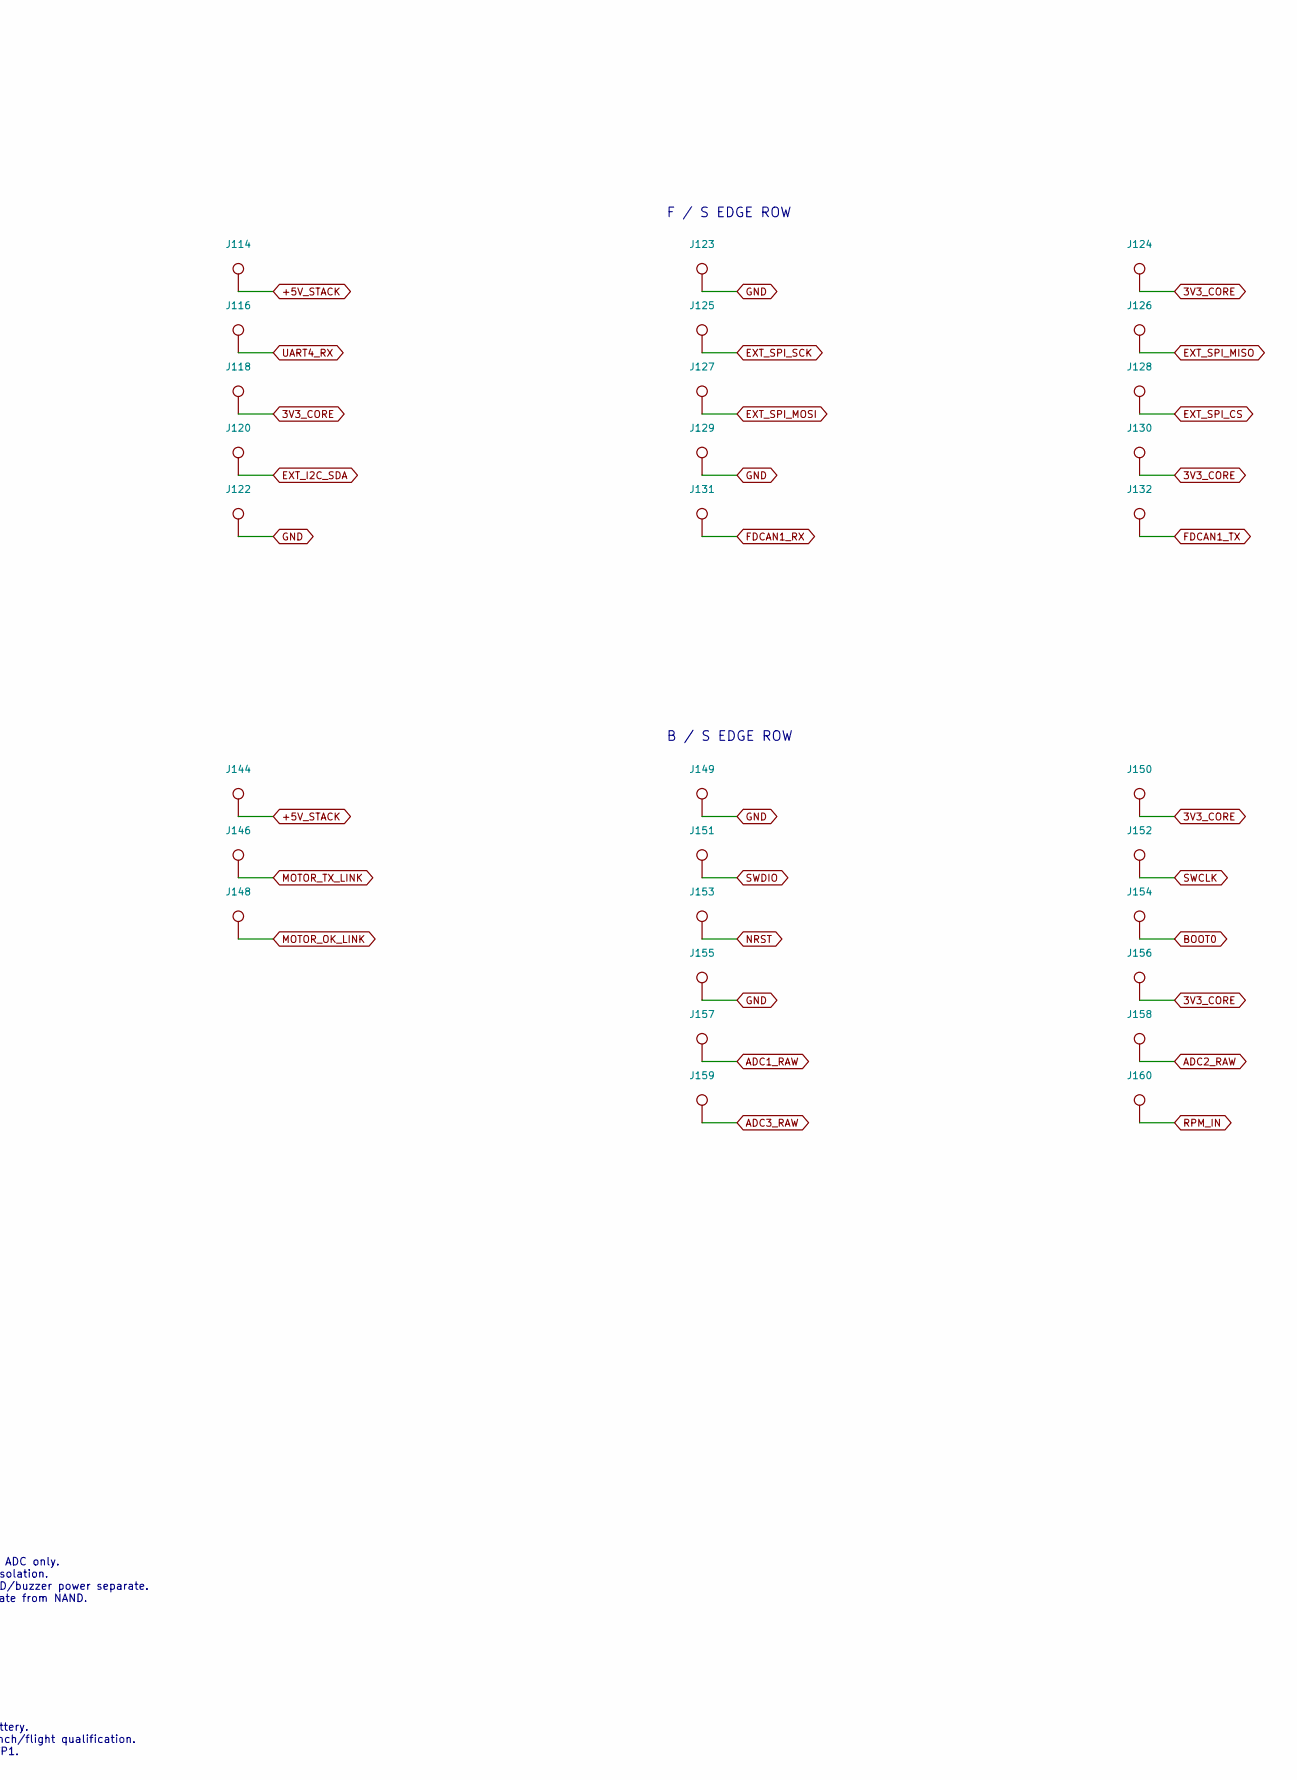
[picture p171: schematic edge-pads.kicad_sch, TWO-EDGE IO PADS / ROLE ALTERNATIVES, part in row 1, column 2]

Parts:
J101, J105, J109, J113, J117, J122, J123, J129, J133, J138, J149, J155, J161: G; WirePad_1.6x2.0mm; Manufacturer_Part_Number PCB solder pad
J102, J106, J110, J114: 5V; WirePad_1.6x2.0mm; Manufacturer_Part_Number PCB solder pad
J103: T1; WirePad_1.6x2.0mm; Manufacturer_Part_Number PCB solder pad
J104: R1; WirePad_1.6x2.0mm; Manufacturer_Part_Number PCB solder pad
J107: T2; WirePad_1.6x2.0mm; Manufacturer_Part_Number PCB solder pad
J108: R2; WirePad_1.6x2.0mm; Manufacturer_Part_Number PCB solder pad
J111: T3; WirePad_1.6x2.0mm; Manufacturer_Part_Number PCB solder pad
J112: R3; WirePad_1.6x2.0mm; Manufacturer_Part_Number PCB solder pad
J115: T4; WirePad_1.6x2.0mm; Manufacturer_Part_Number PCB solder pad
J116: R4; WirePad_1.6x2.0mm; Manufacturer_Part_Number PCB solder pad
J118, J124, J130, J156, J162: 3V3; WirePad_1.6x2.0mm; Manufacturer_Part_Number PCB solder pad
J119: SCL; WirePad_1.6x2.0mm; Manufacturer_Part_Number PCB solder pad
J120: SDA; WirePad_1.6x2.0mm; Manufacturer_Part_Number PCB solder pad
J121: INT; WirePad_1.6x2.0mm; Manufacturer_Part_Number PCB solder pad
J125: SCK; WirePad_1.6x2.0mm; Manufacturer_Part_Number PCB solder pad
J126: MISO; WirePad_1.6x2.0mm; Manufacturer_Part_Number PCB solder pad
J127: MOSI; WirePad_1.6x2.0mm; Manufacturer_Part_Number PCB solder pad
J128: CS; WirePad_1.6x2.0mm; Manufacturer_Part_Number PCB solder pad
J131: CAN_RX; WirePad_1.6x2.0mm; Manufacturer_Part_Number PCB solder pad
J132: CAN_TX; WirePad_1.6x2.0mm; Manufacturer_Part_Number PCB solder pad
J134: OUT1; WirePad_1.6x2.0mm; Manufacturer_Part_Number PCB solder pad
J135: OUT2; WirePad_1.6x2.0mm; Manufacturer_Part_Number PCB solder pad
J136: OUT3; WirePad_1.6x2.0mm; Manufacturer_Part_Number PCB solder pad
J137: OUT4; WirePad_1.6x2.0mm; Manufacturer_Part_Number PCB solder pad
J139: OUT5; WirePad_1.6x2.0mm; Manufacturer_Part_Number PCB solder pad
J140: OUT6; WirePad_1.6x2.0mm; Manufacturer_Part_Number PCB solder pad
J141: OUT7; WirePad_1.6x2.0mm; Manufacturer_Part_Number PCB solder pad
J142: OUT8; WirePad_1.6x2.0mm; Manufacturer_Part_Number PCB solder pad
J143: G_LINK; WirePad_3.6x2.0mm; Manufacturer_Part_Number PCB solder pad
J144: 5V_LINK; WirePad_3.6x2.0mm; Manufacturer_Part_Number PCB solder pad
J145: LINK_TX; WirePad_1.6x2.0mm; Manufacturer_Part_Number PCB solder pad
J146: LINK_RX; WirePad_1.6x2.0mm; Manufacturer_Part_Number PCB solder pad
J147: RUN; WirePad_1.6x2.0mm; Manufacturer_Part_Number PCB solder pad
J148: M_OK; WirePad_1.6x2.0mm; Manufacturer_Part_Number PCB solder pad
J150: VTREF; WirePad_1.6x2.0mm; Manufacturer_Part_Number PCB solder pad
J151: SWDIO; WirePad_1.6x2.0mm; Manufacturer_Part_Number PCB solder pad
J152: SWCLK; WirePad_1.6x2.0mm; Manufacturer_Part_Number PCB solder pad
J153: NRST; WirePad_1.6x2.0mm; Manufacturer_Part_Number PCB solder pad
J154: BOOT; WirePad_1.6x2.0mm; Manufacturer_Part_Number PCB solder pad
J157: ADC1; WirePad_1.6x2.0mm; Manufacturer_Part_Number PCB solder pad
J158: ADC2; WirePad_1.6x2.0mm; Manufacturer_Part_Number PCB solder pad
J159: ADC3; WirePad_1.6x2.0mm; Manufacturer_Part_Number PCB solder pad
J160: RPM; WirePad_1.6x2.0mm; Manufacturer_Part_Number PCB solder pad
J163: LED; WirePad_1.6x2.0mm; Manufacturer_Part_Number PCB solder pad
J164: BUZ; WirePad_1.6x2.0mm; Manufacturer_Part_Number PCB solder pad
J165: PC8; WirePad_1.6x2.0mm; Manufacturer_Part_Number PCB solder pad
J166: PC9; WirePad_1.6x2.0mm; Manufacturer_Part_Number PCB solder pad
J167: PD14; WirePad_1.6x2.0mm; Manufacturer_Part_Number PCB solder pad

Connections:
+5V_STACK: J102.1, J106.1, J110.1, J114.1, J144.1; also elsewhere on the board
ADC1_RAW: J157.1; also elsewhere on the board
ADC2_RAW: J158.1; also elsewhere on the board
ADC3_RAW: J159.1; also elsewhere on the board
AUX_PC8: J165.1; also elsewhere on the board
AUX_PC9: J166.1; also elsewhere on the board
AUX_PD14: J167.1; also elsewhere on the board
BOOT0: J154.1; also elsewhere on the board
BUZZER_CTRL: J164.1; also elsewhere on the board
EXT_I2C_SCL: J119.1; also elsewhere on the board
EXT_I2C_SDA: J120.1; also elsewhere on the board
EXT_SENSOR_INT: J121.1; also elsewhere on the board
EXT_SPI_CS: J128.1; also elsewhere on the board
EXT_SPI_MISO: J126.1; also elsewhere on the board
EXT_SPI_MOSI: J127.1; also elsewhere on the board
EXT_SPI_SCK: J125.1; also elsewhere on the board
FDCAN1_RX: J131.1; also elsewhere on the board
FDCAN1_TX: J132.1; also elsewhere on the board
GND: J101.1, J105.1, J109.1, J113.1, J117.1, J122.1, J123.1, J129.1, J133.1, J138.1, J143.1, J149.1, J155.1, J161.1; also elsewhere on the board
HOST_RUN_LINK: J147.1; also elsewhere on the board
HOST_TX_LINK: J145.1; also elsewhere on the board
LED_DATA: J163.1; also elsewhere on the board
MOTOR_OK_LINK: J148.1; also elsewhere on the board
MOTOR_TX_LINK: J146.1; also elsewhere on the board
NRST: J153.1; also elsewhere on the board
OUT1: J134.1; also elsewhere on the board
OUT2: J135.1; also elsewhere on the board
OUT3: J136.1; also elsewhere on the board
OUT4: J137.1; also elsewhere on the board
OUT5: J139.1; also elsewhere on the board
OUT6: J140.1; also elsewhere on the board
OUT7: J141.1; also elsewhere on the board
OUT8: J142.1; also elsewhere on the board
RPM_IN: J160.1; also elsewhere on the board
SWCLK: J152.1; also elsewhere on the board
SWDIO: J151.1; also elsewhere on the board
UART1_RX: J104.1; also elsewhere on the board
UART1_TX: J103.1; also elsewhere on the board
UART2_RX: J108.1; also elsewhere on the board
UART2_TX: J107.1; also elsewhere on the board
UART3_RX: J112.1; also elsewhere on the board
UART3_TX: J111.1; also elsewhere on the board
UART4_RX: J116.1; also elsewhere on the board
UART4_TX: J115.1; also elsewhere on the board

Notes on the sheet:
STorM32 CONTROLLER R3-S | TWO-EDGE IO PADS / ROLE ALTERNATIVES
Routed six-layer prototype CAD | Hardware validation pending
F / N EDGE ROW
F / NI EDGE ROW
F / S EDGE ROW
F / SI EDGE ROW
B / N EDGE ROW
B / S EDGE ROW
B / SI EDGE ROW
Raw3.3V IO or externally conditioned ADC only. No off-state drive without external isolation. OUT pads are signals; servo/BEC/LED/buzzer power separate. CAN requires transceiver. SPI3 separate from NAND.
Regulated5V input only, no direct battery. Firmware compile checks are not bench/flight qualification. FLASH_CS service access is internalTP1.

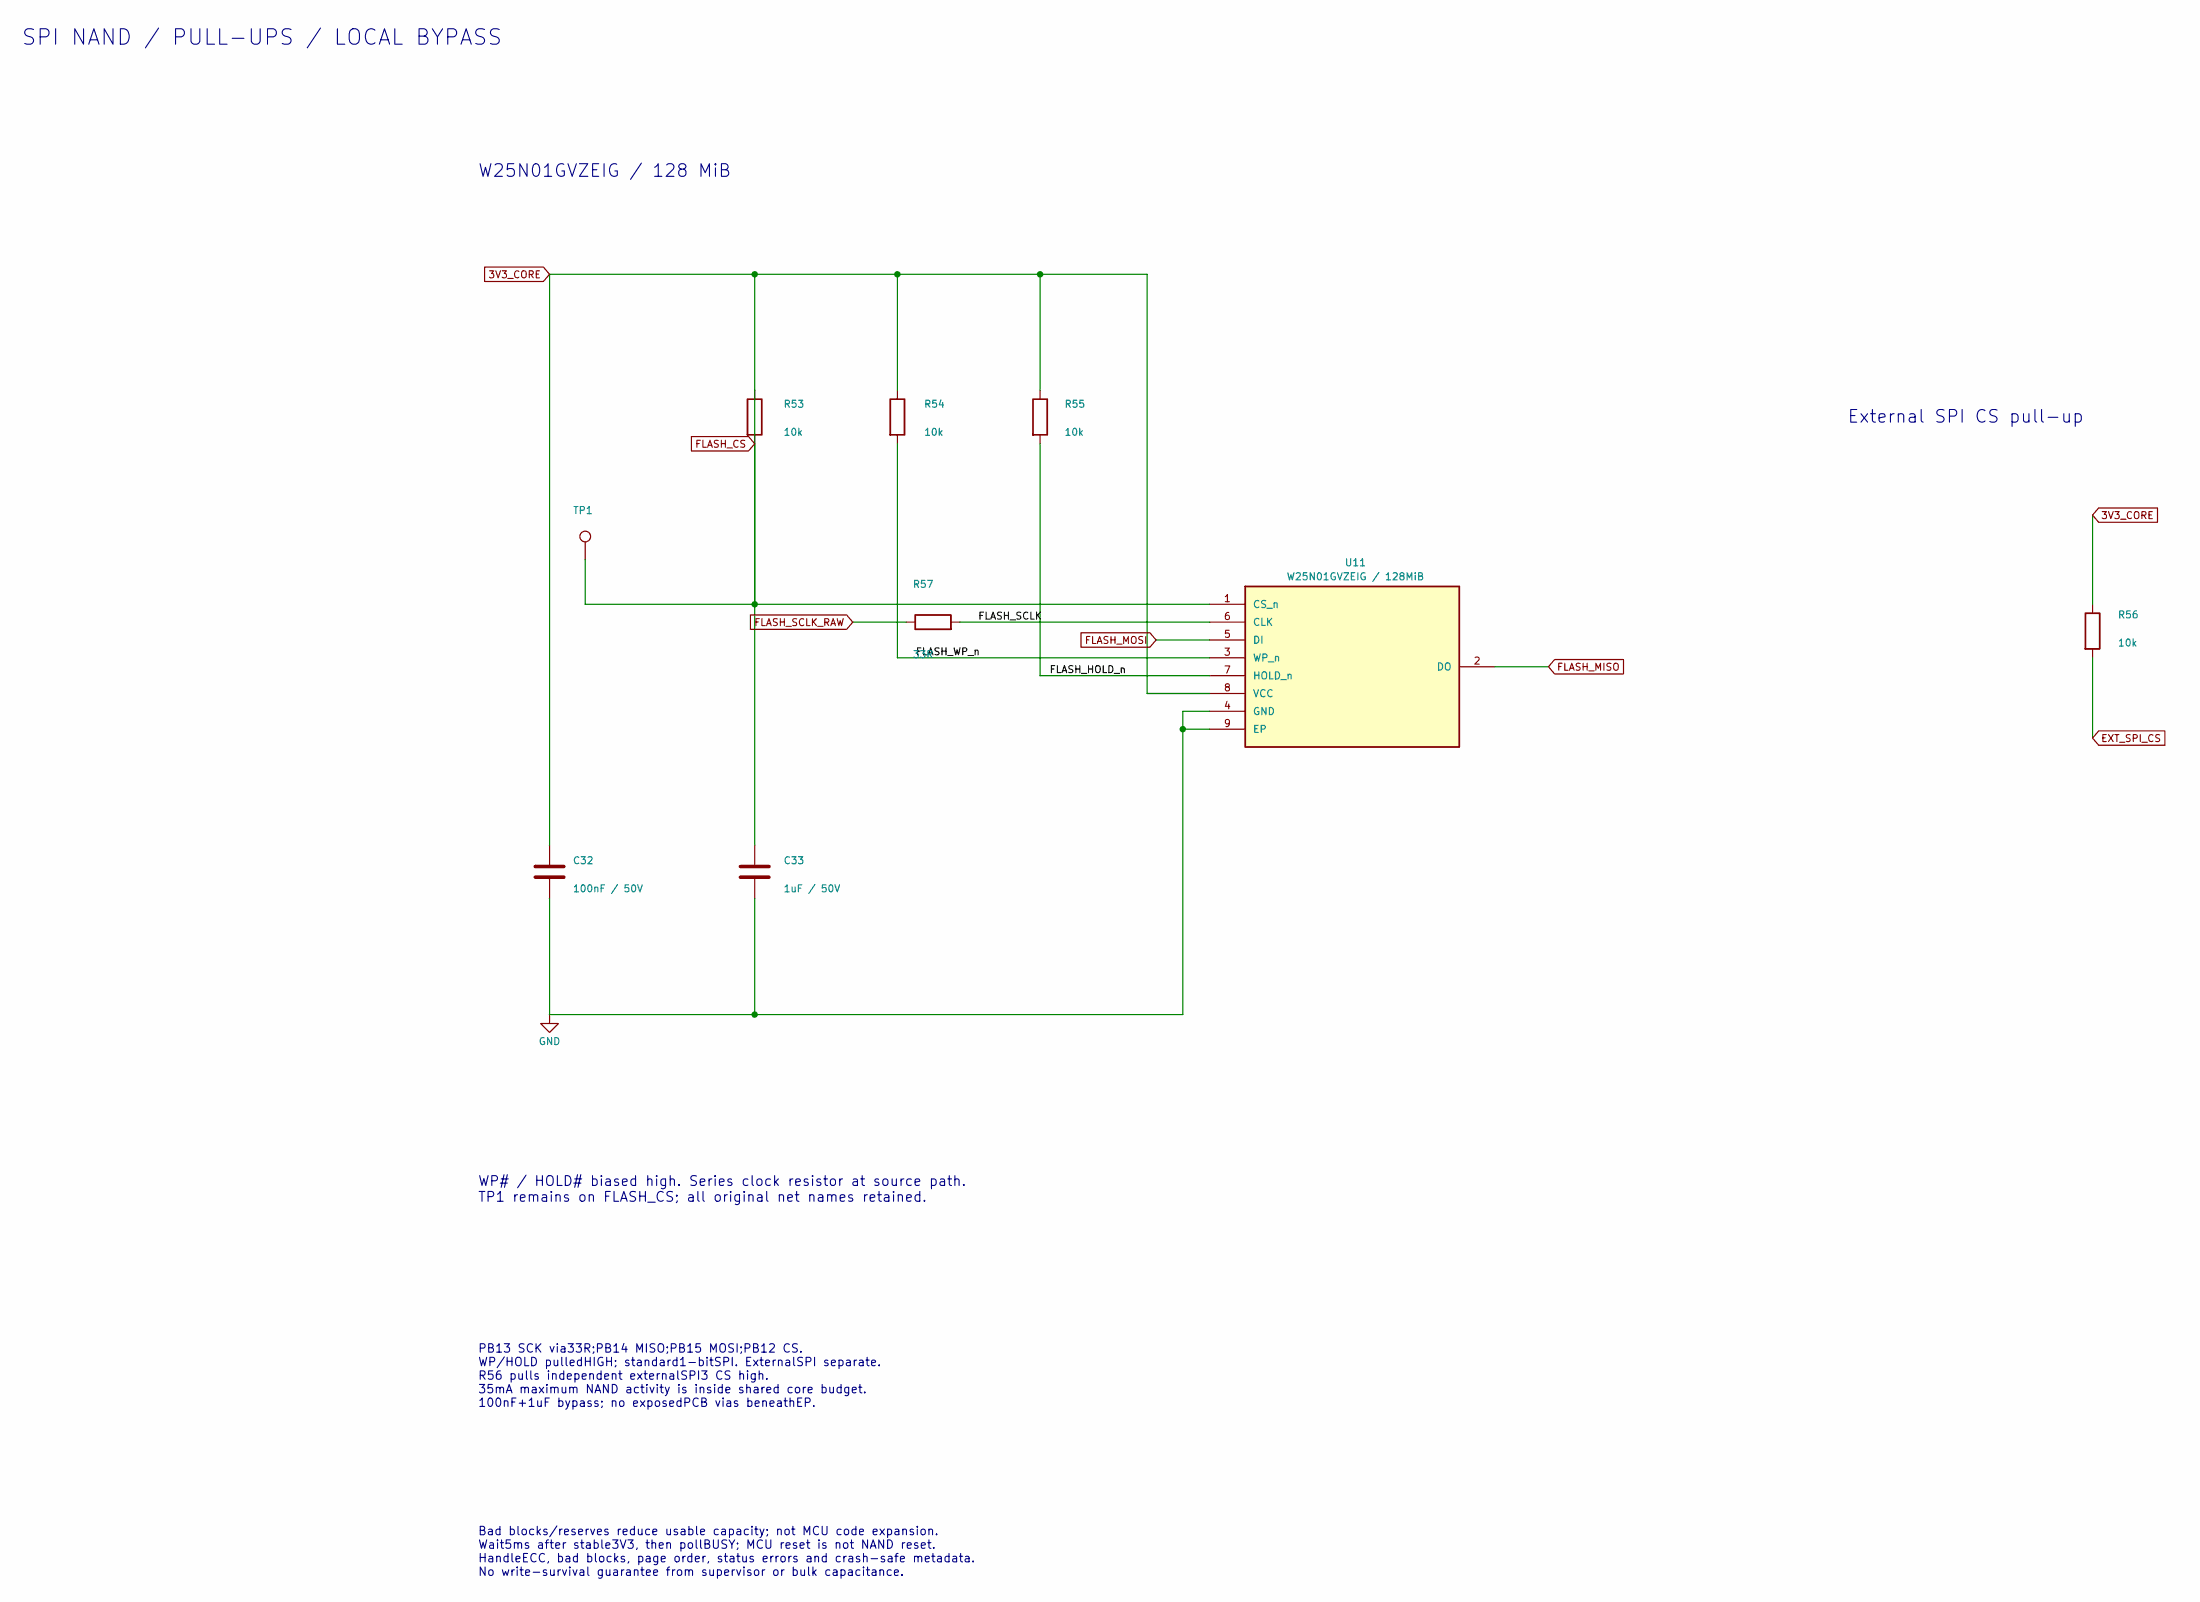
[picture p172: schematic storage.kicad_sch, 128 MiB NAND / DEDICATED SPI2]

Parts:
C32: 100nF / 50V; C32_C_0603_1608Metric; Manufacturer_Part_Number CC0603KRX7R9BB104; LCSC C14663
C33: 1uF / 50V; C33_C_0603_1608Metric; Manufacturer_Part_Number CL10A105KB8NNNC; LCSC C15849
R53: 10k; R53_R_0603_1608Metric; Manufacturer_Part_Number 0603WAF1002T5E; LCSC C25804
R54: 10k; R54_R_0603_1608Metric; Manufacturer_Part_Number 0603WAF1002T5E; LCSC C25804
R55: 10k; R55_R_0603_1608Metric; Manufacturer_Part_Number 0603WAF1002T5E; LCSC C25804
R56: 10k; R56_R_0603_1608Metric; Manufacturer_Part_Number 0603WAF1002T5E; LCSC C25804
R57: 33R; R57_R_0603_1608Metric; Manufacturer_Part_Number 0603WAF330JT5E; LCSC C23140
TP1: FLASH_CS service; TestPoint_Pad_D1.0mm_R3S_NoRing; Manufacturer_Part_Number PCB test point
U11: W25N01GVZEIG / 128MiB; U11_WSON-8-1EP_8x6mm_P1.27mm_EP3.4x4.3mm; Manufacturer_Part_Number W25N01GVZEIG; LCSC C88868

Connections:
/storage/FLASH_HOLD_n: R55.2, U11.7 (HOLD_n)
/storage/FLASH_SCLK: R57.2, U11.6 (CLK)
/storage/FLASH_WP_n: R54.2, U11.3 (WP_n)
EXT_SPI_CS: R56.2; also elsewhere on the board
FLASH_MISO: U11.2 (DO); also elsewhere on the board
FLASH_MOSI: U11.5 (DI); also elsewhere on the board
FLASH_SCLK_RAW: R57.1; also elsewhere on the board
GND: C32.2, C33.2, U11.4 (GND), U11.9 (EP); also elsewhere on the board

Notes on the sheet:
SPI NAND / PULL-UPS / LOCAL BYPASS
W25N01GVZEIG / 128 MiB
External SPI CS pull-up
WP# / HOLD# biased high. Series clock resistor at source path. TP1 remains on FLASH_CS; all original net names retained.
PB13 SCK via33R;PB14 MISO;PB15 MOSI;PB12 CS. WP/HOLD pulledHIGH; standard1-bitSPI. ExternalSPI separate. R56 pulls independent externalSPI3 CS high. 35mA maximum NAND activity is inside shared core budget. 100nF+1uF bypass; no exposedPCB vias beneathEP.
Bad blocks/reserves reduce usable capacity; not MCU code expansion. Wait5ms after stable3V3, then pollBUSY; MCU reset is not NAND reset. HandleECC, bad blocks, page order, status errors and crash-safe metadata. No write-survival guarantee from supervisor or bulk capacitance.

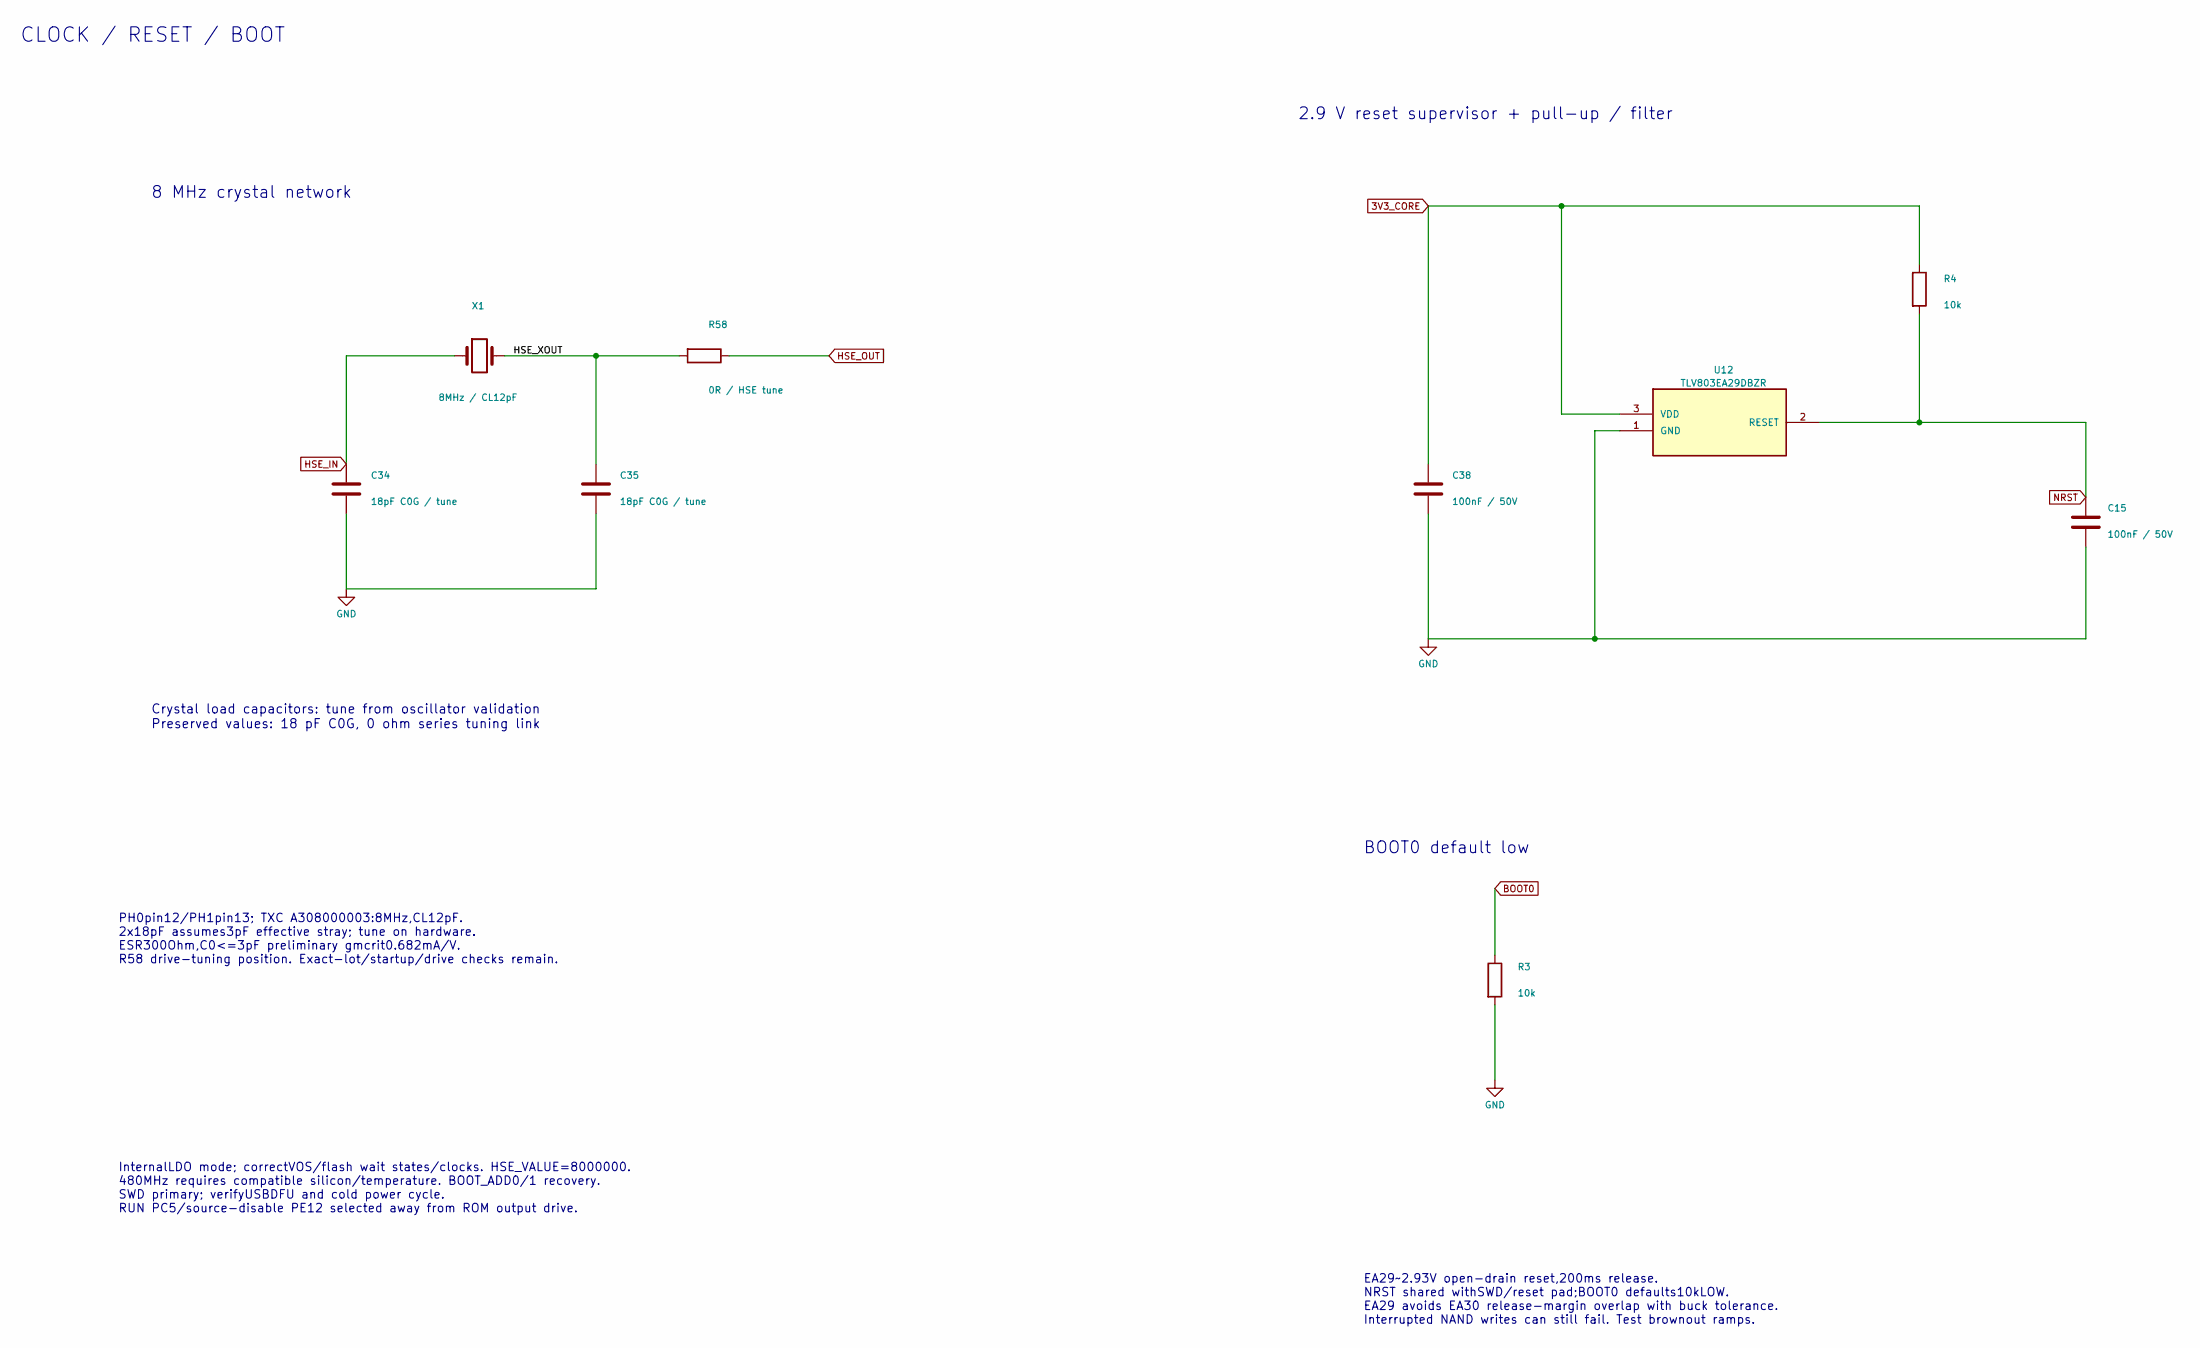
[picture p173: schematic clock-reset.kicad_sch, 8MHz HSE / RESET / RECOVERY]

Parts:
C15: 100nF / 50V; C15_C_0603_1608Metric; Manufacturer_Part_Number CC0603KRX7R9BB104; LCSC C14663
C34: 18pF C0G / tune; C34_C_0603_1608Metric; Manufacturer_Part_Number CL10C180JB8NNNC; LCSC C1647
C35: 18pF C0G / tune; C35_C_0603_1608Metric; Manufacturer_Part_Number CL10C180JB8NNNC; LCSC C1647
C38: 100nF / 50V; C38_C_0603_1608Metric; Manufacturer_Part_Number CC0603KRX7R9BB104; LCSC C14663
R3: 10k; R3_R_0603_1608Metric; Manufacturer_Part_Number 0603WAF1002T5E; LCSC C25804
R4: 10k; R4_R_0603_1608Metric; Manufacturer_Part_Number 0603WAF1002T5E; LCSC C25804
R58: 0R / HSE tune; R58_R_0603_1608Metric; Manufacturer_Part_Number 0603WAF0000T5E; LCSC C21189
U12: TLV803EA29DBZR; U12_SOT-23; Manufacturer_Part_Number TLV803EA29DBZR; LCSC C1852114
X1: 8MHz / CL12pF; TXC_A308000003_3225_2pad; Manufacturer_Part_Number A308000003; LCSC C409345

Connections:
/clock/HSE_XOUT: C35.1, R58.2, X1.2
BOOT0: R3.1; also elsewhere on the board
GND: C15.2, C34.2, C35.2, C38.2, R3.2, U12.1 (GND); also elsewhere on the board
HSE_IN: C34.1, X1.1; also elsewhere on the board
HSE_OUT: R58.1; also elsewhere on the board
NRST: C15.1, R4.2, U12.2 (RESET); also elsewhere on the board

Notes on the sheet:
CLOCK / RESET / BOOT
8 MHz crystal network
2.9 V reset supervisor + pull-up / filter
BOOT0 default low
Crystal load capacitors: tune from oscillator validation Preserved values: 18 pF C0G, 0 ohm series tuning link
PH0pin12/PH1pin13; TXC A308000003:8MHz,CL12pF. 2x18pF assumes3pF effective stray; tune on hardware. ESR300Ohm,C0<=3pF preliminary gmcrit0.682mA/V. R58 drive-tuning position. Exact-lot/startup/drive checks remain.
EA29~2.93V open-drain reset,200ms release. NRST shared withSWD/reset pad;BOOT0 defaults10kLOW. EA29 avoids EA30 release-margin overlap with buck tolerance. Interrupted NAND writes can still fail. Test brownout ramps.
InternalLDO mode; correctVOS/flash wait states/clocks. HSE_VALUE=8000000. 480MHz requires compatible silicon/temperature. BOOT_ADD0/1 recovery. SWD primary; verifyUSBDFU and cold power cycle. RUN PC5/source-disable PE12 selected away from ROM output drive.

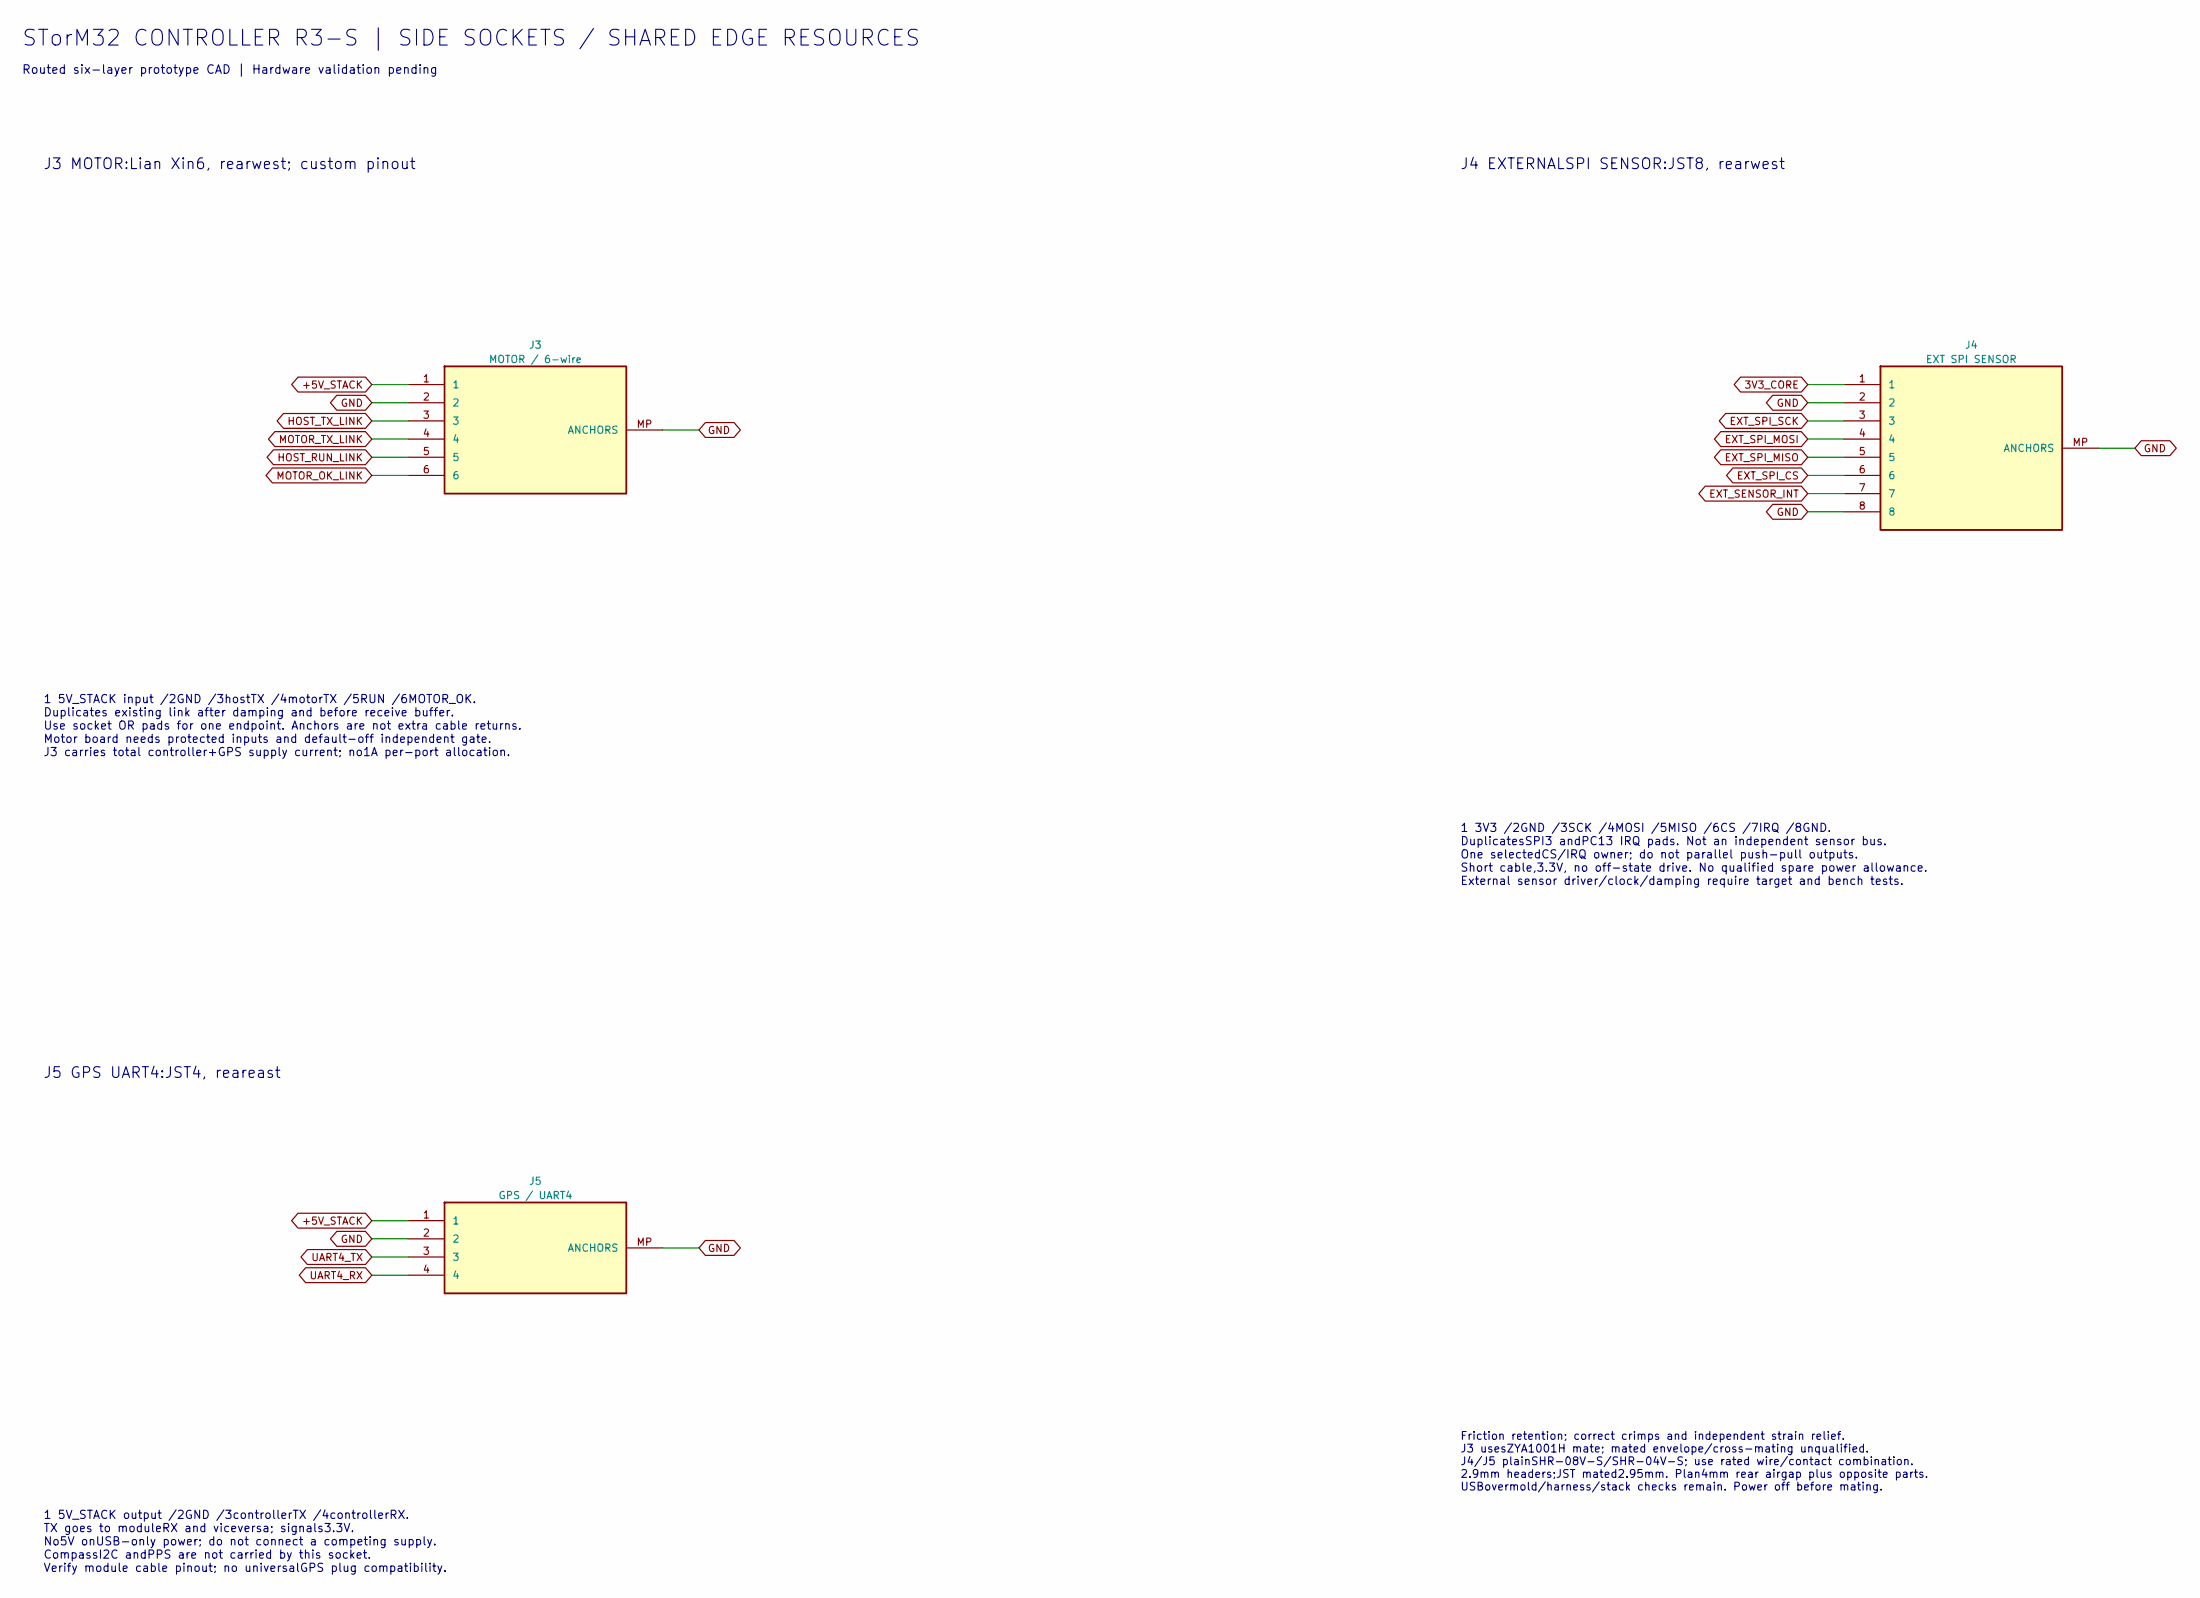
[picture p174: schematic side-sockets.kicad_sch, SIDE SOCKETS / SHARED EDGE RESOURCES]

Parts:
J3: MOTOR / 6-wire; LianXin_XDWF-0910_06P_Horizontal; Manufacturer_Part_Number XDWF-0910-06P; LCSC C7527621
J4: EXT SPI SENSOR; J4_JST_SH_SM08B-SRSS-TB_1x08-1MP_P1.00mm_Horizontal; Manufacturer_Part_Number SM08B-SRSS-TB(LF)(SN); LCSC C160407
J5: GPS / UART4; J5_JST_SH_SM04B-SRSS-TB_1x04-1MP_P1.00mm_Horizontal; Manufacturer_Part_Number SM04B-SRSS-TB(LF)(SN); LCSC C160404

Connections:
+5V_STACK: J3.1, J5.1; also elsewhere on the board
EXT_SENSOR_INT: J4.7; also elsewhere on the board
EXT_SPI_CS: J4.6; also elsewhere on the board
EXT_SPI_MISO: J4.5; also elsewhere on the board
EXT_SPI_MOSI: J4.4; also elsewhere on the board
EXT_SPI_SCK: J4.3; also elsewhere on the board
GND: J3.2, J3.MP (ANCHORS), J4.2, J4.8, J4.MP (ANCHORS), J5.2, J5.MP (ANCHORS); also elsewhere on the board
HOST_RUN_LINK: J3.5; also elsewhere on the board
HOST_TX_LINK: J3.3; also elsewhere on the board
MOTOR_OK_LINK: J3.6; also elsewhere on the board
MOTOR_TX_LINK: J3.4; also elsewhere on the board
UART4_RX: J5.4; also elsewhere on the board
UART4_TX: J5.3; also elsewhere on the board

Notes on the sheet:
STorM32 CONTROLLER R3-S | SIDE SOCKETS / SHARED EDGE RESOURCES
Routed six-layer prototype CAD | Hardware validation pending
J3 MOTOR:Lian Xin6, rearwest; custom pinout
1 5V_STACK input /2GND /3hostTX /4motorTX /5RUN /6MOTOR_OK. Duplicates existing link after damping and before receive buffer. Use socket OR pads for one endpoint. Anchors are not extra cable returns. Motor board needs protected inputs and default-off independent gate. J3 carries total controller+GP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
J4 EXTERNALSPI SENSOR:JST8, rearwest
1 3V3 /2GND /3SCK /4MOSI /5MISO /6CS /7IRQ /8GND. DuplicatesSPI3 andPC13 IRQ pads. Not an independent sensor bus. One selectedCS/IRQ owner; do not parallel push-pull outputs. Short cable,3.3V, no off-state drive. No qualified spare power allowance. External sensor driver/clock/damping require targe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
J5 GPS UART4:JST4, reareast
1 5V_STACK output /2GND /3controllerTX /4controllerRX. TX goes to moduleRX and viceversa; signals3.3V. No5V onUSB-only power; do not connect a competing supply. CompassI2C andPPS are not carried by this socket. Verify module cable pinout; no universalGPS plug compatibility.
Friction retention; correct crimps and independent strain relief. J3 usesZYA1001H mate; mated envelope/cross-mating unqualified. J4/J5 plainSHR-08V-S/SHR-04V-S; use rated wire/contact combination. 2.9mm headers;JST mated2.95mm. Plan4mm rear airgap plus opposite parts. USBovermold/harness/stack chec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
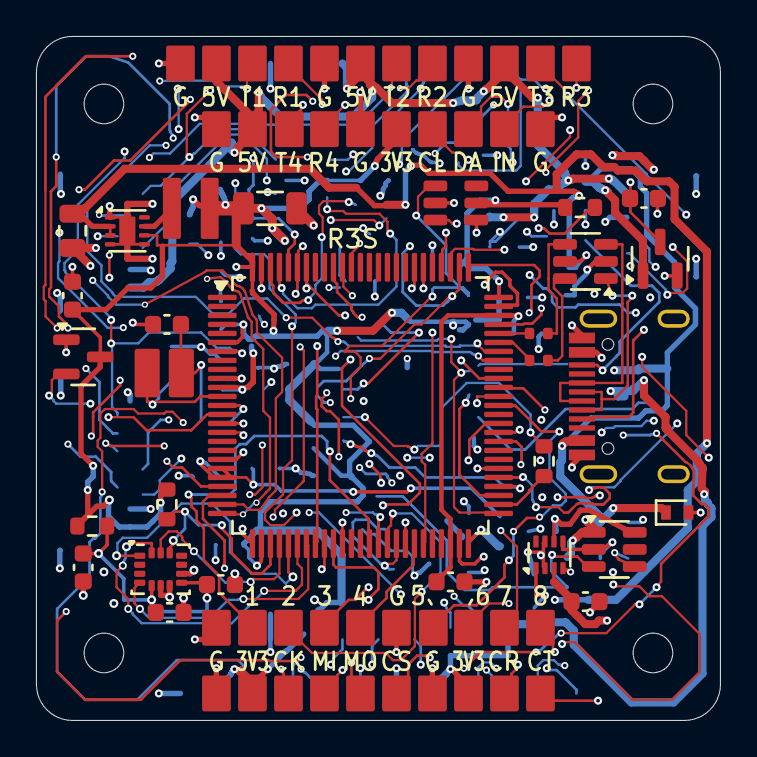
[picture p175: board controller.kicad_pcb from above]

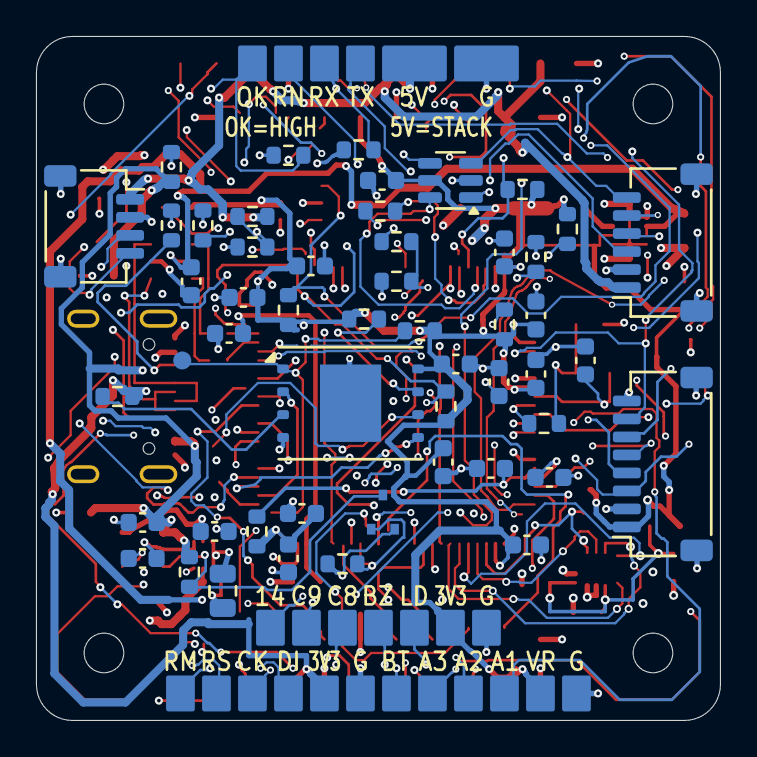
[picture p176: board controller.kicad_pcb from below]

Board: 6 copper layers, 38.0 x 38.0 mm, 151 parts (76 on the bottom side), 85 nets.

Other parts of the board:
H1, H2, H3, H4: MountingHole_2.2mm_M2
