chenguoming1/h743-controllers/f722-heli/layout-revision/checkpoints/native6-cleanup-v1-20261012/hardware/power-core.kicad_sch

## KiCad design f722-heli/layout-revision/checkpoints/native6-cleanup-v1-20261012/hardware/power-core.kicad_sch (2026-10-07)

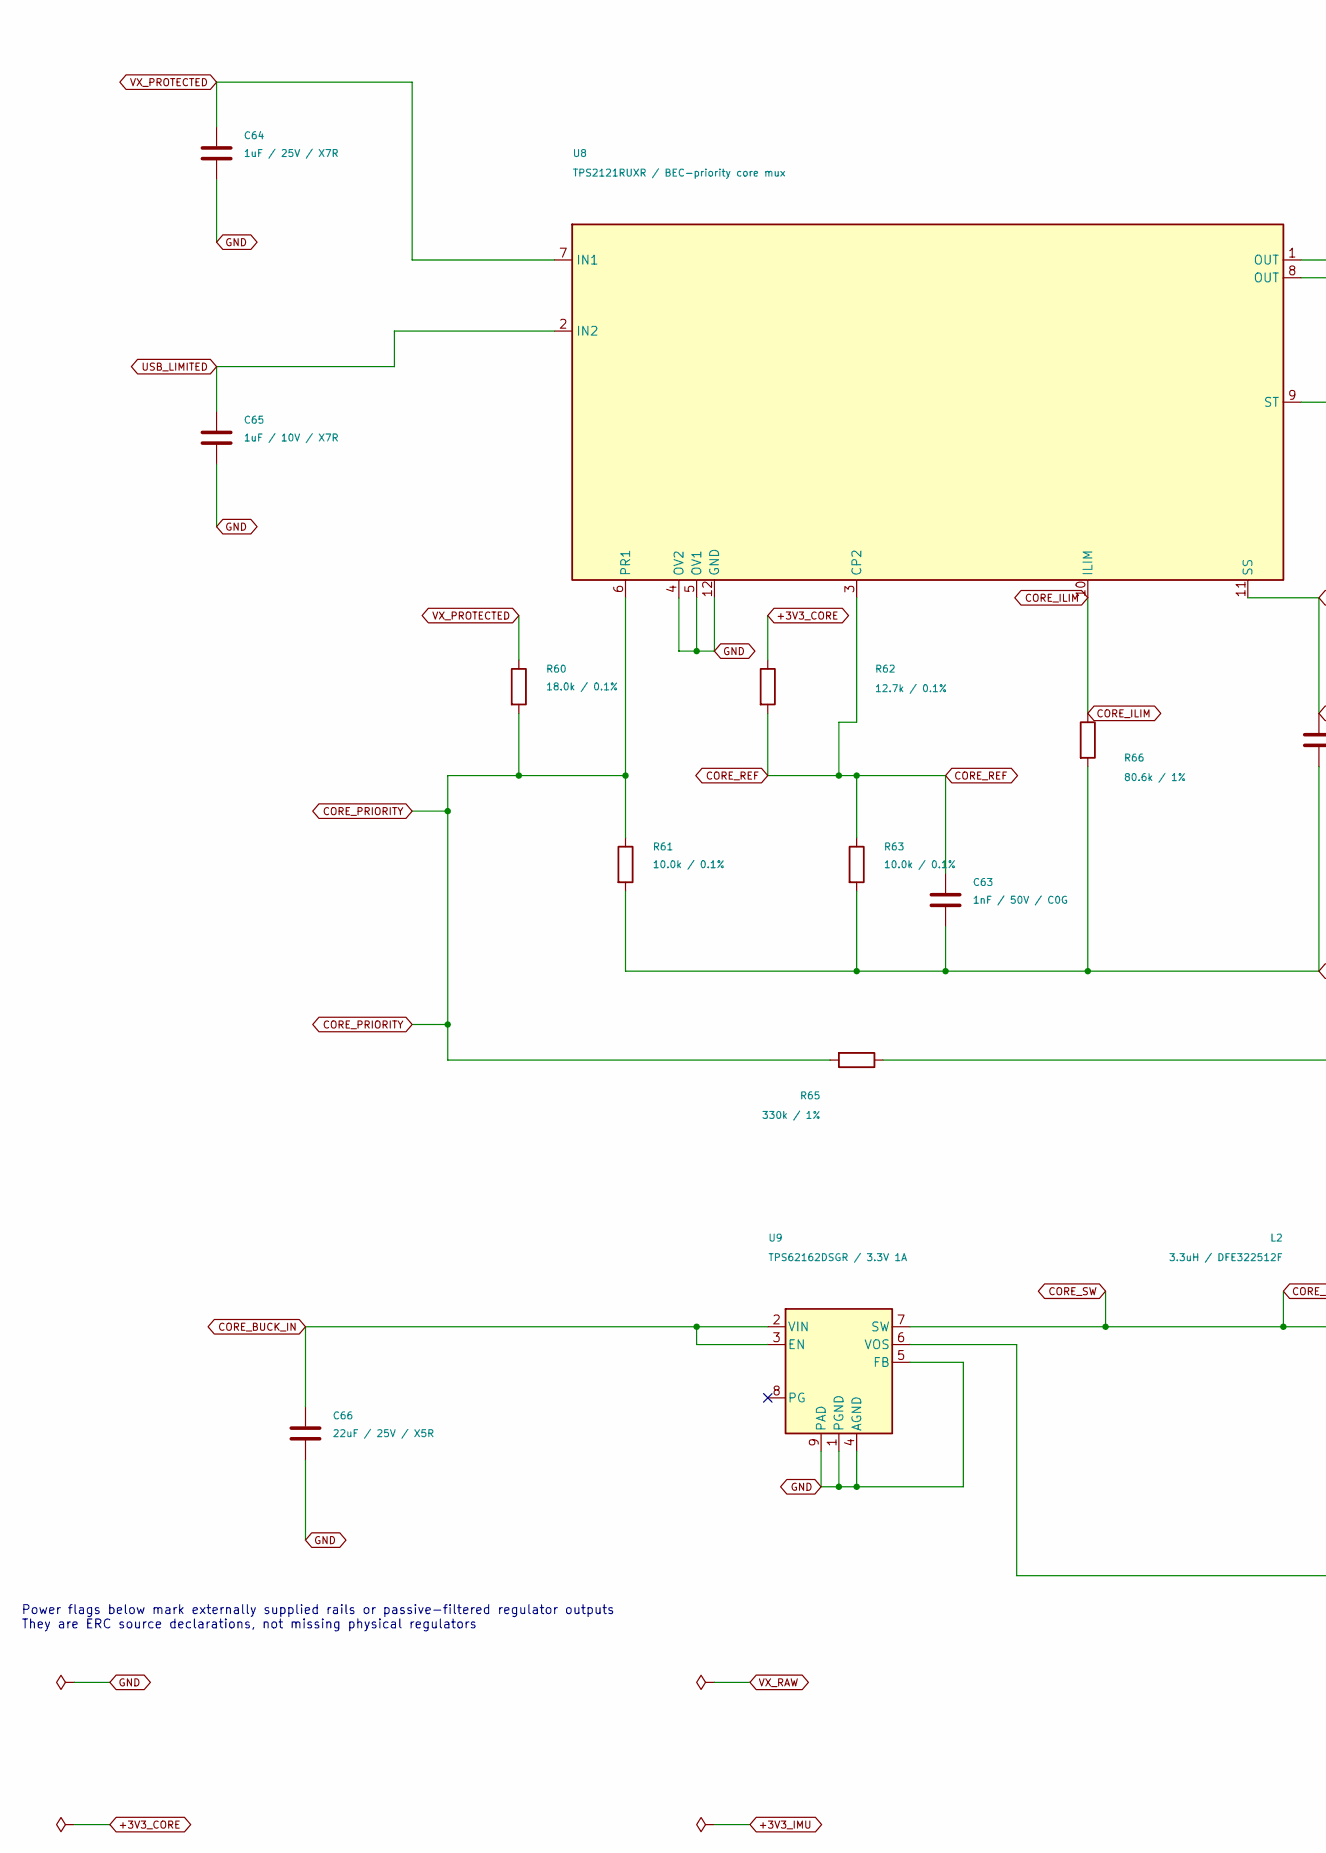
[picture p177: schematic power-core.kicad_sch, part in row 1, column 1]

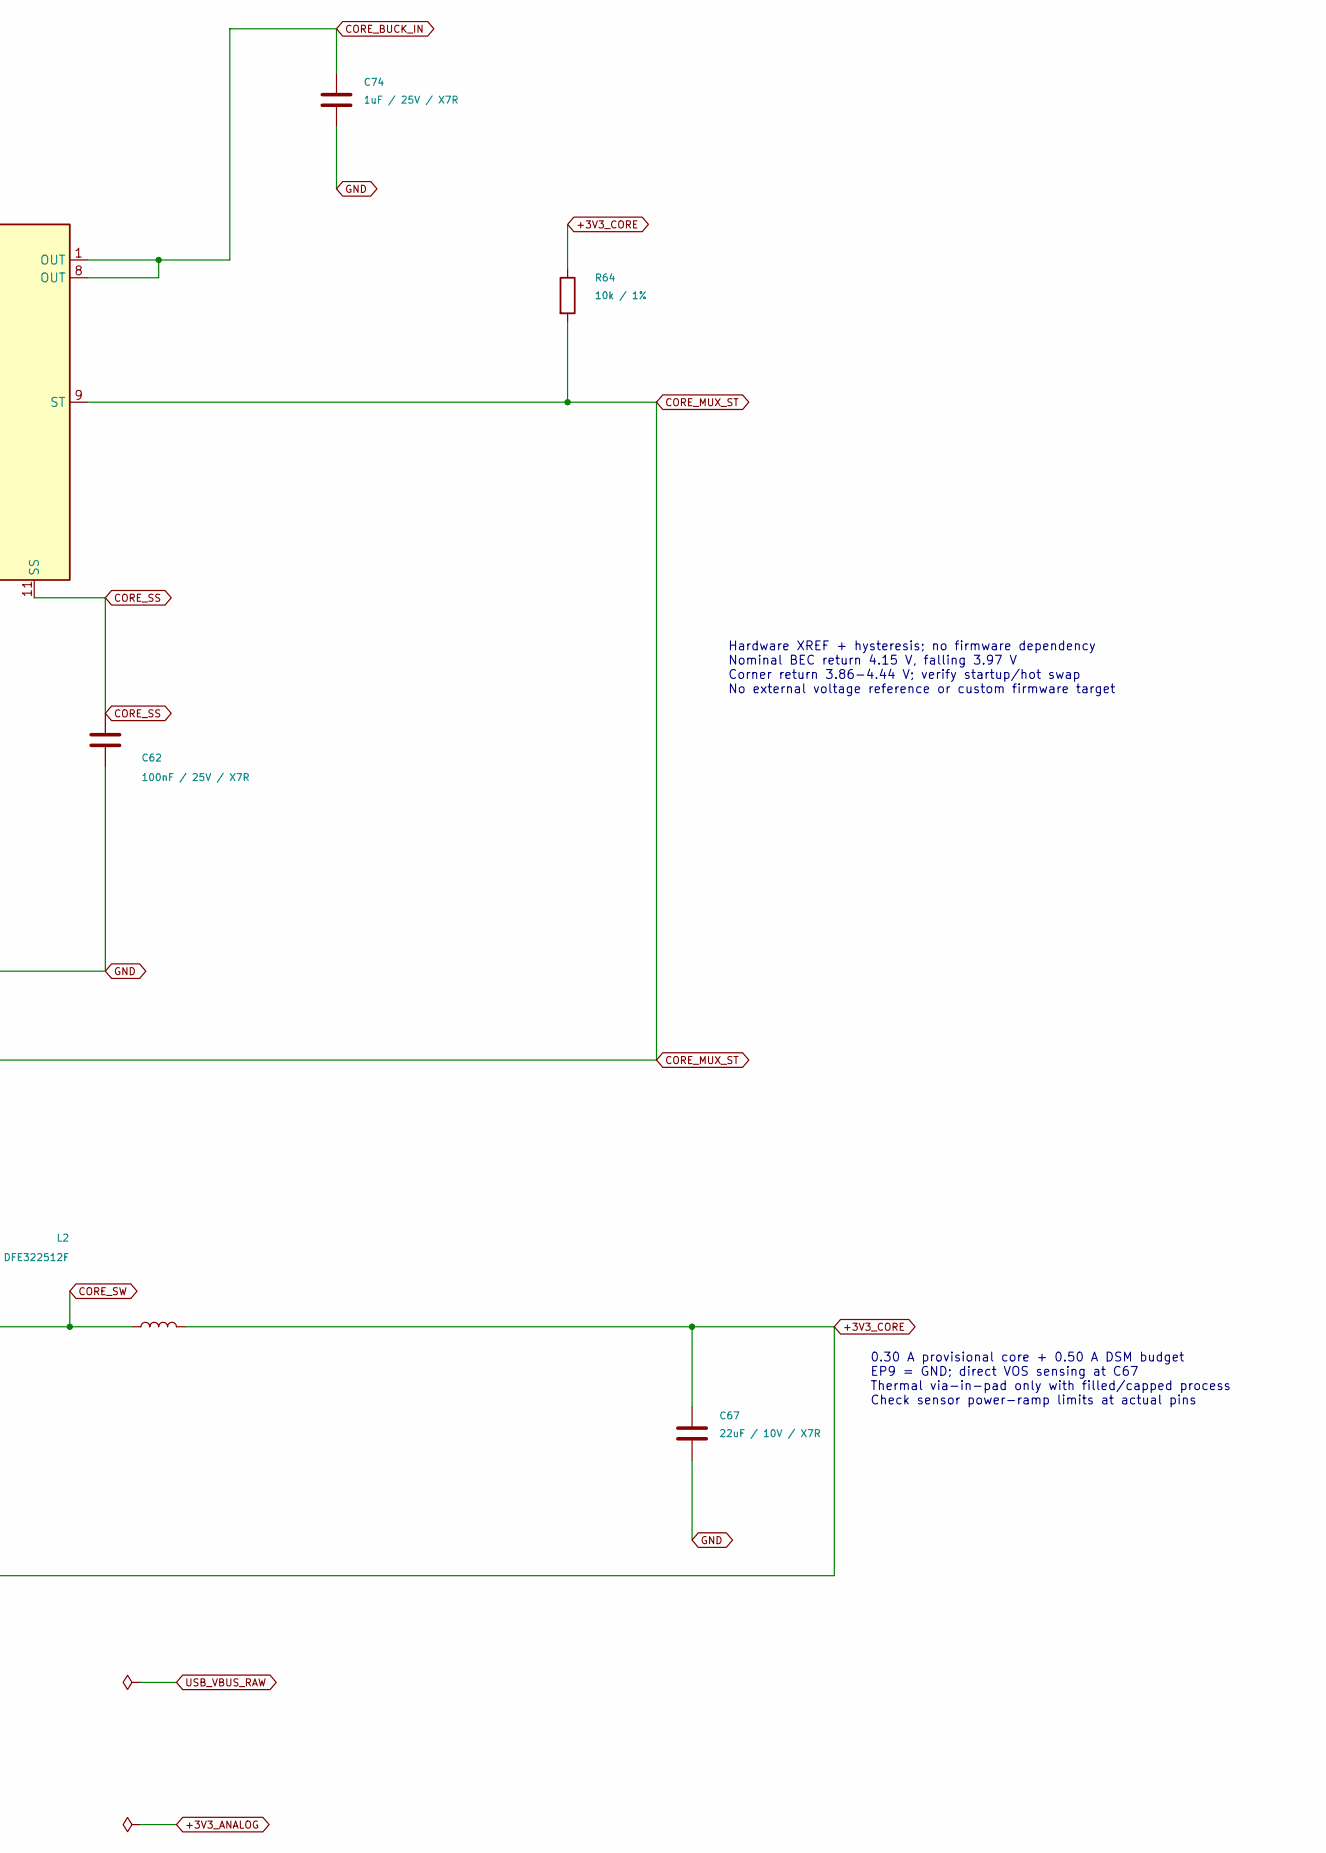
[picture p178: schematic power-core.kicad_sch, part in row 1, column 2]

Parts:
C62: 100nF / 25V / X7R; C_0402_1005Metric; MPN CL05B104KA5NNNC; LCSC C155422
C63: 1nF / 50V / C0G; C_0402_1005Metric; MPN CL05C102JB5NNNC; LCSC C307441
C64, C74: 1uF / 25V / X7R; C_0603_1608Metric; MPN CL10B105KA8NNNC; LCSC C29936
C65: 1uF / 10V / X7R; C_0603_1608Metric; MPN CL10B105KP8NNNC; LCSC C95843
C66: 22uF / 25V / X5R; C_0805_2012Metric; MPN GRM21BR61E226ME44L; LCSC C86816
C67: 22uF / 10V / X7R; C_0805_2012Metric; MPN GRM21BZ71A226ME15L; LCSC C907991
L2: 3.3uH / DFE322512F; Murata_DFE322512F; MPN DFE322512F-3R3M=P2; LCSC C3221010
R60: 18.0k / 0.1%; R_0402_1005Metric; MPN RT0402BRD0718KL; LCSC C852579
R61, R63: 10.0k / 0.1%; R_0402_1005Metric; MPN RT0402BRD0710KL; LCSC C190095
R62: 12.7k / 0.1%; R_0402_1005Metric; MPN RT0402BRD0712K7L; LCSC C852509
R64: 10k / 1%; R_0402_1005Metric; MPN 0402WGF1002TCE; LCSC C25744
R65: 330k / 1%; R_0402_1005Metric; MPN 0402WGF3303TCE; LCSC C25778
R66: 80.6k / 1%; R_0402_1005Metric; MPN 0402WGF8062TCE; LCSC C25921
U8: TPS2121RUXR / BEC-priority core mux; Texas_RUX0012A_TPS2121_2x2.5mm; MPN TPS2121RUXR; LCSC C485916
U9: TPS62162DSGR / 3.3V 1A; Texas_DSG0008A_TPS62162_2x2mm_EP0.9x1.6mm; MPN TPS62162DSGR; LCSC C40256

Connections:
+3V3_CORE: C67.1, L2.2, R62.1, R64.1, U9.6 (VOS)
CORE_BUCK_IN: C66.1, C74.1, U8.1 (OUT), U8.8 (OUT), U9.2 (VIN), U9.3 (EN)
CORE_ILIM: R66.1, U8.10 (ILIM)
CORE_MUX_ST: R64.2, R65.1, U8.9 (ST)
CORE_PRIORITY: R60.2, R61.1, R65.2, U8.6 (PR1)
CORE_REF: C63.1, R62.2, R63.1, U8.3 (CP2)
CORE_SS: C62.1, U8.11 (SS)
CORE_SW: L2.1, U9.7 (SW)
GND: C62.2, C63.2, C64.2, C65.2, C66.2, C67.2, C74.2, R61.2, R63.2, R66.2, U8.4 (OV2), U8.5 (OV1), U8.12 (GND), U9.1 (PGND), U9.4 (AGND), U9.5 (FB), U9.9 (PAD)
USB_LIMITED: C65.1, U8.2 (IN2)
VX_PROTECTED: C64.1, R60.1, U8.7 (IN1)

Notes on the sheet:
Hardware XREF + hysteresis; no firmware dependency Nominal BEC return 4.15 V, falling 3.97 V Corner return 3.86-4.44 V; verify startup/hot swap No external voltage reference or custom firmware target
0.30 A provisional core + 0.50 A DSM budget EP9 = GND; direct VOS sensing at C67 Thermal via-in-pad only with filled/capped process Check sensor power-ramp limits at actual pins
Power flags below mark externally supplied rails or passive-filtered regulator outputs They are ERC source declarations, not missing physical regulators
