chenguoming1/h743-controllers/nexus-style-fc/routing-wip/2026-10-15/local-r51-checkpoint/metadata-integration/experimental-r51/hardware/header-board/nexus-header-board.kicad_sch

## KiCad design nexus-style-fc/routing-wip/2026-10-15/local-r51-checkpoint/metadata-integration/experimental-r51/hardware/header-board/nexus-header-board.kicad_sch (2026-10-15)


Parts:
J1: Servo header 3x7; Header_3x07_P2.54_Vertical_Servo; LCSC C32713294
K1: GND strip; ChildBoard_TabStrip_W9.8
K2: VX strip; ChildBoard_TabStrip_W9.8
P1: S1 tab pad; ChildBoard_TabPad_Sig
P2: S2 tab pad; ChildBoard_TabPad_Sig
P3: S3 tab pad; ChildBoard_TabPad_Sig
P4: TAIL tab pad; ChildBoard_TabPad_Sig
P5: ESC tab pad; ChildBoard_TabPad_Sig
P6: RPM tab pad; ChildBoard_TabPad_Sig
P7: SBUS tab pad; ChildBoard_TabPad_Sig
T1: GND tab pad; ChildBoard_TabPad_Pwr
T2: VX tab pad; ChildBoard_TabPad_Pwr

Connections:
ESC: J1.13, P5.1
GND: J1.3, J1.6, J1.9, J1.12, J1.15, J1.18, J1.21, K1.1, T1.1
RPM: J1.16, P6.1
S1: J1.1, P1.1
S2: J1.4, P2.1
S3: J1.7, P3.1
SBUS: J1.19, P7.1
TAIL: J1.10, P4.1
VX: J1.2, J1.5, J1.8, J1.11, J1.14, J1.17, J1.20, K2.1, T2.1

Notes on the sheet:
SERVO HEADER CHILD BOARD
POWER FLAGS
