chenguoming1/h743-controllers/self-balancing/native/review/p6-assembly-prose-diff.txt

--- build_assembly_pdf_p6.py original P6 labels
+++ build_assembly_pdf_p6.py reviewed final manufacturing prose
@@ -31,7 +31,7 @@
 profile=json.loads((a.project/'review/manufacturing-profile.json').read_text());assert profile['stack_id']=='JLC06161H-3313'
 critical=['U1','U2','U3','U4','U6','U8','U10','U11','U12','U13','Q1','Q2','D4','J2','J3','J4','J5'];critset=set(critical)
 INK=colors.HexColor('#173d58');BLACK=colors.HexColor('#151d29');GRAY=colors.HexColor('#788493');LIGHT=colors.HexColor('#eef1f4');PAD=colors.HexColor('#dcc78f');PIN=colors.HexColor('#bd3338');FAB=colors.HexColor('#bfc7ce');SILK=colors.HexColor('#8b782d');BLUE=colors.HexColor('#365e82')
-W,H=landscape(A4);output=a.out/('controller-r3s-assembly-manufacturing.pdf' if a.frozen else 'controller-r3s-assembly-manufacturing-PROVISIONAL.pdf');c=canvas.Canvas(str(output),pagesize=(W,H),pageCompression=1);date=datetime.datetime.now(datetime.timezone.utc).strftime('D:%Y%m%d%H%M%SZ');c.setDateFormatter(lambda *args:date);c.setTitle('Controller R3-S6-P6 assembly and manufacturing drawing');c.setAuthor('Controller engineering review');c.setSubject('Six layer native assembly drawing; provisional routing status' if not a.frozen else 'R3-S6-P6; ASSEMBLY NOT CLEARED; supplier model alignment and hardware qualification pending')
+W,H=landscape(A4);output=a.out/('controller-r3s-assembly-manufacturing.pdf' if a.frozen else 'controller-r3s-assembly-manufacturing-PROVISIONAL.pdf');c=canvas.Canvas(str(output),pagesize=(W,H),pageCompression=1);date=datetime.datetime.now(datetime.timezone.utc).strftime('D:%Y%m%d%H%M%SZ');c.setDateFormatter(lambda *args:date);c.setTitle('Controller R3-S6-P6 assembly and manufacturing drawing');c.setAuthor('Controller engineering review');c.setSubject('Six layer native assembly drawing; provisional routing status' if not a.frozen else 'R3-S6-P6; ASSEMBLY NOT CLEARED; assembly production definitions and hardware qualification pending')
 base=ParagraphStyle('Base',fontName='DrawingSans',fontSize=9,leading=12.2,textColor=BLACK);small=ParagraphStyle('Small',parent=base,fontSize=7.7,leading=9.8);cell=ParagraphStyle('Cell',parent=base,fontSize=7.4,leading=9);hc=ParagraphStyle('HeaderCell',parent=cell,fontName='DrawingSans-Bold',textColor=colors.white)
 page=0;warnings=[]
 def text(s,x,y,size=9,bold=False,color=BLACK,align='left'):
@@ -111,7 +111,7 @@
  else:
   notes=['<b>Datum A</b><br/>Native CAD (0,38) = CPL (0,0), the virtual outline bounding corner. CPL X points right and CPL Y points up. The datum is common to Gerbers, drills and both placement sides.','38 x 38 board with 2 mm corner radii, four diameter 2.20 mm NPTH mounts and 30.5 x 30.5 mm mount spacing. Mounts are product mounting holes, not approved assembly tooling holes.','J2 mouth faces the native east edge. Four plated shell slots require explicit solder-process coverage. All 67 wire pads are PCB features, excluded from the 79-part assembly BOM/CPL.']
  for note in notes:y=para(note,x,y,91)-4
- y=para('<b>Viewing limits</b><br/>Routing is omitted from these assembly views. Stencil, fabrication, cable fit and supplier placement approval remain separate checks. ASSEMBLY NOT CLEARED: residual supplier model/process findings remain. These views use native poses; page 6 records the supplier CPL corrections.',x,y,91)
+ y=para('<b>Viewing limits</b><br/>Routing is omitted from these assembly views. Stencil, fabrication, cable fit and supplier placement approval remain separate checks. ASSEMBLY NOT CLEARED: final placement, carrier, stencil and shell-solder production definitions are required. These views use native poses; page 6 records the supplier CPL corrections.',x,y,91)
  if y<40:warnings.append('Page '+str(page)+' notes near scale bar')
  c.showPage()
 
@@ -133,15 +133,15 @@
  f=fps[r];x,y0,angle,side=pose(f);pad=next(p0 for p0 in f.Pads() if p0.GetNumber()==('A1' if r=='J2' else '1'));px,py=xy(pad.GetPosition());net=pad.GetNetname().rsplit('/',1)[-1];net='NC (PE2)' if net.startswith('unconnected-') else net;rows.append([r,fitted[r]['MPN'],side,f'{angle:g}',f'{x:g}, {y0:g}',f'{x:g}, {38-y0:g}',f'{px:g}, {py:g}',net])
 widths=[10,49,16,14,42,41,48,49];widths=[v*269/sum(widths)*mm for v in widths];data=[[Paragraph(str(v),hc if i==0 else cell) for v in row] for i,row in enumerate(rows)];tab=Table(data,colWidths=widths,rowHeights=[9*mm]+[5.8*mm]*17);tab.setStyle(TableStyle([('BACKGROUND',(0,0),(-1,0),INK),('ROWBACKGROUNDS',(0,1),(-1,-1),[colors.white,LIGHT]),('GRID',(0,0),(-1,-1),.3,colors.HexColor('#d9d9d9')),('VALIGN',(0,0),(-1,-1),'MIDDLE'),('LEFTPADDING',(0,0),(-1,-1),4),('RIGHTPADDING',(0,0),(-1,-1),3)]));w,h=tab.wrap(0,0);tab.drawOn(c,14*mm,y*mm-h);y-=h/mm+6;para('<b>Example:</b> U11 bottom anchor is native (20.55,20.375), so CPL is (20.55,17.625). Its mirrored rear-view anchor appears at X_view = 17.45. That 17.45 is a drawing coordinate only. U8 has no silk pin-1 cue; use its Fab cue and this table. Q2 DMN2310UW-7 has no dedicated silk/Fab pin-1 marker: Gate1 is native (19.4,27.375), lower-left in the rear component view; Source2 is GND and Drain3 is USB_SWITCH_ON. Use the red lands and this table in supplier orientation review.',14,y,269);c.showPage()
 
-header('Six layer stack and assembly process','R3-S6-P6 | JLC06161H-3313 | ASSEMBLY NOT CLEARED: supplier placement alignment pending')
+header('Six layer stack and assembly process','R3-S6-P6 | JLC06161H-3313 | ASSEMBLY NOT CLEARED: production definitions required')
 rows=[['Layer / dielectric','Role or material','Thickness mm'],['L1  F.Cu','Signals / components','0.0350'],['L1-L2','3313 prepreg, Dk 4.1','0.0994'],['L2  In1.Cu','GND, front reference','0.0152'],['L2-L3','FR4 core, Dk 4.6','0.5500'],['L3  In2.Cu','Signals / power','0.0152'],['L3-L4','2116 prepreg, Dk 4.16','0.1088'],['L4  In3.Cu','GND, L3 reference','0.0152'],['L4-L5','FR4 core, Dk 4.6','0.5500'],['L5  In4.Cu','GND, rear reference','0.0152'],['L5-L6','3313 prepreg, Dk 4.1','0.0994'],['L6  B.Cu','Signals / components','0.0350']]
 assert [float(row[2]) for row in rows[1:]]==profile['layer_thickness_mm']
 y=table(rows,14,174,[32,47,26],7,7.7)-5
 for note in ['<b>Thickness:</b> order nominal 1.6 mm. Published finished thickness 1.54 mm +/-10%. Native copper/dielectric model totals 1.5384 mm; solder mask is unmodelled coating, not omitted.','<b>Finish:</b> 1 oz outer / 0.5 oz inner copper; green mask, white silk, ENIG.','<b>USB basis:</b> recorded JLC 90 ohm differential result W=0.1392 mm, gap=0.1600 mm, outer signal / adjacent GND, solder mask included. Final geometry and supplier controlled-impedance acceptance still apply.']:y=para(note,14,y,105,small)-4
 y=174
-notes=[('Stencil and hidden joints','U2 uses the local DSG footprint: eight 0.50 x 0.25 mm lead apertures and two 0.90 x 0.70 mm EP windows, all R0.05; rounded EP coverage 87.332%. U11 has four 1.37 x 1.73 mm EP windows. Keep via drill holes out of these apertures and inspect hidden joints.'),('Shared process acceptance','TI illustrates 0.125 mm stencil for U2 and 0.10 mm for U13. U13 aperture XY matches its DRL drawing. The assembler must accept the shared stencil thickness/local treatment and reflow process; matching XY is not qualification of solder volume or voiding. JLC six-layer ordering defaults to filled/capped vias; the actual quoted process remains an acceptance gate.'),('USB shell soldering','J2 has two front 0.60 x 1.40 mm plated slots and two rear 0.60 x 1.70 mm slots, with 0.20 mm copper rings. No shell paste apertures are provided. Explicitly include all four shell joints in the accepted assembly process. Do not treat contacts-only SMT reflow as proof of shell soldering. HRO specifies -30 to +80 C operation; this limits any whole-board temperature claim.'),('Panel and placements','The supplier CPL incorporates the user corrections; the unchanged native audit is supplied separately. Residual model/land/process warnings mean assembly is NOT CLEARED. Resolve each remaining warning and part orientation before approval. Use Standard double-sided PCBA with an accepted JLC carrier/panel. Approve connector access, rails, tooling, both-face fiducials and depaneling against the supplier drawing. No customer array is supplied; page 6 records the explicit supplier-CPL corrections.'),('Via geometry','Exactly seven documented through vias use 0.35 mm diameter / 0.20 mm drill and 0.075 mm radial annulus. All other vias retain at least 0.40 mm diameter. The exact UUID/net/position allowance accompanies the native package; supplier process acceptance is pending.'),('Qualification boundary','Exact J3 mating harness/fixture and 1 A combined input-path budget, TXC lot/HSE startup, stencil/reflow, thermal behaviour and production CAM remain open qualifications. Local CAD or file checks do not establish these physical results.')]
+notes=[('Stencil and hidden joints','U2 uses the local DSG footprint: eight 0.50 x 0.25 mm lead apertures and two 0.90 x 0.70 mm EP windows, all R0.05; rounded EP coverage 87.332%. U11 has four 1.37 x 1.73 mm EP windows. Keep via drill holes out of these apertures and inspect hidden joints.'),('Production stencil definition','JLC regenerates SMT stencil data; require the real U2/U11 split windows in order remarks. Request evaluation of top 0.12 mm with a 0.10 mm U13 region, and bottom 0.10 mm. The stencil engineer must check step boundaries, nearby apertures and solder volume, or document a qualified alternative. This is a proposal, not process qualification.'),('USB shell soldering','J2 has two front 0.60 x 1.40 mm plated slots and two rear 0.60 x 1.70 mm slots, with 0.20 mm copper rings. No shell paste is provided. Require an accepted manual/selective or other qualified solder operation covering all four shell joints, then inspect them. Contacts-only reflow is insufficient. HRO specifies -30 to +80 C operation.'),('Panel and placements','Obtain the final supplier two-face 2D placement/polarity drawing for the exact 79-row corrected CPL. Use Standard double-sided PCBA with accepted carrier/rails/tooling/fiducials, connector mouth and depaneling access, with actual connector support/fixture suitability confirmed during order engineering. A customer-designed array is not required. Page 6 records the exact supplier-CPL corrections; the native placement audit remains separate.'),('Via fabrication settings','Select the 0.20 mm drill/small-via tier and epoxy-filled, copper-capped, mask-covered vias. Seven 0.35/0.20 mm vias have 0.075 mm radial annuli and meet the published preferred diameter-minus-drill rule; all other vias are at least 0.40 mm. Keep component slots and NPTH holes open. These are specified process selections.'),('Qualification boundary','Assembly production definitions are separate from bare-PCB fabrication. First-article checks cover the exact J3 harness and 1 A input-path budget, near-flush USB mating, HSE startup, rails, USB current/attachment firmware, thermal and EMI behaviour. CAD review does not establish these measured hardware results.')]
 for title,note in notes:y=para('<b>'+title+'</b><br/>'+note,130,y,153,small)-4
-y=para('<b>Primary process evidence:</b> <link href="https://www.ti.com/lit/ds/symlink/tps62160.pdf" color="#173d58">TI TPS6216x DSG</link> | <link href="https://www.ti.com/lit/ds/symlink/tps2116.pdf" color="#173d58">TI TPS2116 DRL</link> | <link href="https://jlc-prod-smt.oss-eu-central-1.aliyuncs.com/smtDataManualFile/8550723676065714176-C165948.pdf" color="#173d58">HRO USB drawing</link> | <link href="https://www.jst-mfg.com/product/pdf/eng/eSH.pdf" color="#173d58">JST SH</link> | <link href="https://jlcpcb.com/capabilities/pcb-assembly-capabilities" color="#173d58">JLC assembly</link> | <link href="https://jlcpcb.com/help/article/pcb-assembly-faqs-part-2" color="#173d58">JLC orientation</link>',130,y,153,small)
+y=para('<b>Primary process evidence:</b> <link href="https://www.ti.com/lit/ds/symlink/tps62160.pdf" color="#173d58">TI TPS6216x DSG</link> | <link href="https://www.ti.com/lit/ds/symlink/tps2116.pdf" color="#173d58">TI TPS2116 DRL</link> | <link href="https://jlc-prod-smt.oss-eu-central-1.aliyuncs.com/smtDataManualFile/8550723676065714176-C165948.pdf" color="#173d58">HRO USB drawing</link> | <link href="https://www.jst-mfg.com/product/pdf/eng/eSH.pdf" color="#173d58">JST SH</link> | <link href="https://jlcpcb.com/capabilities/pcb-assembly-capabilities" color="#173d58">JLC assembly</link> | <link href="https://jlcpcb.com/help/article/pcb-assembly-faqs-part-2" color="#173d58">JLC orientation</link> | <link href="https://jlcpcb.com/help/article/smt-stencil-data-prepared-for-smt-orders" color="#173d58">Stencil workflow</link> | <link href="https://jlcpcb.com/help/article/pcb-via-covering" color="#173d58">Via covering</link> | <link href="https://jlcpcb.com/partdetail/Lian_XinTechnology-XDWF_091006P/C7527621" color="#173d58">J3 listing</link>',130,y,153,small)
 if y<20:warnings.append('Page5 notes overflow')
 c.showPage()
 header('Supplier CPL correction record','CPL corrections leave native lands and fitted poses unchanged | User file preserved | Residual assembly warnings remain')
@@ -152,7 +152,7 @@
  old=q['baseline_native_cpl'];new=q['user_corrected_cpl'];rows.append([q['reference'],new['Layer'],old['Mid X']+', '+old['Mid Y'],new['Mid X']+', '+new['Mid Y'],old['Rotation'],new['Rotation']])
 y=table(rows,14,y,[17,22,66,66,49,49],7,8)-7
 y=para('<b>Source integrity:</b> supplied CSV SHA-256 '+overrides['source_sha256'],14,y,269,small)-6
-y=para('<b>Supplier rerun:</b> the corrected file cleared pin-without-pad, lead-to-hole, outer-lead and USB hole-alignment failures in the separate P2 geometry test. Residual U2/D4 land checks, the U11 bottom overlap finding and connector edge/process warnings remain. The P6-Routing-Review records the current review status; this page does not claim assembly clearance.',14,y,269)-6
-para('<b>Required review:</b> confirm supplier model pin 1, actual package terminals and approved lands for every remaining finding, and accept the panel, stencil/reflow and shell-joint process before assembly. No purchase or assembly approval is implied by these files.',14,y,269)
+y=para('<b>Supplier rerun:</b> The P6-Routing-Review reconciles current supplier findings against manufacturer lands and process evidence. J3 through-hole classification is a model error: the exact selected part and native lands have no drilled lead. Generic coloured rows do not replace the four production definitions on page 5. This page does not claim assembly clearance.',14,y,269)-6
+para('<b>Required review:</b> verify the final supplier two-face pin-1/polarity drawing, carrier and connector support, actual production stencil and all four USB shell solder joints before assembly. No purchase or assembly approval is implied by these files.',14,y,269)
 c.showPage();c.save();assert sha(a.board)==sourcehash,'Native source changed during authoring' 
-manifest={'status':'PROVISIONAL ROUTING IN PROGRESS' if not a.frozen else 'R3-S6-P6; ASSEMBLY NOT CLEARED; HARDWARE VALIDATION AND SUPPLIER ACCEPTANCE PENDING','board':str(a.board),'board_sha256':sourcehash,'revision':a.revision,'pdf':str(output),'pdf_sha256':sha(output),'pages':page,'page_size':'A4 landscape','scale_views':'Front/rear 4:1; socket details 7:1 at 100% print','fitted_count':79,'fitted_side_counts':dict(counts),'datum':'Native (0,38); CPL X=nativeX,Y=38-nativeY; common both faces','human_rear':'X_view=38-nativeX,Y_view=nativeY; human component-side mirror only','geometry_warnings':warnings,'visual_QA':'Pending rendered-page inspection','dimensions_mm':{'outline':[38,38],'corner_radius':2,'mount_pitch':[30.5,30.5],'mount_hole_diameter':2.2},'qualifications':['Supplier carrier/panel and exact-part placement alignment pending','Stencil/reflow and USB shell solder process acceptance pending','Harness, thermal, electrical and firmware prototype qualification pending']};(a.out/'assembly-drawing-manifest.json').write_text(json.dumps(manifest,indent=2)+'\n');print(json.dumps(manifest,indent=2))
+manifest={'status':'PROVISIONAL ROUTING IN PROGRESS' if not a.frozen else 'R3-S6-P6; ASSEMBLY NOT CLEARED; HARDWARE VALIDATION AND SUPPLIER ACCEPTANCE PENDING','board':str(a.board),'board_sha256':sourcehash,'revision':a.revision,'pdf':str(output),'pdf_sha256':sha(output),'pages':page,'page_size':'A4 landscape','scale_views':'Front/rear 4:1; socket details 7:1 at 100% print','fitted_count':79,'fitted_side_counts':dict(counts),'datum':'Native (0,38); CPL X=nativeX,Y=38-nativeY; common both faces','human_rear':'X_view=38-nativeX,Y_view=nativeY; human component-side mirror only','geometry_warnings':warnings,'visual_QA':'Pending rendered-page inspection','dimensions_mm':{'outline':[38,38],'corner_radius':2,'mount_pitch':[30.5,30.5],'mount_hole_diameter':2.2},'qualifications':['Before assembly: final two-face placement/polarity drawing and carrier with connector support/fixture suitability confirmed during order engineering','Before assembly: recorded stencil preserving split U2/U11 windows and solder operation for four J2 shell anchors','Harness, thermal, electrical and firmware prototype qualification pending']};(a.out/'assembly-drawing-manifest.json').write_text(json.dumps(manifest,indent=2)+'\n');print(json.dumps(manifest,indent=2))
