chenguoming1/h743-controllers/(commit log)

2026-10-04 added drone board style controller
    [JLC_BOM.csv, P5-baseline-coverage.csv, P6-all-net-coverage.csv, all-pad-evidence.csv, bom-draft.csv, by-net-changes.csv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]
2026-10-04 improved routing by removing small segments
    [controller.kicad_pcb]
2026-10-04 merged small segments
    [controller.kicad_pcb]
2026-10-04 Fix controller zone fill and native DRC metadata
    Refill GND zones after b3a2708 routing edits, remove a copper-neutral redundant UART3_TX segment, and align blank LCSC fields with the schematic. Exact checked PCB SHA256: 1fb4bc1b480e8cfed90fecf4bd843177304ffb22e908799fb2268919e2f8912a. KiCad 10.0.6 DRC/ERC/connectivity/parity all clean.
    [controller.kicad_pcb]
2026-10-04 added library and differential rules
    [clock-reset.kicad_sch, controller.kicad_pcb, controller.kicad_sch, peripherals.kicad_sch, power.kicad_sch, side-sockets.kicad_sch, storage.kicad_sch]
2026-10-04 Fix native USB routing and shallow via contacts
    Native-only repair based on 491987e. Configured DRC/ERC/opens/parity pass. Keeps placement, BOM/CPL, 406 vias and 97 GND stitches. Manufacturing exports have not been regenerated; full validation evidence follows in this branch.
    [controller.kicad_pcb]
2026-10-04 fixed the pcb and schema filter parity
    [clock-reset.kicad_sch, controller.kicad_sch, edge-pads.kicad_sch, peripherals.kicad_sch, power.kicad_sch, side-sockets.kicad_sch, storage.kicad_sch]
2026-10-04 Improve H743 schematic readability with wired functional groups
    [clock-reset.kicad_sch, controller.kicad_sch, peripherals.kicad_sch, power.kicad_sch, storage.kicad_sch]
2026-10-04 Include standard ground symbol for readable schematics
2026-10-04 Add schematic review PDF and integrity evidence
2026-10-05 tidy up trace
    [controller.kicad_pcb]
2026-10-05 tidy up trace ignore trace center on via
    [controller.kicad_pcb]
2026-10-05 Fix C33 supply wire crossing FLASH_CS pull-up
    [storage.kicad_sch]
2026-10-05 Refresh corrected schematic PDF and KiCad 10 evidence
2026-10-06 Add unfinished F722 development snapshot
    Publish the primary editable F722 project and local libraries, development schematic PDF, proposed parts and validation evidence. Draft engineering snapshot only; not fabrication-ready or flight-qualified. Existing self-balancing content is untouched.
    [f722-heli.kicad_pcb, f722-heli.kicad_sch, input-levels.kicad_sch, io-ports.kicad_sch, power-bec.kicad_sch, power-core.kicad_sch, power-usb-dsm.kicad_sch, sensors.kicad_sch]
2026-10-06 Keep KiCad editor state out of the snapshot
    Replace regenerated local editor preferences with project ignore rules. No PCB, schematic or validation evidence changed.
2026-10-07 B-RID: add checked native KiCad project and manifest
    Engineering review snapshot. Fabrication and battery connection remain gated by documented component, assembly, firmware and bench qualification.
    [b-rid.kicad_pcb, b-rid.kicad_sch]
2026-10-07 B-RID: add project 3D models
    [ESP32-C3-MINI-1_20210903_0.STEP]
2026-10-07 B-RID: add 3dmodels/Connector_USB.3dshapes
2026-10-07 B-RID: add kicad-stock-3dmodels/Capacitor_SMD.3dshapes
2026-10-07 B-RID: add kicad-stock-3dmodels/Connector_JST.3dshapes
2026-10-07 B-RID: add kicad-stock-3dmodels/Inductor_SMD.3dshapes
2026-10-07 B-RID: add kicad-stock-3dmodels/Package_DFN_QFN.3dshapes
2026-10-07 B-RID: add kicad-stock-3dmodels/Package_SON.3dshapes
2026-10-07 B-RID: add kicad-stock-3dmodels/Package_TO_SOT_SMD.3dshapes
2026-10-07 B-RID: add kicad-stock-3dmodels/Resistor_SMD.3dshapes
2026-10-07 F722: document final prototype and historical evidence
2026-10-07 F722: add final routed PCB and paired schematics
    [f722-heli.kicad_pcb, f722-heli.kicad_sch, input-levels.kicad_sch, io-ports.kicad_sch, power-bec.kicad_sch, power-core.kicad_sch, power-usb-dsm.kicad_sch, sensors.kicad_sch]
2026-10-07 F722: add final electrical and prototype handoff
2026-10-07 F722: add final board inspection images
2026-10-07 F722: document reviewed 0201 UART protection part
2026-10-07 F722: add native CAD verification evidence
2026-10-07 F722: add exact-board IMU layout review
2026-10-07 F722: add IMU six-layer audit outputs
2026-10-07 F722: add reviewed YAGEO 0201 footprint
2026-10-07 F722: add final project-local footprint updates
2026-10-07 F722: add reconciled BOM and placement outputs
    [excluded-board-features.csv, factory-rotation-verification-required.csv, jlc-bom-SMT-HELD.csv, placement-all-populated-reference.csv, placement-manual-THT.csv, procurement-full-grouped.csv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]
2026-10-07 F722: add reconciled drill exports
    [f722-heli-NPTH.drl, f722-heli-PTH.drl]
2026-10-07 F722: add exact-board fabrication Gerbers
    [f722-heli-B_Cu.gbl, f722-heli-B_Mask.gbs, f722-heli-B_Paste.gbp, f722-heli-B_Silkscreen.gbo, f722-heli-Edge_Cuts.gm1, f722-heli-F_Cu.gtl, f722-heli-F_Mask.gts, f722-heli-F_Paste.gtp]
2026-10-07 F722: distinguish current validation from history
2026-10-07 tidied up b-rid nets
    [b-rid.kicad_pcb]
2026-10-07 B-RID: tidy power routing and add USB pair rules
    Scope: b-rid only. KiCad 10.0.6 native checks: 0/0/0/0; eight negative rule regression tests pass. Engineering prototype CAD for review; fabrication and battery connection are not released.
    [b-rid.kicad_pcb, b-rid.kicad_sch]
2026-10-08 tidied up routes
    [b-rid.kicad_pcb, b-rid.kicad_sch]
2026-10-09 WIP: checkpoint reproducible unrouted F722 interior placement
    156 explicit poses, paired native project and bounded checks. 378 unfinished connections; not for manufacture or flight.
    [f722-heli.kicad_pcb, f722-heli.kicad_sch, input-levels.kicad_sch, io-ports.kicad_sch, power-bec.kicad_sch, power-core.kicad_sch, power-usb-dsm.kicad_sch, sensors.kicad_sch]
2026-10-09 WIP: checkpoint F722 critical routing and ground connectivity
    158 unfinished connections; 17 unfinished-interface warnings. Loaded power and ordinary protected signals remain incomplete. Not for manufacture or flight.
    [f722-heli.kicad_pcb]
2026-10-09 WIP: checkpoint F722 power-input routing at 123 unfinished connections
    Zero geometric errors, nine unfinished-interface warnings. CORE, support taps, ordinary routing and loaded qualification remain incomplete. Not for manufacture or flight.
    [f722-heli.kicad_pcb]
2026-10-09 WIP: checkpoint F722 routing at 80 unfinished connections
    Zero geometric errors and warnings; loaded electrical and signal qualification incomplete. Not ready for fabrication or flight.
    [endpoint-SERVO1_EXT.json, endpoint-SERVO2_EXT.json, endpoint-negative-SERVO3_EXT.json, f722-heli.kicad_pcb]
2026-10-09 WIP: checkpoint F722 routing at 77 unfinished connections
    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
    [accepted79-endpoint-SERVO3_EXT.json, endpoint-SERVO3_EXT.json, f722-heli.kicad_pcb]
2026-10-09 WIP: checkpoint F722 ADC and flash routing at 75 unfinished connections
    Zero geometric errors and warnings; strict paired parity and ERC clean. Loaded electrical and AC qualification incomplete. Not ready for fabrication or flight.
    [f722-heli.kicad_pcb, f722-heli.kicad_sch, io-ports.kicad_sch, power-bec.kicad_sch, usb-clock.kicad_sch]
2026-10-09 WIP: checkpoint F722 at 69 unfinished connections and confirmed BEC copper deficit
    Geometry/ERC clean, but full loaded screen failed. No power correction included. Not ready for fabrication or flight.
    [f722-heli.kicad_pcb, routing.dsn]
2026-10-09 WIP: checkpoint F722 corrected power routing at 62 unfinished connections
    Conditional power screens pass within declared scope; overloaded illustration remains failed. Not ready for fabrication or flight.
    [f722-heli.kicad_pcb]
2026-10-09 WIP: checkpoint F722 routing at 55 unfinished connections
    Current numerical power/VCAP validation not run after changed fills. Historical results do not qualify this board. Not for fabrication or flight.
    [f722-heli.kicad_pcb]
2026-10-09 WIP: checkpoint F722 routing at 49 unfinished connections
    Six actual protected channels complete. Current numerical power/VCAP validation pending. Not ready for fabrication or flight.
    [f722-heli.kicad_pcb]
2026-10-09 WIP: checkpoint F722 routing at 45 unfinished connections
    Native geometry and strict parity clean. Current numerical power/VCAP validation pending. Not ready for fabrication or flight.
    [f722-heli.kicad_pcb]
2026-10-10 WIP: checkpoint F722 routing at 14 unfinished connections
    Corrected supply-terminal model documented. Current numerical power/VCAP validation pending; historical USB/DSM results invalid. Not for manufacture or flight.
    [SERVO15.f722-heli.kicad_pcb.delta.json, f722-heli.kicad_pcb, f722-heli.kicad_sch, input-levels.kicad_sch, io-ports.kicad_sch, power-bec.kicad_sch, power-core.kicad_sch, power-usb-dsm.kicad_sch]
2026-10-10 WIP: checkpoint F722 at 13 unfinished connections
    Native geometry/parity/ERC clean; exact reference-hole boundary conflicts retained. Current numerical power/VCAP and hardware qualification pending.
    [f722-heli.kicad_pcb]
2026-10-10 WIP: checkpoint F722 at 12 unfinished connections
    Native geometry/parity/ERC clean. Current numerical power/VCAP and complete CS timing pending. Not for manufacture or flight.
    [f722-heli.kicad_pcb, f722-heli.kicad_sch, input-levels.kicad_sch, io-ports.kicad_sch, power-bec.kicad_sch, power-core.kicad_sch, power-usb-dsm.kicad_sch, sensors.kicad_sch]
2026-10-10 WIP: checkpoint F722 at 11 unfinished connections
    Native geometry/parity/ERC clean. Current numerical power/VCAP and complete electrical qualification pending. Not for manufacture or flight.
    [f722-heli.kicad_pcb, f722-heli.kicad_sch, input-levels.kicad_sch, io-ports.kicad_sch, power-bec.kicad_sch, power-core.kicad_sch, power-usb-dsm.kicad_sch, sensors.kicad_sch]
2026-10-10 WIP: preserve coordinated routing planning sources
    Accepted native board remains at11 unfinished connections. Source-only trial recipes, not adopted routing or new qualification.
2026-10-10 Preserve isolated seven-open F722 native WIP checkpoint
    [f722-heli.kicad_pcb, f722-heli.kicad_sch, input-levels.kicad_sch, io-ports.kicad_sch, power-bec.kicad_sch, power-core.kicad_sch, power-usb-dsm.kicad_sch, sensors.kicad_sch]
2026-10-10 Preserve joint routing trial and corrected power preparation WIP
2026-10-13 WIP: preserve native3 R35 cleanup; fresh power review pending
2026-10-13 WIP: preserve native3 conditional DC and bounded assembly evidence
2026-10-13 WIP: promote the native2 In4 RX prototype baseline with current DC evidence
2026-10-13 WIP: native2 In4 RX prototype baseline with current DC evidence and portable sources
2026-10-13 WIP: close F722 MOSI and preserve the native1 prototype baseline
2026-10-13 WIP: preserve native0 IMU orientation and internal CAM checks
2026-10-14 nexus: gate reroute geometry and disable implicit power necking
2026-10-15 nexus: archive superseded connected experiment with 361 clearance errors
    Unfinished historical candidate08 only. Canonical PCBs remain unchanged; later local repairs are separate and not certified by these receipts.
2026-10-15 nexus: preserve unfinished 37-error connected routing checkpoint
    Batch31 retains zero native opens/parity and 54 inherited silk warnings. Publish exact candidate, rules, schematic, DRC and cumulative contact/width evidence under routing-wip; canonical PCB files and manufacturing hold remain unchanged.
2026-10-15 nexus: continue unfinished reroute after PR33 merge
    Preserve the exact sealed batch35 33-error candidate and independent batch31 board-level review on a fresh draft branch based on current main. Canonical PCB files remain unchanged; no fabrication qualification or merge is implied.
2026-10-15 Add nexus-style-fc-power-module as a separate project
    The main board's POWER block (VX TVS, TPS62130 5 V buck, TPS2116 priority
    mux, VSYS Schottky OR, TPS629210 3V3 buck, DSM PTC, ADC sense dividers) on
    its own 26 x 22 mm 4-layer board with a 1x4 input and 1x8 output header.
    Parts come straight from nexus-style-fc/tools/design.py; the schematic is
    drawn and the PCB is placed but not routed. ERC 0, DRC 0 errors, parity 0.
    The project carries its own copy of the library parts it uses.
    gen_schematic.py: design modules may override PAGE, GROUP_TITLES and
    SAME_ROW, and blocks reserve room for vertical net labels so they no
    longer overlap the group titles. pcbutil Board.text returns the text.
    Co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
2026-10-15 added standalone power module
2026-10-15 WIP: connect Nexus schematic units and isolate U10 EN; preserve 32-error route checkpoint
2026-10-15 WIP Nexus: redraw all circuits, apply approved C19 upgrade, checkpoint r43
    Native KiCad 10: experimental 29 clearance errors; canonical 627 inherited errors. Both zero opens/parity/ERC and 54 inherited silk warnings. Header retains 11 edge errors. No fabrication release.
2026-10-15 WIP: seal Nexus r51 at 18 errors, improve U10 output loop and clean donor metadata
    Preserve canonical copper and all unrelated work. Include exact native/contact/return evidence, unchanged BOM/CPL proof, and conditional header fit study. Manufacturing remains blocked.
2026-10-15 WIP Nexus r57: 13 clearance errors, contact diagnostics and scoped symbol filters
    Preserve canonical copper and unrelated projects. Include native ERC/parity, current schematic PDF/source, off-pad hole and annular-entry proofs. Keep mechanical candidate02 separate and unfinished; no fabrication release.
2026-10-15 WIP: preserve Nexus r60 USB routing at 8 errors and isolated header repair
    Keep canonical source unchanged. Seal complete USB/protection/return evidence,
    four centered buck entries, narrow R4 LED width exception and R18 sense path.
    Preserve separate unfinished mechanical main and zero-error child correction.
    Disclose C27 effective-input-capacitance and remaining manufacturing gates.
    No fabrication release.
2026-10-15 WIP: preserve r61 two-error routing, stable current project and mechanical net audit
2026-10-15 Nexus WIP: integrate zero-error header interface and restore signal returns
    Keep current candidate atomic with matching main/child source, native evidence and WIP exports. Physical assembly, manufacturing process and electrical qualification remain open. No unrelated project changes.
2026-10-15 Nexus WIP: source-consistent assembly markings and release-gate evidence
2026-10-16 WIP Nexus stage36 main and child review checkpoint; exclude design.py generators and derivative
2026-10-16 Consolidate Nexus stage36 into canonical project paths
    Preserve matched native sources and manufacturing bytes; use Git history for older project snapshots. Retain revision-bound validation evidence, document open release gates, and guard destructive regeneration.
2026-10-16 fix(nexus): clean up native fabrication warnings and bind verified exports
    Center existing via connections, fix mixed USB connector classification,
    move conflicting outline artwork to Fab layers, and synchronize reviewed
    symbol/footprint identities. Preserve accepted pads, pinouts and parts.
    Regenerate main CAM and record full KiCad 10 ERC/DRC/parity and source/CAM
    consistency evidence. Keep remaining factory and bench qualification gates
    explicit; this checkpoint is not a fabrication or flight release.
2026-10-17 tidy up traces
2026-10-17 improved child board
2026-10-17 USB rerouted for 90ohm
2026-10-18 updated bom
