chenguoming1/h743-controllers/(notices)

Notices in the files:
f722-heli/layout-revision/checks/checkpoint50-integration/conditional-signal-review/firmware/src/main/flight/servos.c:
Rotorflight is free software. You can redistribute it and/or modify
it under the terms of the GNU General Public License as published by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
